daleondev/ProtoMate_Control/README.md

# ProtoMate Control

Control software running on the robot controller of the ProtoMate SCARA Robot.

## Current target: Arduino GIGA R1 WiFi

**M4 runs `io::Application`; M7 runs `ui::Application`.** Each independently
linked image owns its main, ThreadX kernel, C++ runtime, heap, TLS, threads,
message bus, coroutine context and ICC bridge. Common implementations are
compiled separately for each core. ICC uses bounded shared-SRAM queues with
urgent, normal and background lanes; M7 writes the physical USB-C CDC console.

The STM32H747 CubeMX, HAL, external-flash bootstrap and build port are implemented.
**Both applications boot from QSPI; USB/ICC services and STEP generation under combined load are verified.**
Factory backups are preserved. [Wiring, memory, backup/flash/debug commands and acceptance gates](#arduino-giga-hardware-boot-and-bring-up)
are documented below. Linux keeps the paired in-process transport for tests.

M4 exposes STEP/DIR/enable, switches, DM542T/TMC2209 drivers, feedback and the
future EtherCAT SPI connection. M7 owns the RGB LED, user button, display/touch
and console. M7 mounts persistent internal-flash storage at `/flash`; M4 does
not mount the volume. Both runtimes include filesystem support.
Motor construction leaves all drivers disabled; initialization, enabling and
motion are explicit CLI operations. Display/touch bring-up uses `display`
commands. The shared TouchGFX robot HMI opens Home on M7 and Linux, using the same
motion client and job history as the CLI. See the [HMI guide](docs/gui/hmi/README.md).

## Remote-control integration and future supervision

OPC UA is integrated as a third UI frontend alongside GUI and CLI. The LAN9255
supervisor remains future work. This hobby project makes no certification or
SIL/PL claims. Powered robot commissioning remains separate from software and
motor-disconnected electrical tests.

### OPC UA interface on M7 using open62541

**Remote-motion endurance is not yet qualified:** intermittent network/server latency
can exceed the unchanged 500 ms control-source deadline. Read-only monitoring and
short electrical workflows pass; normal firmware starts with remote permission OFF.
See the measured blocker in the qualification report linked below.

The server uses the existing motion client, planner, source-aware execution jobs
and M4 admission. Its explicit reflection catalog publishes 187 application nodes
(68 methods), with stable string NodeIds and bounded typed records. The namespace
is `urn:protomate:control`; default subscriptions publish at 100 ms (50 ms minimum).
No network read requests fresh IO work.

- `src/ui/opcua` (`proto::ui::opcua`) owns the catalog, server, NetX/POSIX ports and
  allocator. `platform/network` owns Wi-Fi/SDIO/NetX. M4 links neither stack.
- GUI and OPC UA share `ui::Services`; CLI retains the same application-owned
  motion client and job history. Existing ownership, units, planning and stop
  semantics apply to all frontends.
- Remote commands require local permission, **OFF on every boot**. Anonymous
  SecurityPolicy None is intended for the trusted LAN. The client worker checks
  500 ms remote expiry independently of networking/rendering, using 100 ms
  heartbeats and explicit held-jog supervision. Disconnect never replays motion.
- Settings → Network and USB `network setup` provide local setup. One Wi-Fi
  profile is saved on internal flash; passwords are not exposed remotely or logged.
  Linux uses OS networking. `opcua status|start|stop|restart` and
  `opcua remote on|off` expose local management.
- Dedicated SDRAM reservations provide 512 KiB for OPC UA, 256 KiB for networking
  and 128 KiB for presentation snapshots/USB byte rings, preserving active
  framebuffers, M4 memory and ICC SRAM4. Another 128 KiB remains unassigned.
  The server's internal stack is 14 KiB, based on measured complete-catalog use.

See the [integration guide](docs/opcua/README.md),
[generated node reference](docs/opcua/nodes.md),
[architecture and memory diagrams](docs/opcua/architecture.md), and
[measured qualification status](docs/opcua/verification.md).
The [standalone Wi-Fi sample](examples/opcua_sample/README.md) remains buildable.

### LAN9255 SAM E53 supervisor with FSoE

Explore using the integrated SAM E53 as a dedicated supervisor and EtherCAT
gateway, including an FSoE endpoint for a remote FSoE controller. This would
replace the erased-SAM/direct-GIGA-to-ESC arrangement for this future variant:

```text
EtherCAT + FSoE -> LAN9255 ESC -> SAM E53 -> separate SPI -> GIGA M4
                                  |
                                  +-> independent motor shutdown hardware
```

- Restore SAM firmware and move EtherCAT slave application ownership there.
  Process FSoE locally; forward ordinary command/status data to M4 through a
  bounded SPI protocol. FSoE requires a corresponding remote FSoE main instance;
  an ordinary EtherCAT master alone does not supply that logic.
- Investigate the separate SPI exposed at mikroBUS J18 for the GIGA link.
  J3 taps the ESC bus and must not be driven by two independent masters. The
  current documented J3 wiring stays unchanged until this variant is implemented.
- Give the supervisor physical authority to withdraw motion permission without
  GIGA cooperation. A GIGA enable request may only enable motion while the
  supervisor, watchdog and local protective inputs also permit it.
- Default to inhibited operation during reset, power loss or watchdog expiry;
  latch trips and require deliberate recovery. Include an external watchdog
  driven by completed supervision cycles, not an autonomous timer heartbeat.
- Evaluate independent driver-enable inhibition and monitored switching of the
  motor-power branch while keeping controller power available. Select the output
  topology after checking failure behavior, stored energy and regeneration.
  DM542T/TMC2209 enable inputs are ordinary controls, not documented STO inputs;
  account for the existing interface polarity rather than simply disconnecting
  an enable wire. A stop message to M4 alone cannot provide this authority.
- Determine whether Axis 3 needs a brake or other load-retention mechanism before
  removing holding torque. Controlled deceleration through M4 is useful, but
  independent shutdown must still work if M4 fails.
- Verify with motors disconnected first: GIGA/SAM stalls and resets, lost/stale
  FSoE and SPI traffic, broken supervision, shutdown-output faults and prevention
  of unintended restart. Later validate actual stopping and load retention.

FSoE protects communication integrity; it does not by itself make the SAM,
outputs or mechanics fault tolerant. The intended outcome is a tested hobby
supervisor with independent shutdown, without a certification program.
References: [EVB schematic, page 22](docs/ethercat/EVB-LAN9255-Evaluation-Board-Users-Guide-50003106.pdf)
and [ETG FSoE overview](https://www.ethercat.org/safety/).

## Motion API: motors, axes and robot

M7 owns the motion client, bounded job history, axis conversion and robot planning.
M4 owns admission, driver state, execution and local stopping. CLI commands are
asynchronous: a returned job ID means submitted; `motion jobs <id>` reports IO
acceptance and the eventual result. Returning to the prompt does not cancel a move.

| Control | Units | Commands |
|---|---|---|
| `motor` | Shaft degrees / rpm | Existing raw moves, homing, dynamics and buffering |
| `axis` | Axis 1/2 degrees; Axis 3 mm | `status`, `move`, `moveto`, `home`, `jog`, `stop` |
| `robot` | Joint coordinates or Cartesian mm | `status`, `home`, `move joints`, `moveto joints`, `move point`, `moveto point`, `stop` |
| `motion` | Shared lifecycle/jobs | `init`, `enable`, `disable`, `status`, `jobs`, `wait`, `cancel`, `stop`, `abort` |

`motion init` leaves drivers disabled. Initialize and enable explicitly, then home
before absolute/axis/robot motion. Execution requires the native simulator's
mechanical configuration or a verified physical configuration. The physical
configuration is deliberately unset. Preview fixtures are never substituted for it.

Examples after homing:

```text
axis move shoulder -5 --speed 10
axis jog z -1 --duration 1
robot moveto joints 30 -30 10 --speed 0.25
robot move point -1 -1 0
motion jobs
motion wait 4 --timeout 10
motion cancel 4
```

Axis dynamics are deg/s, deg/s², deg/s³ or mm/s, mm/s², mm/s³. Zero/omitted values
select configured defaults. Robot `--speed`, `--accel`, `--decel` and `--jerk` are
factors of configured limits in (0,1]; zero selects defaults. Speed defaults to
0.25. Cartesian point moves interpolate **joints**, so their TCP paths can curve.
Straight Cartesian paths remain previews; blending, live override and hold/resume
are not exposed as executable robot features.

M4 atomically excludes command families. Raw motor commands can coexist under
existing per-motor buffering rules; axis jobs may run on separate axes; a robot
job reserves all three. Families cannot mix. Reservations start before executable
planning and last through deceleration and cleanup. Busy results identify the
owner. Configuration/state revisions are checked again before starting; stale
plans emit no pulses. Read-only status and previews remain available.

`motion jobs` retains 32 execution records. Waiting explicitly does not transfer
ownership; a wait timeout leaves the motion running. `axis stop` also stops the
whole group if that axis belongs to a robot job. Axis/robot stops decelerate with
holding torque retained. Raw `motor stop` remains an immediate abort; abort and
disable invalidate affected references. No stop or reconnect resumes motion.

The configured ceiling is **6,250 pulses/s on each axis**, with microsteps
**16 / 16 / 8**. Joint/point moves share one normalized profile and one scaled
stopping-progress profile. Endpoints are quantized once, and completely zero
moves do not arm outputs. Finite programs, including stopping continuations, are
limited to **90 seconds**. Continuous jog uses rolling timing toward the actual
soft-limit boundary; the default timed jog requests deceleration after one second.

Two deadlines serve different purposes: the UI ownership lease is **250 ms**,
renewed in one batch every **50 ms**; local M4 execution maintenance uses a
**40 ms** renewal and **80 ms** committed frontier. The execution worker still
services refills and stops every millisecond; its local keepalive remains 40 ms.
UI loss selects an already
installed brake on M4. An M4 execution failure invokes the hardware guard and
invalidates uncertain references; it is not a guaranteed controlled stop.

The Linux workflow exercises the native simulated plant through the production
CLI, ICC and controller. Brake construction preserves the incoming state and
accepts only binary64 roundoff at acceleration limits (eight machine epsilons,
relative to the limit). Exact captured-input, phase-boundary, scaling and
out-of-limit regressions cover this numerical boundary.

The current motion review has separate software and electrical results. Short
motor-disconnected analyzer captures pass for raw commands (**18/18/9 pulses**),
coordinated completion (**400 per axis**) and controlled stopping (**266 per axis**).
HIGH time is 120–121 samples at 24 MHz; coordinated rising-edge skew is at most
one sample. Physical ENABLE remains inactive throughout. These captures peak
near 711 pulses/s and do **not** qualify the configured 6,250-pulse/s ceiling.

The concurrent jog/independent-axis ICC failure is fixed. The M4 urgent sender
was exhausting the heap when allocating a 4,228-byte temporary coroutine for
another outgoing frame; UI then reported the missing heartbeat. Each sender now
reuses one persistent frame allocated at startup. A host allocation regression
and repeated application-level overlaps verify the fix. Heartbeat, ownership
and motion deadlines are unchanged. See the [current review](docs/motion-current-state/review.md)
for firmware identities, capture results and the remaining physical qualification.

The review fixes an overall homing deadline, missing preparation-version
validation, an interrupted-wait wakeup race, telemetry waiting on raw startup's
command lock, a native display-mutex preemption deadlock, and an unnecessary
peak allocation when STEP scratch storage grows. Preparation/start failures now
retain their stage and allocation failures report capacity exhaustion. The
native simulator caches mechanical configuration before starting live transport.
Its clock waits for interrupt-woken controller work to suspend before advancing
the next event, and simulated display refresh uses that same clock. This prevents
instrumentation overhead from starving homing behind repeated periodic wakeups.

The ordinary interaction objective remains approximately **200 ms to start
changing motion**, not to reach rest. The current captures establish pulse
behavior, not a worst-case admission/stop-onset bound or maximum-rate endurance.
The complete native motion workflows pass with ASan/UBSan, including
homing → stop → homing and checks for unwanted seek pulses after switch contact.
This functional simulation does not qualify hardware scheduling or timing.
Clang-tidy is clean across all 430 production compilation contexts (Linux, M4
and M7), with no parse blockers; unit tests remain excluded.
See the [current review](docs/motion-current-state/review.md) for exact
build, test, firmware and capture evidence.

Powered mechanical acceptance requires calibrated limits and transmissions.
[Executor architecture and verification](src/io/motion/EXECUTOR.md).

## Native Linux robot simulation

Build as usual, then launch **`build/debug-linux/Application`**. This one
executable forks into a native simulation process and a controller process,
opening the TouchGFX window plus a separate robot window. Use
`--headless` to omit only the robot window. See [simulator usage and model
boundaries](src/simulation/README.md) for the provisional physical profile,
fault controls, persistent media, signal capture and verification commands.

The robot window displays native simulated shaft/axis state, not motion requests
or controller position estimates. The controller retains the production IO
state machines, drivers, STEP generator, FileX/LevelX and UI/IO ICC. Emulated
motion hardware and physical state live in the separate native process.

## Platform layout

| Directory | Responsibility |
| --- | --- |
| `platform/boot/` | Board startup, recovery images, memory protection and GIGA flash partition layout |
| `platform/hal/` | Hardware contracts, drivers, devices, board wiring and core selection; includes the inter-core lane contract |
| `platform/simulation/` | Linux simulator wire contract, shared memory, HAL mailbox and interrupt handoff |
| `platform/runtime/` | ThreadX integration, C/C++ runtime and filesystem/storage implementations |

The GIGA partition header is shared by boot MPU setup and the runtime flash
adapter; the partition addresses and erase geometry are defined in one place.

## Application layout

| Directory | Responsibility |
| --- | --- |
| `src/common/` | Shared contracts, motion profiles, application lifecycle concept, ICC bridge and transports |
| `src/io/` | M4 entry point, IO application, motor ownership and motion execution |
| `src/simulation/` | Native hardware process, machine models, independent SDL/OpenGL viewer and tests |
| `src/ui/` | M7 entry point, UI application, CLI, shared GUI, axis conversion and robot planning |

Each firmware compiles only its own application target, `proto::io` or
`proto::ui`. Both use `proto::common`. These are compiled static libraries;
their nested `INTERFACE` targets collect sources privately into the owning
library. Tests and examples link the compiled libraries so implementation files
are compiled once per build. Public include paths start at `src/`, for example
`common/icc/bridge/Bridge.hpp` and `io/app/Application.hpp`. The Linux entry point in
`src/main.cpp` retains the in-process paired transport for host development and
lifecycle tests. It is not compiled into either GIGA image.

The [application concept](src/common/app/Application.hpp) enforces `void start()`,
`void requestStop()` and `void join()` without inheritance. Construction initializes
logging; application workers launch in `start()`. `start()` is one-shot;
`requestStop()` is an idempotent thread-safe notification; `join()` waits for
completion. Destruction requests a stop and joins. Call start/join/destruction
from the lifecycle owner, outside workers.

`runtime::thread::Definition` annotations in each `app/Application.hpp` declare
its threads; `app/Application.cpp` defines their entries.
[ThreadGroup](platform/runtime/ThreadGroup.hpp) creates all workers before
releasing them. The ICC worker runs the context; the application worker waits
for a stop request, then drains the bridge before stopping its context. Peer
shutdown or link failure wakes the application worker. Each application requires
a transport; the bridge is a concrete member with no optional execution path.

Each application exposes a lifecycle `state()`: `Starting`, `Ready`, `Stopping`,
`Stopped` or `Fault` ([shared definition](src/common/app/State.hpp)). IO publishes
its state on the latest-only `io/controller/state` topic every 100 ms. UI owns
[`SystemState`](src/ui/app/SystemState.hpp), combining its local state, the
received IO state and ICC connection health; `ui::Application::systemState()`
returns this snapshot. Refresh uses timers on the existing ICC workers.
The CLI command `state` displays the same combined state and LED colour, both
controller states, and whether the received IO state is fresh. `help state`
describes the command; reading state does not issue an IO request or move motors.

UI displays the combined state on the GIGA's onboard RGB LED:

| Colour | Meaning |
| --- | --- |
| Green | Both applications are `Ready`, ICC is connected and IO state is fresh |
| Yellow (red + green) | Starting, awaiting IO state, or orderly stopping/stopped |
| Red | Application fault, ICC failure, or no IO state for 500 ms while connected |

Blue stays off. Freshness uses UI's receive clock; timestamps need not be
synchronized between cores. Fault indications latch until application restart;
shutdown cannot clear them. Final topic delivery is best effort, with ICC's
orderly goodbye distinguishing normal peer shutdown from communication failure.
These are **controller application states**, not motor readiness or enable
indicators. Green does not mean drivers are initialized, motors are referenced,
or motion is enabled. Motor telemetry and admission checks remain separate;
an LED or lost communication cannot confirm that physical motion has stopped.
GIGA Debug verification checks the LED GPIO levels: green during normal paired
operation, yellow after CLI shutdown, and red after halting M4 until a coordinated
restart. Shared motor enable remains inactive throughout these checks.

[`io::motion::Controller`](src/io/motion/Controller.hpp) owns three `StepperMotor`
instances, their shared STEP generator and enable output. Drivers and feedback
belong to each motor. `initializeDrivers()` configures the drivers and starts the
idle timebase; `enable()` verifies readiness before energizing the motors.
Controller move/reference methods preserve independent axis execution and
buffering. `stop(id)` stops one motor, `stop()` stops all while retaining torque,
and `disable()` also removes enable and invalidates references. Driver faults
immediately drop shared enable; a diagnostic worker cancels and joins all motion.
Recovery requires explicit initialization and enabling. IO shutdown disables the
motors before draining ICC. Motor settings live in `io/app/Application.cpp`:
1.8° full steps, 16/16/8 microsteps for M1/M2/M3 and placeholder 135° shaft
reference coordinates. These shaft placeholders do not supply a calibrated axis
or robot configuration.

The motor service dispatcher handles urgent stop/disable requests and telemetry.
One bounded command worker (priority 2, 16 KiB ARM stack) executes ordinary services and program preparation;
additional ordinary requests return `Busy` while it is occupied. UART verification
and initialization run outside the controller admission lock, and enable settling
is cancellable. Stop invalidates pending initialization/enable work and queued
ordinary requests; only a new explicit command can enable the motors afterwards.
Velocity updates enqueue under the admission lock and wait outside it.

`src/ui/cli/` contains the annotation-based parser, filesystem and utility
commands, Linux terminal frontend and direct motor commands. Registration uses
`ui::cli::register_commands` with a parser owned by the CLI thread. Each command
module has its own per-parser `std::call_once` guard. Motor callbacks use the
application-owned `ui::motion::Client`; only IO owns the physical controller.

M7 exposes the CLI through **USB-C CDC** (no UART bridge). Use `help` or
`help <command>`. Available commands are `pwd`, `cd`, `ls`, `touch`, `mkdir`,
`rmdir`, `rm`, `cp`, `mv`, `cat`, `echo`, `grep`, `time`, `stack`, `heap`, `state`,
`display`, `motor`, `motion`, `axis` and `robot`.
Quoting, wildcard expansion, pipes and `>`/`>>` redirection are supported.
For example, `echo "hello world" | grep world` and `time "heap io"`.
`heap ui` / `stack ui` inspect UI locally; `heap io` / `stack io` request IO's
memory diagnostics through the `io/memory` ICC service. The controller argument
is required. `time` measures execution on UI, including any remote round-trip wait.
Filesystem commands use the host filesystem on Linux and FileX on M7.
On GIGA, `/flash` is persistent internal-flash storage; see
[persistent files](#persistent-files-in-internal-flash) for capacity and behavior.

Motor commands use **motor-shaft degrees and rpm for all three motors**, including
M3. `motor` prints a guide; `help motor move` lists annotated options.

```text
motor driver init
motor enable
motor move m1 -90 --speed 5
motor jobs
motor status m1
motor stop m1
motor disable
```

- `motor status [m1|m2|m3|all]` shows commanded position/velocity, feedback and reference state.
- `motor driver status [motor|all]` shows driver readiness, alarms and latched faults.
- `motor driver init` initializes/recover drivers and the STEP timebase while disabled.
- `motor enable` / `motor disable` operate the shared enable; disabling stops work and invalidates references.
- `motor move <motor> <degrees> --speed <rpm>` submits a relative move.
- `motor moveto <motor> <degrees> --speed <rpm>` requires successful homing.
- `motor home <motor> [--seek 5] [--latch 0.5] [--timeout 30]` seeks, releases, slowly re-latches and finally releases the switch again, retaining the coordinate established at the latch.
- `motor speed <motor> <rpm>` replans the uncommitted remainder of an active move. It can be rejected once all remaining pulses are already scheduled.
- `motor defaults <motor> [--accel <deg/s²>] [--decel <deg/s²>] [--jerk <deg/s³>]` reads/updates idle motor defaults in RAM.
- `motor stop [motor|all]` aborts the selected motor and its buffered successor while retaining holding torque and invalidating its reference. Other independent motors continue; targeting a current robot group aborts that whole group.
- `motor jobs [id]` uses the shared execution-job registry. `motion jobs [id]` shows all command families; returning from a CLI command does not cancel its job.

Moves accept `--accel`, `--decel`, `--jerk` (zero selects the motor default),
`--timeout` (seconds, zero means unlimited) and `--buffer` (`aborting`, `buffered`,
`blending-low`, `blending-previous`, `blending-next`, `blending-high`). A motor can
have one queued successor. A configured default jerk of zero selects a trapezoid.
`accepted` includes queued/executing work; only a terminal result confirms its outcome.
INDEX feedback is labelled as a pseudo measurement of driver phase.
Axis conversion and coordinated positioning are exposed through `axis` and `robot`,
with the family exclusion and configuration requirements described above.

Linux uses ncursesw with separate logs, line editing and command history when
attached to a terminal. Redirected input/output, `TERM=dumb`, or
`SIMPLCITY_CLI_PLAIN=1` select the plain frontend. Console EOF, Ctrl-C, or Ctrl-D
on an empty interactive line shuts down the application pair. Application or
peer shutdown also interrupts an idle CLI. Plain/serial lines are limited to
4096 bytes; oversized lines are rejected. M7 receives bytes into a bounded IRQ
buffer while commands execute; input errors stop the console instead of
executing truncated input. The serial frontend echoes input, so disable local
echo in the PC terminal.

The shared message catalogs live in `src/common/icc/catalog/`:

- [topics.hpp](src/common/icc/catalog/topics.hpp): `Topics`, with `TopicPublisher` annotations.
- [services.hpp](src/common/icc/catalog/services.hpp): `Services`, with `ServiceProvider` annotations.
- [actions.hpp](src/common/icc/catalog/actions.hpp): `Actions`, with `ActionProvider` annotations.

Both applications register all three catalogs in their constructors using their
own IO/UI role. `Topics::io_logs` carries IO log text to UI. `Topics::io_motor_state`
publishes all three motor states at up to 20 Hz, including while idle or disabled.
Both the bridge and UI subscription use latest-only delivery. `Services::io_memory`
provides memory diagnostics. `Services::io_motor` carries initialization,
enable, speed and default-setting requests. `Services::io_motor_stop` reserves
urgent transport capacity for stop/disable. `Actions::io_motor_motion` carries
raw individual moves and homing, with periodic feedback and terminal results.
`Services::io_trajectory` handles authoritative snapshots, reservations and bounded
program preparation. `Services::io_trajectory_control` uses the urgent lane for
batched lease renewal, stop, abort and reservation release. `Actions::io_motion`
starts a prepared axis/robot program and retains its lifecycle through cleanup.
Shared motor payloads live in `src/common/motion/Motor.hpp`; compact versioned
program packets live in `src/common/motion/Trajectory.hpp`. Both use the existing
ICC bridge rather than a separate motion transport.

`motor status` and `motor driver status` read UI's latest snapshot without a
service request. Missing telemetry, disconnection and samples older than 500 ms
produce explicit errors. Freshness uses UI's local receive clock; the snapshot's
IO timestamp is informational, and its increasing sequence rejects duplicate or
out-of-order samples. The worker waits 50 ms after publishing; blocking IO or ICC
processing can extend the interval. It does not catch up missed publications in
a tight loop that would starve diagnostics and logging. Command replies contain the outcome, `commandGeneration`
and operation-specific values (motion defaults or the scheduled speed-change
pulse), without copying motor states. Actions still report acceptance and terminal
results independently of telemetry.

IO's application worker drives `io::motion::Server`; blocking driver operations
and joins stay outside the ICC context. Controller completion callbacks only
wake this worker. UI's application worker caches telemetry and dispatches action callbacks for
`ui::motion::Client`, retaining its job handles until completion. Services and
action admission time out after three seconds; execution uses the requested
motion timeout. Lease renewals have a shorter 150 ms service timeout and only
one renewal request may be outstanding. No request is automatically retried. `commandGeneration`
rejects submissions overtaken by a stop, disable or initialization. Acknowledgements
update UI's generation immediately, so subsequent moves do not wait for telemetry;
older snapshots cannot roll it back. IO validates admission against its current
state rather than trusting UI's cache. Link shutdown
drains IO motion and disables the shared enable before closing its bridge. UI
reports uncertain communication outcomes as unknown rather than claiming a stop.

Diagnostic snapshots and collection live in `src/common/diagnostics/`. IO's
`io::diagnostics::Server` collects them on a dedicated worker; the CLI formats
both local and remote results using the same tables. Remote requests have a
two-second timeout, participate in UI shutdown cancellation and never fall back
to UI measurements on failure. At most two requests are outstanding at the IO
provider. Each response fits one ICC frame and includes up to 32 thread records
with names limited to 31 characters; omitted threads and shortened names are
identified in the output. Stack usage is sampled/saved usage and a recorded
high-water mark, not a continuous measurement. The collection copies thread
records under the local ThreadX interrupt lock, without allocation or formatting.
On Linux both controllers share the process allocator and ThreadX kernel; the
output explicitly labels that scope even when the request travels through ICC.

`reset all` immediately aborts motion and resets the complete GIGA, including both
controllers. STEP/enable outputs are inhibited before reset; startup leaves motors
disabled and references must be established again. During reset itself, GPIOs are
inputs: external STEP pull-downs and the disable-state enable bias remain required.
USB CDC disconnects during
reboot. This is **not** a controlled stop: use `motion stop` first when deceleration
is required. Individual `reset ui` / `reset io` requests are rejected without any
reset. ST does not guarantee CPU-only watchdog reset (RM0399 §9.7.36), and our ICC
transport currently requires coordinated startup. Linux reports hardware reset as
unsupported; close and restart the simulation instead.

IO's Pneumo sink publishes already formatted records on `io/logs`; UI adds an
`[IO]` prefix and writes them directly to the console without logging them again.
Original timestamps and levels remain intact. Each record is limited to 384 bytes
(longer records end with `[truncated]`), and both the outgoing bridge subscription
and UI subscriber retain the newest 16 records. Overflow counters are available
through bridge/subscriber statistics; the sink separately counts truncations.
Console output runs on a notification-driven UI worker, never in ICC callbacks.
On Linux it uses the console broker, including buffering before ncurses starts.

UI installs its own Pneumo sink for all levels before its first startup log.
It prefixes local records with `[UI]` and calls `cli::writeLog`, the same output
function used by the IO subscriber. Received IO records retain `[IO]` and bypass
the local sink. The CLI frontend does not replace either logging route.

The M4 entrypoint installs this sink as Pneumo's default for all levels. The motion
controller also passes it explicitly to its motors, so Linux's IO logs use the same
ICC path while UI retains its separate console routing in the shared process.
Shutdown closes the IO sink before stopping ICC and wakes/joins UI's log worker.
Logs are best effort and may be discarded at shutdown. These bounds apply to the
ICC path; Pneumo's existing asynchronous logger queue is separate. Logging remains
a thread-context operation, not an ISR-safe or allocation-free API.

| Thread in each GIGA image | ThreadX priority (lower is higher) | Stack |
| --- | --- | --- |
| ThreadX timer worker | 0 | Port default |
| `io.iccThread` | 4 | 20 KiB (32 KiB on Linux) |
| `intercore.notify` | 3 | 2 KiB (8 KiB on Linux) |
| `ui.iccThread` | 4 | 32 KiB |
| `ui.cliThread` | 5 | 16 KiB (64 KiB on Linux) |
| M4 motion executor | 1 | 8 KiB (16 KiB on Linux) |
| M4 command/preparation worker | 2 | 28 KiB (24 KiB on Linux) |
| M4 raw motion/homing worker (up to three) | 16 | 10 KiB (16 KiB on Linux) |
| `io.applicationThread` | 3 | 16 KiB |
| `ui.applicationThread` | 6 | 16 KiB |
| Runtime main/application entry | 15 | 8 KiB |
| M4 motion diagnostics | 18 | 6 KiB (8 KiB on Linux) |
| `io.diagnosticThread` (heap/stack service) | 20 | 4 KiB (16 KiB on Linux) |
| `ui.logThread` | 20 | 8 KiB |
| Runtime cleanup/reaper | 31 | 2 KiB |

Priorities belong to separate schedulers; M7 priorities do not preempt M4 work.
ICC is a required part of both applications. The portable bridge and the
HAL/runtime transport adapter are separate targets. Reset both
cores together; independent core reconnection remains future work.

The [application archive](backups/application/README.md) preserves the earlier
control/CLI implementation for incremental reimplementation. Retired hardware,
bench programs and wiring are preserved under `backups/`; they are not build targets.

## Setup and compilers

```sh
git clone --recurse-submodules <this-repository>
# For an existing checkout:
git submodule update --init --recursive
```

Install CMake 3.22 or newer (3.24 or newer for `--fresh`), Ninja, GCC 16,
Arm GCC 16.1 or 16.2 with Newlib, OpenOCD, Arm GDB, Python 3, Git, and `patch`.
Linux builds also require ncursesw and SDL2 headers/libraries (`ncurses`, `sdl2` or `sdl2-compat` on Arch). The pinned TouchGFX SDK is included in `external/touchgfx`; install the asset tools described below before configuring M7 or Linux.
The project uses C++26 and the verified GCC 16 libstdc++ integration snapshot.
Unknown compiler majors and unverified Arm libstdc++ snapshots are rejected.
Linux tests download the pinned GoogleTest 1.17.0 source archive.

The **ProtoMate · Arduino GIGA R1 WiFi · GCC 16** VS Code devcontainer uses Arch
Linux and checks that both compiler major versions remain 16. It includes
SDL2/ncurses, Ruby with ERB/Nokogiri and `rsvg-convert` for GUI builds; Mesa, Xvfb and
`xauth` for headless GUI tests; and OpenOCD, Arm GDB, `sigrok-cli` and FX2 analyzer
firmware for hardware work. Python dependencies from
[`scripts/requirements.txt`](scripts/requirements.txt) (NumPy, Pillow, pyserial, pytest)
are installed in `/opt/protomate-venv`, selected automatically through `PATH`
and VS Code's Python interpreter setting. No activation or system-wide pip
installation is needed in the container.

After changing the Dockerfile or requirements, run **Dev Containers: Rebuild
Container**. The image build context includes only the Dockerfile and Python
requirements; the workspace and downloaded SDK archives are not copied into
the image. The container exposes USB and uses a development user with serial
permissions. Host flashing and serial capture also require access to Atmel-ICE,
USB CDC and the logic analyzer. Building and headless tests need no desktop
connection; opening an interactive simulator window requires X11/Wayland access
from the container, which is not enabled automatically.
When switching an existing build directory between host and container, configure
with `--fresh` to discard cached host paths (for example,
`cmake --preset debug-linux --fresh`).

For builds outside the devcontainer, install the Python dependencies separately:

```sh
python3 -m venv .venv
source .venv/bin/activate
python -m pip install -r scripts/requirements.txt
```

## Build and run

```sh
cmake --preset giga-debug
cmake --build --preset giga-debug
cmake --preset debug-linux
cmake --build --preset debug-linux
./build/debug-linux/Application
```

The combined preset builds `controllers` and the matching `images` bundle by
default, using the per-core presets and output directories, including
both memory reports. It does not flash the board. Use `--target io-controller`
or `--target ui-controller` to build just one through the combined project.

Runtime and HAL source implementations are shared; each core compiles and links
its own copy with its own CPU flags, ThreadX port and private runtime state.

`giga-release` and `release-linux` provide optimized builds. After a
compiler upgrade use `cmake --preset <preset> --fresh` and rebuild cleanly.
Use `-DBUILD_TESTING=OFF` when configuring Linux to build the template without
fetching or building test dependencies.

Pneumo uses stdexec as its required execution backend through
`pneumo::coroutines`. CMake fetches its pinned
stdexec headers; every coroutine consumer, including the native simulator,
inherits the same configuration. Existing ICC workers continue to drive their
own contexts; this does not introduce a thread pool or change the wire protocol.
Use `pnm::coro::asSender(context, factory)` and `pnm::coro::execution::when_all`
to compose asynchronous operations, forwarding the factory's stop token to
service requests. Domain failures such as `Busy` remain result values.
`application.icc.services` tests composition, out-of-order responses,
cancellation and provider shutdown/replacement across the serialized bridge on
our ThreadX runtime. These tests are always built; the obsolete optional
`PNM_CORO_ENABLE_EXECUTION` switch is no longer used.

Native coroutine awaitables retain their original frame and reference results
instead of going through an allocating sender adapter. On M4, bridge
startup/teardown lives in `BridgeLifecycle.cpp` in QSPI; dispatch and lane loops
remain in instruction RAM and are checked by the linked-image audit. Motion
buffers and RAM-region boundaries are unchanged for this integration.

The [2026-11-10 integration record](docs/pneumo-integration-2026-11-10.json)
contains the build identities, lint results, sanitizer results and analyzer
captures. Software regressions pass, but this is **not a full hardware release
qualification**: QSPI motion admission and concurrent buffered raw startup still
failed in this campaign. The five passing electrical captures use the documented
SDRAM fixture. The detailed motion limitations are recorded in the
[current review](docs/motion-current-state/review.md).

All project C/C++ sources in `src/` and `platform/`, including tests, compile
with `-Wall -Wextra -Wpedantic` in both Debug and Release builds. Directory
settings apply these flags to new module targets as well.
Embedded Debug builds retain debug information and use `-Os` for IO, UI, ICC
and their entrypoints. Real-time M4 sources use `-Os` or `-O2` in RAM;
the libstdc++ runtime shim uses `-Og` outside the selected fast paths.
Source-level debugging remains available, with optimized stepping in these modules.

GIGA builds produce `io-controller` or `ui-controller` ELF/HEX/BIN/MAP files.
Use the validated combined programming workflow below.

Every default hardware build prints used bytes, region capacity and percentages,
including builds where the ELF is already up to date. The `memory-usage` target
can also be invoked explicitly. These are linker allocations: the stack region
is fully reserved, and RAM includes the minimum heap reservation, not measured
runtime stack or heap usage.

Linux simulates the HAL and uses the ThreadX Linux port. Standard Linux file
I/O uses the host filesystem; explicit FileX tests use simulated media images.
The application runs both ICC endpoints, the UI CLI and the GUI window. Use `SDL_VIDEODRIVER=dummy` for automated runs without a desktop. Redirecting a command
script into `build/debug-linux/Application` executes it and exits at EOF.

Simulator C++ suites use GoogleTest built against the native host runtime; the
controller/runtime tests retain their separate ThreadX-linked GoogleTest. The
link-isolation test checks that no ThreadX runtime leaks into the native test
executables. Python integration suites use pytest for process lifecycle,
packaging, persistent storage, CAD parity and end-to-end motion. Their small
controller probe executables retain their own ThreadX entry points.

Run both kinds through CTest, which supplies the built executable paths and
uses Xvfb for the OpenGL suite:

```sh
ctest --test-dir build/debug-linux -R '^simulation\.' --output-on-failure
ctest --test-dir build/release-linux -R '^simulation\.' --output-on-failure
# Focus a native unit case without starting the controller:
build/debug-linux/src/simulation/protomate_simulation_tests --gtest_filter='SimulationMachine.*'
# Run an individual Python integration check directly:
python3 -m pytest -q src/simulation/tests/test_lifecycle.py --simulator=build/debug-linux/Application
```

CTest's pytest runs write JUnit reports to `build/<preset>/test-results/`.
Temporary media and copied executables are isolated per case; process fixtures
reap children and close pipes even when assertions fail.

## Firmware profiling

The opt-in `giga-profile` build adds native ThreadX/TraceX recording, DWT scopes,
application events, and bounded resource diagnostics on both cores. Trace buffers
use dedicated external SDRAM; small accounting/failure state stays internal.
Normal builds retain lightweight heap and first-failure diagnostics.

Use `profile arm motion`, exercise the application, then `profile freeze`.
`scripts/profile.py` exports frozen native traces, matched ELFs and a combined
browser timeline through Atmel-ICE without resetting the board. See the
[profiling guide](docs/profiling/README.md) for presets, memory ownership, event
semantics, exact commands and measurement limitations. The logic analyzer stays
separate from this framework.

## Shared TouchGFX GUI

`proto::ui::gui` provides the robot HMI on GIGA M7 and Linux. **Home is the
normal startup screen**, with the full prepared robot model, telemetry, motion
readiness and shared jobs. Axis, robot, preview and raw-motor pages use the same
Client/Robot/ICC implementation as the CLI. The interface names the joints **Axis 1, Axis 2 and Axis 3**. Programs and presets remain empty.

The shared shell uses an 88-pixel, six-button navigation rail (including Alarms), centered controls and a persistent Stop. Home always uses estimated feedback, with frame-matched joint badges and one status card. Axis and Cartesian jogging default to Hold. Cartesian has Step, Timed and Hold modes, persistent estimated X/Y/Z, and Move To / Settings tabs; Timed/Hold use one continuous Cartesian path with local M4 deceleration; they stop at the certified path boundary or on cancellation. Robot destination moves are under More, separate from non-executing path previews. Move separates Jog, Move To and Settings; I/O and diagnostics use aligned cards/tables. Orbit by dragging, zoom with the desktop wheel or a two-finger pinch, and use Reset View to restore the camera. Physical pinch input remains pending panel testing.

Alarms/messages distinguish blue Info, yellow Warning and red Error, with an Info
visibility toggle. Numeric editors open empty and validate each field before Apply.
Linux supports keyboard entry, Enter/Escape and Backspace/Delete inside the editor;
keyboard input never starts motion. See the guide for field and cancellation behavior.

See the [HMI operating and architecture guide](docs/gui/hmi/README.md) and
[verification status](docs/gui/hmi/verification.md). M4 does not link TouchGFX.

### SDK and assets

The required **TouchGFX 4.27.0** SDK files are versioned in
[`external/touchgfx`](external/touchgfx): headers/support sources, the M7 and
Linux engines, and Linux font/text/image converters. The devcontainer already
includes the host tools. Outside it, install Ruby (including ERB), Nokogiri and
librsvg (`ruby`, `ruby-erb`, `ruby-nokogiri`, `librsvg` on Arch), then:

```sh
# Only needed outside the devcontainer if Nokogiri is not installed system-wide:
gem install --install-dir "$PWD/apps/ruby-gems" nokogiri -v 1.19.4 --no-document
cmake --preset debug-linux
cmake --build --preset debug-linux
./build/debug-linux/Application
```

The SDK retains ST's **SLA0048** and third-party licenses; redistribution is
permitted under those conditions, including the ST-device usage restriction.
See its [license/provenance notes](external/touchgfx/README.md) and
[original package terms](external/touchgfx/Package_license.html). Its pinned
archive metadata and imported-file checksums are stored alongside the SDK.
`scripts/touchgfx_setup.py` reproduces this subset from the original archive;
it is not needed for a normal checkout/build.
`TOUCHGFX_ROOT` defaults to `external/touchgfx`; an environment or CMake cache
override can select another SDK directory containing `framework/` and `lib/`.
Configuration rejects versions other than 4.27.0. To clear a cached SDK path
from an older build, configure with `cmake --preset debug-linux -U TOUCHGFX_ROOT`
(or the appropriate hardware preset). M7 uses
the GCC hard-float engine without RTTI; Linux uses the x86-64 engine with RTTI.
Both link with our GCC 16 runtime. Vendor support has separate compilation flags;
GUI rendering is optimized with `-O2` in Debug as well as Release, retaining symbols.

Versioned assets are in [`src/ui/gui/assets`](src/ui/gui/assets): Noto Sans under
OFL, four font sizes (16/18/24/36), bounded Latin/German glyphs, stable text IDs in
`texts.xml`, SVG/PNG sources and `images.json`. `gui-assets` runs ST's Linux font,
text and image converters incrementally. SVG sources are rasterized with
`rsvg-convert` first. Generated C++ stays in `build/.../generated/gui`. The font
converter reports unsupported GPOS subtable 8; the selected Latin/German text
is covered by the visual checks. More complex scripts need separate validation.
Code, fonts, images and meshes share one 10 MiB M7 QSPI image and its normal
manifest. There is no separate GUI-assets partition or asset update procedure.

### Workers, ownership and shutdown

The application owns `gui::Controller` and three workers using its shared stop token:
GUI priority **8 / 16 KiB stack**, touch priority **7 / 8 KiB**, and the
3D renderer priority **16 / 16 KiB**. The renderer sleeps when Home is hidden. ICC remains higher
priority. Widgets are accessed only by the GUI worker. CLI commands submit to an
8-entry request queue; overflow is counted and rejected. `status()` returns a
thread-safe snapshot. There are no application-owned allocations during the
frontend's steady-state rendering or page transitions.

GIGA framebuffers are non-cacheable SDRAM at `0xC0000000` and `0xC0200000`,
1,228,800 bytes each. LTDC reload completion transfers ownership at vertical
blank; a timeout never makes a pending buffer reusable. The port records dirty
regions, combines overlapping/contained damage, and copies them from the completed
frame into the released buffer using DMA2D. The bounded 16-region list merges the
least expensive pair on overflow instead of falling back to a full-screen copy.
Unchanged pixels remain synchronized. One HAL driver owns LTDC IRQ 10; another owns
DMA2D IRQ 11. Graphics transfers support RGB565 fill/copy and RGB565/ARGB8888
conversion/blending, with software fallback for unsupported engine operations.
Solid-color alpha fills also use DMA2D. DMA callbacks notify the GUI worker;
no widget code runs in interrupts. LTDC has priority for AXI reads and DMA2D
inserts 16 bus cycles between transfers to leave scanout bandwidth.
DMA2D operations are submitted one at a time and suspend the worker until
completion (100 ms deadline), rather than busy-waiting. The current adapter does
not overlap multiple DMA blits with CPU drawing. CRC is enabled in CubeMX.

Touch acquisition resets/probes ST1633i, samples at 8 ms while pressed and wakes
on EXTI12 from idle. Unavailable devices retry at a bounded rate. `sampleTouch()`
reads the cached report only; it never performs I²C. One primary contact is tracked
until release for ordinary widgets; all five contacts remain available to the scene gesture recognizer. Native landscape coordinates are bounds-checked, and errors/stale
reports cancel the contact. Weak MCU I²C pull-ups keep disconnected lines defined;
the display adapter's external pull-ups remain required for connected operation.

On Linux the original OS thread owns SDL creation, events, texture copies and
presentation; a native pthread hosts ThreadX. Bounded pthread-protected mailboxes
cross that boundary without invoking ThreadX-backed C++ synchronization from SDL.
The runtime replacement C++ symbols are hidden from native shared libraries,
so SDL/Mesa/LLVM keep their native C++ synchronization instead of entering
ThreadX from the SDL thread. The window scales proportionally, letterboxes, transforms pointer coordinates and
cancels contact on focus loss/exit. SDL finishes copying a framebuffer before
returning it to the GUI. Closing the window or exiting CLI stops application
workers, disables callbacks/backlight and drains/aborts pending graphics work.
SDL resources are destroyed before process termination. The permanent hosted
ThreadX scheduler ends with the process.

### Adding screens

The HMI reuses one bounded page area rather than retaining a widget tree for
every screen. Add a page to `hmi::Page`, map intent in `Presenter`, and compose it
from the shared `Control`, `Panel` and `Label` components in `View`. Extend the
portable Backend contract only for real application functionality. The adapter
belongs to `ui::Application`; widgets must not block on ICC or manipulate drivers.
Text uses bounded Unicode buffers, actual font metrics for centering and explicit font-measured wrapping. Page builders are split into HomePage, MovePage and MaintenancePage; the [layout guide](docs/gui/hmi/layout.md) records component and input rules. Callbacks
publish bounded values; only the GUI worker draws or changes widgets.

### Shaded 3D performance prototype — acceptance gate not met

[`scene3d`](src/ui/gui/scene3d) is the first-stage implementation of the 3D
viewport. The generic maximum-rate benchmark remains a characterization workload. The 640×400 shaded workload does not meet the GIGA requirement of
20 newly presented images/s at 2,000 triangles and produces LTDC underruns.
Home uses **the same detail switching and adaptive pacing on Linux and GIGA**:
camera/pose changes use a 7,914-triangle model with a 10 fps ceiling. After 500 ms
without changes, it renders the original 36,376-triangle model once and returns
to idle. Both use a rest interval of at least one quarter of the preceding
render wall time (minimum 1 ms); full detail has a 5 fps ceiling. These are caps,
not promised hardware rates. The current measured GIGA camera workload is approximately 3.7 fps with interactive detail; this remains stepped animation. See the image-specific measurements in the HMI verification report. Full-detail rendering remains substantially slower.
Input/telemetry replaces the pending snapshot immediately; the worker samples the
latest snapshot when it can render, without a separate 500 ms submission gate.
An unchanged camera and joint pose submits no new render; newer telemetry
timestamps alone do not redraw the model. Returning to Home requests one fresh
image. Continuous rendering is reserved for animated diagnostic benchmarks.
The displayed image remains immutable. Resolution stays 640×400 in both modes;
full-detail geometry, link registration and motion/feedback data are unchanged.
`display scene` explicitly enables the generic benchmark; `display gui` restores Home.

```text
display scene 500
display scene 2000
display scene 5000
display status
display gui
```

The benchmark renders five independently transformed, overlapping ellipsoids.
`Scene` describes immutable meshes, material overrides and up to 32 nodes;
parents precede their children. `SceneSnapshot` contains local translation,
quaternion rotation, uniform scale, camera, revision and source timestamp.
Scenes/assets must outlive submitted work. `Renderer` uses caller-owned RGB565
and 16-bit depth buffers. `RenderService` has one replaceable pending snapshot,
finishes the current render, and holds completed/displayed buffers until the
GUI releases them. Visibility generations discard results from a hidden view.
Only the GUI accesses TouchGFX/DMA2D; shutdown drains rendering before removing
the bitmap registrations. Presentation revisions advance after the display
handoff, independently of GUI ticks or completed renders.

TGX **v1.1.4 / `d43f88906ab87f877ea249af2232896b097f15a7`** remains unchanged in
`external/tgx`. The project-owned [`cmake/tgx.cmake`](cmake/tgx.cmake) wrapper
isolates vendor flags and links it only into M7/Linux. Perspective, Gouraud
lighting, clipping and depth testing are enabled; texture shaders are excluded.
TGX's [LGPL-2.1 license](external/tgx/LICENSE) and upstream provenance remain in
the submodule. Keep that license/source information with distributed builds.

`scripts/scene3d_assets.py` uses the pinned TGX meshlet conversion modules and
NumPy, without installing the upstream GUI tools. It accepts OBJ/MTL, retains
units, local origins, normals and material colours, discards UV/image references,
and rejects invalid/degenerate geometry. For example:

```sh
python3 scripts/scene3d_assets.py --tgx external/tgx \
  --input path/to/part.obj --output build/meshes --name part
```

Outputs are constant `.h`/`.cpp` mesh data and a JSON report with triangle counts,
bounds and storage sizes. The benchmark's three assets are generated
incrementally by CMake into `build/<preset>/generated/scene3d`; assets are linked
into M7's existing QSPI image. There is no texture conversion or storage.

Prepared robot visual assets live in
[`src/ui/gui/assets/robot`](src/ui/gui/assets/robot/README.md): the four rigid
links retain their original metre/Z-up frames and colours, with 36,376 triangles
instead of the CAD exports' 623,292. The reproducible Blender workflow removes
cosmetic inserts and hidden surfaces and checks simplification error. Original
CAD, collision and switch-contact assets remain unchanged. Normal Linux/M7 builds generate
`scene3d-robot-assets` and link `proto::ui::gui::robot_assets`
and set the node material's `useMeshMaterial` to use its embedded colours.
[Matched view comparisons](docs/robot/visuals) document the visual review.
The HMI restores these full-detail assets when the view settles. Its
[interactive derivative](src/ui/gui/assets/robot/README.md#interactive-detail)
removes small surface features during changes, preserving the rigid-link frames.
Lowering display cadence does not establish
the original high-rate benchmark target described below.

The linker reserves **1,536,000 bytes** at `0xC0600000`: two 640×400 RGB565 images
and one 16-bit depth buffer, all cache-line aligned. Pixels are initialized before
publication; arbitrary C++ objects stay in internal RAM. Existing HAL cache
maintenance cleans sources before DMA2D reads. The linker enforces the reserved
2 MiB region and the 64 KiB working-storage allowance. Profiled mesh/raster hot
paths use approximately **16 KiB ITCM**, with an enforced 24 KiB cap.

`display status` reports render/completion/presentation revisions, overwritten
requests, frame latency, render wall time, bitmap transfer time and GUI-buffer
resynchronization. Render wall time includes higher-priority GUI/ICC work;
clear/grid/per-mesh sub-timings have the runtime clock's millisecond resolution.
Profiling builds additionally record DWT scopes for these stages, GUI widget
updates, DMA completion waits and buffer synchronization. DWT scope durations
include preemption; use TraceX scheduling alongside them.
The benchmark deliberately places its image at odd coordinates `(49,137)`.

Reproduce the panel-free performance gate with normal Release firmware:

```sh
cmake --build --preset giga-release --target images
python3 scripts/giga_program.py flash --build build/giga-release
python3 scripts/scene3d_hardware_check.py --seconds 15
```

The script records counters and CLI/ICC diagnostics under
`build/scene3d-validation`, restores Home, and returns exit code
2 when the gate is not met. No motor command is sent. The established DMA2D
dead-time remains **16**.

Current performance for both detail levels and verification are recorded in
[HMI verification](docs/gui/hmi/verification.md). The maximum-rate synthetic
benchmark is separate from normal Home and remains unqualified at 20 fps.
The interactive mesh is a visual derivative; collision and motion geometry do
not change. [Matched images](docs/robot/visuals/interactive/comparison.png) show
both levels at the same camera position.

For a bounded measurement using normal adaptive pacing, without treating the
requested ceiling as guaranteed throughput:

```sh
python3 scripts/hmi_hardware_check.py --rates 5 --seconds 60 --observe \
  --output build/gui-optimization/final
# Same camera workload with the motion-detail mesh:
python3 scripts/hmi_hardware_check.py --rates 10 --seconds 30 --observe \
  --interactive --output build/robot-interactive/hardware/interactive
```

The test rotates only the rendered model; it sends no motor commands and restores
Home. It checks display/ICC health, heap change and stack headroom. Ordinary tests
without `--observe` retain the fixed-rate qualification gate.

Host regressions cover deterministic shaded output, depth/occlusion,
hierarchy, near-plane/viewport clipping, invalid input, latest-only scheduling,
immutable displayed images, stalled handoff, visibility changes and stopping.
The existing Linux GUI interaction, presentation-timeout and X11 tests also pass.
The HMI supplies orbit/zoom/reset and the reusable viewport with the measured
detail-dependent operating envelope documented above. The original high-rate
benchmark acceptance and powered/physical-panel validation remain separate.

### Verification

```sh
cmake --build --preset debug-linux
ctest --test-dir build/debug-linux -R '^gui\.' --output-on-failure
# All host regressions, including existing motion/ICC tests:
ctest --test-dir build/debug-linux --output-on-failure
cmake --build --preset giga-debug
python3 scripts/giga_program.py flash --build build/giga-debug
# Performance acceptance uses optimized Release firmware, without a debugger:
cmake --build --preset giga-release
python3 scripts/giga_program.py flash --build build/giga-release
python3 scripts/gui_hardware_check.py --build build/giga-release --seconds 600
# After endurance, inspect pixels and deliberately remove LTDC interrupts:
python3 scripts/gui_hardware_inspect.py
```

The GUI tests use SDL's dummy video backend automatically. They cover pixel
checks/captures, dragging, resized letterboxing, focus-loss release, screen
transitions, request saturation, missing presentation completion, DMA errors,
cancellation and lost wakeups. `gui-*.bmp` captures are written inside the test
build directory. `GraphicsDMA::verify()` also runs on GIGA at startup, comparing
fill/copy/conversion/blend results and guard pixels at odd offsets and widths.
`graphics verified=1` in `display status` confirms it completed successfully.
The hardware scripts require pyserial (and Pillow for exported PNGs), keep motors
disabled, and write artifacts under `build/`. The inspection script reads both
framebuffer slots, checks color-bar pixels above the persistent Stop strip and
Home image content, then masks LTDC interrupts. It requires a bounded GUI fault, zero backlight duty
and working CLI/ICC before resetting both cores. Live SWD readback is not an atomic screenshot; inspect the exported images too.

Current HMI results and image-specific limits are recorded in
[HMI verification](docs/gui/hmi/verification.md). The old showcase's frame-rate
numbers do not qualify the robot HMI. Normal idle pages use dirty-region redraws;
3D presentations are counted separately from GUI ticks and LTDC scanout.

**Physical panel validation remains pending:** supply/reset timing at the panel,
visible RGB ordering/orientation, pixel-clock phase, tearing, backlight response,
ST1633i communication/coordinates and independent supply sequencing. Rendering
and LTDC presentation counts measured without a panel do not establish any of
those properties. The robot HMI is implemented and exercised in Linux; physical
display/touch and calibrated, powered robot acceptance remain separate.

## Linux sanitizer checks

Build and run the complete Linux test suite with AddressSanitizer,
UndefinedBehaviorSanitizer and leak detection:

```sh
cmake --preset sanitize-linux
cmake --build --preset sanitize-linux
ctest --preset sanitize-linux
```

The test preset sets `ASAN_OPTIONS=use_sigaltstack=0` because the ThreadX Linux
port owns its threads' alternate signal stacks. Instrumented builds also reserve
at least 1 MiB of native stack per simulated thread for sanitizer overhead;
firmware stack sizes are unchanged. Memory and leak checking remain enabled.
Instrumented simulator workflows receive three times the host wall-time wait
budget, since geometric queries and rendering run more slowly; simulated time,
motion limits and controller deadlines are unchanged. GUI input latency is still
recorded, but its 50 ms performance assertion applies only to uninstrumented
builds. All interaction, pixel, ownership and shutdown checks remain active.
LeakSanitizer needs permission to inspect process threads; run these tests outside
a ptrace-restricted sandbox. These checks exercise simulated
hardware; STM32 behavior requires separate hardware validation.

## Application, HAL and runtime linting

Run the configured readability, naming, bug-prone, modernization, performance,
static-analyzer and Core Guidelines checks on production code in **`src/`,
`platform/hal/` and `platform/runtime/`**, including both Linux and STM32
implementations, with:

```sh
cmake --preset debug-linux
cmake --build --preset debug-linux --target clang-tidy
```

Alternatively, `cmake --preset clang-tidy-linux` followed by
`cmake --build --preset clang-tidy-linux` prepares a separate analysis directory.
These are explicit analysis targets; normal builds still use GCC without linting.

The runner requires Docker, Python 3, CMake/Ninja, the project's GCC 16 Arm
toolchain (including newlib/libstdc++ headers), and host ncurses/SDL2 development
headers. It uses a pinned Pneumo devcontainer image with matching
Clang/P2996, clang-tidy and reflection headers. If the image is not already
installed, pull it once:

```sh
docker pull ghcr.io/daleondev/pneumo-devcontainer@sha256:1c10d580f47f4fa402da038896027629ded2d94de4ddd0f382f8a63830fae3e7
```

The container runs without network access, with project sources mounted read-only.
Analysis copies of the compilation databases select Clang and reflection flags.
Linux analysis uses the image's libstdc++. STM32 analysis uses
`--target=arm-none-eabi`, the selected Cortex-M4/M7 and FPU settings and the real Arm
toolchain's libstdc++/newlib headers, mounted read-only. Real host ncurses and SDL2 headers
are copied into the report directory. Firmware build flags,
dependency declarations and application sources are not rewritten.

The runner configures private STM32 CMake directories under
`<build-directory>/clang-tidy/configurations/stm32-io/` and `stm32-ui/` to obtain the HAL and runtime's
actual includes and definitions. It generates the M7 GUI/scene assets needed by
the real headers without building or flashing firmware. Separate analysis
databases preserve Linux, M4 and M7 contexts for shared sources. Every active production
HAL/runtime C/C++ source must have a compilation command; retained unbuilt board
implementations are excluded from that inventory; setup fails if a newly
added file is missing from these configurations. Runtime C sources use Clang's C
driver without C++ reflection flags. The shared `runtime/startup.cpp` hook uses
the main `Application` target's configuration, excluding its duplicate test and
example compilation commands.

All `test/` and `tests/` directories, including unit tests, test helpers, model
tests and hardware bench programs, are excluded from source selection, header
diagnostics and reports. No test configurations are prepared for linting.
External dependencies and copied sources in `vendor/` directories, including the
runtime's GCC source snapshot, are also excluded. Their real headers are still
parsed when required by a production source. Static analysis does not replace GCC
builds or hardware tests.

The runner generates `reflection-include/` from the pinned Clang `<meta>` and
consteval-type-trait headers. Only their library includes, namespace wrappers and
library-specific declaration macros are adapted for libstdc++; the reflection
implementations and compiler intrinsics are preserved. No lint-specific HAL,
ThreadX or callback stubs are used. STM32 sources are checked against the real
hardware headers in their ARM context.
Pneumo selects its existing Clang reflection workaround by the
reflection header instead of the surrounding standard library. Updating the image
requires revalidating this adaptation; missing expected header markers fail setup.

The runner invokes clang-tidy directly for each source, without a separate syntax
precheck. Each invocation's raw output is printed as it finishes, keeping the
diagnostics together during parallel runs. The console includes clang-tidy's
source excerpts, notes and check names; custom progress lines, summaries and
deduplicated findings are omitted.

CLI registration uses explicit command namespace reflections, and thread
annotations use reflection operations supported by both compilers. Stack and heap
tables in `cli/utilities.cpp`
use `std::vformat_to` to avoid Clang/libstdc++'s compile-time dynamic-width checking
incompatibility. These table formats are checked at runtime; other format strings
retain compile-time checking. Blocking compiler errors cannot be disabled with
clang-tidy check filters. See the [clang-tidy documentation](https://clang.llvm.org/extra/clang-tidy/).

Reports are saved separately in `<build-directory>/clang-tidy/`:

- `findings.txt`: deduplicated `src/`, `platform/hal/` and `platform/runtime/`
  diagnostics from fully parsed files.
- `partial-findings.txt`: review-only diagnostics if clang-tidy fails to parse
  a file; normally empty.
- `summary.txt` and `report.json`: coverage, blocked files and their errors.
- Per-context directories containing per-source `.log` and `.yaml` files: full
  diagnostics and suggested replacements. `analysis.json` lists the selected
  commands and their databases; the JSON report records each invocation's context
  and duration.
  Replacements are **never applied automatically**.

Exit status is `1` for findings in fully parsed files, and `2` for tool failures or
when no file can be fully checked. Partial coverage is accepted by default;
compiler errors remain visible in the raw output and saved coverage report.
To require complete coverage:

```sh
python3 scripts/clang_tidy.py --build-dir build/debug-linux --strict
```

Variable declarations must use **direct brace initialization**, for example
`double time{0};` and `auto count{10};`. Copy initialization (`double time = 0;`),
copy-list initialization (`double time = {0};`) and parenthesized initialization
(`double time(0);`) are lint errors. The same policy covers explicit member
defaults and constructor member/base initializers. Parameters, range-for variables
and lambda init-captures retain their required syntax.

The native `protomate-brace-initialization` clang-tidy check is ported from
LabServer's `BraceInitializationCheck.cpp`. The existing runner loads it with
`--load`, including during configuration verification; `.clang-tidy` promotes
its diagnostics to errors. Both `modernize-use-default-member-init.UseAssignment`
and `cppcoreguidelines-pro-type-member-init.UseAssignment` are explicitly false
so their suggested member initializers also use braces.

`scripts/clang-tidy/build-style-check.sh` builds the plugin against the **exact
Clang/P2996 revision** in the pinned image. The first run downloads that revision's
LLVM sources and generates the matching headers; this bootstrap needs network
access. Sources, generated headers and the plugin are cached under
`build/clang-tidy-plugin/`. Later unchanged runs reuse the plugin; analysis stays
offline. Do not load the plugin into a different Clang version.

Run the native rule's regression fixtures with:

```sh
bash scripts/clang-tidy/test-style-check.sh
# or: cmake --build --preset debug-linux --target clang-tidy-style-test
```

The plugin emits **no automatic replacements**: changing constructor syntax can
select a different `std::initializer_list` overload or change deduction/narrowing.
Use a documented, narrowly named `NOLINT(protomate-brace-initialization)` exception
where the alternate construction semantics are intentional. The rule reports
violations without rewriting sources. Normal builds still do not run lint. Direct clang-tidy invocations must load `build/clang-tidy-plugin/protomate-style.so`.

For strict verification of the brace policy alone:

```sh
python3 scripts/clang_tidy.py --build-dir build/debug-linux \
    --checks='-*,protomate-brace-initialization' --strict
```

The full `clang-tidy` target retains every configured check. The native rule
recognizes C++26 expansion-loop bindings and ignores compiler-generated range
temporaries; declarations inside loop bodies are still checked.

The naming rules live in `.clang-tidy`. Clang 21 uses `GlobalConstant` for global
constants including constexpr, and `PublicMember` for public fields including
ordinary struct fields. `tooling.clang_tidy` tests diagnostic classification,
source/test/vendor filtering, HAL/runtime inventory, C/C++ commands, target contexts
and failure handling without Docker.

Keep explicit default member initializers in aggregate configuration types,
including `{}` for class-type members. The
[`readability-redundant-member-init`](https://clang.llvm.org/extra/clang-tidy/checks/readability/redundant-member-init.html)
check is disabled because removing those defaults conflicts with GCC's
`-Wmissing-field-initializers` under `-Wextra`. The compiler warning remains
enabled; lint fixes must preserve a warning-free GCC build.

Cognitive-complexity checks count application control flow, excluding macro
expansions. Compiler-generated coroutine diagnostics have narrowly named,
commented `NOLINT` markers; the remaining check families stay enabled.

## HAL architecture

The HAL provides peripheral access and device behavior. Robot motion planning,
homing policy, gearing, kinematics and CLI commands belong to the application
modules being rebuilt in `src/io`, `src/ui` and `src/common`. Thread scheduling, the C++ runtime and filesystem integration belong
to `platform/runtime`.

### Layers and responsibilities

Paths in this table are relative to [`platform/hal`](platform/hal).

| Location | Responsibility | Dependencies within the HAL |
| --- | --- | --- |
| `drivers/itf` | Peripheral capability interfaces (`ISpi`, `IUart`, `IDigitalInput`, etc.) and their configuration/value types | Other driver contracts and common `util` |
| `drivers/impl/stm32`, `drivers/impl/linux` | Concrete classes implementing those interfaces using the selected platform | Driver contracts, driver helpers and platform support |
| `drivers/impl` | Shared step-generator/output algorithms | Driver contracts, helpers and the internal `StepHardware` backend boundary |
| `drivers/factory` | Select a backend, validate a supported resource/route, claim ownership and return its interface | Driver implementations and other driver factories |
| `devices/itf` | Device capabilities such as `IMotorFeedback`, `IStepperDriver`, `IButton` and `ILed` | Device/driver contracts and common `util` |
| `devices/impl` | Device behavior and protocols: TMC2209, DM542T, LAN9253, feedback, button and LED adapters | Injected driver interfaces and device helpers |
| `devices/factory` | Construction that differs by platform, currently TMC2209 transport/model composition | Driver factories and the selected device model |
| `board/board.hpp`, `board/arduino_giga/board.cpp`, `board/linux/board.cpp` | Translate robot/board roles into pins, peripherals, driver addresses and device compositions | Public factories and portable device implementations |
| `core` | Expose resources belonging to the executing processor (`M4`, `M7`, or `Host`); select its status LED and runtime timer | Board factories and capability contracts |
| `hal.hpp/.cpp`, `stm32`, `linux` | Platform startup, console, panic handling, interrupt dispatch and platform synchronization | Selected platform/vendor facilities |
| `util`, `drivers/util`, `devices/util` | Common result types or helpers private to their respective layer | Same-layer or lower-level contracts; never board/application policy |

Each compiled layer has its own target. The public dependency chain is:

```text
platform::hal → hal::core → hal::board → hal::devices → hal::drivers
```

Each target compiles only its own sources; CMake selects the STM32 or Linux
backend. GIGA provides onboard resources plus M4 motor timers/DMA, USART2,
reference/diagnostic inputs and feedback.
The Linux board composition supplies virtual resources for device regression
tests; it does not define GIGA motor wiring. The Linux step and encoder workers are compiled as `hal_linux_services`
objects using the runtime's C++ ABI and included in `hal_drivers`. Their opaque
service objects keep that ABI boundary out of public interfaces.

Interfaces and public factory headers contain no vendor handles, platform
headers or board wiring. Configuration types live beside the interface, so an
implementation never needs a factory header to obtain its own types.
[`GpioTypes.hpp`](platform/hal/drivers/itf/GpioTypes.hpp) contains GPIO values and
configuration; the actual input/output interfaces are separate.

Concrete classes are declared in `.hpp` files and implemented in matching `.cpp`
files. Coherent families can share a pair, as `GpioInput` and `GpioOutput` do in
`Gpio.hpp/.cpp`. Shared algorithms stay in the common implementation directory;
platform models stay in `impl/linux`. Small inline methods and template helpers
remain in headers. Helper directories and namespaces consistently use **`util`**:
`hal::util` for common/driver helpers and `hal::device::util` for device helpers.

Device behavior uses injected interfaces and contains no peripheral selection
or MCU register access. The explicit platform exception is synchronization:
`InterruptGuard`, `Mutex` and `ThreadMutex` protect callbacks and shared state.
TMC2209 and LAN9253 protocol classes can be concrete portable classes; capability
interfaces are introduced where callers need interchangeable implementations.
`IConfigurableStepperDriver` extends `IStepperDriver` with optional configuration.

The board layer defines wiring and composes those objects. It contains no host
simulation registry or simulated register behavior. The Linux TMC2209 device
factory attaches `Tmc2209Model` to a generic UART; tests can instead construct
and inject their own model/transport. Generic SPI/UART drivers contain no motor
or EtherCAT protocol. `hal.hpp` is the startup/vendor bridge and is not a header
for ordinary device implementations or public contracts.

Application entry points and runtime counter setup use `hal::core`:

```cpp
auto led = hal::core::create_status_led();
auto timer = hal::core::create_runtime_timer();
constexpr auto processor = hal::core::id(); // Id::M4, Id::M7, or Id::Host
```

`hal::core` uses `util::executing_core()` to select the compile-time construction
catalog in [`core/Catalog.hpp`](platform/hal/core/Catalog.hpp). Each annotated
entry lists the available roles and the board factories that create them:

```cpp
[[= util::Core::M4]] static constexpr Devices m4{
    .runtime_timer = [] { return board::create_timer(timer::Peripheral::Tim5); },
    .rtc = board::create_rtc,
    .rng = board::create_rng,
    .intercore_channel = board::create_intercore_channel,
};
```

Omitted roles are unavailable: their core factory returns `nullptr` (or an
array of null pointers for the driver set). Reflection
selects the entry at compile time and rejects missing or duplicate assignments
for the selected processor. No device is constructed by reading the catalog.
M4 owns TIM5 and has no physical LED/button; M7 owns TIM12, green/PJ13,
red/PI12, blue/PE3 and the user button/PC13. Both entries explicitly include shared RTC/RNG and their
local inter-core endpoint. M4 also lists all motor factories; M7 has none.
IO/UI are application names, not HAL identities.

`hal::board` only describes physical wiring and construction. It has no core
parameter, core identity include or ownership policy. For example,
`board::create_led(LedId::Red)` is available independently of the caller.
GPIO and timer factories likewise select hardware without consulting core
assignments. Application/runtime code uses `hal::core` to respect the catalog;
direct board/driver access is intentionally unrestricted and must not operate a
resource concurrently owned by another processor. Existing per-image resource
leases and cross-core synchronization for shared devices remain in place.

Timer factories expose initialized TIM5 and TIM12 to either image. They wrap
the peripheral without resetting it; CubeMX/platform startup still initializes
the hardware once. Changing a catalog assignment that moves peripheral
initialization or interrupts also requires updating that startup configuration.
Motor wiring and startup behavior are listed in the GIGA table below.
SPI5 is prepared for EtherCAT. M7's runtime owns internal-flash file storage;
QSPI remains reserved for executable images and assets.

Host tests retain virtual board devices. `Core::Host` selects its own runtime
timer, RTC/RNG, error LED and button, with no status LED or hardware peer channel.
The board can still construct its virtual LEDs independently of those roles.

### Factories and resource selection

Configurable factories take a typed `Configuration` describing hardware resources.
GPIO selects pins; buses select a peripheral; PWM/encoder configurations select a
peripheral and its pin/channel route. Device roles and wiring choices belong to
`hal::board`, not to the transport drivers.

```cpp
auto spi = hal::spi::create({ .peripheral = hal::spi::Peripheral::Spi5 });
auto uart = hal::uart::create({
    .peripheral = hal::uart::Peripheral::Usart2,
    .transport = { .local_echo = true, .settle_time = std::chrono::milliseconds{1} }
});
auto timer = hal::timer::create({ .peripheral = hal::timer::Peripheral::Tim5 });
auto pwm = hal::pwm::create({
    .timer = hal::timer::Peripheral::Tim1,
    .channel = hal::timer::Channel::Channel1,
    .pin = { hal::gpio::Port::E, 9 }
});
auto encoder = hal::encoder::create({
    .timer = hal::timer::Peripheral::Tim3,
    .a = { hal::gpio::Port::B, 4 }, .b = { hal::gpio::Port::A, 7 }
});
```

These examples describe the retained factory contracts. On current hardware,
onboard GPIO, per-core timers, serialized RTC/RNG access and the inter-core
channel are available. M4 owns TIM5; M7 owns TIM12 and USB CDC.
RTC and RNG are shared through hardware-semaphore protection. Motor peripherals
use TIM2/TIM3/TIM6/TIM7, DMA1 and USART2 on M4. SPI5 is prepared for EtherCAT, and TIM8 drives the display backlight.
M7's runtime mounts the internal-flash volume. Native Ethernet remains unassigned.

Linux provides virtual peripheral resources and device models for regression
tests. Its board composition does not claim physical wiring. Construction never
starts motion; owners must explicitly start devices and manage their callbacks.
Bus exclusivity and device-level transaction serialization remain separate
responsibilities.

Operations report failures using `hal::util::Result` and `std::error_code`.
The STM32 HAL-status conversion lives in `stm32/HalResult.hpp`; Linux failures
use standard error codes or the host's `errno`. Callback context and permitted
operations are specified on each interface. STM32 interrupt callbacks must be
short and nonblocking; callers must respect callback lifetime and unregister/
stop requirements before releasing their dependencies.

### Checking the structure

[`verify_hal_architecture.py`](cmake/tests/verify_hal_architecture.py) checks
production includes, helper naming, interface/factory boundaries, selected
platform sources and CMake source ownership. It is registered as
`hal.architecture` in the Linux CTest suite. Both platform selections can be checked
explicitly after configuring them:

```sh
python3 cmake/tests/verify_hal_architecture.py --source . --build build/debug-linux
python3 cmake/tests/verify_hal_architecture.py --source . --build build/giga-io-debug --platform stm32
python3 cmake/tests/verify_hal_architecture.py --source . --build build/giga-ui-debug --platform stm32
ctest --test-dir build/debug-linux --output-on-failure
```

Host device tests verify software behavior. Electrical timing and peripheral
ownership require separate hardware validation as each subsystem is ported.

## Processor-to-processor messaging

The ICC implementation in `proto::common` supports serialized topics, services
and actions, with peer readiness, connection health and state-change callbacks.
The bridge is independent of hardware; the common library also includes the
HAL/runtime inter-core adapter and, on Linux, the in-process transport.
The [two-bus examples](src/common/icc/examples/README.md), including the
[action example](src/common/icc/examples/actions.cpp), also run independently.

The implementation separates message routing from byte transport:

| Location | Responsibility |
| --- | --- |
| [bridge/Bridge](src/common/icc/bridge/Bridge.hpp) | Public registration API, lifecycle, send/receive loops, fair scheduling and failure handling |
| [bridge/TopicBridge](src/common/icc/bridge/TopicBridge.hpp) | Reflected topic registration, subscriptions, bounded FIFO/latest-value delivery, drop statistics and incoming publications |
| [bridge/ServiceBridge](src/common/icc/bridge/ServiceBridge.hpp) | Reflected service registration, deferred proxies, call IDs, replies, cancellation, deadlines and cleanup |
| [bridge/ActionBridge](src/common/icc/bridge/ActionBridge.hpp) | Reflected action registration, deferred admission, feedback, cancellation, acknowledged terminal results and cleanup |
| [bridge/ConnectionHealth](src/common/icc/bridge/ConnectionHealth.hpp) | Handshake, acknowledged heartbeats, deadlines and connection state notifications |
| [bridge/Frame](src/common/icc/bridge/Frame.hpp), [bridge/OutgoingWakeup](src/common/icc/bridge/OutgoingWakeup.hpp) | Shared wire encoding and coalesced readiness signals per lane |
| [transport/](src/common/icc/transport/ITransport.hpp) | Transport interface and paired in-process transport; transfers bytes without interpreting messages |

`Bridge` owns its routing and connection helpers by value and serializes registration against startup.
The helpers run on its coroutine context and cannot call back into `Bridge` or
access the transport. Shutdown first drains actions while communication continues,
then closes services and disconnects topic subscriptions after its six transport
loops and health timer loop finish. The caller owns the context and runner thread;
the previous application thread glue is archived with `system_threads`.

```mermaid
flowchart LR
    IO[IO bus] <--> IB[IO bridge]
    IB <-- serialized frames --> T[InProcessTransport pair]
    T <-- serialized frames --> UB[UI bridge]
    UB <--> UI[UI bus]
```

The standalone topic example owns two independent buses and two bridges. Both bridges run on one
coroutine context on a dedicated p2p thread. Each has a send and receive coroutine per lane, all on the same context.
They suspend while waiting and yield after each frame so normal traffic cannot
monopolize the context. Application subscriptions dispatch on
their caller's thread. The application shells already use separate contexts and
runners, matching the intended ownership of the future core applications.

[Topics.hpp](src/common/icc/examples/Topics.hpp) specifies the forwarded topics using
`pnm::msg::Topic<T>` fields annotated with a publisher. No catalog
instance is constructed. Register the shared catalog once per bridge, identifying
the local publisher:

```cpp
io_bridge.registerTopics<Topics>(TopicPublisher::IO);
ui_bridge.registerTopics<Topics>(TopicPublisher::UI);

// Infer the payload type and topic name from the annotated field.
io_bus.topic<^^Topics::demo_io_state>().publish("idle");
```

Matching publisher annotations become outgoing topics; the peer's publications
become incoming. The application-defined enum must declare exactly two distinct
values. Annotation order is irrelevant; unrelated annotations are ignored.
Fields without the publisher annotation stay local. Forwarded fields require one
publisher. Names default to the field identifier with every `_` replaced by `/`:
`demo_io_state` becomes `demo/io/state`. One optional nonempty narrow `FixedString`
annotation overrides the name verbatim. Multiple name annotations and annotated
static declarations are rejected. Registration uses catalogs only. Register before
`start()`; names must be unique across both directions on each bridge.

The service API uses a separate application-defined `ServiceProvider { IO, UI }`
enum and annotated nonstatic `pnm::msg::Service<Request, Response>` fields.
`registerServices<Services>(ServiceProvider::IO)` identifies the IO side;
`bus.service<^^Services::demo_io_echo>()` derives the name and both payload types from
the field. No catalog object is constructed. Names and provider annotations
follow the same validation and ordering rules as topic names and publishers;
fields without the provider annotation stay local.
Matching provider annotations accept incoming requests for local handlers; the
peer's services forward outgoing requests. Replies return automatically.
[Services.hpp](src/common/icc/examples/Services.hpp) illustrates the catalog and
[services.cpp](src/common/icc/examples/services.cpp) runs an echo service. Applications
own and dispatch their handlers using the native or coroutine pneumo API. Bridge
proxies use deferred replies; they never execute application handlers or block
waiting for a result on the p2p context. Native readiness notifications and
deadline timers wake the bridge. No waiting thread is created per call.

The lane enum, priority order and background frame limit are defined once in
[`hal/drivers/itf/Lanes.hpp`](platform/hal/drivers/itf/Lanes.hpp) in the
`hal::intercore` namespace, alongside the physical inter-core channel interface.
The header depends only on standard headers; ICC consumes this HAL contract
through `hal::drivers`, while HAL remains independent of application code.
`icc::Lane` and `hal::IInterCoreChannel::Lane` are aliases of the same type.

`ITransport` asynchronously sends and receives complete frames using borrowed
spans. Its `Lane::Urgent`, `Lane::Normal` and `Lane::Background` queues have independent
capacity, waiters and sender/receiver coroutines. `InProcessTransport::pair()`
reserves eight frame slots per lane and direction (six queues). Normal and urgent
frames may use 2048 bytes; background frames are limited to 512 bytes including
header and topic name. A full background queue cannot block normal or urgent
traffic. Each lane preserves FIFO order. At each receive boundary, queued urgent
frames take precedence over normal, which take precedence over background. An
already consumed frame is not preempted. Independent rings can enqueue concurrently;
priority applies when consuming frames. Both peers must service all lanes in use.
Sustained higher-priority traffic may starve background delivery. Urgent traffic remains bounded and can itself back up.
It does not preempt a running handler or rescue a stalled context. Cancellation and `close()` wake waiting operations; closing either
endpoint disconnects the pair. Reconnection requires a new pair.

The hardware transport's priority-3 notification worker outranks both ICC dispatchers,
so a continuously ready ordinary lane cannot prevent urgent receive wakeups. It
only forwards readiness; it does not decode messages or run application handlers.
It checks the shared ring counters
before waking a lane. Empty receivers and full senders remain suspended;
consuming a higher-priority frame also rechecks lower-priority receivers.
Each transfer direction reuses one coalesced notification, including across
cancellation. Bridge heartbeats wake only their urgent sender; service/action
events leave the background sender asleep. The channel's direct `wait()` awaiter
avoids constructing an extra coroutine task for these notifications.
The ThreadX C++ runtime suspends `std::this_thread::yield()` for one tick so
libstdc++ cancellation spinlocks cannot starve a lower-priority lock owner.
STEP interrupts do not use this thread-level wait.

The frame has a 16-byte header: version (currently 7), frame kind, 16-bit name
length, 64-bit call ID and 32-bit remaining timeout in milliseconds. Integers are
little endian. Name bytes and serialized payload follow, with a 2048-byte total
limit. Topics, service requests and action goals identify their destination by
name. Replies and action lifecycle frames use correlation IDs; services and
actions have separate ID spaces. Topics use zero call ID and timeout. Action
result payloads start with an explicit one-byte status; errors have explicit
one-byte codes independent of native enum layouts.
Payloads use pneumo serialization. `std::string` sends its characters, not its
native object layout. Compound types need explicit serialization adapters with
portable field widths and byte order before use between different targets.

Each bridge accepts up to 16 topics, 16 services and 16 actions. Topics default to
normal-lane, latest-only delivery. Optional catalog annotations choose a lane and
bounded FIFO delivery, independently:

```cpp
struct Topics {
    [[= TopicPublisher::IO, = icc::Lane::Background,
      = pnm::msg::SubscriptionOptions{ .capacity = 16 }]]
    pnm::msg::Topic<std::string> io_logs;
};
```

`SubscriptionOptions` accepts 1–64 queued records; the default overflow policy
is `DropOldest`, with `DropNewest` available to preserve the oldest queued records.
The bridge dispatches one record per turn using Pneumo's `Subscription::pollSome()`.
Readiness notifications wake the appropriate lane. Publication never waits for
transport space; a blocked background send suspends only its own coroutine while
the bounded subscription handles overflow. At most one additional topic frame per
lane is in flight, plus the transport's reserved slots. `topicStatistics("io/logs")`
returns pending subscription records and cumulative dropped records; it excludes
transport/in-flight frames and returns `nullopt` after cleanup or for an unknown
or incoming topic. Overflow is counted, and oversized background records are also
dropped and counted instead of failing the control connection. Consumers should
likewise use bounded subscriptions and dispatch UART output on their own worker.
The application's IO sink and UI subscriber use this path for `Topics::io_logs`.

Background is best effort: shutdown cancels blocked sends without draining logs,
and no delivery acknowledgement or replay is promised. Services and actions stay
on the control lanes. Operational faults must be conveyed separately from their
background log text.
Service requests are never coalesced. There are eight forwarded calls per
lane and direction, eight queued/pending requests per local proxy, and eight queued
rejection replies per lane. Normal traffic cannot consume urgent service slots. Excess calls report `Busy`; a peer overrunning the rejection
queue fails the connection rather than growing memory without bounds.
Completed replies are retained until queued into the transport or shutdown.
The normal sender rotates between ready action, service and topic traffic; the
urgent sender rotates between action cancellation/ACKs and service traffic.

Service caller timeouts and cancellation terminate the local wait and forward a
best-effort cancellation to the peer. Remaining timeout budgets are rounded up
to milliseconds and capped at `UINT32_MAX` milliseconds. They are not synchronized
cross-core deadlines and do not subtract time spent inside the transport.
Cancellation/timeout does not prove that a handler's side effects stopped.
Late replies are ignored by the caller, but release the reserved bridge slot.
Cancelled calls retain that slot until the peer responds or the connection closes,
bounding cancellations that overtake requests. Call IDs are never reused within a bridge.
Transport failure completes pending service calls with `TransportError`; explicit
local service shutdown uses `Cancelled`. Neither result proves that remote hardware stopped.
Stop both bridges while the context still runs, then stop and join its runner.
New connections require fresh bridge/transport instances. No command is replayed
or resumed automatically. Full session identities and stale-frame protection
across independently restarted cores remain future work.

Actions use `registerActions<Actions>(ActionProvider::IO)` and reflected
`bus.action<^^Actions::member>()` handles on both native and coroutine buses.
Their catalogs follow the same optional name and provider rules as services.
[Action usage](src/common/icc/examples/actions.md) explains the provider and caller roles.
The bridge forwards acceptance only after the real provider accepts. Feedback is
latest-only; terminal results are retained until acknowledged by the peer. Each
direction admits eight forwarded goals; each proxy admits eight native goals.
Eight rejection slots and sixteen acknowledgement slots have independent bounds.
Excess work reports `Busy`; malformed framing or peer capacity abuse fails the link.

Action cancellation requests cleanup and does not finish the goal. A goal
cancelled before forwarding can complete locally because no remote work exists.
Once forwarded, only a terminal response confirms the outcome. Admission timeouts
apply until acceptance, not throughout execution. Timed-out/abandoned callers still
retain bridge records until the remote terminal result or connection closure.
No submitted goal is automatically replayed.

`stop(grace)` stops action admission and requests cancellation, keeping workers
and communication running until results are delivered. The default grace is
500 ms. If it expires, `failure()` records the timeout and unfinished callers get
`TransportError`, not a fabricated `Cancelled` outcome. Provider cleanup must
continue independently after a communication failure. Native caller callbacks
run when the application polls its handle, never on the bridge's context thread.
The p2p application thread and runtime-backed example runners use a 32 KiB stack
for nested Debug serialization; the portable bridge does not configure threads.

Cancellation and action terminal acknowledgements always use the urgent lane.
A cancellation may arrive before its normal request/goal; bounded records ensure
the later command never reaches an application provider. Action results and
feedback retain their normal-lane ordering. A cancellation request still does not
confirm that already-running work has stopped; its terminal response may wait for
normal capacity. Service cancellation carries one byte identifying the original
request lane (0=normal, 1=urgent).

Services may explicitly reserve the urgent lane in their shared catalog:

```cpp
struct Services
{
    [[= ServiceProvider::IO, = p2p::Lane::Urgent]]
    pnm::msg::Service<StopRequest, StopResponse> stop;
};
```

The annotation applies to requests and replies, and both peers must agree. Other
services default to normal; topics, goals, action acceptance/feedback/results use
normal. Keep urgent service handlers short or defer work to an IO worker. The
control catalog uses this lane for Stop and Disable.
Connection management uses that same urgent lane ahead of application traffic.

A bridge starts in `Stopped`, then reports `Connecting` and exchanges Hello/Ready
frames before forwarding application data. Calls queued during this handshake
remain local and retain their native timeout. `Connected` means both peers have
completed the version-compatible handshake; it does not validate application
catalogs, motor configuration or physical hardware readiness.

Connection monitoring defaults to a 100 ms heartbeat and a 500 ms active-link
deadline, with a separate 5 s initial handshake allowance. The GIGA's M4 Debug
application constructs its workers from cold QSPI more slowly than M7; the
measured startup hello arrived about 730 ms after M7 began waiting. The startup
allowance applies only before `Connected` and does not extend motion leases,
queued service deadlines or the active heartbeat deadline.
Pass `ConnectionOptions{.heartbeat = 100ms, .timeout = 500ms, .startup_timeout = 5s}`
as the fourth constructor argument to configure these independently.
Only a fresh acknowledgement of the
outstanding heartbeat refreshes the deadline. Incoming publications, peer
heartbeats and repeated old acknowledgements cannot conceal a broken outgoing
path. One outstanding challenge and one coalesced reply bound control storage.
Management kinds are Hello (13), Ready (14), Heartbeat (15), HeartbeatAck (16)
and Goodbye (17). Their name, timeout and payload are empty; only the heartbeat
frames carry a nonzero challenge ID.
The health coroutine has its own timer and wakeup, so its deadline still expires
when either transport sender is blocked. Deadlines are checked before dispatch,
including after a stalled context resumes.

Register a connection callback before `start()` and read the current snapshot
with `connectionStatus()`. For example, publish the notification to a **local**
application topic that an IO worker consumes:

```cpp
auto connectionEvents = io_bus.topic<p2p::ConnectionStatus>("local/p2p/connection");
io_bridge.setConnectionCallback([connectionEvents](p2p::ConnectionStatus status) {
    connectionEvents.publish(status);
});
```

The callback runs on the p2p context outside internal locks. Keep it short: notify
or enqueue work; do not block, join workers, call `stop()`, or destroy the bridge
inside it. Captures must outlive the bridge. No notification is emitted at
registration; `Connecting` is the first event. State changes are emitted once,
not on every heartbeat. Callback exceptions fail the connection while preserving
teardown. The callback and all pending transport operations finish before
`stop()` returns.

`Failed` is latched, with an explicit reason such as `HandshakeTimeout`,
`HeartbeatTimeout`, `PeerRestarted`, `TransportError`, `ProtocolError`, or
`ShutdownTimeout`. Outstanding service/action handles receive `TransportError`,
local provider cancellations are requested, and bridge-owned queued work is
invalidated. An accepted action still needs application cleanup: link failure
never confirms a physical stop. A fresh Hello on an established link requires
explicit recovery; this detects an announced restart, not every possible stale
frame from an earlier boot.

An orderly local shutdown reports `Stopping` then `Stopped`, after action draining
and an urgent Goodbye. A peer Goodbye with no outstanding actions also reports
`Stopped`, with reason `PeerStopped`; if actions are still outstanding it fails
with that reason. Treat every departure from `Connected` as unavailable for new
control commands. Every failure requires deliberate reconstruction/recovery;
there is no automatic reconnection or motion replay.

All monitoring runs on the p2p context. If that entire context or processor
freezes, its local timer cannot run: an independent IO/hardware watchdog is still
needed when integrating motion control. Callback consumers own the local stop,
holding-torque policy, latched robot fault and explicit recovery. Those robot
policies are not implemented inside the portable bridge.

The archived [control message catalogs](backups/application/control/Messages.hpp),
[client](backups/application/control/ControllerClient.hpp) and
[server](backups/application/control/ControllerServer.hpp) are reference material
for rebuilding the execution boundary. They are not part of the current normal build.

STM32 Debug compiles the portable ICC library with `-Os` while retaining debug information.

Build and test the bridge independently:

```sh
cmake --build --preset debug-linux --target application_p2p_example application_p2p_service_example application_p2p_action_example application_p2p_transport_tests application_p2p_service_tests application_p2p_action_tests application_p2p_urgent_tests application_p2p_connection_tests
./build/debug-linux/src/common/icc/examples/application_p2p_example
./build/debug-linux/src/common/icc/examples/application_p2p_service_example
./build/debug-linux/src/common/icc/examples/application_p2p_action_example
ctest --test-dir build/debug-linux -R '^application\.p2p\.' --output-on-failure
```

## Arduino GIGA hardware, boot and bring-up

**Software status:** the STM32H747 port, external-flash loader, USB console,
ICC transport, motor peripherals and display/touch bring-up commands are
implemented. Debug, Release, M4 RAM-debug and the isolated bench build as
separate M4/M7 images. Host tests exercise the existing motion/ICC behavior,
STM32 STEP/encoder register models, USB buffering and boot-image validation.
**Verified on the GIGA:** Atmel-ICE SWD access to both cores, QSPI identity
`0x1F8901`, full factory backup, QSPI erase/program/readback, and both internal
bootstraps plus the matched external-flash application pair. Factory images,
original option registers and SHA256 checksums remain in
`backups/hardware/giga-factory/`; the board now runs our firmware. Both reserved
1 MiB QSPI factory regions also verify unchanged after programming.
The complete 8 MiB SDRAM test passes across **10 hardware-reset cycles**. Each run
takes approximately 1.56 s with caches disabled: walking bits, byte/halfword
writes, full-memory address/complement and pseudorandom patterns, 250 ms refresh
retention and final zero verification. Flashing requires this test to pass.

Both ThreadX runtimes start at M7 480 MHz / M4 240 MHz, with vectors relocated to
0x20000000 / 0x10000000. USB CDC enumerates, the ICC handshake completes, and
`help`, `heap ui`, `heap io`, `stack ui`, `stack io` and `motor status` work with
no external peripherals. Drivers remain disabled. Missing/corrupt manifests,
invalid image CRCs and mismatched pair identifiers enter recovery with STEP low
and enable inactive; restoring the valid activation record restores startup.
The M4 RAM-debug pair also passes these commands; a software breakpoint at
`diagnostics::collectMemory` in SDRAM was hit and removed successfully.
The normal Debug pair also starts after a physical USB power cycle with no
debugger session active. Twelve CLI checks passed across three subsequent serial
close/reopen cycles, including heap/stack requests to M4 over ICC.
Hardware logs are in `build/giga-debug/{flash,boot-validation,cold-start-results,cold-start-console,icc-console-check}.log`
and `build/giga-ram-debug/{icc-console-check,icc-breakpoint}.log`.
The 24 MHz logic analyzer verifies STEP counts and timing in all nine bench
scenarios: tiny moves, independent starts, 100 kHz, velocity updates, stop/restart,
timer wrap, deliberate underrun, combined load and variable periods. All interval
residuals are below one analyzer sample (41.7 ns) after removing the common clock
offset. The measured frequency differs by about +0.0138% from the analyzer's
reference; neither clock is independently calibrated.

| Measured STEP check with the shared GUI active | Result |
| --- | --- |
| Three channels at 100 kHz, including combined load | Exactly 100,000 pulses per channel |
| Programmed 5 µs HIGH phase | 120–121 analyzer samples (5.000–5.042 µs) |
| Refill interrupts withheld before arming | Hardware guard stops at 512 / 256 / 128 pulses, all outputs LOW |
| Combined-load worst STEP service time | 145,327 cycles / 605.53 µs; 4.23× headroom against the 2.56 ms DMA buffer window |
| Measured individual stop call | 11,947 cycles / 49.78 µs; other channels continue |
| ICC echo packets validated during combined-load cases | 39–47 per run, zero payload errors |
| Urgent ICC echo service under combined load | Zero errors; worst observed round trip 63 ms |

All nine analyzer scenarios and an additional combined-load capture pass with
zero LTDC underruns. The M7 runs the same TouchGFX controller as the normal
application while the load case exercises QSPI reads, USB output, normal ICC
topics and urgent services. Each combined-load capture verifies 100,000 pulses
on each channel. The captures cover STEP only (`--step-only`); driver enable
remains inactive in firmware but was not connected to an analyzer channel.
Topic traffic is best effort; urgent round-trip time includes both bridge
contexts and the service worker and is not the hardware stop latency.
Raw captures, console logs, image manifest and measurements are in
`build/gui-step-results-final/`, including `repeat-1/`.

These measurements cover the isolated bench, not powered motors or external
feedback/switch inputs. Stop-call duration is not external-input-to-stop latency.
Reset-state verification remains a separate acceptance step: with only the bare
board and analyzer connected, all three STEP inputs read HIGH for approximately
172 ms during a debugger-held reset, while enable reads inactive throughout.
Fit the specified external STEP pull-downs and enable pull-up before repeating
the reset capture; firmware cannot maintain GPIO output drive while reset is
asserted. The capture and transitions are recorded in
`build/giga-step-results/reset-results.json`. These bench results do not qualify
the new integrated motion API; its application-level hardware checks are in
progress. Application-specific screens and EtherCAT robot integration remain
future work. Use the GIGA KiCad wiring; Nucleo connector numbers do not apply.

### Robot planning and execution

`src/ui/motion/Robot` owns one asynchronous M7 planning worker for executable
axis/robot requests and independent previews. Executable joint and Cartesian
point commands compile into one compact normalized profile with signed per-axis
pulse counts. M4 validates the reservation, hardware configuration, relevant
state revisions and limits before binding outputs or accepting the execution
action. The three axes share progress and a scaled stopping profile.

A Cartesian point command selects a destination and follows joint interpolation;
its TCP path may curve. Straight Cartesian paths use bounded adaptive quintic
subdivision for previews only. Preview certification reports numerical path
approximation separately from step quantization; neither establishes mechanical
accuracy. Blends, live override, hold/resume and continuous toolpath execution
remain future work.

`boardRobotConfiguration()` deliberately returns no configuration until physical
transmissions, limits, homing coordinates and robot geometry are calibrated.
Executable Linux motion obtains its configuration from the native simulator's
mechanical model. The `180` and `archived` preview fixtures are explicitly
uncalibrated and cannot authorize physical execution. Axis operations require
conversions and limits but do not require robot link geometry.

Homing seeks **backward on Axis 1/2 and forward on Axis 3**. Direction is part
of the IO capability fingerprint; UI configuration must agree. It rejects an
already-active switch, seeks contact, releases, slowly re-latches, then backs
clear again. The slow latch establishes the reference coordinate; the final
release displacement is counted normally. Debounce and the overall timeout apply
to every phase. Failed/cancelled stages remain unreferenced.

There is no cam-side tracking. Outside homing, either rotary cam activating its
switch immediately inhibits the shared enable. Worker cleanup aborts all motion
and invalidates all references. Clear the switch/check wiring, initialize the
drivers, enable, and reference again. Clearing the input or re-enabling alone
does not restore ordinary raw-motion permission. Cancelling homing while a
switch remains pressed also invokes the hard-limit shutdown, without waiting
for another GPIO edge. Active switches also prevent
enabling. A timeout is not a calibrated travel-limit measurement.

Full `robot home` owns all axes through referencing **Axis 3 → Axis 1 → Axis 2**
and a sequential return in that same order to the configured neutral pose.
The native simulator defines that pose as **Axis 1 = 0°, Axis 2 = −60°,
Axis 3 = 15 mm**: a bent arm rather than a straight-arm singularity. Neutral
moves use 25% of configured axis velocity and configured acceleration/jerk.
Completion is reported only after arrival; stopping/cancellation prevents later
stages. Individual axis/raw homing only references and releases its switch.
Physical robot configuration must supply a verified neutral pose before full
robot homing is available; simulator coordinates are not physical calibration.

Native rotary contact geometry uses the actual two-cam bodies extracted from the
CAD, not the coarse whole-link collision hulls. Nominal actuation bounds are
Axis 1 **−105.588° / +113.460°**, Axis 2 **−102.911° / +114.666°**. Operational
soft limits sit inside these contacts, halfway between each actuation/release
coordinate; homing retains the separate contact datum. See the
[simulator contact model](src/simulation/README.md) for assumptions.

Verification (2026-11-08): 13 targeted Release/Linux suites pass, including
`simulation.hmi`, `simulation.motion_api` and `simulation.integration`. They cover
neutral arrival against native plant state, cancellation/ownership, both cams,
final switch release, hard-limit inhibition of concurrent motors and recovery
that requires re-referencing. GIGA M4/M7 Debug and Release compile/link cleanly.
These changes have not been flashed or tested with powered mechanics; the
physical calibration remains unset.

```text
robot preview joints 10 80 40 --fixture 180 --start-shoulder 0 --start-elbow 68.7549354 --start-z 30
robot preview point 235 178 35 --fixture 180 --start-shoulder 0 --start-elbow 68.7549354 --start-z 30
robot preview linear 235 178 35 --fixture 180 --start-shoulder 0 --start-elbow 68.7549354 --start-z 30
robot jobs 1
robot cancel 1
```

`robot jobs` / `robot cancel` address preview jobs. Executable commands use
`motion jobs` / `motion cancel`, including commands submitted through the raw
motor interface. The preview history has 64 records; execution history has 32.
Previews require an explicit starting pose and report duration, selected elbow
branch, requested/quantized endpoint, approximation and quantization budgets,
dynamic bounds and storage consumption. Cancelling a preview interrupts its
inspection and numerical work; no preview generates STEP output.

The M7 planner runs at priority 15 with a dedicated 24 KiB DTCM stack and a
256 KiB POD arena in UI SDRAM. Planning state and execution history reuse this
reserved arena; new motion buffers do not depend on the general UI heap. M4 uses
one execution worker and a shared nine-slot profile pool for one coordinated
group or three independent axis groups. Driver operations and preparation run
outside ICC dispatch. Initial profile compilation releases the controller lock;
final binding rechecks admission before hardware changes.

The versioned `io_trajectory` contract supports authoritative inspection,
reservation and finite/jog/homing preparation. Its capability snapshot advertises
the implemented coordinated executor. Urgent controls renew ownership or stop
work; `io_motion` owns accepted execution through its terminal result. The older
segmented upload/session model remains algorithm-test infrastructure and is not
the executable Cartesian toolpath API.

| Capability | Current implementation and verification |
| --- | --- |
| Conversions, FK/IK and previews | Implemented; host mathematical and API coverage |
| Family exclusion, reservations and jobs | Implemented; controller and simulator regressions |
| Independent axes and coordinated joint/point moves | Connected through production CLI/ICC to the executor; native simulator workflows pass |
| Sequential homing, timed/continuous jog and controlled stops | Implemented; simulator checks include homing → stop → homing and group stopping |
| Cartesian lines, blends, lookahead, hold/resume and override | Preview/numerical infrastructure only; executable features remain future work |
| GIGA application qualification | The complete short application workflow passes with M4 SDRAM code, including buffered raw moves and independent-axis overlaps. QSPI execution is not qualified; normal firmware now also uses SDRAM for ordinary M4 code. No full-rate or endurance acceptance claimed |
| Powered mechanics | Pending physical calibration and commissioning |

Run the complete simulator workflow with:

```sh
python3 -m pytest src/simulation/tests/test_motion_api.py --simulator build/debug-linux/Application
```

The workflow checks independently observed simulated joint/TCP coordinates,
concurrent axes, quantized endpoints, timed/continuous jog, command-family
rejection, controlled group stopping, explicit waits and bounded execution
history. The motor-disabled electrical fixture runs
`python3 examples/giga_motion_api_test/verify.py --output <new-directory>`;
this additionally checks concurrent raw workers, buffered/blended successors,
live speed changes and diagnostics while motion is active. Run it after a fresh
board reset: its synthetic homing timeout is sized for the initial fixture pose.
The fixture defines a neutral pose at 69°, 69°, 19.9 mm and starts 256 pulses
away from its synthetic contacts, allowing cancellation before contact. These
are test coordinates, not physical calibration. Both fixture and normal firmware presets select M4 SDRAM code placement;
QSPI holds the persistent images. The STEP/IRQ call paths remain in internal
instruction SRAM. These checks do not qualify ordinary M4 execution from QSPI.
Use `capture.py --raw --output <new-directory>` for independent raw STEP counts;
that relative-motion test needs no homing. Add `--raw-degrees 90` to exercise
full initial DMA buffers (800/800/400 pulses). Raw startup computes relative
edges in bounded batches with interrupts available and samples the arm origin
after filling. Publication rechecks cancellation and axis revision, so slow
initial preparation neither consumes the requested lead nor masks active-axis
refill interrupts. The hardware arm check still
rejects insufficient lead during publication; no deadline was relaxed.

Raw/homing worker stacks are reserved once at motor construction, at 10 KiB each
on M4. A worker joins before reusing its stack, so repeated commands do not need
large allocations from a fragmented heap. Command preparation has 28 KiB;
the execution worker has 8 KiB. Cold worker admission and exception diagnostics
live in `StepperMotorCommands.cpp`, outside the instruction-RAM execution path.
Incoming ICC actions retain only their actual encoded feedback/result bytes,
with the same 2,048-byte frame limit and terminal retention until acknowledgement.
They do not reserve two maximum-size frames for every pending action.

Standalone STEP benchmarks and preview captures remain useful subsystem
evidence, but cannot substitute for the integrated GIGA motion tests.

### Clocks and ownership

The [CubeMX project](external/CubeMX/CubeMX.ioc) targets STM32H747XIH6 and exports
separate CM4/CM7 CMake peripheral files, preserving user code. Application entry
points and ThreadX remain repository-owned. Do not start the generated
`SystemClock_Config`, FMC or QSPI initialization from an application.

| Resource | Configuration / owner |
| --- | --- |
| Supply / reference | LDO, VOS0, onboard 16 MHz HSE crystal; LSE 32.768 kHz |
| PLL1 | HSE /4 ×240, P2/Q20: M7 480 MHz, USB 48 MHz |
| Bus clocks | HCLK/M4 240 MHz; APB 120 MHz; timer kernels 240 MHz |
| PLL2 | HSE /4 ×100, R2: FMC/QSPI 200 MHz; SDRAM 100 MHz; QSPI 50 MHz |
| PLL3 | HSE /5 ×128, R10: LTDC 40.96 MHz |
| M4 | TIM2 CH1/3/4 STEP, CH2 guard; DMA1 streams 0–3; TIM3 encoder; TIM6 sampling; TIM7 completion; USART2; SPI5 |
| Runtime | M4 TIM5 and M7 TIM12 at 1 MHz; per-core 1 kHz ThreadX/HAL SysTick |
| M7 | USB-C CDC, LED/button, LTDC/DMA2D, TIM8 backlight, I2C4 touch |
| Shared | M7 initializes RTC/RNG once; HAL serializes later access with hardware semaphores; SRAM4/HSEM for ICC |

TIM2 uses PSC=23 for the existing **10 MHz timeline**. STEP interrupt priority
and runtime timer priority remain 5; SysTick priority is 4. DMA generates edges; IRQs refill buffers
and report progress. M4 has no physical LED or console writer. M7 receives IO
logs through ICC's bounded background lane. USB-A host, DSI, wireless, camera
and audio are disabled. The board uses its own crystal: there is no ST-Link MCO
clock setting to change.

### Motor and EtherCAT wiring

**Enable polarity is HIGH = disabled, LOW = enabled**, matching the existing
DM542T transistor stage and TMC2209 EN inputs. Both bootstrap and fault paths
force enable HIGH and STEP LOW. Provide an external enable pull-up and STEP
pull-downs so these levels also hold while reset makes the MCU pins high impedance.
The STEP backend forces OC inactive before switching GPIOs into timer AF mode.

| Signal | Arduino label | STM32 pin / function |
| --- | --- | --- |
| M1 / M2 / M3 STEP | A7 / D3 / D2 | PA0 / PA2 / PA3, TIM2 CH1/3/4 AF1 |
| M1 / M2 / M3 DIR | D4 / D6 / D16 | PJ8 / PD13 / PH13 |
| Shared enable | D15 | PC7, initially HIGH |
| M1 encoder A / B | D7 / D5 | PB4 / PA7, TIM3 CH1/2 AF2 |
| M1 encoder Z | D53 | PG7, EXTI7 |
| M1 / M2 / M3 reference | D49 / D51 / D47 | PE4 / PE5 / PB2, EXTI4/5/2 |
| DM542T ALM | A3 | PB1, EXTI1 |
| M2 / M3 DIAG | A4 / A6 | PC3 / PC0, EXTI3/0 |
| M2 / M3 INDEX | D8 / D9 | PB8 / PB9, EXTI8/9 |
| TMC UART TX / RX | D18 / D19 | PD5 / PD6, USART2 |
| ESC SCK / MISO / MOSI | D13 / D12 / D11 | PH6 / PJ11 / PJ10, SPI5 |
| ESC CS | D10 | PK1, initially HIGH |
| ESC IRQ / SYNC0 | D64 / D63 | PH10 / PH11, EXTI10/11 |
| ESC reset | D65 | PH9, open-drain, released |

Retain the established voltage-conversion circuits and shared TMC UART wiring.
M2/M3 UART addresses are 0/1; microstepping is 1/16 for M2 and 1/8 for M3.
M1 retains 1/16 on the DM542T DIP switches. StealthChop is the TMC2209 default.
The [motor perfboard KiCad project](hardware/perfboard/README.md) provides the
GIGA wiring schematic, hand-soldering layout and complete harness table. Power
the GIGA through USB-C or the display shield’s protected VIN supply; the perfboard
receives its 3.3 V output and shares ground,
while the buck's 5 V output stays on the motor-interface board.
Reference inputs use pull-ups and both edges; LOW is the healthy NC circuit,
HIGH means switch activation or an open cable. ALM is pulled up; DIAG/INDEX are
pulled down. GPIO callbacks and motion-blocking rules retain their existing
polarity. Shared EXTI handlers process only their own core's enabled lines.

SPI5 is initialized for mode 0, 8 bits, MSB first at 937.5 kHz. Board/core
factories expose SPI, CS, reset, IRQ and SYNC0; the portable `Lan9253` adapter
remains available. No EtherCAT stack starts automatically, and DMA2 remains
reserved for future SPI transfers. Connect EVB J3.1=SCK, .5=MISO, .4=MOSI,
.3=CS, .2/.8=GND; TP1=IRQ, J15=SYNC0 and J5.1=RSTn. Use ordinary-SPI straps
and the previously verified ESC configuration.

### Display and console

Smartwin SMMH0701024600S-C20: RGB24 physical bus, **1024×600 RGB565** buffers.
LTDC timing is 1+47+1024+48 horizontal and 1+4+600+5 vertical, totaling
1120×610 at 40.96 MHz (approximately 60 Hz). DE is active high; pixel-clock phase
still requires checking on the actual panel. DSI is disabled.

| Display signal | STM32 pins |
| --- | --- |
| R0–R7 | PG13, PJ0, PJ1, PJ2, PJ3, PJ4, PJ5, PJ6 |
| G0–G7 | PJ7, PE6, PI15, PG10, PH15, PK0, PI11, PK2 |
| B0–B7 | PJ12, PG12, PJ14, PJ15, PK3, PK4, PK5, PK6 |
| CLK / DE / HSYNC / VSYNC | PI14 / PK7 / PI10 / PI13 |
| Backlight / standby / TFT reset | PC6/D68 TIM8_CH1, PI0/D69, PI2/D71 |
| Touch reset / interrupt | PI3/D72, PB12/D74 EXTI12 |
| Touch SCL / SDA | PB6/D101, PH12/D102, I2C4 100 kHz |
| Adapter power READY | PI1/D70, input with pull-down |

The [Smartwin–GIGA adapter projects](hardware/display/README.md) accept regulated
24 V on the GIGA shield, convert it to 12 V for GIGA VIN, and carry protected
24 V through the ribbon to independent backlight and precision LCD/touch supplies
on the display adapter. Hardware supervisors gate PWM/reset/standby; PI1/D70
reports supply readiness so firmware repeats initialization after power recovery.
USB-C remains available for CDC; GIGA and display 3.3 V rails stay separate.
The projects include protected interfaces, cable specifications and AISLER
bare-board upload packages: display revision G and GIGA revision F
(both four layers), both 1.6 mm with ENIG. Both use continuous inner ground
planes and stitched outer fills. Local fabrication checks and the recorded
regional visual review pass; AISLER's
processed-job acceptance and first-board fit/electrical/display testing remain pending.
The [hardware review](hardware/display/manufacturing/REVIEW.md) identifies open
RGB timing and supply-transient qualification; fabrication readiness does not
mean the complete display interface has been electrically qualified.
The GUI starts automatically. Backlight stays off until the adapter reports stable supplies, panel sequencing completes and a valid framebuffer is scanned, then starts at 10%. Rendering continues without panel power. `display bars` selects the diagnostic pattern; `display gui` returns to Home. `display backlight 0..100` controls the 1 kHz PWM. `display touch` reports cached primary-contact coordinates, availability and age, without performing I²C transactions. `display status` reports rendering/presentation counters, deadlines, transfer errors and queue overflow. Missing touch does not prevent rendering, CLI or ICC operation. Device logic lives above `IRgbOutput`, `IGraphics` and `II2c`; STM32 drivers own the peripherals.

USB-C uses USB_OTG_FS PA11/PA12, device-only CDC with VBUS sensing disabled and
ST USB Device middleware matching Cube H7 V1.13.0. Open the CDC port (`/dev/ttyACM*`
on Linux); nominal baud is immaterial for USB. Startup never waits for a host.
The 4 KiB input and 8 KiB output queues are bounded; dropped output is counted in
`giga_console_dropped_bytes`. Disconnect/overflow clears partial commands;
suspend/resume retains the host's open state. Callbacks notify the console worker,
which owns transmit submission. They never parse CLI commands. Motor fault
shutdown does not depend on USB or log delivery.

### Images, RAM and startup

| QSPI address | Size | Contents |
| --- | ---: | --- |
| 0x90000000 | 1 MiB | Preserved factory reserve |
| 0x90100000 | 3 MiB | M4 executable and RAM load images |
| 0x90400000 | 10 MiB | M7 executable, GUI assets and RAM load images |
| 0x90E00000 | 1 MiB | Manifest / activation / maintenance |
| 0x90F00000 | 1 MiB | Preserved factory wireless reserve |

The M7 image ends before `0x90E00000`, including its 32-byte image-pair footer.
The linker, packer and bootstrap validator enforce the 10 MiB allocation. Use
the combined flash command so the bootstrap is updated with the applications;
older bootstraps reject M7 images larger than 4 MiB. Images are programmed at
their actual length, not padded to the partition size. This allocation does not
change the RAM map or the internal-flash filesystem.

The loader verifies AT25SF128A JEDEC 1F8901 and the SFDP signature, preserves
status bits, enables volatile QE, then uses 0x6B quad-output, 24-bit addresses,
eight dummy clocks at 50 MHz. Reserved areas do not imply Arduino filesystem
compatibility. No application filesystem writes to XIP flash.

| RAM / internal flash | Allocation |
| --- | --- |
| 0x08000000 / 0x08100000 | One 128 KiB sector per internal M7/M4 bootstrap |
| 0x08180000–0x081FFFFF | 512 KiB persistent storage, bank 2 sectors 4–7; M7 owner |
| 0x10000000 | 2 KiB M4 vectors; remaining 192 KiB SRAM1/SRAM2 instruction alias for motion, runtime and ICC code/constants |
| 0x30030800 / 0x30046000 | 86 KiB M4 data/DMA; 8 KiB M4 MSP |
| 0x24000000 / 0x24040000 | 256 KiB M7 data/heap; 256 KiB M4 unwind metadata/heap |
| 0x00000000 | 32 KiB M7 ITCM code; renderer cap 24 KiB |
| 0x00008000 | 32 KiB CPU-only GUI metadata; 24 KiB enforced allocation cap, execute-never |
| 0x20000000 | M7 vectors (2 KiB), `.dtcm`/`.dtcm_bss` working data (110 KiB) |
| 0x2001C000 / 0x2001E000 | 8 KiB bootstrap scratch; 8 KiB M7 MSP |
| 0x38000000 / 0x3800F000 | 60 KiB ICC reservation; 4 KiB boot handoff |
| 0xC0000000 / 0xC0200000 | Two 2 MiB framebuffer slots; each uses 1,228,800 bytes |
| 0xC0400000 | 512 KiB reserved for M4/M7 profiling; non-cacheable, execute-never |
| 0xC0480000 | 1536 KiB M4 ordinary instructions, loaded from QSPI at boot |
| 0xC0600000 | 2 MiB 3D colour/depth buffers and bounded planning storage |

The onboard SDRAM is 8 MiB AS4C4M16SA-6BIN, bank 1, 16-bit, four banks, **12 row
bits / 8 column bits**, 100 MHz, CAS3; timings 2/7/5/7/3/2/2, refresh count 1542.
This industrial part specifies 4096 refreshes per 64 ms; use the
[industrial datasheet](https://www.alliancememory.com/wp-content/uploads/Alliance_Memory_64M-AS4C4M16SA-CI_v5.0_October_2018.pdf).
FMC initialization enables its GPIO D/E/F/G/H clocks itself, since bootstrap
does not run the application's general GPIO initialization. GPIOH carries
SDRAM clock-enable, chip-select and write-enable.
M4's 0x10000000 code range aliases SRAM1 and the first 66 KiB of SRAM2;
it is not additional RAM. The linker and both image validators exclude the
corresponding data alias from application data segments. Frequently executed ICC
bridge/transport code resides here so UI QSPI reads do not stall those instruction
fetches. M4's separate 256 KiB AXI allocation begins with the RAM code's exception
unwind metadata (13,892 bytes in normal Release); its heap starts after that data.
The bootstrap copies these records and both image validators enforce M4 ownership
of the region. M7 CPU-only filesystem metadata, startup/reaper stacks and console
rings occupy `.dtcm`/`.dtcm_bss`; USB FS copies through its FIFO and its DMA-capable
Cube buffers remain in AXI SRAM. The general M7 heap remains in AXI SRAM. Both copy
and zero tables cover these DTCM sections. The normal HMI reserves the upper
32 KiB of ITCM for CPU-only GUI metadata, with a 24 KiB enforced allocation cap
and an explicit bootstrap zero record. It is execute-never; DMA never accesses
this region. The motion benchmark variant retains its separate all-ITCM-code
layout. Renderer code remains bounded to 24 KiB in normal builds.

MPU is configured before M7 caches. A low-priority, no-access/XN region blocks
unused external addresses (`0x60000000..0xDFFFFFFF`); higher-priority regions
explicitly map the installed QSPI/SDRAM. This prevents speculative M7 accesses
to unused FMC banks from stalling SDRAM and underrunning LTDC, as described in
[ST AN4861](https://www.st.com/resource/en/application_note/an4861-introduction-to-lcdtft-display-controller-ltdc-on-stm32-mcus-stmicroelectronics.pdf).
The remaining attributes are: ICC and framebuffers normal/non-cacheable/XN;
QSPI read-only executable; internal file storage non-cacheable/XN; private RAM/heaps XN; UI SDRAM cacheable/XN;
M4 code SDRAM normal, non-cacheable and executable only when its image manifest enables it.
Future DMA users of cacheable UI buffers must clean
before DMA reads and invalidate after DMA writes, with exclusive 32-byte-aligned
cache-line ownership. Current DMA2D framebuffers are non-cacheable and require
only the existing publication barriers. Future ITCM kernels should avoid C++
exceptions across memory regions until their unwind placement has been extended.
Bootstrap enters after hardware reset and invalidates retained cache contents
without cleaning them, preventing old dirty lines from overwriting a newly
downloaded RAM helper. M7 enables caches after memory initialization. M4 inherits
its final MPU setup from the internal stub: disabling the MPU while executing
an SDRAM-code image would make its instruction fetches non-executable.

M7 waits for M4 to park before requesting D2 SRAM clocks; its clock requests
would otherwise keep D2CKRDY asserted. M4 enables SEVONPEND so the HSEM event can
wake its masked-interrupt STOP wait. M7 configures clocks/memories, validates both
images and loads explicit copy/zero records. M4 ignores unrelated wake events
until the boot semaphore is released. Application vectors, stack, segment
bounds, image CRCs and matching pair identifiers are checked; invalid pairs stay
in internal recovery with motor outputs disabled. M7 application startup enables
caches and initializes local HAL plus shared RTC/RNG/ICC memory. Its runtime
mounts/recovers storage before `hal::start_secondary_cores()` releases M4, so
filesystem startup cannot consume the ICC handshake deadline.
Each core runs its own constructors, TLS setup and ThreadX exactly once.
Applications do not initialize shared clocks, QSPI, FMC or peer-owned memory.
Generated application clock requests are wrapped by a read-only check against
bootstrap settings; a mismatch fails instead of restarting a shared PLL.
ICC must establish its session before accepting commands.

The linker bounds every region. M4 STEP/refill, sequence evaluation, feedback,
fault handling, scheduler/timekeeping hooks, synchronization, memory copies and allocator hot
paths, and their selected constants are copied to internal RAM.
`scripts/giga_ram_audit.py` checks the linked direct call graph and explicitly
listed callback/virtual targets and writes `ram-audit.json`; new callback types
need reviewing there. Separate Arm exception-unwind tables cover RAM and XIP.
This static audit does not replace latency measurements under bus contention.

### Persistent files in internal flash

The **512 KiB physical partition** at `0x08180000` contains a **256 KiB logical
FileX volume**, with **247.5 KiB free** on an empty formatted volume after FAT
and recovery metadata.
The remaining space accommodates append-only records and a spare erase sector
for recycling. This leaves **1.25 MiB of internal flash unallocated**, in addition
to the two reserved bootstrap sectors. No extra component is required and QSPI
stays in execution mode during file operations.

```text
mkdir /flash/config
echo "prototype" > /flash/config/name.txt
cat /flash/config/name.txt
ls -l /flash/config
```

Existing `cp`, `mv`, `rm`, `>` and `>>` commands work on this volume. Files survive
board resets and normal `giga_program.py flash` updates. A full-chip erase or
factory restoration can destroy them; the factory backup is not a backup of
files created later. M7 exclusively owns the mounted volume; M4 file access
would require a future ICC service.

The runtime formats only a completely erased partition. Unrecognized or corrupt
contents leave storage unavailable, with no automatic erase. FileX fault-tolerant
metadata recovery is enabled. The sector journal writes each 32-byte ECC flashword
once, writes the commit record last, and copies live records before reclaiming
an erase sector. This avoids the repeated small metadata writes required by the
LevelX NOR backend used by our Linux storage tests. Sector updates are atomic;
an arbitrary multi-sector file overwrite is not a whole-file transaction.

The bootstrap sets `FLASH_ACR.WRHIGHFREQ=2` for VOS0 / 240 MHz, as required by
RM0399 table 16; setting read latency alone is insufficient for programming.
Storage is non-cacheable and guarded reads detect uncorrectable flash ECC.
MPU attributes also apply at fault priority, keeping these reads non-cacheable.
The journal, FileX media state and buffers occupy about 27 KiB of M7 DTCM,
preserving AXI heap space for the CLI and ICC workers.
Use this volume for settings and occasional saved files. Flash reclamation is
synchronous on UI and has finite write endurance; high-rate logs belong elsewhere.
Storage operations run on M7. M4 does not wait for the filesystem or access
the storage bank; its motion timing under simultaneous writes remains a separate
hardware load test.

Implementation: [partition](platform/boot/giga/InternalFlashLayout.h),
[journal](platform/runtime/libc/storage/FlashJournal.hpp),
[STM32 access](platform/runtime/libc/stm32/InternalFlash.cpp), and
[FileX driver](platform/runtime/libc/stm32/storage_media.cpp).

Validation includes 45 host CTest targets (including journal interruption,
corruption and reclamation tests), image/MPU checks, and both cores' Debug and
Release builds. On the GIGA, filesystem CLI operations, 240 verified overwrites
and 12 reclamation erases passed while ICC diagnostics remained responsive.
Saved contents survived a coordinated reset and a normal firmware update.
Hardware logs are in `build/giga-storage-results/`; simulated interrupted writes
are covered by host tests, not a claim of physical power-cut qualification.

### Build, backup, program and debug

```sh
cmake --preset giga-debug
cmake --build --preset giga-debug
# Also available: giga-release, giga-ram-debug, giga-bench-debug.
# Individual applications: giga-io-debug, giga-ui-debug, -release variants,
# and giga-io-ram-debug.
```

Normal Debug/Release and profiling presets select `GIGA_M4_SDRAM_CODE=ON`:
ordinary M4 instructions occupy the reserved 1536 KiB at `0xC0480000`. QSPI remains the persistent image
storage, and the same bootstrap validates and copies the code before starting
M4. Timing-critical code remains in internal instruction SRAM. This option is
enabled in normal firmware and the electrical motion fixtures. QSPI instruction
fetches on the uncached M4 exceeded the unchanged command/lease budgets; the
SDRAM application workflow passes. The lower 512 KiB remains reserved for
both cores' profiling data. For example, configure the paired test with
`cmake --preset giga-motion-api-release -DGIGA_M4_SDRAM_CODE=ON`.
Combined builds pass the selection to their normal IO child preset; it does not
substitute another application or drop a test fixture. The `giga-ram-debug`
preset is a Debug convenience for the same mechanism, not a separate runtime.

M7's internal bootstrap sets `AXI_INI1_FN_MOD_AHB.RD_INC_OVERRIDE` before
releasing M4. This is ST's workaround for incorrect M4 byte/half-word FMC reads
([ES0445 §2.3.14](https://www.st.com/resource/en/errata_sheet/es0445-stm32h745xig-stm32h755xi-stm32h747xig-stm32h757xi-device-errata-stmicroelectronics.pdf)).
It matters even when ordinary constants remain in QSPI: compiler-generated
`TBB` branch tables can reside inside SDRAM instructions. The electrical fixture
checks byte and half-word reads against 1,024 aligned words from that code region
before creating the application. The separate prohibition on unaligned FMC
accesses still applies. Updating application images alone does not install this
bootstrap correction; use the combined flash command below.

Per-core directories contain ELF, BIN, HEX, MAP and separate `.debug` symbols,
internal bootstrap images, memory percentages and M4 RAM audit reports. The M7
build also produces `memory-helper.elf`. Combined builds produce `images/io.bin`,
`ui.bin`, a fixed little-endian `manifest.bin`, and readable `manifest.json`.
The manifest carries lengths, CRC32s, SHA256 pair ID, entry/vector/stack addresses
and at most 16 explicit copy/zero segments per core. The pair ID is also appended
to each image. It binds a pair; this is corruption detection, not secure boot.

Connect Atmel-ICE's **SAM/Cortex** SWD port to GIGA SWDIO, SWCLK, NRST, GND and
3.3 V VTref; power the board separately through USB-C. VTref is not board power.
Keep motor power disconnected during initial validation. One CMSIS-DAP OpenOCD
instance connects under reset at 1 MHz and exposes M7 on GDB 3333 and M4 on
3334. Full factory readback has also been verified at 4 MHz SWD.

```sh
python3 scripts/giga_program.py probe
python3 scripts/giga_program.py backup
python3 scripts/giga_program.py memory-test
python3 scripts/giga_program.py flash --build build/giga-debug
# Equivalent combined target, after the verified backup exists:
cmake --build --preset giga-debug --target flash
```

Backup writes `backups/hardware/giga-factory/`: all 2 MiB internal flash, all
16 MiB external flash, readable option registers, MCU UID and SHA256 metadata.
It verifies repeated reads and refuses to overwrite an existing backup. The
RAM helper needs no valid application images. Backup initializes QSPI alone;
`memory-test` and `flash` additionally initialize SDRAM and run the physical
memory tests described above. Results are in `giga_boot_status` /
`GigaHandoff` at 0x3800F000. Status 0x600D means the requested helper operation
succeeded; `memory_test == 1` additionally confirms SDRAM passed. The maintenance
request is at 0x3800F024 (0 for QSPI only, 1 for SDRAM testing).
The helper prints the failing phase, address, expected/actual data, elapsed
milliseconds and successful coverage in bytes. These six words occupy
0x3800F028–0x3800F03C. Phase 0 means no failing test; phases 1–8 identify walking
ones, walking zeros, byte writes, halfword writes, address patterns, inverted
address patterns, retained pseudorandom data and final zeros, respectively.
Always check status 0x600D and `memory_test == 1` before treating a run as passed.
For complete debug-port reads, the helper maps a 32 MiB address window around
the physical 16 MiB QSPI device, avoiding a bus stall from read-ahead at its end.
The backup remains exactly 16 MiB, and application mappings remain unchanged.
The helper uses ordinary 1-1-1 fast reads (0x0B) so OpenOCD infers the correct
status/program command widths. Application boot uses quad-output reads (0x6B).
Programming runs at 4 MHz SWD after initialization and verifies every image.
No factory flash or nonvolatile QSPI status is changed by backup/memory testing.

Flashing validates the backup UID and exact ELF-derived image contents, halts
both cores, initializes external memory, invalidates activation, programs and
verifies both applications and bootstraps, then writes activation **last**.
Internal erases cover only the two bootstrap sectors; `/flash` is preserved.
Only boot-address/core-enable option bits are changed; protection/watchdog
settings are preserved. BOOT0 high retains the M7 ROM loader. An interrupted
update must be retried through SWD; no automatic mixed-pair activation occurs.
Never program QSPI while either application executes from it. This replaces
the Arduino installation; retaining the backup is required by the flash tool.

For debugging an already programmed pair:

```sh
openocd -f scripts/openocd/arduino_giga.cfg \
  -c "gdb_memory_map disable; gdb_flash_program disable" \
  -c "reset_config srst_only srst_nogate connect_deassert_srst"
arm-none-eabi-gdb build/giga-ui-debug/ui-controller.elf
# GDB: target extended-remote :3333
# A second GDB loads the matching io-controller.elf and connects to :3334.
```

Keep automatic GDB flash-map probing disabled for a live application:
probing `stmqspi` changes the QSPI mode while M7 code and both cores' constants
can still be read from it. After
detaching, explicitly resume any core left halted. A deliberate core halt will
trigger the existing ICC connection-loss policy; reset both cores afterwards.

Use `monitor giga_halt_both` before reset/maintenance; flash with the script,
not GDB `load`. Ordinary M4 XIP code cannot use FPB hardware breakpoints at
0x90xxxxxx. `GIGA_M4_SDRAM_CODE=ON` stores the image in QSPI but executes its ordinary
M4 code in SDRAM at 0xC0480000, permitting **software** breakpoints after bootstrap
has copied it. Read-only data and exception metadata remain in QSPI: prebuilt
libc/C++ routines can use unaligned reads that FMC does not support
([ES0445 §2.7.3](https://www.st.com/resource/en/errata_sheet/es0445-stm32h745xig-stm32h755xi-stm32h747xig-stm32h757xi-device-errata-stmicroelectronics.pdf)).
Attach after startup; use `set mem inaccessible-by-default off` and
`set breakpoint auto-hw off` before setting software breakpoints. RAM-resident fast
code at 0x10000000 supports hardware breakpoints. The OpenOCD helper workspace
uses upper AXI RAM/M4 SRAM2, never ICC; applications are halted first. M7 planning
can later opt into the reserved ITCM/DTCM sections.

### Acceptance gates and bench

Run these in order. SWD access, factory backup, QSPI readback and the complete
SDRAM test across hardware resets, matched-pair boot, invalid-image recovery,
USB console, basic ICC services and M4 SDRAM software breakpoints are verified.
Use this checklist for subsequent regression and load tests:

1. Probe both cores and verify factory backup. Check clocks, disabled outputs,
   LED/button and debugger-free power cycling with internal recovery/startup.
2. Verify QSPI identity/repeated reads and the complete 8 MiB SDRAM test. Review
   MPU attributes, including executable helper workspace.
3. Boot the matched pair; inspect vectors, constructors, TLS and timers. Exercise
   missing/corrupt/mismatched images and interrupted updates. Test an M4 SDRAM
   software breakpoint with the RAM-debug pair.
4. Check USB open/close/unplug/replug, runtime counter rollover, ICC lanes,
   heartbeat/peer restart and background-log saturation. Reset both cores for
   recovery; stale queued motion must not resume.
5. With motor power off, flash `giga-bench-debug`. Analyzer D0 → A7/PA0,
   D1 → D3/PA2, D2 → D2/PA3, D3 → D15/PC7, GND → GND. Commands 1–9 test small
   exact counts, independent starts, 100 kHz, velocity changes, stop/restart,
   timer wrap, intentional underrun, combined load and variable periods.
   `python3 examples/giga_step_bench/capture.py --port /dev/ttyACM0` runs them
   with the 24 MHz analyzer. Test 8 exercises QSPI reads, USB output, ICC traffic,
   DMA2D fills and LTDC scanout while all STEP channels run. Bench reports worst
   ISR cycles, stop-call cycles and LTDC underruns; 100 kHz tests require at least
   2× DMA-buffer service headroom. Results need confirming with edge captures;
   the cycle counter does not measure external switch-to-stop latency.
6. Flash the normal pair; verify `display bars`, both buffers, RGB ordering,
   DE/clock phasing, underrun counts and `display touch` with the actual panel.
7. Exercise encoder/INDEX, reference and diagnostic edges, then powered motor
   moves and homing → stop → homing. Measure interrupt-entry/stop latency under
   combined load before establishing a supported motion rate.
8. With LAN9255 connected, repeat ordinary-SPI identification/stress and recovery
   using bench command `e` (identification followed by 100,000 BYTE_TEST reads).
   The EVB must already supply valid ESC boot configuration/EEPROM; check 81
   means identification was not ready. This command does not program its EEPROM
   or provide SII emulation. SOES robot control remains subsequent work.

The GIGA schematic/pinout and local MCU/panel references are in
[`docs/arduino_giga_r1_wifi`](docs/arduino_giga_r1_wifi) and
[`docs/display`](docs/display). Axis/robot planning and trajectory previews run on M7;
raw motor profile generation and all physical execution remain on M4. Its bounded
execution contract and ICC services/actions/topics remain separate from the
physical transport and the GUI.
