daleondev/ProtoMate_Control/src/simulation/README.md

# Native Linux hardware simulator

```sh
cmake --preset debug-linux
cmake --build --preset debug-linux -j4
./build/debug-linux/Application
```

`Application` is the only project executable needed for deployment. It forks
before starting threads or SDL. The parent runs the native simulation and robot
viewer; the child executes the embedded controller image from a sealed Linux
`memfd`, retaining its own ThreadX C++ runtime and TouchGFX window. Nothing is
extracted to disk, and no sibling controller executable is required. The normal
system shared libraries are still required.

The build links the controller privately at
`CMakeFiles/controller/controller.elf` and embeds it as read-only data in
`Application` using C++26 `#embed` in `ControllerImage.cpp`. It is a build
intermediate, not a second deployment artifact. Models and standalone GLSL
files are embedded by `assets/RobotModels.cpp` and `assets/Shaders.cpp`
(and contact meshes by `assets/CollisionMeshes.cpp`); all
asset views refer to immutable static storage. No assembly embedding templates
or generated C++ byte lists are used. GCC's dependency files track embedded
model/shader inputs, and CMake also explicitly tracks the generated controller
ELF. Editing an asset rebuilds its embedding translation unit. Shader sources
are passed to OpenGL with explicit lengths, without assuming NUL termination.
The controller must remain a separate link image because its ThreadX threading
ABI and libc hooks cannot be mixed with the native C++ runtime. This packaging
preserves process isolation without loading both runtimes into one address space.

The parent reports child startup/exec errors immediately, propagates its exit
status after reaping it (even when IPC closes first), and bounds shutdown.
Latched IO/UI application or combined-state faults produce a failing exit status,
including when both ICC endpoints subsequently shut down normally.
`ControllerProcess` owns fork/exec/reaping; `Session` owns IPC and the worker.
Typed `SessionOptions` supplies the media path, trace path and one immutable
physical profile shared with the viewer. Simulator options are not ambient
process environment variables. The child also receives SIGKILL if the parent
dies unexpectedly. Linux must permit executable `memfd` images.

The controller still owns its TouchGFX window. The viewer uses SDL2, OpenGL 4.5 core,
GLSL 450, epoxy, GLM and Assimp; it shares no renderer, shaders, widgets or graphics
resources with TouchGFX. Closing the robot window leaves simulation running.
EOF in the controller terminal requests normal application shutdown. SIGINT or
SIGTERM stops the simulator and its child. The embedded controller requires its
inherited simulator session; there is no automatic mock-hardware fallback.

Assimp is found with `find_package(assimp CONFIG REQUIRED)` and linked through
`assimp::assimp`, using the system installation like GLM/epoxy. It is required
for Linux configuration, including headless runs of this same binary, and is
absent from the embedded controller and GIGA builds. Nothing is fetched by CMake.

Four embedded Fusion DAE groups (base plus three moving links) pass through
Assimp and follow actual native shaft truth. Their local frames and the cutter
tip are registered against the evaluated STEP assembly. See
[asset frames and import conventions](assets/robot/README.md) and the
[measured geometry and sensor report](../../docs/robot/geometry.md).

Options:

- `--headless`: omit the robot window; the controller display is independent.
- `--media-dir DIR`: retain isolated `flash.img` and `sd.img`; otherwise use
  temporary, unlinked files. Existing images are size-checked and exclusively
  locked. Host `/flash` files are not used as simulated raw media.
- `--trace FILE.csv`: write timestamped GPIO transitions, including STEP, DIR,
  enable and reference contacts. The file is replaced. Capture buffering is
  bounded; overflow fails the session instead of silently losing edges.
- `--robot-models DIR`: load `base_link/base_link.dae` and `link_1..3/link_1..3.dae` from DIR.
- `--model-scale N`, `--model-up y|z`: millimetres per imported unit and up axis
  for external models **after Assimp normalization**; defaults 1000 and Y.
- `--`: pass remaining arguments to the controller.

Orbit with left drag, pan with right drag, zoom with the wheel, reset the camera
with R. The overlay reports physical shaft positions, converted joints, TCP,
reference contacts, power, enable, faults, device time and average execution
speed. Stale snapshots are labelled and highlighted. Rendering never advances
the machine clock or performs HAL calls.

## Physical profile and scope

`Profile.hpp::Profile` defines **fusion-cad-v4**, a nominal CAD profile, not a
calibrated robot. `CadGeometry.hpp` holds the STEP-derived 205 / 223.4 mm links
and 135 mm tool offset. Current pulley labels specify 5:1 rotary gearing; the
CAD author's assumed M8×1.25 screw sets nominal Z travel to 1.25 mm/revolution.
The report explicitly records conflicting older component descriptions.

Startup is the straight CAD pose, pointing forward along +X: **J1=0°, J2=0°,
Z=0 mm displacement**. The cutter tip is at world (563.4, 0, 28.9) mm, so Z
joint displacement and world TCP height deliberately differ. Native shaft-to-joint
conversion uses the same pure `RotaryAxisConversion` and `LinearAxisConversion`
classes as the UI planner, including reduction, signs and reference offsets.
`Kinematics` supplies the same link transforms to rendering and contact detection.
The first two joints retain unwrapped coordinates.

Geometry follows accepted STEP pulses, not commanded targets. Coordinate resets,
controller homing and encoder resets do not teleport the mechanism. The current
IO diagnostic homing configuration assigns 135° to its motor coordinate at the
switch; this does not redefine native shaft truth or the straight mechanical zero.
There is no hardware calibration/admission change.

The TMC2209 model starts with pin-selected microstepping: address straps 0/1
select 1/8 for M2 and 1/32 for M3. `CHOPCONF.MRES` only controls step size after
`GCONF.mstep_reg_select` is enabled. The application explicitly configures M2 to 1/16 and M3 to 1/8
over UART, as on hardware; clearing that selection restores the
strap-defined resolution.

Home switches are generated by mesh collisions. Each free spring lever is
extracted from its parent DAE. For Axis 1/2 its opposing surface is the exact
cam-bearing CAD body, including both end cams. The supplied whole-link collision
hulls bridge empty space between cams and are deliberately excluded. Axis 3
retains its supplied collision STL. The STEP-derived curved lever-root axis
supplies the flexion pivot. Triangle BVHs, triangle distances and closed-volume
containment run in the native worker, including headless mode. Contacts update
after actual shaft movement, independently of homing, and feed the NC GPIO inputs.

CAD does not specify electrical operating travel. `Profile` assumes 2° lever
flexion for operation and 0.05 mm free-lever clearance for release. Operation
requires contact with both free and deflected levers; release waits until the
mechanism backs clear. These are nominal assumptions, not measured calibration.

| Axis | Negative contact / release | Positive contact / release |
|---|---|---|
| Axis 1 | −105.588238° / −105.196281° | +113.459653° / +113.289965° |
| Axis 2 | −102.911135° / −102.293583° | +114.666272° / +114.408289° |

Axis 3 positive contact remains approximately +29.9 mm. Contact coordinates are
measured from the geometry oracle, not hardcoded switch thresholds. Mechanical
configuration exports contact datums separately from soft endpoints, which sit
halfway between operation and release. Final homing backoff clears the switch
and therefore lies inside usable travel. Axis 1/2 seek toward negative angles;
Axis 3 seeks toward positive travel. Outside homing either contact is a hard
limit; the controller does not identify which cam touched.

Full robot homing returns sequentially to 0° / −60° / 15 mm after all three axes
have referenced and released. Its job retains whole-robot ownership throughout.
The CAD startup pose remains 0° / 0° / 0 mm; it is not the post-homing neutral pose.

Immutable BVHs allocate only at construction. Queries allocate nothing; a cached
surface-clearance certificate skips queries only while a conservative bound on
rigid displacement proves the contact state cannot change. The cache tracks total
travel since its last exact query, including accumulated tiny Z steps. Contact
geometry is embedded and independent of `--robot-models` visual overrides.

Mechanics otherwise remain ideal kinematic tracking. Disable freezes position.
There is **no inertia, gravity, payload, rigid-body collision response, friction,
backlash or thermal model**. Lever flexion is a geometric switch approximation,
not an elastic dynamics calculation. Other body intersections do not stop motion;
physical travel is not clamped to conceal controller errors.

Wiring follows the current GIGA board factory: STEP PA0/PA2/PA3, DIR PJ8/PD13/PH13,
shared active-low enable PC7, normally-closed references PE4/PE5/PB2, alarms
PB1/PC3/PC0, M2/M3 INDEX PB8/PB9, and M1 encoder PB4/PA7/PG7. M1 is a DM542T at
16 microsteps; M2/M3 are addressed TMC2209 devices, configured by the actual
controller driver. M1 encoder resolution is 400 P/R decoded x4. Its four-count
Z width is provisional. INDEX derives from driver electrical phase and is not
mechanical position feedback.

## Process and time boundaries

The controller child owns production device behavior, control, scheduling,
planning, FileX/LevelX, CLI and TouchGFX. The native parent owns the timer/DMA register model,
GPIO levels, motor-driver registers, encoder count, shaft truth, raw media files
and native rendering. Legacy STEP/TMC emulators are isolated test fixtures and
are not linked into the production controller executable.

A dedicated instance of the existing ICC bridge carries simulator control and
status over three bounded shared-memory lanes. It has its own bus and session,
separate from UI/IO ICC. A distinct synchronous register mailbox handles HAL
access while ThreadX interrupts are masked. It cannot depend on a coroutine
worker being scheduled. All wire packets use explicit little-endian fields,
version/session validation, checksums and bounded payloads. Shared DMA slots
are generation-checked and active banks cannot be overwritten.

One native worker owns all mutable machine state. Register transactions freeze
device time; callbacks run in the ThreadX interrupt context. Callback writes
use a fixed batch and are drained after callbacks return, before time advances.
The clock steps to the next device event, including timer rollover, DMA bank
transitions, PWM transitions and feedback edges; 1 ms clock ticks feed ThreadX.
After each interrupt, the scheduler must report that all runnable controller
work has suspended before the next event advances time. An ISR acknowledgement
alone is insufficient: its callbacks may just have woken a homing worker.
The acknowledgement carries the interrupt sequence, so an old idle report cannot
authorize a new advance. Register requests remain available during this wait.

The controller's simulated display VSYNC and input timestamps use this same
clock. SDL event pumping remains on wall time, so the window stays responsive.
Slow rendering or sanitizer instrumentation slows the whole virtual machine
instead of flooding it with higher-priority periodic work. The simulator models
functional ordering, not Cortex-M execution time or worst-case latency; hardware
refill and fault-response qualification remain separate. No firmware priorities
or motion deadlines are changed by this host scheduling policy.

Host-monotonic heartbeats operate independently of device time and detect a
stopped peer even during a time lease. Disconnect stops native STEP output and
disables the ideal plant. Neither process automatically replays uncertain
motion or reconnects to an old session. The viewer receives immutable snapshots
at up to 100 Hz and renders at approximately 60 Hz.

## Device fidelity

- STEP uses the existing 100 ns tick model, compare toggles, 32-bit timer wrap,
  double-buffer DMA, remaining counts, bank ownership and interrupt delivery.
  GPIO, PWM and coordinated STEP share one electrical signal path and trace.
  Signed pulses drive electrical phase; mechanics advance at the valid falling
  edge. A shortened pulse can be rejected without inventing a driver alarm.
  The conservative simulation pulse constraints are 2.5 us high and 5 us DIR
  setup/hold. `sim status` reports rejected pulses separately.
- TMC emulation implements addressed reads/writes, CRC, IFCNT, reset registers,
  GSTAT write-one-to-clear, selected writable registers, microstep resolution,
  INDEX, faults and disconnects. The UART exchange boundary includes nominal
  115200-baud transfer/turnaround time. This is not an analog single-wire bus,
  UART shift-register, DMA or electrical echo-collision model.
- Reference switches have hysteresis. Encoder counters can run, stop and rebase
  independently of mechanical truth. Feedback disconnect, missed motor motion
  and shaft slip are distinct faults.
- Native general timers and PWM advance only with device time. Counted PWM
  ends low; normal PWM remains uncounted. RTC follows the session epoch plus
  device time. The standard-library wall clock remains a host service.
- Raw storage provides 16 MiB NOR and 64 MiB SD images; production FileX/LevelX
  still format, mount and access them when its runtime is initialized. The Linux
  CLI retains its existing host-filesystem behavior; the storage qualification
  probe explicitly uses the production FileX syscall adapter. NOR rejects zero-to-one programming.
  Media models do not claim SD command-level, wear, power-cut atomicity or
  flash erase/program latency fidelity.
- Host display/input, console, OS entropy and explicitly selected real host
  Ethernet adapters remain host services. Unimplemented SPI devices remain
  unavailable; they do not return fabricated successful transactions.

## Controls and verification

```text
motor driver init
motor enable
motor move m1 9 --speed 10
motor jobs
sim status
motor home m1 --seek 30 --latch 3 --timeout 90
motor home m2 --seek 30 --latch 3 --timeout 90
motor home m3 --seek 180 --latch 30 --timeout 90
motor disable
```

`sim status` reports native truth independently of `motor status`. `sim power
on|off` controls the simulated motor supply only; MCU timers, GPIO enable and
driver logic remain live. A pulse interrupted by power loss is discarded. `sim fault m1|m2|m3 NAME` selects one
fault for that axis, replacing its previous fault:

- `clear`, `alarm`, `reference-stuck`, `reference-open`, `lost-step`;
- `encoder-open` (M1 only);
- `slip DEGREES` (one-time signed physical displacement);
- `dma-delay`, `irq-delay` (held until cleared);
- `uart-open`, `uart-corrupt` (M2/M3 only).

The `lost-step` fault preserves electrical pulse counts and INDEX phase while
preventing shaft movement. It is distinct from disconnecting STEP. Invalid
fault requests preserve the existing fault and pose.

Clearing an injected fault does not reset controller fault latches or re-enable
motors. Recover explicitly through the existing controller commands. Reference
open and stuck-active are electrically indistinguishable to this NC input.

```sh
ctest --test-dir build/debug-linux --output-on-failure
cmake --preset sanitize-linux
cmake --build --preset sanitize-linux --target protomate_simulation_tests
ctest --test-dir build/sanitize-linux -R '^simulation.machine$' --output-on-failure
```

`simulation.contacts` verifies closed-solid collision/containment, separation,
conversion signs/offsets/multi-turn coordinates, CAD contact/release boundaries,
and cached versus exact geometry queries through repeated reversals.
`simulation.cad_assets` also checks lever extraction, source hashes and STEP root
axes. Regenerate the embedded lever assets with
`scripts/extract_robot_switches.py`; use `--check` for read-only verification.

`simulation.machine` exercises wire validation, interprocess queues, timing,
pulses, reference hysteresis, encoder truth, TMC registers and NOR behavior.
`simulation.integration` launches the real controller, exercises all three
motors, slip feedback, all three homing sequences, alarms, recovery, stop and shutdown, and checks
recorded STEP edges and reference GPIO seek/release/latch transitions. The Z
homing example uses a faster seek because the nominal 1.25 mm/revolution screw
requires many motor turns; the simulation does not teleport to a home position. `simulation.opengl` uses Xvfb/Mesa where installed to test
actual shader execution, pixel readback, move-only resource ownership and FBO
resize/error handling. All original HAL, application, GUI and runtime tests
remain available. `simulation.lifecycle` kills/stalls peers and checks child
cleanup. `simulation.storage` writes files through FileX/LevelX, restarts both
processes, and reads them from the retained native images. GIGA builds exclude
the native simulator.

`simulation.packaging` copies only `Application` to an empty directory, starts
it, reads native hardware state through the controller, verifies exactly one
controller child executing from memory, and checks shutdown without extracted
files. `simulation.launch` checks image seals and failure/reaping behavior for
invalid embedded images.

The architecture test inspects both real link images to prevent ThreadX/TouchGFX
from entering the native process and simulated hardware from entering the
controller. Additional regressions exercise early IPC close with delayed or
stalled child exit, invalid session descriptors, a delayed initial heartbeat,
corrupt queues, immutable deferred DMA publications, invalid timer updates,
fractional prescalers, power interruption, common GPIO/PWM wiring, Z gearing,
exception cleanup and OpenGL context ownership. Run `simulation.regressions`
and `simulation.machine` under the sanitizer preset for native model checks.
