daleondev/ProtoMate_Control/hardware/display/references/SOURCES.md

# Design sources and attribution — display F / GIGA E

Reviewed 2026-10-22. Local copies retain the manufacturers' copyright. They are
engineering references, not project-authored specifications.

| Source | Use in this design |
|---|---|
| Smartwin `SMMH0701024600SC20.pdf`, supplied in `docs/display` and copied here | All 50 contacts, power, timing, reset, touch and rear-view mating orientation |
| Hirose `DF23C-50DP-0.5V-92-CL0688-0804-6-92-2DDRAWING-0000931633.pdf`, supplied in `docs/display` and copied here | Plug land pattern, numbering, body envelope and mating space |
| [Hirose DF23 product](https://www.hirose.com/en/product/p/CL0688-0804-6-92) | Exact mating plug and contact rating |
| [Molex 505110 sales drawing](https://www.molex.com/content/dam/molex/molex-dot-com/products/automated/en-us/salesdrawingpdf/505/505110/5051108091_sd.pdf); `Molex_505110_drawing.pdf` | 60-way body/land dimensions and 0.10mm / 100% paste; local older manufacturer drawing obtained from Farnell, geometry cross-checked with current drawing |
| [Molex 505110 specification](https://www.molex.com/content/dam/molex/molex-dot-com/products/automated/en-us/productspecificationpdf/505/505110/5051100000-PS-000.pdf) | Bottom contacts, 50V / 0.5A rating and contact resistance |
| [Molex 15018 specification](https://www.molex.com/content/dam/molex/molex-dot-com/products/automated/en-us/productspecificationpdf/150/15018/150180001-000.pdf) | Explicit 505110 mating pair, Type-A contact orientation, ear tabs, copper dimensions, resistance and conservative length tolerance |
| [Molex 15018 sales drawing](https://www.molex.com/content/dam/molex/molex-dot-com/products/automated/en-us/salesdrawingpdf/150/15018/150180036_sd.pdf) | 15018-0563: 60 ways, 102mm nominal, Type A |
| [Arduino GIGA CAD](https://docs.arduino.cc/static/5927a4ebbe3f363ebd68e7c50de5e0af/ABX00063-cad-files.zip) | Actual header contact positions, mounting holes and outline; extracted in `giga-geometry.json` |
| [Arduino GIGA STEP](https://docs.arduino.cc/resources/models/ABX00063-step.zip) | `libraries/3dmodels/GIGA_R1_WIFI.step` and mating assembly |
| [Arduino schematic](https://docs.arduino.cc/resources/schematics/ABX00063-schematics.pdf), copied as `GIGA_schematic.pdf` | Signal identity, 3.3 V rail and existing I2C4 pull-ups |
| [Arduino full pinout](https://docs.arduino.cc/resources/pinouts/ABX00063-full-pinout.pdf) | Arduino labels and MCU pin names |
| [TI SN74AXC8T245](https://www.ti.com/lit/ds/symlink/sn74axc8t245.pdf), local copy | Supply isolation, opposite DIR1/DIR2 levels, pinout and propagation limits |
| [TI SN74AXC1T45](https://www.ti.com/lit/ds/symlink/sn74axc1t45.pdf), local copy | Returning interrupt/READY translation and power-off behavior |
| [TI TCA9517A](https://www.ti.com/lit/ds/symlink/tca9517a.pdf), local copy | A/B bus assignment, low-level offset and power-off behavior |
| [TI TPS26600](https://www.ti.com/lit/ds/symlink/tps2660.pdf), `TPS2660.pdf` | Reverse polarity/current protection, RTN isolation, threshold dividers, current limit, slew and PWP0016A land pattern |
| [TI TPS7A91](https://www.ti.com/lit/ds/symlink/tps7a91.pdf), `TI_TPS7A91.pdf` | Precision logic supply, soft start, thermal pad and pinout |
| [TI TPS3808](https://www.ti.com/lit/ds/symlink/tps3808.pdf), `TI_TPS3808.pdf` | G33 threshold, 300 ms release and open-drain rail supervision |
| [TI SN74LVC08A](https://www.ti.com/lit/ds/symlink/sn74lvc08a.pdf), `TI_SN74LVC08A.pdf` | Supply-dependent reset/standby/PWM gating and partial-power behavior |
| [Yageo RT series](https://yageogroup.com/content/datasheet/asset/file/PYU-RT_1-TO-0-01_ROHS_L) | RT0603BRD feedback resistors: 0.1% initial tolerance, 25 ppm/K temperature coefficient |
| [TRACO TSR 1](https://www.tracopower.com/products/tsr1.pdf), `TRACO_TSR1.pdf` | TSR 1-24120 and TSR 1-2450 input/output limits and mechanical pinout |
| [TRACO TSR 2](https://www.tracopower.com/products/tsr2.pdf), `TRACO_TSR2.pdf` | TSR 2-2433 regulation, thermal coefficient, load limits and mechanical pinout |
| [Bourns SF-1206SA-M](https://www.bourns.com/docs/product-datasheets/sf-1206sa-m.pdf), `Bourns_SF1206SA-M.pdf` | F1 SF-1206SA200M-2: 2 A, 65 VDC, 50 A interrupt rating, clearing characteristic, cold resistance, temperature derating, land pattern and nominal 3D envelope; reviewed 2026-10-22 |
| [Bourns SF-1206S](https://www.bourns.com/docs/product-datasheets/sf-1206s.pdf), `Bourns_SF1206S.pdf` | F2 0.8 A / 63 V time-lag fuse and pad dimensions |
| [Littelfuse SMBJ](https://m.littelfuse.com/~/media/electronics/datasheets/tvs_diodes/littelfuse_tvs_diode_smbj_datasheet.pdf.pdf) | SMBJ33CA bidirectional TVS, 33 V standoff / 53.3 V rated clamp |
| [Diodes B360A](https://www.diodes.com/datasheet/download/B360A.pdf) | 60 V Schottky polarity, SMA package and forward drop |
| User-supplied `BarrelJack_Horizontal_AISLER.kicad_mod`; [Sourcing Map B07J4Z8B2T](https://www.amazon.de/dp/B07J4Z8B2T) | Selected DC-005 5.5/2.1 mm jack, terminal locations and plated-slot geometry; supplier listing is procurement provenance, not a manufacturer qualification report |
| [AISLER plated slots](https://community.aisler.net/t/plated-and-non-plated-slots/46) | 0.7–2.7 mm plated-slot width, length greater than 1.5× width; three J10 slots explicitly audited in Excellon and ODB++ |
| [Samtec socket catalogue](https://suddendocs.samtec.com/catalog_english/ssw_th.pdf), `Samtec_SSQ.pdf` | SSQ body dimensions and distinct -03 / -04 tail lengths |
| ST DS12930 Rev 3 Table 105, repository `docs/arduino_giga_r1_wifi/DS_stm32h747xi.pdf` | Conditional LTDC timing budget and its characterization conditions |
| [ST AN4861, LTDC polarity configuration](https://www.st.com/resource/en/application_note/an4861-lcdtft-display-controller-ltdc-on-stm32-mcus-stmicroelectronics.pdf) | DE must use the inverted LTDC setting; cross-checked against RM0399 `DEPOL` (not-data-enable polarity) |
| [AISLER references and locked support templates](AISLER.md) | ENIG HD rules, layer stack, mask processing, exposed vias, milling and ODB++ bridge markers; bare boards only |

`Molex_505110_drawing.pdf` is the manufacturer-authored SD-505110-001 drawing
obtained from [Farnell's mirror](https://www.farnell.com/cad/1966521.pdf).
The passive socket's project contact numbering is defined explicitly in the
footprint/cable map; physical coordinates and mirrored cable continuity are
audited independently of that numbering convention.

## Library attribution

Arduino's original CAD is CC-BY-SA 4.0; its original notice is
`Arduino-CAD-LICENSE.txt`, and the complete license is `CC-BY-SA-4.0.txt`.
The extracted geometry and derived GIGA mating models retain that attribution.
The official STEP is unmodified. `GIGA_outer_socket_envelopes.step` adds nominal
8.5 mm socket bodies absent from that model; those bodies are explicitly not
manufacturer production models.

Standard resistor, capacitor, fuse, SOT-23, TSSOP, VSSOP and barrel-jack STEP
models originate from the KiCad library contributors, installed KiCad libraries
on this workstation. Their license is CC-BY-SA 4.0 with KiCad's electronic-design
exception; see `KiCad-LIBRARY-LICENSE.txt` and the full CC license. Local changes
replace model paths, suppress crowded reference silkscreen and set project
manufacturing clearances. The TPS26600 land pattern uses TI’s PWP0016A recommended 3.3 mm exposed pad and 1.5 × 0.45 mm leads. Its 3D envelope and the display converter envelope follow the retained drawings; they are not production-tooling models.

Hirose, Molex and GIGA stacking-header footprints and simplified mechanical
envelopes were constructed for this project from the cited drawings. They are
not manufacturer-certified footprints or models. First-board fit and electrical
qualification are recorded separately from the digital release checks.

The supplied barrel-jack footprint retains its terminal positions and pad/slot
dimensions. Its body outline is shown on Fab rather than silk where the nose
overhangs the PCB. The installed KiCad barrel-jack STEP is retained locally under
the same KiCad library license; it illustrates the nominal envelope, not a verified
model of the purchased supplier lot. Both sleeve-related terminals are grounded.

## Tools

KiCad 10.0.6 generated and checked the schematic/PCB and manufacturing exports.
FreeRouting was a routing aid; the reviewed KiCad PCB is authoritative. FreeCAD
1.1.3 generated envelope models and the mating assembly. Gerbonara 1.6.3 parsed
the exported Gerbers and drills independently of KiCad; Inkscape rendered those
parsed layers. Project-specific audits are retained in `tools/`.

The manufacturer-authored TRACO PDFs were obtained from the
[datasheets.com TSR1 mirror](https://www.datasheets.com/traco-power/tsr1-24120/datasheet.pdf)
and [TSR2 mirror](https://datasheet.octopart.com/TSR2-2433-Tracopower-datasheet-140787542.pdf)
when the manufacturer's download endpoint rejected automated access. The retained
TSR2 specification is dated 2020-04-27; the installed KiCad footprint has a larger
courtyard around the same 14 × 7.5 mm nominal body. Supply ratings and tolerance
budgets use the retained manufacturer specification, including ±0.02%/K.
