daleondev/ProtoMate_Control/hardware/display/manufacturing/display-adapter-rev-G/drill-report.txt

Drill report for display-adapter.kicad_pcb
Created on 2026-10-23T11:27:31

Copper Layer Stackup:
    =============================================================
    L1 :  F.Cu                      front
    L2 :  In1.Cu                    in1
    L3 :  In2.Cu                    in2
    L4 :  B.Cu                      back

Drill file 'display-adapter-PTH.drl' contains
    plated through holes:
    =============================================================
    T1  0.250mm  0.0098"  (189 holes))
    T2  0.300mm  0.0118"  (23 holes))
    T3  0.400mm  0.0157"  (1 hole)
    T4  1.000mm  0.0394"  (3 holes))
    T5  1.100mm  0.0433"  (3 holes))

    Total plated holes count 219

Drill file 'display-adapter-NPTH.drl' contains
    unplated through holes:
    =============================================================
    T1  2.200mm  0.0866"  (4 holes))

    Total unplated holes count 4
