daleondev/ProtoMate_Control/docs/motion-current-state/review.md

# Current motion-control review

## 2026-11-11 completed cleanup and regression

The reported lint findings, raw-startup interruption bug and M4 QSPI execution
bottleneck are corrected. The current normal firmware uses SDRAM for ordinary M4
code; this is not a claim that the previous QSPI placement became fast enough.
Motion, heartbeat and ownership deadlines and interrupt priorities were retained.

- Clang-tidy: **430/430 production compilation contexts parsed, zero findings,
  blockers or tool failures**. Unit tests remain excluded. The record combines
  the strict full run with affected-file rechecks after the final fixes.
- Linux Debug/Release, GIGA M4/M7 Debug/Release, profiling and the electrical
  fixture build without compiler warnings. **85/85 normal and 85/85
  ASan/UBSan/LSan suites pass** on the final application source.
- The GUI cleanup exposed a name collision between local display-size constants
  and TouchGFX base-class statics. The constructor now receives the intended
  1024×600 dimensions; a separate integration assertion guards the configuration.
  Input, wheel zoom, keyboard, golden screenshots and native OpenGL tests pass.
- Initial raw pulse preparation runs in bounded batches with interrupts enabled.
  Publication checks revision/cancellation and samples its arm origin afterward.
  The STM32 register model and application-level buffering tests pass.
- Normal M4 code uses `0xC0480000` with a 1536 KiB limit. The lower 512 KiB is
  separately reserved for profiling and marked execute-never. The linked audit
  checks 62 roots and 182 reachable functions, with none outside internal RAM.
  The fixture independently verifies 1,024 words of actual SDRAM code through
  byte/halfword accesses, with zero mismatches and the active manifest checked.
- The motor-disconnected workflow passes all 44 submissions, including expected
  Busy rejections, homing → stop → homing, three independent-axis overlap cycles,
  coordinated stopping, jog, simultaneous raw workers, buffering/blending,
  active speed changes and repeated disabled initialization/restart.
- At 24 MHz, final captures verify raw **800/800/400**, coordinated
  **400/400/400**, and early controlled-stop **266/266/266** pulses. High times
  are 120–121 samples; coordinated rising edges differ by at most one sample.
  ENABLE remains inactive HIGH throughout. A later stop finished at the original
  400-pulse endpoint; that capture is retained separately.
- Normal Release pair **6bb2cd35b1b7e73a** is restored. Both cores report Ready,
  ICC is connected and the GUI reports zero underruns, DMA errors or render
  failures. The manual cold-power-cycle result is recorded separately below.

The final workflow measured at least 29% IO thread-stack headroom: the executor
peaked at 5,000/8,188 bytes, command worker at 13,468/28,668 bytes, and raw/homing
workers at 7,144/10,236 bytes. These are observed high-water marks, not worst-case
proofs. Normal M4 fast code has 3,360 bytes free; profiling leaves only **56 bytes**,
so further instrumentation/code additions need deliberate placement and size
budgeting. M4 D2 data uses 82,016/88,064 bytes.

The host-observed maximum CLI submission acknowledgement was 751 ms in the verbose
fixture workflow. That measurement includes USB reads and queued logging and is
not one-way ICC latency or motion-change latency. These short regressions do not
qualify maximum-rate endurance, worst-case response time, powered mechanics or
the physical panel. STEP reset pull-downs still need to be fitted externally.

See the [current machine-readable verification record](../motion-cleanup-2026-11-11.json)
for source hashes, firmware identities, measurements and retained failures.
The sections below are historical results, not open defects in this source state.

**Manual cold startup passed:** after the confirmed USB power cycle, both cores report Ready and ICC is connected. The GUI graphics self-test passes with zero underruns, DMA errors or render failures. Motors remain disabled and unreferenced; disconnected reference inputs are reported active/open.

## Earlier 2026-11-10 cleanup screening

Two focused corrections have now passed short application-level checks; final
lint/build/sanitizer qualification is still in progress.

- Raw initial DMA preparation now evaluates bounded batches with interrupts
  available. Publication checks the axis revision, including cancellation while
  preparation is in progress. The register-model reproduction failed before this
  change and passes afterward; all 21 STM32 register tests passed.
- Correlated TIM5 traces found tens to hundreds of milliseconds between shared
  memory publication and M4 dispatch/response under QSPI instruction fetches.
  Shared-memory publication itself was about 0.05 ms. Numerical homing
  preparation was about 1 ms in the failing QSPI run. No communication or motion
  deadline was relaxed.
- Ordinary M4 code now loads into SDRAM at `0xC0480000`, using at most 1536 KiB.
  Complete STEP/IRQ call paths remain in internal instruction RAM. The lower
  512 KiB remains reserved for profiling, with execute-never MPU coverage and
  packer/bootstrap rejection of code segments in those buffers.
- The SDRAM application fixture passed homing cancellation/restart, three
  independent-axis overlap cycles, family exclusion, coordinated stopping,
  jog, simultaneous raw moves, buffering/blending and active speed replacement.
- Analyzer screening passed raw counts 800/800/400, coordinated 400/400/400 and
  controlled-stop 374/374/374. High pulses were 120–121 samples at 24 MHz;
  coordinated rising edges differed by at most one sample. Enable remained HIGH.
- A subsequent capture setup was rejected by the existing ten-second homing
  timeout because accumulated raw moves had displaced the synthetic Axis 3 too
  far. Resetting the fixture restored the initial test positions; the fresh
  coordinated capture passed. The failed setup is retained.

Artifacts: `build/cleanup-validation-2026-11-10/`. These checks establish neither
powered mechanical accuracy nor maximum-rate qualification. The earlier results
below remain the record of the previous source state.

## 2026-11-10 pneumo integration follow-up

This follow-up does **not** establish a complete hardware release. The previous
urgent-sender allocation correction below remains in place, and three overlap
cycles plus a separate analyzer capture pass with the updated pneumo.

- Linux: 85/85 normal and 85/85 ASan/UBSan/LSan suites pass. After the final
  STEP correction, all six directly affected suites pass again in both builds,
  including the complete simulator motion workflow.
- Clang-tidy parses 426/426 translation units with no compiler blockers or tool
  failures. It still reports 6,650 findings; lint is not clean.
- Raw startup formerly sampled its arm timestamp before initial DMA calculation.
  A rollover regression reproduced the expired lead. Rebasing after calculation
  fixes it, and the analyzer verifies an isolated 800-pulse move.
- Five electrical captures pass: three short raw moves (18/18/9 pulses), the
  isolated long move (800/0/0), coordinated motion (400/400/400), controlled stop
  (287/287/287), and overlap (10/44/0). Enable remains inactive. Coordinated
  rising edges differ by at most one 24 MHz sample.
- **Open:** the full concurrent buffered-raw workflow reports an M1 startup I/O
  error. Raw initial-buffer calculation still masks interrupts; starvation of
  an active axis's guard is the leading explanation, requiring a timing trace.
  The isolated startup correction does not resolve that scheduling problem.
- **Open:** ordinary M4 code executing from QSPI failed reservation renewal and
  later heartbeat monitoring during motion preparation. The electrical fixture
  explicitly uses the SDRAM placement from the earlier successful qualification.
  Passing it does not qualify QSPI motion. No motion lease, active heartbeat or
  interrupt priority was relaxed.

The bounded hardware investigation stops at these blockers. Worker-based raw
preparation and QSPI scheduling need a separate focused correction before a
complete motion release. Failures are retained alongside passing results in the
[integration record](../pneumo-integration-2026-11-10.json).

## Earlier urgent-sender allocation correction

The concurrent shoulder-jog / independent-elbow communication failure is fixed.
The captured exception was **`std::bad_alloc` in the IO urgent sender**, requesting
4,228 bytes in `Bridge::nextOutgoingFrame`. This terminated the IO bridge; the UI
subsequently reported a heartbeat timeout. It was not evidence of inadequate
STEP throughput or a reason to relax deadlines.

Each lane now reuses its startup-allocated sender buffer. The frame-selection
helper is synchronous, and the long-lived sender coroutine waits for work and
transport completion. No maximum-size return value crosses another coroutine
promise on every message. Transport still borrows a span until send completion.

See [the machine-readable verification record](review.json) for exact
firmware identities, logs and capture hashes. Maximum-rate and powered mechanical
qualification remain separate.

## Implementation and regression coverage

| Area | Current behavior and verification |
|---|---|
| Homing deadline | The overall program deadline is armed at execution start. Expiry stops the current stage and prevents the next stage from starting. A regression covers multi-axis timeout. |
| Preparation admission | A mismatched protocol version is rejected before staging or hardware preparation. Ownership and revision checks remain active. |
| Explicit job wait | Stop-token notification uses the wait mutex to avoid a lost wakeup. Interrupting `motion wait` does not cancel its motion. Shutdown cannot report an unfinished job as completed. |
| Raw motion telemetry | Position/velocity reads use generator-synchronized state without waiting on the motor command mutex. A test holds startup inside that mutex and verifies telemetry remains responsive. |
| STEP scratch storage | Growing temporary preparation storage releases the old workspace before allocating the replacement. Active DMA buffers remain separate. A register-model test verifies exact edges while growing scratch for another axis. |
| Failure reporting | Preparation logs identify readiness changes, reference inhibition and STEP binding failures; STEP preparation includes the underlying errno. Server allocation failures report Capacity. UI connection failure leaves a read-only fault screen with uncertain jobs marked Unknown. |
| Native display synchronization | The native mutex masks ThreadX's suspension signal until unlock, preventing suspension of its owner while another managed thread waits on that mutex. It does not call ThreadX while holding the native lock. |
| Native model configuration | Mechanical configuration is cached before starting live simulation transport; a request no longer triggers the expensive CAD geometry calculation. |
| Native scheduling | ISR acknowledgement is followed by a sequence-bound scheduler-idle handshake. The next device event waits for runnable controller work to suspend. This prevents periodic wakeups from starving homing under instrumentation. |
| Native display clock | VSYNC and pointer timestamps share the simulated peripheral clock; the SDL event pump remains on wall time. Dedicated regressions cover paused clocks, presentation ownership and clock restart. |
| Static analysis and formatting | Safe mechanical lint fixes and formatting were applied to changed C++ files. Configuration hashing uses canonical serialization without a potentially throwing packet allocation. All production lint contexts now pass; the final record retains the original failures and clean rechecks. |

No operating envelope, ownership deadline, heartbeat deadline, motor resolution
or thread priority was relaxed as a result of these checks.

## Verification of the ICC correction

- Normal GIGA Debug and Release builds pass. The Release linked-code audit finds
  zero out-of-RAM targets among 63 roots, 172 reachable functions, seven vtables
  and 18 selected ICC entry points. This remains a bounded audit.
- All **79 Linux Debug CTest suites/workflows pass**, including the real HMI,
  native motion API and simulator integration.
- ICC transport, service/action lifecycle, urgency, background traffic and
  connection tests pass. A new allocation regression observes `operator new`
  during heartbeats and requires **zero full-frame allocations after startup**.
- Controller and executor tests pass; 20 pytest capture/console checks pass.
- Two complete motor-disconnected application runs each include **16 repeated
  jog + independent-axis overlaps**, varied submission timing, controlled stops,
  restart, family-exclusion rejection, homing → stop → homing, coordinated moves,
  raw buffered/blended commands, speed changes and disable/reinitialize cycles.
  Final lease diagnostics report 804 and 808 acknowledgements, respectively,
  with **zero renewal failures**. No automatic replay or deadline changes.
- A separate fresh-start analyzer run captures the overlap itself. The final
  source-matched fixture is `15131d746fe890d1`; the first screening fixture
  `4216523f17883099` additionally logged STEP binding diagnostics.
- Lint and sanitizers were not rerun for this targeted correction.

### Motor-disconnected overlap capture

| Output | Rising / falling edges | HIGH samples at 24 MHz |
|---|---:|---:|
| Shoulder / M1 | 9 / 9 | 120 |
| Elbow / M2 | 44 / 44 | 120–121 |
| Z / M3 | 0 / 0 | — |

Terminal pulse accounting agrees. Every STEP output starts and ends LOW;
ENABLE stays inactive in all 51,867,648 samples. HIGH time is 5.000–5.042 µs,
including analyzer sampling uncertainty. These independent motions are not
expected to have coincident edges. The capture does not verify DIR wiring,
maximum-rate throughput, physical switches or powered motion.

The fixture uses real timer/DMA, runtime, ICC, CLI and HMI, with synthetic driver
and reference inputs and physical enable held inactive. Its M4 cold code runs
in SDRAM for debugging; normal Release uses QSPI. Timing-critical code remains
in internal RAM in both images.

### Reproducing the checks

With the fixture flashed, motors disconnected, and a fresh reset:

```sh
python3 examples/giga_motion_api_test/verify.py --overlap-cycles 16 --output build/overlap-check
# Reset before this separate capture so synthetic homing starts near its contacts.
python3 examples/giga_motion_api_test/capture.py --overlap --output build/overlap-capture
```

Analyzer: D0 → A7, D1 → D3, D2 → D2, D3 → D15, and common GND.

## Resource limits and remaining qualification

Normal Release pair **`b87bf16b221f8486`** is restored and verified: UI/IO Ready,
ICC connected, motion disabled and no owning jobs. The Home renderer reports zero
LTDC underruns, DMA errors and render failures. Idle heap snapshots show 45,680
bytes available on IO and 44,880 on UI. These are not workload minima. M4 fast code uses
192,824 / 196,608 bytes and static D2 data 80,864 / 88,064 bytes. No runtime,
STEP interrupt priority, timer, communication deadline or motor limit changed.

In the final repeated-motion run, the IO heap had 33,328 bytes available at the
terminal diagnostic sample. This is **not a minimum-free-watermark measurement**.
The ICC worker peaked at 12,104 / 20,476 stack bytes; the motor command worker
peaked at 17,792 / 20,476 bytes. The latter has only about 13% measured headroom,
so additional command stack demand requires budgeting. No stack overflow was
observed. The configured 6,250-pulse/s ceiling, worst-case latency, sustained
maximum-load headroom and powered calibrated mechanics are not established by
these short regression runs.

## Figures and sources

- [Communication, memory, function placement and current problems (vector PDF)](current-motion-architecture.pdf)
- [Class and motion sequence diagrams (vector PDF)](uml/motion-uml.pdf)
- [Figure generator](generate.py), [class diagram](uml/05-cross-core-classes.puml),
  [finite admission](uml/06-finite-motion-admission.puml),
  [execution/stop/lease](uml/07-execution-stop-and-lease.puml),
  [raw motor path](uml/08-raw-motor-motion.puml),
  [homing lifecycle](uml/09-homing-lifecycle.puml),
  [concurrent motion and ICC buffers](uml/10-concurrent-motion-blocker.puml),
  [native simulation time handoff](uml/11-native-simulation-time.puml)
  ([rendered diagram](uml/11-native-simulation-time.svg)).

The figures describe current source behavior and the normal Release memory map.
Their SVG metadata records supporting source hashes. PlantUML sources are retained
alongside SVG and PNG outputs. Physical calibration, contacts, torque and collision
safety remain separate commissioning work.

Reproduce the software checks from the project root:

```sh
cmake --build --preset debug-linux
ctest --test-dir build/debug-linux --output-on-failure
cmake --build --preset giga-debug
cmake --build --preset giga-release
python3 scripts/giga_ram_audit.py build/giga-io-release/io-controller.elf
```

Native X11 tests require local display/socket permissions. Electrical captures use
`examples/giga_motion_api_test/capture.py` with the dedicated disabled-enable
fixture; normal firmware must not be substituted for that fixture.
