daleondev/ProtoMate_Control/hardware/display/cable-specification.pdf

102 nominal; 106 maximum design budget

30.5 end width

GIGA end: project pin 1 at this edge | Display end: project pin 60 at same edge

# Molex 15018-0563 — 60-way cable and orientation

ProtoMate | Revision G | 2026-10-22 | Dimensions in mm | Physical operation not yet verified

Order Molex 15018-0563 (Mouser 538-15018-0563), quantity 1: 60 parallel conductors, 0.50 mm pitch, same-side gold contacts (Type A),

102 mm nominal length. Ear tabs are required by the matched connector.

Both sockets: Molex 505110-6091 (Mouser 538-505110-6091), quantity 2. Bottom contacts, flip latch. Cable mating thickness 0.30

+/-0.05 mm. Manufacturer end/tab geometry is authoritative; this view only explains orientation.

Gold contacts are on the face shown; dashed blue regions indicate opposite-face stiffeners. In both top-mounted sockets the exposed

contacts face the PCB. Do not identify contact orientation from stiffener colour alone.

With facing sockets, project GIGA pin n reaches display pin 61-n. Project numbering follows the PCB drawings. Before power, check

end-to-end continuity and latch both ends without twisting or stressing the cable.

24V: GIGA 1/2 <-> display 60/59. Panel 3.3V reference: GIGA 5/6/7 <-> display 56/55/54. READY: 9 <-> 52. 19 ground conductors; PCLK

23 <-> 38 is guarded by grounds 22/24 <-> 39/37.

Cable: 60V, 0.5A/contact; connector: 50VAC/DC, 0.5A/contact. Copper 0.30 x 0.10 mm. Power budget uses 106 mm and two return

conductors conservatively. No live mating. Cable is included separately in the procurement order list.
