daleondev/ProtoMate_Control/hardware/display/cable-conductors.csv

GIGA_J1 | Display_J2 | Net | Display_J1_contacts
1 | 60 | +24V_DISPLAY
2 | 59 | +24V_DISPLAY
3 | 58 | GND | 1,2,3,4,11,36,40,42,50
4 | 57 | GND | 1,2,3,4,11,36,40,42,50
5 | 56 | +3V3_PANEL | 10,49; logic supply only
6 | 55 | +3V3_PANEL | 10,49; logic supply only
7 | 54 | +3V3_PANEL | 10,49; logic supply only
8 | 53 | GND | 1,2,3,4,11,36,40,42,50
9 | 52 | PANEL_READY | Adapter supervisors -> PI1 / D70; no direct panel pin
10 | 51 | LCD_SCL | 48
11 | 50 | LCD_SDA | 47
12 | 49 | GND | 1,2,3,4,11,36,40,42,50
13 | 48 | LCD_TOUCH_INT_N | 46
14 | 47 | LCD_TOUCH_RESET_N | 45
15 | 46 | LCD_TFT_RESET_N | 44
16 | 45 | LCD_STANDBY | 43
17 | 44 | LCD_PWM | 9
18 | 43 | GND | 1,2,3,4,11,36,40,42,50
19 | 42 | LCD_VSYNC | 37
20 | 41 | LCD_HSYNC | 38
21 | 40 | LCD_DE | 39
22 | 39 | GND | 1,2,3,4,11,36,40,42,50
23 | 38 | LCD_PCLK | 41
24 | 37 | GND | 1,2,3,4,11,36,40,42,50
25 | 36 | LCD_G7 | 27
26 | 35 | LCD_G6 | 26
27 | 34 | GND | 1,2,3,4,11,36,40,42,50
28 | 33 | LCD_G5 | 25
29 | 32 | LCD_G4 | 24
30 | 31 | GND | 1,2,3,4,11,36,40,42,50
31 | 30 | LCD_G3 | 23
32 | 29 | LCD_G2 | 22
33 | 28 | GND | 1,2,3,4,11,36,40,42,50
34 | 27 | LCD_G1 | 21
35 | 26 | LCD_G0 | 20
36 | 25 | GND | 1,2,3,4,11,36,40,42,50
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
