daleondev/ProtoMate_Control/docs/display/DF23C-50DP-0.5V-92-CL0688-0804-6-92-2DDRAWING-0000931633.pdf

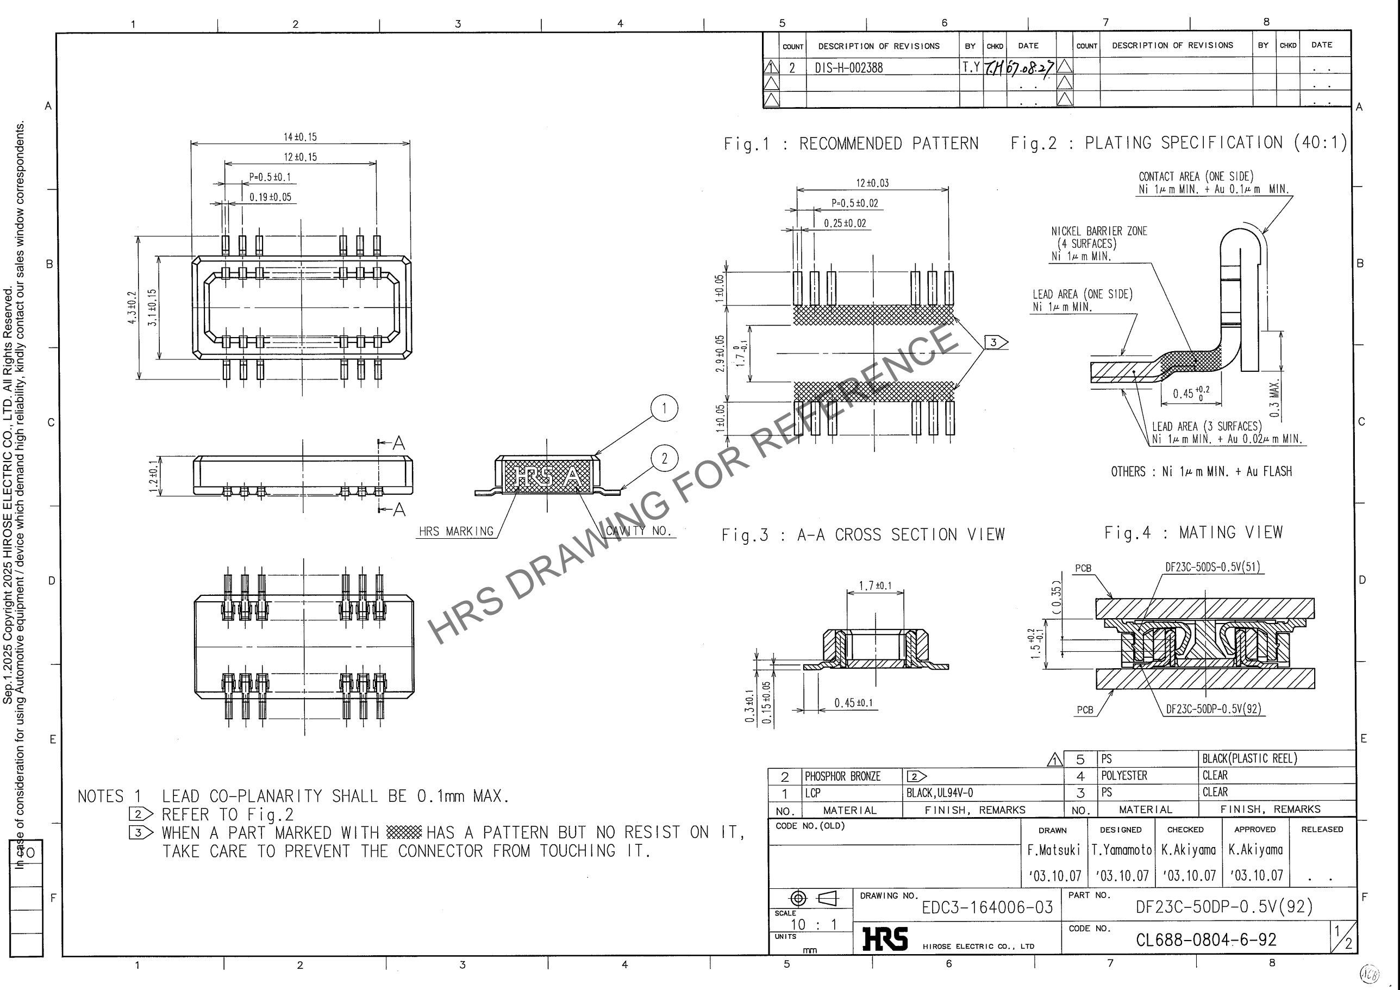
[picture p9: page 1]

HRS DRAWING FOR REFERENCE

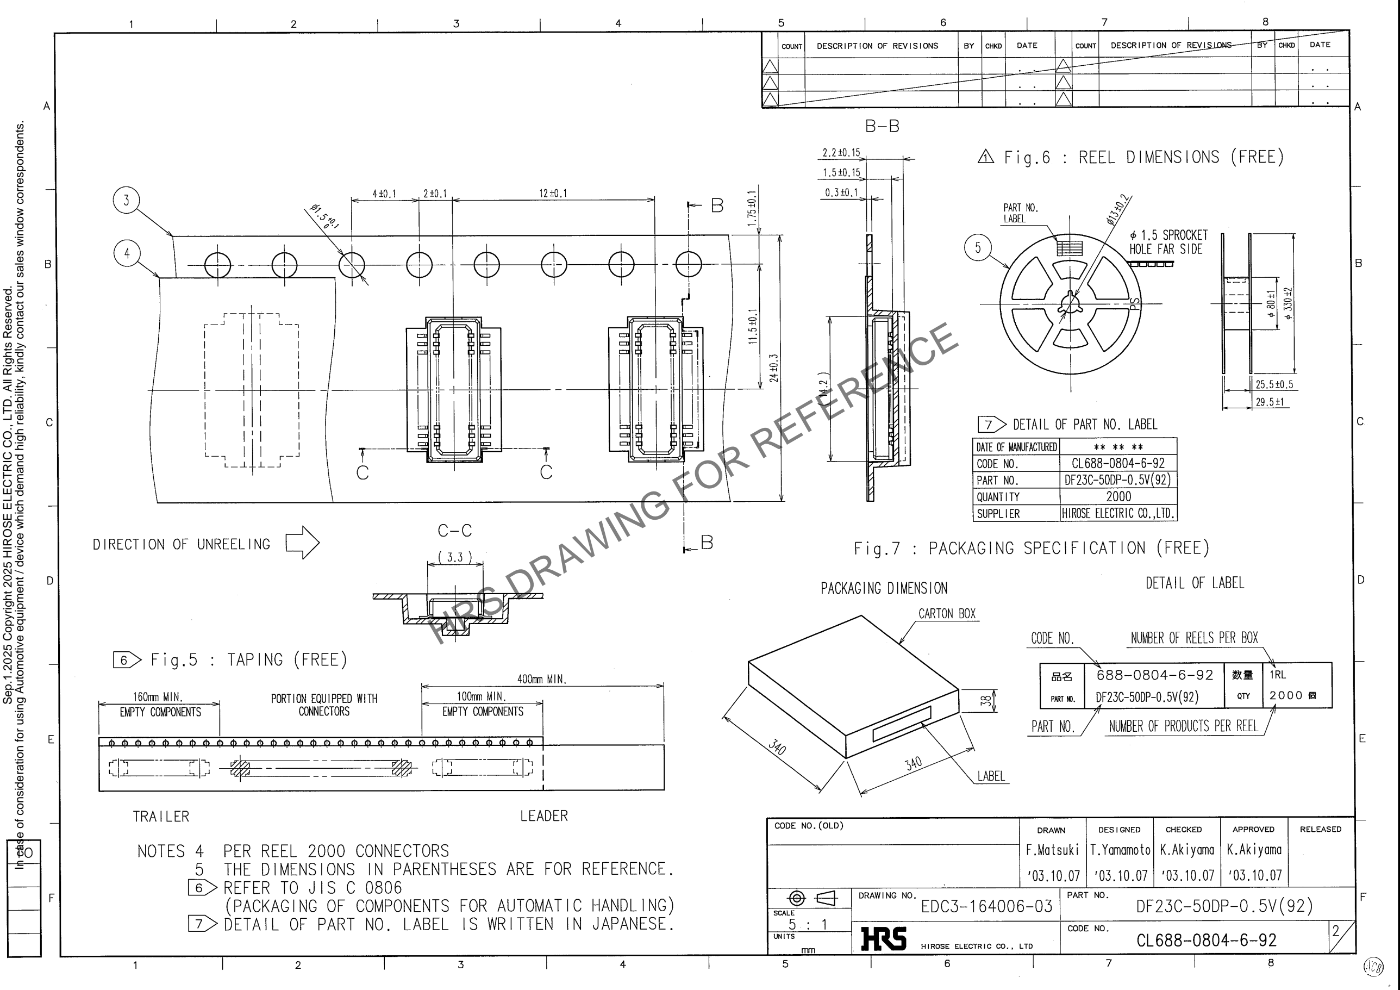
[picture p10: page 2]

HRS DRAWING FOR REFERENCE
