daleondev/ProtoMate_Control/hardware/display/connections.csv

name | mcu | arduino | panel | giga_ffc | display_ffc | header | header_pin | adapter_header | adapter_header_pin
R0 | PG13 | D23 | 12 | 59 | 2 | JSIDE | 4 | J8 | 4
R1 | PJ0 | D25 | 13 | 58 | 3 | JSIDE | 6 | J8 | 6
R2 | PJ1 | D27 | 14 | 56 | 5 | JSIDE | 8 | J8 | 8
R3 | PJ2 | D29 | 15 | 55 | 6 | JSIDE | 10 | J8 | 10
R4 | PJ3 | D31 | 16 | 53 | 8 | JSIDE | 12 | J8 | 12
R5 | PJ4 | D33 | 17 | 52 | 9 | JSIDE | 14 | J8 | 14
R6 | PJ5 | D35 | 18 | 50 | 11 | JSIDE | 16 | J8 | 16
R7 | PJ6 | D37 | 19 | 49 | 12 | JSIDE | 18 | J8 | 18
B0 | PJ12 | D22 | 28 | 47 | 14 | JSIDE | 3 | J8 | 3
B1 | PG12 | D24 | 29 | 46 | 15 | JSIDE | 5 | J8 | 5
B2 | PJ14 | D26 | 30 | 44 | 17 | JSIDE | 7 | J8 | 7
B3 | PJ15 | D28 | 31 | 43 | 18 | JSIDE | 9 | J8 | 9
B4 | PK3 | D30 | 32 | 41 | 20 | JSIDE | 11 | J8 | 11
B5 | PK4 | D32 | 33 | 40 | 21 | JSIDE | 13 | J8 | 13
B6 | PK5 | D34 | 34 | 38 | 23 | JSIDE | 15 | J8 | 15
B7 | PK6 | D36 | 35 | 37 | 24 | JSIDE | 17 | J8 | 17
G0 | PJ7 | D38 | 20 | 35 | 26 | JSIDE | 19 | J8 | 19
G1 | PE6 | D40 | 21 | 34 | 27 | JSIDE | 21 | J8 | 21
G2 | PI15 | D42 | 22 | 32 | 29 | JSIDE | 23 | J8 | 23
G3 | PG10 | D44 | 23 | 31 | 30 | JSIDE | 25 | J8 | 25
G4 | PH15 | D46 | 24 | 29 | 32 | JSIDE | 27 | J8 | 27
G5 | PK0 | D48 | 25 | 28 | 33 | JSIDE | 29 | J8 | 29
G6 | PI11 | D50 | 26 | 26 | 35 | JSIDE | 31 | J8 | 31
G7 | PK2 | D52 | 27 | 25 | 36 | JSIDE | 33 | J8 | 33
PCLK | PI14 | D39 | 41 | 23 | 38 | JSIDE | 20 | J8 | 20
DE | PK7 | D41 | 39 | 21 | 40 | JSIDE | 22 | J8 | 22
HSYNC | PI10 | D43 | 38 | 20 | 41 | JSIDE | 24 | J8 | 24
VSYNC | PI13 | D45 | 37 | 19 | 42 | JSIDE | 26 | J8 | 26
PWM | PC6 | D68 | 9 | 17 | 44 | J5 | 13 | J9 | 13
STANDBY | PI0 | D69 | 43 | 16 | 45 | J5 | 14 | J9 | 14
TFT_RESET_N | PI2 | D71 | 44 | 15 | 46 | J5 | 16 | J9 | 16
TOUCH_RESET_N | PI3 | D72 | 45 | 14 | 47 | J5 | 17 | J9 | 17
TOUCH_INT_N | PB12 | D74 | 46 | 13 | 48 | J5 | 19 | J9 | 19
SDA | PH12 | D102 | 47 | 11 | 50 | JDIGITAL | 2 | J2 | 2
SCL | PB6 | D101 | 48 | 10 | 51 | JDIGITAL | 1 | J2 | 1
