daleondev/ProtoMate_Control/backups/h753/README.md

# ProtoMate Control

Control software running on the robot controller of the ProtoMate SCARA Robot.

## Current hardware: NUCLEO-H755ZI-Q

**M4 runs `io::Application`; M7 runs `ui::Application`.** Each firmware has its
own main, ThreadX kernel, C++ runtime, heap, TLS and threads. Both use the same
runtime implementation and HAL interfaces. No application object, mutex or
scheduler is shared between cores.

Use `h755-io-debug` and `h755-ui-debug` (or their `-release` variants).
[Build, flash, memory and peripheral ownership](docs/nucleo-h755ziq/README.md)
are documented together. Both images must be flashed. The
[CubeMX project](external/CubeMX/CubeMX.ioc) assigns peripherals to their cores.

The current workers drive a HAL status LED: IO/green at approximately 2 Hz and
UI/yellow at approximately 1 Hz. **P2P is disabled in H755 firmware** until the
shared-memory transport is implemented. Motion control, planning, CLI and GUI
are subsequent application work. The bare-metal LED samples remain available
through the separate `h755-led-*` presets.

## Application layout

| Directory | Responsibility |
| --- | --- |
| `src/common/` | Shared contracts, application lifecycle concept and portable `p2p/` |
| `src/io/` | M4 entry point and IO application; future motion execution and sensors |
| `src/ui/` | M7 entry point and UI application; future planning, CLI and GUI |

Each firmware compiles only its own application target, `application::io` or
`application::ui`. Both use `application::common`. The Linux entry point in
`src/main.cpp` retains the in-process paired transport for host development and
lifecycle tests. It is not compiled into either H755 image.

The [application concept](src/common/Application.hpp) enforces `void start()`,
`void requestStop()` and `void join()` without inheritance. Construction starts
no threads. `start()` is one-shot; `requestStop()` is an idempotent thread-safe
notification; `join()` waits for completion. Destruction requests a stop and
joins. Call start/join/destruction from the lifecycle owner, outside workers.

`runtime::thread::Definition` annotations in each `Application.hpp` declare its
threads; `system_threads.cpp` defines their entries.
[ThreadGroup](platform/runtime/ThreadGroup.hpp) creates all workers before
releasing them. The status worker uses a condition-variable timed wait, so it
sleeps between LED changes and can stop immediately. On exit it turns its LED off.

| Thread in each H755 image | ThreadX priority (lower is higher) | Stack |
| --- | --- | --- |
| ThreadX timer worker | 0 | Port default |
| `io.applicationThread` / `ui.applicationThread` | 14 | 16 KiB |
| Runtime main/application entry | 15 | 8 KiB |
| Runtime cleanup/reaper | 31 | 2 KiB |

Priorities belong to separate schedulers; M7 priorities do not preempt M4 work.
`APPLICATION_ENABLE_P2P` retains the optional bus/bridge/context workers for
host tests. H755 builds reject enabling it until a hardware transport is ready.

The [application archive](backups/application/README.md) preserves the earlier
control/CLI implementation for incremental reimplementation. Legacy H753 STM32
presets are not compatible with the active dual-core CubeMX export; the old
export remains in [`backups/CubeMX`](backups/CubeMX/).

## Setup and compilers

```sh
git clone --recurse-submodules <this-repository>
# For an existing checkout:
git submodule update --init --recursive
```

Install CMake 3.22 or newer (3.24 or newer for `--fresh`), Ninja, GCC 16,
Arm GCC 16.1 or 16.2 with Newlib, OpenOCD, Arm GDB, Python 3, Git, and `patch`.
The project uses C++26 and the verified GCC 16 libstdc++ integration snapshot.
Unknown compiler majors and unverified Arm libstdc++ snapshots are rejected.
Linux tests download the pinned GoogleTest 1.17.0 source archive.

The VS Code devcontainer uses Arch Linux and checks that both compiler major
versions remain 16. Rebuild it after changing its Dockerfile. It exposes USB
and uses a development user with serial permissions. Host flashing and serial
capture also require access to the ST-Link USB and serial devices.

## Build and run

```sh
cmake --preset h755-io-debug
cmake --build --preset h755-io-debug
cmake --preset h755-ui-debug
cmake --build --preset h755-ui-debug
cmake --preset debug-linux
cmake --build --preset debug-linux
./build/debug-linux/Application
```

`h755-io-release`, `h755-ui-release` and `release-linux` provide optimized builds. After a
compiler upgrade use `cmake --preset <preset> --fresh` and rebuild cleanly.
Use `-DBUILD_TESTING=OFF` when configuring Linux to build the template without
fetching or building test dependencies.

All project C/C++ sources in `src/` and `platform/`, including tests, compile
with `-Wall -Wextra -Wpedantic` in both Debug and Release builds. Directory
settings apply these flags to new module targets as well.

H755 builds produce `io-controller` or `ui-controller` ELF/HEX/BIN/MAP files.
Use the [combined flash command](docs/nucleo-h755ziq/README.md#flash-and-test).

The following flash command applies only to the archived H753 setup:

```sh
openocd -f interface/stlink.cfg -f target/stm32h7x_dual_bank.cfg \
  -c "program build/debug-stm32/Application.elf verify reset exit"
```

The dual-bank target covers all 2 MiB of internal flash. The runtime test image
can exceed the first 1 MiB bank. The ST-Link USB connection also exposes COM1
(USART3) at **115200 baud, 8 data bits, no parity, 1 stop bit**, without flow
control. Prefer its stable `/dev/serial/by-id/*STLINK*if02*` path.

Linux simulates the HAL and uses the ThreadX Linux port. Standard Linux file
I/O uses the host filesystem; explicit FileX tests use simulated media images.
Runtime and HAL startup diagnostics appear on the terminal. The application then
runs the two p2p endpoints and waits without polling; there is no CLI yet.

The STM32 SPI/UART polling drivers also have isolated host tests using a
recording HAL and the system GoogleTest package:

```sh
cmake -S platform/hal/tests/transport_model -B build/hal-transport-tests -G Ninja
cmake --build build/hal-transport-tests
ctest --test-dir build/hal-transport-tests --output-on-failure
```

For the bare Nucleo + EVB-LAN9255 SPI feasibility test, build
`ethercat-test-stm32`. The [SPI test instructions](docs/ethercat/spi-test.md)
cover loopback, J17 straps, wiring, flashing, identification and repeated reads.
This image needs no motor hardware or external storage.

For a complete standalone SOES echo slave, build **`ethercat-slave-stm32`**.
It exchanges one `UDINT` in each direction, without robot functions. See the
[example instructions](docs/ethercat/slave-example.md) and install its
[ESI file](examples/ethercat_slave/ProtoMateEcho.xml) in the EtherCAT master.

## Linux sanitizer checks

Build and run the complete Linux test suite with AddressSanitizer,
UndefinedBehaviorSanitizer and leak detection:

```sh
cmake --preset sanitize-linux
cmake --build --preset sanitize-linux
ctest --preset sanitize-linux
```

The test preset sets `ASAN_OPTIONS=use_sigaltstack=0` because the ThreadX Linux
port owns its threads' alternate signal stacks. Instrumented builds also reserve
at least 1 MiB of native stack per simulated thread for sanitizer overhead;
firmware stack sizes are unchanged. Memory and leak checking remain enabled.
LeakSanitizer needs permission to inspect process threads; run these tests outside
a ptrace-restricted sandbox. These checks exercise simulated
hardware; STM32-specific register behavior still uses the isolated HAL tests.

## Application, HAL and runtime linting

Run the configured readability, naming, bug-prone, modernization, performance,
static-analyzer and Core Guidelines checks on production code in **`src/`,
`platform/hal/` and `platform/runtime/`**, including both Linux and STM32
implementations, with:

```sh
cmake --preset debug-linux
cmake --build --preset debug-linux --target clang-tidy
```

Alternatively, `cmake --preset clang-tidy-linux` followed by
`cmake --build --preset clang-tidy-linux` prepares a separate analysis directory.
These are explicit analysis targets; normal builds still use GCC without linting.

The runner requires Docker, Python 3, CMake/Ninja, the project's GCC 16 Arm
toolchain (including newlib/libstdc++ headers), and host ncurses development
headers. It uses a pinned Pneumo devcontainer image with matching
Clang/P2996, clang-tidy and reflection headers. If the image is not already
installed, pull it once:

```sh
docker pull ghcr.io/daleondev/pneumo-devcontainer@sha256:1c10d580f47f4fa402da038896027629ded2d94de4ddd0f382f8a63830fae3e7
```

The container runs without network access, with project sources mounted read-only.
Analysis copies of the compilation databases select Clang and reflection flags.
Linux analysis uses the image's libstdc++. STM32 analysis uses
`--target=arm-none-eabi`, the original Cortex-M7/FPU settings and the real Arm
toolchain's libstdc++/newlib headers, mounted read-only. Real host ncurses headers
are copied into the report directory. Firmware build flags,
dependency declarations and application sources are not rewritten.

The runner configures a private STM32 CMake directory under
`<build-directory>/clang-tidy/configurations/stm32/` to obtain the HAL and runtime's
actual includes and definitions without building or flashing anything. Separate analysis
databases preserve Linux and STM32 contexts for shared sources. Every production
HAL/runtime C/C++ source must have a compilation command; setup fails if a newly
added file is missing from these configurations. Runtime C sources use Clang's C
driver without C++ reflection flags. The shared `runtime/startup.cpp` hook uses
the main `Application` target's configuration, excluding its duplicate test and
example compilation commands.

All `test/` and `tests/` directories, including unit tests, test helpers, model
tests and hardware bench programs, are excluded from source selection, header
diagnostics and reports. No test configurations are prepared for linting.
External dependencies and copied sources in `vendor/` directories, including the
runtime's GCC source snapshot, are also excluded. Their real headers are still
parsed when required by a production source. Static analysis does not replace GCC
builds or hardware tests.

The runner generates `reflection-include/` from the pinned Clang `<meta>` and
consteval-type-trait headers. Only their library includes, namespace wrappers and
library-specific declaration macros are adapted for libstdc++; the reflection
implementations and compiler intrinsics are preserved. No lint-specific HAL,
ThreadX or callback stubs are used. STM32 sources are checked against the real
hardware headers in their ARM context.
Pneumo selects its existing Clang reflection workaround by the
reflection header instead of the surrounding standard library. Updating the image
requires revalidating this adaptation; missing expected header markers fail setup.

The runner invokes clang-tidy directly for each source, without a separate syntax
precheck. Each invocation's raw output is printed as it finishes, keeping the
diagnostics together during parallel runs. The console includes clang-tidy's
source excerpts, notes and check names; custom progress lines, summaries and
deduplicated findings are omitted.

CLI registration uses explicit command namespace reflections, and thread
annotations use reflection operations supported by both compilers. Stack and heap
tables in `cli/utilities.cpp`
use `std::vformat_to` to avoid Clang/libstdc++'s compile-time dynamic-width checking
incompatibility. These table formats are checked at runtime; other format strings
retain compile-time checking. Blocking compiler errors cannot be disabled with
clang-tidy check filters. See the [clang-tidy documentation](https://clang.llvm.org/extra/clang-tidy/).

Reports are saved separately in `<build-directory>/clang-tidy/`:

- `findings.txt`: deduplicated `src/`, `platform/hal/` and `platform/runtime/`
  diagnostics from fully parsed files.
- `partial-findings.txt`: review-only diagnostics if clang-tidy fails to parse
  a file; normally empty.
- `summary.txt` and `report.json`: coverage, blocked files and their errors.
- Per-context directories containing per-source `.log` and `.yaml` files: full
  diagnostics and suggested replacements. `analysis.json` lists the selected
  commands and their databases; the JSON report records each invocation's context
  and duration.
  Replacements are **never applied automatically**.

Exit status is `1` for findings in fully parsed files, and `2` for tool failures or
when no file can be fully checked. Partial coverage is accepted by default;
compiler errors remain visible in the raw output and saved coverage report.
To require complete coverage:

```sh
python3 scripts/clang_tidy.py --build-dir build/debug-linux --strict
```

The naming rules live in `.clang-tidy`. Clang 21 uses `GlobalConstant` for global
constants including constexpr, and `PublicMember` for public fields including
ordinary struct fields. `tooling.clang_tidy` tests diagnostic classification,
source/test/vendor filtering, HAL/runtime inventory, C/C++ commands, target contexts
and failure handling without Docker.

Keep explicit default member initializers in aggregate configuration types,
including `{}` for class-type members. The
[`readability-redundant-member-init`](https://clang.llvm.org/extra/clang-tidy/checks/readability/redundant-member-init.html)
check is disabled because removing those defaults conflicts with GCC's
`-Wmissing-field-initializers` under `-Wextra`. The compiler warning remains
enabled; lint fixes must preserve a warning-free GCC build.

Cognitive-complexity checks count application control flow, excluding macro
expansions. Compiler-generated coroutine diagnostics have narrowly named,
commented `NOLINT` markers; the remaining check families stay enabled.

## HAL architecture

The HAL provides peripheral access and device behavior. Robot motion planning,
homing policy, gearing, kinematics and CLI commands belong to the application
modules being rebuilt in `src/io`, `src/ui` and `src/common`. Thread scheduling, the C++ runtime and filesystem integration belong
to `platform/runtime`.

### Layers and responsibilities

Paths in this table are relative to [`platform/hal`](platform/hal).

| Location | Responsibility | Dependencies within the HAL |
| --- | --- | --- |
| `drivers/itf` | Peripheral capability interfaces (`ISpi`, `IUart`, `IDigitalInput`, etc.) and their configuration/value types | Other driver contracts and common `util` |
| `drivers/impl/stm32`, `drivers/impl/linux` | Concrete classes implementing those interfaces using the selected platform | Driver contracts, driver helpers and platform support |
| `drivers/impl` | Shared step-generator/output algorithms | Driver contracts, helpers and the internal `StepHardware` backend boundary |
| `drivers/factory` | Select a backend, validate a supported resource/route, claim ownership and return its interface | Driver implementations and other driver factories |
| `devices/itf` | Device capabilities such as `IMotorFeedback`, `IStepperDriver`, `IButton` and `ILed` | Device/driver contracts and common `util` |
| `devices/impl` | Device behavior and protocols: TMC2209, DM542T, LAN9253, feedback, button and LED adapters | Injected driver interfaces and device helpers |
| `devices/factory` | Construction that differs by platform, currently TMC2209 transport/model composition | Driver factories and the selected device model |
| `board/board.hpp`, `board/nucleo_h753zi/board.cpp` | Translate robot/board roles into pins, peripherals, driver addresses and device compositions | Public factories and portable device implementations |
| `hal.hpp/.cpp`, `stm32`, `linux` | Platform startup, console, panic handling, interrupt dispatch and platform synchronization | Selected platform/vendor facilities |
| `util`, `drivers/util`, `devices/util` | Common result types or helpers private to their respective layer | Same-layer or lower-level contracts; never board/application policy |

Each compiled layer has its own target. The public dependency chain is:

```text
platform::hal → hal::board → hal::devices → hal::drivers
```

Each target compiles only its own sources; CMake selects the STM32 or Linux
backend. The Linux step and encoder workers are compiled as `hal_linux_services`
objects using the runtime's C++ ABI and included in `hal_drivers`. Their opaque
service objects keep that ABI boundary out of public interfaces.

Interfaces and public factory headers contain no vendor handles, platform
headers or board wiring. Configuration types live beside the interface, so an
implementation never needs a factory header to obtain its own types.
[`GpioTypes.hpp`](platform/hal/drivers/itf/GpioTypes.hpp) contains GPIO values and
configuration; the actual input/output interfaces are separate.

Concrete classes are declared in `.hpp` files and implemented in matching `.cpp`
files. Coherent families can share a pair, as `GpioInput` and `GpioOutput` do in
`Gpio.hpp/.cpp`. Shared algorithms stay in the common implementation directory;
platform models stay in `impl/linux`. Small inline methods and template helpers
remain in headers. Helper directories and namespaces consistently use **`util`**:
`hal::util` for common/driver helpers and `hal::device::util` for device helpers.

Device behavior uses injected interfaces and contains no peripheral selection
or MCU register access. The explicit platform exception is synchronization:
`InterruptGuard`, `Mutex` and `ThreadMutex` protect callbacks and shared state.
TMC2209 and LAN9253 protocol classes can be concrete portable classes; capability
interfaces are introduced where callers need interchangeable implementations.
`IConfigurableStepperDriver` extends `IStepperDriver` with optional configuration.

The board layer defines wiring and composes those objects. It contains no host
simulation registry or simulated register behavior. The Linux TMC2209 device
factory attaches `Tmc2209Model` to a generic UART; tests can instead construct
and inject their own model/transport. Generic SPI/UART drivers contain no motor
or EtherCAT protocol. `hal.hpp` is the startup/vendor bridge and is not a header
for ordinary device implementations or public contracts.

### Factories and resource selection

Configurable factories take a typed `Configuration` describing hardware resources.
GPIO selects pins; buses select a peripheral; PWM/encoder configurations select a
peripheral and its pin/channel route. Device roles and wiring choices belong to
`hal::board`, not to the transport drivers.

```cpp
auto spi = hal::spi::create({ .peripheral = hal::spi::Peripheral::Spi5 });
auto uart = hal::uart::create({
    .peripheral = hal::uart::Peripheral::Usart2,
    .transport = { .local_echo = true, .settle_time = std::chrono::milliseconds{1} }
});
auto timer = hal::timer::create({ .peripheral = hal::timer::Peripheral::Tim5 });
auto pwm = hal::pwm::create({
    .timer = hal::timer::Peripheral::Tim1,
    .channel = hal::timer::Channel::Channel1,
    .pin = { hal::gpio::Port::E, 9 }
});
auto encoder = hal::encoder::create({
    .timer = hal::timer::Peripheral::Tim3,
    .a = { hal::gpio::Port::B, 4 }, .b = { hal::gpio::Port::B, 5 }
});
```

SPI/UART ownership is independent for each selected peripheral. On STM32,
bindings to handles, initialization and SPI recovery are generated from CubeMX's
`spi.h` and `usart.h` declarations during CMake configuration. Enabling another
peripheral in CubeMX and regenerating makes it selectable without editing the
factory. Its pins, clocks, baud rate and SPI frame settings remain CubeMX-owned.
The current hardware configuration enables **SPI5 and USART2**; unsupported,
unconfigured or already-owned selections return null. **USART3 is reserved for
the console.** Linux provides independent in-process bus models for the valid
selectors, with USART3 likewise reserved; it does not access host SPI/UART devices.

The generic timer factory exposes the shared TIM5 runtime timer. Other timers
retain their existing ownership through the PWM, encoder and step factories.
The single RNG, RTC and fixed step engine need no selector. Existing ownership
rules remain: shared system services return their existing instance, while GPIO,
SPI/UART, PWM, encoder and step resources require exclusive ownership.

| Factory | Selection and lifetime |
| --- | --- |
| `gpio::create_input/create_output` | Pin and electrical configuration; exclusive pin ownership |
| `spi::create`, `uart::create` | Typed peripheral selector; exclusive instance per bus, retained through complete driver destruction |
| `timer::create` | Typed selector; currently the shared TIM5 runtime timer |
| `pwm::create` | Timer/channel/pin route; exclusive timer and pin |
| `encoder::create` | Timer and A/B pins; exclusive timer and both pins |
| `step::create` | One fixed TIM2/DMA engine; each axis view retains its generator and its GPIO ownership |
| `rng::create`, `rtc::create` | Shared single system service |
| `ethernet::create` | One shared STM32 MAC, requiring matching configuration; Linux creates host packet-socket instances |

Factories return `std::shared_ptr` to the requested interface. Resource factories
reject unsupported or busy selections with null; operations also validate their
own arguments. Constructors accept dependencies and establish the initial state;
starting motion requires an explicit call. SPI/UART hardware setup occurs when
their factory creates an instance, using CubeMX's generated initialization.
The owning device serializes complete SPI chip-select transactions or UART
request/reply sequences; selecting an exclusive bus does not itself serialize
concurrent callers.

Operations report failures using `hal::util::Result` and `std::error_code`.
The STM32 HAL-status conversion lives in `stm32/HalResult.hpp`; Linux failures
use standard error codes or the host's `errno`. Callback context and permitted
operations are specified on each interface. STM32 interrupt callbacks must be
short and nonblocking; callers must respect callback lifetime and unregister/
stop requirements before releasing their dependencies.

### Checking the structure

[`verify_hal_architecture.py`](cmake/tests/verify_hal_architecture.py) checks
production includes, helper naming, interface/factory boundaries, selected
platform sources and CMake source ownership. It is registered as
`hal.architecture` in the Linux CTest suite. Both build selections can be checked
explicitly after configuring them:

```sh
python3 cmake/tests/verify_hal_architecture.py --source . --build build/debug-linux
python3 cmake/tests/verify_hal_architecture.py --source . --build build/debug-stm32 --platform stm32
ctest --test-dir build/debug-linux --output-on-failure
```

The native transport, PWM and step tests also exercise STM32 implementations
against recording register/HAL models. Structural checks and host models verify
software boundaries and behavior; electrical timing remains a hardware test.

## Processor-to-processor messaging

`application::p2p` supports serialized topics, services and actions, with peer
readiness, connection health and state-change callbacks. It remains available as
a portable library while application control and CLI are rebuilt.
The [two-bus examples](src/common/p2p/examples/README.md), including the
[action example](src/common/p2p/examples/actions.cpp), also run independently.

The implementation separates message routing from byte transport:

| Location | Responsibility |
| --- | --- |
| [bridge/Bridge](src/common/p2p/bridge/Bridge.hpp) | Public registration API, lifecycle, send/receive loops, fair scheduling and failure handling |
| [bridge/TopicBridge](src/common/p2p/bridge/TopicBridge.hpp) | Reflected topic registration, subscriptions, latest-value coalescing and incoming publications |
| [bridge/ServiceBridge](src/common/p2p/bridge/ServiceBridge.hpp) | Reflected service registration, deferred proxies, call IDs, replies, cancellation, deadlines and cleanup |
| [bridge/ActionBridge](src/common/p2p/bridge/ActionBridge.hpp) | Reflected action registration, deferred admission, feedback, cancellation, acknowledged terminal results and cleanup |
| [bridge/ConnectionHealth](src/common/p2p/bridge/ConnectionHealth.hpp) | Handshake, acknowledged heartbeats, deadlines and connection state notifications |
| [bridge/Frame](src/common/p2p/bridge/Frame.hpp), [bridge/OutgoingWakeup](src/common/p2p/bridge/OutgoingWakeup.hpp) | Shared wire encoding and coalesced readiness signals per lane |
| [transport/](src/common/p2p/transport/ITransport.hpp) | Transport interface and paired in-process transport; transfers bytes without interpreting messages |

`Bridge` owns its routing and connection helpers by value and serializes registration against startup.
The helpers run on its coroutine context and cannot call back into `Bridge` or
access the transport. Shutdown first drains actions while communication continues,
then closes services and disconnects topic subscriptions after its four transport
loops and health timer loop finish. The caller owns the context and runner thread;
the previous application thread glue is archived with `system_threads`.

```mermaid
flowchart LR
    IO[IO bus] <--> IB[IO bridge]
    IB <-- serialized frames --> T[InProcessTransport pair]
    T <-- serialized frames --> UB[UI bridge]
    UB <--> UI[UI bus]
```

The standalone topic example owns two independent buses and two bridges. Both bridges run on one
coroutine context on a dedicated p2p thread. Each has a send and receive coroutine per lane, all on the same context.
They suspend while waiting and yield after each frame so normal traffic cannot
monopolize the context. Application subscriptions dispatch on
their caller's thread. The application shells already use separate contexts and
runners, matching the intended ownership of the future core applications.

[Topics.hpp](src/common/p2p/examples/Topics.hpp) specifies the forwarded topics using
`pnm::msg::Topic<T>` fields annotated with a publisher. No catalog
instance is constructed. Register the shared catalog once per bridge, identifying
the local publisher:

```cpp
io_bridge.registerTopics<Topics>(TopicPublisher::IO);
ui_bridge.registerTopics<Topics>(TopicPublisher::UI);

// Infer the payload type and topic name from the annotated field.
io_bus.topic<^^Topics::demo_io_state>().publish("idle");
```

Matching publisher annotations become outgoing topics; the peer's publications
become incoming. The application-defined enum must declare exactly two distinct
values. Annotation order is irrelevant; unrelated annotations are ignored.
Fields without the publisher annotation stay local. Forwarded fields require one
publisher. Names default to the field identifier with every `_` replaced by `/`:
`demo_io_state` becomes `demo/io/state`. One optional nonempty narrow `FixedString`
annotation overrides the name verbatim. Multiple name annotations and annotated
static declarations are rejected. Registration uses catalogs only. Register before
`start()`; names must be unique across both directions on each bridge.

The service API uses a separate application-defined `ServiceProvider { IO, UI }`
enum and annotated nonstatic `pnm::msg::Service<Request, Response>` fields.
`registerServices<Services>(ServiceProvider::IO)` identifies the IO side;
`bus.service<^^Services::demo_io_echo>()` derives the name and both payload types from
the field. No catalog object is constructed. Names and provider annotations
follow the same validation and ordering rules as topic names and publishers;
fields without the provider annotation stay local.
Matching provider annotations accept incoming requests for local handlers; the
peer's services forward outgoing requests. Replies return automatically.
[Services.hpp](src/common/p2p/examples/Services.hpp) illustrates the catalog and
[services.cpp](src/common/p2p/examples/services.cpp) runs an echo service. Applications
own and dispatch their handlers using the native or coroutine pneumo API. Bridge
proxies use deferred replies; they never execute application handlers or block
waiting for a result on the p2p context. Native readiness notifications and
deadline timers wake the bridge. No waiting thread is created per call.

`ITransport` asynchronously sends and receives complete frames using borrowed
spans. Its `Lane::Normal` and `Lane::Urgent` queues have independent capacity,
waiters and sender/receiver coroutines. `InProcessTransport::pair()` reserves eight
2048-byte frame slots per lane and direction (four queues). A full normal queue
cannot block urgent send or receive. Each lane preserves FIFO order; there is no
ordering between lanes. Urgent traffic remains bounded and can itself back up.
It does not preempt a running handler or rescue a stalled context. Cancellation and `close()` wake waiting operations; closing either
endpoint disconnects the pair. Reconnection requires a new pair.

The frame has a 16-byte header: version (currently 6), frame kind, 16-bit name
length, 64-bit call ID and 32-bit remaining timeout in milliseconds. Integers are
little endian. Name bytes and serialized payload follow, with a 2048-byte total
limit. Topics, service requests and action goals identify their destination by
name. Replies and action lifecycle frames use correlation IDs; services and
actions have separate ID spaces. Topics use zero call ID and timeout. Action
result payloads start with an explicit one-byte status; errors have explicit
one-byte codes independent of native enum layouts.
Payloads use pneumo serialization. `std::string` sends its characters, not its
native object layout. Compound types need explicit serialization adapters with
portable field widths and byte order before use between different targets.

Each bridge accepts up to 16 topics, 16 services and 16 actions. Outgoing subscriptions retain only the
latest pending value per topic, and readiness notifications wake the sender.
Service requests are never coalesced. There are eight forwarded calls per
lane and direction, eight queued/pending requests per local proxy, and eight queued
rejection replies per lane. Normal traffic cannot consume urgent service slots. Excess calls report `Busy`; a peer overrunning the rejection
queue fails the connection rather than growing memory without bounds.
Completed replies are retained until queued into the transport or shutdown.
The normal sender rotates between ready action, service and topic traffic; the
urgent sender rotates between action cancellation/ACKs and service traffic.

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

Actions use `registerActions<Actions>(ActionProvider::IO)` and reflected
`bus.action<^^Actions::member>()` handles on both native and coroutine buses.
Their catalogs follow the same optional name and provider rules as services.
[Action usage](src/common/p2p/examples/actions.md) explains the provider and caller roles.
The bridge forwards acceptance only after the real provider accepts. Feedback is
latest-only; terminal results are retained until acknowledged by the peer. Each
direction admits eight forwarded goals; each proxy admits eight native goals.
Eight rejection slots and sixteen acknowledgement slots have independent bounds.
Excess work reports `Busy`; malformed framing or peer capacity abuse fails the link.

Action cancellation requests cleanup and does not finish the goal. A goal
cancelled before forwarding can complete locally because no remote work exists.
Once forwarded, only a terminal response confirms the outcome. Admission timeouts
apply until acceptance, not throughout execution. Timed-out/abandoned callers still
retain bridge records until the remote terminal result or connection closure.
No submitted goal is automatically replayed.

`stop(grace)` stops action admission and requests cancellation, keeping workers
and communication running until results are delivered. The default grace is
500 ms. If it expires, `failure()` records the timeout and unfinished callers get
`TransportError`, not a fabricated `Cancelled` outcome. Provider cleanup must
continue independently after a communication failure. Native caller callbacks
run when the application polls its handle, never on the bridge's context thread.
The p2p application thread and runtime-backed example runners use a 32 KiB stack
for nested Debug serialization; the portable bridge does not configure threads.

Cancellation and action terminal acknowledgements always use the urgent lane.
A cancellation may arrive before its normal request/goal; bounded records ensure
the later command never reaches an application provider. Action results and
feedback retain their normal-lane ordering. A cancellation request still does not
confirm that already-running work has stopped; its terminal response may wait for
normal capacity. Service cancellation carries one byte identifying the original
request lane (0=normal, 1=urgent).

Services may explicitly reserve the urgent lane in their shared catalog:

```cpp
struct Services
{
    [[= ServiceProvider::IO, = p2p::Lane::Urgent]]
    pnm::msg::Service<StopRequest, StopResponse> stop;
};
```

The annotation applies to requests and replies, and both peers must agree. Other
services default to normal; topics, goals, action acceptance/feedback/results use
normal. Keep urgent service handlers short or defer work to an IO worker. The
control catalog uses this lane for Stop and Disable.
Connection management uses that same urgent lane ahead of application traffic.

A bridge starts in `Stopped`, then reports `Connecting` and exchanges Hello/Ready
frames before forwarding application data. Calls queued during this handshake
remain local and retain their native timeout. `Connected` means both peers have
completed the version-compatible handshake; it does not validate application
catalogs, motor configuration or physical hardware readiness.

Connection monitoring defaults to a 100 ms heartbeat and a 500 ms deadline;
pass `ConnectionOptions{.heartbeat = 100ms, .timeout = 500ms}` as the fourth
constructor argument to configure them. Only a fresh acknowledgement of the
outstanding heartbeat refreshes the deadline. Incoming publications, peer
heartbeats and repeated old acknowledgements cannot conceal a broken outgoing
path. One outstanding challenge and one coalesced reply bound control storage.
Management kinds are Hello (13), Ready (14), Heartbeat (15), HeartbeatAck (16)
and Goodbye (17). Their name, timeout and payload are empty; only the heartbeat
frames carry a nonzero challenge ID.
The health coroutine has its own timer and wakeup, so its deadline still expires
when either transport sender is blocked. Deadlines are checked before dispatch,
including after a stalled context resumes.

Register a connection callback before `start()` and read the current snapshot
with `connectionStatus()`. For example, publish the notification to a **local**
application topic that an IO worker consumes:

```cpp
auto connectionEvents = io_bus.topic<p2p::ConnectionStatus>("local/p2p/connection");
io_bridge.setConnectionCallback([connectionEvents](p2p::ConnectionStatus status) {
    connectionEvents.publish(status);
});
```

The callback runs on the p2p context outside internal locks. Keep it short: notify
or enqueue work; do not block, join workers, call `stop()`, or destroy the bridge
inside it. Captures must outlive the bridge. No notification is emitted at
registration; `Connecting` is the first event. State changes are emitted once,
not on every heartbeat. Callback exceptions fail the connection while preserving
teardown. The callback and all pending transport operations finish before
`stop()` returns.

`Failed` is latched, with an explicit reason such as `HandshakeTimeout`,
`HeartbeatTimeout`, `PeerRestarted`, `TransportError`, `ProtocolError`, or
`ShutdownTimeout`. Outstanding service/action handles receive `TransportError`,
local provider cancellations are requested, and bridge-owned queued work is
invalidated. An accepted action still needs application cleanup: link failure
never confirms a physical stop. A fresh Hello on an established link requires
explicit recovery; this detects an announced restart, not every possible stale
frame from an earlier boot.

An orderly local shutdown reports `Stopping` then `Stopped`, after action draining
and an urgent Goodbye. A peer Goodbye with no outstanding actions also reports
`Stopped`, with reason `PeerStopped`; if actions are still outstanding it fails
with that reason. Treat every departure from `Connected` as unavailable for new
control commands. Every failure requires deliberate reconstruction/recovery;
there is no automatic reconnection or motion replay.

All monitoring runs on the p2p context. If that entire context or processor
freezes, its local timer cannot run: an independent IO/hardware watchdog is still
needed when integrating motion control. Callback consumers own the local stop,
holding-torque policy, latched robot fault and explicit recovery. Those robot
policies are not implemented inside the portable bridge.

The archived [control message catalogs](backups/application/control/Messages.hpp),
[client](backups/application/control/ControllerClient.hpp) and
[server](backups/application/control/ControllerServer.hpp) are reference material
for rebuilding the execution boundary. They are not part of the current normal build.

STM32 Debug compiles the portable p2p library with `-Og` while retaining debug information.

Build and test the bridge independently:

```sh
cmake --build --preset debug-linux --target application_p2p_example application_p2p_service_example application_p2p_action_example application_p2p_transport_tests application_p2p_service_tests application_p2p_action_tests application_p2p_urgent_tests application_p2p_connection_tests
./build/debug-linux/src/common/p2p/examples/application_p2p_example
./build/debug-linux/src/common/p2p/examples/application_p2p_service_example
./build/debug-linux/src/common/p2p/examples/application_p2p_action_example
ctest --test-dir build/debug-linux -R '^application\.p2p\.' --output-on-failure
```

## Planned migration to STM32H747XIH6 (Arduino GIGA R1 WiFi)

**Status: future design; not implemented.** The current target remains the
NUCLEO-H753ZI. The build, flashing instructions, CubeMX configuration and KiCad
wiring in this repository still describe that board. Migration to the GIGA is
planned, but is a separate implementation task.

### Controller responsibilities

Use the STM32H747XIH6 as two controllers with separate firmware images and
separate application state. **M7 plans robot motion; M4 owns its execution and
can stop it independently.**

| Responsibility | IO controller: Cortex-M4, 240 MHz | UI and planning controller: Cortex-M7, 480 MHz |
| --- | --- | --- |
| Hardware | Motor drivers, STEP/DIR/ENABLE, encoders, INDEX and switches | Display, touch and console |
| Motion execution | `MotionController`, `StepperMotor`, trajectory execution and timer/DMA scheduling | Submit planned motions |
| Robot model | Enforce axis constraints and apply configured motor/axis conversions | `Robot`, kinematics and Cartesian/joint conversions |
| Motion planning | Local homing and stopping profiles | Paths, coordinated profiles, blending and lookahead |
| State | Authoritative motor/axis positions, velocities, reference state, configuration and faults | Consume snapshots; calculate and present robot state |
| Fault handling | React immediately, stop affected motion and invalidate commands/references as required | Report faults and request recovery |
| EtherCAT (future robot integration) | ESC transport, cyclic exchange, communication watchdog and command ownership | Plan high-level robot requests when needed |

M7 runs the planner in its own worker, independently of TouchGFX rendering and
CLI processing. GUI and CLI use the same application/control services; neither
frontend owns the physical `StepperMotor` objects. Display and console activity
must not prevent the planner from meeting the trajectory queue's refill deadline.

M7's processing speed, caches and double-precision FPU suit the current
`double`-based motion calculations. Graphics acceleration can reduce rendering
work, but planner throughput must still be measured under GUI load. See the
[H747 datasheet](https://www.st.com/resource/en/datasheet/stm32h747xi.pdf) and
[TouchGFX hardware guidance](https://support.touchgfx.com/docs/development/hardware-selection/hardware-components/hardware-selection-mcu).

### Planning and execution boundary

Separate three stages:

1. **M7 planning:** calculate the path and acceleration/deceleration/jerk profile,
   then produce synchronized joint trajectory segments.
2. **M4 trajectory execution:** validate and consume the segments, track progress
   and prepare upcoming integer step timings with bounded computation.
3. **M4 pulse generation:** timers and DMA generate the STEP edges. Segment
   reception and GUI scheduling do not determine individual edge timing.

The coordinated-motion contracts describe complete bounded profiles; bridging
those contracts is pending. A later planning step is a stream of buffered trajectory segments describing
selected joints over defined intervals. Segment duration, queue capacity and
refill/braking reserves require implementation and timing validation. The M4 evaluator must preserve step-count accuracy and synchronization
while meeting the DMA refill deadlines. Expensive planning and blocking work
must stay outside interrupt handlers.

In the archived implementation, `StepperMotor` creates
profiles and blends commands, and `StepGenerator::fill()` invokes
`Sequence::generate()` to evaluate profiles while preparing DMA data. Moving
`Robot` and profile creation to M7 alone would leave profile evaluation on M4.
Extract planning from execution and benchmark the remaining evaluator explicitly.

Commands identify their affected axes. Independent axis operations remain
supported; coordinated commands explicitly group axes and use one agreed
execution timeline. A stalled segment stream for a coordinated move must trigger
the group's defined stopping behavior rather than let its axes diverge.

M4 owns motor/axis configuration, including direction, microsteps, conversions
and execution limits. M7 plans against versioned snapshots of that configuration
and the commanded execution state. Encoder/INDEX feedback retains its source and
validity information when reported to M7; planned positions do not replace
measured or estimated feedback.

### Local stopping and recovery

M4 must handle a stalled or restarted M7 without waiting for further messages:

- Execute homing locally and react directly to reference switches and driver
  faults.
- Validate reference state, axis limits, configuration and execution ownership
  before accepting motion.
- Maintain a local stopping mechanism and enough trajectory/braking reserve to
  start deceleration before an input queue runs empty. Queue exhaustion must not
  first be discovered when the next pulse is already due.
- Define when a fault requires immediate pulse inhibition or driver disable
  instead of a controlled stop. The local stop path has priority over queued work.
- Invalidate affected queued segments after a stop, fault, reset or configuration
  change. Resuming requires explicit admission of a valid command.

Completing an already accepted finite motion or stopping on loss of M7 is an
explicit execution policy. Continued operation must never depend on an unbounded
wait for the planner. Required reserve and stop behavior must be validated at the
maximum planned velocity for each axis and coordinated group.

### Shared-memory command interface

`ControllerClient` and `ControllerServer` are the intended execution boundary;
their integration with the `p2p` bridge is pending, as described above.
During H747 migration, replace `InProcessTransport` with shared-SRAM rings and HSEM notifications;
reserve memory in both linker scripts, establish cache attributes and memory
ordering, and verify reset/session coordination on both physical cores.
Shared SRAM, HSEM and a second firmware image are not implemented yet.

Use two bounded, single-producer/single-consumer queues in shared RAM:

| Queue | Payloads |
| --- | --- |
| M7 to M4 | Trajectory segments, execution commands, jog/home, configuration and status requests |
| M4 to M7 | Acceptance/rejection, completion, faults, queue capacity and versioned state/configuration snapshots |

Each controller has one communication worker that owns its outgoing queue and
consumes its incoming queue. GUI/CLI requests and IO events from other local
threads or callbacks are serialized through that worker. Hardware interrupt
handlers notify local workers rather than execute commands or become additional
producers of the shared queue.

Commands carry correlation IDs. Acceptance means a command was admitted;
completion or failure is a separate response. GUI and CLI can therefore track
asynchronous operations independently. M4 performs the authoritative state,
limit and parameter checks, regardless of validation performed by M7.

Plans identify the configuration revision and starting execution state used by
the planner, or an agreed endpoint of an already accepted queued motion. M4
rejects stale plans instead of silently executing them from a different origin.
Segment sequence numbers, axis/group identity and execution timing must be
explicit. Timing uses the M4 execution clock or an agreed conversion to it; message
arrival time does not define the motion start.

Messages contain explicitly defined data: message type, protocol version,
session/command IDs, payload length, numeric values with defined units, and
status/error codes. Specify field widths and numeric representation rather
than copying compiler-dependent object layouts. Do not send pointers, virtual
objects, `std::string`, callbacks or futures between firmware images. Each
controller may build local C++ abstractions around received messages.

The transport must provide these behaviours:

- Bound queue capacity and message size. Report backpressure explicitly; never
  silently discard commands, command results or fault events. M4 must not wait
  indefinitely for M7 to consume messages. Report the buffered execution horizon
  so M7 can refill before the local stopping reserve is reached.
- Coalesce frequent position/velocity updates into the latest status rather
  than letting telemetry exhaust capacity needed for command results.
- Give stop requests a dedicated urgent path, such as a latched shared request
  with its own notification and acknowledgement, so ordinary queue congestion
  cannot delay their delivery. IO continues to handle hardware faults and
  reference inputs locally.
- Establish a versioned startup handshake and session identity. Detect a peer
  restart, invalidate stale pending requests and do not replay motion commands
  from an earlier session. Define link-loss behaviour, including expiry of
  continuously commanded jogging, before enabling remote motion. Stops and
  recovery must also invalidate pending commands in the M7 planner/client.

### EtherCAT ownership

Assign the LAN9255 ESC SPI transport and the EtherCAT worker to M4. Cyclic joint
commands and feedback use the local motion execution interface without requiring
a round trip through M7 on every EtherCAT cycle. High-level Cartesian requests
can be forwarded to M7's `Robot`/planner and return as admitted trajectories.

M4 arbitrates control ownership between EtherCAT and local GUI/CLI requests.
Only one command source may control an axis or coordinated group at a time;
ownership changes require a defined handover and invalidate stale queued work.
Fault and stop handling remain local regardless of the active source. A missed
EtherCAT deadline or communication watchdog event invokes the configured local
stop policy. Robot-facing EtherCAT modes, PDOs and synchronization remain future
work; the standalone echo example does not implement them.

### Memory and notification rules

Reserve a dedicated shared region, initially targeting **SRAM4**, in both
linker scripts. Exclude it from private heaps, stacks and independent startup
clearing. Coordinate initialization so one core cannot erase live queues when
it boots or restarts. Configure the region as non-cacheable on M7.
Use aligned indices plus explicit inter-core memory ordering: finish writing
the payload before publishing it, and finish reading it before releasing its slot.
Neither `volatile` nor disabling interrupts on one core is sufficient for
cross-core synchronization.

Use **HSEM notifications** to wake the receiving controller's local worker.
Notifications may coalesce: the queue is the source of truth, and the receiver
drains it and uses a recheck-before-sleep protocol to avoid lost wakeups. HSEM
provides the notification; queue correctness still depends on publication and
consumption ordering. Size trajectory storage from the measured execution reserve;
SRAM4 is the initial candidate, not an assumption that every motion buffer fits
there. ST documents shared SRAM, MPU/cache handling and HSEM
notifications in [AN5617](https://www.st.com/resource/en/application_note/an5617-stm32h745755-and-stm32h747757-lines-interprocessor-communications-stmicroelectronics.pdf).

Do not share a normal ThreadX queue, semaphore or mutex between the two kernel
instances. Each firmware owns its RTOS objects; the shared transport uses a
defined inter-core protocol. Separate CPU execution does not isolate the
shared buses, clocks or peripherals, so assign resource ownership and validate
motion timing under graphics and communication load.

### Migration work and validation

The H747 provides the timer capabilities needed to retain TIM2 channels 1/3/4
for STEP, channel 2 for the internal deadline, TIM3 for quadrature feedback,
TIM5 for runtime timekeeping, TIM6 for the HAL tick and TIM7 for completion
monitoring. Assign these peripherals and their interrupts to the M4 IO core.
Give the M7 runtime its own timebase; M7 initialization must not reconfigure
IO timers or shared clocks after robot control starts. The GIGA pin map,
display-dependent pin conflicts and peripheral interrupt routing still need
their own CubeMX configuration; the Nucleo wiring tables below are not a GIGA
assignment. See the [H747 datasheet](https://www.st.com/resource/en/datasheet/stm32h747xi.pdf)
and [GIGA pinout](https://docs.arduino.cc/resources/pinouts/ABX00063-full-pinout.pdf).

Migration includes board-specific startup/clocks, core boot coordination,
memory partitioning for both images and any bootloader, DMA/MPU configuration,
SWD debugging, the UI console, storage/network adapters and updated KiCad
connections. Retain CMake/GCC, the HAL and the IO runtime; using the GIGA does
not require adopting the Arduino application framework. Integrate the M7's
TouchGFX runtime and board drivers separately.

Validate the split in this order:

1. Extract the execution interface and planning responsibilities on the current
   Nucleo. Preserve independent moves, coordinated timing, homing, blending,
   cancellation and feedback semantics with local interface tests.
2. Establish both firmware images, resource ownership, boot coordination and the
   shared-memory protocol. Test ordering, saturation, lost/coalesced notifications,
   configuration revisions and rejection of stale commands across peer restarts.
3. Benchmark M7 trajectory production under GUI/CLI load and M4 evaluation/DMA
   refill for three active axes. Establish segment format, queue capacity and
   minimum stopping reserve from measured worst-case headroom.
4. Repeat pulse-count, synchronization, feedback, homing and fault tests on the
   GIGA. Deliberately stall/reset M7 and exhaust the trajectory input; verify M4's
   stopping policy and that obsolete commands cannot resume motion.
5. Integrate EtherCAT robot control, then test cyclic deadlines, command-source
   handover, watchdog behavior and recovery under simultaneous graphics and
   communication load.

The final display, segment representation, queue sizes, update rates and memory
allocation remain implementation decisions to establish by these checks.
No GIGA hardware verification is claimed by this plan.

## KiCad hardware project

Open **[hardware/ProtoMate.kicad_pro](hardware/ProtoMate.kicad_pro)** in
**KiCad 10**. One project contains the complete system schematic and its linked
perfboard layout. Seven sheets cover controller/power, M1/DM542T, M2/M3/TMC2209,
M1 encoder, QSPI/SD storage, perfboard cable headers and reference switches. All 49 footprints
are linked to schematic symbols; external equipment is marked **Exclude from
board**. Symbols and footprints use project-local libraries. See the
[hardware guide](hardware/README.md) for the structure and F8 update workflow.

For a printable view, use [the complete schematic PDF](hardware/exports/Wiring.pdf).
[System_Parts.csv](hardware/assembly/System_Parts.csv) lists all components and
identifies whether they mount on the perfboard or externally.
`DNP` means a component is shown but is not fitted. Capacitors and
pull-ups already present on storage modules need not be duplicated, as noted
on the storage sheet. Purchased modules are represented by their external
contacts, rather than reproducing their internal circuits.

The supply arrangement is **24 V DC input**, with the user's **QIQIAZI
24/12 V-to-5 V, 5 A buck converter** generating the logic/encoder supply.
The buck’s barrel jack is the 24 V system inlet. Its VIN header pins feed
separate underside power/return branches to both TMC modules and the
DM542T terminal J104.9/10.
Connect its 5 V output to Nucleo **CN11 pin 6 (5V_EXT)** and ground to
**CN11 pin 8**; select **JP2 pins 5–6 (EXT)**. The Nucleo's 3.3 V output on
**CN8 pin 7** supplies the TMC logic, encoder buffer and storage. The board's
5V_EXT input is rated **4.75–5.25 V, 500 mA maximum**, independently of the
converter's 5 A rating. Apply external power before attaching ST-Link USB.
See [ST UM2407, sections 7.4.3 and 7.4.6](https://www.st.com/resource/en/user_manual/um2407-stm32h7-nucleo144-boards-mb1364-stmicroelectronics.pdf).
The buck symbol uses its marked input/output connections; wire colours are
not assumed.

The TMC2209 address straps are **M2: MS1/MS2 = GND/GND (address 0)** and
**M3: MS1/MS2 = 3.3 V/GND (address 1)**. Both use the shared USART2 bus;
firmware selects **1/16 microstepping** and verifies the settings before enabling
any driver. Leave both **SPRD jumpers open**. The M1 sheet documents the DM542T
DIP switches for the same resolution. All three 1.8° motors require
**3,200 STEP pulses per motor revolution**. UART current control bypasses the
Adafruit potentiometers; see [driver configuration](#tmc2209-uart-configuration-and-diagnostics).

M2's connector assignment was confirmed by the user to match M3: winding
pairs **1–4 and 3–6**, with **2 and 5 unused**. M1's motor and encoder
connections follow the drawings in `docs/` and the Oriental Motor manual.
The 2N2222A symbols deliberately identify **B/C/E**, since package lead order
depends on the actual transistor manufacturer. Encoder termination resistors
are marked DNP; select termination for the cable and the encoder's output
current limit before fitting them.

The connector assignments were checked against the firmware, ST's board
manual, the motor drawings, and
[Adafruit's published breakout schematic](https://github.com/adafruit/Adafruit-TMC2209-Breakout-PCB/blob/main/Adafruit%20TMC2209%20Stepper%20Motor%20Driver.sch).
KiCad's electrical-rules and layout checks, including schematic-to-board parity,
report no violations. Results are in [ERC.rpt](hardware/exports/ERC.rpt) and
[DRC.rpt](hardware/exports/DRC.rpt). To repeat the checks from the repository root:

```sh
python3 hardware/tools/refresh.py --check-only
```

## KiCad perfboard layout

The same project's [perfboard layout](hardware/ProtoMate.kicad_pcb)
provides a placement and hand-wiring map for the **65 × 47-hole individual-pad
board, oriented as 47 columns × 65 rows with 2.54 mm pitch** (holes A1–BM47).
The outer hole centres span 116.84 × 162.56 mm. Components are spread across the board, with separate areas for motor interfaces,
encoder circuitry and power. The ten-way DM542T screw terminal faces outward
along the top edge beside both TMC2209 modules.
J107 sits just below J104, grouping the motor-1 encoder and driver cables.
J101, J113, J102 and J108 form a Nucleo connector bank along the left edge,
with 9.1 mm between header bodies and every pin 1 at the bottom.
It contains six Diotec 2N2222A stages (three for
the DM542T and three for encoder voltage conversion), the AM26C32 encoder
receiver, SN74HC126N buffer, passive components and headers. The two Adafruit
TMC2209 modules mount directly at J105/J106 through soldered ten-pin control
headers and separate two-pin power headers. Their four-way motor terminals
remain on the modules. C1/C2 provide local bulk capacitance on the perfboard.
The Nucleo and DM542T remain external. J104 combines all DM542T connections:
1–6 = PUL+/−, DIR+/−, ENA+/−; 7/8 = ALM+/−; 9/10 = +24 V/GND. The buck mounts in the lower-left area at J103, using all four
input/output pins. Its barrel jack receives 24 V. The 63 × 27 mm body follows the supplied STEP
model; the mounting uses a nominal 5.08 mm pair pitch and 50.8 mm separation.

Hand wiring prioritizes underside routes, with insulated top crossovers through
dedicated free holes; all wire ends are soldered underneath.
The assembly guide includes the soldering order and header orientation.

Use [Assembly.pdf](hardware/exports/Assembly.pdf) for placement, top jumpers
and the mirrored solder-side view. The
[assembly instructions](hardware/assembly/README.md) include orientation,
parts, hole coordinates and the complete wire/harness tables. U3 is the user's
**SN74HC126N in a DIP-14 socket**, with 7.62 mm between rows.
The KiCad PCB file represents hand wiring on the purchased board; no
fabrication outputs are supplied.

## Storage and external wiring

Hardware startup continues without readable storage by default; file access
then fails with `ENODEV`. Full hardware conformance requires both the W25Q128 NOR module and an existing FAT SD card;
the reference SD self-test expects a card of at least 8 GiB.

For a Nucleo without peripherals, run `python3 scripts/hardware_self_test.py --bare-board`
(add `--configuration Release` for the optimized build). It runs eight runtime/HAL phases,
including UART contention and internal Ethernet loopback, and explicitly skips external
flash, SD and file-stream stress. No Ethernet cable is required.
Use `--io --bare-board` for CR/LF/CRLF serial-input tests without storage-persistence checks.

| Device signal | STM32 pin |
| --- | --- |
| W25Q128 CLK | PB2 |
| W25Q128 CS | PG6 |
| W25Q128 IO0 / DI | PD11 |
| W25Q128 IO1 / DO | PD12 |
| W25Q128 IO2 / WP | PE2 |
| W25Q128 IO3 / HOLD | PD13 |
| SD D0, D1, D2, D3 | PC8, PC9, PC10, PC11 |
| SD CLK | PC12 |
| SD CMD | PD2 |
| SD card detect, advisory | PG2 |

Use 3.3 V supplies/signals and a shared ground. The CubeMX configuration is
the pin/clock source of truth. PG2 is D49 on CN8 pin 14; CN8 pin 8 is PC11,
which is already SD D3. SD data/command pins have configured pull-ups.

The onboard **STLINK-V3 MCO must be set to HSE/5 (5 MHz)**, derived from its
25 MHz crystal. This is a persistent ST-Link setting, separate from CubeMX;
the connected board is configured accordingly. The target uses HSE bypass,
PLL1 M=1/N=192/P=2/Q=24/R=2, giving 480 MHz CPU, 240 MHz timer kernels and
the STEP counter's 10 MHz tick. See the
[clock setup procedure](docs/stepper-hardware-test.md#clock-source-configuration)
when preparing another board or changing ST-Link firmware.

`/flash` is a 12 MiB FAT volume on the 16 MiB NOR chip, with remaining capacity
reserved for LevelX reclamation. Blank media is formatted on first use; invalid
existing media is not automatically erased. `/sd` mounts the existing FAT
volume and is never automatically formatted on hardware. A 4-bit SD read CRC
failure can trigger the preserved 1-bit retry; diagnostics identify the final
bus width and error. Startup chooses `/flash`, or `/sd` if flash is unavailable,
and panics if neither mounts only when `RUNTIME_STORAGE_REQUIRED=ON`.
The virtual root is read-only; cross-volume
renames return `EXDEV`.

Successful writable-file close and filesystem metadata operations flush the
volume before returning. Explicitly close writers and check errors when
persistence matters. FAT timestamps use UTC and two-second precision.
`RUNTIME_STORAGE_ERASE_FLASH_ON_BOOT` is destructive recovery only; all shipped
presets and the hardware runner set it to `OFF`.

## Axis conversion (archived implementation)

This section describes the reference code in `backups/application/control`.
Its application wiring and CLI are archived; it is not configured by the empty main.

[`backups/application/control/AxisConversion.hpp`](backups/application/control/AxisConversion.hpp) provides
`RotaryAxisConversion` for the shoulder/elbow and `LinearAxisConversion` for Z.
They translate motor shaft coordinates into joint coordinates using
`pnm::units` angles, distances, velocities, acceleration and jerk. They contain
no hardware access or mutable motion state. `control::MotionController` owns
the motors and optional axis converters; both CLI command groups use that
same controller. `axis` operates in joint degrees/deg/s or Z mm/mm/s;
`motor` operates in shaft degrees/rpm. See the
[joint-axis CLI documentation](backups/application/cli/README.md#joint-axis-control).

Configure a positive reduction (motor revolutions per output revolution), a
direction, and a pair of reference coordinates describing the same physical
location. For Z, also supply the travel per output pulley/screw revolution:
pulley teeth times belt pitch, or screw lead. The converter applies the
reduction to that travel. `motor_reference` must equal the reference-switch
coordinate passed to `StepperMotor`; `axis_reference` is the joint angle or
height assigned to that switch. Absolute coordinates become physically valid
after successful motor referencing. Conversion itself does not mark an axis
referenced or bypass `moveAbs()` rejection.

```cpp
#include "control/AxisConversion.hpp"
using namespace pnm::units::literals;

// Illustrative values only; the robot's reductions and joint home coordinates
// are placeholders in main.cpp, separate from the examples below.
const RotaryAxisConversion shoulder{{
    .motor_revolutions_per_axis_revolution = 5.0,
    .direction = AxisDirection::OppositeToMotor,
    .motor_reference = 135_deg, // Same value as m1's constructor argument.
    .axis_reference = 10_deg,
}};
const LinearAxisConversion vertical{{
    .travel_per_output_revolution = 40_mm,
    .motor_revolutions_per_output_revolution = 2.0,
    .direction = AxisDirection::OppositeToMotor,
    .motor_reference = 135_deg,
    .axis_reference = 200_mm,
}};

// With m1/m3 already constructed, referenced and ready for motion:
auto shoulder_move = m1.moveAbs(shoulder.toMotorPosition(28_deg),
                                shoulder.toMotorSpeed(6_rpm));
auto z_move = m3.moveRel(vertical.toMotorDisplacement(5_mm),
                         vertical.toMotorSpeed(10_mm_s));
auto shoulder_position = shoulder.toAxisPosition(m1.position());
auto z_velocity = vertical.toAxisVelocity(m3.velocity());
// Observe both futures and handle StepperMotor::Result in the controller.
```

`toAxisPosition`/`toMotorPosition` apply both the scale and reference offset.
`toAxisDisplacement`/`toMotorDisplacement` convert relative distances without
offsets. Angular positions remain unwrapped across multiple revolutions.
`toAxisVelocity`/`toMotorVelocity` preserve signed motion, including direction
inversion. `toAxisSpeed`/`toMotorSpeed` convert nonnegative magnitudes for
`moveRel`, `moveAbs`, `reference` and `setVelocity`; they reject negative
speeds. A zero magnitude converts to zero, but the motor requires positive
speeds for motion. `toAxisAcceleration`/`toMotorAcceleration` and
`toAxisJerk`/`toMotorJerk` similarly convert nonnegative profile magnitudes,
without offsets or direction inversion. Move direction follows the signed displacement or target;
referencing retains the motor's fixed Forward seek direction.

The same position/velocity conversions apply to successful encoder results;
retain errors from `actualPosition()`/`actualVelocity()` and ensure encoder
polarity matches the motor coordinate. M2/M3 use coarse electrical INDEX estimates, not shaft encoders. Reduction, travel and coordinates must be finite; invalid
configuration/inputs throw `std::invalid_argument`, and arithmetic overflow
throws `std::overflow_error`. Pulse rounding stays in `StepperMotor`. Joint
limits, coupled trajectories and SCARA forward/inverse kinematics belong above
this layer. The configuration examples do not start or synchronize any motion
in the firmware. `main.cpp` installs explicit dummy mechanics through
`MotionController::configureAxis()`: 1:1 reductions, the same direction as each
motor, zero joint coordinates at the reference switches, and 40 mm of Z travel
per output revolution. Replace these placeholders in code once actual mechanics
are known. Motor-side reference coordinates come from the existing motor
configuration. There is no interactive mechanics configuration command.

The corresponding regression tests are preserved in `backups/application/control/tests`.

## SCARA kinematics (archived implementation)

This section describes the reference code in `backups/application/control`.
The current scaffold does not instantiate Robot, kinematics or CLI commands.

[`backups/application/control/ScaraKinematics.hpp`](backups/application/control/ScaraKinematics.hpp) implements
the robot's two rotary joints and vertical Z axis. It uses configured instances
with ordinary methods defined in the `.cpp`, just like the axis converters.
All calculations are independent of the HAL and motor workers.

`JointPosition` contains the shoulder angle relative to the base, the elbow
angle relative to the first arm, and upward-positive Z carriage travel.
Angles increase counterclockwise viewed from above. `CartesianPosition` is the
tool tip's XYZ in the world frame. Base translation/yaw place the robot in that
frame. The tool offset is measured from the Z attachment datum in the second
arm's frame: X forward, Y left, Z up. A negative tool Z offset places the tip
below the carriage. `tool_yaw` specifies the tool's fixed orientation relative
to that frame; it does not rotate the offset vector.

For `a = base_yaw + shoulder` and `b = a + elbow`, the forward position is:

```text
x = base.x + L1*cos(a) + (L2 + tool.x)*cos(b) - tool.y*sin(b)
y = base.y + L1*sin(a) + (L2 + tool.x)*sin(b) + tool.y*cos(b)
z = base.z + joint.z + tool.z
yaw = b + tool_yaw
```

The named parameter definitions in `docs/robot/SCARA_Robot.f3d` give
`R_Link1Length = 200 + 5 + 0 = 205 mm`,
`R_Link2Length = 200 + 50 - 26.6 = 223.4 mm`, and
`R_TCPForwardOffset = 135 mm`. These imply an effective second length of
358.4 mm for a centreline tool, including its forward offset. This is a reading
of the stored parameter expressions, not a measurement of the evaluated linked
assembly. Base/tool calibration, joint reference coordinates and actual travel
limits remain application configuration. `main.cpp` uses these nominal lengths
with zero base translation/yaw, a 135 mm forward tool offset, zero tool yaw and
no joint limits. Together with the dummy axis mechanics, these are calculation
defaults, not calibrated robot coordinates.

```cpp
#include "control/ScaraKinematics.hpp"
using namespace pnm::units::literals;

ScaraKinematics kinematics{{
    .first_arm_length = 205_mm,
    .second_arm_length = 223.4_mm,
    .tool_offset = {135_mm, 0_mm, 0_mm},
}}; // Geometry example; supply calibrated frames and mechanical limits for operation.

// Joint coordinates from the three configured AxisConversion objects:
ScaraKinematics::JointPosition current{30_deg, 60_deg, 50_mm};
auto pose = kinematics.forward(current); // Result<ToolPose>: XYZ and derived yaw.
auto target = kinematics.inverse({300_mm, 200_mm, 40_mm}, current);
if (target) {
    // Inspect target->shoulder / target->elbow / target->z without moving.
    // Robot::moveAbs combines this calculation with coordinated execution.
}
else {
    auto reason = target.error(); // Handle ScaraKinematics::Error in the controller.
}
auto tool_velocity = kinematics.forwardVelocity(current, {1_rpm, -2_rpm, 5_mm_s});
auto joint_velocity = kinematics.inverseVelocity(current, {10_mm_s, 0_mm_s, 0_mm_s});
```

- `inverse(target, reference)` preserves the reference's elbow branch and picks
  equivalent joint angles nearest its unwrapped coordinates, subject to optional
  inclusive `JointLimits`. It never silently changes branches to satisfy limits.
  An explicit third argument (`ElbowBranch::Positive` or `Negative`) selects a
  branch; this is required when the reference is singular. Selecting a different
  branch calculates an endpoint, not a safe transition path.
- With a sideways tool offset, branch/singularity calculations use the effective
  elbow-to-tip vector. Its phase is `atan2(tool.y, L2 + tool.x)` and its length is
  `hypot(L2 + tool.x, tool.y)`. The default inverse singularity threshold is
  `abs(sin(elbow + phase)) <= 1e-6`. Straight/folded workspace boundaries return
  `Singularity`; targets beyond the reachable annulus return `Unreachable`.
- `forwardVelocity` and `inverseVelocity` apply the positional Jacobian to signed
  velocities. Forward results also include derived tool yaw velocity. The robot
  has no independent yaw axis. Inverse velocity rejects singularities; speed and
  acceleration limits still need enforcement by the trajectory planner.
- Calculations return `std::expected<T, Error>` with `InvalidInput`, `Unreachable`,
  `JointLimitExceeded`, `Singularity` or `NumericOverflow`. Invalid configuration
  throws `std::invalid_argument`. Floating-point roundoff at workspace/limit
  boundaries is tolerated; unreachable points are not projected into the workspace.
- Forward feedback remains available outside joint limits and at singularities.
  Use `checkJointLimits` explicitly for state checks. Inverse position checks its
  resulting endpoint; inverse velocity checks its current joint position.
  Omitted limits mean unrestricted joint coordinates, not verified mechanical travel.

[`control::Robot`](backups/application/control/Robot.hpp) connects this geometry to the existing
`ControllerClient`. `main.cpp` constructs it with the same client
used by the motor and axis CLI modules. `Robot::status()` converts a fresh
controller snapshot into joint coordinates, tool pose and tool velocity. It
has no duplicate peripherals, worker or cached position. Conversions and motor
readings come from the same controller snapshot; individual readings are
sampled sequentially, not latched simultaneously in hardware.

The commanded state uses emitted-step positions and signed motor velocities.
The feedback state requires valid position and velocity results on all three
axes and preserves the failing axis/error if unavailable. M1 uses its shaft
encoder; M2/M3 use coarse driver INDEX estimates. A combined feedback tool pose
is therefore an estimate, not a fully measured physical pose. `axis status`
identifies each source and its availability. Unreferenced coordinates are explicitly identified,
and the generator's pulse-count validity remains visible.

`Robot::moveAbs`, `moveRel` and `moveJoints` execute synchronized, rest-to-rest
point-to-point motion. Cartesian targets are converted through IK; interpolation
is linear in joint coordinates, so the tool path can curve. Each moving axis
samples one shared acceleration/deceleration/jerk profile. The HAL arms their
prepared sequences against one timer origin, with absolute pulse times rounded
to 100 ns ticks; all moving axes emit their final step on the same tick.
Targets are rounded to the nearest microstep and checked against joint limits
again after rounding. Stationary axes hold their positions.

The default maximum joint speeds are 60 degrees/s for shoulder and elbow and
20 mm/s for Z. `MoveOptions::speed` scales those limits from greater than zero
through 1 (default 0.2). The profile also respects each motor's configured
acceleration, deceleration and jerk, plus the STEP rate limit. A move has a
10 ms setup lead, 5 microsecond high pulses and an optional overall timeout.
Very slow schedules exceeding the timer's roughly 53.68 s per-pulse horizon
are rejected. No straight Cartesian interpolation, collision checking, robot
command buffering or live robot speed override is implemented.

The controller reserves all three axes for a robot operation, rejects conflicting
motor/axis commands and releases ownership after completion or cancellation.
All axes must be idle and referenced before a robot move. Stopping any axis
stops the entire robot operation; a reference-switch activation while moving
towards it also stops the group. `Robot::reference()` homes Z, shoulder and elbow
in that order, using the existing seek/backoff/slow-latch sequence at 5/0.5 motor
RPM and a default 90 s overall timeout. Disabling drivers invalidates references.
Operations return an ID and a shared completion future; the UI client keeps
the most recent 32 robot results separately from individual-axis commands.
IO completion callbacks run after required motion cleanup and wake its worker;
terminal results then cross the bridge.

The [robot CLI](backups/application/cli/README.md#robot-control) exposes these operations,
live state and read-only calculations:

```text
robot status
robot geometry
robot fk 30 60 50
robot ik 300 200 40 --branch positive
robot enable
robot home
robot jobs
```

FK inputs are shoulder/elbow degrees and Z millimetres. IK takes world XYZ in
millimetres and uses the current commanded joints as its seed. The default
branch is `current`; `positive` and `negative` select a branch explicitly.
FK/IK calculations start no motion. `robot moveto` and `robot move` execute
absolute and relative XYZ targets; `robot joints` executes a joint target.
`--speed` is a percentage of the joint speed limits (default 20), rather than
a Cartesian feed rate. `robot stop` cancels motion while keeping drivers enabled.
The geometry layer installs no callbacks and does not replace motor accounting.

The `application.control` tests cover analytic poses, both elbow branches,
multi-turn continuity, frame/tool offsets, workspace and joint-limit boundaries,
singularities, velocity finite differences, composition with the axis
converters, live robot state, missing/faulted feedback, coordinated profiles,
homing, command ownership, switch activation, cancellation and timeout handling.
CLI tests cover annotated commands, coordinate calculations, simulated robot
execution and shared controller state. Timer-model tests check the common start
origin, rollover, exact pulse accounting and partial arming failures.
Background on velocity singularities is available in
[Modern Robotics, section 5.3](https://modernrobotics.northwestern.edu/nu-gm-book-resource/5-3-singularities/).

## Stepper GPIO assignment

The following seven outputs on the **NUCLEO-H753ZI (MB1364)** control
one STEPPERONLINE DM542T driver with an Oriental Motor PKP245D23A2-R2FL
motor (M1) and two Adafruit TMC2209 #6121 boards (M2/M3).
CubeMX configures the STEP pins as **TIM2 output-compare outputs**, with
three independent DMA streams. The counter runs at **10 MHz (100 ns/tick)**.
The DIR pins and shared enable are ordinary push-pull GPIO outputs. All seven
use low GPIO speed (output slew rate, not pulse frequency); STEP additionally
uses internal pull-downs. The current application main is empty; the
[archived composition](backups/application/main.cpp) provides the previous motor
and controller setup as reference. Dedicated hardware test images retain their
own setup and commands.

| Signal | STM32 pin | Board connector | Driver connection | Function |
| --- | --- | --- | --- | --- |
| M1_STEP | PA0 | CN10 pin 29 / D32 | DM542T PUL− through Q1 below | TIM2_CH1 / AF1 |
| M1_DIR | PE12 | CN10 pin 26 / D39 | DM542T DIR− through Q2 below | GPIO |
| M2_STEP | PB10 | CN10 pin 32 / D36 | First TMC2209 STEP | TIM2_CH3 / AF1 |
| M2_DIR | PE13 | CN10 pin 10 / D3 | First TMC2209 DIR | GPIO |
| M3_STEP | PB11 | CN10 pin 34 / D35 | Second TMC2209 STEP | TIM2_CH4 / AF1 |
| M3_DIR | PE14 | CN10 pin 8 / D4 | Second TMC2209 DIR | GPIO |
| STEPPERS_EN_N | PE15 | CN10 pin 30 / D37 | Both TMC2209 EN; DM542T ENA− through Q3 | GPIO |

Connector positions follow [ST UM2407, table 21](https://www.st.com/resource/en/user_manual/um2407-stm32h7-nucleo144-boards-mb1364-stmicroelectronics.pdf).
PA0 reaches CN10.29 through **SB75 ON**. Keep the user button on PC13
(SB58 OFF). TIM2_CH2 has no external pin; PB3 remains available for SWO.
The [STM32H753 alternate-function tables](https://www.st.com/resource/en/datasheet/stm32h753zi.pdf)
confirm all three STEP routes as AF1. Existing signal-conditioning components
and perfboard nets are unchanged; use the revised J101 harness destinations.

| Timer / DMA resource | Purpose |
| --- | --- |
| TIM2_CH1 / DMA1 stream 0 | M1 edge timestamps |
| TIM2_CH3 / DMA1 stream 1 | M2 edge timestamps |
| TIM2_CH4 / DMA1 stream 2 | M3 edge timestamps |
| TIM2_CH2 / DMA1 stream 3 | Internal deadline: DMA writes CR1=0 to stop the counter |
| TIM5 | 32-bit runtime clock, moved from TIM2; `hal::timer::create({ .peripheral = hal::timer::Peripheral::Tim5 })` |
| TIM6 | HAL timebase |
| TIM7 | Internal 1 ms finite-completion monitor; no output pin |
| TIM3, PB4/PB5 | Existing M1 quadrature encoder |
| TIM1, PE9/PE11 | Reserved for a future M2 encoder; not configured or connected |
| TIM8, PC6/PC7 | Reserved for a future M3 encoder; not configured or connected |
| TIM4 | Available |

### Hardware step generator and encoder HAL

The HAL interfaces below remain active. `StepperMotor` examples refer to the
[archived motor implementation](backups/application/control/StepperMotor.hpp),
which the STEP bench still uses; they do not run in the empty application.

[IStepGenerator / IStepOutput](platform/hal/drivers/itf/IStepGenerator.hpp)
replace ordinary PWM for the robot's STEP signals. Output compare toggles a
pin at each queued rising/falling timestamp. Every axis has its own timestamps,
so sharing TIM2 **does not force a shared speed or pulse count**. DMA updates
CCRx after each edge, with compare preload disabled. The CPU does not rearm
individual pulses; it fills the inactive DMA buffer while the other runs.
See the local [RM0433](docs/board/rm0433-stm32h742-stm32h743753-and-stm32h750-value-line-advanced-armbased-32bit-mcus-stmicroelectronics.pdf),
§39.3.8 (output compare), §39.4 (timer registers), and its DMA/DMAMUX chapters.

Create one generator with `hal::board::create_stepper_generator()`, then obtain
axes with `hal::board::create_stepper_step_output(generator, MotorId::Motor1/Motor2/Motor3)`.
Views retain the shared generator. A second generator cannot claim its pins
until the first generator and all its views are released.

- `generator->start()` starts only the shared timebase. Call it once outside
  the motors; repeated calls while running do not reset it or start any axis.
- `axis->prepare({period, high_time}, count)` prepares exactly `count` pulses;
  omit `count` for continuous counted operation. Zero count is rejected.
  Only the selected axis must be stopped; other axes can keep moving.
- `axis->prepareSequence(timings)` copies one timing per pulse for a planned
  acceleration/deceleration profile. Each period starts at that pulse's rising
  edge. The controller calculates the profile.
- `axis->start(delay)` starts only that axis on the running timebase. The default
  delay is 1 ms; very short delays can return `timed_out` if setup consumes the
  scheduling margin. Each successful start resets only that axis's run count.
- `generator->startPrepared({delay1, delay2, delay3})` arms selected, already
  prepared axes against one common timer origin. `std::nullopt` leaves that
  axis untouched. Initial buffers are generated before sampling the origin;
  an arming failure stops all selected axes and retains any emitted counts.
  Robot motion uses different first-pulse delays to sample one shared profile.
- `axis->updateTiming({period, high_time})` changes an active uniform train
  without restarting it. It returns the **first affected pulse number (1-based)**.
  Already buffered edges and the requested finite pulse count remain unchanged.
  A later update can replace a pending update before another buffer is filled.
- `axis->stop()` immediately aborts only that axis and drives its STEP low.
  It can shorten the final high phase. Its count survives the stop.
  `axis->clear()` discards a stopped axis's prepared motion.
- `axis->status()` reports its state, pulse count and count validity;
  `axis->pulseCount()` reports commanded rising edges, including an in-flight
  high phase or compare awaiting its DMA write. This is not encoder position.
- `generator->status()` reports the timebase state, all axis states and counts.
  **The generator stays `Running` when individual axes complete or stop.**
- `generator->stop()` shuts down the timebase and all axes. A DMA error or
  refill underrun also stops the group and latches a fault. Recover explicitly
  with `stop()` then `start()`; axes still need explicit starts afterward.

The application API follows this ownership pattern (the controller also installs
the shared shutdown callbacks and manages enable):

```cpp
using namespace pnm::units::literals;
using enum hal::board::MotorId;
auto generator = hal::board::create_stepper_generator();
if (!generator) throw std::runtime_error("step generator unavailable");
auto enable = hal::board::create_steppers_enable_output();
auto drivers = hal::board::create_stepper_drivers({16U, 16U, 16U}, enable);
StepperMotor m1{Motor1, 135_deg, 1.8_deg, 16U, generator, drivers[0]};
StepperMotor m2{Motor2, 135_deg, 1.8_deg, 16U, generator, drivers[1]};
StepperMotor m3{Motor3, 135_deg, 1.8_deg, 16U, generator, drivers[2]};
for (auto& driver : drivers)
    if (!driver || !driver->initialize()) throw std::runtime_error("driver unavailable");
if (!generator->start()) throw std::runtime_error("step timebase failed");

// After the controller enables the drivers and observes their settling time:
auto motion1 = m1.moveRel(90_deg, 300_rpm);
auto motion2 = m2.moveRel(10_rev, 150_rpm, 720_deg_s2, 1080_deg_s2, 7200_deg_s3);
// Once m2 is running, a velocity change returns its first affected pulse:
auto changed_at = m2.setVelocity(300_rpm); // Check the Result for rejection.
m1.stop();                              // m2 continues.
m2.stopAndWait();
auto result1 = motion1.get();
auto result2 = motion2.get();
```

`moveRel()` and `moveAbs()` accept `(position, velocity, acceleration,
deceleration, jerk, buffer_mode, timeout)`. They return one future per command.
Acceleration/deceleration use `pnm::units::AngularAcceleration` (`deg_s2`,
`rad_s2`); jerk uses `AngularJerk` (`deg_s3`, `rad_s3`). Pneumo also provides
linear `Jerk` (`mm_s3`, `m_s3`) and the corresponding time-based arithmetic.
The three dynamics arguments default to zero, meaning **use the configured
axis default**, not an instantaneous ramp. `setMotionDefaults()` configures
positive acceleration/deceleration and nonnegative jerk while idle. Initial
software defaults are 3600 °/s² acceleration/deceleration and 36000 °/s³ jerk;
these must be tuned to the actual mechanics. A configured jerk of zero selects
a trapezoidal profile. Positive jerk produces a continuous-acceleration S-curve.
Short moves automatically reduce their peak speed to fit the available distance.
Negative/nonfinite dynamics are rejected. The existing `(position, velocity,
timeout)` overload remains available.

`BufferMode` uses the following names (the equivalent PLC names have an `MC_`
prefix). There is room for one active command and one queued successor:

| Mode | Behavior when the axis is already moving |
| --- | --- |
| `Aborting` (default) | Immediately stop/join the current worker, cancel its queued successor, then start the new command from rest. |
| `Buffered` | Complete the previous move at rest, then start the successor. |
| `BlendingLow` | Request the lower of the two commanded speeds at their junction. |
| `BlendingPrevious` | Request the previous command's speed at the junction. |
| `BlendingNext` | Request the successor's speed at the junction. |
| `BlendingHigh` | Request the higher of the two commanded speeds at the junction. |

Blending joins same-direction commands within one hardware pulse stream.
Velocity and acceleration are continuous at the replanned boundary. The planner
reduces an infeasible junction speed; if the tail is already committed or no
suitable splice fits, the successor executes from rest. A direction reversal
always comes to rest. Submit successors early, before their predecessor's final
DMA buffers are filled. Relative successors are relative to the predecessor's
endpoint; absolute targets remain absolute. A second queued command returns
`Rejected` and leaves accepted commands intact. A new `Aborting` command,
`stop()`, switch activation toward the switch, timeout or fault cancels queued
work. These abort paths remain **immediate stops**, not deceleration ramps.
There is no coupled-slave axis mode in this API.

```cpp
auto first = m2.moveRel(-360_deg, 120_rpm, 1440_deg_s2, 2160_deg_s2, 14400_deg_s3);
auto next = m2.moveRel(-180_deg, 60_rpm, 1440_deg_s2, 2160_deg_s2, 14400_deg_s3,
                       StepperMotor::BufferMode::BlendingLow);
// Each future belongs to a separate submitted command; inspect both results.
```

Finite moves round to the nearest microstep. `position()` tracks signed
commanded pulses from a software zero. Per-axis progress callbacks update
`m_position` and `m_velocity`, including the final stop/completion; both getters
refresh hardware progress and return those atomic fields. `velocity()` uses the
timer-rounded interval following the latest emitted pulse and is zero before
the first pulse and after stopping. It is a discrete STEP-rate measurement,
not an exact sample of the continuous mathematical velocity.
`moveAbs()` is rejected until `isReferenced()` is true, including zero-distance
requests. Velocity arguments are positive magnitudes. Zero timeout means no
deadline; a buffered command's timeout starts when it becomes active.

`setVelocity()` asks the motion worker to replan the uncommitted tail using the
active acceleration/deceleration/jerk settings and returns the first affected
pulse number. It preserves the finite endpoint and any accepted blend endpoint;
it returns an error when the change cannot fit. This is a thread-context call,
which waits for planning to finish. It requires an active, started motion with
unbuffered pulses; calling immediately after asynchronous submission can precede
startup and be rejected. Already committed pulses remain unchanged. Following-
error handling remains future controller work. `control::MotionController`
owns shared driver enable, enforces the 200 ms settling delay before accepting
motion, and tracks bounded asynchronous command results for all clients.

The planner stores a bounded number of analytic phases, not an entry for every
pulse. The HAL accepts an immutable `hal::step::Sequence`, evaluates its timing
while refilling DMA, and supports `scheduleCursor()` / `replaceSequence()` to
replace an uncommitted tail. A cursor is revision-checked: a refill, replacement
or restart invalidates stale cursors. Providers must be allocation-free,
nonblocking and bounded in ISR context. Invalid timing stops the generator;
retired providers are released by the calling thread after the HAL unlocks.

`StepperMotor` takes the reference-switch coordinate as its second constructor
argument: `StepperMotor{Motor1, 135_deg, 1.8_deg, 16U, generator, driver}`. The archived
`main.cpp` configures 135° for each motor. Calling `reference()` performs a
switch reference sequence; it does not enable the drivers or start the shared
generator. Defaults are 5 rpm for seeking/backing off, 0.5 rpm for the second
approach, and a 30 s overall timeout. Both speeds must be positive and the second
must be slower; the timeout must be finite and greater than zero.

```cpp
auto homing = m1.reference(5_rpm, 0.5_rpm, 30_s);
if (homing.get() == StepperMotor::Result::Completed) {
    auto motion = m1.moveAbs(90_deg, 10_rpm); // Choose a target away from the switch.
    auto result = motion.get();
}
```

The sequence approaches Forward until activation, backs off Backward until
release, then approaches Forward at the second speed until activation again.
An initially active switch starts with backoff. Every contact/release stops the
axis immediately when the worker handles the event, then requires 10 ms of
stable switch level before advancing. Bounce wakes the worker and restarts that
settling interval. The timeout covers all phases, including settling; a missing
activation or release cannot leave an endless seek running.

Only successful completion sets `m_position` and the encoder coordinate to
`m_referenceSwitchPosition` and marks the axis referenced. The encoder continues
counting; a synchronized coordinate offset preserves the origin through later
callbacks without resetting the raw count or creating an artificial velocity
jump. The origin is assigned at the stopped, confirmed second contact, so the
reference accuracy includes switch repeatability and worker stopping latency.
M2/M3 rebase their coarse INDEX coordinates at the same reference position;
an input with no observed INDEX transition remains unavailable. Starting a valid reference
attempt clears the old referenced flag; timeout, cancellation or failure leaves
it clear. `stop()`/`stopAndWait()` cancel any phase, and replacing the command
stops/joins its worker. `setVelocity()` is rejected during referencing so its
configured seek speeds are preserved. Other axes continue independently.

Motion workers block on an event until their axis completes/stops/faults, a stop
request or reference-switch activation arrives, or the deadline expires. They do not poll every millisecond.
Each motor owns its axis progress subscription and a pre-created
`runtime::Notification`. The callback accounts new pulses and executed timing;
a terminal state or a reached blend boundary signals the event. Queued commands
and velocity-change requests also wake the worker. The worker stops the output when needed,
checks the final status and resolves its future in thread context. Accounting is
performed once in the callback, including the final count captured by `stop()`.
Signals arriving before a wait are retained, and repeated signals coalesce.
Cancellation and the reference-input callback also signal the event. A replacement joins the old worker before
clearing old notifications and starting its next motion. Completion notification
still uses the existing DMA/TIM7 service; STEP timing is unchanged. Progress is
batched at those service points, not an interrupt for every pulse. The fields
therefore update autonomously between reads at service cadence, and getters
refresh them to the sampled hardware count. They describe commanded motion,
not measured encoder position or rotor speed. If a DMA fault makes counts
uncertain, position retains its last exact value and the reference is invalidated.

`StepperMotor` receives one
[`hal::device::IMotorFeedback`](platform/hal/devices/itf/IMotorFeedback.hpp).
The board factory `hal::board::create_motor_feedback(id, {full_step_angle, microsteps})`
selects `QuadratureEncoderFeedback` for M1 and `IndexFeedback` for M2/M3.
Both implementations live in `hal/devices/impl`; the raw timer-backed
`IQuadratureEncoder` remains in `hal/drivers`. Providers convert their inputs
into motor-shaft angle, signed angular velocity and validity. Gearing and joint
coordinates remain the responsibility of `AxisConversion`.

`MotionController` creates each provider through the board factory and injects
it as the seventh `StepperMotor` constructor argument, after the required driver.
Omitting feedback uses that same factory. Providers are created stopped; the motor
subscribes and starts observation, supplies STEP direction/timing hints and asks
the provider to rebase after homing. One common callback updates the motor's
measured state; the motor contains no encoder/INDEX conversion branches.
Callbacks may run in interrupt context and must be short, nonblocking and avoid
calling back into the provider. Clearing the callback synchronizes with in-flight
publications; motor destruction stops observation and disconnects it.

`StepperMotor::actualPosition()` and `actualVelocity()` return feedback
as `pnm::Result<Angle>` / `pnm::Result<AngularVelocity>`. M1 uses the board's
1,600 counts/revolution (0.225°/count), independently of its microstep setting.
The HAL invokes a sample callback every 10 ms, including while the shaft is
stationary. That callback updates `m_actualPosition` and `m_actualVelocity`;
getters read these atomic fields without polling hardware. Velocity is signed
count displacement divided by the actual monotonic sample interval. It is a
window average, with about 3.75 rpm per count at a 10 ms interval and the current
steady clock's 1 ms timestamp resolution. Slow rotation can therefore alternate
between zero and nonzero speed samples; this is unfiltered encoder quantization.

Counting continues when STEP is stopped, so manual shaft movement and coasting
are measured. Position starts at zero when the motor object is constructed;
a successful `reference()` anchors its coordinate to the configured switch
position. Its sign follows the A/B wiring, independently of commanded direction.
No encoder-index reset, closed-loop position correction or stall response is applied.
M2/M3 use the [callback-based driver INDEX provider](#callback-based-driver-index-feedback)
without substituting commanded steps for missing feedback. A latched shaft-encoder
count error makes both measured getters report `state_not_recoverable` and
invalidates the referenced flag.
Destruction disconnects the subscription and stops encoder counting.

`runtime/synchronization/Notification.hpp` is built by
`runtime::synchronization`. Shared ThreadX helpers live in `runtime/threadx/`;
the synchronization component has no dependency on `libstdcxx` implementation
headers. The umbrella `runtime::runtime` target links these components together.

`runtime::Notification::signal()` supports ISR and interrupt-masked callers.
On STM32 it preserves the caller's interrupt mask and defers any required
context switch until interrupts can run. Standard condition-variable or
semaphore methods in this runtime must not be called from an ISR. Notification
creation, destruction and waiting require thread context, with no producer or
waiter remaining when the object is destroyed.

Timing uses nanoseconds, rounded up to 100 ns ticks. Both high and low phases
must be at least **5 µs**, giving a configured ceiling of 100,000 steps/s per
axis; periods up to **53.6870911 s** are representable. These are software
limits, not measured electrical performance. DIR setup/hold and the DM542T's
200 ms enable delay remain the controller's responsibility. The generator does
not change DIR/enable or implement reference-switch stopping.

Each axis has two buffers of up to 512 edge timestamps (256 pulses each).
A live timing update therefore has up to **512 pulses of lookahead**: roughly
5.12 ms at 100 kHz, or 512 ms at 1 kHz. It changes the high time of the returned
pulse and its following rising-edge interval. The motor planner uses the immutable sequence API for ramps and blending.
Its first pulse includes the time to accelerate through one microstep, plus a
10 ms arming margin. Profile periods are quantized to timer ticks.

Very slow profiles use smaller blocks so the queued horizon stays below a
quarter counter cycle. Buffer length stays fixed during a motion. Live updates
must also fit that horizon: with full 512-edge blocks, periods above
**209.7151 ms** are rejected (about 4.77 steps/s minimum). More extreme slowdowns
require a new motion or a prepared sequence. Updates are rejected once all
finite pulses are buffered. `updateTiming()` accepts uniform trains only; analytic
profiles use a revision-checked replacement sequence. Very small
blocks chosen for an initially slow move increase refill interrupt load when
accelerated; use a prepared sequence spanning the intended speed range for
large changes.

The counter uses `ARR=0xFFFFFFFE`; `CCR=0xFFFFFFFF`
parks a completed axis without a future output transition. Overflow may still
raise a compare flag for this value, so completion, DMA progress and wrap
handling are checked together. Finite completion includes the last full high
phase and does not depend on an interrupt arriving in time to prevent pulse N+1.

TIM2_CH2 provides an independent hardware deadline. It stops the counter if a
buffer is not replenished before its validated schedule ends. A late interrupt
cannot silently restart the timer or replay the old buffer. At an underrun,
another axis may be frozen high until the handler drives the pins low; no new
STEP edges are generated after the counter stops. The active motions are then
reported as failed. Each finite axis parks after its final falling edge while
TIM2 and other axes continue. TIM7 checks completion every 1 ms while a finite
tail is buffered; it never schedules STEP edges. The terminal guard includes
2 ms for completion service. Excessively delayed service still faults the group,
even if the last requested pulse has already finished. DMA errors also abort
the group; neither mechanism replaces an external emergency stop.

On STM32, `hal::panic()`, `Error_Handler()` and the Cortex NMI/fault handlers
stop TIM2, drive all STEP pins low and drive `STEPPERS_EN_N` high before panic
reporting. This terminal path uses direct registers without locks, allocation
or interrupt service, including before normal GPIO initialization. Custom panic
reporting hooks run after shutdown. A fault may truncate a pulse and invalidate
position; disabling the drivers also removes holding torque.

DMA1 streams 0–3 are exclusive to this engine. The 12,320-byte DMA allocation
is in `.StepDmaSection` at **0x30000000**, covered by a dedicated **16 KiB,
non-cacheable, execute-never MPU region**. Buffers are not in DTCM. CPU buffer
writes are published before extending the deadline. DMA and TIM7 interrupts use priority 5. DMA interrupts occur at buffer
half/completion boundaries, not once per pulse.

`generator->setProgressCallback()` supplies **batched cumulative progress/completion**.
It deliberately does not promise one callback per physical step: delayed
interrupts can combine progress. Position comes from hardware/DMA progress,
not from counting callbacks. A STEP-pad phase check distinguishes a pending DMA
write from a missed compare timestamp, so elapsed time cannot invent a pulse. Callbacks run in a DMA/TIM7 ISR or a caller that services the generator
(including status queries and motion operations);
keep them short, nonblocking, allocation-free, and do not mutate/destroy the
generator. Read-only queries are allowed. Register/clear callbacks while stopped.

`axis->setProgressCallback()` observes one axis independently. It receives a
synchronous start event with zero pulses, then batched progress and a final
completion/stop/fault event. `AxisStatus::period` describes the timing of the
latest emitted pulse, including queued timing changes and per-pulse sequences;
it is zero before the first pulse and after stopping. One view owns each axis's
progress subscription. Register while that axis is stopped; clearing or view
destruction synchronizes with dispatch. This callback runs before the axis's
completion callback and follows the same ISR restrictions.

`axis->setCompletionCallback()` is a separate, once-per-motion notification
for completion, stop or fault. It sends no pulse-progress or start events, and
coexists with the generator's progress callback. One output view owns the
subscription for an axis; another view cannot replace it. Register while that
axis is stopped (other axes may run); clearing and view destruction synchronize
with dispatch and release the capture. Clear it before destroying captured data.
The same ISR restrictions apply; an interrupt-safe notification is appropriate.

The Linux backend advances a logical timer/DMA simulation from a background
ThreadX worker as well as synchronous queries. Blocked motor workers therefore
receive completion events without polling. Shutdown joins the simulation worker
before releasing hardware or callback captures. Its generator lock uses the
ThreadX C API so callbacks can safely wake application threads across the
native-HAL/runtime ABI boundary. It does not generate electrical signals or
promise real-time host scheduling. The deterministic test model additionally permits
withholding interrupts or DMA transfers to exercise failure behavior.

With GCC 16 and GoogleTest installed, run the scheduler tests independently:

```sh
cmake -S platform/hal/tests/step_model -B /tmp/protomate-step-tests
cmake --build /tmp/protomate-step-tests
ctest --test-dir /tmp/protomate-step-tests --output-on-failure
```

The suite compiles the actual STM32 register adapter against a host peripheral
model in addition to testing the common scheduler. Tests cover staggered
starts, independent stop/restart, live timing changes, finite and continuous trains,
acceleration sequences, buffer boundaries, delayed/missed interrupts, pending
DMA, wrap, abort, restart, callbacks and errors. Before operating motors, measure
all three outputs together with a logic analyzer under Ethernet/storage load,
including final pulse width, refill deadlines and stop behavior. Host models and
a firmware build do not establish DMA bus latency or transistor switching time.

For physical measurements, build the dedicated `step-test-stm32` preset.
It provides a serial menu for finite trains, independent rates, 100 kHz on
three axes, acceleration, abort, delayed interrupts, autonomous underrun stop,
independent starts/stops/live speed changes, and counter-wrap tests. Command `c` compares TIM2 against the independent
RTC crystal over three ten-second windows, with STEP held low; only UART is
needed. See the
[hardware test procedure](docs/stepper-hardware-test.md) for flashing,
analyzer connections, expected pulse counts and acceptance criteria.
The [clock and waveform measurements](docs/measurements/2026-10-03-step-generator/README.md)
document the crystal-clock configuration, three-channel logic-analyzer
captures, two-channel Hantek captures, RTC comparisons and exported figures. See the report for
measured accuracy, uncertainty and the scope of physical validation.

[IPwmOutput](platform/hal/drivers/itf/IPwmOutput.hpp) remains the general-purpose
PWM interface. Its legacy counted one-pulse mode has interrupt-rearming gaps
and is **not used by the step generator**. Generic PWM lazily initializes its
leased peripheral, so TIM1/TIM4/TIM8 are no longer boot-time motor resources.
The existing standalone `platform/hal/tests/pwm_model` tests cover that interface.

[IQuadratureEncoder](platform/hal/drivers/itf/IQuadratureEncoder.hpp) provides
`start()`, `stop()`, `isRunning()`, `position()`, `setPosition(count)` and
`reset()`. Position is a signed 64-bit count of x4 encoder edges, not motor
steps or revolutions. Start/stop preserve position; changing the origin requires
the encoder to be stopped. `position()` returns a `util::Result<Count>` so a
latched count-extension error cannot silently become a valid position. Reset
or `setPosition()` clears that error while stopped. With M1's 400 P/R encoder,
one shaft revolution corresponds to 1600 counts.
`setSampleCallback()` installs one subscriber and immediately reports the current
sample; `clearSampleCallback()` disconnects it and waits for any callback in
progress. Samples contain the count result, monotonic timestamp and running
state. Start/stop also publish samples. While running, the STM32 backend uses
the existing TIM6 HAL timebase interrupt to schedule samples every 10 ms,
coalescing delayed service. Callbacks must be short and nonblocking and must not
call encoder methods. TIM3 still counts edges and handles count extension;
there is no interrupt per encoder edge and STEP timing does not use this callback.

TIM6 uses interrupt priority **14**, above ThreadX's lowest-priority PendSV
handler (15). ThreadX waits for work inside PendSV while idle; giving TIM6
priority 15 starves the HAL tick and encoder sampling while application threads
sleep. CubeMX's TIM6 priority and `TICK_INT_PRIORITY` must both remain 14.
A compile-time assertion and regeneration guards protect this setting;
`platform.timebase_priority_guard` tests valid and regressed configurations
using disposable copies. The correction was established by Debug and Release
bare-board hardware tests in the NUCLEO-H753ZI template with the same runtime.

Use `hal::board::create_stepper_step_output(generator, MotorId::Motor1/Motor2/Motor3)`,
`hal::board::create_stepper_direction_output(MotorId::Motor1/Motor2/Motor3)` and
`hal::board::create_steppers_enable_output()` for the assigned motor outputs;
`hal::board::create_encoder(MotorId::Motor1)` creates the encoder. DIR and ENABLE
return `IDigitalOutput`: directions start low, and the single shared active-low
enable starts high (disabled). Writing enable low enables all three drivers;
writing it high disables them. The GPIO and encoder factories return exclusive, uncached
objects; repeated creation while an object is owned fails. Axis views share the
one exclusively owned step generator.
Low-level `hal::pwm::create()` and `hal::encoder::create()`
validate the supported timer/channel/pin routes. Each PWM/encoder object reserves
the whole timer and its GPIOs until destruction; unsuccessful creation releases
partial claims. The index factory returns the existing `IDigitalInput` type.
It does not reset the encoder or implement homing policy.

The Linux backend models PWM configuration and run state without generating
electrical edges or advancing with wall-clock time.
`hal::PwmOutput::advanceSimulatedPulses(count)` injects complete counted pulses;
`beginSimulatedPulse()` and `finishSimulatedPulse()` allow tests to stop during
a high phase. Callbacks run synchronously on the injecting thread. Injections
while stopped or in uncounted PWM mode are ignored. Its
`hal::QuadratureEncoder::advanceSimulatedCounts(delta)`
injects signed x4 counts, using the same count-extension arithmetic as STM32;
movement injected while stopped is ignored. A background service delivers the
same timed sample callbacks. `hal::encoder::simulated_encoder(hal::timer::Peripheral::Tim3)` accesses the
already owned encoder for motion injection in tests. A/B GPIO levels are not decoded
by this simulation. Index edges can be injected through the existing Linux
`GpioInput::setSimulatedLevel()` test interface. Simulation is not a measurement
of pulse shape, driver delays or hardware interrupt latency.

These assignments are configured in `external/CubeMX/CubeMX.ioc`.
The storage assignments above, Ethernet RMII, USART3 console,
LEDs (PB0/PE1/PB14), user button (PC13), oscillator and ST-Link debug pins stay
reserved. TIM5 supplies the runtime clock and TIM6 the HAL timebase.
TIM3 handles M1's encoder independently of the shared TIM2 STEP scheduler.

### Reference limit switches

Three Creality Ender-3 V2 mechanical switches provide one reference input per
motor. The following pins are free of the existing motor, encoder, storage and
on-board peripheral assignments. Their EXTI lines 7, 8 and 10 are distinct from
the encoder index (6) and user button (13).

| Signal | STM32 pin | Board connector | CubeMX configuration |
| --- | --- | --- | --- |
| M1_REF | PE7 | CN10 pin 20 / D41 (also CN12 pin 44) | EXTI7, rising/falling, pull-up |
| M2_REF | PE8 | CN10 pin 18 / D42 (also CN12 pin 40) | EXTI8, rising/falling, pull-up |
| M3_REF | PE10 | CN10 pin 24 / D40 (also CN12 pin 47) | EXTI10, rising/falling, pull-up |

Use **CN10 pin 22 for ground**. Connector positions follow
[ST UM2407, tables 21 and 22](https://www.st.com/resource/en/user_manual/um2407-stm32h7-nucleo144-boards-mb1364-stmicroelectronics.pdf).
EXTI9_5 and EXTI15_10 use priority 5 and the HAL's existing shared dispatchers.
These are digital inputs; no timer or alternate function is used.

Wire each switch's **COM and normally closed (NC) contacts between its REF
input and ground**; either contact orientation works. The pull-up is to the
Nucleo's **3.3 V**: released/closed reads `Low`, pressed/open reads `High`, and
a disconnected cable also reads `High`. The unused switch contact stays open.
The KiCad perfboard routes these signals through **J108** (Nucleo cable,
pins 1/2/3 = M1/M2/M3, pin 4 = shared GND) and **J109/J110/J111**
(M1/M2/M3 switch cables, each pin 1 = REF, pin 2 = GND). Follow the
[harness table](hardware/assembly/Harness.csv) for cable endpoints.
The pictured board appears to have no LED, resistors or other electronics
populated, so this connection uses it as an **unpowered dry-contact switch**.
Do not connect a supply to its connector based on the `V/G/S` printing alone.
Before connecting it, use a continuity meter on the disconnected board to
identify the pair that is closed when released and opens when pressed; the
photo alone does not establish the connector contact mapping. No 5 V supply,
transistor or optocoupler is needed for this dry-contact connection.

`hal::board::create_reference_limit_switch(MotorId)` returns an exclusive
`IDigitalInput` for each motor. `StepperMotor` claims it during construction. Its direction
convention is **Forward toward the reference switch; Backward away**. A HIGH
input rejects toward moves with `Rejected`; away moves remain allowed. A zero
distance relative move requires no pulses and completes even with an active switch;
an absolute move additionally requires successful referencing.

A LOW-to-HIGH activation during a toward move latches a stop request and wakes
the worker, which stops that axis and returns `Stopped`. The interrupt callback
uses a lock-free flag and an ISR-safe notification; it never locks a thread mutex
or calls `StepperMotor::stop()`. Release does not stop a move or clear a pending
activation. Activations during retreat also leave retreat running. Each new move
clears the previous trip before checking the physical level; checks around
preparation/arming and the retained event prevent a brief activation being lost.
Stopping takes effect when the worker runs, so additional pulses can occur
during scheduling latency. This is not a hardware emergency stop.

The first activation is acted on without a debounce delay; contact bounce cannot
cancel an already requested stop. `reference()` additionally confirms each stopped
contact/release with a 10 ms stable-level interval. Electrical input noise filtering
remains hardware work. Route each signal with its ground return away from
motor wiring. For longer cables, add a stronger external pull-up to **3.3 V**
and input filtering as needed.

### Callback-based driver INDEX feedback

The board's `create_motor_feedback()` wraps the M2/M3 INDEX GPIOs in
`hal::device::IndexFeedback`. Each motor receives its provider through
`IMotorFeedback`; callbacks update `m_actualPosition` and `m_actualVelocity`.
M1 receives `QuadratureEncoderFeedback` over its TIM3 shaft encoder.
`feedbackSource()` and `feedbackResolution()` identify the source;
`motor status`, `axis status` and `robot status` distinguish these estimates.

Use **normal INDEX** (`index_step=0`, `index_otpw=0`, `VACTUAL=0`). One electrical
cycle covers **four full steps: 7.2° at the motor shaft, or 64 STEP pulses at
1/16 microstepping**. The first observed boundary establishes a coarse relative
origin; subsequent crossings update position. Successful homing rebases this
coordinate to the reference-switch position. Position holds between boundaries,
with up to one electrical cycle of unresolved sub-cycle displacement/phase;
short moves can produce no position update. This is driver phase feedback and
cannot detect mechanical stalls, slipped belts or shaft motion while disabled.
See [TMC2209 datasheet, sections 13.4 and 14](https://www.analog.com/media/en/technical-documentation/data-sheets/TMC2209_datasheet_rev1.09.pdf).

Both GPIO edges are enabled: forward rising and backward falling transitions
represent the same boundary, so crossing it and reversing cancels the count.
Direction comes from the motor command. Velocity is the signed average between
same-direction boundaries over at least 10 ms (multiple cycles are accumulated
at high speed because the monotonic clock resolves 1 ms); it is zero until a complete interval is
available after startup/reversal/resume, and immediately zero on STEP stop.
Callbacks also accept the last settling INDEX edge after stopping. No UART polls
or new motion timer are involved; timer/DMA STEP scheduling stays unchanged.
The provider's `motion()` hint takes the period of one STEP pulse; the provider
uses its configured microstep setting to calculate the expected INDEX interval.

Until an INDEX boundary is observed, `actualPosition()` / `actualVelocity()`
return `no_message_available`. Progress callbacks detect overdue feedback after
three electrical periods (using the slowest period since the last boundary,
with a 20 ms minimum). Lost feedback becomes unavailable until homing or driver
reinitialization; it never silently reconstructs lost cycles from commanded
steps. This is diagnostic feedback, not an automatic following-error stop.
Driver disable, reset and reconfiguration invalidate its phase. M2/M3 callbacks
are short and serialized; destruction stops motion and disconnects callbacks.

### Driver interface and shared enable

Use 3.3 V push-pull MCU outputs. Power both TMC2209 **VDD** pins from 3.3 V
and join their GND pins to controller ground. Their STEP, DIR and EN inputs
can connect directly to the assigned GPIOs; EN is active low. Hardware-timed
STEP/DIR remains the motion interface. USART2 configures the drivers and reads
diagnostics; individual DIAG inputs report electrical faults. Each normal
INDEX output also connects to its dedicated Nucleo feedback input below. See the
[Adafruit #6121 pinout](https://learn.adafruit.com/adafruit-tmc2209-stepper-motor-driver-breakout-board/pinouts).

The STEPPERONLINE driver is **DM542T V4.0**, with S2 set to **5 V**.
Use three **2N2222A NPN transistors** as a common-anode interface for its
7–16 mA optoisolated inputs. Each GPIO drives a transistor base through **1 kΩ**;
each emitter connects to controller ground, with **10 kΩ between base and
emitter**. Q1's collector connects to PUL−, Q2's to DIR−, and Q3's to ENA−.
Connect PUL+, DIR+ and ENA+ to regulated **+5 V**, sharing the supply ground
with the controller. Check the transistor manufacturer's lead arrangement.
See the [2N2222A datasheet](https://www.st.com/resource/en/datasheet/2n2222a.pdf)
and [DM542T V4.0 manual, section 3.1](https://www.omc-stepperonline.com/download/DM542T_V4.0.pdf).

One shared enable GPIO therefore controls all three drivers:

| PE15 / STEPPERS_EN_N | TMC2209 EN (both boards) | Q3 / DM542T ENA input current | Result |
| --- | --- | --- | --- |
| Low (0 V) | Low | Off / no current | All enabled |
| High (3.3 V) | High | On / current flowing | All disabled |

Fit an external **470 Ω pull-up to 3.3 V on PE15**, on the GPIO side of Q3's
1 kΩ base resistor. This supplies base current during MCU reset and keeps the
shared TMC2209 EN inputs high while the control supplies are present. PE15 sinks
about 7 mA when driven low. The weaker 10 kΩ pull-up used for a MOSFET or logic
buffer interface is unsuitable for this shared NPN circuit. Fit external
10 kΩ pull-downs on the directly connected TMC2209 STEP inputs as well.
Keep DM542T ENA connected: an open enable input leaves that driver enabled.
For V4.0, allow at least 200 ms after enabling before issuing motion commands,
as specified in its manual.

### DM542T alarm input

The DM542T V4.0 **ALM+/ALM− output conducts when healthy and opens on a
fault in its default configuration**. It reports a driver protection fault,
not its specific cause, shaft movement or lost steps. The fault output is
separate from the 5 V PUL/DIR/ENA inputs; **S2 does not set its voltage**.
See [the V4.0 manual, sections 3.2, 4.2 and 11](https://www.omc-stepperonline.com/download/DM542T_V4.0.pdf).

| Connection | Assignment |
| --- | --- |
| ALM+ | J104.7 → `M1_ALM` → J101.4 → **PF2 / CN9 pin 17 / D70** |
| ALM− | J104.8 → GND |
| Nucleo ground return | J101.2/6/10 → CN11 pin 8 / GND (shared returns) |
| R30 | **4.7 kΩ from M1_ALM to 3.3 V**, about 0.7 mA when conducting |
| CubeMX / HAL | GPIO input, pull-up, rising-edge EXTI2, interrupt priority 5 |

No extra transistor or optocoupler is needed for this output. Do not connect
ALM or PF2 to 5 V or 24 V. The external pull-up is on the perfboard; the MCU
pull-up also makes a disconnected Nucleo harness read high. **Low = healthy;
high = fault or open cable.** A signal short to ground is not detectable by
this interface. Use the default normally conducting alarm polarity.

`hal::board::create_stepper_diagnostic(MotorId::Motor1)` creates the exclusive
input, owned by `MotionController`. Its interrupt callback latches the fault,
raises shared enable to disable all three drivers, and notifies the driver
monitor without UART, logging or thread locks. The monitor stops every motion
and invalidates all references. Startup and enable check the input level, so
an already open ALM blocks operation even without an edge. M1 remains monitored
when a TMC2209 is unavailable. Clearing ALM never resumes a motion.

Use `motor driver status m1` (or `motor driver status` for all drivers) to read
the live ALM level and retained fault latch. Correct the cause first; a DM542T
protection fault may require power cycling the driver as described in its manual.
Then run `motor reset` or `motor driver init` while disabled, explicitly enable,
and re-home. Recovery also verifies both TMC2209s. **Normal firmware now requires
the DM542T ALM connection as well as both TMC2209s.** The single-TMC bench images
only own their selected TMC DIAG input and do not require M1.

On the 47-column × 65-row perfboard, J104.7/8 use D14/D16, J101.4 uses Y3, and R30 uses
H18 (+3.3 V) / H14 (ALM). The ALM return shares the motion harness ground; see [the harness and assembly tables](hardware/assembly/README.md).

### Driver abstraction and fault handling

Each `StepperMotor` owns an injected
[`IStepperDriver`](platform/hal/devices/itf/IStepperDriver.hpp), alongside its
`IMotorFeedback`. `hal::board::create_stepper_drivers()` creates M1's
`Dm542tDriver` and M2/M3's `Tmc2209Driver`, sharing one serialized `Tmc2209Bus`.
The bus prepares both UART addresses before initialization reads. Factory creation
does not initialize or enable the drivers. Initialization and recovery are
coordinated by `MotionController` while the shared enable remains high.

The common driver interface provides cached readiness/fault status, explicit
initialization/recovery, verification, periodic service and a fault callback.
ALM and DIAG use the same latched fault handling; a released input never clears
the latch automatically. DM542T readiness means its alarm input is healthy; it
cannot verify the physical DIP settings. Our ALM wiring detects an open cable;
the pull-down DIAG wiring does not provide equivalent cable detection.

Each implementation owns its diagnostic GPIO, configuration, status and errors.
`MotionController` retains shared enable, the monitoring worker and group shutdown
policy. Driver callbacks wake the motor and immediately disable the shared enable;
thread context stops all motions and invalidates references. Motor methods also
reject unready drivers and check for faults during movement, homing and coordinated
operations. Callback teardown synchronizes with in-flight publications.

`configuration()` returns an optional `IConfigurableStepperDriver` capability.
That interface extends `IStepperDriver`; `Tmc2209Driver` inherits it directly,
while `Dm542tDriver` inherits only `IStepperDriver`.
M1 has none; M2/M3 expose settings and cached UART diagnostics through it.
Configuration validates motor current limits, Z holding current, matching microsteps
and normal INDEX operation. Staging settings leaves the driver unready until explicit
initialization applies and verifies them. The CLI performs that initialization as
part of `motor driver configure`. `motor driver status [m1|m2|m3|all]` reports common
status for every motor and additional telemetry only where supported.

UART is an optional interface capability, but is required by the configured M2/M3
implementations: missing communication latches a fault, with no automatic standalone
fallback. `SignalOnlyDriver` is an explicit substitute used only in motion unit tests
and the unpowered STEP bench; it is never selected by the application board factory.

### TMC2209 UART configuration and diagnostics

For **M1 / DM542T plus M2 / TMC2209 together**, use the
[`motor-test-stm32` bench image](docs/motor-hardware-test.md). M2 defaults to
StealthChop. It tests holding, individual/concurrent/independent moves and
M1 encoder / M2 INDEX feedback, monitors both fault inputs, and requires no M3.

For temporary wiring and an interactive image that tests **one** driver with
an unloaded motor, see the [single-TMC2209 bench test](docs/tmc2209-hardware-test.md)
and the `tmc-test-stm32` build preset. The normal robot application requires both drivers and the M1 ALM connection.
For a comparison using only STEP/DIR and hardware driver settings, use
[`tmc-standalone-test-stm32`](docs/tmc2209-standalone-test.md). That image leaves
USART2 disabled and never accesses driver registers; power-cycle the driver
and set its potentiometer current before running it.

M2 and M3 share **USART2 at 115200 baud, 8N1**, separate from the USART3 CLI.
All signals use **3.3 V logic**. The board factory creates one `IUart` transport;
the two TMC2209 driver objects share a serialized `hal::device::Tmc2209Bus`.
`hal::board::create_stepper_driver_bus()` selects USART2 with local echo enabled
and a 1 ms settling interval. The concrete `hal::Uart`
has its declaration in the platform's `Uart.hpp` and is constructed by the
platform factory; USART2 initializes when the transport is created. The UART
driver contains no motor register protocol. `board.cpp` assigns USART2 and passes
its configuration to `hal::device::tmc2209::create_transport()`. This device factory
uses the real UART on STM32 and attaches a `Tmc2209Model` on Linux; CMake selects
the implementation. The transport owns that model for its lifetime. Fault-injection
tests own their models and pass them to `create_stepper_drivers()` explicitly;
controller tests supply a `MotionController::DriverFactory`. Shared board code
has no simulation registry or simulation-access API.
The archived application initializes both at boot, while the shared enable stays
HIGH. Missing/unpowered drivers leave the CLI available but block motor, axis
and robot enable/motion commands, including M1 because enable is shared.

| Signal | Nucleo contact | Perfboard J113 | Connection |
| --- | --- | --- | --- |
| USART2 TX / PD5 / AF7 | **CN9 pin 6 / D53** | 1 | R29 **1 kΩ**, then shared UART bus |
| USART2 RX / PD6 / AF7 | **CN9 pin 4 / D52** | 3 | Directly to shared UART bus |
| M2_DIAG / PD4 | **CN9 pin 8 / D54** | 5 | J105.7 / M2 DIAG; rising-edge EXTI, pull-down |
| M3_DIAG / PD3 | **CN9 pin 10 / D55** | 7 | J106.7 / M3 DIAG; rising-edge EXTI, pull-down |
| M2_INDEX / PD0 | **CN9 pin 25 / D67** | 4 | J105.8 / M2 INDEX; both-edge EXTI, pull-down |
| M3_INDEX / PD1 | **CN9 pin 27 / D66** | 6 | J106.8 / M3 INDEX; both-edge EXTI, pull-down |
| Ground | CN11 pin 8 | 2, 8 | Shared logic returns |

R29 pin 2, J113.3, J105.9 and J106.9 form the **same** `TMC_UART_RX`
bidirectional bus. Only TX passes through R29. This is ordinary full-duplex
MCU UART hardware wired to the TMC single-wire interface; firmware consumes
and validates the local TX echo before decoding each reply. RX FIFO is enabled
to retain the request echo plus reply. Transactions have a bounded timeout,
CRC and frame validation; writes verify the driver's wrapping IFCNT counter.
No motion timer, DMA stream or console peripheral is repurposed.

The address straps are M2 **0** (MS1/MS2 LOW/LOW) and M3 **1** (HIGH/LOW).
Leave **SPRD open** on both modules. Software checks the strap inputs and
chip identity. It writes digital current, microstep resolution, interpolation,
chopper settings and reply delay, verifies readable configuration registers,
and checks diagnostics. `mstep_reg_select` overrides the straps, so both
motors retain the axis configuration's **16 microsteps**. Microsteps are not
independently adjustable through the CLI because that would change position
conversion. The hardware STEP generator remains responsible for all motion.

| Setting | M2 / C17HD2024-01N | M3 / BJ42D15-26V10 |
| --- | --- | --- |
| Requested run / hold current | 650 / 650 mA RMS | 550 / 550 mA RMS |
| Nominal quantized run / hold current | 625 / 625 mA RMS | 511 / 511 mA RMS |
| CLI run-current ceiling | 700 mA RMS | 590 mA RMS |
| Initial mode | StealthChop | StealthChop |
| External microsteps / interpolation | 16 / 256 enabled | 16 / 256 enabled |

The calculation uses the Adafruit board's **0.05 Ω sense resistors** and
TMC2209's 180 mV sense range, including the internal 20 mΩ contribution.
Settings round down to the available current scale. These conservative initial
limits keep the nominal sine-wave peak below the drawings' phase-current
ratings (M2 1.0 A, M3 0.84 A); torque and temperature still need characterization
on the assembled robot. **The onboard current potentiometers are bypassed
while this UART configuration is active.** M2 hold current can be reduced;
M3 hold must equal run to preserve Z holding torque. Disabling drivers removes
holding torque. Settings are volatile; boot restores the defaults above.

```text
motor driver status
motor disable
motor driver configure m2 --run 650 --hold 500 --mode stealthchop --interpolate on
motor driver configure m3 --run 550 --mode stealthchop
motor driver status m3
motor driver init
```

Configuration and explicit recovery require disabled drivers, stop all motion,
and invalidate references. `motor driver init` reinitializes both devices and
leaves them disabled. `motor reset` resets the step timebase and performs the
same driver initialization. `motor enable` verifies both again before asserting
shared enable and waiting 200 ms. `axis` and `robot` share this controller.
StealthChop is the initial mode; it requires a requested run current of at
least 512 mA RMS for the recommended minimum IRUN scale. The 200 ms enable
delay allows its initial standstill auto-tuning before motion. SpreadCycle
remains selectable with `--mode spreadcycle`; no automatic mode switch is configured.

A monitor polls each driver's GSTAT, DRV_STATUS, IOIN, SG_RESULT and readable
configuration approximately every **100 ms plus transaction/scheduling time**.
CRC/timeout/configuration errors, a driver reset, overtemperature shutdown,
short-circuit flags or charge-pump undervoltage latch a fault, disable **all
three** drivers, stop their jobs and invalidate referencing. The ALM/DIAG fault callback
immediately raises shared enable and wakes that worker; UART and logging run
only in thread context. Recovery requires correcting the cause, running
`motor driver init` while disabled, enabling explicitly and re-homing. No fault
automatically resumes motion. This software monitoring is not an emergency-stop
circuit; a UART-only fault is detected at the next successful monitor cycle or timeout.

Overtemperature prewarning is logged. Open-load and StallGuard readings are
reported for diagnosis, not used as reliable homing or position feedback.
Open-load detection depends on current/mode/motion, and StallGuard needs
mechanical characterization. CoolStep, sensorless homing, the internal velocity
generator, freewheeling and OTP programming remain disabled/unused. Physical NC
reference switches and the M1 encoder keep their existing roles.

Protocol and application tests use the Linux two-driver model, including reset,
disconnect, malformed replies, unacknowledged writes, independent addresses and
DIAG shutdown. **UART communication with the assembled Adafruit boards has not
been measured yet.** For first bring-up, wire J113 and the straps as above,
power both modules, and run `motor driver status`: both must show `ready=true`,
no latched fault, the intended microsteps/current and no error. `motor driver
init` retries after wiring/power corrections; motion remains disabled until
explicitly enabled. Use `help motor driver configure` for option details.

References: [TMC2209 register and UART specification](https://www.analog.com/media/en/technical-documentation/data-sheets/TMC2209_datasheet_rev1.09.pdf),
[Adafruit pinout](https://learn.adafruit.com/adafruit-tmc2209-stepper-motor-driver-breakout-board/pinouts),
[Adafruit board schematic / sense resistors](https://github.com/adafruit/Adafruit-TMC2209-Breakout-PCB/blob/main/Adafruit%20TMC2209%20Stepper%20Motor%20Driver.sch),
[ST UM2407 connector assignments](https://www.st.com/resource/en/user_manual/um2407-stm32h7-nucleo144-boards-mb1364-stmicroelectronics.pdf).

### Motor 1 encoder

The **PKP245D23A2-R2FL** has a **400 P/R incremental differential A/B/Z
encoder**, powered from **5 V**. A and B are offset by a quarter cycle
(quadrature): their transition order identifies direction, and counting all
four transitions gives **1,600 counts/revolution**, or **0.225° per count** at
the motor shaft. Z is the once-per-revolution index. This is count resolution,
not guaranteed positioning accuracy; homing is still needed after power-up.
See the [motor specifications](https://catalog.orientalmotor.com/item/all-categories-legacy-products/legacy-pkp-series-2-phase-bipolar-stepper-motors/pkp245d23a2-r2fl)
and [encoder wiring, manual section 6-3](https://www.orientalmotor.com/products/pdfs/opmanuals/HM-7475-4E.pdf).

| Signal after receiver and 3.3 V buffer | STM32 pin | Board connector | CubeMX configuration |
| --- | --- | --- | --- |
| M1_ENC_A | PB4 | CN7 pin 19 / D25 | TIM3_CH1 / AF2, no pull |
| M1_ENC_B | PB5 | CN7 pin 13 / D22 | TIM3_CH2 / AF2, no pull |
| M1_ENC_Z | PB6 | CN12 pin 17 | EXTI6 rising edge, no pull |

PB4 is used for the encoder instead of JTAG reset; normal ST-Link **SWD**
debugging remains available. Connector positions follow
[ST UM2407, tables 18 and 22](https://www.st.com/resource/en/user_manual/um2407-stm32h7-nucleo144-boards-mb1364-stmicroelectronics.pdf).

CubeMX configures TIM3 in **encoder mode TI1 and TI2 (x4)**, with prescaler 0,
period 65535, direct non-inverted inputs and input filters disabled. The
16-bit counter wraps at 65536. The encoder HAL extends it using signed
differences between counter samples. TIM3 update interrupts and internal CH3/CH4
compare markers at `0x5555` and `0xAAAA` service the counter even without
application reads. CH3/CH4 do not drive pins; A/B edges remain hardware-counted.
This also handles direction reversals around a wrap without guessing from the
instantaneous direction bit. **TIM3 interrupt latency must stay below the time
for 10,922 encoder counts**, keeping samples less than 32,768 counts apart.
For example, at 160,000 counts/s the latency budget is less than 68.26 ms.
Multiple unserviced wraps cannot be recovered from a 16-bit counter. The driver
reports an exactly ambiguous half-range sample or signed-position overflow;
other excessive-latency aliasing cannot always be detected.

`hal::initialize()` and feedback/encoder construction leave counting stopped.
M1's `StepperMotor` subscribes to and starts its `QuadratureEncoderFeedback`,
which owns the raw encoder subscription and reserves Z without zeroing on its
edges. TIM3's priority-5 interrupt is
enabled by encoder `start()` and disabled by `stop()`; its handler is project-owned.
TIM6 schedules measurement callbacks through the project-owned HAL period
callback, while still incrementing the HAL tick. The generated CubeMX callback
is renamed at build time, so regeneration preserves this integration.
EXTI9_5 retains the HAL wrapper's shared priority-5 dispatcher.

Use three channels of the **AM26C32CN** differential receiver, three additional
**Diotec 2N2222A converters (Q4–Q6)**, then three channels of the user's
**SN74HC126N powered from 3.3 V**. Each transistor converts a receiver output
to 3.3 V logic and inverts it. **Reverse each encoder pair at the AM26C32
inputs as shown below** to cancel that inversion. The motor connector pinout,
MCU pins, A/B counting direction and rising-edge Z convention stay unchanged.

| Encoder + / − wires | AM26C32CN pins for those wires (reversed) | Receiver output | Converter | SN74HC126N input → output | STM32 |
| --- | --- | --- | --- | --- | --- |
| A+ / A− | 1 / 2 | 3 | Q4 | 2 → 3 | PB4 |
| B+ / B− | 7 / 6 | 5 | Q5 | 5 → 6 | PB5 |
| Z+ / Z− | 9 / 10 | 11 | Q6 | 9 → 8 | PB6 |

Each converter uses the following connections:

| Function | A channel | B channel | Z channel | Connection |
| --- | --- | --- | --- | --- |
| Base resistor, **4.7 kΩ** | R20 | R23 | R26 | Receiver output → transistor base |
| Base-to-emitter resistor, **10 kΩ** | R21 | R24 | R27 | Base → ground |
| Collector pull-up, **1 kΩ** | R22 | R25 | R28 | 3.3 V → collector |
| Transistor | Q4 | Q5 | Q6 | Emitter → ground; collector → HC126 input |

Diotec's 2N2222A lead order is **1 = E, 2 = B, 3 = C**; the schematic uses
functional E/B/C pin names. At nominal supply voltage each conducting
collector sinks about 3.3 mA. The HC126 inputs therefore receive either a
low collector voltage or the 3.3 V pull-up voltage, without a direct 5 V input.

AM26C32CN: pin 16 to regulated **5 V (±5%)**, pin 8 to ground, pin 4 to 5 V,
pin 12 to ground. Its unused fourth receiver may remain unconnected.
SN74HC126N (DIP-14): pin 14 to **3.3 V**, pin 7 to ground;
enable the three used channels by tying pins **1, 4 and 10 to 3.3 V**.
Disable its unused channel by tying **pin 13 to ground**, tie input pin 12 to ground and leave
output pin 11 unconnected. Place **100 nF** at each IC's supply pins and
share encoder, receiver, transistors, buffer and controller ground. **Never
connect the 5 V receiver outputs directly to HC126 inputs.** No SOIC adapter
or 4N35 optocouplers are used. Q1–Q3 retain their existing DM542T function.
See the [AM26C32 datasheet](https://www.ti.com/lit/ds/symlink/am26c32.pdf)
and [SN74HC126 datasheet](https://www.ti.com/lit/ds/symlink/sn74hc126.pdf), and
the [Diotec transistor pinout](https://diotec.com/tl_files/diotec/files/pdf/datasheets/2n2222a.pdf).

Keep each collector-to-HC126 connection short and local to the perfboard.
The 1 kΩ pull-up gives an estimated 10–90% rise time of 220 ns at 100 pF
total collector-node capacitance (2.2 × R × C). Transistor storage adds
turn-off delay that is not specified in Diotec's data sheet: check all three
waveforms with an oscilloscope at the intended speed before relying on the
encoder for motion feedback. The static KiCad checks do not establish a
maximum encoder frequency. Firmware and CubeMX settings are unchanged.

On the motor's eight-pin encoder connector, pin 8 is +5 V, pin 1 is ground,
and pins 2/3, 4/5 and 6/7 are A+/A−, B+/B− and Z+/Z− respectively.
Use the connector orientation shown in the motor manual. Use shielded twisted
pairs away from motor power wiring; choose receiver-end termination to suit
the cable impedance and the encoder's 20 mA output-current limit.
