daleondev/ProtoMate_Control/docs/motion-architecture/qualification-gates.png

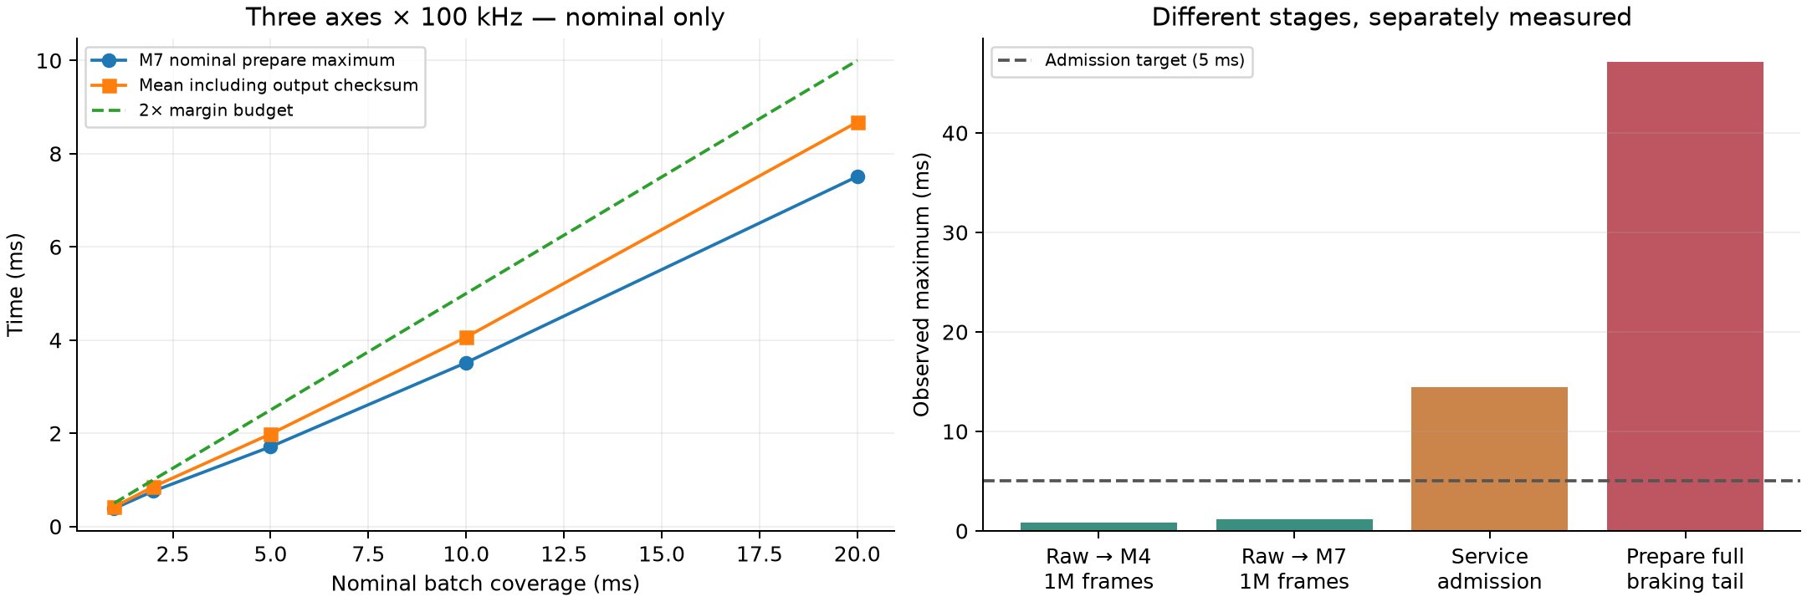
docs/motion-architecture/qualification-gates.png
