daleondev/ProtoMate_Control/docs/motion-architecture/reduced-rate-gates.png

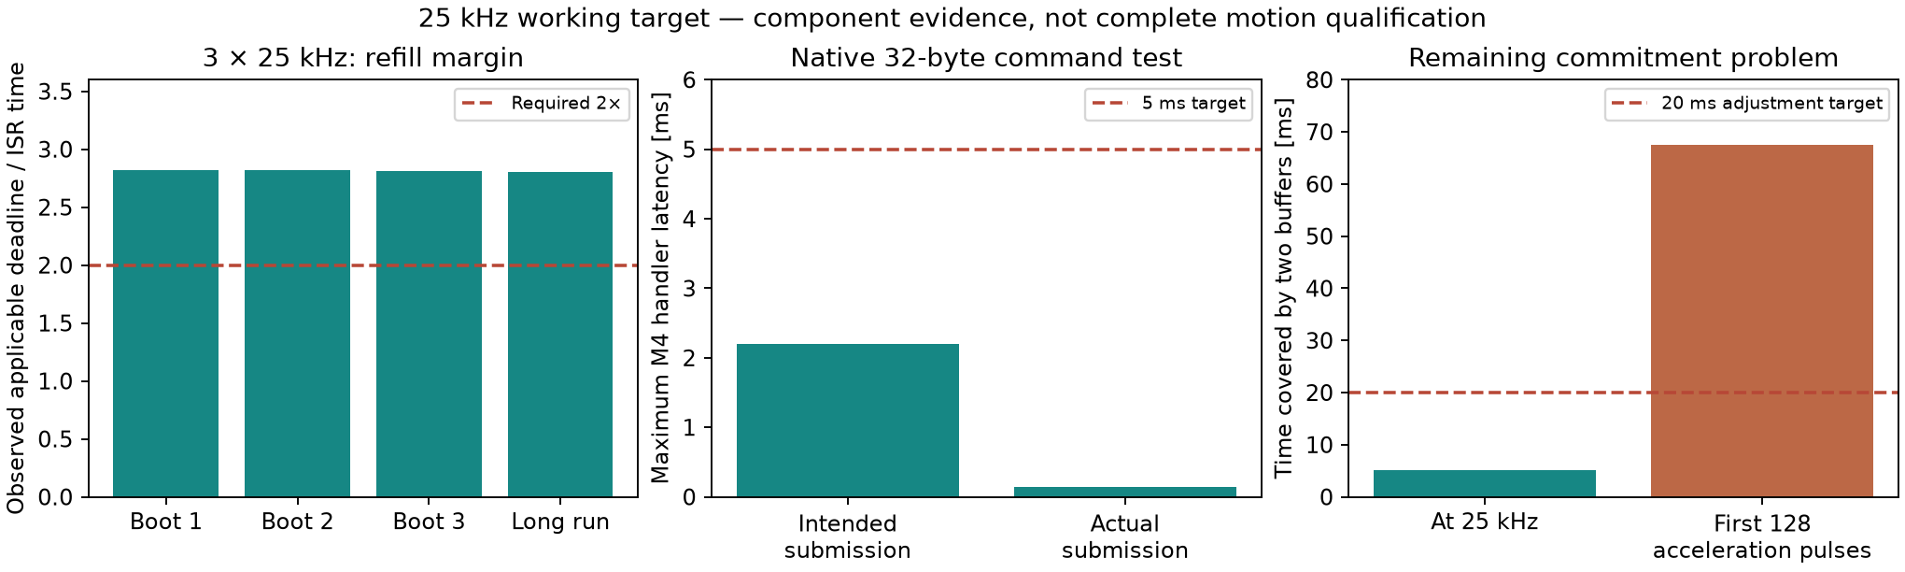
docs/motion-architecture/reduced-rate-gates.png
