daleondev/ProtoMate_Control/hardware/display/manufacturing/verification/display-adapter-visual/B-filled-overview.png

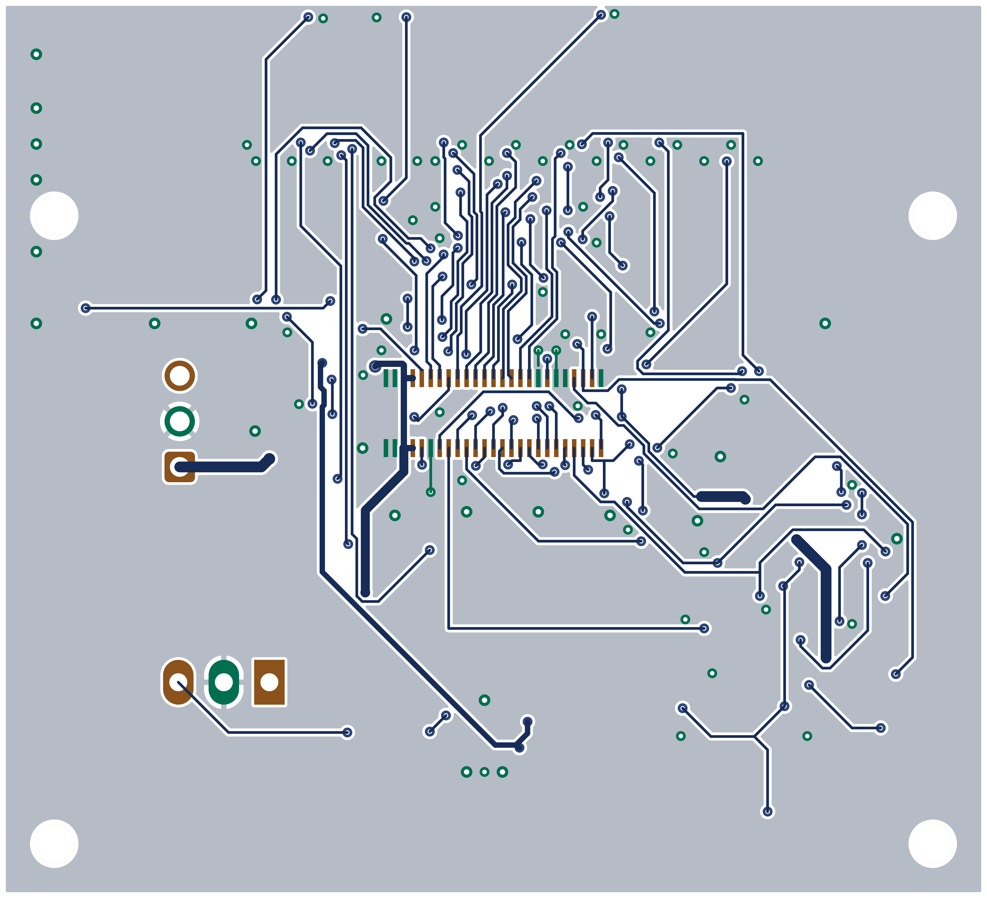
hardware/display/manufacturing/verification/display-adapter-visual/B-filled-overview.png
