daleondev/ProtoMate_Control/hardware/display/manufacturing/verification/display-adapter-visual/B-routes-overview.png

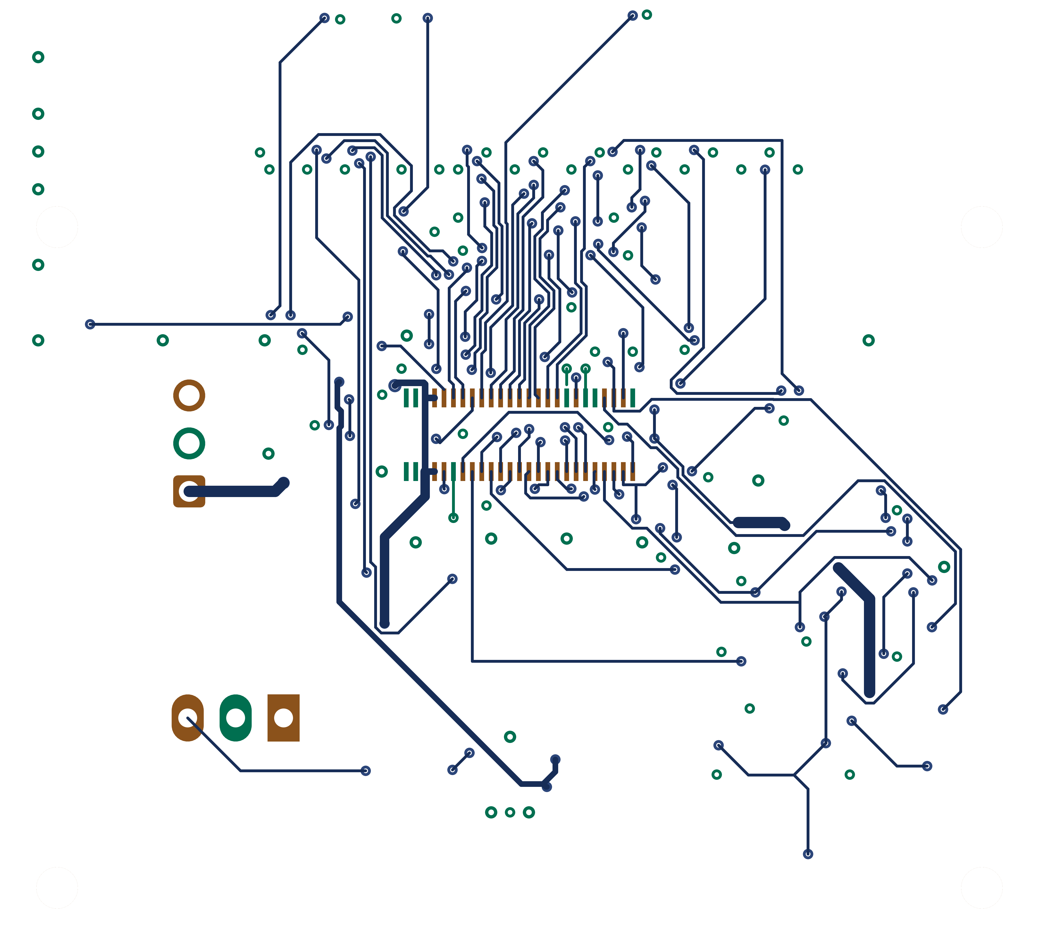
hardware/display/manufacturing/verification/display-adapter-visual/B-routes-overview.png
