daleondev/ProtoMate_Control/hardware/display/manufacturing/verification/display-adapter-visual/export-mechanical-bottom.png

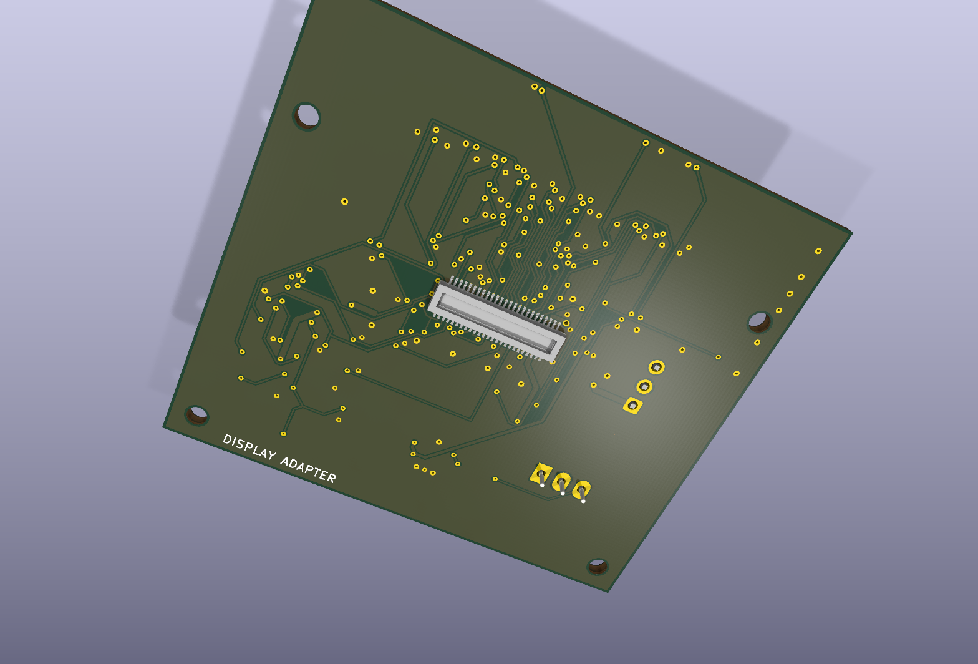
hardware/display/manufacturing/verification/display-adapter-visual/export-mechanical-bottom.png
