daleondev/ProtoMate_Control/hardware/display/manufacturing/verification/display-adapter-visual/F-filled-overview.png

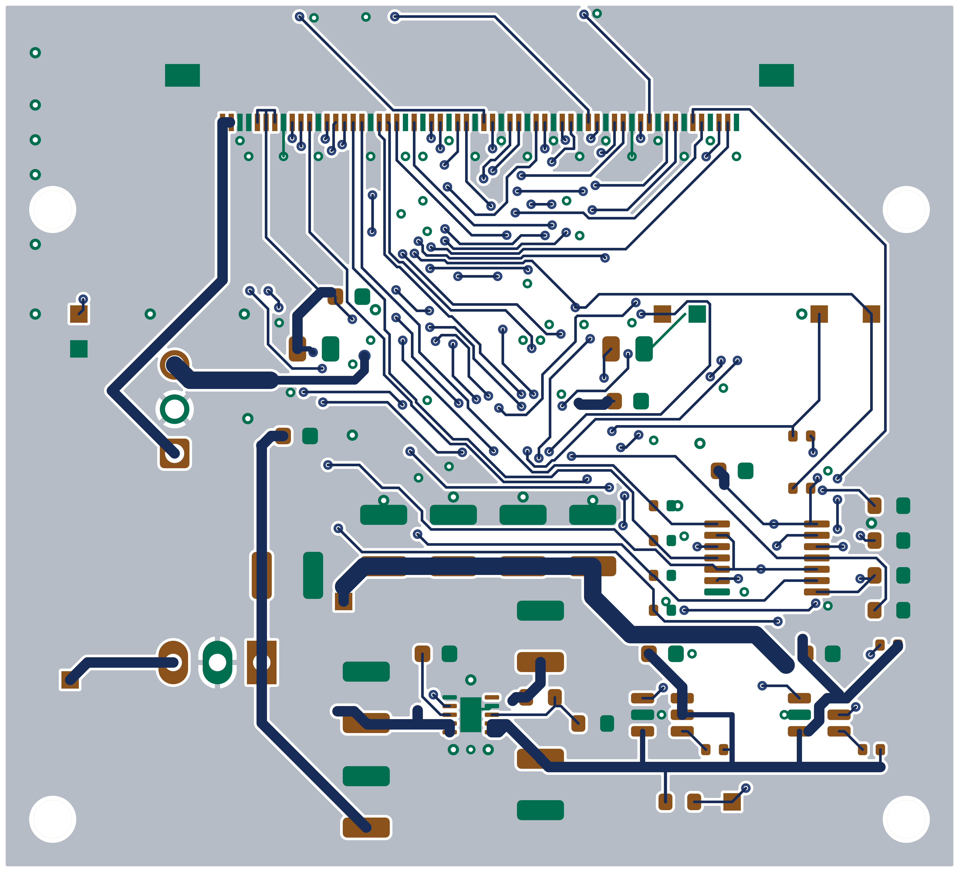
hardware/display/manufacturing/verification/display-adapter-visual/F-filled-overview.png
