daleondev/ProtoMate_Control/hardware/display/manufacturing/verification/display-adapter-visual/F-routes-overview.png

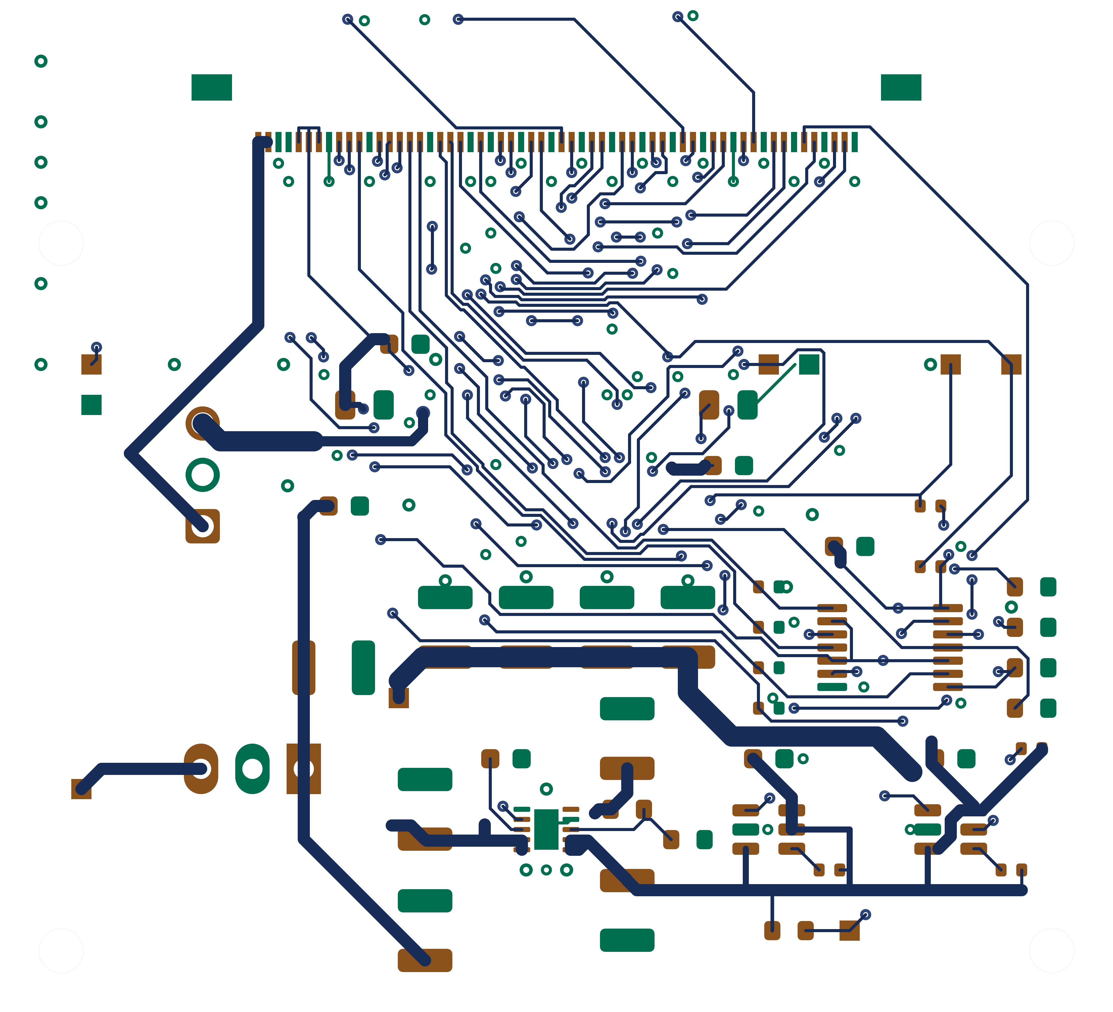
hardware/display/manufacturing/verification/display-adapter-visual/F-routes-overview.png
