daleondev/ProtoMate_Control/hardware/display/manufacturing/verification/giga-adapter-visual/B-filled-overview.png

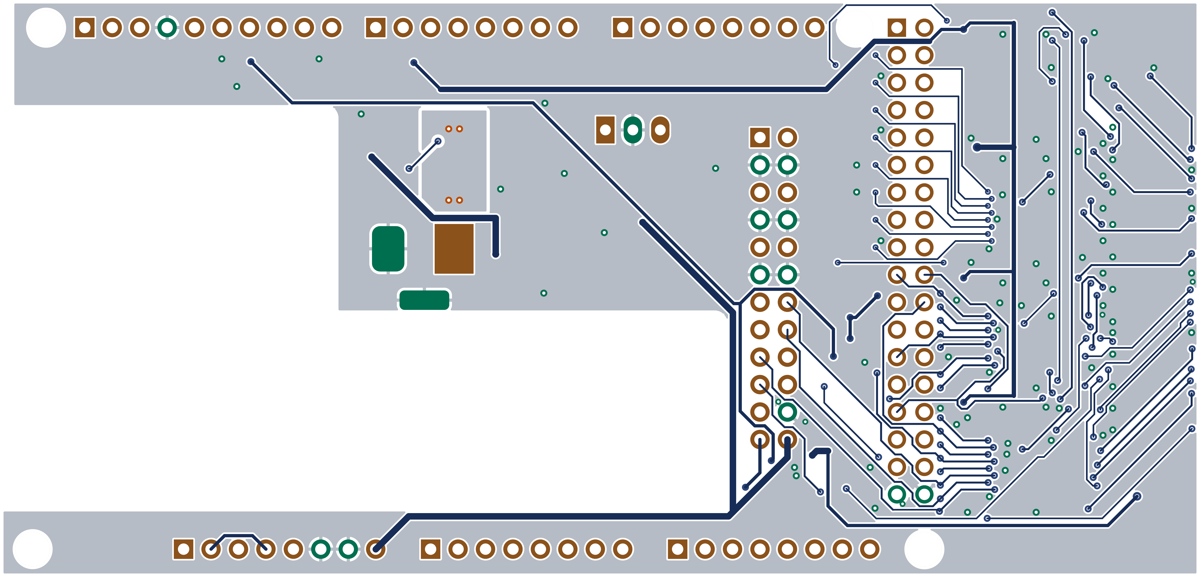
hardware/display/manufacturing/verification/giga-adapter-visual/B-filled-overview.png
