daleondev/ProtoMate_Control/hardware/display/manufacturing/verification/giga-adapter-visual/B-routes-overview.png

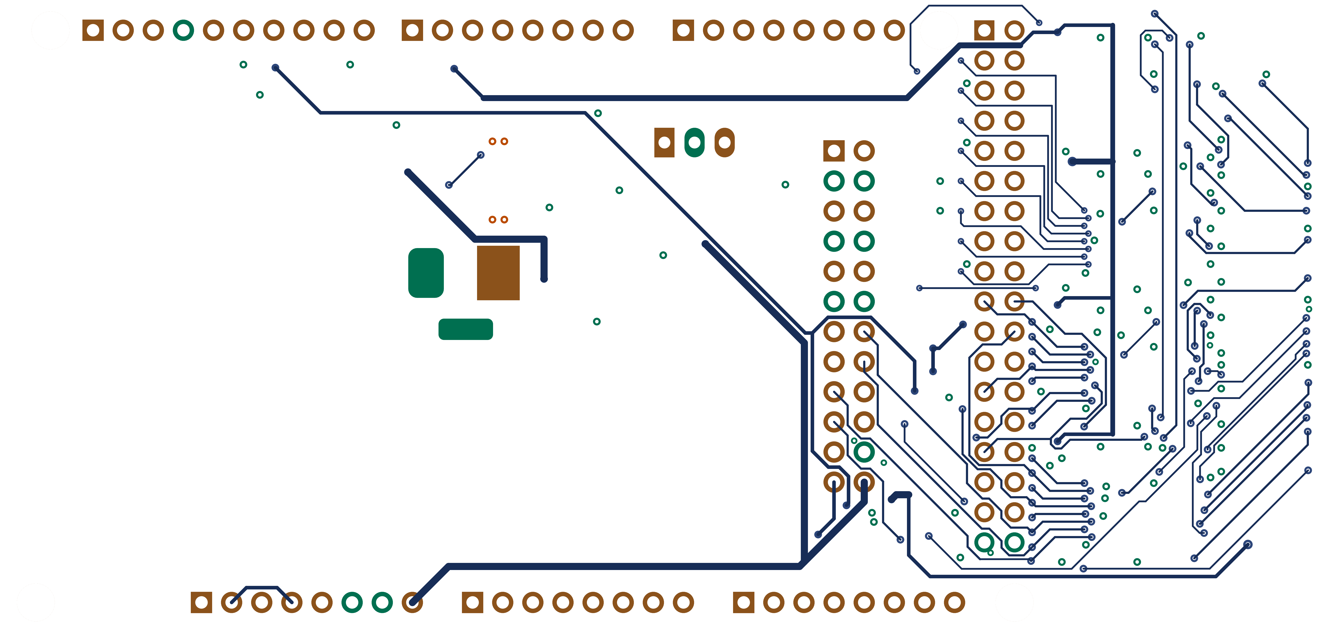
hardware/display/manufacturing/verification/giga-adapter-visual/B-routes-overview.png
