daleondev/ProtoMate_Control/hardware/display/manufacturing/verification/giga-adapter-visual/F-routes-overview.png

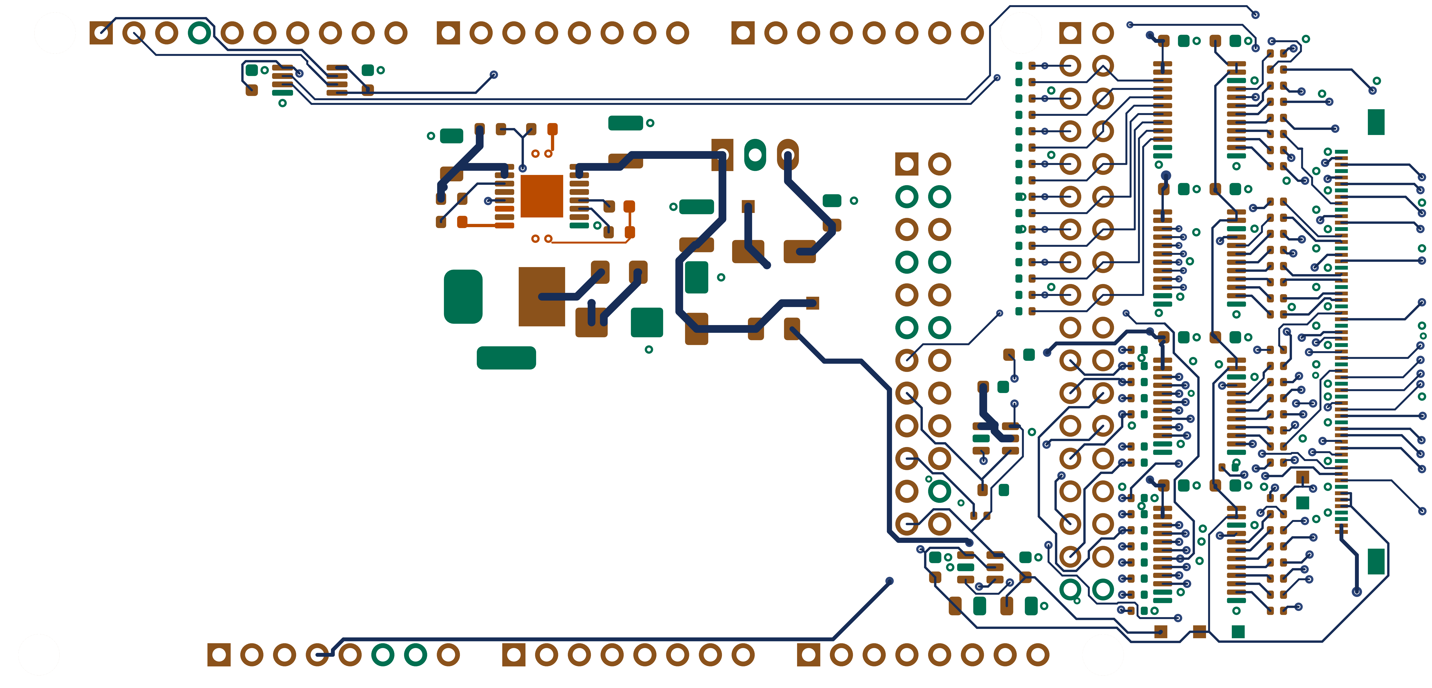
hardware/display/manufacturing/verification/giga-adapter-visual/F-routes-overview.png
