daleondev/ProtoMate_Control/hardware/display/manufacturing/verification/giga-adapter-visual/In1-filled-overview.png

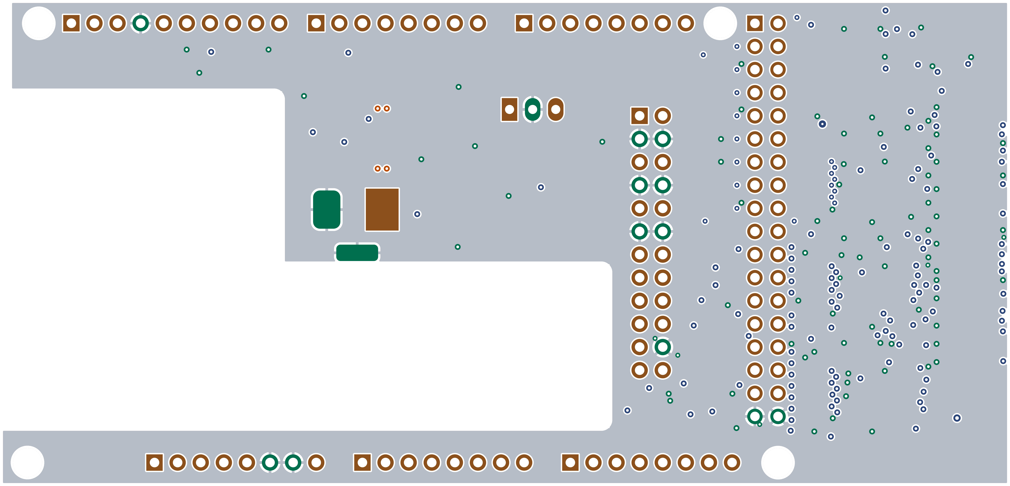
hardware/display/manufacturing/verification/giga-adapter-visual/In1-filled-overview.png
