daleondev/ProtoMate_Control/hardware/display/procurement/components.csv

Board | Revision | Designators | Installed quantity | Purchase quantity | Circuit value | PCB package | Assembly | Original BOM MPN | Purchase manufacturer | Purchase MPN | Mouser part number | Availability evidence | Indexed stock | Index age | Lookup date | Source URL | Notes
display-adapter | G | J1 | 1 | 1 | DF23C-50DP-0.5V(92) | DF23C-50DP-0.5V | SMT | DF23C-50DP-0.5V(92) | Hirose | DF23C-50DP-0.5V(92) | 798-DF23C50DP05V92 | stock-indexed | 1575 | 2 weeks ago | 2026-10-22 | https://www.mouser.com/en/ProductDetail/Hirose-Connector/DF23C-50DP-0.5V92?qs=nSryOFbzj8IvGUDyjNwvaw%3D%3D | Exact 50-pin mating plug; fit on display PCB underside.
display-adapter | G | J2 | 1 | 1 | 505110-6091 | Molex_505110-6091_1x60_P0.50mm | SMT | 505110-6091 | Molex | 505110-6091 | 538-505110-6091 | stock-indexed | 11530 | last week | 2026-10-22 | https://eu.mouser.com/en/ProductDetail/Molex/505110-6091?qs=fSIr1QPo%2F%2FQRD6rm5ZTYDw%3D%3D | Two bottom-contact sockets per pair; match Molex 15018-0563 Type-A ear-tab cable.
display-adapter | G | U1 | 1 | 1 | TSR 2-2433 / 3.3V 2A | Converter_DCDC_TRACO_TSR2-xxxx_THT | HAND | TSR 2-2433 | TRACO Power | TSR 2-2433 | 495-TSR2-2433 | stock-indexed | 6134 | 3 weeks ago | 2026-10-22 | https://eu.mouser.com/en/ProductDetail/TRACO-Power/TSR-2-2433?qs=NtE2QagKf6Qer8edccxn%2FA%3D%3D | 3.3 V / 2 A; through-hole SIP module.
display-adapter | G | C9, C11 | 2 | 2 | 10u / 50V X7R | C_1210_3225Metric | SMT | GRM32ER71H106KA12L | TAIYO YUDEN | MCJCU32MLB7106KPPDTJ | 963-U32MLB7106KPPDTJ | stock-indexed | 1535 | 2 months ago | 2026-10-22 | https://my.mouser.com/en/ProductDetail/TAIYO-YUDEN/MCJCU32MLB7106KPPDTJ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 | Replacement: 10 uF +/-10%, 50 V, X7R, 1210, soft termination; 2.5 +/-0.3 mm height. Original unavailable/region-restricted.
display-adapter | G | C10 | 1 | 1 | 100n / 50V X7R | C_0603_1608Metric | SMT | GRM188R71H104KA93D | KEMET | C0603C104K5RACTU | 80-C0603C104K5R | stock-indexed | 3941024 | last week | 2026-10-22 | https://cz.mouser.com/en/ProductDetail/KEMET/C0603C104K5RACTU?qs=l5k%252BbMnNDkkVcnZPSAaaiQ%3D%3D | Replacement for obsolete original: 100 nF +/-10%, 50 V, X7R, 0603.
display-adapter | G | C1, C2, C3, C4, C12, C13, C14 | 7 | 7 | 47u / 10V X5R | C_1210_3225Metric | SMT | GRM32ER61A476KE20L | TAIYO YUDEN | MBASL32MSB5476KPNA01 | 963-BASL32MSB5476KP | stock-indexed | 1608 | 2 weeks ago | 2026-10-23 | https://lv.mouser.com/en/ProductDetail/TAIYO-YUDEN/MBASL32MSB5476KPNA01 | Approved purchasing replacement: 47 uF +/-10%, 10 V, X5R, 1210; 2.5 +/-0.2 mm height. Manufacturer typical DC-bias curve gives approximately 42 uF at 3.3 V and 36 uF at 5 V, not guaranteed minima. Retain supply/ramp/load-step qualification. No footprint change.
display-adapter | G | C5, C6 | 2 | 2 | 10u / 10V X5R | C_0805_2012Metric | SMT | GRM21BR61A106KE19L | KEMET | C0805C106K8PACTU | 80-C0805C106K8P | stock-indexed | 235800 | last week | 2026-10-22 | https://eu.mouser.com/en/ProductDetail/KEMET/C0805C106K8PACTU?qs=Zpyg6gQUYs39C21BeavaKA%3D%3D | Replacement for obsolete original: 10 uF +/-10%, 10 V, X5R, 0805; 1.25 +/-0.15 mm height.
display-adapter | G | C7, C8, C16, C18, C17 | 5 | 5 | 100n / 50V X7R | C_0603_1608Metric | SMT | GRM188R71C104KA01D | KEMET | C0603C104K5RACTU | 80-C0603C104K5R | stock-indexed | 3941024 | last week | 2026-10-22 | https://cz.mouser.com/en/ProductDetail/KEMET/C0603C104K5RACTU?qs=l5k%252BbMnNDkkVcnZPSAaaiQ%3D%3D | Replacement for EOL original: 100 nF +/-10%, X7R, 0603; voltage rating increased from 16 V to 50 V. Consolidated with display C10.
display-adapter | G | R2, R3, R4, R5, R8 | 5 | 5 | 47k | R_0402_1005Metric | SMT | RC0402FR-0747KL | YAGEO | RC0402FR-0747KL | 603-RC0402FR-0747KL | stock-indexed | 986351 | last month | 2026-10-22 | https://eu.mouser.com/en/ProductDetail/YAGEO/RC0402FR-0747KL?qs=V1yeUXFNrklslMUO6Zhx5g%3D%3D | 47 kohm, 1%, 0402.
display-adapter | G | R6, R7 | 2 | 2 | 4k7 | R_0402_1005Metric | SMT | RC0402FR-074K7L | YAGEO | RC0402FR-074K7L | 603-RC0402FR-074K7L | stock-indexed | 5902658 | last week | 2026-10-22 | https://www.mouser.com/en/ProductDetail/YAGEO/RC0402FR-074K7L?qs=V1yeUXFNrkn%2FmCXC8N8TTA%3D%3D | 4.7 kohm, 1%, 0402.
display-adapter | G | U2 | 1 | 1 | TSR 1-2450 / 5V 1A | Converter_DCDC_TRACO_TSR-1_THT_Trimmed | HAND | TSR 1-2450 | TRACO Power | TSR 1-2450 | 495-TSR-1-2450 | stock-indexed | 13356 | 3 weeks ago | 2026-10-22 | https://eu.mouser.com/en/ProductDetail/TRACO-Power/TSR-1-2450?qs=ckJk83FOD0XFKqda0Mzkgw%3D%3D | 5 V / 1 A; through-hole SIP module.
display-adapter | G | U3 | 1 | 1 | TPS7A9101DSKT | WSON-10-1EP_2.5x2.5mm_P0.5mm_EP1.2x2mm | SMT | TPS7A9101DSKR | Texas Instruments | TPS7A9101DSKT | 595-TPS7A9101DSKT | stock-indexed | 105 | 3 weeks ago | 2026-10-22 | https://eu.mouser.com/en/ProductDetail/Texas-Instruments/TPS7A9101DSKT?qs=34RfhUjJmKdmPKJyeIMDWg%3D%3D | Packaging-only replacement: same DSK-10 chip/pinout; small-reel suffix T instead of R. Exposed pad must be soldered.
display-adapter | G | C15 | 1 | 1 | 47n / 50V X7R | C_0603_1608Metric | SMT | GRM188R71C473KA01D | TDK | C1608X7R1H473K080AA | 810-C1608X7R1H473K | stock-indexed | 69961 | 3 weeks ago | 2026-10-23 | https://www.mouser.com/en/ProductDetail/TDK/C1608X7R1H473K080AA?qs=NRhsANhppD9%252BEs9R%2FCqqmw%3D%3D | Approved purchasing replacement: 47 nF +/-10%, 50 V, X7R, 0603; same nominal specification as the unavailable KEMET selection, voltage rating exceeds released BOM 16 V. No footprint change.
display-adapter | G | R9 | 1 | 1 | 31.2k / 0.1% | R_0603_1608Metric | SMT | RT0603BRD0731K2L | Vishay | TNPW060331K2BEEN | 71-TNPW060331K2BEEN | stock-indexed | 280 | last month | 2026-10-22 | https://www.mouser.tw/en/ProductDetail/Vishay/TNPW060331K2BEEN | Replacement: 31.2 kohm, 0.1%, 25 ppm/K, 0603. Preserve precision LDO ratio; original backordered.
display-adapter | G | R10 | 1 | 1 | 10k / 0.1% | R_0603_1608Metric | SMT | RT0603BRD0710KL | YAGEO | RT0603BRD0710KL | 603-RT0603BRD0710KL | stock-indexed | 69151 | last week | 2026-10-22 | https://eu.mouser.com/en/ProductDetail/YAGEO/RT0603BRD0710KL?qs=Br90QIIERxSXuxEMyECqGA%3D%3D | 10 kohm, 0.1%, 25 ppm/K, 0603. Do not confuse with ordinary 1% 10 kohm.
display-adapter | G | R11, R12, R13, R14, R15 | 5 | 5 | 10k / 1% | R_0603_1608Metric | SMT | RC0603FR-0710KL | YAGEO | RC0603FR-0710KL | 603-RC0603FR-0710KL | stock-indexed | 1640807 | last week | 2026-10-22 | https://www.mouser.com/en/ProductDetail/YAGEO/RC0603FR-0710KL?qs=grNVn54RoB%252B3GtjbJj3wJQ%3D%3D | 10 kohm, 1%, 0603.
display-adapter | G | U4, U6 | 2 | 2 | TPS3808EG33DBVR | SOT-23-6_UpperPin1 | SMT | TPS3808G33DBVR | Texas Instruments | TPS3808EG33DBVR | 595-TPS3808EG33DBVR | user-confirmed-orderable | 4336 | last week | 2026-10-23 | https://www.mouser.de/ProductDetail/Texas-Instruments/TPS3808EG33DBVR?qs=Z%252BL2brAPG1L6qXfVXxts%2FQ%3D%3D | TPS3808E functional replacement, not a packaging-only substitution: same DBV SOT-23-6 pinout, 3.07 V nominal threshold and active-low open-drain reset. Existing 100 kohm CT pull-ups retain 300 ms nominal delay (180-420 ms). 3.3 V operation is within the 1.7-6 V range; 10 kohm RESET pull-up is compatible. Lower typical quiescent current (0.6 uA). Datasheet undervoltage detect delay is 30 us typical / 50 us maximum at 5% overdrive; retain first-board brownout qualification. User confirmed regional purchase availability for the required two parts on 2026-10-23; stock quantity remains indexed, not live verified. No circuit or footprint change.
display-adapter | G | R16, R17 | 2 | 2 | 100k | R_0402_1005Metric | SMT | RC0402FR-07100KL | YAGEO | RC0402FR-07100KL | 603-RC0402FR-07100KL | stock-indexed | 6394487 | last month | 2026-10-22 | https://www.mouser.com/en/ProductDetail/YAGEO/RC0402FR-07100KL?qs=mnq%2FyloZIXzTlUn7JAHSWg%3D%3D | 100 kohm, 1%, 0402.
display-adapter | G | U5 | 1 | 1 | SN74LVC08APW | TSSOP-14_4.4x5mm_P0.65mm | SMT | SN74LVC08APWR | Texas Instruments | SN74LVC08APW | 595-SN74LVC08APW | stock-indexed | 252 | last month | 2026-10-22 | https://www.mouser.com/en/ProductDetail/Texas-Instruments/SN74LVC08APW?qs=RZS%252BpEsUn7pxqABTZcJnVg%3D%3D | Packaging-only replacement: same TSSOP-14 PW chip, supplied in tube; original reel variant backordered.
giga-adapter | F | J1 | 1 | 1 | 505110-6091 | Molex_505110-6091_1x60_P0.50mm | SMT | 505110-6091 | Molex | 505110-6091 | 538-505110-6091 | stock-indexed | 11530 | last week | 2026-10-22 | https://eu.mouser.com/en/ProductDetail/Molex/505110-6091?qs=fSIr1QPo%2F%2FQRD6rm5ZTYDw%3D%3D | Two bottom-contact sockets per pair; match Molex 15018-0563 Type-A ear-tab cable.
giga-adapter | F | U1, U2, U3, U4 | 4 | 4 | SN74AXC8T245PWR | TSSOP-24_4.4x7.8mm_P0.65mm | SMT | SN74AXC8T245PWR | Texas Instruments | SN74AXC8T245PWR | 595-SN74AXC8T245PWR | stock-indexed-conflicting | 4862 | last week | 2026-10-22 | https://gr.mouser.com/en/c/semiconductors/logic-ics/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 | Latest indexed category page reports stock; older product page reports zero. Confirm four available at basket import. TSSOP-24; no AXCH/LVC substitution.
giga-adapter | F | R1, R2, R3, R4, R5, R6, R7, R8, R9, R10, R11, R12, R13, R14, R15, R16, R17, R18, R19, R20, R21, R22, R23, R24, R25, R26, R27, R28, R29, R30, R31, R32 | 32 | 32 | 33R | R_0402_1005Metric | SMT | RC0402FR-0733RL | YAGEO | RC0402FR-0733RL | 603-RC0402FR-0733RL | stock-indexed | 1477025 | last month | 2026-10-22 | https://eu.mouser.com/en/ProductDetail/YAGEO/RC0402FR-0733RL?qs=V1yeUXFNrkk7PcMc%252BKdghg%3D%3D | 33 ohm, 1%, 0402; RGB/timing source termination.
giga-adapter | F | R33, R34, R35, R36, R37, R38, R39, R40, R41, R42, R43, R44, R45, R46, R47, R48, R49, R50, R51, R52, R53, R54, R55, R56, R57, R58, R59, R60, R61, R62, R63, R64, R65 | 33 | 33 | 47k | R_0402_1005Metric | SMT | RC0402FR-0747KL | YAGEO | RC0402FR-0747KL | 603-RC0402FR-0747KL | stock-indexed | 986351 | last month | 2026-10-22 | https://eu.mouser.com/en/ProductDetail/YAGEO/RC0402FR-0747KL?qs=V1yeUXFNrklslMUO6Zhx5g%3D%3D | 47 kohm, 1%, 0402.
giga-adapter | F | C1, C2, C3, C4, C5, C6, C7, C8, C9, C10, C11, C12, C20, C21 | 14 | 14 | 100n / 50V X7R | C_0603_1608Metric | SMT | GRM188R71C104KA01D | KEMET | C0603C104K5RACTU | 80-C0603C104K5R | stock-indexed | 3941024 | last week | 2026-10-22 | https://cz.mouser.com/en/ProductDetail/KEMET/C0603C104K5RACTU?qs=l5k%252BbMnNDkkVcnZPSAaaiQ%3D%3D | Replacement for EOL original: 100 nF +/-10%, X7R, 0603; voltage rating increased from 16 V to 50 V. Consolidated with display C10.
giga-adapter | F | U5, U9 | 2 | 2 | SN74AXC1T45DBVR | SOT-23-6 | SMT | SN74AXC1T45DBVR | Texas Instruments | SN74AXC1T45DBVR | 595-SN74AXC1T45DBVR | stock-indexed | 6687 | last month | 2026-10-22 | https://www.mouser.com/en/ProductDetail/Texas-Instruments/SN74AXC1T45DBVR?qs=W0yvOO0ixfHY47jVlAKDLA%3D%3D | SOT-23-6; both U5 and U9 are required.
giga-adapter | F | U6 | 1 | 1 | TCA9517ADGKR | VSSOP-8_3x3mm_P0.65mm | SMT | TCA9517ADGKR | Texas Instruments | TCA9517ADGKR | 595-TCA9517ADGKR | stock-indexed | 254 | 3 weeks ago | 2026-10-22 | https://eu.mouser.com/en/ProductDetail/Texas-Instruments/TCA9517ADGKR?qs=%252BrH4t%252BeVZ2M4pVnwXR4oNA%3D%3D | VSSOP-8 DGK package; retain A variant.
giga-adapter | F | C13, C14 | 2 | 2 | 10u / 10V X5R | C_0805_2012Metric | SMT | GRM21BR61A106KE19L | KEMET | C0805C106K8PACTU | 80-C0805C106K8P | stock-indexed | 235800 | last week | 2026-10-22 | https://eu.mouser.com/en/ProductDetail/KEMET/C0805C106K8PACTU?qs=Zpyg6gQUYs39C21BeavaKA%3D%3D | Replacement for obsolete original: 10 uF +/-10%, 10 V, X5R, 0805; 1.25 +/-0.15 mm height.
giga-adapter | F | J10 | 1 | 0 | DC-005 / 24V centre+ | BarrelJack_Horizontal_AISLER | HAND | DC-005 / B07J4Z8B2T | Sourcing Map | DC-005 / B07J4Z8B2T |  | owned |  |  | 2026-10-22 |  | User already has the jack. Required on GIGA J10; purchase quantity zero.
giga-adapter | F | F1 | 1 | 1 | 2A / 65V time-lag | Fuse_Bourns_SF-1206SA-M | SMT | SF-1206SA200M-2 | Bourns | SF-1206SA200M-2 | 652-SF-1206SA200M-2 | stock-indexed | 15000 | last month | 2026-10-22 | https://hu.mouser.com/en/ProductDetail/Bourns/SF-1206SA200M-2?qs=ljCeji4nMDm8iHTYJACKFQ%3D%3D | 2 A / 65 VDC slow-blow; 50 A interrupt rating. Dedicated Bourns 1206 land pattern. Manufacturer datasheet overrides Mouser short description of 35 V. See input-fuse power budget; stock is indexed, not live confirmed.
giga-adapter | F | D1 | 1 | 1 | 33V bidirectional TVS | D_SMB | SMT | SMBJ33CA | Diodes Incorporated | SMBJ33CA-13-F | 621-SMBJ33CA-13-F | stock-indexed | 64961 | last month | 2026-10-22 | https://www.mouser.com/en/ProductDetail/Diodes-Incorporated/SMBJ33CA-13-F?qs=gaDBXWSqsDCWsx7MwPOf0g%3D%3D | Replacement for backordered Littelfuse: bidirectional 33 V, 600 W TVS in SMB; 53.3 V maximum specified clamp. Do not use unidirectional A.
giga-adapter | F | C15 | 1 | 1 | 1u / 100V X7R | C_1206_3216Metric | SMT | GRM31CR72A105KA01L | KEMET | C1206C105K1RACTU | 80-C1206C105K1R | stock-indexed | 41000 | last month | 2026-10-22 | https://www.mouser.se/en/ProductDetail/KEMET/C1206C105K1RACTU | Replacement: 1 uF +/-10%, 100 V, X7R, 1206; original backordered.
giga-adapter | F | U7 | 1 | 1 | TPS26600PWPT | HTSSOP-16_PWP0016A_EP3.3x3.3mm | SMT | TPS26600PWPR | Texas Instruments | TPS26600PWPT | 595-TPS26600PWPT | stock-indexed | 3539 | 3 weeks ago | 2026-10-23 | https://www.mouser.com/en/ProductDetail/Texas-Instruments/TPS26600PWPT?qs=Bho%2FbeBaDEx8u36zNhDCVA%3D%3D | Approved packaging-only replacement: same TPS26600 and PWP HTSSOP-16 exposed-pad package; T = 250-piece reel versus R = 2000-piece reel. Cut tape available. Exposed pad remains RTN, not GND. No circuit or footprint change.
giga-adapter | F | R66 | 1 | 1 | 143k / 1% | R_0603_1608Metric | SMT | RC0603FR-07143KL | YAGEO | RC0603FR-07143KL | 603-RC0603FR-07143KL | stock-indexed | 21769 | last week | 2026-10-22 | https://www.mouser.tw/en/ProductDetail/YAGEO/RC0603FR-07143KL?qs=IuGqVx9wL0I9yevS9IvNIg%3D%3D | 143 kohm, 1%, 0603.
giga-adapter | F | R67, R69, R71 | 3 | 3 | 10k / 1% | R_0603_1608Metric | SMT | RC0603FR-0710KL | YAGEO | RC0603FR-0710KL | 603-RC0603FR-0710KL | stock-indexed | 1640807 | last week | 2026-10-22 | https://www.mouser.com/en/ProductDetail/YAGEO/RC0603FR-0710KL?qs=grNVn54RoB%252B3GtjbJj3wJQ%3D%3D | 10 kohm, 1%, 0603.
giga-adapter | F | R68 | 1 | 1 | 226k / 1% | R_0603_1608Metric | SMT | RC0603FR-07226KL | YAGEO | RC0603FR-07226KL | 603-RC0603FR-07226KL | stock-indexed | 141223 | last month | 2026-10-22 | https://www.mouser.com/en/ProductDetail/YAGEO/RC0603FR-07226KL?qs=0yPvnVz5%2Fmr%2FHz6oBKp3LQ%3D%3D | 226 kohm, 1%, 0603.
giga-adapter | F | R70 | 1 | 1 | 8.06k / 1% | R_0603_1608Metric | SMT | RC0603FR-078K06L | YAGEO | RC0603FR-078K06L | 603-RC0603FR-078K06L | stock-indexed | 47045 | last week | 2026-10-22 | https://eu.mouser.com/en/ProductDetail/YAGEO/RC0603FR-078K06L?qs=2cAdsCoAWREXE%2FuVdbo5eQ%3D%3D | 8.06 kohm, 1%, 0603.
giga-adapter | F | C16 | 1 | 1 | 47n / 50V X7R | C_0603_1608Metric | SMT | GRM188R71C473KA01D | TDK | C1608X7R1H473K080AA | 810-C1608X7R1H473K | stock-indexed | 69961 | 3 weeks ago | 2026-10-23 | https://www.mouser.com/en/ProductDetail/TDK/C1608X7R1H473K080AA?qs=NRhsANhppD9%252BEs9R%2FCqqmw%3D%3D | Approved purchasing replacement: 47 nF +/-10%, 50 V, X7R, 0603; same nominal specification as the unavailable KEMET selection, voltage rating exceeds released BOM 16 V. No footprint change.
giga-adapter | F | C17, C18 | 2 | 2 | 10u / 50V X7R | C_1210_3225Metric | SMT | GRM32ER71H106KA12L | TAIYO YUDEN | MCJCU32MLB7106KPPDTJ | 963-U32MLB7106KPPDTJ | stock-indexed | 1535 | 2 months ago | 2026-10-22 | https://my.mouser.com/en/ProductDetail/TAIYO-YUDEN/MCJCU32MLB7106KPPDTJ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 | Replacement: 10 uF +/-10%, 50 V, X7R, 1210, soft termination; 2.5 +/-0.3 mm height. Original unavailable/region-restricted.
giga-adapter | F | D2, D3 | 2 | 2 | 60V / 3A Schottky | D_SMA | SMT | B360A-13-F | Diodes Incorporated | B360A-13-F | 621-B360A-F | stock-indexed | 112297 | 3 months ago | 2026-10-22 | https://au.mouser.com/ProductDetail/Diodes-Incorporated/B360A-13-F?qs=sVoUGXYOGv3xoCWNHVb4bA%3D%3D | 60 V / 3 A Schottky, SMA (DO-214AC); not SMB.
giga-adapter | F | F2 | 1 | 1 | 0.8A / 63V time-lag | Fuse_1206_3216Metric | SMT | SF-1206S080-2 | Bourns | SF-1206S080-2 | 652-SF-1206S080-2 | stock-indexed | 3718 | unspecified | 2026-10-22 | https://www.mouser.com/pdfdocs/bourns_singlfuse_short_form-2.pdf | 0.8 A / 63 V time-lag 1206; not a resettable PTC.
giga-adapter | F | U8 | 1 | 1 | TSR 1-24120 / 12V 1A | Converter_DCDC_TRACO_TSR-1_THT | HAND | TSR 1-24120 | TRACO Power | TSR 1-24120 | 495-TSR-1-24120 | stock-indexed | 5150 | last month | 2026-10-22 | https://www.mouser.com/en/ProductDetail/TRACO-Power/TSR-1-24120?qs=ckJk83FOD0XFyuKFnkiJHw%3D%3D | 12 V / 1 A; through-hole SIP module.
giga-adapter | F | C19 | 1 | 1 | 10u / 25V X5R | C_0805_2012Metric | SMT | GRM21BR61E106KA73L | KYOCERA AVX | 08053D106KAT2A | 581-08053D106KAT2A | stock-indexed | 37 | last month | 2026-10-22 | https://www.mouser.com/en/ProductDetail/KYOCERA-AVX/08053D106KAT2A?qs=RC%2FTMc7rOJbkID75Q0PA3w%3D%3D | Replacement: 10 uF +/-10%, 25 V, X5R, 0805; original backordered.
giga-adapter | F | J2 | 1 | 1 | JDIGITAL 1..10 | GIGA_J2_JDIGITAL | HAND | SSQ-110-03-G-S | Samtec | SSQ-110-03-G-S | 200-SSQ11003GS | stock-indexed | 1271 | 4 months ago | 2026-10-22 | https://www.mouser.com/ProductDetail/Samtec/SSQ-110-03-G-S?qs=0u6pJ%2FESxi2TyhdgZpByhg%3D%3D | 1x10 socket; -03 = 10 mm tails.
giga-adapter | F | J3 | 1 | 1 | JDIGITAL 11..18 | GIGA_J3_JDIGITAL | HAND | SSQ-108-03-G-S | Samtec | SSQ-108-03-G-S | 200-SSQ10803GS | stock-indexed | 2289 | 5 months ago | 2026-10-22 | https://eu.mouser.com/ProductDetail/Samtec/SSQ-108-03-G-S?qs=92ilVni64gxESeLoQPf0Dw%3D%3D | 1x8 socket; five required; -03 = 10 mm tails.
giga-adapter | F | J4 | 1 | 1 | JDIGITAL 19..26 | GIGA_J4_JDIGITAL | HAND | SSQ-108-03-G-S | Samtec | SSQ-108-03-G-S | 200-SSQ10803GS | stock-indexed | 2289 | 5 months ago | 2026-10-22 | https://eu.mouser.com/ProductDetail/Samtec/SSQ-108-03-G-S?qs=92ilVni64gxESeLoQPf0Dw%3D%3D | 1x8 socket; five required; -03 = 10 mm tails.
giga-adapter | F | J5 | 1 | 1 | JANALOG 1..8 | GIGA_J5_JANALOG | HAND | SSQ-108-03-G-S | Samtec | SSQ-108-03-G-S | 200-SSQ10803GS | stock-indexed | 2289 | 5 months ago | 2026-10-22 | https://eu.mouser.com/ProductDetail/Samtec/SSQ-108-03-G-S?qs=92ilVni64gxESeLoQPf0Dw%3D%3D | 1x8 socket; five required; -03 = 10 mm tails.
giga-adapter | F | J6 | 1 | 1 | JANALOG 9..16 | GIGA_J6_JANALOG | HAND | SSQ-108-03-G-S | Samtec | SSQ-108-03-G-S | 200-SSQ10803GS | stock-indexed | 2289 | 5 months ago | 2026-10-22 | https://eu.mouser.com/ProductDetail/Samtec/SSQ-108-03-G-S?qs=92ilVni64gxESeLoQPf0Dw%3D%3D | 1x8 socket; five required; -03 = 10 mm tails.
giga-adapter | F | J7 | 1 | 1 | JANALOG 17..24 | GIGA_J7_JANALOG | HAND | SSQ-108-03-G-S | Samtec | SSQ-108-03-G-S | 200-SSQ10803GS | stock-indexed | 2289 | 5 months ago | 2026-10-22 | https://eu.mouser.com/ProductDetail/Samtec/SSQ-108-03-G-S?qs=92ilVni64gxESeLoQPf0Dw%3D%3D | 1x8 socket; five required; -03 = 10 mm tails.
giga-adapter | F | J8 | 1 | 1 | JSIDE 1..36 | GIGA_J8_JSIDE | HAND | SSQ-118-03-G-D | Samtec | SSQ-118-03-G-D | 200-SSQ11803GD | stock-indexed | 80 | last week | 2026-10-22 | https://www.mouser.com/en/c/connectors/?number+of+positions=36+Position&product=Headers&type=Socket | 2x18 socket; -03 = 10 mm tails.
giga-adapter | F | J9 | 1 | 1 | J5 1..24 | GIGA_J9_J5 | HAND | SSQ-112-04-G-D | Samtec | SSQ-112-04-G-D | 200-SSQ11204GD | stock-indexed | 261 | 3 months ago | 2026-10-22 | https://www.mouser.com/ProductDetail/Samtec/SSQ-112-04-G-D?qs=rU5fayqh%252BE0yGPselSDHYw%3D%3D | 2x12 socket; -04 = 14.83 mm tails. Do not replace with -03.
