daleondev/ProtoMate_Control/hardware/perfboard/assembly/System_Parts.csv

Reference | Part or value | Quantity | Do not populate | Location
A1 | Arduino GIGA R1 WiFi / ABX00063 | 1 |  | External
A2 | DM542T V4.0 | 1 |  | External
A3 | Adafruit #6121 / TMC2209 | 1 |  | Perfboard module on J105
A4 | Adafruit #6121 / TMC2209 | 1 |  | Perfboard module on J106
C1 | 100u / 50V | 1 |  | Perfboard
C2 | 100u / 50V | 1 |  | Perfboard
C3 | 100n | 1 |  | Perfboard
C4 | 100n | 1 |  | Perfboard
C5 | 1u | 1 |  | Perfboard
C6 | 1u | 1 |  | Perfboard
J1 | U1 barrel jack / 24 V | 1 |  | On U1 (existing barrel jack)
J2 | M1 encoder / 8-pin | 1 |  | External
J101 | GIGA motion / 2x06 | 1 |  | Perfboard
J102 | GIGA encoder / 2x03 | 1 |  | Perfboard
J103 | U1 buck direct mount | 1 |  | Perfboard
J104 | DM542T control + ALM + power / screw 5.08 mm | 1 |  | Perfboard
J105 | M2 TMC2209 direct mount | 1 |  | Perfboard
J106 | M3 TMC2209 direct mount | 1 |  | Perfboard
J107 | M1 encoder / 1x08 | 1 |  | Perfboard
J108 | GIGA references / 1x04 | 1 |  | Perfboard
J109 | M1 NC switch / 1x02 | 1 |  | Perfboard
J110 | M2 NC switch / 1x02 | 1 |  | Perfboard
J111 | M3 NC switch / 1x02 | 1 |  | Perfboard
J113 | GIGA UART / DIAG / INDEX / 2x04 | 1 |  | Perfboard
M1 | PKP245D23A2-R2FL | 1 |  | External
M2 | C17HD2024-01N | 1 |  | External
M3 | BJ42D15-26V10 | 1 |  | External
Q1 | 2N2222A | 1 |  | Perfboard
Q2 | 2N2222A | 1 |  | Perfboard
Q3 | 2N2222A | 1 |  | Perfboard
Q4 | 2N2222A | 1 |  | Perfboard
Q5 | 2N2222A | 1 |  | Perfboard
Q6 | 2N2222A | 1 |  | Perfboard
R1 | 1k | 1 |  | Perfboard
R2 | 10k | 1 |  | Perfboard
R3 | 1k | 1 |  | Perfboard
R4 | 10k | 1 |  | Perfboard
R5 | 1k | 1 |  | Perfboard
R6 | 10k | 1 |  | Perfboard
R7 | 470R | 1 |  | Perfboard
R8 | 10k | 1 |  | Perfboard
R9 | 10k | 1 |  | Perfboard
R10 | DNP | 1 | DNP | Perfboard
R11 | DNP | 1 | DNP | Perfboard
R12 | DNP | 1 | DNP | Perfboard
R20 | 4k7 | 1 |  | Perfboard
R21 | 10k | 1 |  | Perfboard
R22 | 1k | 1 |  | Perfboard
R23 | 4k7 | 1 |  | Perfboard
R24 | 10k | 1 |  | Perfboard
R25 | 1k | 1 |  | Perfboard
R26 | 4k7 | 1 |  | Perfboard
R27 | 10k | 1 |  | Perfboard
R28 | 1k | 1 |  | Perfboard
R29 | 1k | 1 |  | Perfboard
R30 | 4k7 | 1 |  | Perfboard
SW1 | M1 Ender-3 V2 / NC | 1 |  | External
SW2 | M2 Ender-3 V2 / NC | 1 |  | External
SW3 | M3 Ender-3 V2 / NC | 1 |  | External
U1 | QIQIAZI 5 V / 5 A | 1 |  | Perfboard module on J103
U2 | AM26C32CN / DIP-16 | 1 |  | Perfboard
U3 | SN74HC126N / DIP-14 | 1 |  | Perfboard
