daleondev/ProtoMate_Control/hardware/display/manufacturing/verification/display-adapter-visual/component-J1-B.png

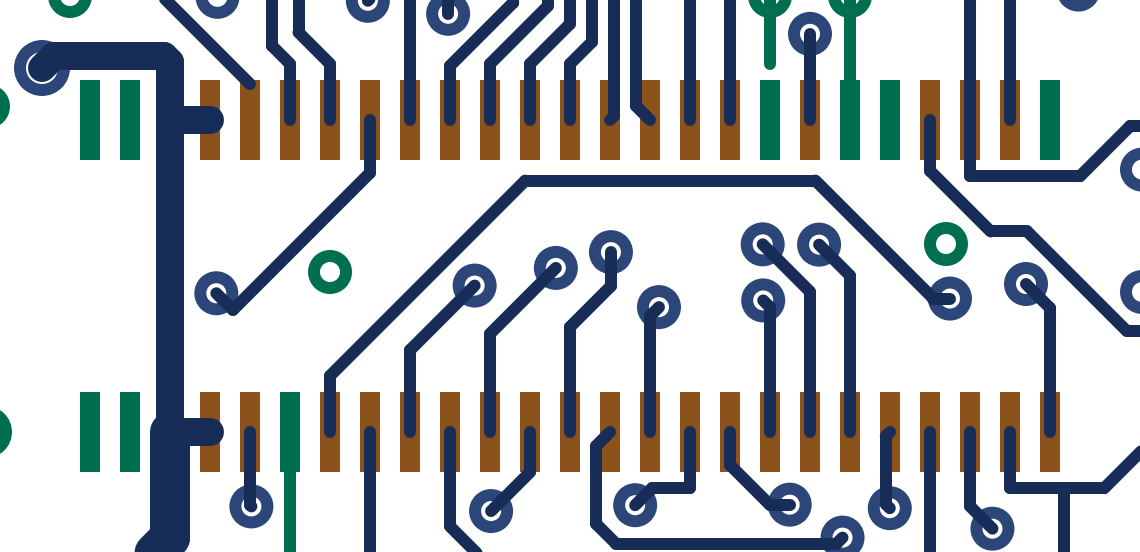
hardware/display/manufacturing/verification/display-adapter-visual/component-J1-B.png
