daleondev/ProtoMate_Control/hardware/display/manufacturing/verification/display-adapter-visual/component-J2-F.png

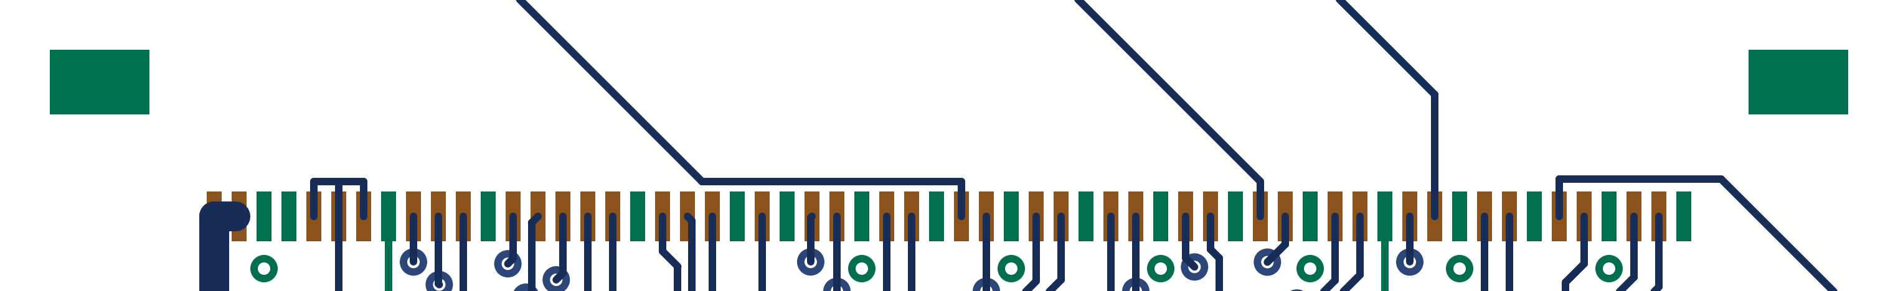
hardware/display/manufacturing/verification/display-adapter-visual/component-J2-F.png
