daleondev/ProtoMate_Control/hardware/display/manufacturing/verification/display-adapter-visual/component-U3-B.png

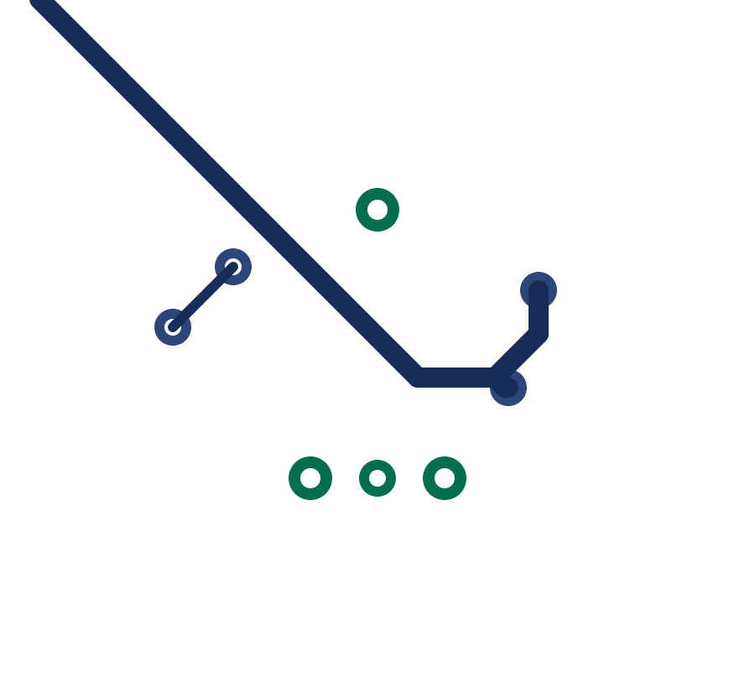
hardware/display/manufacturing/verification/display-adapter-visual/component-U3-B.png
