daleondev/ProtoMate_Control/hardware/display/manufacturing/verification/display-adapter-visual/component-U4-F.png

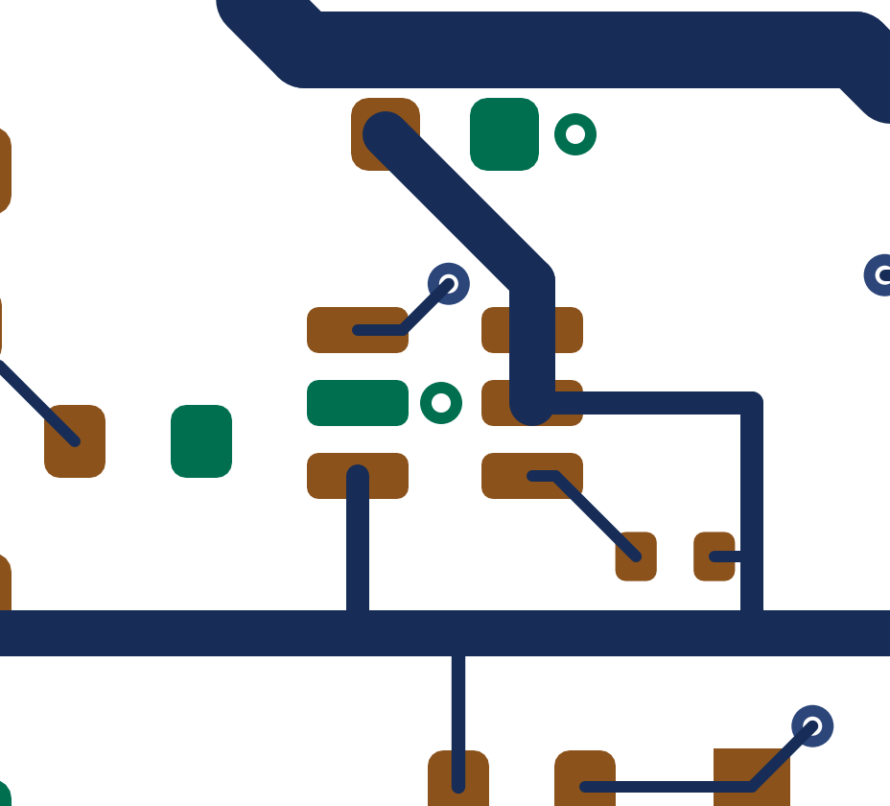
hardware/display/manufacturing/verification/display-adapter-visual/component-U4-F.png
