daleondev/ProtoMate_Control/hardware/display/manufacturing/verification/giga-adapter-visual/component-F2-B.png

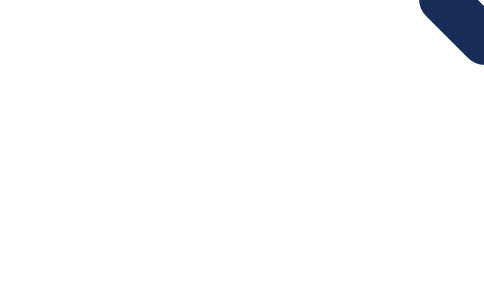
hardware/display/manufacturing/verification/giga-adapter-visual/component-F2-B.png
