daleondev/ProtoMate_Control/hardware/display/manufacturing/verification/giga-adapter-visual/component-J2-B.png

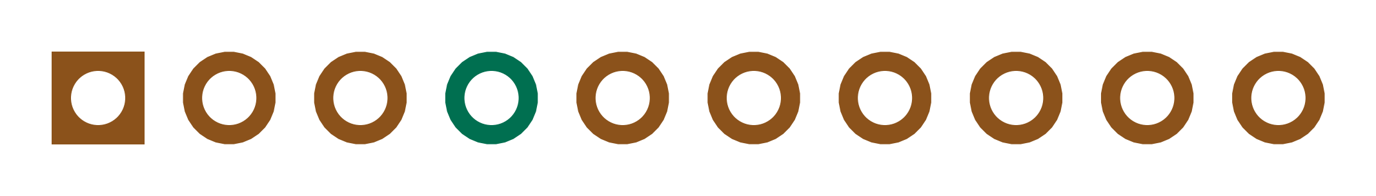
hardware/display/manufacturing/verification/giga-adapter-visual/component-J2-B.png
