daleondev/ProtoMate_Control/hardware/display/manufacturing/verification/giga-adapter-visual/component-J5-F.png

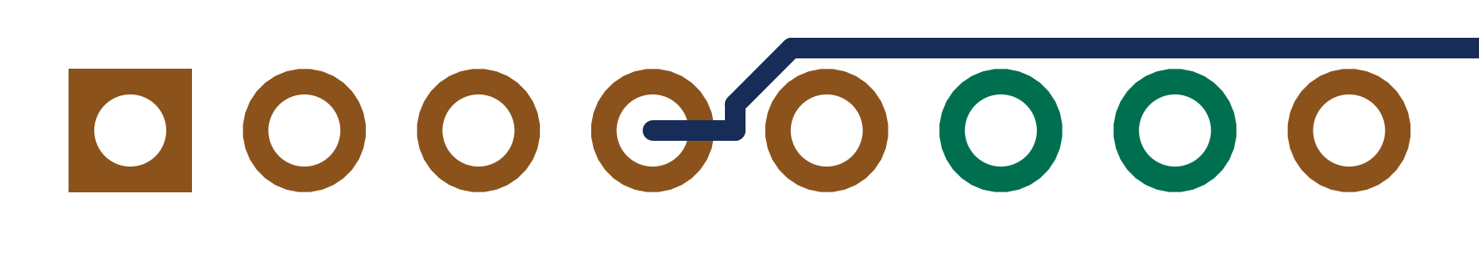
hardware/display/manufacturing/verification/giga-adapter-visual/component-J5-F.png
