daleondev/ProtoMate_Control/hardware/display/manufacturing/verification/giga-adapter-visual/component-J8-B.png

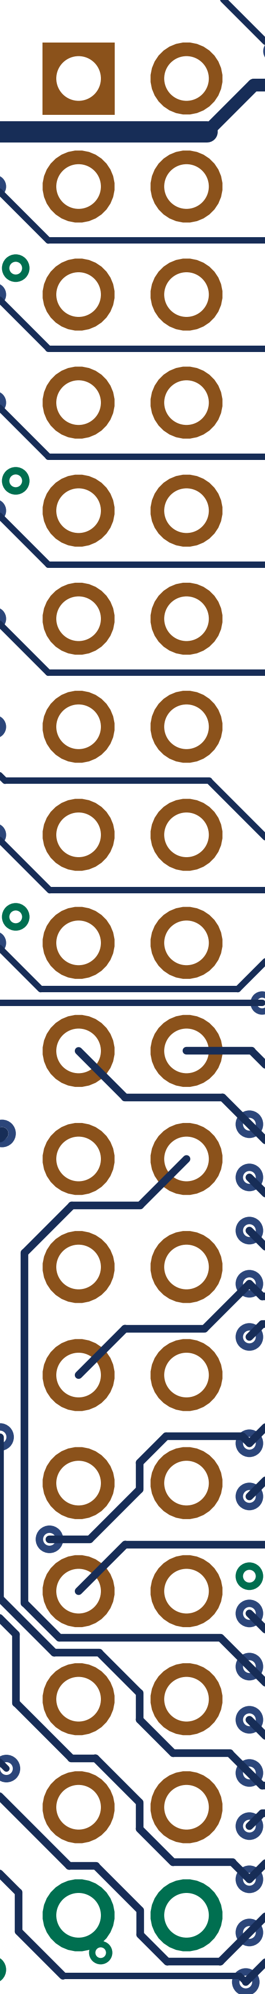
hardware/display/manufacturing/verification/giga-adapter-visual/component-J8-B.png
