daleondev/ProtoMate_Control/hardware/display/manufacturing/verification/giga-adapter-visual/component-U1-F.png

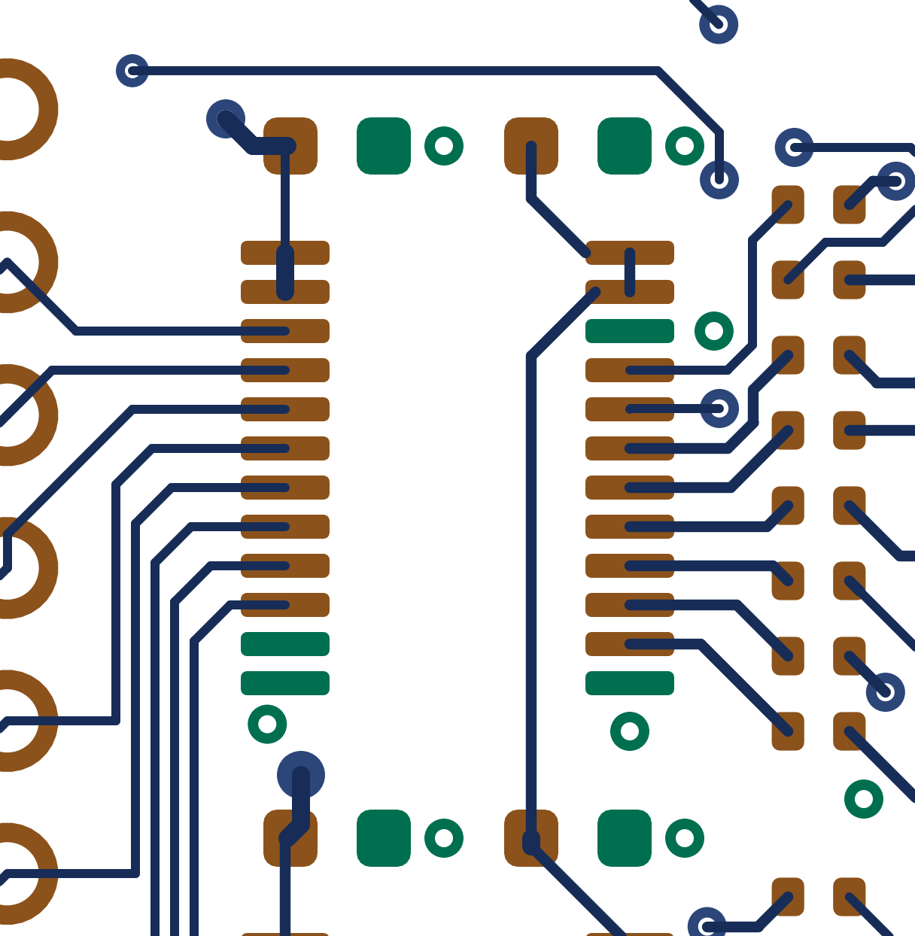
hardware/display/manufacturing/verification/giga-adapter-visual/component-U1-F.png
