daleondev/ProtoMate_Control/hardware/display/manufacturing/verification/giga-adapter-visual/component-U2-F.png

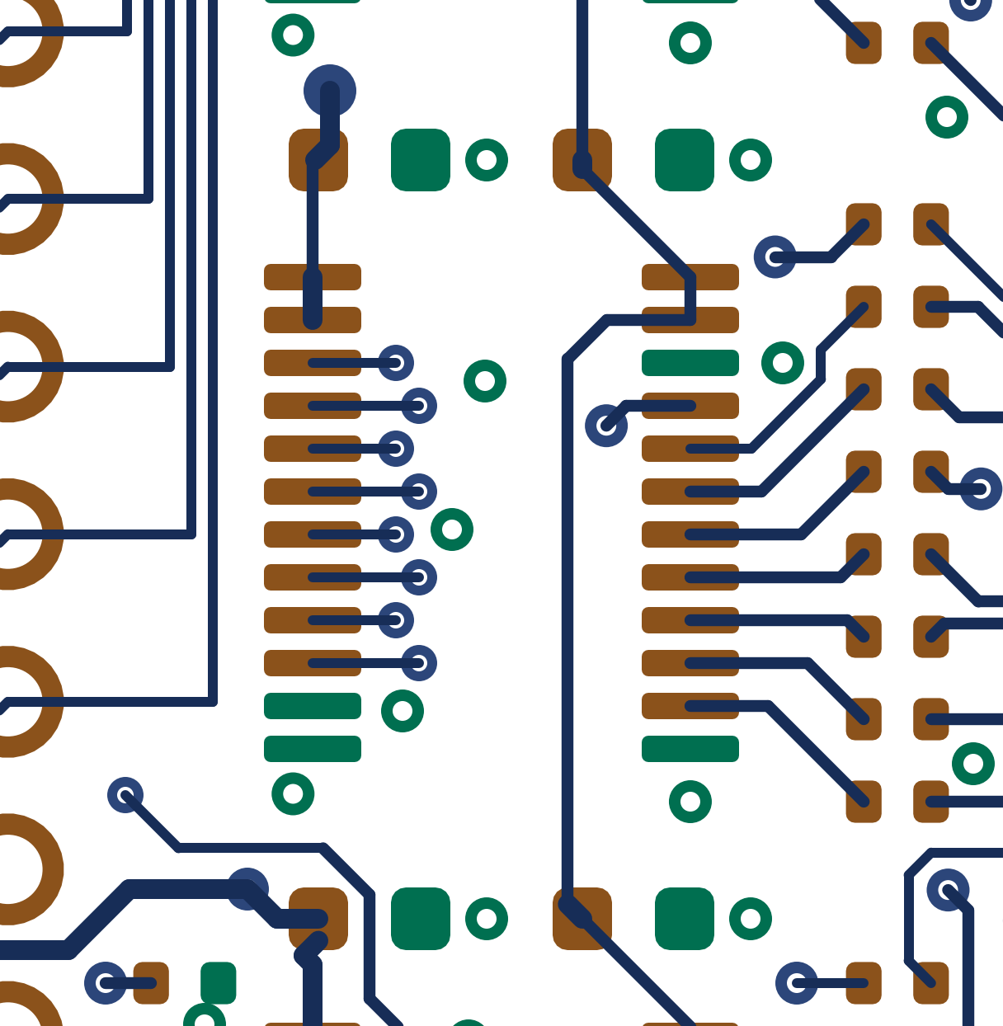
hardware/display/manufacturing/verification/giga-adapter-visual/component-U2-F.png
