daleondev/ProtoMate_Control/hardware/display/manufacturing/verification/giga-adapter-visual/component-U6-F.png

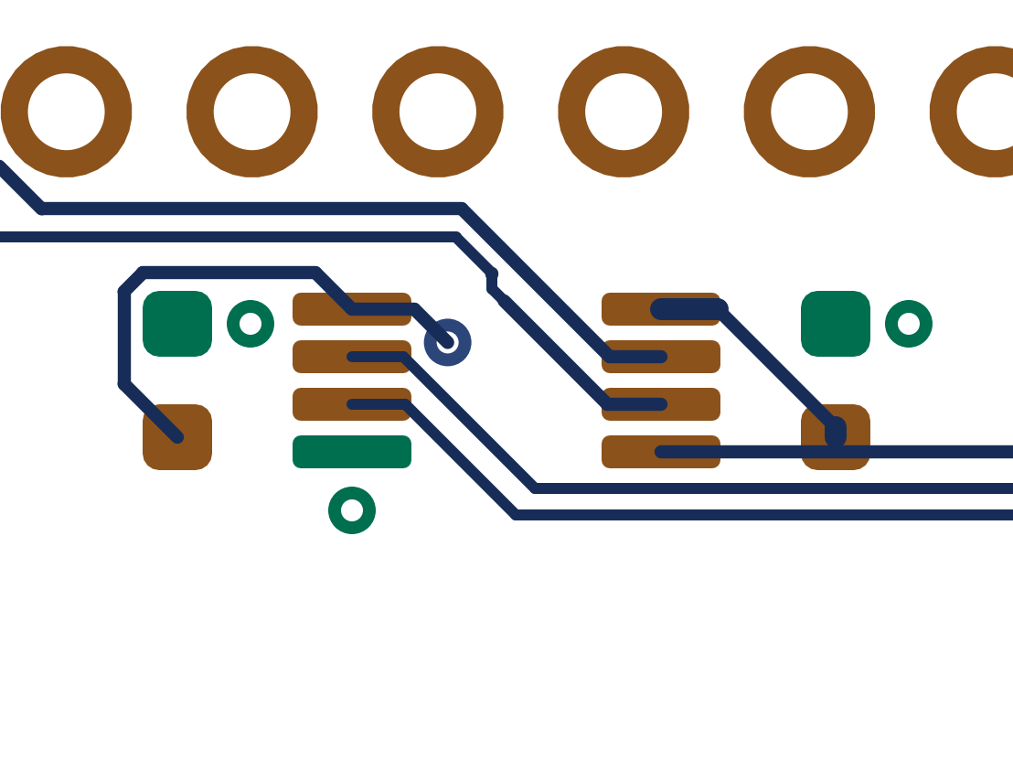
hardware/display/manufacturing/verification/giga-adapter-visual/component-U6-F.png
