daleondev/ProtoMate_Control/hardware/display/manufacturing/verification/giga-adapter-visual/component-U7-B.png

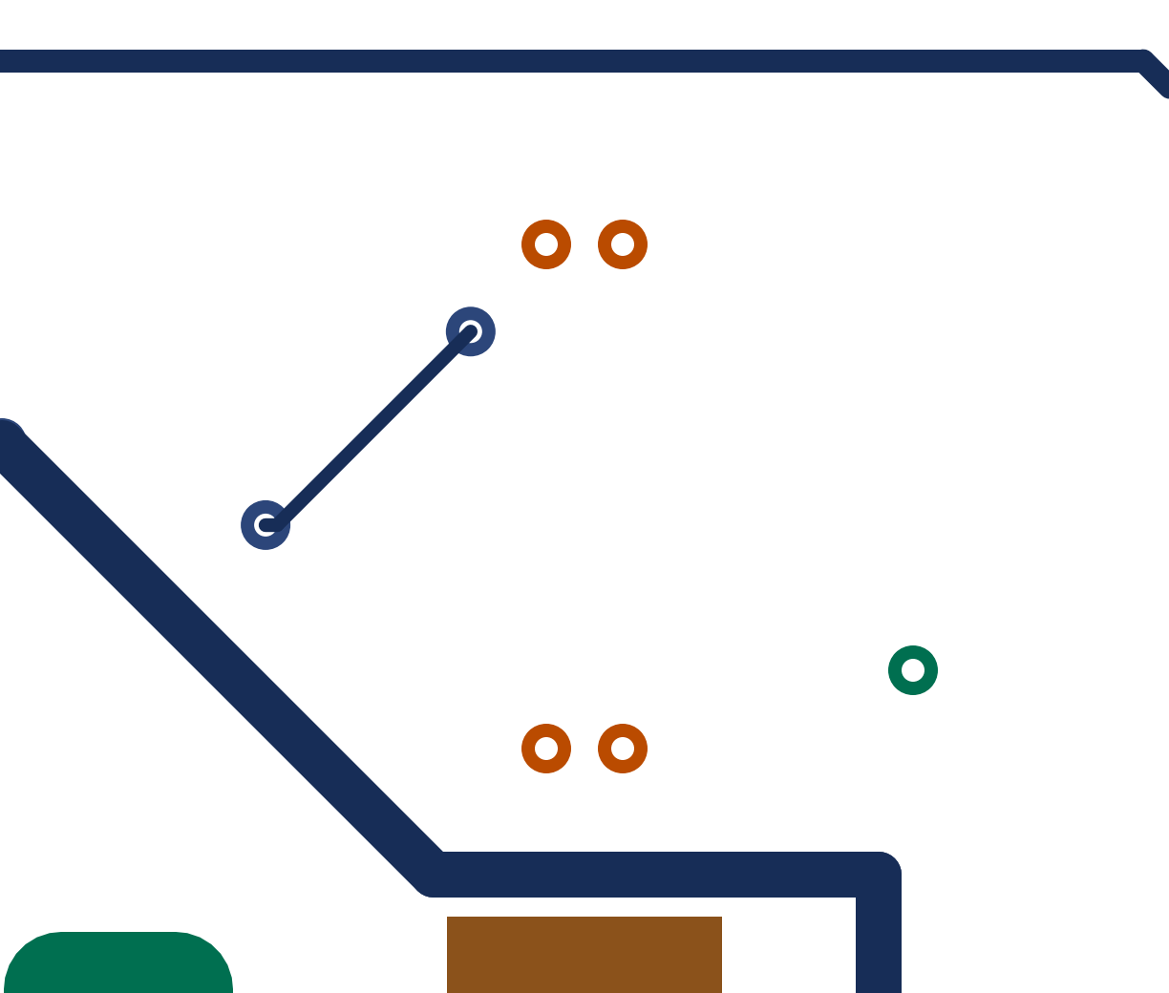
hardware/display/manufacturing/verification/giga-adapter-visual/component-U7-B.png
