daleondev/ProtoMate_Control/hardware/display/manufacturing/verification/giga-adapter-visual/component-U7-F.png

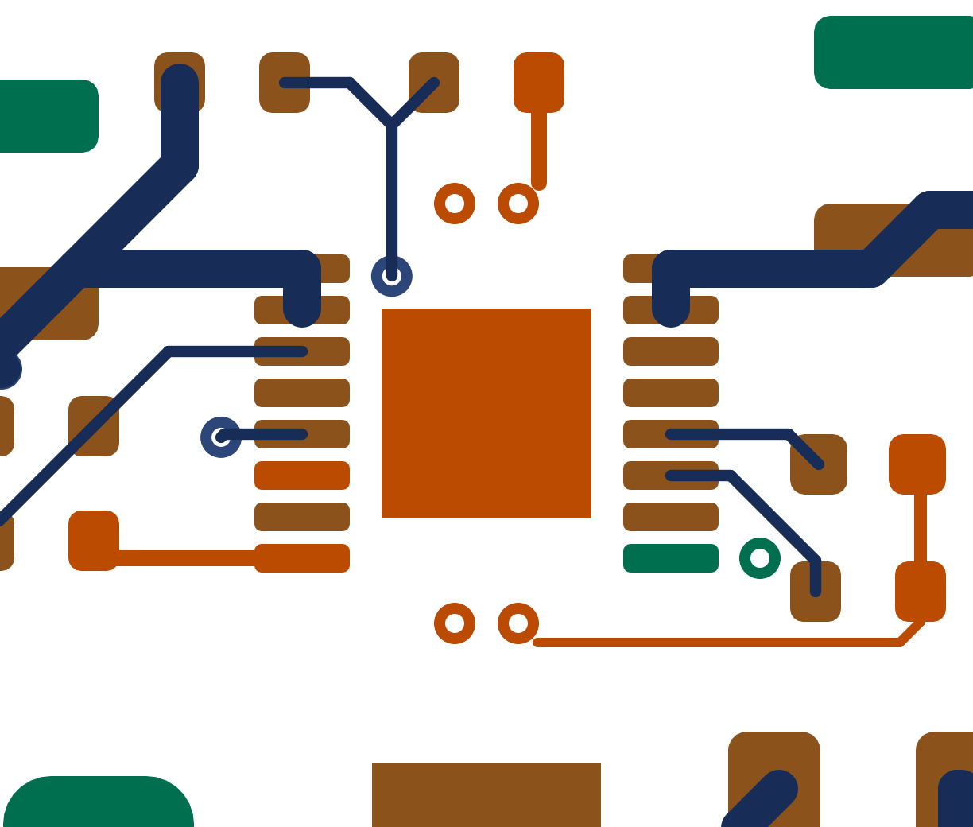
hardware/display/manufacturing/verification/giga-adapter-visual/component-U7-F.png
