daleondev/ProtoMate_Control/hardware/display/manufacturing/verification/giga-adapter-visual/component-U8-F.png

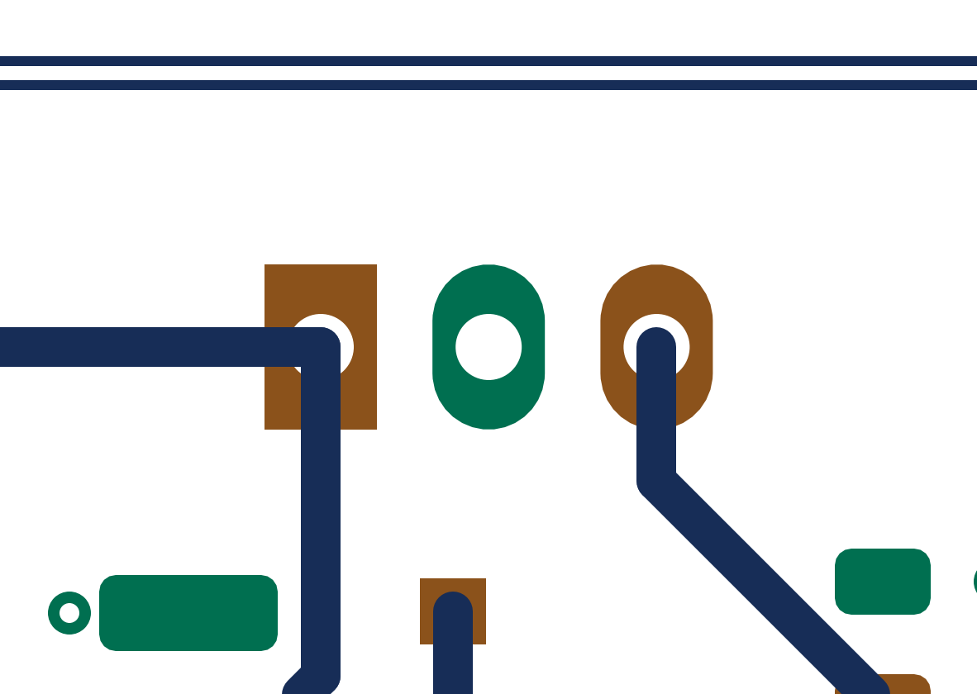
hardware/display/manufacturing/verification/giga-adapter-visual/component-U8-F.png
