daleondev/ProtoMate_Control/hardware/display/manufacturing/verification/giga-adapter-visual/component-U9-B.png

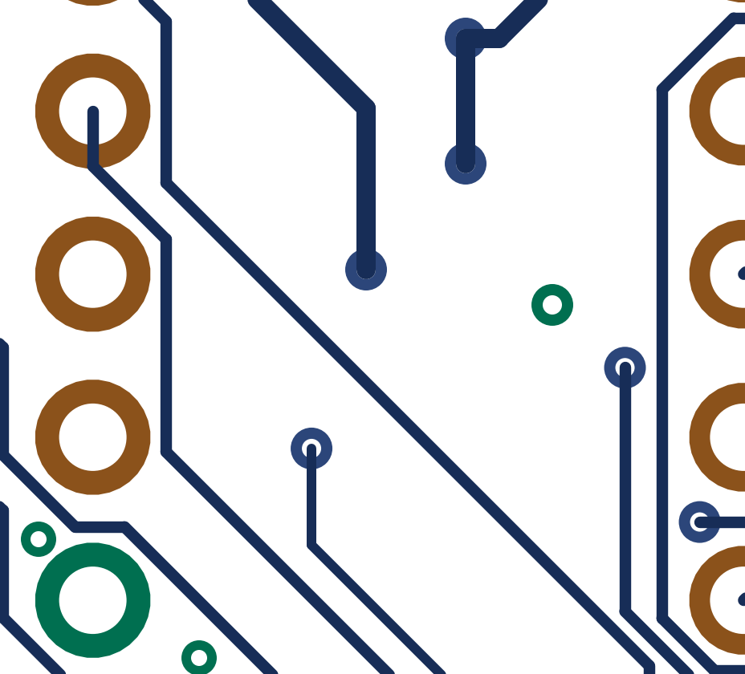
hardware/display/manufacturing/verification/giga-adapter-visual/component-U9-B.png
