daleondev/ProtoMate_Control/hardware/display/manufacturing/verification/giga-adapter-visual/component-U9-F.png

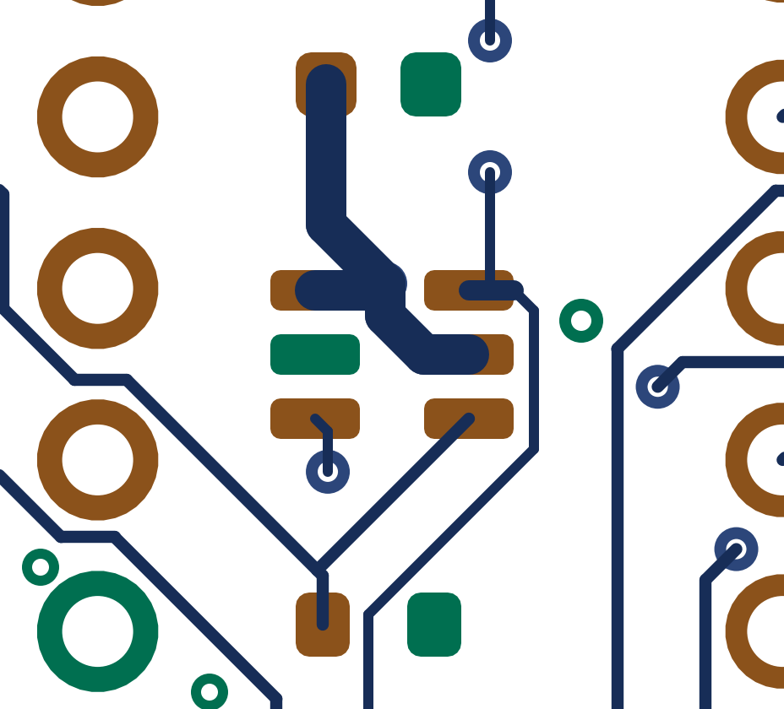
hardware/display/manufacturing/verification/giga-adapter-visual/component-U9-F.png
