daleondev/ProtoMate_Control/docs/BuckConverter.step

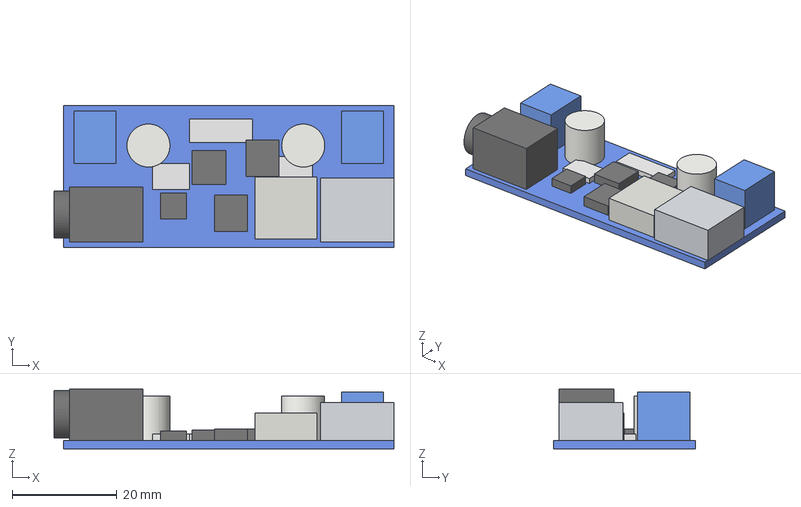
[picture p56: CAD file, 2026-10-04]
docs/BuckConverter.step
64.8 x 27.0 x 11.4 mm
PCB_63x27x1.6
DC_barrel_jack_body
DC_barrel_jack_nose
VIN_screw_terminal
USB_A_receptacle
VOUT_screw_terminal
Power_inductor_330
Input_capacitor
Output_capacitor
Buck_controller_IC
Power_MOSFET_1
Power_MOSFET_2
USB_charge_controller
Passives_keepout_A
Passives_keepout_B
Passives_keepout_C
