daleondev/ProtoMate_Control/hardware/display/assembly/giga-mated-rev-F.step

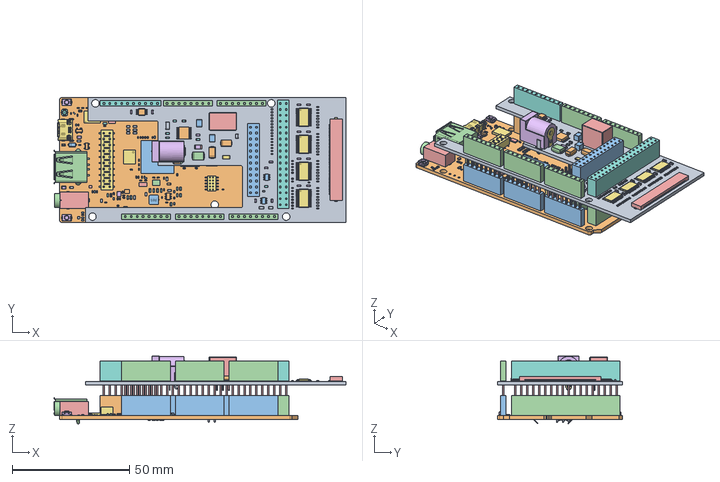
[picture p57: CAD file, 2026-10-23]
hardware/display/assembly/giga-mated-rev-F.step
124.4 x 53.3 x 28.9 mm
