daleondev/ProtoMate_Control/hardware/display/manufacturing/display-adapter-rev-G/display-adapter.step

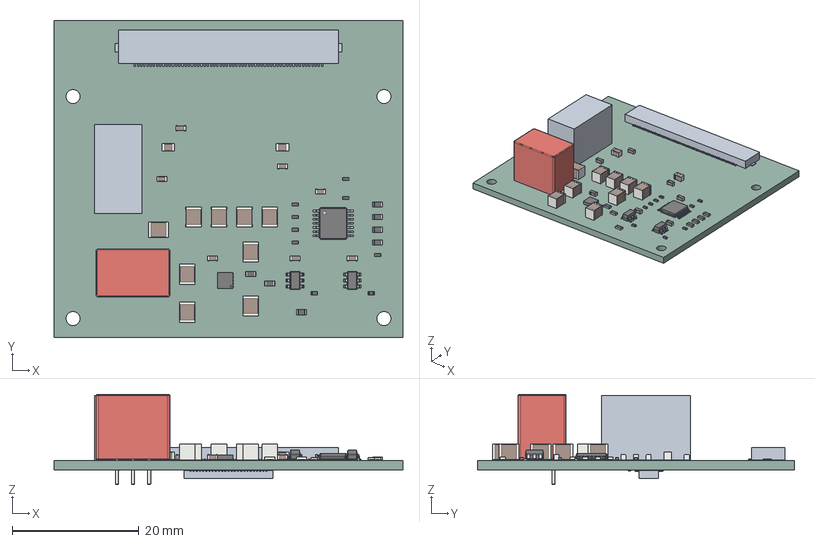
[picture p58: CAD file, 2026-10-23]
hardware/display/manufacturing/display-adapter-rev-G/display-adapter.step
55.0 x 50.0 x 14.2 mm
R_0402_1005Metric x 9
Converter_DCDC_TRACO_TSR_1_THT
C_0603_1608Metric x 7
R_0603_1608Metric x 7
C_1210_3225Metric x 9
SOT-23-6 x 2
7a0a93aa-926b-11ed-8620-a0cec80452fd_part
7a0a9878-926b-11ed-8620-a0cec80452fd_part
7a0a9b48-926b-11ed-8620-a0cec80452fd_part
7a0a9db4-926b-11ed-8620-a0cec80452fd_part
C_0805_2012Metric x 2
TSSOP-14_4.4x5mm_P0.65mm
display-adapter_PCB
