daleondev/ProtoMate_Control/hardware/display/manufacturing/giga-adapter-rev-F/giga-adapter.step

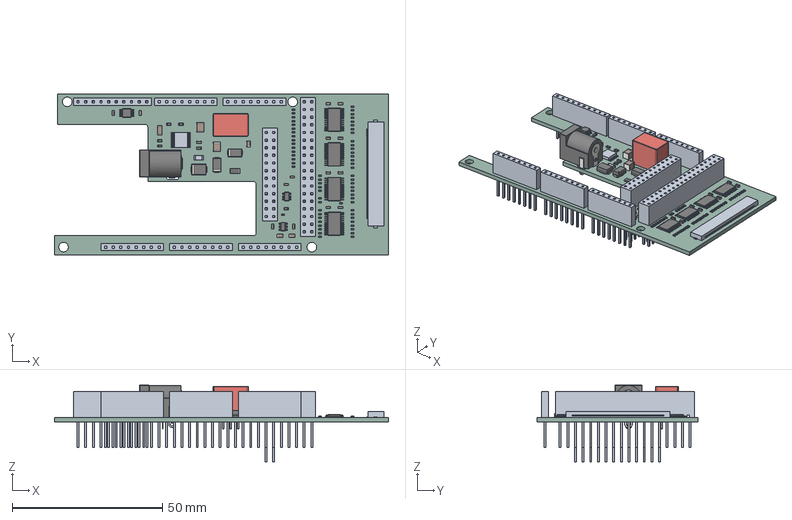
[picture p59: CAD file, 2026-10-23]
hardware/display/manufacturing/giga-adapter-rev-F/giga-adapter.step
111.0 x 53.3 x 25.5 mm
R_0402_1005Metric x 65
D_SMA x 2
C_1210_3225Metric x 2
C_0603_1608Metric x 15
TSSOP-24_4.4x7.8mm_P0.65mm x 4
R_0603_1608Metric x 6
C_0805_2012Metric x 3
VSSOP-8_3x3mm_P0.65mm
SOT-23-6 x 2
D_SMB
Converter_DCDC_TRACO_TSR_1_THT
BarrelJack_Horizontal
C_1206_3216Metric
Fuse_1206_3216Metric
giga-adapter_PCB
