daleondev/ProtoMate_Control/src/simulation/assets/robot/base_link/base_link_collision.stl

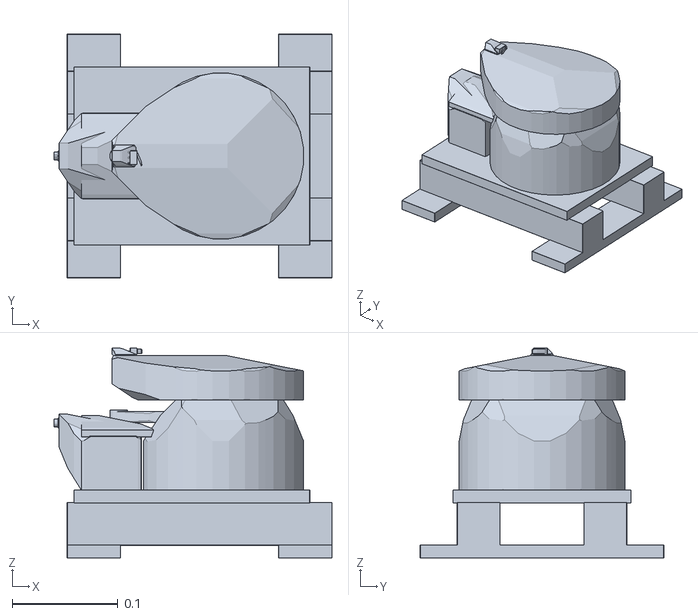
[picture p60: CAD file, 2026-11-04]
src/simulation/assets/robot/base_link/base_link_collision.stl
0.263 x 0.23 x 0.199
