daleondev/ProtoMate_Control/src/simulation/assets/robot/link_1/link_1_collision.stl

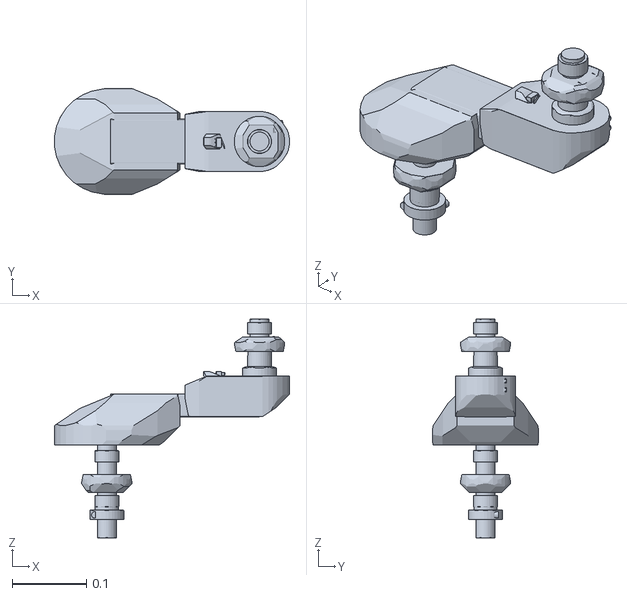
[picture p61: CAD file, 2026-11-04]
src/simulation/assets/robot/link_1/link_1_collision.stl
0.315 x 0.143 x 0.293
