daleondev/ProtoMate_Control/src/simulation/assets/robot/link_2/link_2_collision.stl

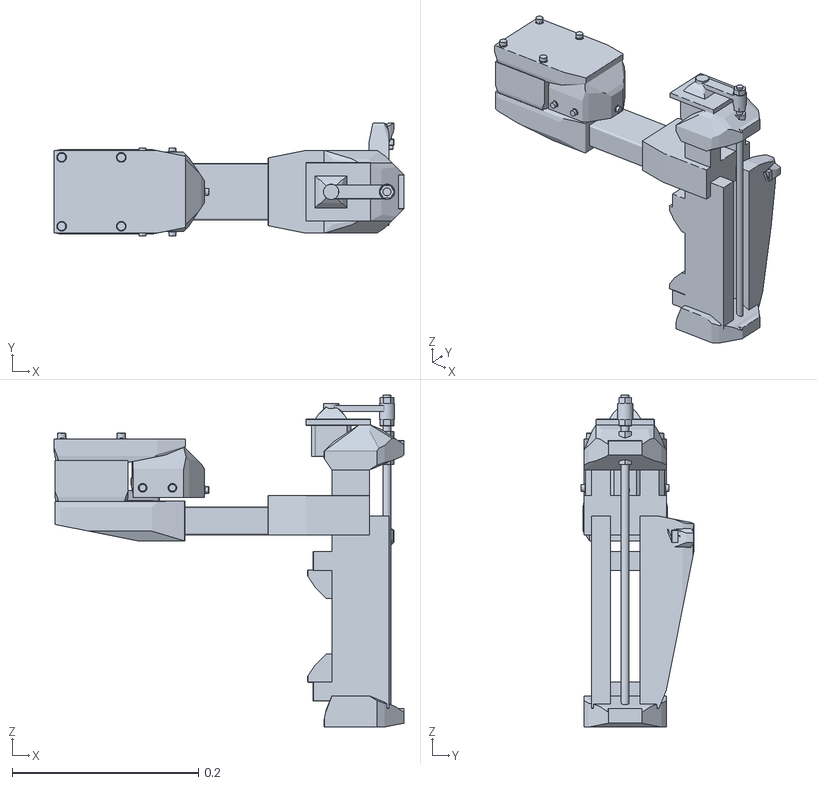
[picture p62: CAD file, 2026-11-04]
src/simulation/assets/robot/link_2/link_2_collision.stl
0.376 x 0.121 x 0.356
