daleondev/ProtoMate_Control/src/simulation/assets/robot/link_3/link_3_collision.stl

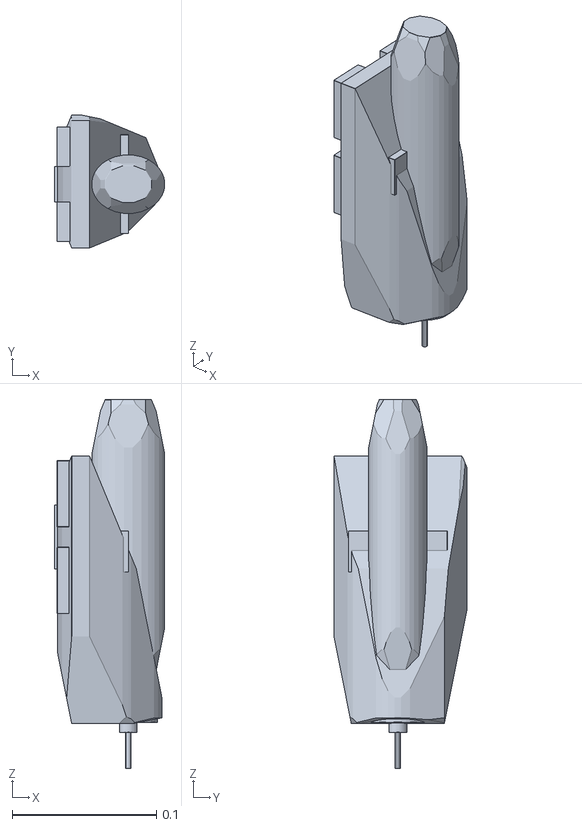
[picture p63: CAD file, 2026-11-04]
src/simulation/assets/robot/link_3/link_3_collision.stl
0.0765 x 0.0922 x 0.256
