daleondev/ProtoMate_Control/src/simulation/assets/robot/sensors/z_lever.stl

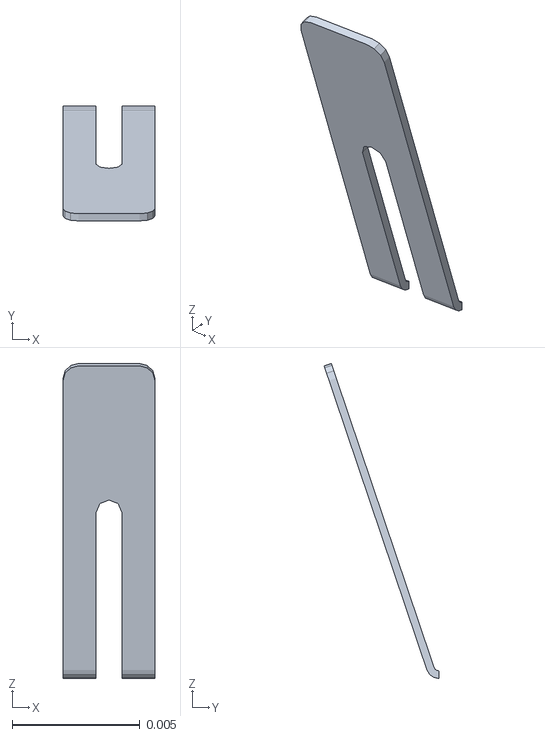
[picture p64: CAD file, 2026-11-08]
src/simulation/assets/robot/sensors/z_lever.stl
0.0036 x 0.0045 x 0.0123
