daleondev/ProtoMate_Control/src/ui/gui/assets/robot/interactive/base_link.obj

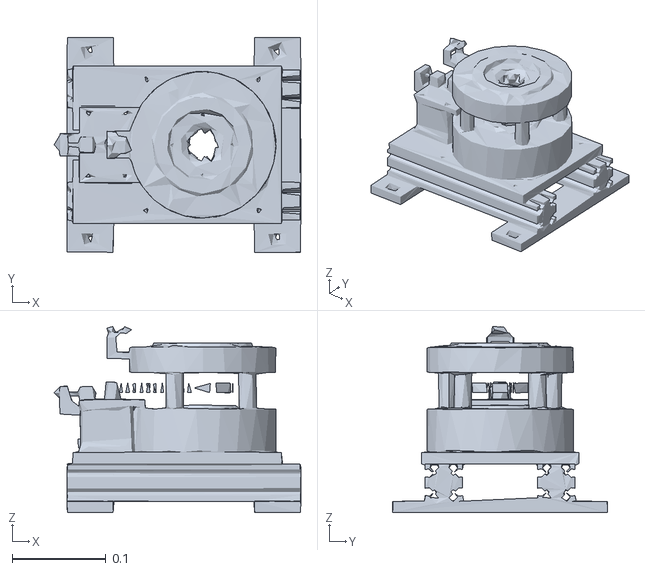
[picture p65: CAD file, 2026-11-07]
src/ui/gui/assets/robot/interactive/base_link.obj
0.264 x 0.23 x 0.199
