daleondev/ProtoMate_Control/src/ui/gui/assets/robot/interactive/link_1.obj

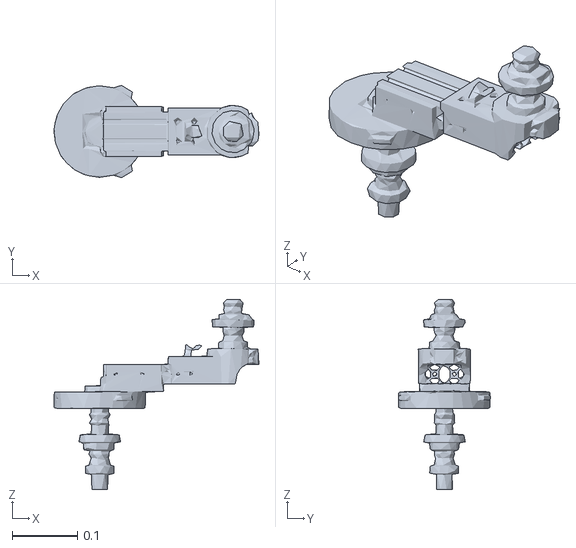
[picture p66: CAD file, 2026-11-07]
src/ui/gui/assets/robot/interactive/link_1.obj
0.315 x 0.142 x 0.292
