daleondev/ProtoMate_Control/src/ui/gui/assets/robot/interactive/link_2.obj

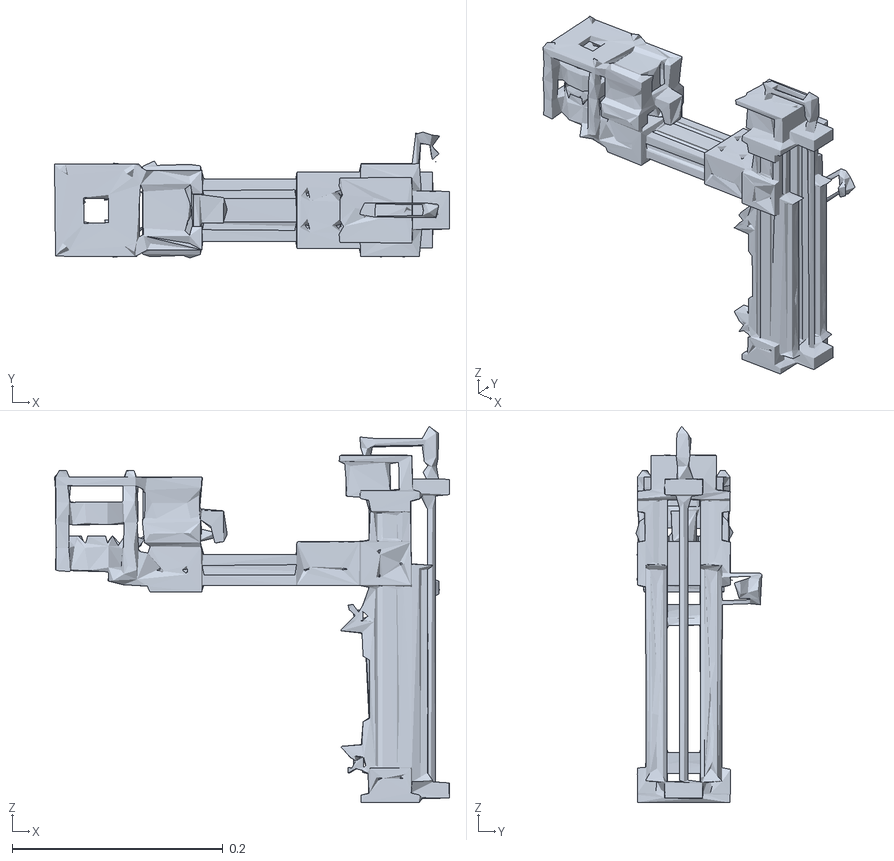
[picture p67: CAD file, 2026-11-07]
src/ui/gui/assets/robot/interactive/link_2.obj
0.375 x 0.119 x 0.357
