daleondev/ProtoMate_Control/src/simulation/assets/robot/sensors/j1_cams.stl

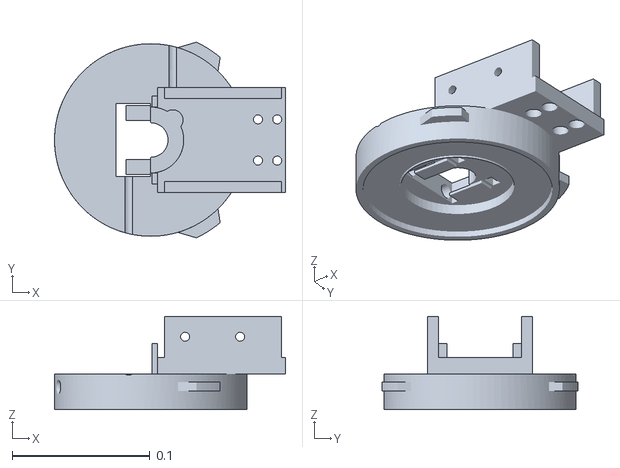
[picture p68: CAD file, 2026-11-08]
src/simulation/assets/robot/sensors/j1_cams.stl
0.168 x 0.142 x 0.0678
