daleondev/ProtoMate_Control/src/ui/gui/assets/robot/interactive/link_3.obj

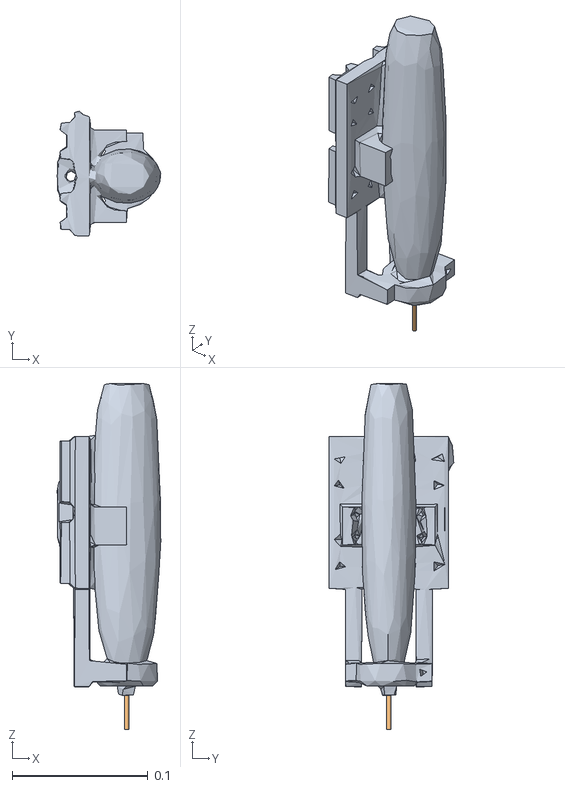
[picture p69: CAD file, 2026-11-07]
src/ui/gui/assets/robot/interactive/link_3.obj
0.0763 x 0.0918 x 0.255
link_3_interactive_0
link_3_tip_0
