daleondev/ProtoMate_Control/src/simulation/assets/robot/sensors/j2_cams.stl

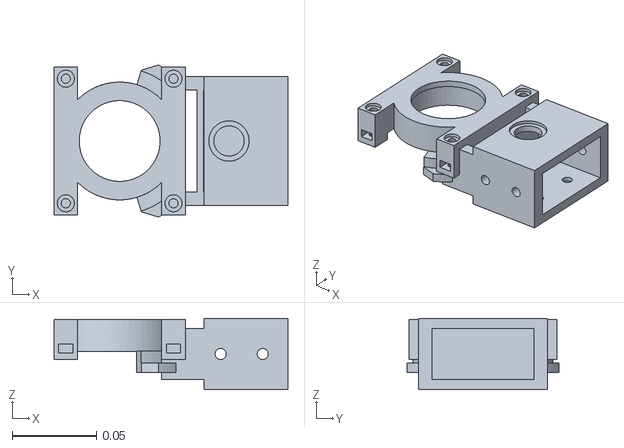
[picture p70: CAD file, 2026-11-08]
src/simulation/assets/robot/sensors/j2_cams.stl
0.139 x 0.0903 x 0.0424
