daleondev/ProtoMate_Control/(list of files, cad)

Other CAD files:
docs/robot/SCARA_Robot.step
src/simulation/assets/robot/sensors/j2_lever.stl
src/simulation/assets/robot/sensors/j1_lever.stl
docs/robot/SCARA_Robot.f3d
hardware/display/assembly/giga-mated-rev-A.step
hardware/display/assembly/giga-mated-rev-B.step
hardware/display/assembly/giga-mated-rev-C.step
hardware/display/assembly/giga-mated-rev-D.step
hardware/display/assembly/giga-mated-rev-E.step
hardware/display/manufacturing/display-adapter-rev-A/display-adapter.step
hardware/display/manufacturing/display-adapter-rev-B/display-adapter.step
hardware/display/manufacturing/display-adapter-rev-C/display-adapter.step
hardware/display/manufacturing/display-adapter-rev-D/display-adapter.step
hardware/display/manufacturing/display-adapter-rev-E/display-adapter.step
hardware/display/manufacturing/display-adapter-rev-F/display-adapter.step
hardware/display/manufacturing/giga-adapter-rev-A/giga-adapter.step
hardware/display/manufacturing/giga-adapter-rev-B/giga-adapter.step
hardware/display/manufacturing/giga-adapter-rev-C/giga-adapter.step
hardware/display/manufacturing/giga-adapter-rev-D/giga-adapter.step
hardware/display/manufacturing/giga-adapter-rev-E/giga-adapter.step
src/ui/gui/assets/robot/base_link.obj
src/ui/gui/assets/robot/link_1.obj
src/ui/gui/assets/robot/link_2.obj
src/ui/gui/assets/robot/link_3.obj
