daleondev/ProtoMate_Control/hardware/perfboard/assembly/README.md

# Perfboard assembly

Open [ProtoMate.kicad_pro](../ProtoMate.kicad_pro) in KiCad 10,
then open the PCB editor. This file is a **placement and hand-wiring map for a
purchased 65 × 47-hole individual-pad perfboard, oriented as 47 columns × 65 rows**.
The tracks represent wires; there are no Gerber files or custom-board
fabrication instructions.

[Assembly.pdf](../exports/Assembly.pdf) contains four actual-size A4 portrait sheets:

1. Component placement, viewed from above.
2. Component-side jumpers, in red.
3. Solder-side wires, in blue, **already mirrored** for looking at the underside.
4. Both sets of wires together, viewed from above.

Print at **100% / actual size**, without fitting to the page. Check that the
nominal outline measures 119.38 × 165.10 mm and ten hole intervals measure 25.4 mm.

## Hole coordinates and wiring

Place the board with its **65-hole edge vertical**. Columns are **1–47**,
rows **A–Z, AA–AZ, BA–BM**, giving 3,055 holes. A1 is the upper-left hole in the
top view. The distance between outer hole centres is **116.84 × 162.56 mm**.
The drawing puts the outline half a pitch (1.27 mm) beyond the outer hole
centres; assembly coordinates are defined by the holes, independently of the
physical edge margins. The grid continues uniformly across the whole assembly.
J104 and both TMC2209 modules occupy the top edge, with cable entries facing
outward. J107 sits directly below J104, grouping the motor-1 driver and encoder
cables in the upper-left area. The four GIGA headers form a bank along the
left edge, with 9.1 mm between connector bodies and all pin-1 pads at the bottom.
The encoder receiver and conversion stages occupy the centre-left; the DM542T
transistor stages run down the right interior at 30.48 mm spacing. The encoder
transistor stages have 15.24 mm spacing. The buck sits at the bottom left and
the three switch cable connectors at the bottom right.
The buck's barrel jack remains accessible from the left edge.

All component leads and the additional wire-passage holes fall on the
**2.54 mm grid**. Lines between holes show the route of insulated wire, not
additional holes or copper strips. Empty holes are the faint circles on
`Dwgs.User`. A square in the drawing identifies header/IC pin 1; the purchased
board's pads will normally all be round.

The underside sheet flips the board **left/right**, keeping row A at the top.
Column 1 is therefore on the right. Hole names never change between views.
All components are mounted on the top face.

The layout prioritizes underside wiring. Wires.csv identifies each connection
and any insulated top-side crossovers.
Each crossover uses its own pair of free holes; no wire shares a passage hole
with another wire or a component lead. Each component solder joint carries
at most three scheduled wire ends. The encoder transistor stages have their
resistors grouped locally, and power/ground connections join nearby pads.

- [Holes.csv](Holes.csv): every component pin, its hole and its electrical net.
- [Wires.csv](Wires.csv): all 139 required pad-to-pad connections, with endpoints,
  side-change holes and routed lengths. Add handling/stripping allowance to
  these lengths. The `wire_class` column identifies the heavier power wiring.
  Tick off each connection as it is soldered.
- [Harness.csv](Harness.csv): every header pin and its cable or direct module contact.
- [Parts.csv](Parts.csv): parts and mounting dimensions for this perfboard.

Use insulated hookup wire except for short, unambiguous adjacent-pad bridges.
Strip only the ends. Intersecting red and blue lines are on opposite faces and
are not joined. Routes belonging to the same net may share a drawn path; the
wire table specifies the actual endpoint connections. A layer-change circle
represents passing an insulated wire through an otherwise empty hole; it is
not a plated via that the perfboard already contains. Use **0.5 mm² insulated copper wire** for every `power` entry, including
returns. Use thin insulated hookup wire for `signal` entries; short same-net
adjacent pads can use tinned-wire links. Line width in KiCad is schematic
representation, not the specified wire diameter. Keep the power conductors
low against the underside, following the power branches in the drawing. **Every wire starts and
ends on the underside**, where it is soldered to the specified component pads.
Keep the insulation intact through passage holes and across other wires.
Passage holes are not additional electrical junctions. Read side-change holes
in order from the first endpoint: each consecutive pair is one top crossover.

Fit the board in this order:

1. Fit every wire marked `bottom wire + top jumper`, using the red crossover view
   and each consecutive pair of passage holes listed for that wire. Leave their ends underneath for soldering to the component
   pads. Use insulated wire that passes freely through the holes.
2. Fit resistors, transistors, capacitors, headers and IC sockets. Keep the
   crossovers low and leave clearance for their insulation beneath sockets.
3. Solder the short underside links, then the longer underside wires, following
   the `bottom wire` rows in Wires.csv. Only consecutive GND pads on J102 may
   use a continuous tinned link. J101/J108/J113 mix signals and grounds;
   follow the individual scheduled wires. Use insulated wire for longer routes.
4. Fit C1/C2 with positive leads in their square pads. Complete the 11 `power`
   connections using 0.5 mm² insulated copper wire, including their ground
   returns. J104.9/10’s solder joints each join three power wires; make the
   copper-to-lead connections mechanically secure before soldering.
5. Fit the raised buck and TMC modules after completing the wiring beneath them.

The wire lengths are projected routing lengths. Add allowance for stripping,
the board thickness at each crossover, and comfortable bends. No schematic
connection is implied by two insulated wires merely touching or crossing.

The DM542T alarm uses R30 (4.7 kΩ): H18 = 3.3 V, H14 = ALM. J104 and R30 sit
at the upper left; J101.4 at Y3 carries ALM to the GIGA. ALM is low when healthy and high for an open
cable or driver fault; its output uses the default normally conducting polarity.
Do not connect this alarm circuit to 5 V or 24 V. Follow the ALM and ground
routes in Wires.csv.

## Parts and orientation

**Q1–Q6 are Diotec 2N2222A**, with emitter/base/collector identified
as **E/B/C** in the schematic, layout and tables. Diotec numbers these leads
**1 = E, 2 = B, 3 = C**. In the top-view drawing E is on the left and C on the
right; the flat/marked face points toward the bottom edge of the drawing.
The layout uses 2.54 mm lead spacing. Gently spread the leads if the parts are
the 1.27 mm bulk variant. See the
[Diotec package drawing and pinout](https://diotec.com/tl_files/diotec/files/pdf/datasheets/2n2222a.pdf).

**U2 is AM26C32CN**, in a 16-pin DIP socket with 7.62 mm between rows. Its notch
points toward row A. **U3 is the user's SN74HC126N**, in a **DIP-14 socket
with 7.62 mm between rows** and 2.54 mm pin pitch. Pin 1 is at **AJ21**;
pin 14 is at AJ24. Its notch points toward row A. Both DIP chips mount on the top face.

Q1–Q3 serve the DM542T. **Q4–Q6 convert the encoder receiver's 5 V outputs
to 3.3 V for U3**. Each stage has a 4.7 kΩ base resistor (R20/R23/R26),
a 10 kΩ base-to-emitter resistor (R21/R24/R27), and a 1 kΩ collector pull-up
to 3.3 V (R22/R25/R28). All emitters connect to ground. Collectors connect
to U3 inputs 2, 5 and 9 respectively.

**U2's three differential input pairs are reversed to cancel the
transistor inversion:** encoder A+/A− go to U2 pins 1/2, B+/B− to 7/6,
and Z+/Z− to 9/10. Use the J107 cable pinout and wire table below.

U3 pin 14 is **3.3 V**, pin 7 is ground. Its active-high enables **1, 4 and
10 connect to 3.3 V**; unused enable 13 and unused input 12 connect to ground,
and output 11 is unconnected. **No HC126 input connects directly to 5 V.**
The resulting A/B/Z signals retain their original polarity, so the existing
timer and rising-edge index configuration stays valid. See
[TI's SN74HC126 data sheet](https://www.ti.com/lit/ds/symlink/sn74hc126.pdf).

Keep the transistor collector connections short. Verify edge shape and
turn-off delay at the intended encoder speed with an oscilloscope; saturated
transistor storage delay is not established by the static wiring checks.
No 4N35 optocouplers are needed for this circuit with a common ground.

R1–R9 and R20–R30 are axial resistors with 10.16 mm between holes. C3/C4 are 100 nF
nonpolar ceramic capacitors with 2.54 mm lead spacing, close to their IC supply
connections; C5/C6 are 1 µF nonpolar capacitors with 5.08 mm lead spacing.
R10–R12 reserve positions for encoder termination and are **DNP: leave them
empty**. Their pads may still be used as wire junctions. Do not install links
in those resistor positions. Termination must be chosen for the cable and the
encoder's output-current limit as described in the main README.

## External connections

These are **perfboard header numbers**; GIGA destinations use printed D/A labels. All
contacts land on the 2.54 mm grid; J103's pairs and J104's terminal pitch span two intervals (5.08 mm).
Use the harness table for cables and direct module contacts.

| Header | Connection |
| --- | --- |
| J101, 2×6 | GIGA STEP/DIR/enable, ALM and 3.3 V. STEP/GND pairs 1/2, 5/6, 9/10; ALM 4; 3.3 V 8; enable 12. |
| J102, 2×3 | Encoder A/B/Z returns to the GIGA; each paired even pin is ground. |
| J103, four module pins | Buck: 1 = OUT+ / 5 V, 2 = OUT− / GND, 3 = VIN− / GND, 4 = VIN+ / 24 V. |
| J104, 10-way 5.08 mm screw terminal | DM542T: PUL+, PUL−, DIR+, DIR−, ENA+, ENA−, ALM+, ALM−, +24 V, GND, in pin order. Signal selector stays at 5 V. |
| J105, 10 + 2 module pins | M2 / A3: pins 1–10 = JP4 control header; 11 = JP1.6 / 24 V; 12 = JP1.5 / GND. |
| J106, 10 + 2 module pins | M3 / A4, same order as J105. |
| J107, 1×8 | Encoder: GND, A+, A−, B+, B−, Z+, Z−, +5 V, matching the motor's numbered encoder connector. |
| J108, 1×4 | GIGA reference inputs: 1 = M1_REF, 2 = M2_REF, 3 = M3_REF; 4 = shared GND. |
| J109/J110/J111, each 1×2 | M1/M2/M3 reference switch respectively: pin 1 = REF to NC contact, pin 2 = GND to COM contact. |
| J113, 2×4 | GIGA UART/diagnostics: 1 = TX, 3 = RX, 4 = M2_INDEX, 5 = M2_DIAG, 6 = M3_INDEX, 7 = M3_DIAG; 2/8 = GND. |

J104 mounts horizontally at the top left, **wire entries toward row A**, beside
both TMC2209 modules. Use a ten-way, single-row **5.08 mm** screw terminal with
the shown 50.8 × 8 mm body envelope and through-hole leads. Viewed from above,
pins increase left to right:

| J104 pin | Hole | DM542T contact |
| --- | --- | --- |
| 1 | D2 | PUL+ / 5 V |
| 2 | D4 | PUL− |
| 3 | D6 | DIR+ / 5 V |
| 4 | D8 | DIR− |
| 5 | D10 | ENA+ / 5 V |
| 6 | D12 | ENA− |
| 7 | D14 | ALM+ / 3.3 V signal |
| 8 | D16 | ALM− / GND |
| 9 | D18 | +Vdc / 24 V |
| 10 | D20 | Power GND |

Use 0.5 mm² power conductors for pins 9/10. Pin 8 is the alarm signal return;
run it alongside ALM+ and keep motor supply return current in pin 10's dedicated
power wiring. Connect by these labels; terminal numbering is local to J104.

J107 is horizontal immediately below J104. Its pin 1 is **L3**, with pins
increasing to the right through pin 8 at **L10**. This keeps the encoder cable
beside the other motor-1 connections without crowding the screw terminal.

The GIGA connectors share a straight left-edge bank. In the top view,
double-row headers have odd pins up column 4 and even pins up column 3;
J108 is a single column. Pin 1 is at the bottom of every header:

| Header | Pin 1 | Last pin | Function |
| --- | --- | --- | --- |
| J101 | Z4 | U3 (pin 12) | STEP/DIR/enable, ALM, 3.3 V |
| J113 | AH4 | AE3 (pin 8) | UART, DIAG, INDEX |
| J102 | AO4 | AM3 (pin 6) | Encoder A/B/Z |
| J108 | AW3 | AT3 (pin 4) | Reference inputs |

The 9.1 mm body gaps leave room to grip the cable plugs. Keep these cables
exiting toward the left edge and the motor cables toward the top edge.

J101 pin assignments use **Arduino labels**, with MCU pins in parentheses:

| J101 pin | GIGA connection |
| --- | --- |
| 1 | A7 (PA0), M1 STEP |
| 3 | D4 (PJ8), M1 DIR |
| 4 | A3 (PB1), DM542T ALM |
| 5 | D3 (PA2), M2 STEP |
| 7 | D6 (PD13), M2 DIR |
| 8 | 3V3 output |
| 9 | D2 (PA3), M3 STEP |
| 11 | D16 (PH13), M3 DIR |
| 12 | D15 (PC7), shared active-low enable |
| 2 / 6 / 10 | Common GND |

In the top view, **J101 pin 1 is at Z4**, at the lower-right corner of the
header. Odd pins run upward along column 4; even pins run upward along
column 3, ending at pin 11 / U4 and pin 12 / U3. **Only pins 2/6/10 are GND.**
Follow the square pin-1 pad when orienting the cable.
All STEP pins use TIM2 output compare / AF1 (channels 1, 3, 4), owned by M4.
The GIGA uses its own 16 MHz HSE crystal, with no ST-Link clock connection.
R7 biases enable HIGH (disabled); R8/R9 pull M2/M3 STEP LOW. M1 STEP has
its pull-down path through series R1 and base/emitter resistor R2.

J102: 1→D7 (PB4), 3→D5 (PA7), 5→D53 (PG7); even pins are GND.
J108: 1→D49 (PE4), 2→D51 (PE5), 3→D47 (PB2); pin 4 is GND.
Connect all ground conductors to a common ground bus beside the GIGA,
joined to a labelled GND contact on its power header and to perfboard GND.
Power the GIGA through USB-C. Its 3V3 output feeds J101.8; **do not connect
the buck's 5 V output to GIGA 5V, VIN or USB**.

The four GIGA harnesses carry 21 distinct signal/supply contacts and nine
shared-net ground returns. Pair each STEP and encoder signal with its assigned
ground conductor; use shared returns for DIR/enable/ALM, reference switches and
UART/diagnostics. Join returns at a small ground bus immediately beside the
GIGA, with a short solid connection to its GND. Keep these local harnesses
short and separate from motor wiring. Do not use them as motor-power returns.
All perfboard ground links in Wires.csv still need to be fitted.

**UART address straps:** M2/J105 pin 5 (MS1) and pin 6 (MS2) connect to GND
(address 0); M3/J106 pin 5 connects to 3.3 V and pin 6 to GND (address 1).
Firmware overrides the straps for 1/16 microstepping. Keep both **SPRD jumpers
open**. UART current settings bypass the onboard potentiometers.

**J113 spans rows AE–AH, columns 3–4.** Pin 1 is AH4 and pin 2 is AH3;
odd pins run up column 4, even pins up column 3. Connect 1→D18 (PD5 TX),
3→D19 (PD6 RX), 5→A4 (PC3 M2 DIAG), 7→A6 (PC0 M3 DIAG),
4→D8 (PB8 M2 INDEX), 6→D9 (PB9 M3 INDEX), with pins 2/8 returning
to GIGA GND. These are Arduino silkscreen labels, not header contact numbers.

**R29 is 1 kΩ, with leads at AB8 and AB12.** Its pin 1 connects to J113.1;
its pin 2 joins J113.3 and both modules' pin 9 (UART). Only TX passes through
the resistor. Module pin 7 is the respective DIAG signal; pin 8 (INDEX) connects to the respective PB8/PB9 feedback input. Fit the complete ten-pin headers. All bus signals are 3.3 V.

### Directly mounted TMC2209 modules

Fit each module component-side up, with its **JP4 male header pointing down**
through the perfboard. J105 pin 1 (VDD) is **L23** and its pin 10 (EN) is
**L32**. J106 pin 1 is **L36** and its pin 10 is **L45**. Pin numbers increase
left to right in the top view. Both modules sit side by side along the top edge,
with their motor screw terminals facing toward row A. The additional
power pins also point down into the perfboard:

| Module mount | Pin 11: +24 V / JP1.6 | Pin 12: GND / JP1.5 |
| --- | --- | --- |
| J105 / M2 | E25 | E26 |
| J106 / M3 | E38 | E39 |

The footprints include the **26.67 × 24.13 mm** module bodies and the terminal
blocks, measured from [Adafruit's official PCB drawing](https://github.com/adafruit/Adafruit-TMC2209-Breakout-PCB).
The four larger circles inside each outline are mounting holes **in the
Adafruit module**, not new holes to drill in the perfboard. Their spacing does
not match the perfboard grid. Use insulating supports under the terminal side
so tightening screws does not bend the header or its solder joints.

Use long-tail headers and supports to leave **at least 6 mm between the module
underside and the perfboard top**. Check the actual terminal solder tails clear
all jumper insulation, solder joints and pads. Fit low-profile insulated wires
first, then supports and modules. Keep the driver chip accessible from above and allow space for cooling.
Firmware sets current; no potentiometer adjustment is used in UART mode.

Remove each six-way JP1 terminal block. Fit a **two-pin 2.54 mm long-tail
header downward** in JP1.6 (+) and JP1.5 (−), and a **four-way 2.54 mm terminal
block upward** in JP1.4–JP1.1 for the motor. The motor terminal order, left to
right in the top view, is **2B, 2A, 1A, 1B**. These four contacts stay on the
module and are not additional perfboard holes. The pitch follows
[Adafruit’s terminal specification](https://www.adafruit.com/product/6121).

C1 and C2 are **100 µF / 50 V polarized electrolytics**, body diameter at most
10 mm, with leads formed to 5.08 mm. They sit below M2 and M3 respectively.
Their positive pads connect to 24 V; negative pads connect to the dedicated
power returns. Keep their leads short. The onboard capacitors remain fitted.
The ten-pin JP4 header carries control and logic power only.

### Buck converter mounting

The **63 × 27 mm PCB** sits at the lower left, with its barrel jack pointing
outward at the left edge and USB connector toward the right. The body follows
the [local buck model](../libraries/models/QIQIAZI_XY3606_HeaderMount.step); mounting pins
use a nominal **5.08 mm pair pitch** and **50.8 mm pair separation**,
based on the model's terminal blocks.

Remove both screw-terminal blocks and fit four long-tail header pins, keeping
the module component-side up and at least 6 mm above the perfboard. The
project's buck 3D model shows this arrangement, retaining the barrel jack and
USB socket. With the barrel jack facing left, the output positive contact is
above the negative contact, following the
[XY-3606 terminal layout](https://roboticsdna.in/product/24v-12v-to-5v-5a-power-module-dc-dc-xy-3606-power-converter/).
Use the module's **OUT+ and OUT−** contacts for the 5 V and ground connections.

| J103 pin | Hole, top view | Connection |
| --- | --- | --- |
| 1 | BC24 | Buck OUT+ → perfboard 5 V |
| 2 | BE24 | Buck OUT− → perfboard GND |
| 3 | BE4 | Buck VIN− → power distribution GND |
| 4 | BC4 | Buck VIN+ → power distribution 24 V |

Feed **24 V through the existing barrel jack**. Both VIN header pins are
electrical distribution connections. Route their supply and return to
**J104.9 / D18 (+24 V)** and **J104.10 / D20 (GND)**, then branch separately to
C1/M2 and C2/M3. These two contacts accept the external DM542T supply cable.
Their underside joints are the star points, not extra connections inside the
screw clamps. Driver logic grounds join their local power grounds; the
remaining logic ground joins the buck output ground. Follow the specified
return paths instead of using thin signal-ground wires for motor power.
The GIGA is powered independently through USB-C. J101 carries its 3.3 V
output and common ground; buck 5 V supplies only the DM542T signal and encoder circuits.

### Reference-switch cables

The three switch headers occupy the lower-right area: J109 pin 1 is **BC41**,
J110 pin 1 is **BG41**, and J111 pin 1 is **BK41**. Each switch header's
adjacent pin 2 is ground. J108 returns their signals to the GIGA from the
left-edge connector bank, with pin 1 at **AW3**. Follow Wires.csv for each
REF and GND route and any top-side crossovers.

SW1/SW2/SW3 are the external, unpowered Creality mechanical switches. The
schematic identifies **COM, NC and NO by function**, not by PCB connector
position. With each switch disconnected, find the pair that has continuity
when released and opens when pressed. Connect that pair to its REF/GND cable;
leave the remaining contact unused. Do not apply power based on `V/G/S`
silkscreen labels. Only the unpopulated dry-contact version is represented.

The GIGA supplies the signal bias through its configured internal **3.3 V
pull-ups**: low = released, high = pressed or unplugged. The perfboard adds no
pull-up, debounce or filter components. Route each signal with its ground
return away from motor wiring. Before motion use, validate noise immunity and
contact debounce with the actual cables. M4 firmware implements homing and
motion-stop behavior; the perfboard itself contains only the switch wiring.

The GIGA, DM542T, motors and reference switches remain external. U1/A3/A4 sit directly on J103/J105/J106. **24 V driver supply
currents use the designated underside power wiring**; winding cables run
directly from each driver to its motor.
Connect those parts as shown in
[the system wiring schematic](../exports/Wiring.pdf). In particular,
the GIGA uses USB-C power and supplies the interface with 3.3 V through
J101.8. Its ground is common with the buck; their 5 V supplies are not joined.
The GIGA owns its QSPI and filesystem storage; no external flash or SD module
is connected through this perfboard.

## Checks

[DRC.rpt](../exports/DRC.rpt) records KiCad's electrical clearance/connectivity
and schematic-parity checks. [Verification.txt](../exports/Verification.txt)
records checks of the saved layout's symbol links, nets, hole grid, wire table
and harness destinations. The schematic includes J101–J111 and J113 and is the
electrical reference for this layout. Use **Update PCB from Schematic (F8)**
as described in the [project guide](../README.md).

The model uses project-local footprints and PTH/via graphics to represent real
component holes and wire passages. Manufacturing silkscreen and missing-courtyard
checks are waived for this assembly map; electrical clearance, unconnected-pad,
schematic-parity and library-consistency checks remain enabled. Passing those checks does
not verify a soldered assembly. Before fitting ICs or attaching the GIGA,
check continuity against the wire table and verify the 5 V and 3.3 V supplies
are separate and neither is shorted to ground.

To repeat KiCad's check from the repository root:

```sh
python3 hardware/perfboard/tools/refresh.py --check-only
```
