daleondev/ProtoMate_Control/hardware/exports/Assembly.pdf

PUL+ | PUL- | DIR+ | DIR- | ENA+ | ENA- | ALM+ | ALM- | 24V | GND J107
VDD | GND | +
DIR | -
STEP | 2B

MS1 JP1: power pins + motor terminal TMC2209

2A

MS2 | 1A DIAG 1B
IDX | UART | EN J113 J108
J111 U3 J102 | + | -

J109 J101

J110

# 24 V JACK 24 V DISTRIBUTION

4 VIN+ / 3 VIN- | U1 / QIQIAZI 5 V OUTPUT TO PERFBOARD

USB

OUT+ / 5V OUT- / GND

+ | - U2
VDD | GND | +
DIR | -
STEP | 2B

MS1 JP1: power pins + motor terminal TMC2209

2A

MS2 | 1A DIAG 1B
IDX | UART | EN 2 | 1
1 | 2 | 3 | 4 | 5 | 6 | 7 | 8 | 9 | 10
1 | 2
1 | 2 | E | B | C
1 | 2 | 3 | 4 | 5 | 6 | 7 | 8 | 1 | 2 | 3 | 4 | 5 | 6 | 7 | 8 | 9 | 10
11 | 12
1 | 2
1 | 2
1 | 2

1

2

2 | 1
4 | 3
6 | 5
8 | 7
1 | 2
E | B | C
E | B | C
1 | 2

1

2

3

4

1 | 2
1 | 2
2 | 1
E | B | C
2 | 1 | 1

2

3

4

5

6

7 | 8
| 9

10

11

12

13

14

2 | 1
4 | 3
6 | 5
2 | 1
2 | 1
1 | 2
1 | 2
1 | 2

1

2

E | B | C
E | B | C
1 | 2
2 | 1
2 | 1
4 | 3
6 | 5
8 | 7
10 | 9
12 | 11
1 | 2

1

2

1 | 2
1 | 2
1 | 2
1 | 2
1 | 2

1

3 | 2

4

1 | 2

1

2

3

4

5

6

7

8 | 9
| 10

11

12

13

14

15

16

1 | 2
1 | 2 | 3 | 4 | 5 | 6 | 7 | 8 | 9 | 10
11 | 12
1 | 2
1 | 2

MOTION

UART / DIAG / INDEX

ENCODER

REFERENCE

DM542T CONTROL / ALM / POWER ENCODER IN | M2 / A3 | M3 / A4

# M1 NC M2 NC M3 NC

R22

J104 R21 | Q2 R3
J107 | C3 | J105 R10 | C6 | R4
J113 | R26 Q5 | Q1 R29

J108

J111

R20 | R9 Q6 | R25 | U3
J102 | R8 R28 | R1 R12 | C2 R2 Q4 | Q3

J109

R30

J101 | R5 R7 R11 | R23
J110 R24 | C5

J103

C1 U2 | R6
J106 C4 R27

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
AI AJ AK

AL AM

AN

AO

AP

AQ

AR

AS
AT AU

AV

AW

AX

AY
AZBA BB

BC

BD
BEBF BG

BH
BI BJ BK

BL BM

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
AI AJ AK

AL AM

AN

AO

AP

AQ

AR

AS
AT AU

AV

AW

AX

AY
AZBA BB

BC

BD
BEBF BG

BH
BI BJ BK

BL BM

Nominal outline: 119.38 x 165.10 mm. Print at 100%; ten intervals = 25.4 mm.

TOP: component view. Red = top jumpers; blue = bottom wires. U2/U3 notch UP. Q1-Q6 Diotec E/B/C left to right; flat face DOWN. Modules >=6 mm above board. Buck VIN -> J104.9/10 -> separate 24 V / GND driver branches. J101 pins 1/3/5/7/9/11/12 -> CN10 pins 29/26/32/10/34/8/30. J101.8 -> CN8.7 (3V3); .4 -> CN9.17 (ALM); GND .2/.6/.10. R10-R12 DNP. Solder all wire ends underneath. Red crossovers use free holes; keep their insulation intact. Power: dedicated insulated 0.5 mm2 copper branches on underside. Capacitors C1/C2: observe + polarity.

One continuous grid: A1:BM47. Hole-centre span: 116.84 x 162.56 mm. 1 / 4 COMPONENT PLACEMENT - TOP VIEW

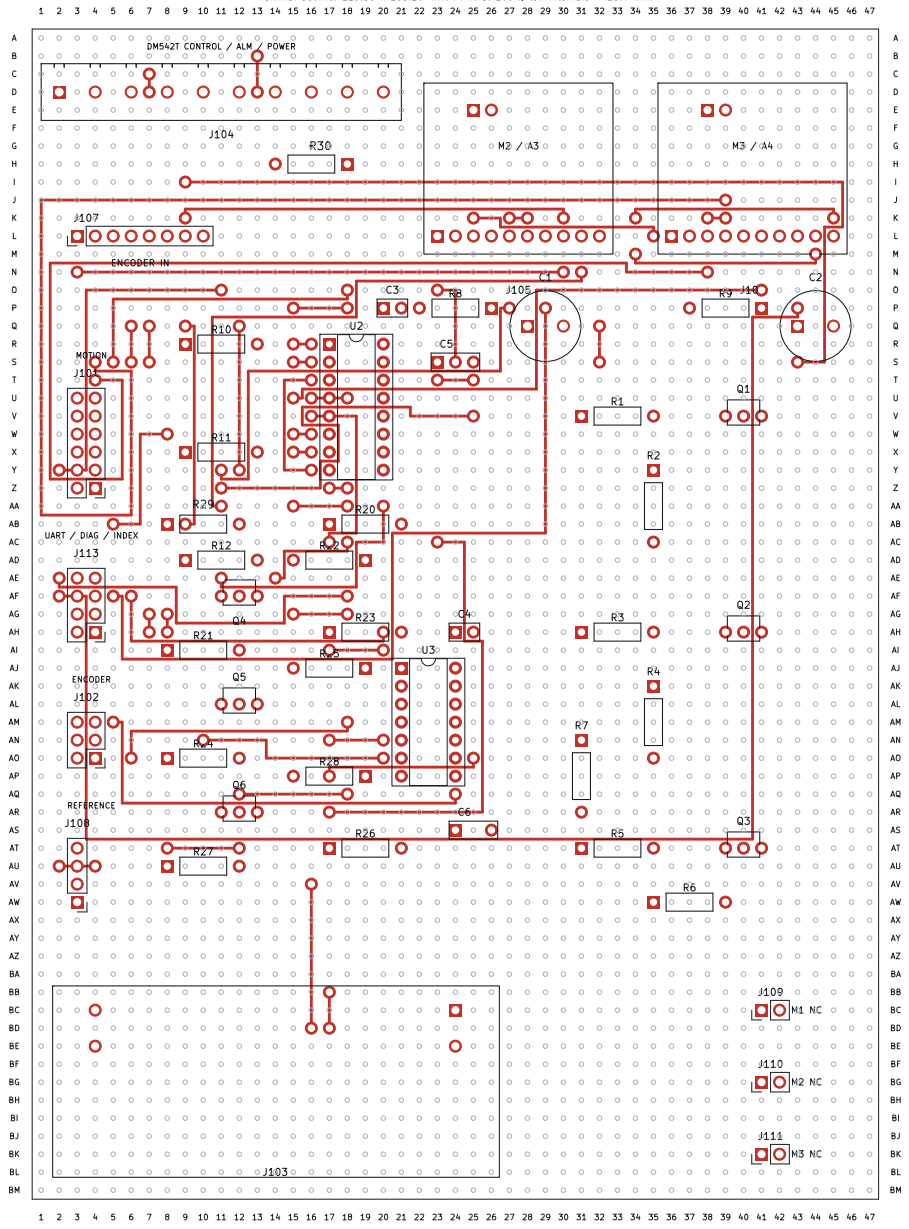
[picture p71: figure]
MOTION; UART / DIAG / INDEX; ENCODER; REFERENCE; FGH; IJK; AY AZBA BB; BD BEBF BG

DM542T CONTROL / ALM / POWER ENCODER IN | M2 / A3 | M3 / A4
| Nominal outline: 119.38 x 165.10 mm. Print at 100%; ten intervals = 25.4 mm.

TOP: component view. Red = top jumpers; blue = bottom wires. U2/U3 notch UP. Q1-Q6 Diotec E/B/C left to right; flat face DOWN. Modules >=6 mm above board. Buck VIN -> J104.9/10 -> separate 24 V / GND driver branches. J101 pins 1/3/5/7/9/11/12 -> CN10 pins 29/26/32/10/34/8/30. J101.8 -> CN8.7 (3V3); .4 -> CN9.17 (ALM); GND .2/.6/.10. R10-R12 DNP. Solder all wire ends underneath. Red crossovers use free holes; keep their insulation intact. Power: dedicated insulated 0.5 mm2 copper branches on underside. Capacitors C1/C2: observe + polarity.

One continuous grid: A1:BM47. Hole-centre span: 116.84 x 162.56 mm. 2 / 4 TOP JUMPERS - COMPONENT SIDE

Nominal outline: 119.38 x 165.10 mm. Print at 100%; ten intervals = 25.4 mm.

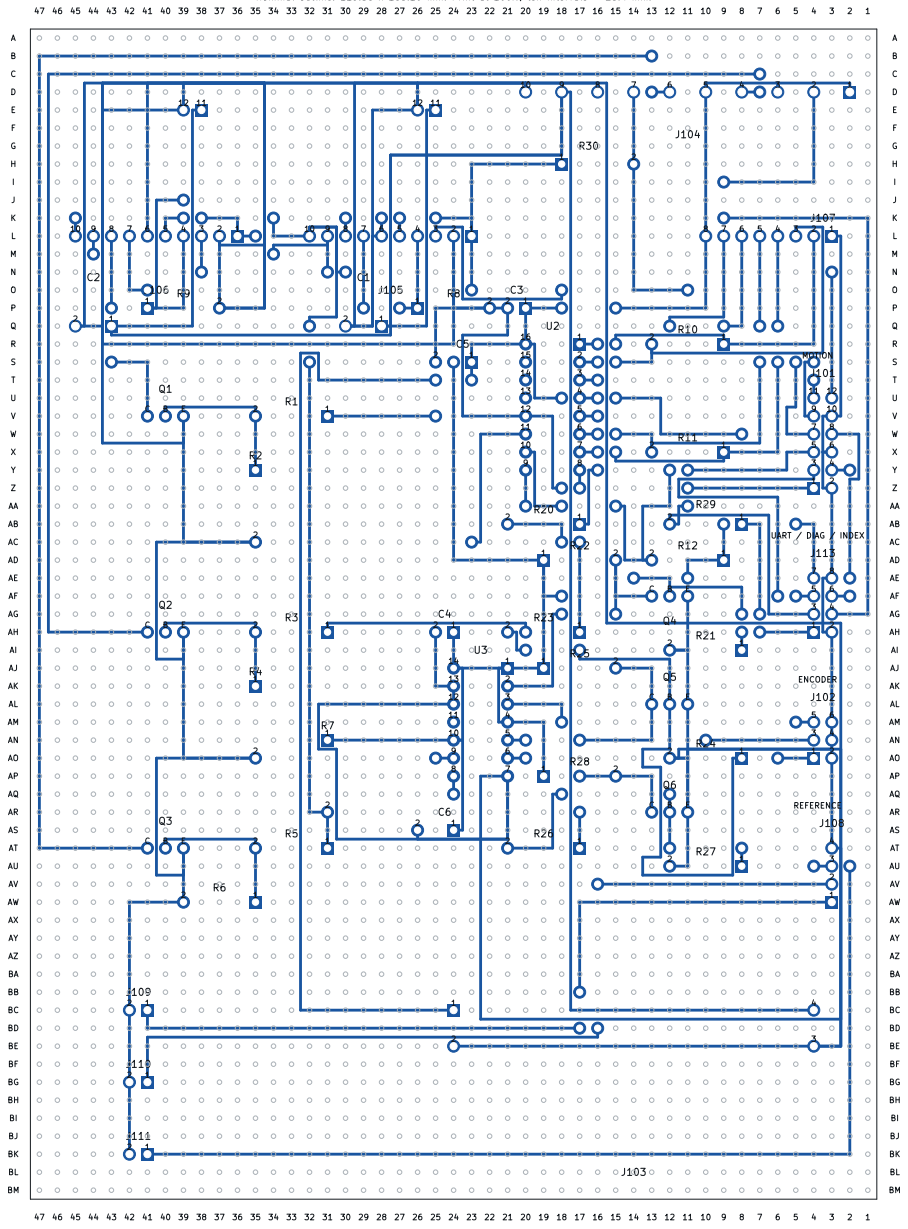
[picture p72: figure]
MOTION; UART / DIAG / INDEX; ENCODER; REFERENCE; FGH; IJK; AY AZBA BB; BD BEBF BG

BOTTOM: solder side. Flip LEFT / RIGHT; row A stays at the top. U2/U3 notch UP. Q1-Q6 Diotec C/B/E left to right on this face; flat face DOWN. Modules >=6 mm above board. Buck VIN -> J104.9/10 -> separate 24 V / GND driver branches. J101 pins 1/3/5/7/9/11/12 -> CN10 pins 29/26/32/10/34/8/30. J101.8 -> CN8.7 (3V3); .4 -> CN9.17 (ALM); GND .2/.6/.10. R10-R12 DNP. Solder all wire ends underneath. Red crossovers use free holes; keep their insulation intact. Power: dedicated insulated 0.5 mm2 copper branches on underside. Capacitors C1/C2: observe + polarity. J113 1/3/5/7 -> CN9 6/4/8/10; 4/6 -> CN9 25/27 (INDEX); GND 2/8.

One continuous grid: A1:BM47. Hole-centre span: 116.84 x 162.56 mm.

C2 | 3 / 4 BOTTOM WIRES - SOLDER SIDE, ALREADY MIRRORED

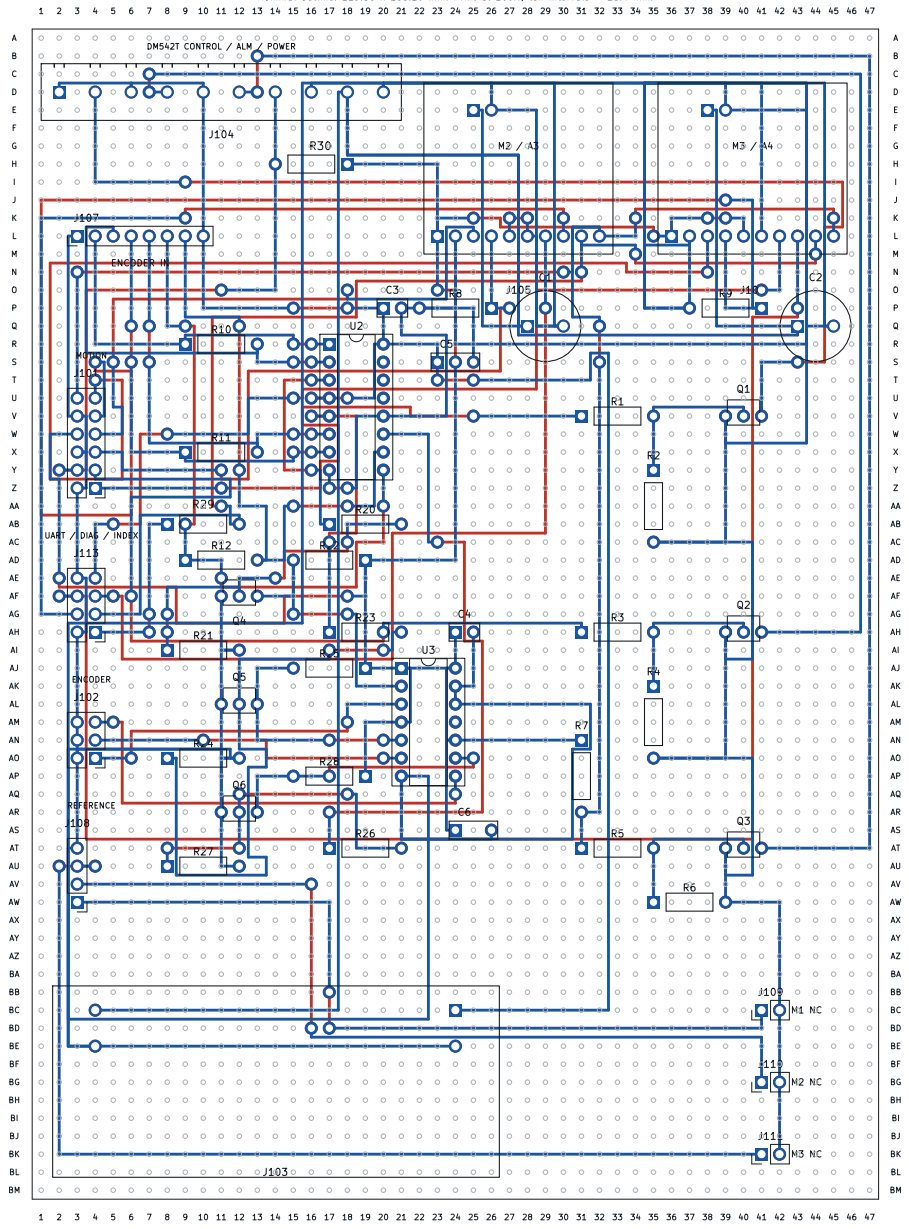
[picture p73: figure]
MOTION; UART /; DIAG / INDEX; ENCODER; REFERENCE; FGH; IJK; AY AZBA BB; BD BEBF BG

DM542T CONTROL / ALM / POWER ENCODER IN | M2 / A3 | M3 / | A4
| Nominal outline: 119.38 x 165.10 mm. Print at 100%; ten intervals = 25.4 mm.

TOP: component view. Red = top jumpers; blue = bottom wires. U2/U3 notch UP. Q1-Q6 Diotec E/B/C left to right; flat face DOWN. Modules >=6 mm above board. Buck VIN -> J104.9/10 -> separate 24 V / GND driver branches. J101 pins 1/3/5/7/9/11/12 -> CN10 pins 29/26/32/10/34/8/30. J101.8 -> CN8.7 (3V3); .4 -> CN9.17 (ALM); GND .2/.6/.10. R10-R12 DNP. Solder all wire ends underneath. Red crossovers use free holes; keep their insulation intact. Power: dedicated insulated 0.5 mm2 copper branches on underside. Capacitors C1/C2: observe + polarity.

One continuous grid: A1:BM47. Hole-centre span: 116.84 x 162.56 mm. 4 / 4 BOTH WIRE LAYERS - TOP VIEW
