daleondev/ProtoMate_Control/docs/measurements/2026-10-03-step-generator/step-generator-measurements.pdf

Case | Captured M1/M2/M3 | Reported M1/M2/M3 | State | Counts
1 | 1/2/3 | 1/2/3 | Completed | MATCH
2 | 1000/1500/2000 | 1000/1500/2000 | Completed | MATCH
3 | 100000/100000/100000 | 100000/100000/100000 | Completed | MATCH
4 | 1024/1024/1024 | 1024/1024/1024 | Completed | MATCH
5 | 995/498/249 | 995/498/249 | Stopped | MATCH
6 | 1000/1000/1000 | 1000/1000/1000 | Completed | MATCH
7 | 512/256/128 | 512/256/128 | Underrun | MATCH
8 | 435/435/435 | 435/435/435 | Completed | MATCH

# STEP hardware validation — pulse counts and stopping

Current firmware: reported pulse counts match the independent logic-analyzer captures.

Nominal rates within ±0.1%; long-run residual drift is documented in figure 8.

AZDelivery / fx2lafw, 24 MS/s (cases 1–7), 4 MS/s (case 8). Nucleo STEP pins, EN_N disabled. 2026-10-03–04.

# Case 2 — independent rates and finish times

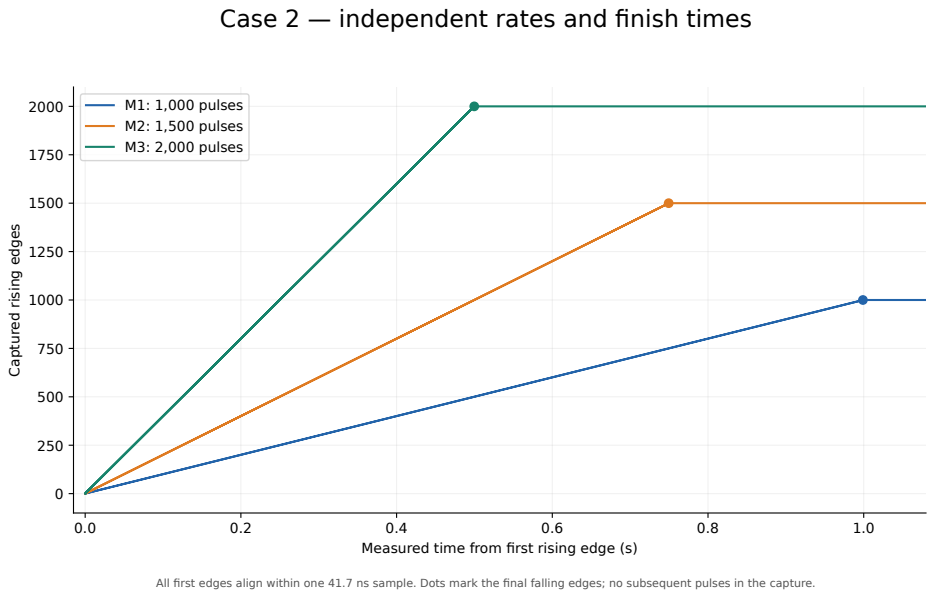
[picture p80: page 2]
M1: 1,000 pulses M2: 1,500 pulses M3: 2,000 pulses

Captured rising edges

Measured time from first rising edge (s)

All first edges align within one 41.7 ns sample. Dots mark the final falling edges; no subsequent pulses in the capture.

0 | 10 | 20 | 30 | 40 | 50 | 60
Time from first M1 rising edge (µs)

M3

M2

M1

## First pulses: all three axes share the first edge

5.000000 | 5.041667
Measured high width (µs); programmed high: 5 µs

0

20000

40000

60000

80000
Number of pulses

M1
M2
M3

# Case 3 — 100,000 pulses/axis; measured M1 rate 100.003 kHz

Programmed rate: 100.000 kHz. The frequency offset is measured, not corrected in these plots. Digital logic levels, not analog voltages.

# Measured frequency offset and interval distribution

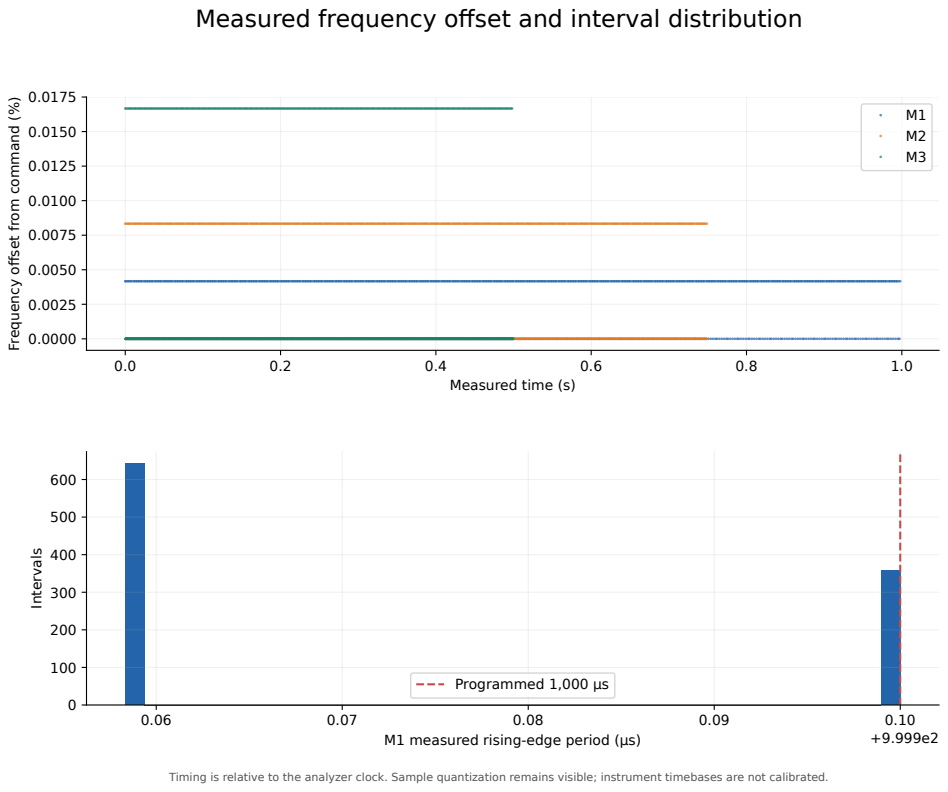
[picture p81: page 4]
Measured time (s); Frequency o; M1 measured rising-edge period (µs); Intervals; Programmed 1,000 µs

ffset from command (%)

Timing is relative to the analyzer clock. Sample quantization remains visible; instrument timebases are not calibrated.

# Case 4 — copied acceleration/deceleration profile, 1,024 pulses/axis

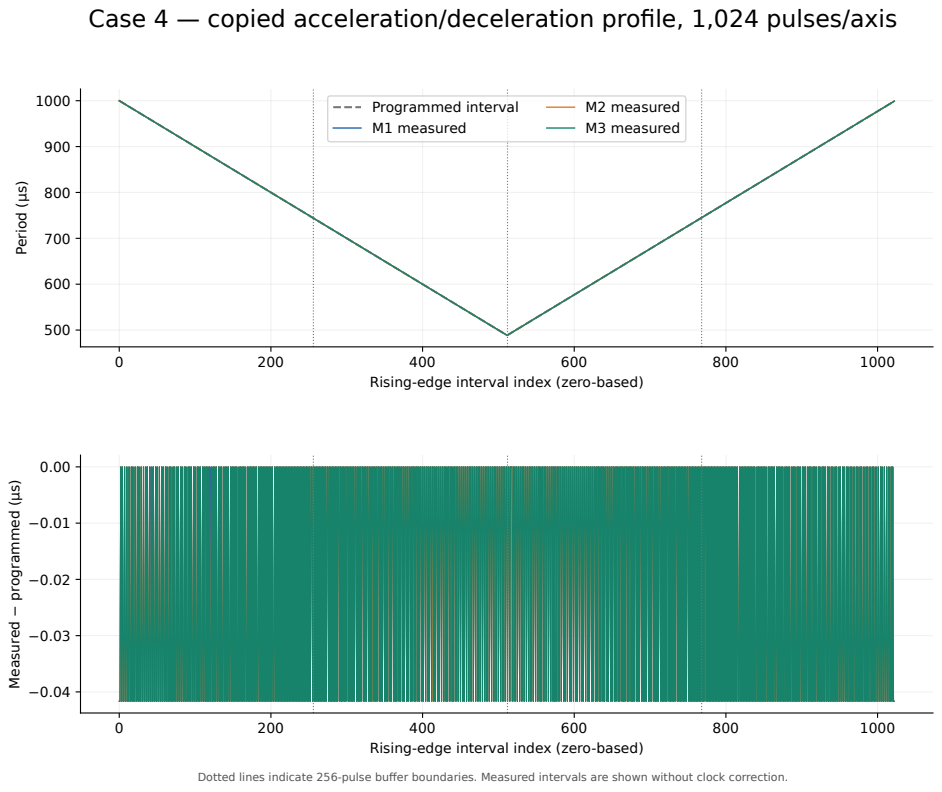
[picture p82: page 5]
Period (µs); Programmed interval M1 measured; M2 measured M3 measured; Measured; − programmed (µs)

Rising-edge interval index (zero-based)

Dotted lines indicate 256-pulse buffer boundaries. Measured intervals are shown without clock correction.

2530 | 2540 | 2550 | 2560 | 2570 | 2580 | 2590 | 2600
Time from first M1 rising edge (µs)

M3

M2

M1

## Pulse train crosses the first M1 DMA-buffer boundary while its IRQ is withheld

# Case 6 — delayed refill IRQ: 1,000 captured pulses on every axis

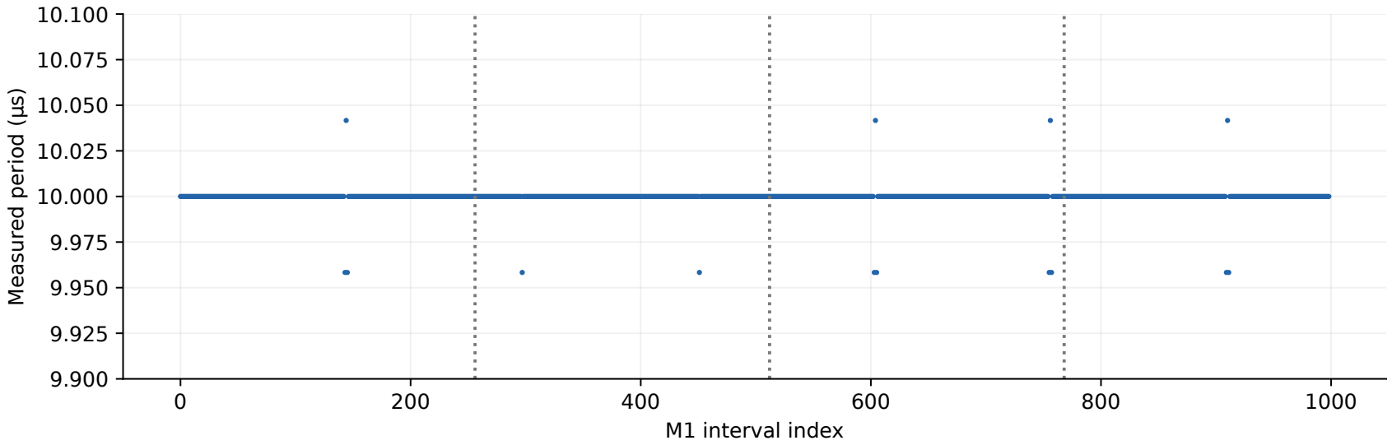
[picture p83: figure]
M1 interval index; Measured period (µs)

The firmware masks DMA IRQs for about 4.5 ms including the start delay. The analyzer observes the outputs, not the IRQ mask directly.

# Case 7 — autonomous stop with all DMA IRQs withheld

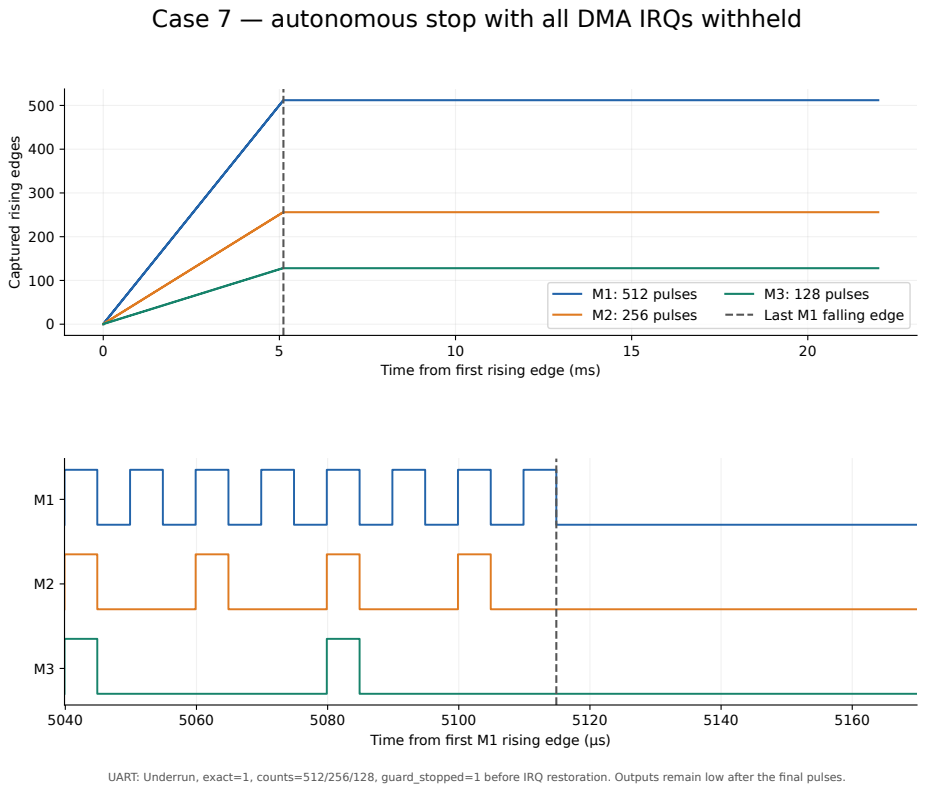
[picture p84: page 7]
M1: 512 pulses M2: 256 pulses

Captured rising edges

M3: 128 pulses
Last M1 falling edge

Time from first rising edge (ms)

Time from first M1 rising edge (µs)

UART: Underrun, exact=1, counts=512/256/128, guard_stopped=1 before IRQ restoration. Outputs remain low after the final pulses.

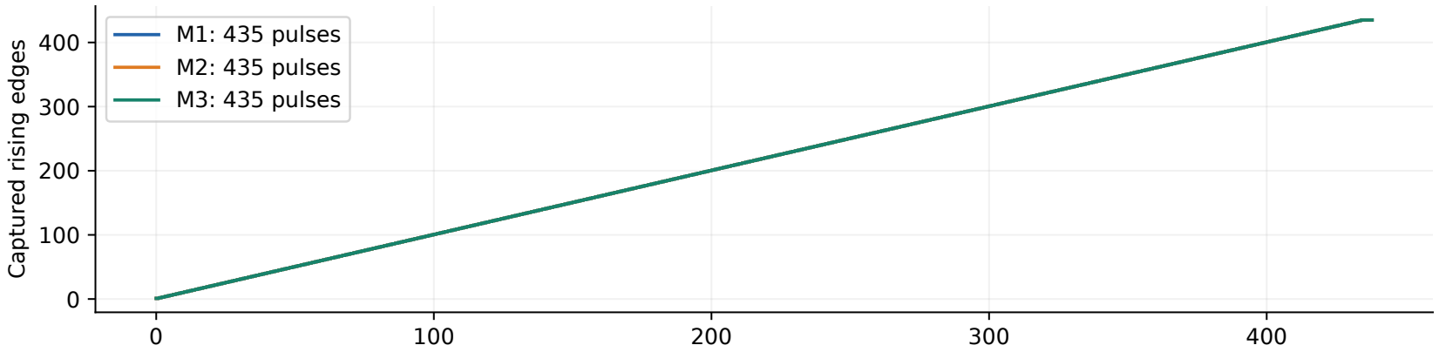
[picture p85: figure]
Captured rising edges; M1: 435 pulses M2: 435 pulses M3: 435 pulses

Measured time from first rising edge (s)

## Whole recording: gradual relative drift (M1); channels agree within one sample

# Counter rollover — complete pulse counts, with slow relative clock drift

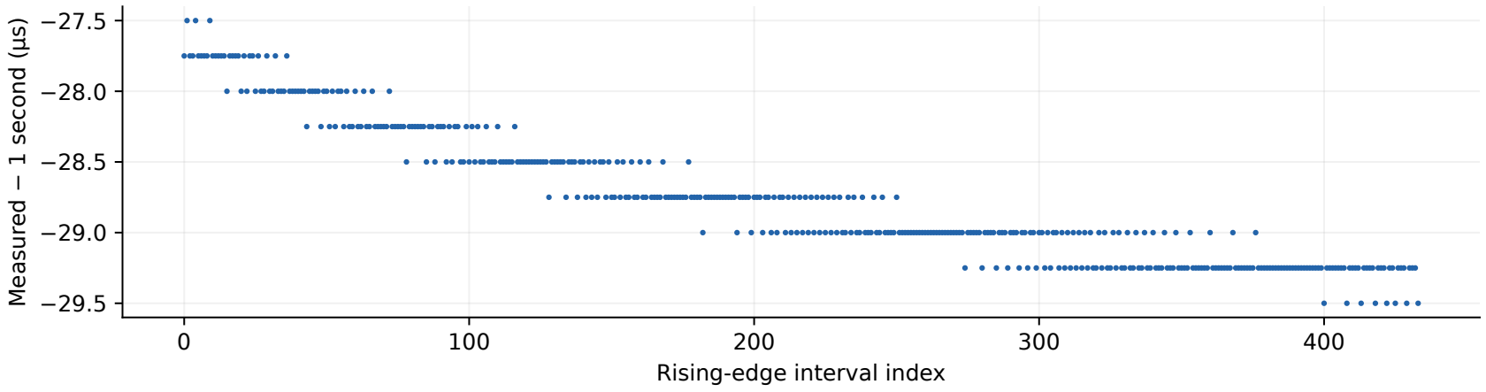
[picture p86: figure]
Rising-edge interval index; Measured; − 1 second (µs)
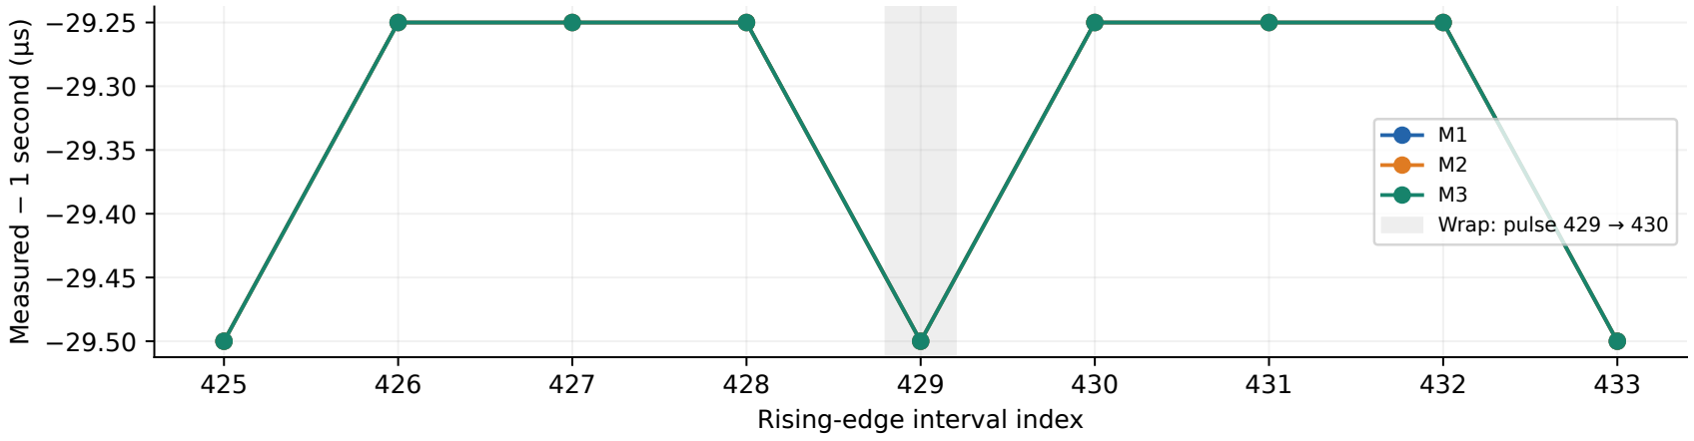
[picture p87: figure]
Rising-edge interval index; Measured; − 1 second (µs); M1 M2 M3 Wrap: pulse 429 → 430

4 MS/s; 250 ns sample spacing. The global two-sample residual screen fails; no resolved rollover discontinuity. No clock correction applied.

# Hantek 6022BE — simultaneous M1 and M2 STEP measurements

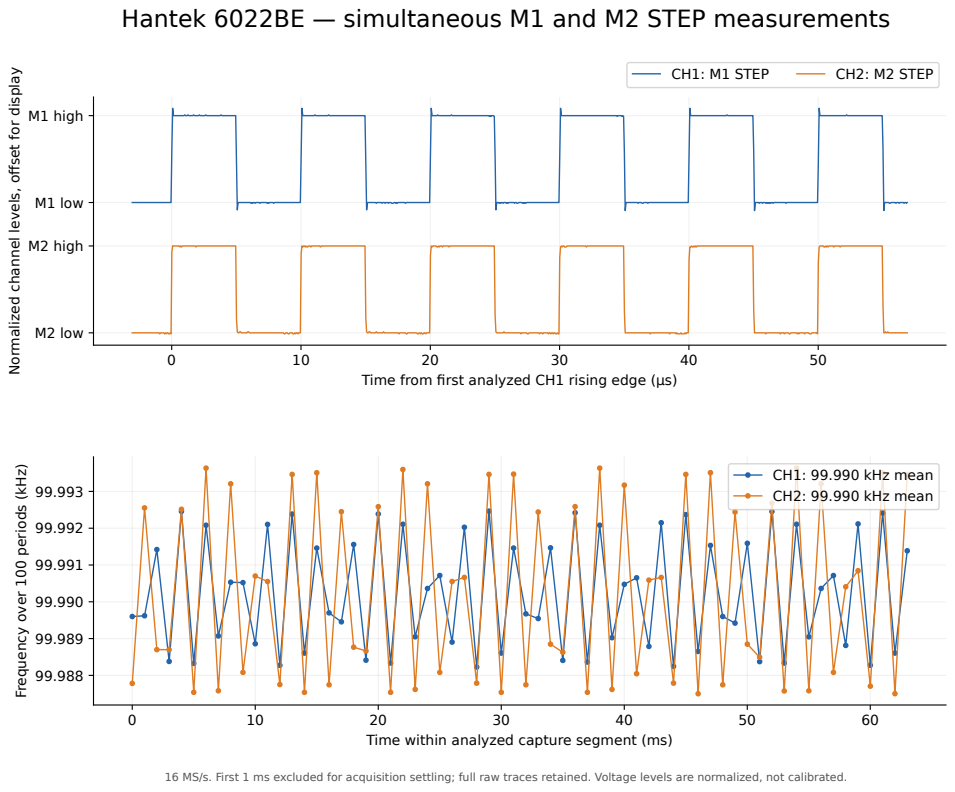
[picture p88: page 9]
M2 low; M2 high; M1 high; CH1: M1 STEP; CH2: M2 STEP; CH1: 99.990 kHz mean CH2: 99.990 kHz mean

ffset for display

Normalized channel levels, o
M1 low

Time from first analyzed CH1 rising edge (µs)

Frequency over 100 periods (kHz)

Time within analyzed capture segment (ms)

16 MS/s. First 1 ms excluded for acquisition settling; full raw traces retained. Voltage levels are normalized, not calibrated.

# Independent STEP frequency measurements

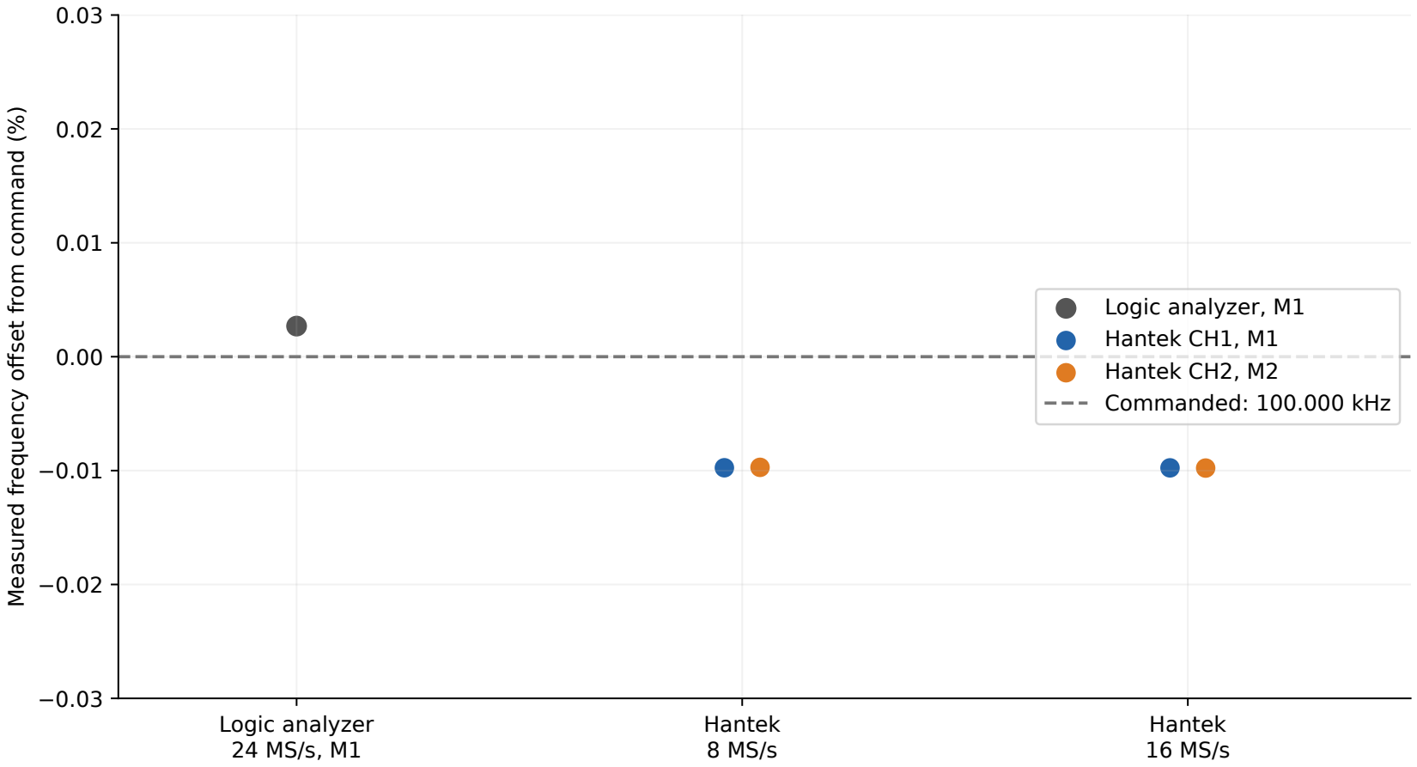
[picture p89: figure]
Logic analyzer 24 MS/s, M1; Hantek 8 MS/s; Hantek 16 MS/s; Measured frequency o; ffset from command (%); Logic analyzer, M1 Hantek CH1, M1; Hantek CH2, M2 Commanded: 100.000 kHz

Same firmware, separate bursts. Channel pairs are simultaneous within each Hantek capture. No instrument has an independent timebase calibration.

# TIM2 measured against the independent RTC crystal

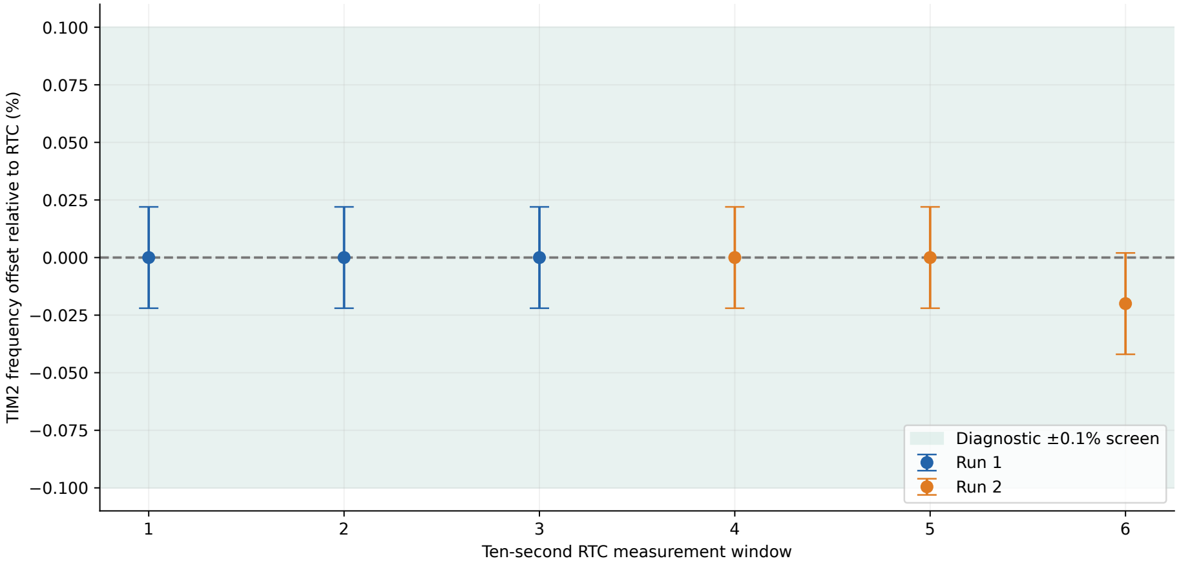
[picture p90: figure]
Ten-second RTC measurement window; TIM2 frequency o; ffset relative to RTC (%); Diagnostic ±0.1% screen Run 1 Run 2

No external instrument. STEP held low. Error bars cover polling and synchronization; LSE crystal tolerance is additional.
