daleondev/ProtoMate_Control/docs/measurements/2026-10-03-step-generator/01-counts-and-states.png

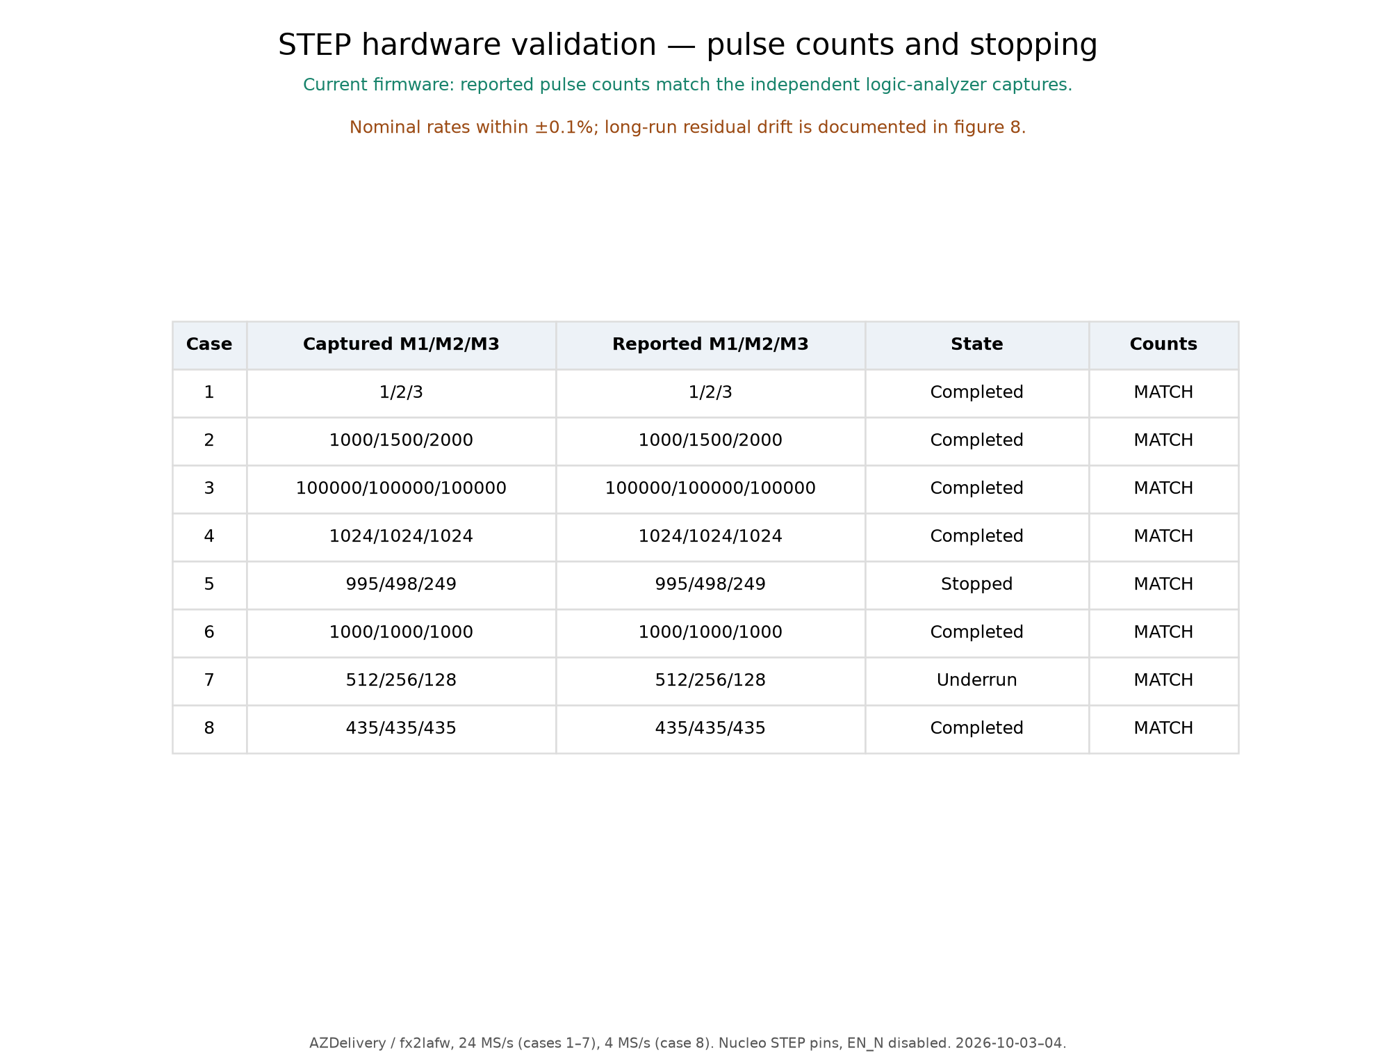
docs/measurements/2026-10-03-step-generator/01-counts-and-states.png
