daleondev/ProtoMate_Control/docs/measurements/2026-10-03-step-generator/02-independent-rates.png

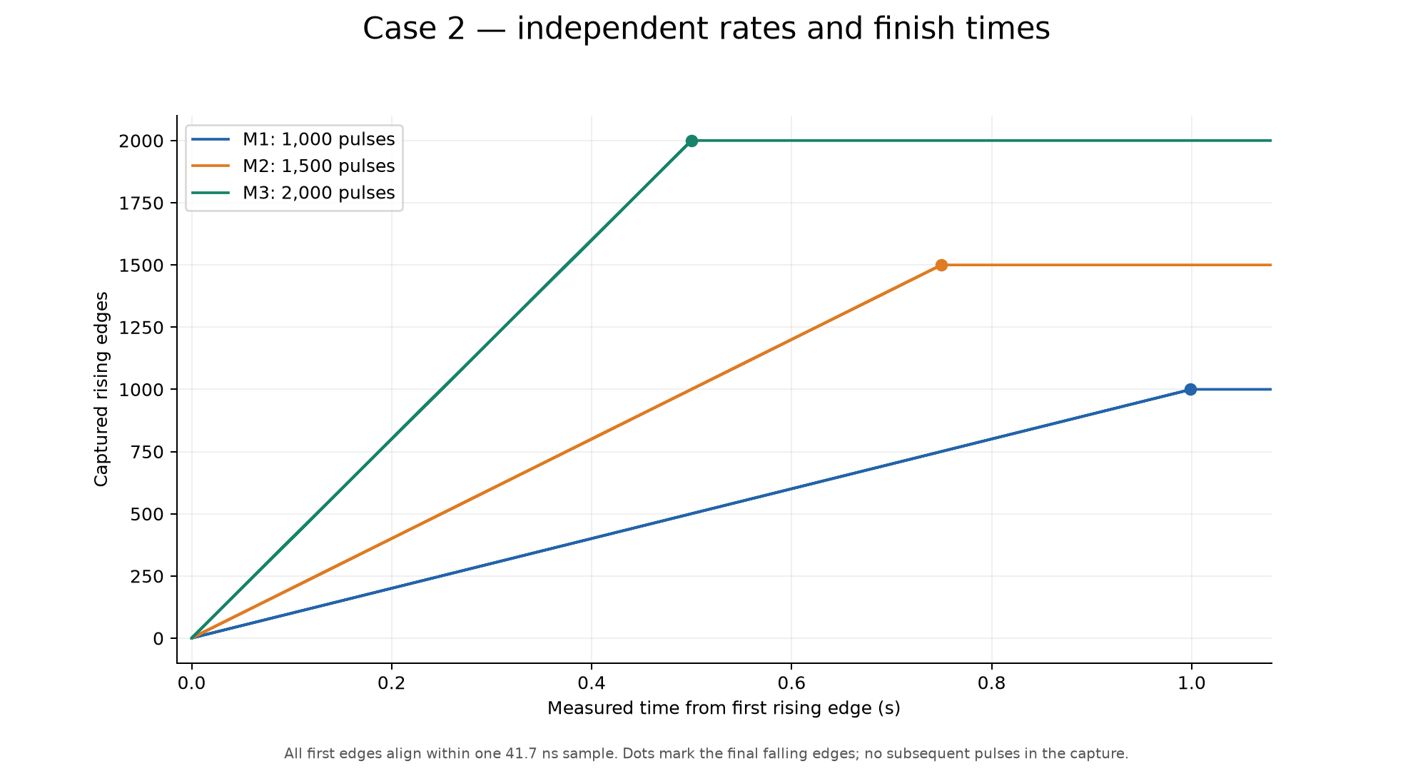
docs/measurements/2026-10-03-step-generator/02-independent-rates.png
