daleondev/ProtoMate_Control/docs/measurements/2026-10-03-step-generator/03-maximum-rate.png

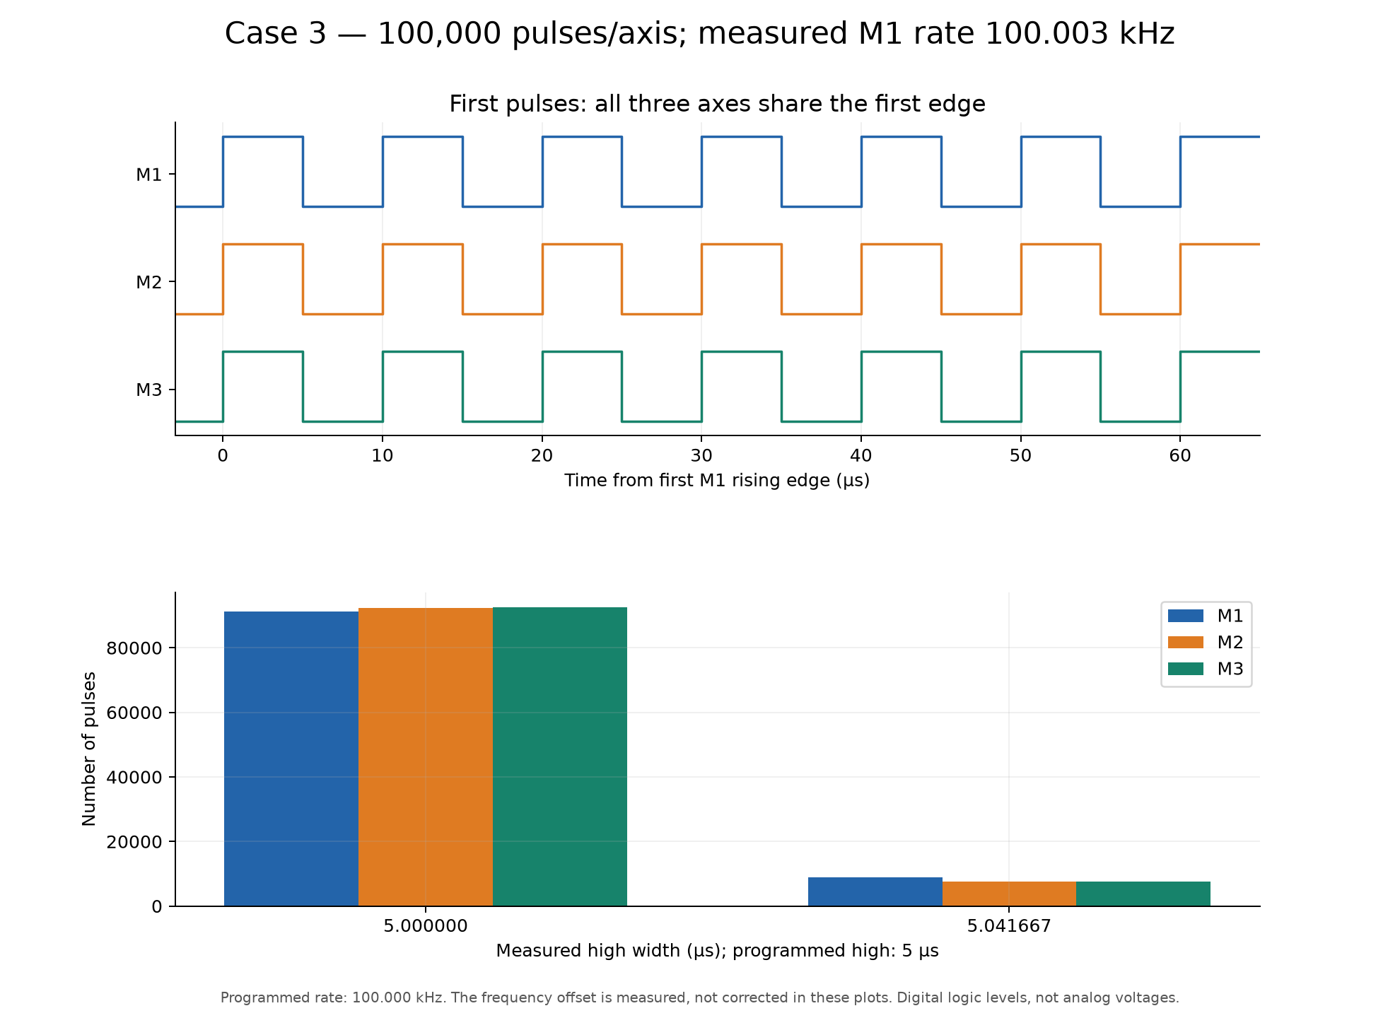
docs/measurements/2026-10-03-step-generator/03-maximum-rate.png
