daleondev/ProtoMate_Control/docs/measurements/2026-10-03-step-generator/04-clock-offset.png

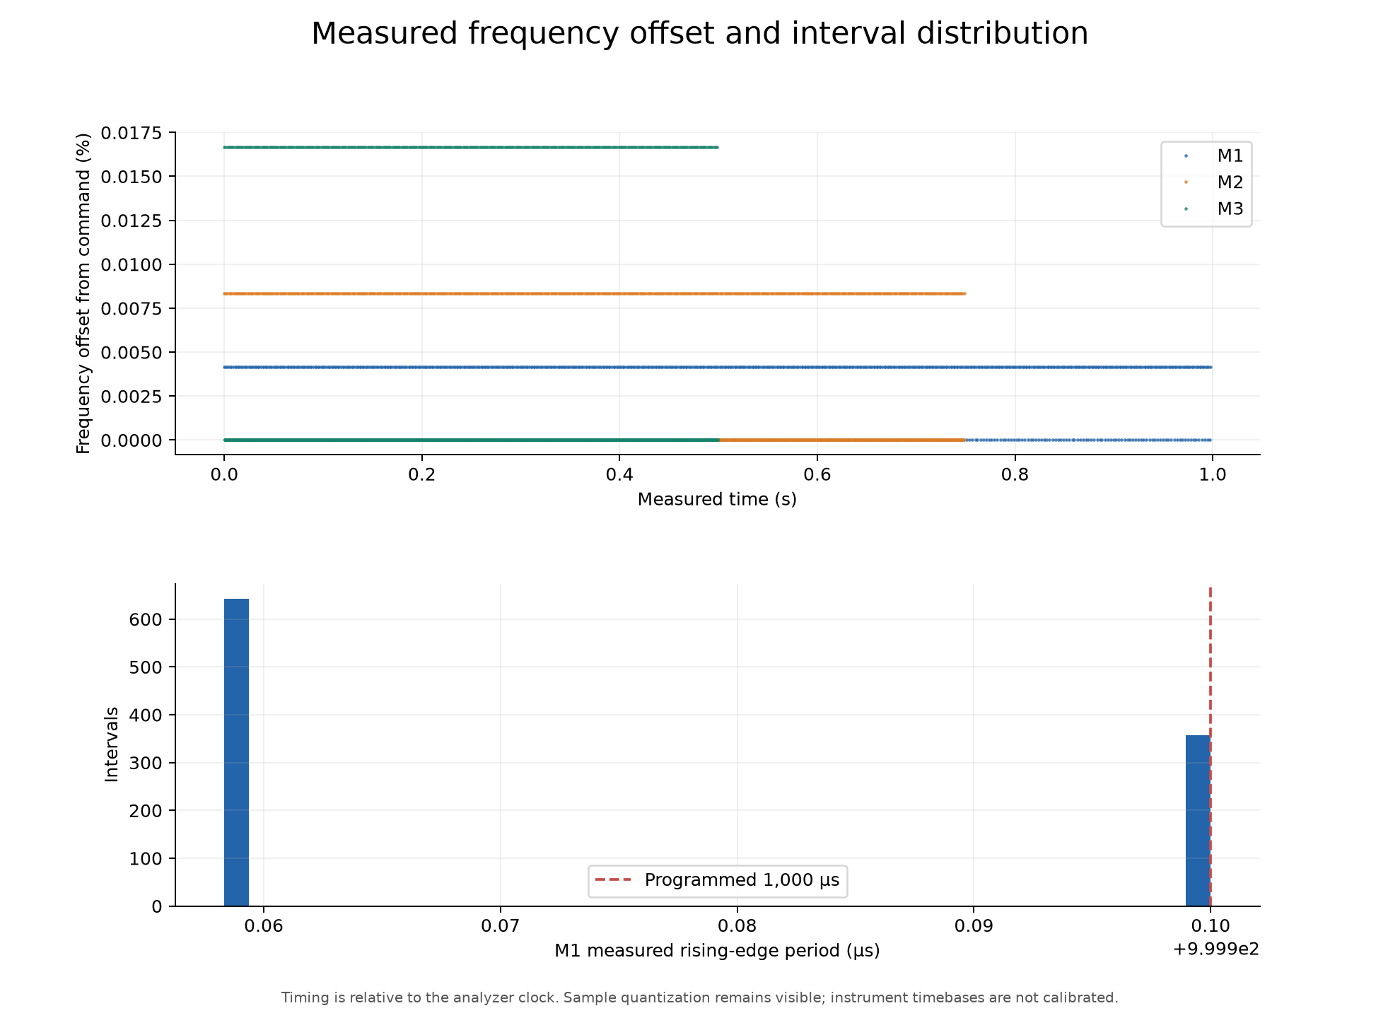
docs/measurements/2026-10-03-step-generator/04-clock-offset.png
