daleondev/ProtoMate_Control/docs/measurements/2026-10-03-step-generator/05-profile.png

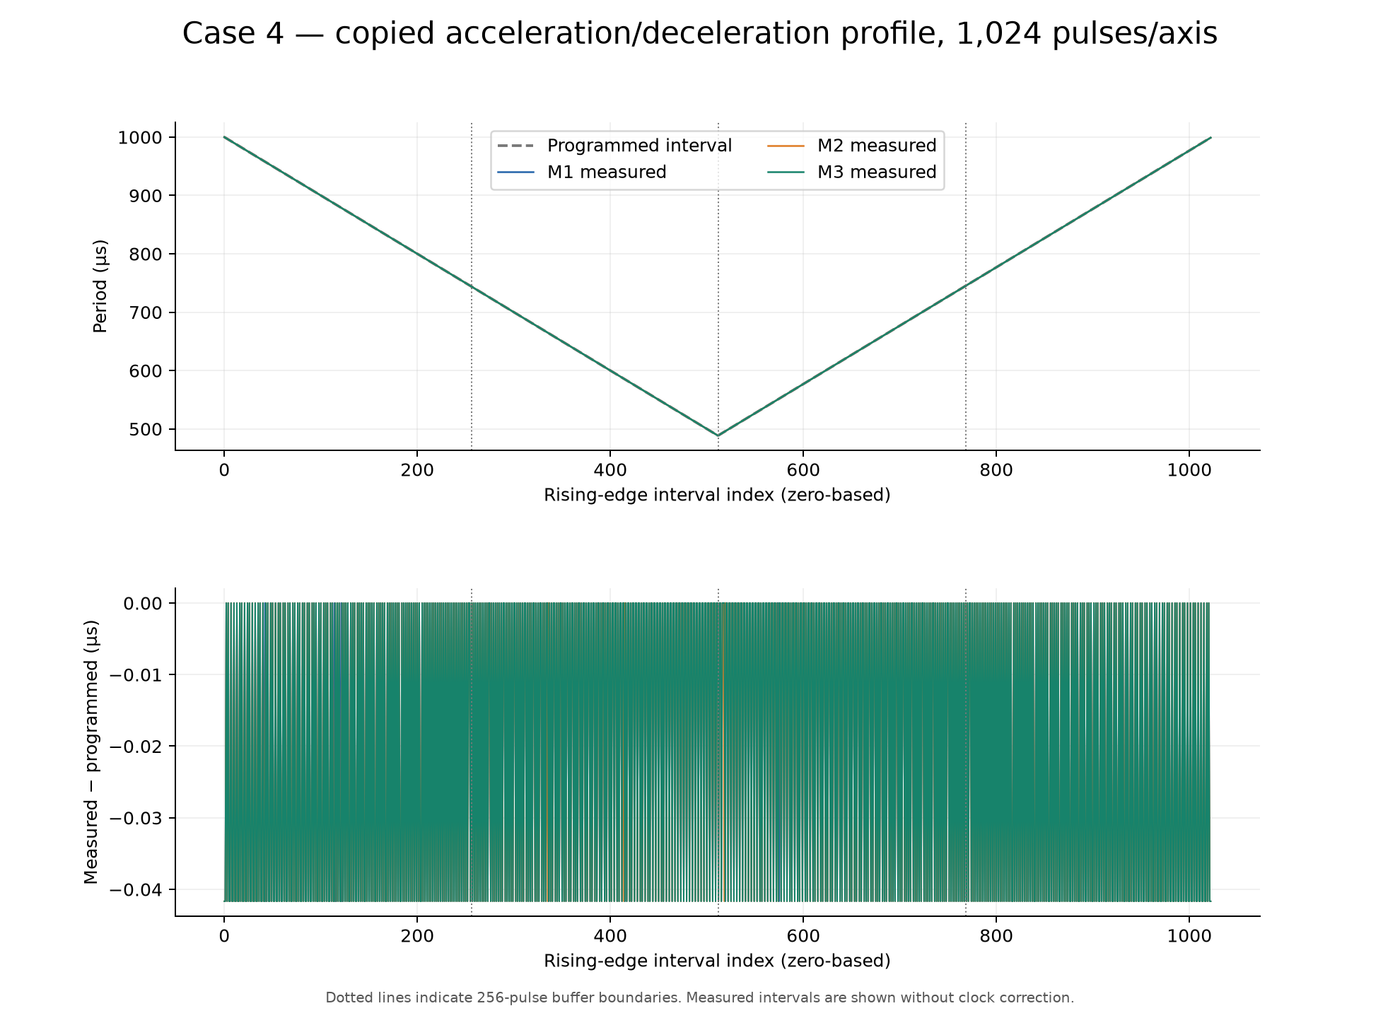
docs/measurements/2026-10-03-step-generator/05-profile.png
