daleondev/ProtoMate_Control/docs/measurements/2026-10-03-step-generator/06-delayed-interrupt.png

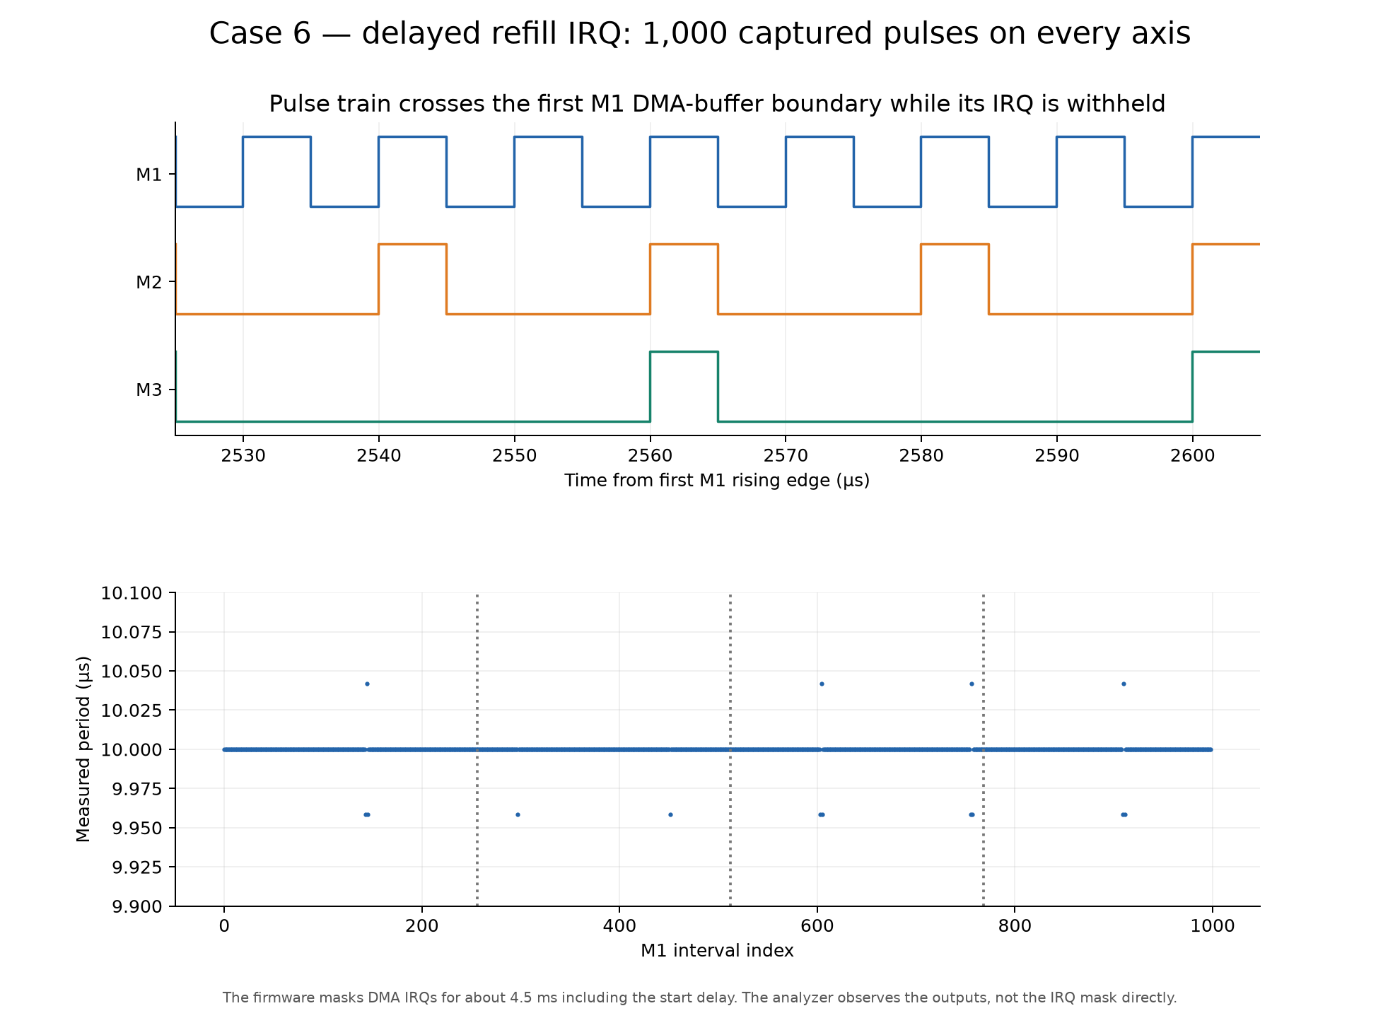
docs/measurements/2026-10-03-step-generator/06-delayed-interrupt.png
