daleondev/ProtoMate_Control/docs/measurements/2026-10-03-step-generator/07-underrun-stop.png

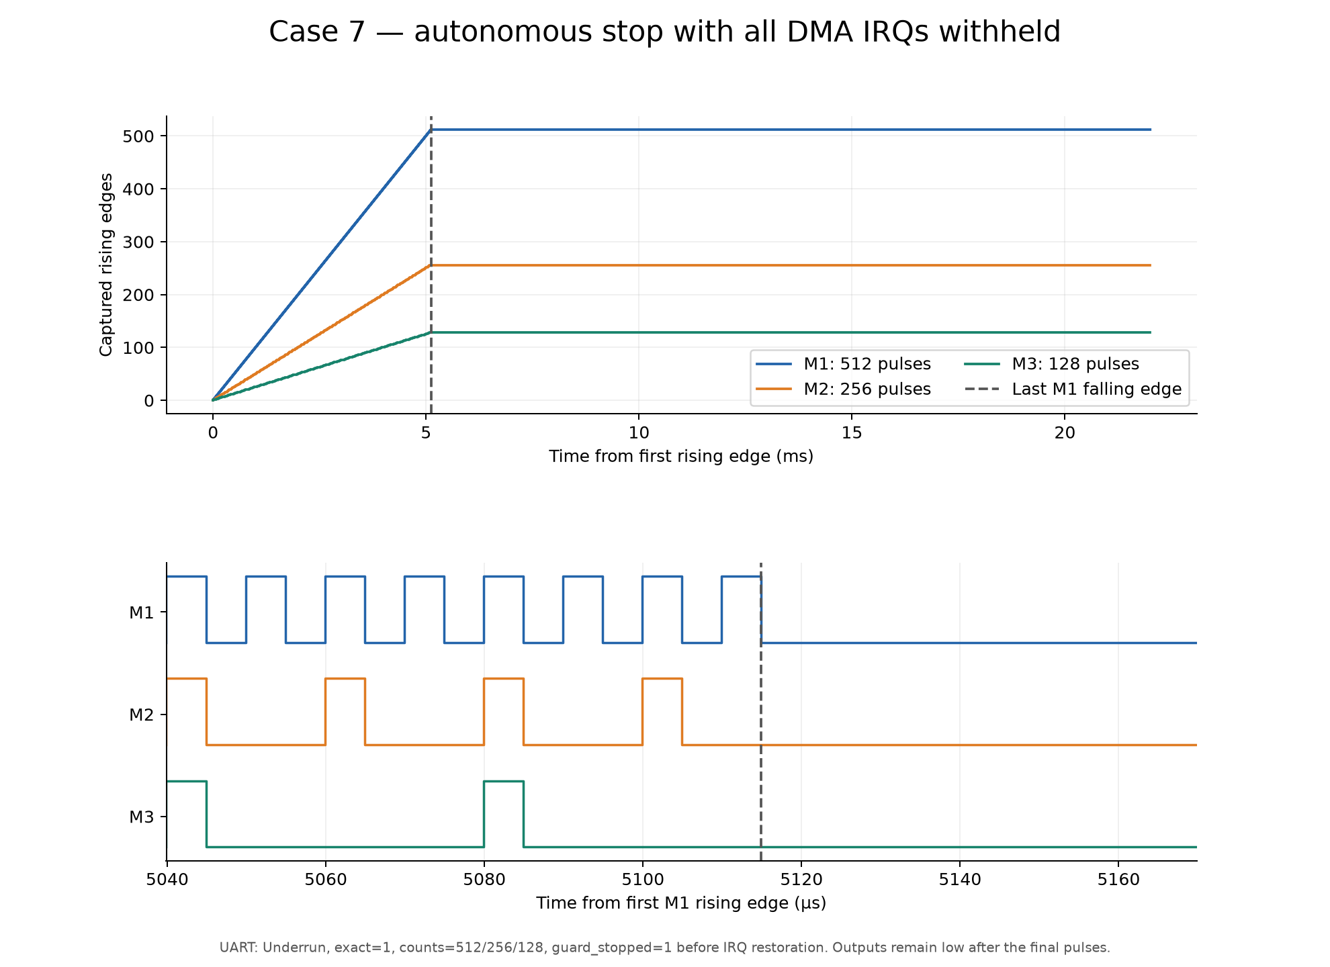
docs/measurements/2026-10-03-step-generator/07-underrun-stop.png
