daleondev/ProtoMate_Control/docs/measurements/2026-10-03-step-generator/08-counter-wrap.png

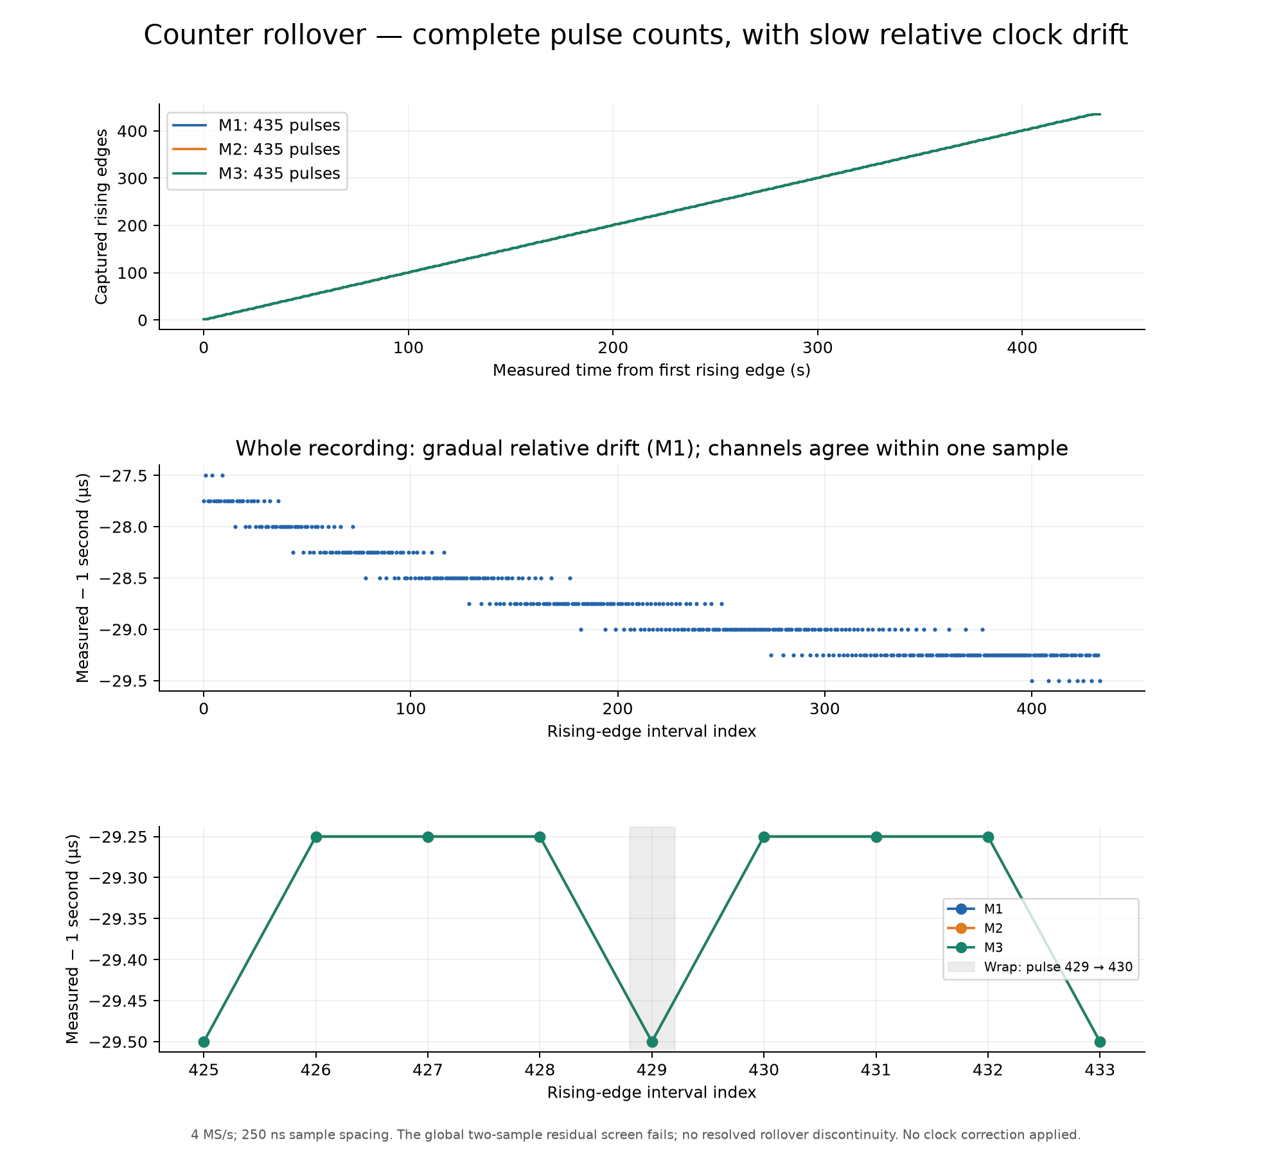
docs/measurements/2026-10-03-step-generator/08-counter-wrap.png
