daleondev/ProtoMate_Control/docs/measurements/2026-10-03-step-generator/09-oscilloscope-waveforms.png

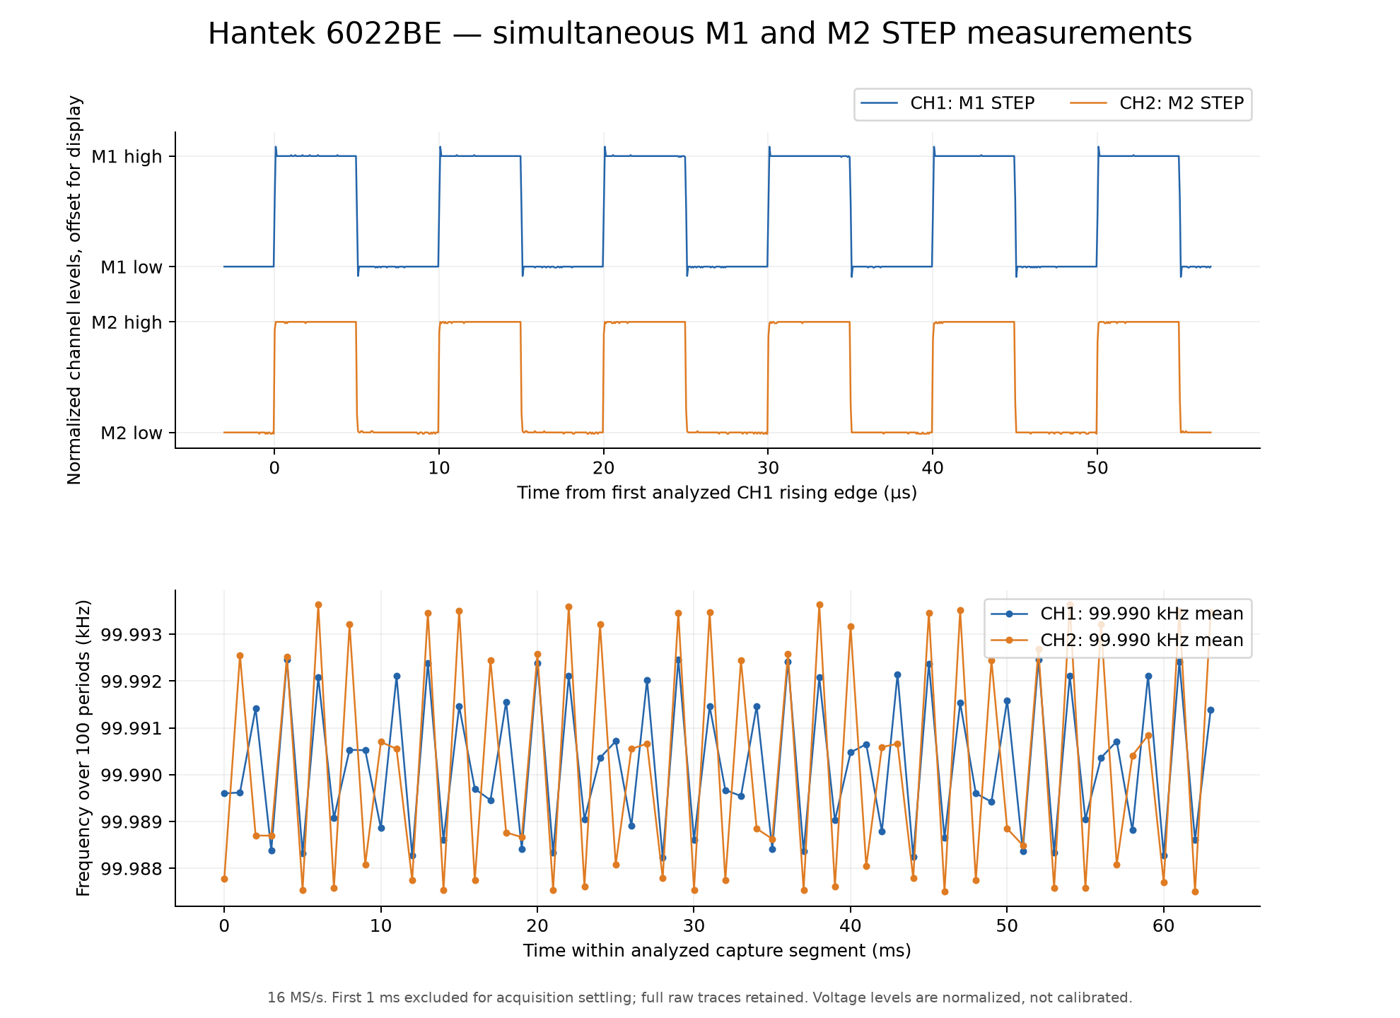
docs/measurements/2026-10-03-step-generator/09-oscilloscope-waveforms.png
