daleondev/ProtoMate_Control/docs/measurements/2026-10-03-step-generator/10-independent-timebases.png

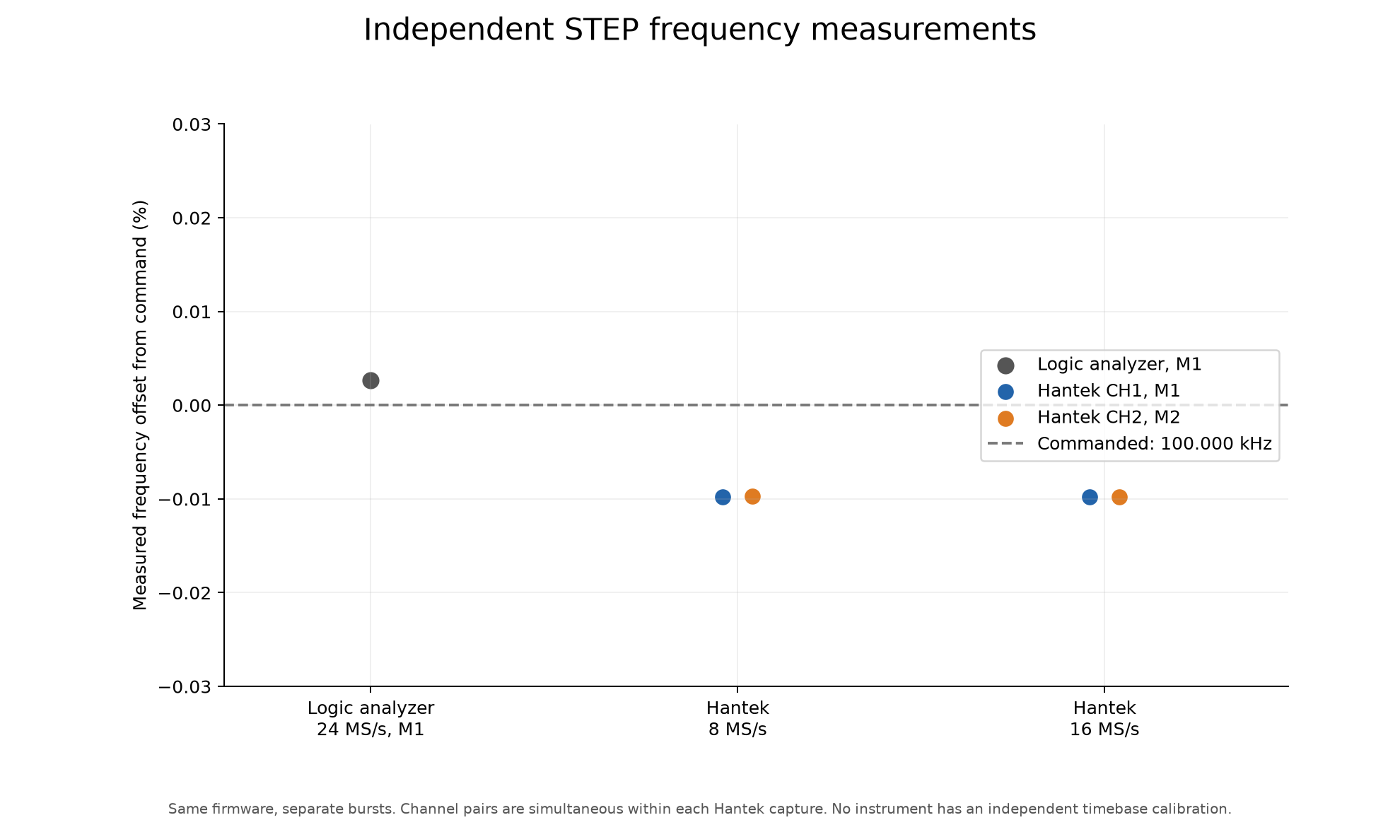
docs/measurements/2026-10-03-step-generator/10-independent-timebases.png
