daleondev/ProtoMate_Control/docs/measurements/2026-10-03-step-generator/11-rtc-reference.png

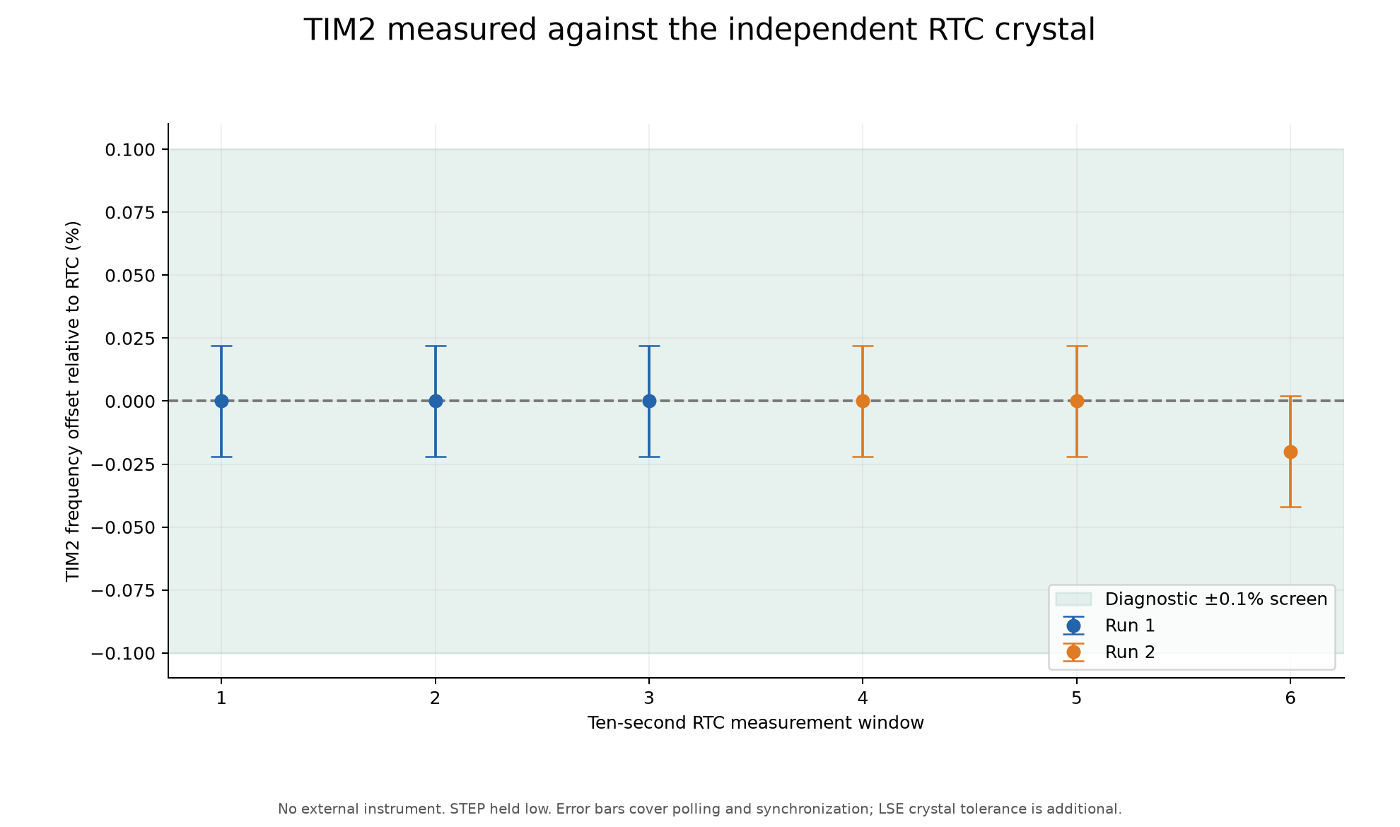
docs/measurements/2026-10-03-step-generator/11-rtc-reference.png
