daleondev/ProtoMate_Control/hardware/display/assembly/display-bottom-rev-A.png

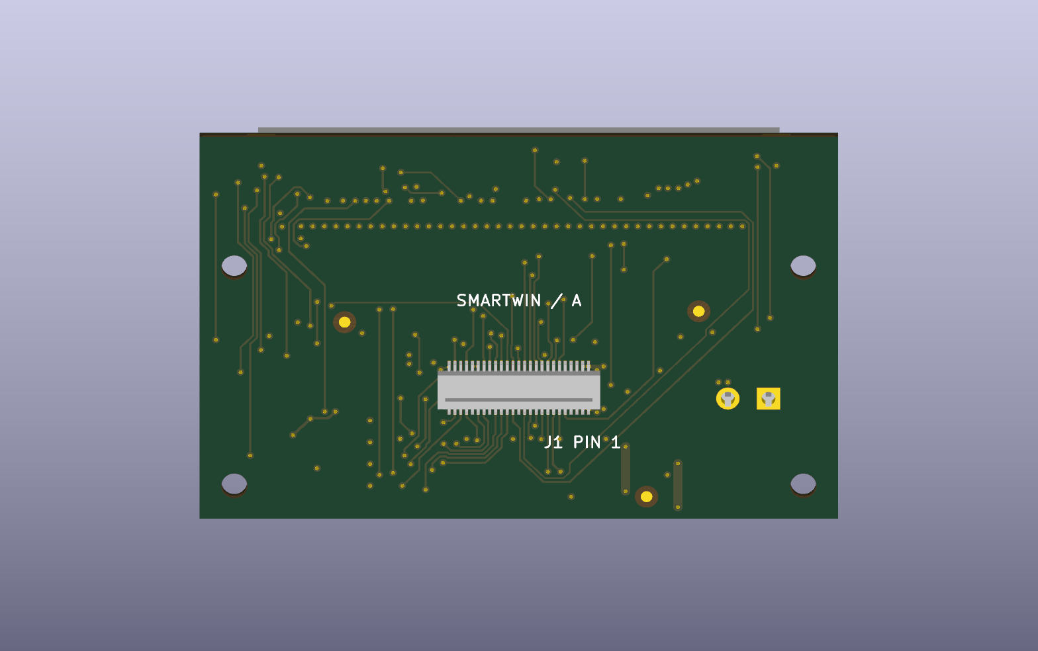
hardware/display/assembly/display-bottom-rev-A.png
