daleondev/ProtoMate_Control/hardware/display/assembly/display-bottom-rev-B.png

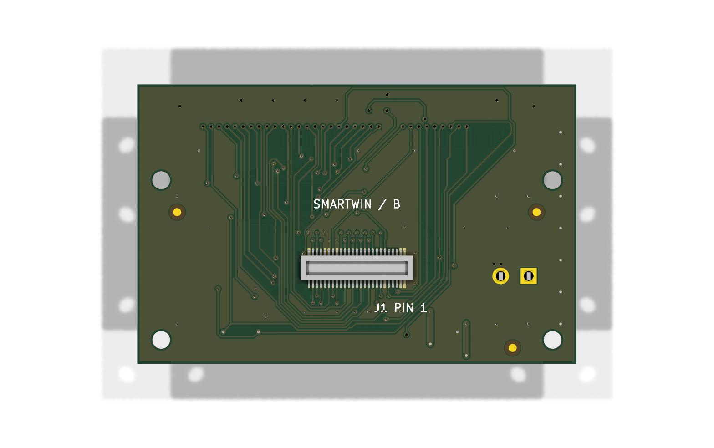
hardware/display/assembly/display-bottom-rev-B.png
