daleondev/ProtoMate_Control/hardware/display/assembly/display-top-rev-A.png

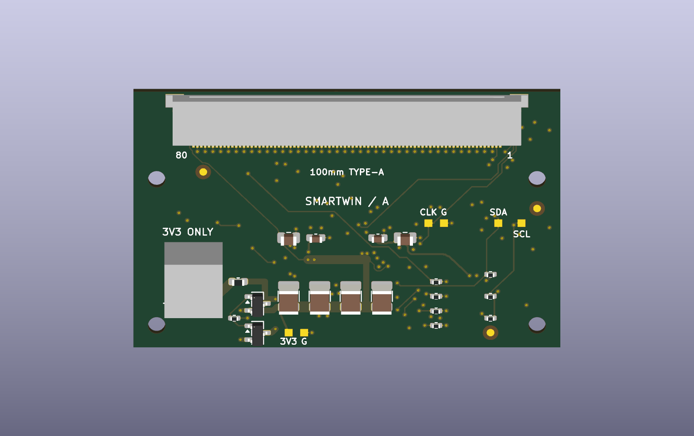
hardware/display/assembly/display-top-rev-A.png
