daleondev/ProtoMate_Control/hardware/display/assembly/display-top-rev-B.png

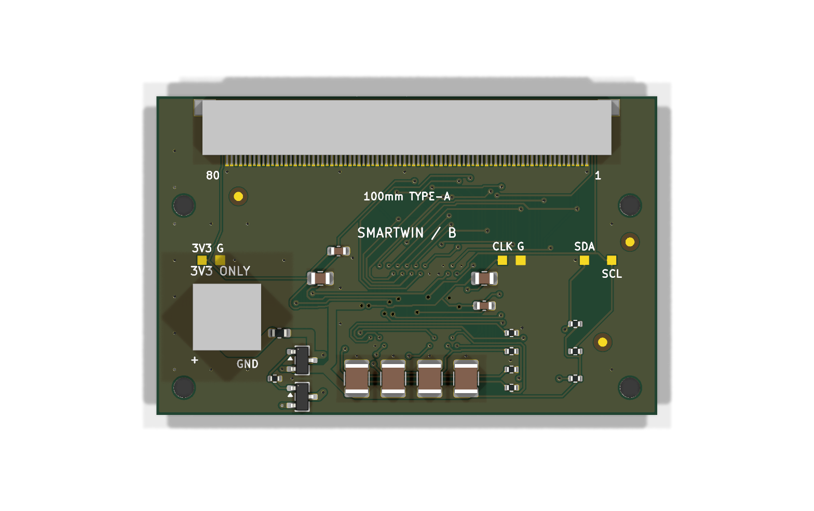
hardware/display/assembly/display-top-rev-B.png
