daleondev/ProtoMate_Control/hardware/display/assembly/display-top-rev-E.png

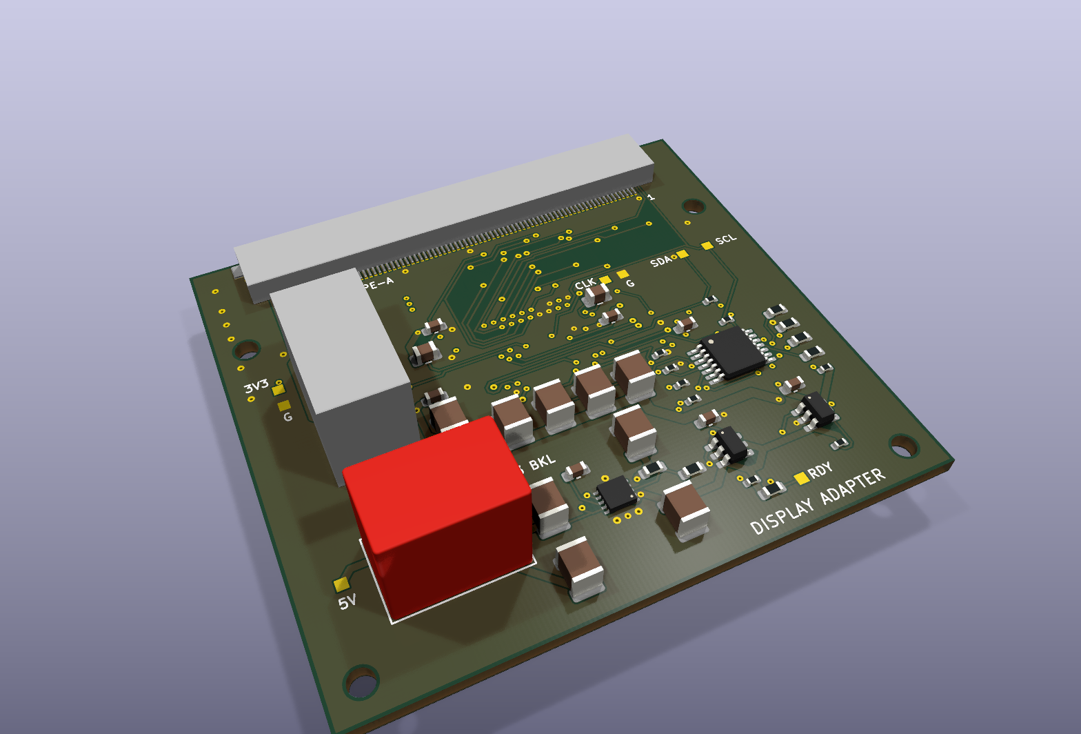
hardware/display/assembly/display-top-rev-E.png
