daleondev/ProtoMate_Control/hardware/display/assembly/giga-bottom-rev-F.png

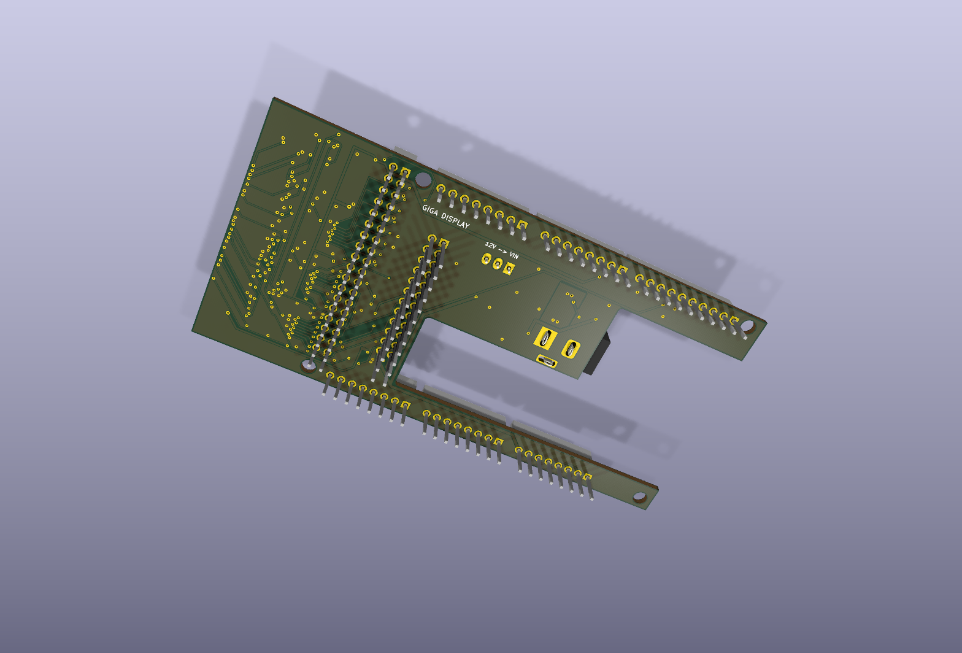
hardware/display/assembly/giga-bottom-rev-F.png
