daleondev/ProtoMate_Control/hardware/display/assembly/giga-mated-rev-B.png

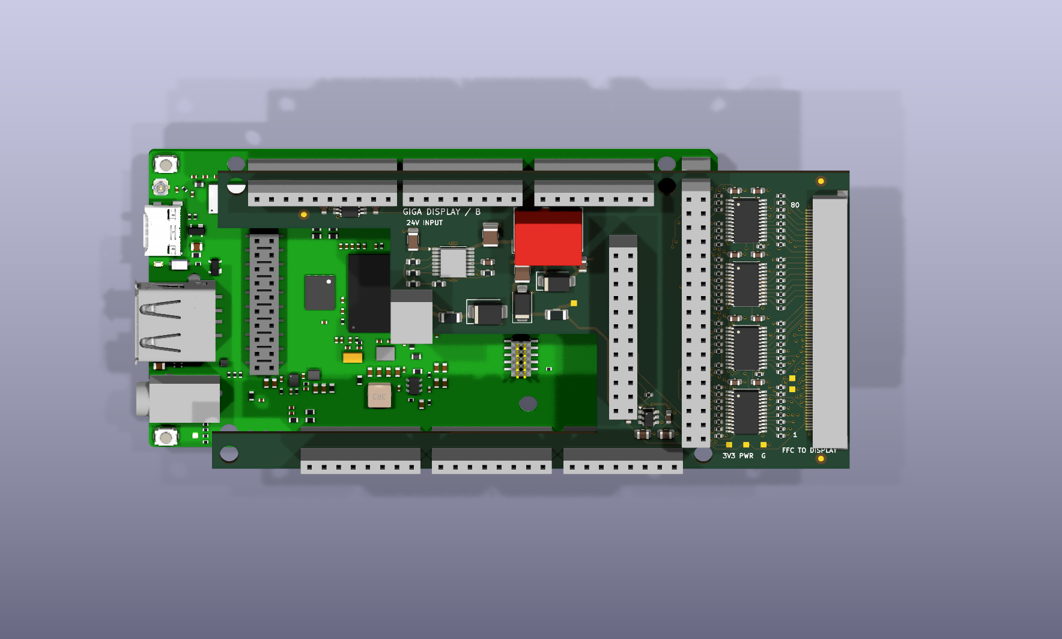
hardware/display/assembly/giga-mated-rev-B.png
