daleondev/ProtoMate_Control/hardware/display/assembly/giga-mated-rev-F.png

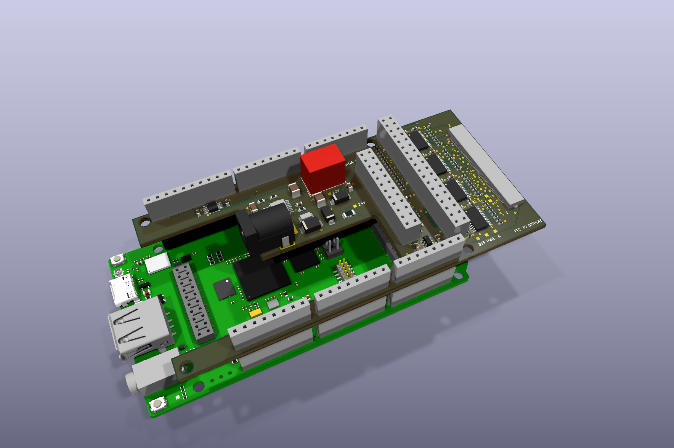
hardware/display/assembly/giga-mated-rev-F.png
