daleondev/ProtoMate_Control/hardware/display/assembly/giga-top-rev-B.png

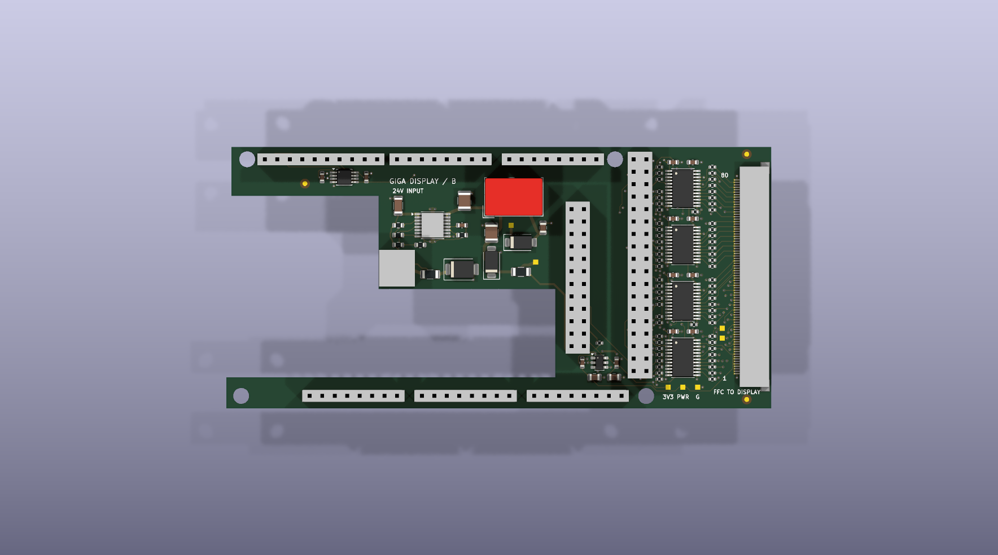
hardware/display/assembly/giga-top-rev-B.png
