daleondev/ProtoMate_Control/hardware/display/assembly/giga-top-rev-C.png

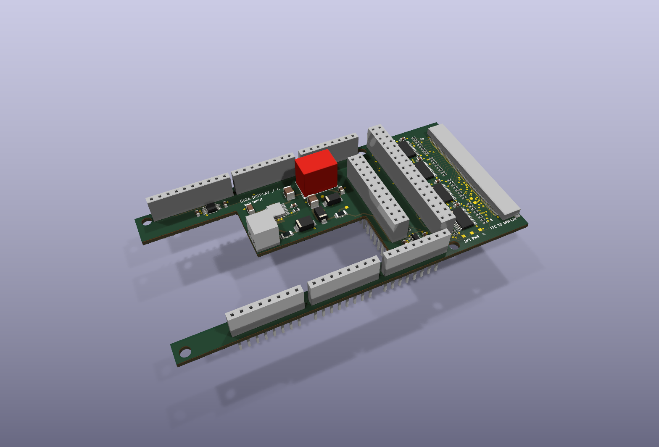
hardware/display/assembly/giga-top-rev-C.png
