daleondev/ProtoMate_Control/hardware/display/manufacturing/display-adapter-rev-G/inspection/bottom.png

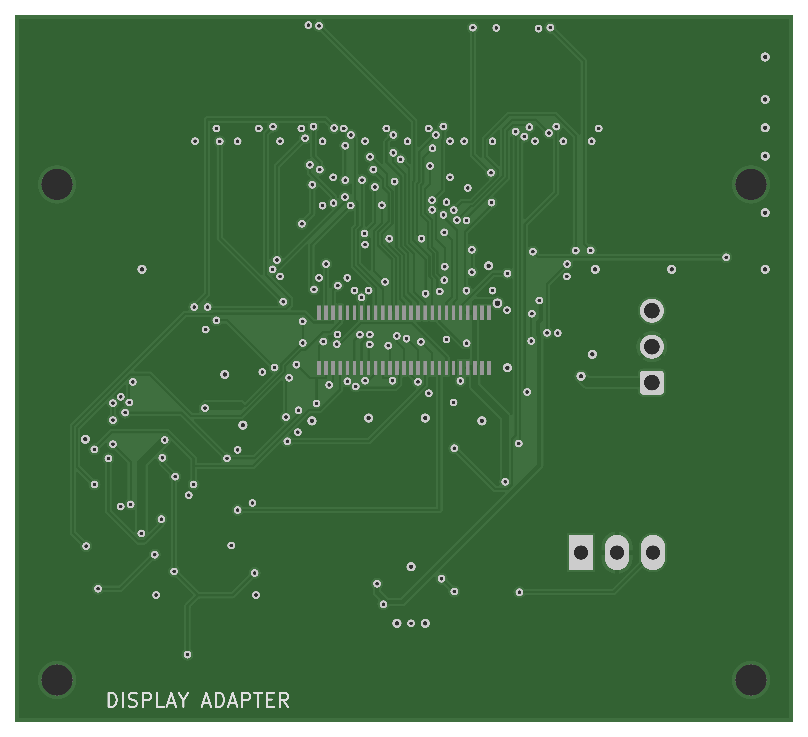
hardware/display/manufacturing/display-adapter-rev-G/inspection/bottom.png
