daleondev/ProtoMate_Control/hardware/display/manufacturing/display-adapter-rev-G/inspection/inner_2-copper.png

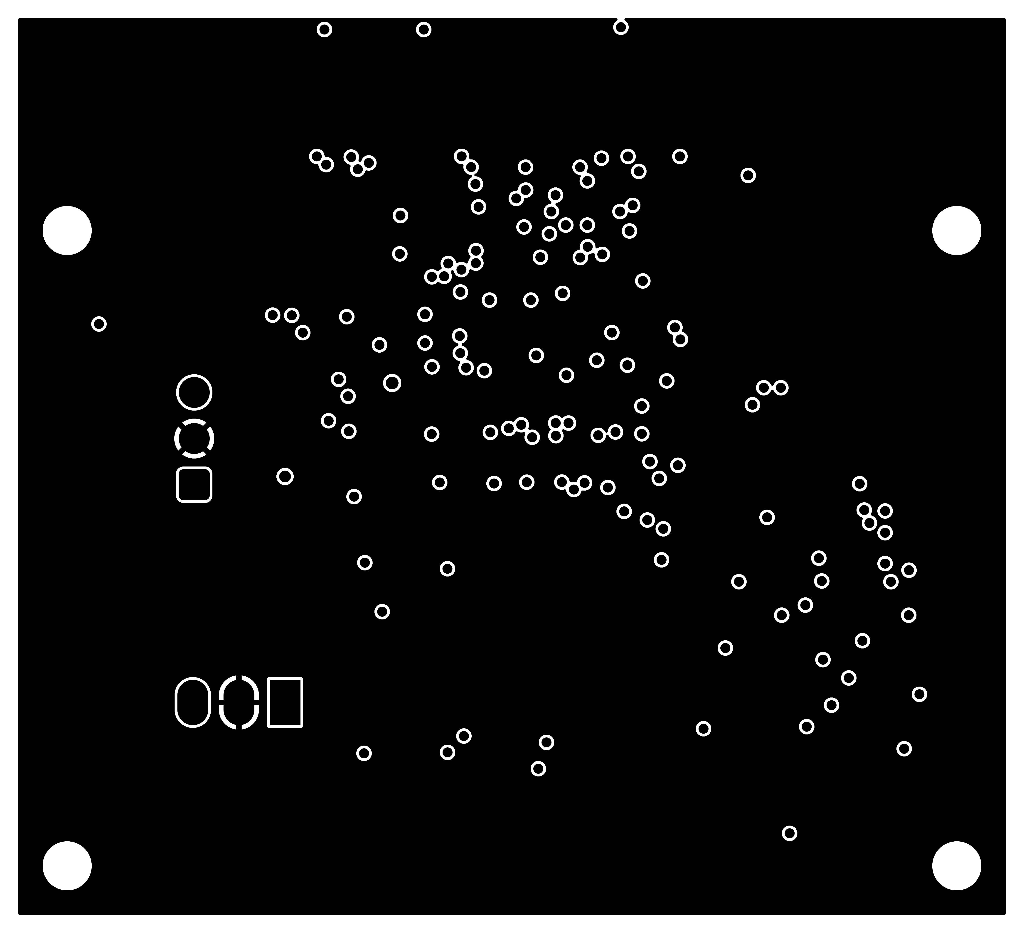
hardware/display/manufacturing/display-adapter-rev-G/inspection/inner_2-copper.png
