daleondev/ProtoMate_Control/hardware/display/manufacturing/display-adapter-rev-G/inspection/top-copper.png

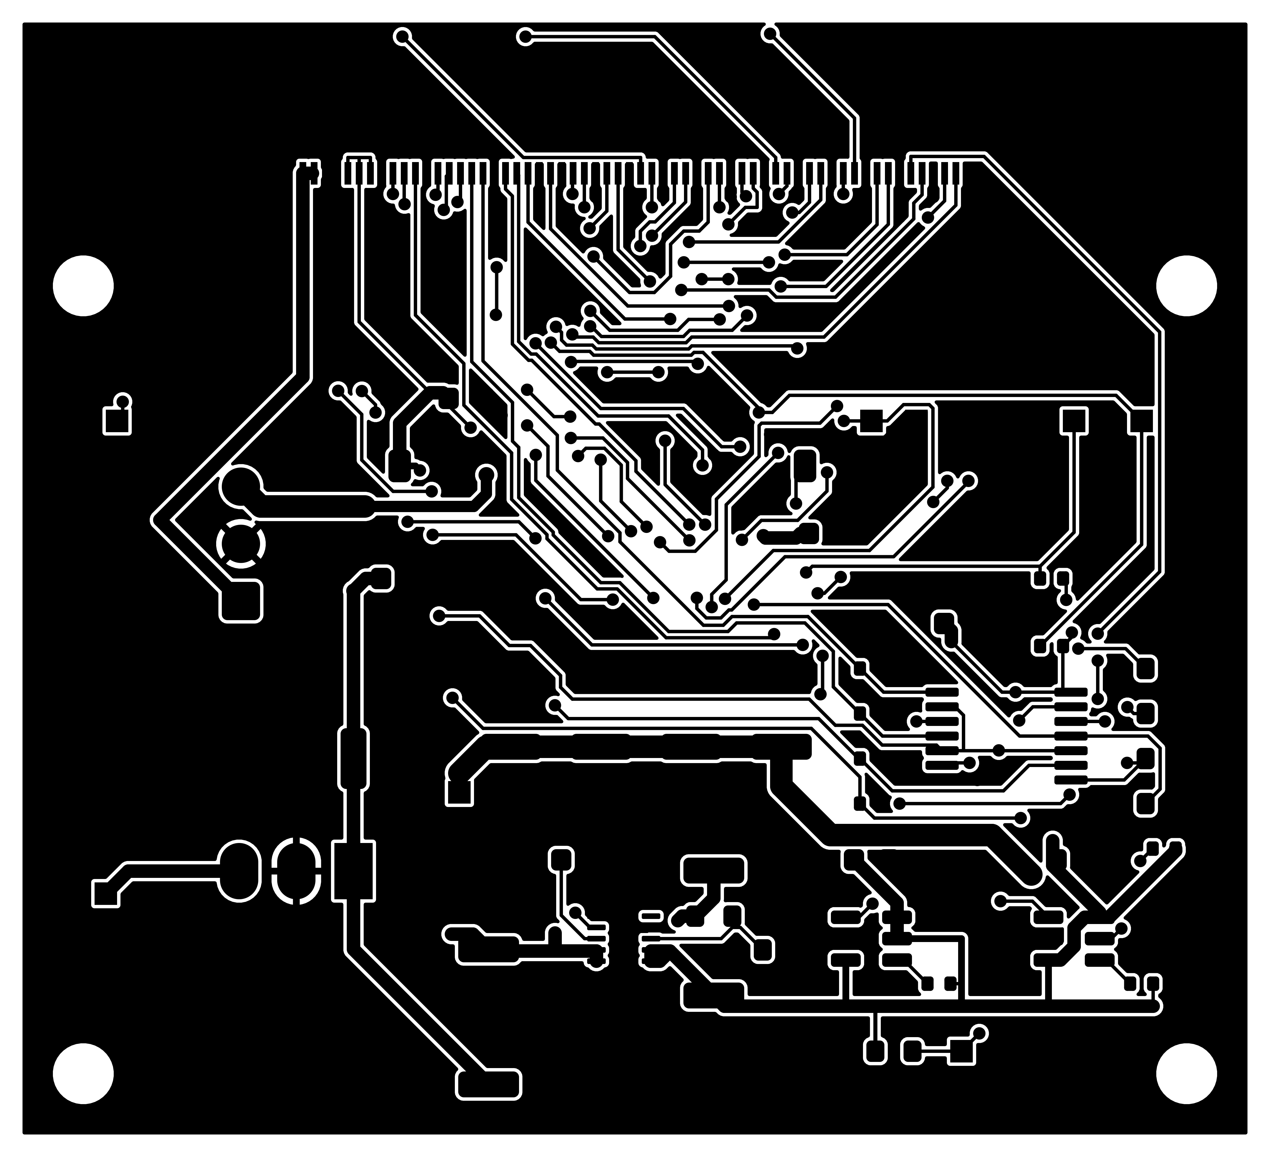
hardware/display/manufacturing/display-adapter-rev-G/inspection/top-copper.png
