daleondev/ProtoMate_Control/hardware/display/manufacturing/giga-adapter-rev-F/inspection/bottom-copper.png

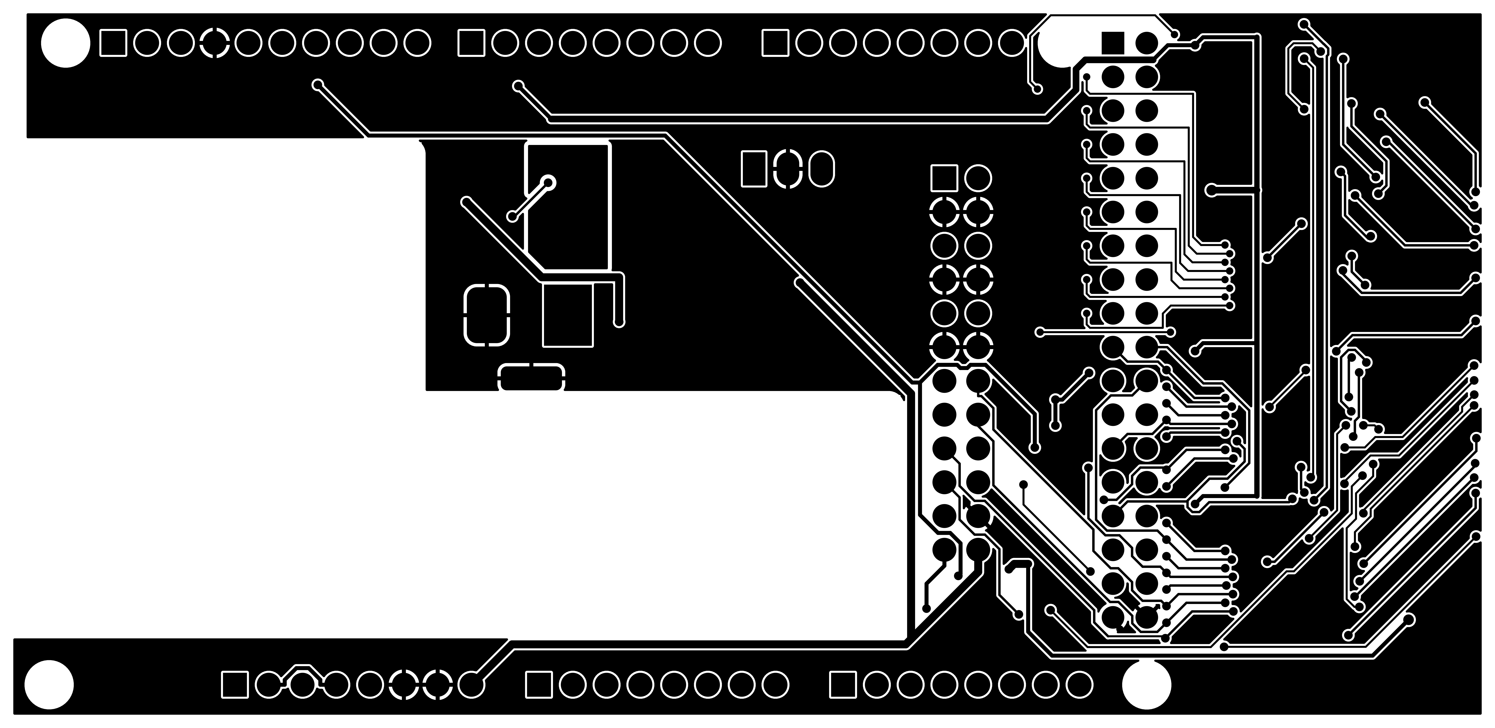
hardware/display/manufacturing/giga-adapter-rev-F/inspection/bottom-copper.png
