daleondev/ProtoMate_Control/hardware/perfboard/exports/Verification.txt

KiCad 10.0.6: native project verification
PASS: one continuous 47 x 65 hole grid (A1:BM47), 2.54 mm pitch, 3055 holes.
PASS: nominal outline 119.38 x 165.10 mm; outer hole-centre span 116.84 x 162.56 mm.
PASS: 49 footprints linked to schematic symbols; values, library IDs and pins match.
PASS: 188 unique component holes and 114 wire passages on the 2.54 mm grid.
PASS: 139 scheduled connections span all 45 connected nets.
PASS: 83 underside-only wires; 56 wires use 57 crossovers with dedicated free holes.
PASS: at most three scheduled wire ends per component solder joint.
PASS: 82 header positions and their external destinations match the schematic.
PASS: four GIGA harnesses; 21 distinct signal/supply contacts and nine ground returns.
PASS: STEP and encoder pairs retain ground returns; reference/UART/DIAG share returns; ALM uses J101.4.
PASS: 20 motor, encoder, reference and driver contacts match the GIGA schematic.
PASS: CubeMX pins, M4 ownership, labels, input pulls/edges, UART and disabled startup match wiring: /home/david/Dokumente/ProtoMate_Control/external/CubeMX/CubeMX.ioc
PASS: GIGA has only signal/3V3/GND connections; no buck 5 V feed or external storage bus.
PASS: existing R7 enable pull-up and R1/R2, R8/R9 STEP pull-down paths remain fitted.
PASS: DM542T ALM uses A3/PB1, 4.7k pull-up to 3.3 V and GND return; high = fault/open.
PASS: shared UART bus, 1k TX resistor and driver address straps 0/1 match system wiring.
PASS: all three module bodies fit; direct mounting contacts match system wiring.
PASS: J104 combines DM542T control 1-6, ALM 7/8 and 24 V/GND 9/10 in one outward-facing screw terminal.
PASS: buck VIN feeds J104.9/10 and separate TMC power branches; all 11 power links are underneath.
PASS: TMC logic grounds join local power returns; motor current has dedicated return wiring.
PASS: 24 V appears only on designated power pads; C1/C2 polarity and module power contacts match.
PASS: all parts on top; R10-R12 are DNP; 24 V and logic rails remain distinct.
Native ERC and DRC (including schematic parity): see ERC.rpt and DRC.rpt.
Wire endpoints/passages are checked; routing lengths and sides need review after route edits.
This checks the wiring model, not an assembled circuit or transistor switching speed.
Board SHA256: f761c1e14f85985cadf89aa6d7cd23d781109aa2a17546e4dd88a55803b3fc6b
ProtoMate.kicad_sch SHA256: 289065a17ef391b0aef55363c3aabd1e2d05a1e4399a4867b5b405e05034b419
sheets/M1_DM542T.kicad_sch SHA256: a0db992db9e13b5ccc6f79f714b3556153ee65bf4955fcf4214268a376029f23
sheets/M1_Encoder.kicad_sch SHA256: 63f71f8f8bb98fd98a23362e9734721a9ce2a80467ab96ecb4424c1d8312763d
sheets/M2_M3_TMC2209.kicad_sch SHA256: d97544fc2d0f57a73a51209c65c55edec7ea16b8d14716858a073d72d9a21c63
sheets/Perfboard_Connectors.kicad_sch SHA256: 9d368faa3a29cf5ebf6cd30db2a882f99229c72cce888829b39d6105f38266c8
sheets/Reference_Switches.kicad_sch SHA256: 6a08a35dd41271264a0a50868852746d4526f7b52420235157a369ccecd14d6b
