daleondev/ProtoMate_Control/docs/measurements/2026-10-03-step-generator/measurements.csv

capture | case | samplerate_Hz | axis | captured_rises | reported_count | mean_period_us | min_period_us | max_period_us | min_high_us | max_high_us | firmware_result | state
case-1 | 1 | 24000000 | 1 | 1 | 1 |  |  |  | 5.0 | 5.0 | PASS | Completed
case-1 | 1 | 24000000 | 2 | 2 | 2 | 1000.0 | 1000.0 | 1000.0 | 5.0 | 5.0 | PASS | Completed
case-1 | 1 | 24000000 | 3 | 3 | 3 | 999.9791666666667 | 999.9583333333334 | 1000.0 | 5.0 | 5.0 | PASS | Completed
case-2 | 2 | 24000000 | 1 | 1000 | 1000 | 999.9732232232234 | 999.9583333333334 | 1000.0 | 5.0 | 5.041666666666667 | PASS | Completed
case-2 | 2 | 24000000 | 2 | 1500 | 1500 | 499.98660217923054 | 499.9583333333333 | 500.0 | 5.0 | 5.041666666666667 | PASS | Completed
case-2 | 2 | 24000000 | 3 | 2000 | 2000 | 249.9933091545773 | 249.95833333333334 | 250.0 | 5.0 | 5.041666666666667 | PASS | Completed
case-3 | 3 | 24000000 | 1 | 100000 | 100000 | 9.999731247312473 | 9.958333333333334 | 10.041666666666666 | 5.0 | 5.041666666666667 | PASS | Completed
case-3 | 3 | 24000000 | 2 | 100000 | 100000 | 9.999731247312473 | 9.958333333333334 | 10.041666666666666 | 5.0 | 5.041666666666667 | PASS | Completed
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
