daleondev/ProtoMate_Control/docs/measurements/2026-10-03-step-generator/scope-measurements.csv

capture | samplerate_Hz | channel | rising_edges_in_window | frequency_hz | period_mean_us | period_min_us | period_max_us | frequency_offset_percent
hantek-16mhz | 16000000 | CH1 | 6453 | 99990.2393909237 | 10.000976156186416 | 9.999527969845076 | 10.004861110163802 | -0.009760609076303606
hantek-16mhz | 16000000 | CH2 | 6453 | 99990.22151500435 | 10.000977944127683 | 9.999237802447169 | 10.009207590708684 | -0.009778484995648373
hantek-8mhz | 8000000 | CH1 | 13006 | 99990.24849925592 | 10.00097524517545 | 9.99791666692181 | 10.011174238461535 | -0.00975150074408182
hantek-8mhz | 8000000 | CH2 | 13006 | 99990.28501664924 | 10.000971592725147 | 9.998475604894338 | 10.017045437271008 | -0.009714983350761486
