daleondev/ProtoMate_Control/hardware/display/manufacturing/verification/route-lengths.csv

signal | giga_input_mm | buffer_to_series_mm | series_to_ffc_mm | display_ffc_to_panel_mm | total_adapter_copper_mm | relative_to_clock_mm
R0 | 5.0912 | 4.7877 | 12.245 | 28.5155 | 50.6395 | -47.287
R1 | 4.9267 | 15.2126 | 22.5397 | 31.027 | 73.706 | -24.2205
R2 | 6.0354 | 3.5912 | 10.8209 | 29.3998 | 49.8473 | -48.0792
R3 | 8.7924 | 3.021 | 19.7906 | 69.2534 | 100.8574 | 2.9309
R4 | 10.6824 | 2.7725 | 20.5654 | 61.5987 | 95.6189 | -2.3075
R5 | 12.5724 | 2.7311 | 7.9 | 34.8174 | 58.0209 | -39.9056
R6 | 14.4624 | 2.9796 | 8.7532 | 31.3863 | 57.5814 | -40.345
R7 | 16.3524 | 3.2281 | 18.9705 | 45.6446 | 84.1956 | -13.7309
B0 | 24.1363 | 6.564 | 5.6324 | 20.206 | 56.5387 | -41.3878
B1 | 24.0007 | 3.7804 | 5.2665 | 25.5752 | 58.6228 | -39.3037
B2 | 21.4107 | 3.2695 | 6.6725 | 19.4064 | 50.7592 | -47.1673
B3 | 20.2207 | 3.021 | 18.4291 | 43.9713 | 85.6421 | -12.2843
B4 | 17.6307 | 2.7725 | 4.8247 | 16.9962 | 42.224 | -55.7024
B5 | 16.2628 | 2.7311 | 4.6011 | 40.5637 | 64.1587 | -33.7678
B6 | 14.1825 | 2.9796 | 4.6453 | 14.987 | 36.7943 | -61.1321
B7 | 15.4872 | 3.2281 | 5.0535 | 28.0762 | 51.845 | -46.0815
G0 | 11.2961 | 6.0416 | 7.1208 | 15.6033 | 40.0618 | -57.8647
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
