daleondev/ProtoMate_Control/hardware/display/manufacturing/verification/display-adapter-visual/B-filled-r02-c02.png

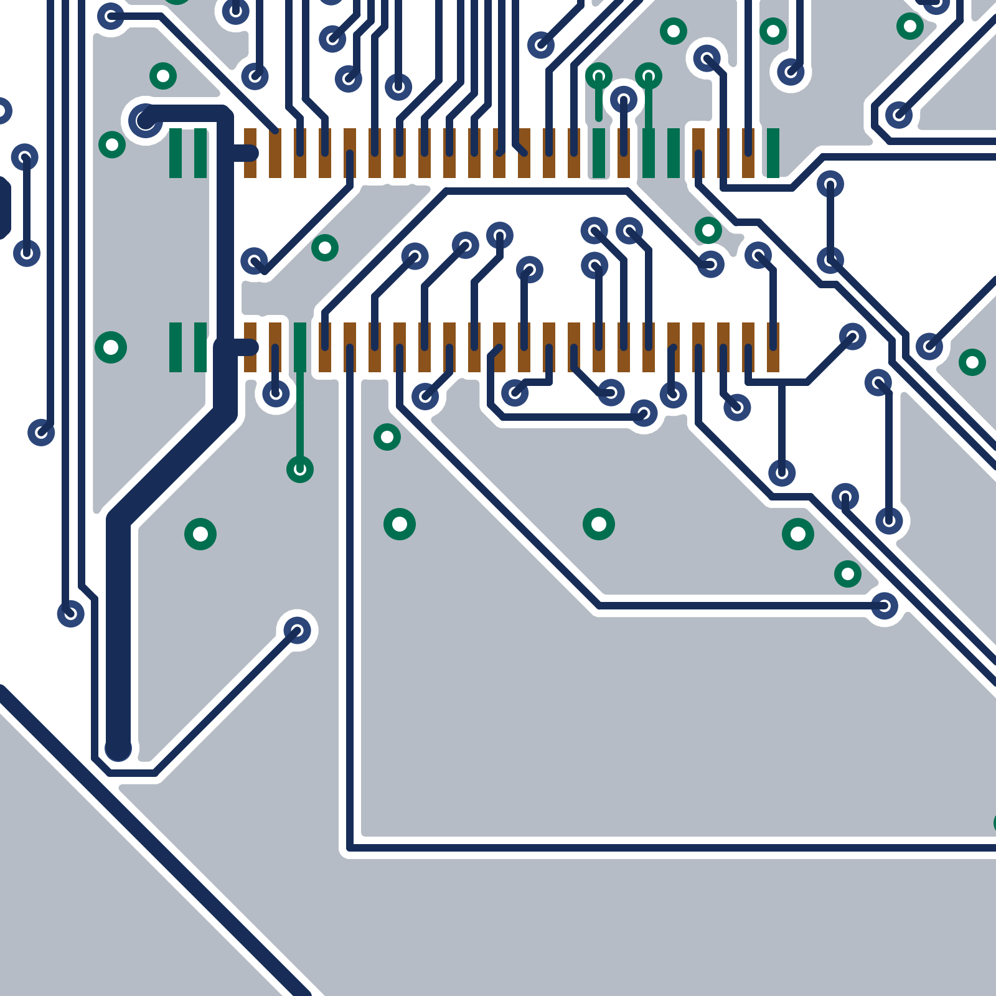
hardware/display/manufacturing/verification/display-adapter-visual/B-filled-r02-c02.png
