daleondev/ProtoMate_Control/hardware/display/manufacturing/verification/display-adapter-visual/B-routes-r01-c01.png

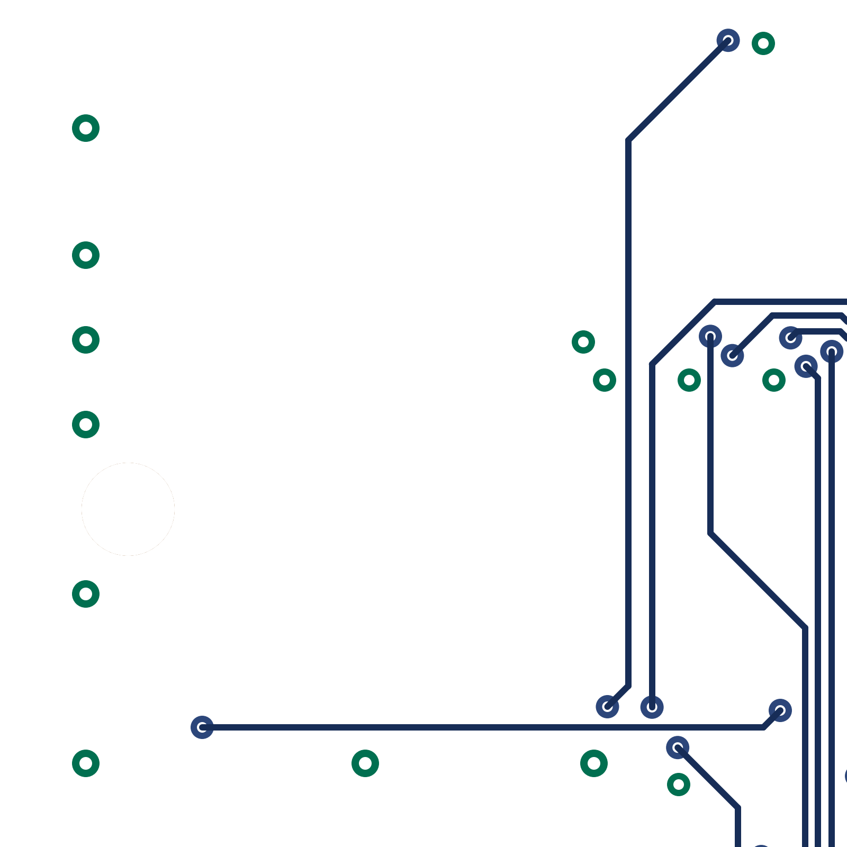
hardware/display/manufacturing/verification/display-adapter-visual/B-routes-r01-c01.png
