daleondev/ProtoMate_Control/hardware/display/manufacturing/verification/display-adapter-visual/export-gerber-B-r02-c02.png

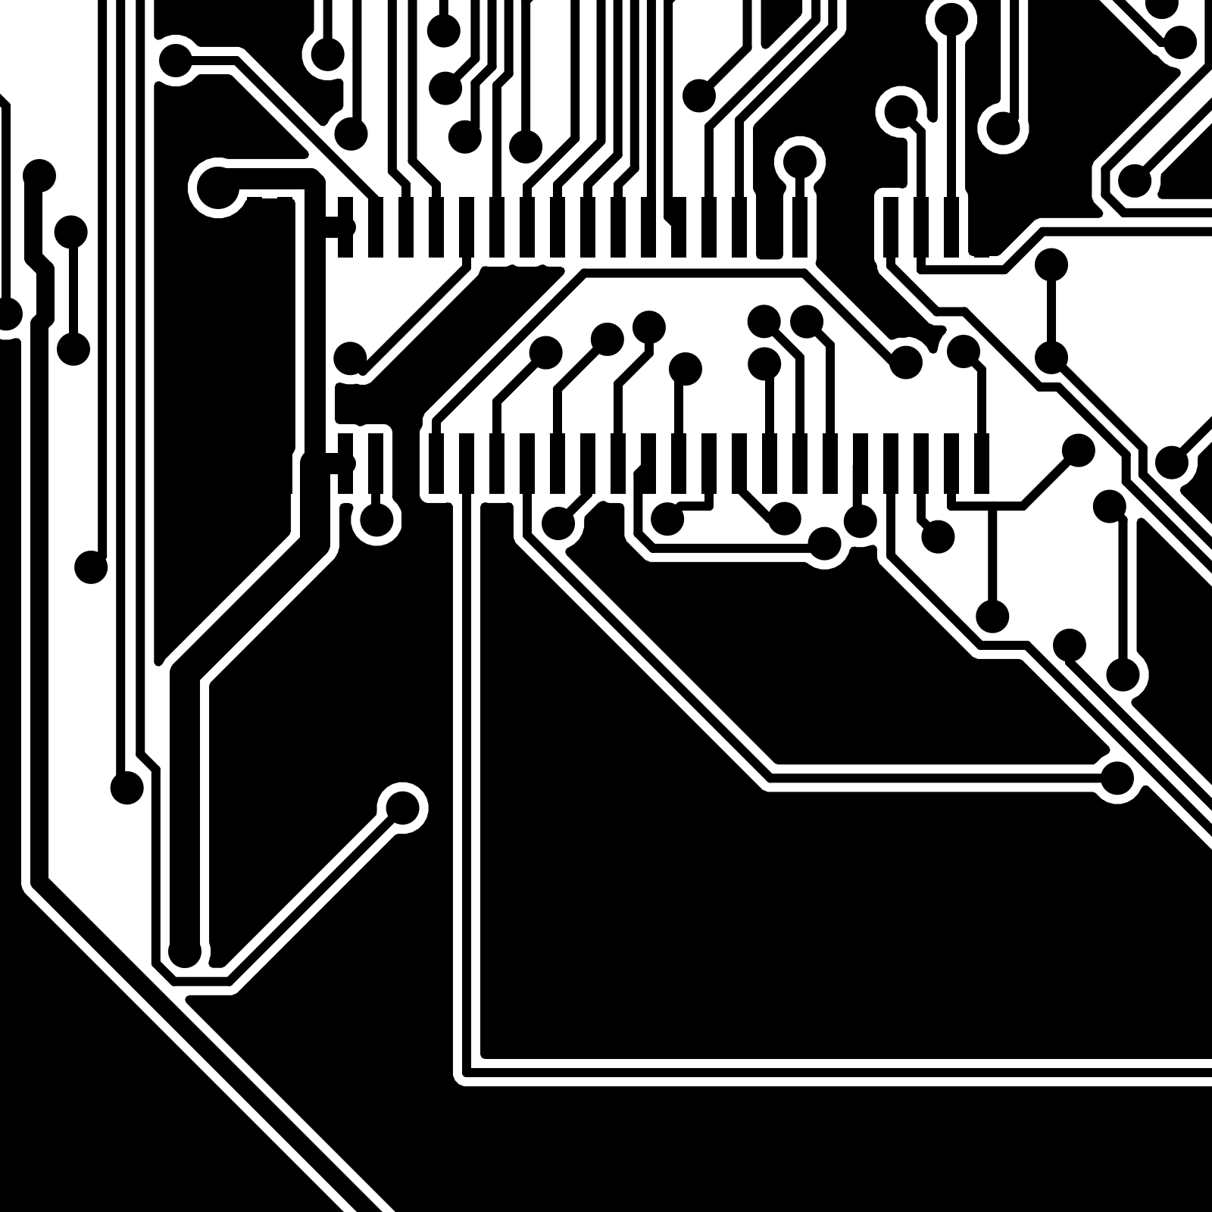
hardware/display/manufacturing/verification/display-adapter-visual/export-gerber-B-r02-c02.png
