daleondev/ProtoMate_Control/hardware/display/manufacturing/verification/display-adapter-visual/export-gerber-bottom-mask-silk-r01-c01.png

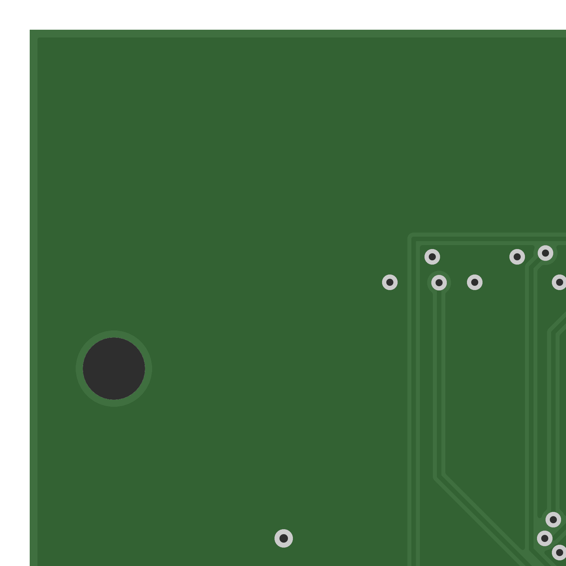
hardware/display/manufacturing/verification/display-adapter-visual/export-gerber-bottom-mask-silk-r01-c01.png
