daleondev/ProtoMate_Control/hardware/display/manufacturing/verification/display-adapter-visual/export-gerber-bottom-mask-silk-r01-c04.png

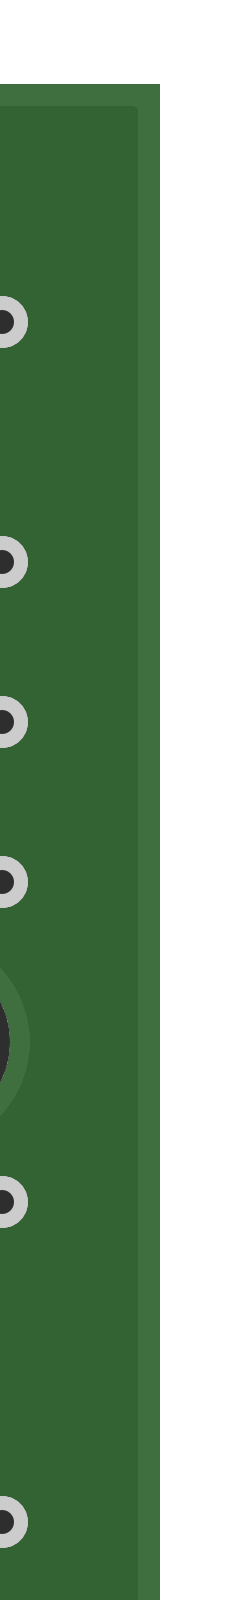
hardware/display/manufacturing/verification/display-adapter-visual/export-gerber-bottom-mask-silk-r01-c04.png
