daleondev/ProtoMate_Control/hardware/display/manufacturing/verification/display-adapter-visual/export-gerber-F-r01-c03.png

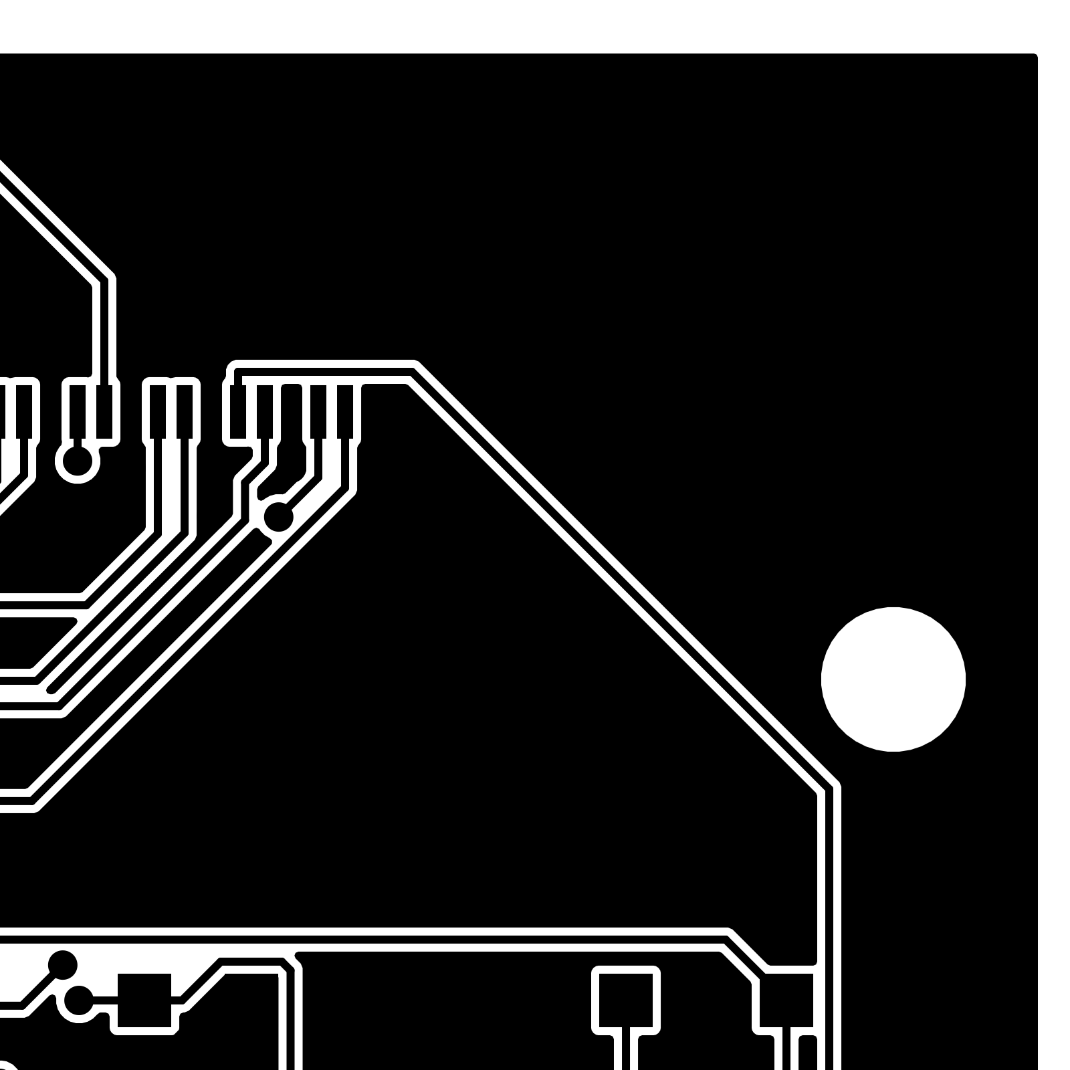
hardware/display/manufacturing/verification/display-adapter-visual/export-gerber-F-r01-c03.png
