daleondev/ProtoMate_Control/hardware/display/manufacturing/verification/display-adapter-visual/export-gerber-F-r03-c01.png

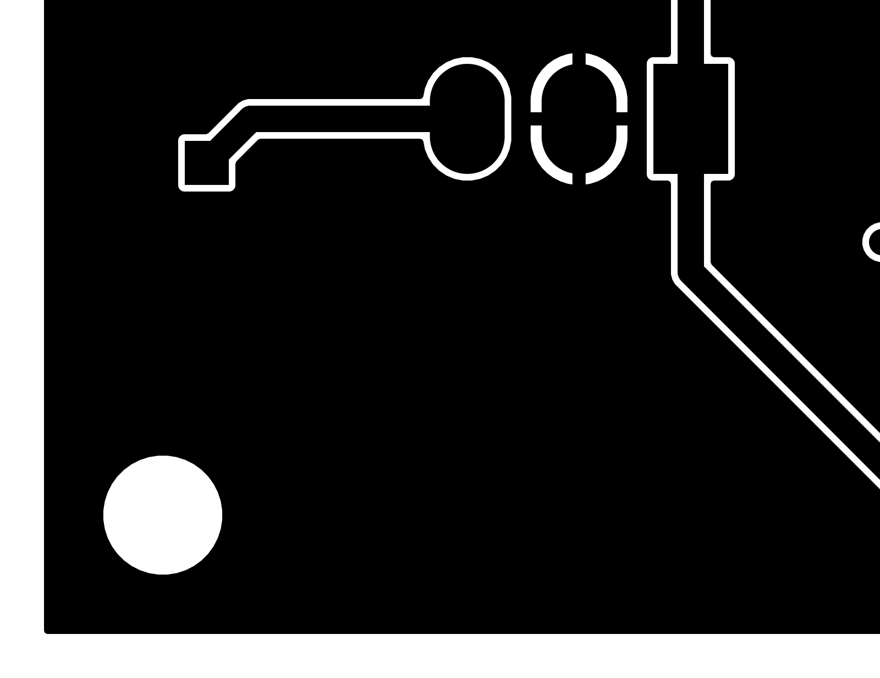
hardware/display/manufacturing/verification/display-adapter-visual/export-gerber-F-r03-c01.png
