daleondev/ProtoMate_Control/hardware/display/manufacturing/verification/display-adapter-visual/export-gerber-In2-r01-c01.png

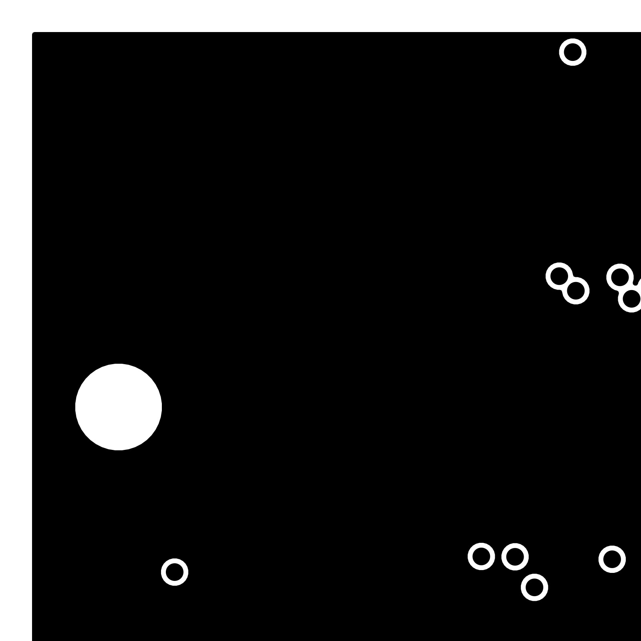
hardware/display/manufacturing/verification/display-adapter-visual/export-gerber-In2-r01-c01.png
