daleondev/ProtoMate_Control/hardware/display/manufacturing/verification/display-adapter-visual/export-gerber-In2-r03-c03.png

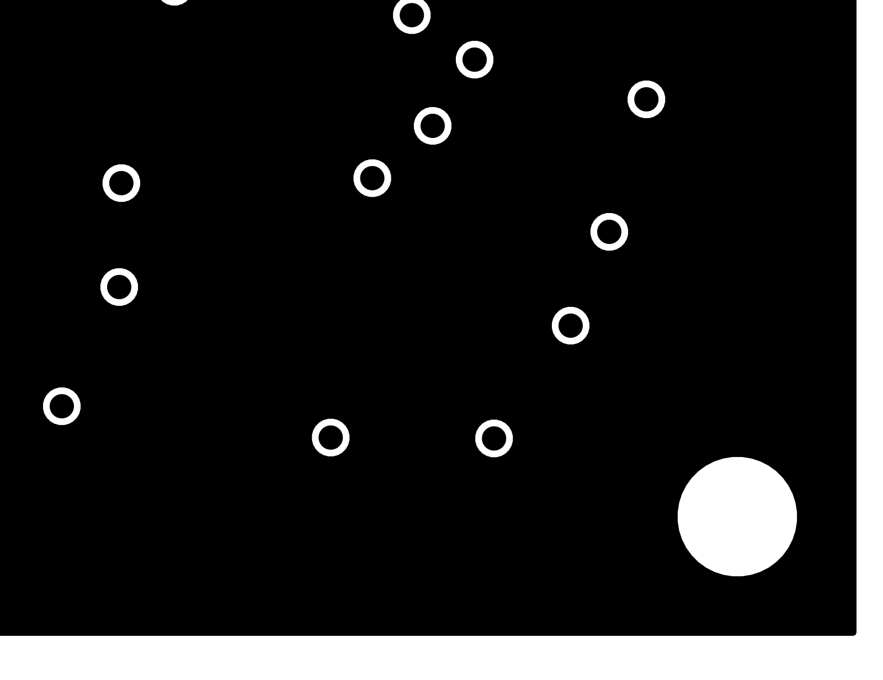
hardware/display/manufacturing/verification/display-adapter-visual/export-gerber-In2-r03-c03.png
