daleondev/ProtoMate_Control/hardware/display/manufacturing/verification/display-adapter-visual/export-gerber-top-mask-silk-r03-c03.png

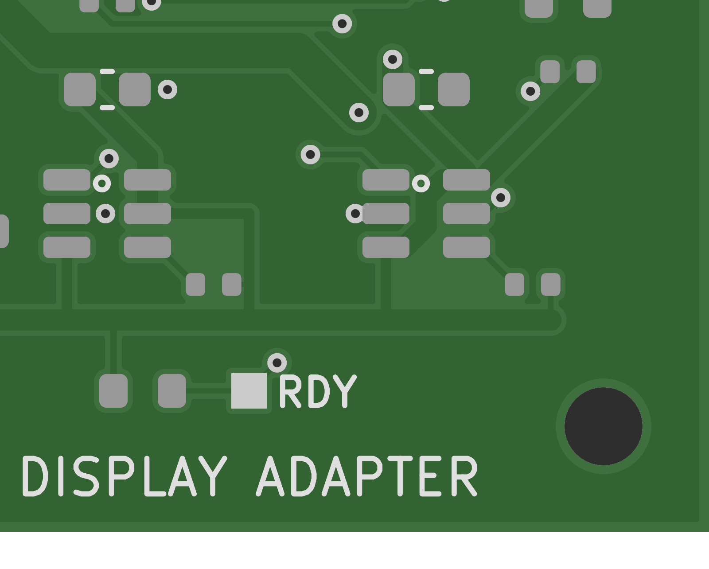
hardware/display/manufacturing/verification/display-adapter-visual/export-gerber-top-mask-silk-r03-c03.png
