daleondev/ProtoMate_Control/hardware/display/manufacturing/verification/display-adapter-visual/export-gerber-top-mask-silk.png

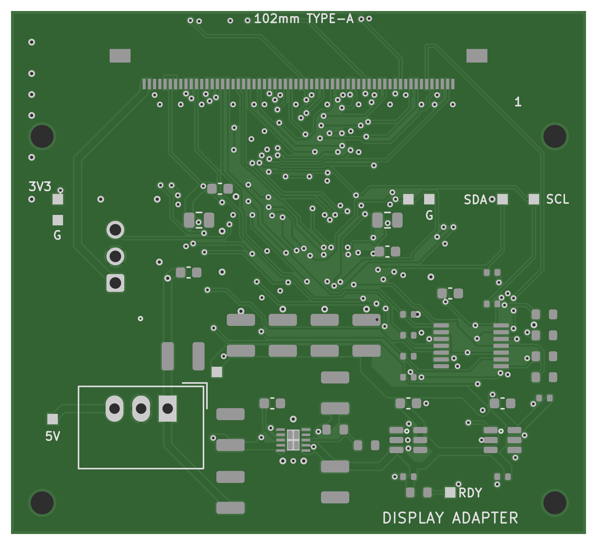
hardware/display/manufacturing/verification/display-adapter-visual/export-gerber-top-mask-silk.png
