daleondev/ProtoMate_Control/hardware/display/manufacturing/verification/display-adapter-visual/F-filled-r03-c03.png

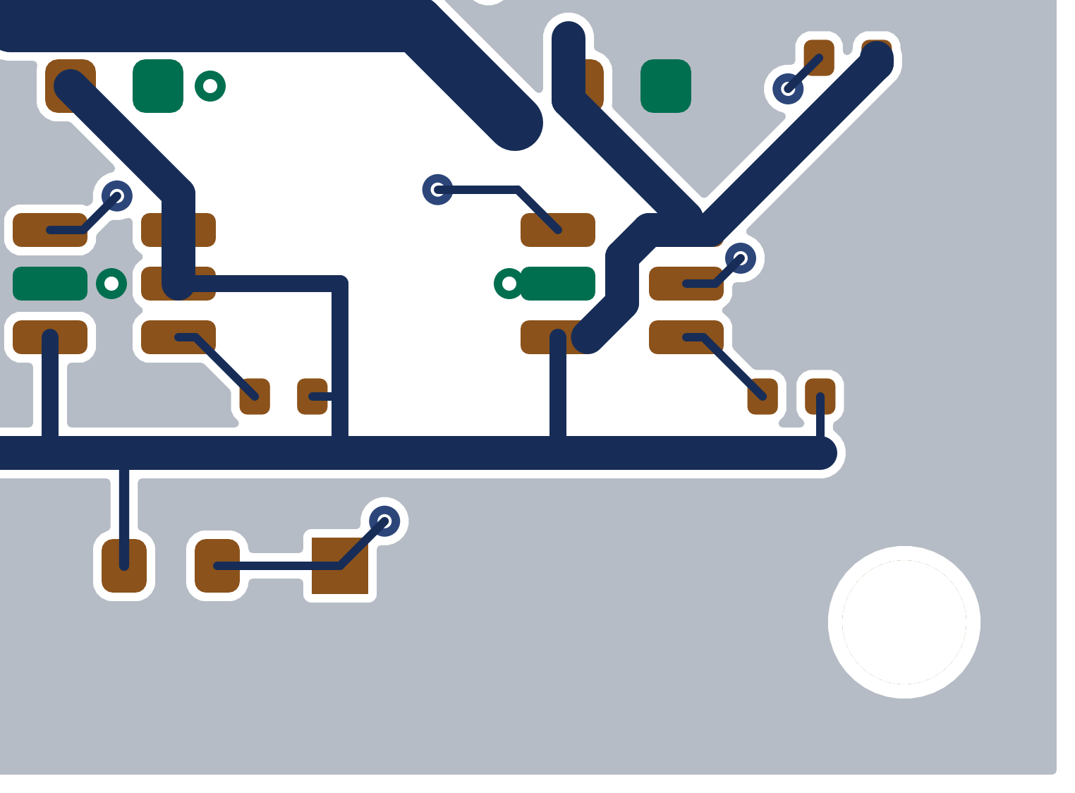
hardware/display/manufacturing/verification/display-adapter-visual/F-filled-r03-c03.png
