daleondev/ProtoMate_Control/hardware/display/manufacturing/verification/giga-adapter-visual/B-filled-r01-c06.png

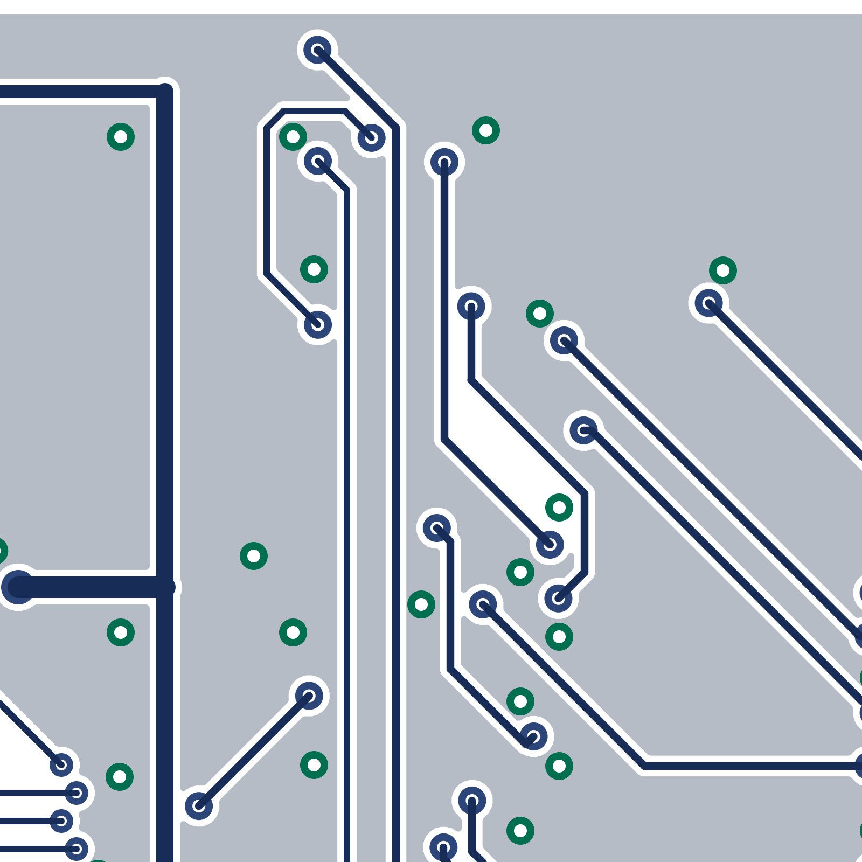
hardware/display/manufacturing/verification/giga-adapter-visual/B-filled-r01-c06.png
