daleondev/ProtoMate_Control/hardware/display/manufacturing/verification/giga-adapter-visual/B-filled-r01-c07.png

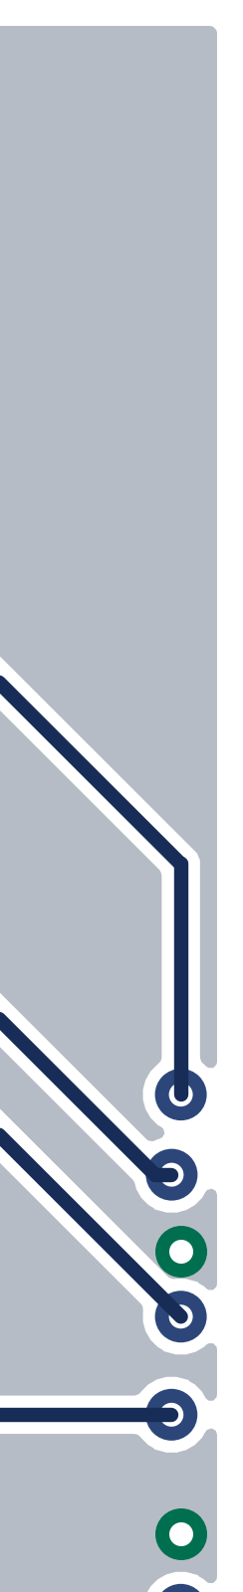
hardware/display/manufacturing/verification/giga-adapter-visual/B-filled-r01-c07.png
