daleondev/ProtoMate_Control/hardware/display/manufacturing/verification/giga-adapter-visual/B-filled-r02-c04.png

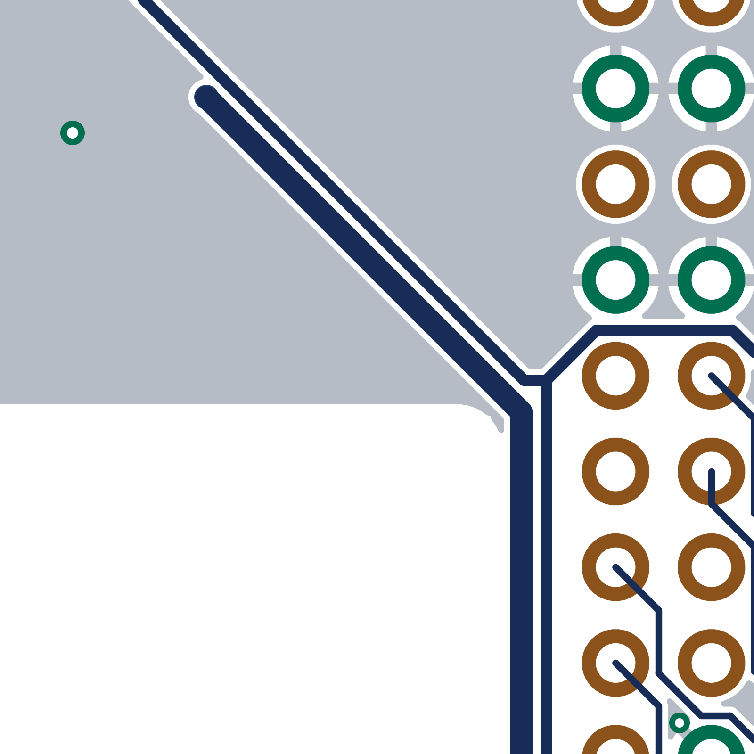
hardware/display/manufacturing/verification/giga-adapter-visual/B-filled-r02-c04.png
