daleondev/ProtoMate_Control/hardware/display/manufacturing/verification/giga-adapter-visual/B-filled-r03-c01.png

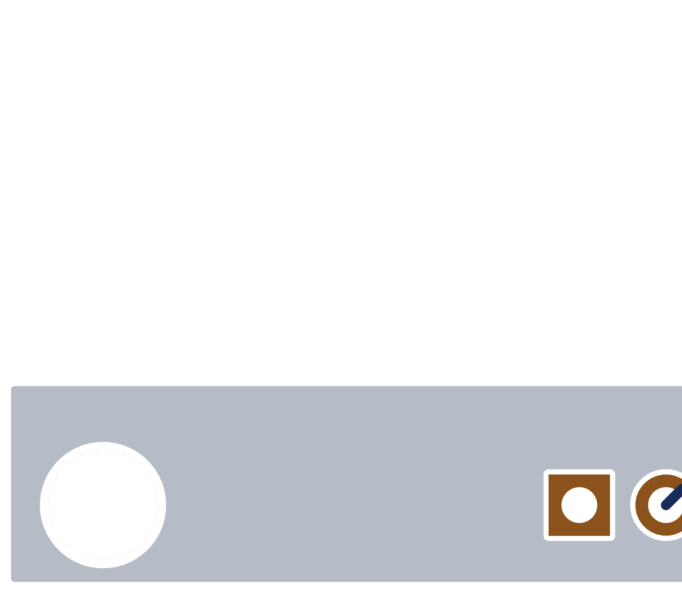
hardware/display/manufacturing/verification/giga-adapter-visual/B-filled-r03-c01.png
