daleondev/ProtoMate_Control/hardware/display/manufacturing/verification/giga-adapter-visual/B-routes-r02-c06.png

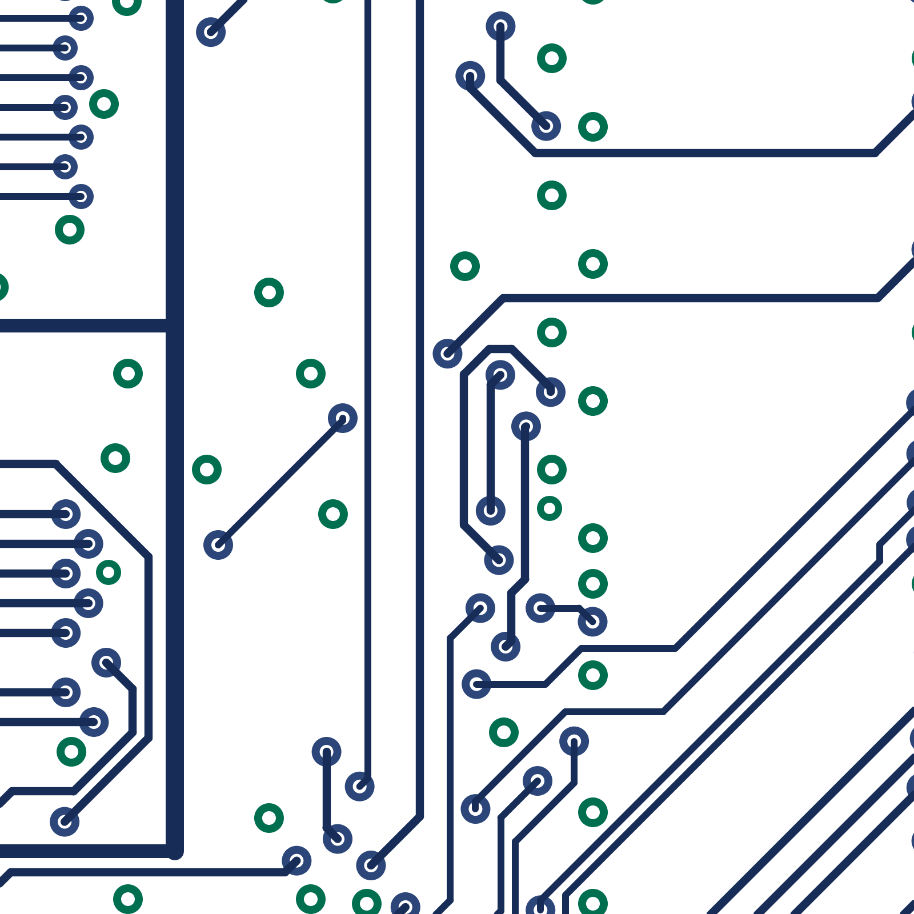
hardware/display/manufacturing/verification/giga-adapter-visual/B-routes-r02-c06.png
