daleondev/ProtoMate_Control/hardware/display/manufacturing/verification/giga-adapter-visual/B-routes-r02-c07.png

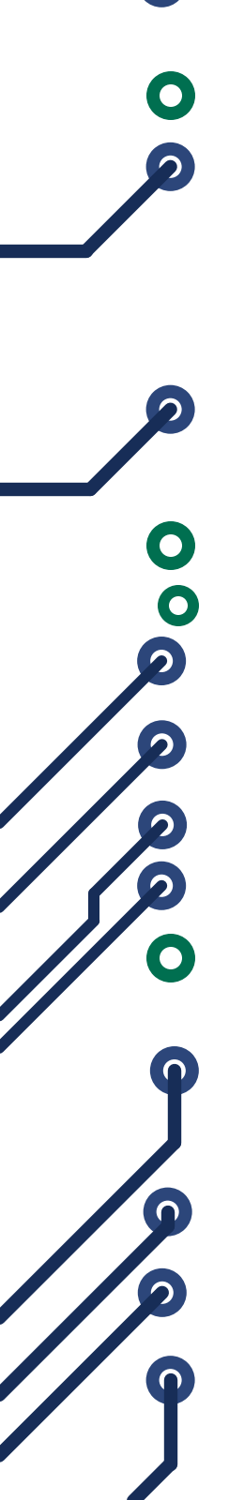
hardware/display/manufacturing/verification/giga-adapter-visual/B-routes-r02-c07.png
