daleondev/ProtoMate_Control/hardware/display/manufacturing/verification/giga-adapter-visual/B-routes-r03-c07.png

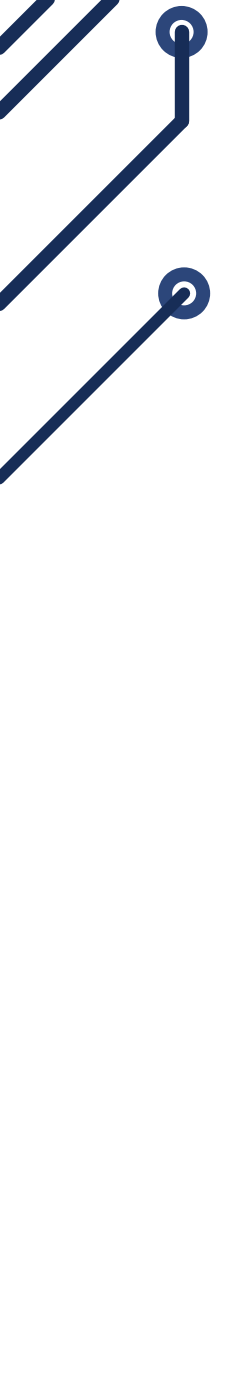
hardware/display/manufacturing/verification/giga-adapter-visual/B-routes-r03-c07.png
