daleondev/ProtoMate_Control/hardware/display/manufacturing/verification/giga-adapter-visual/export-gerber-B-r01-c02.png

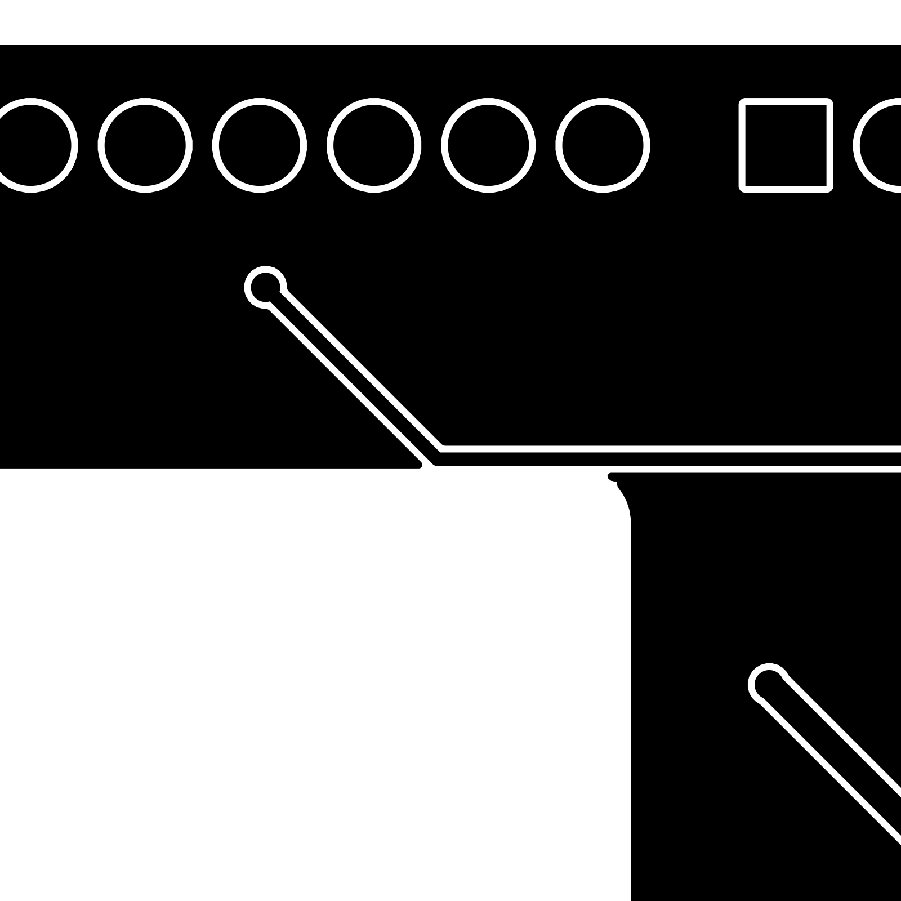
hardware/display/manufacturing/verification/giga-adapter-visual/export-gerber-B-r01-c02.png
