daleondev/ProtoMate_Control/hardware/display/manufacturing/verification/giga-adapter-visual/export-gerber-B-r02-c05.png

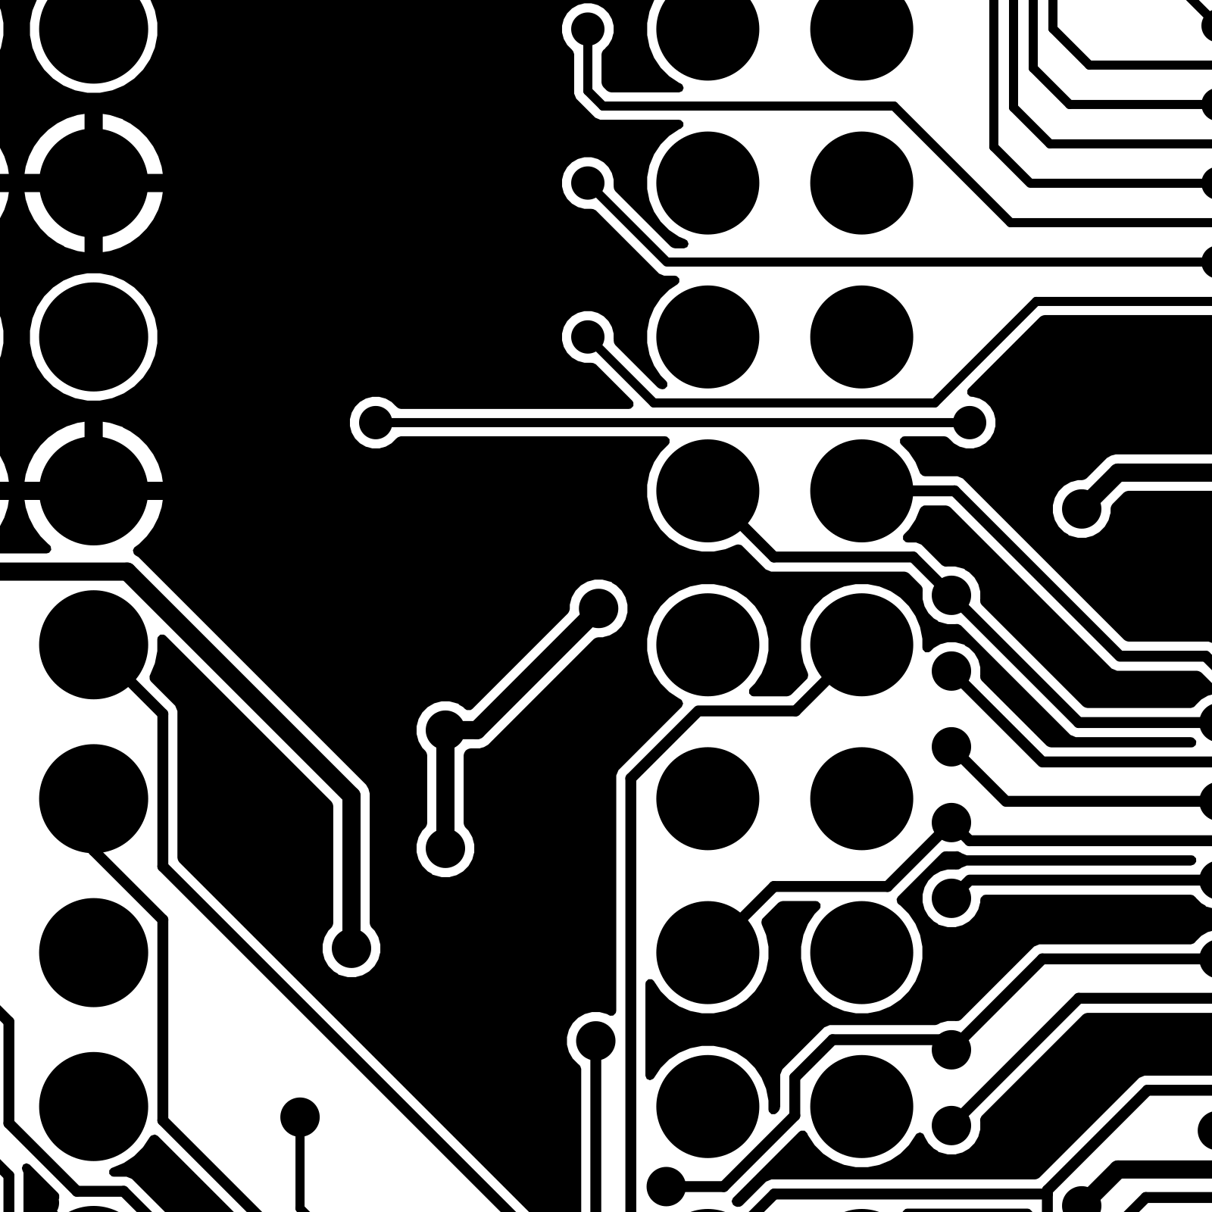
hardware/display/manufacturing/verification/giga-adapter-visual/export-gerber-B-r02-c05.png
