daleondev/ProtoMate_Control/hardware/display/manufacturing/verification/giga-adapter-visual/export-gerber-B-r03-c03.png

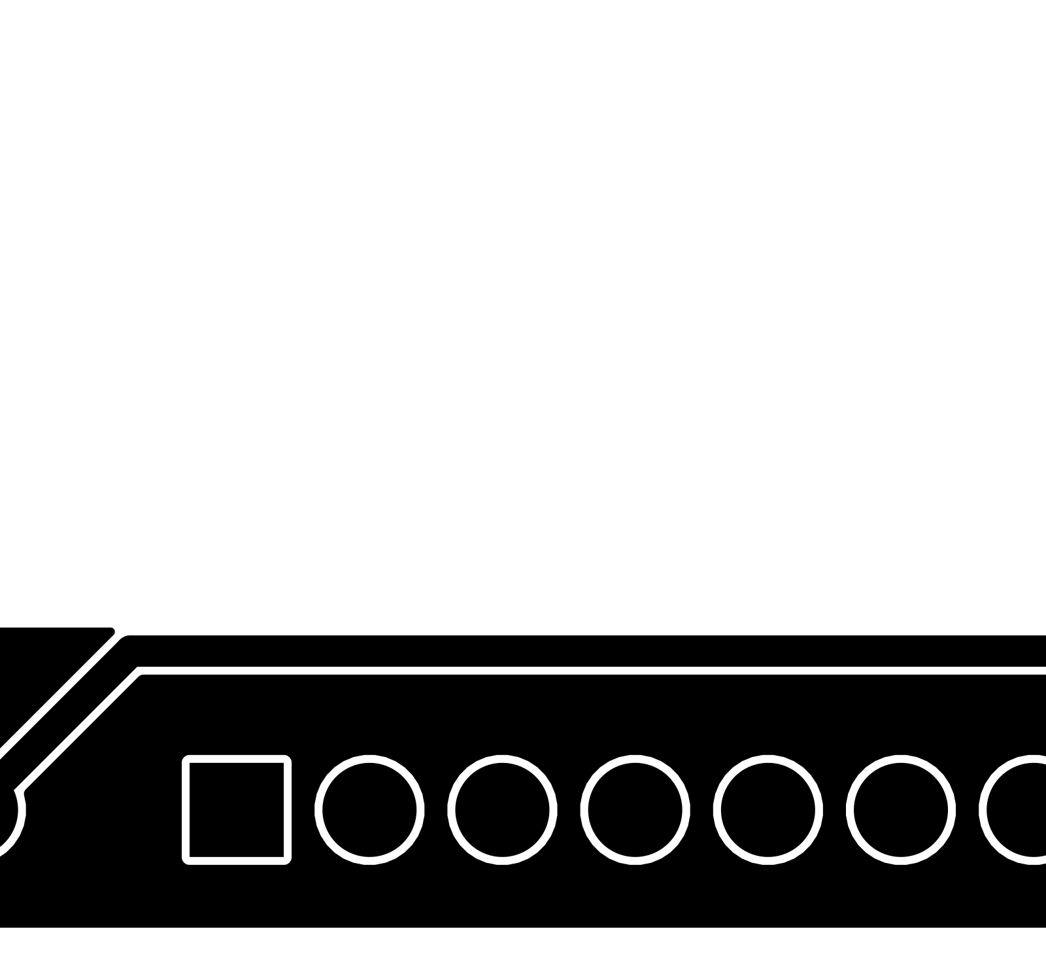
hardware/display/manufacturing/verification/giga-adapter-visual/export-gerber-B-r03-c03.png
