daleondev/ProtoMate_Control/hardware/display/manufacturing/verification/giga-adapter-visual/export-gerber-bottom-mask-silk-r01-c07.png

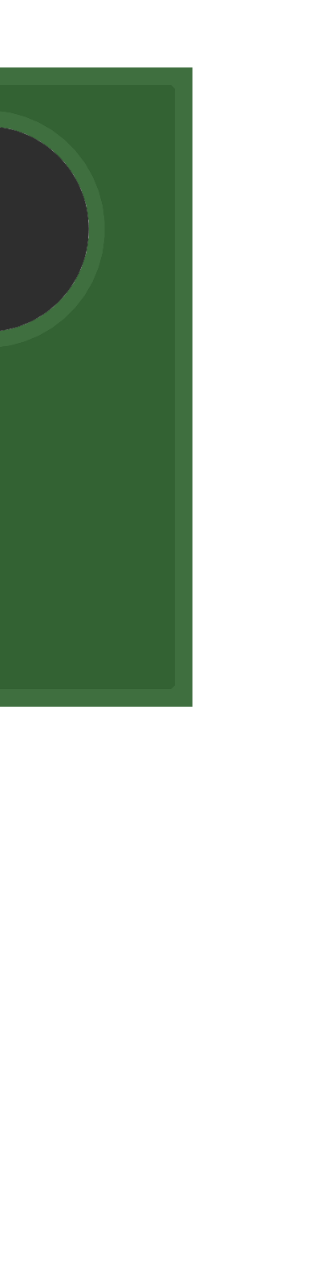
hardware/display/manufacturing/verification/giga-adapter-visual/export-gerber-bottom-mask-silk-r01-c07.png
