daleondev/ProtoMate_Control/hardware/display/manufacturing/verification/giga-adapter-visual/export-gerber-bottom-mask-silk-r02-c01.png

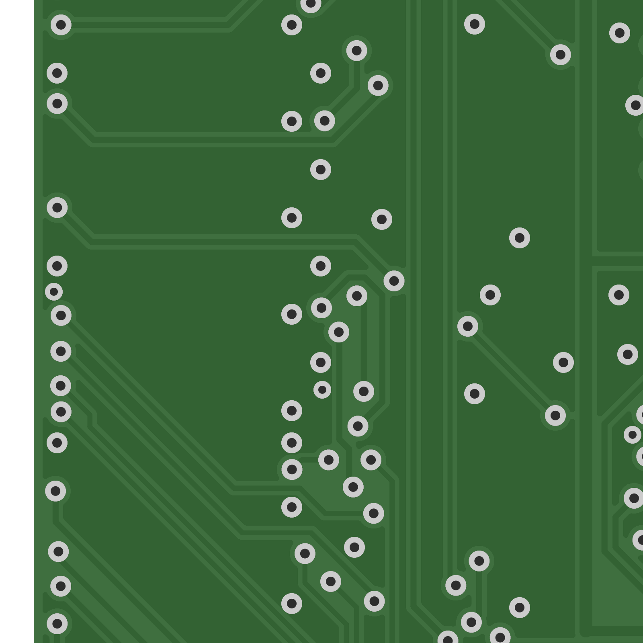
hardware/display/manufacturing/verification/giga-adapter-visual/export-gerber-bottom-mask-silk-r02-c01.png
