daleondev/ProtoMate_Control/hardware/display/manufacturing/verification/giga-adapter-visual/export-gerber-F-r01-c04.png

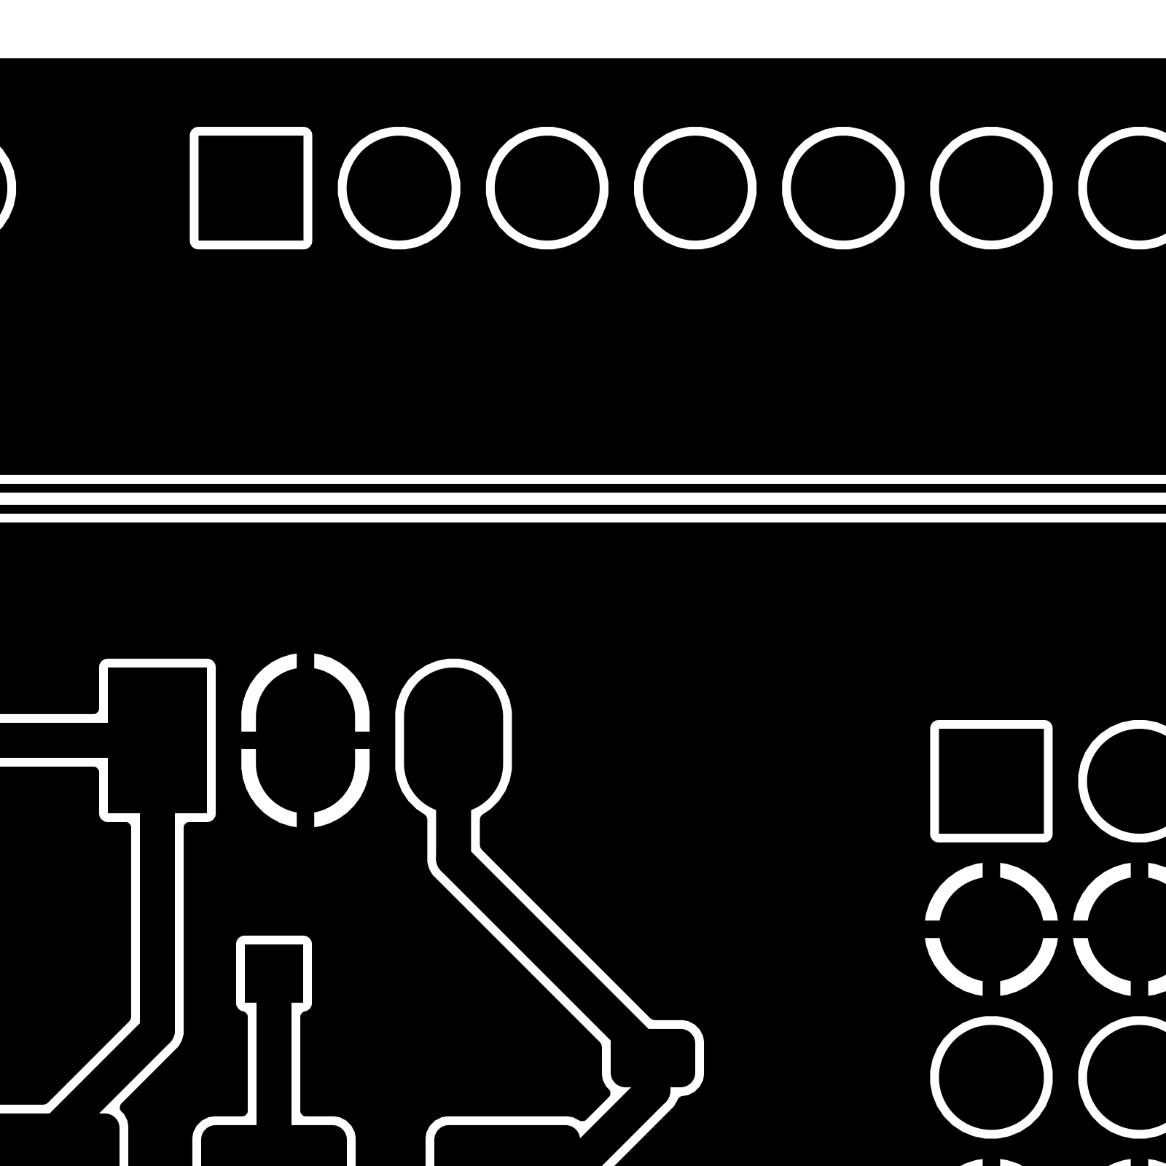
hardware/display/manufacturing/verification/giga-adapter-visual/export-gerber-F-r01-c04.png
