daleondev/ProtoMate_Control/hardware/display/manufacturing/verification/giga-adapter-visual/export-gerber-F-r02-c06.png

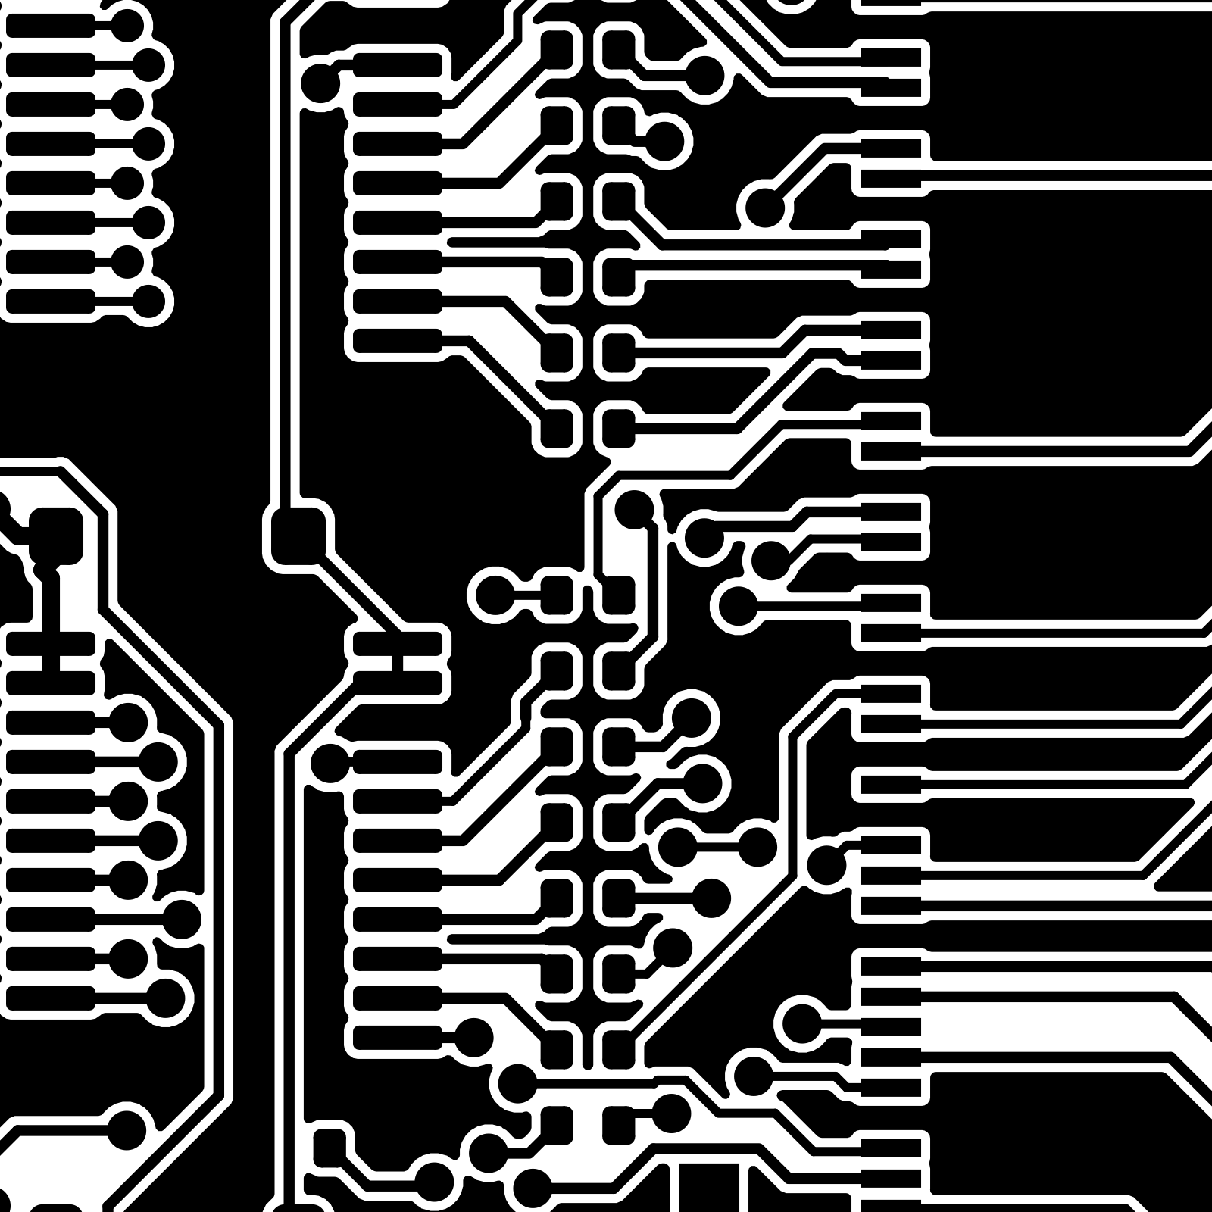
hardware/display/manufacturing/verification/giga-adapter-visual/export-gerber-F-r02-c06.png
