daleondev/ProtoMate_Control/hardware/display/manufacturing/verification/giga-adapter-visual/export-gerber-In1-r02-c04.png

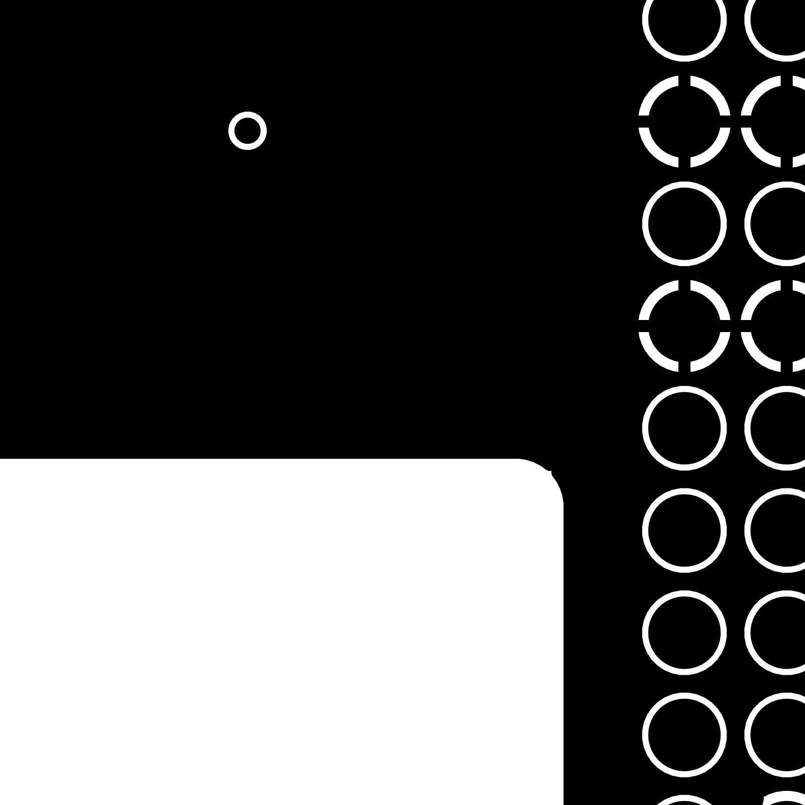
hardware/display/manufacturing/verification/giga-adapter-visual/export-gerber-In1-r02-c04.png
