daleondev/ProtoMate_Control/hardware/display/manufacturing/verification/giga-adapter-visual/export-gerber-In1.png

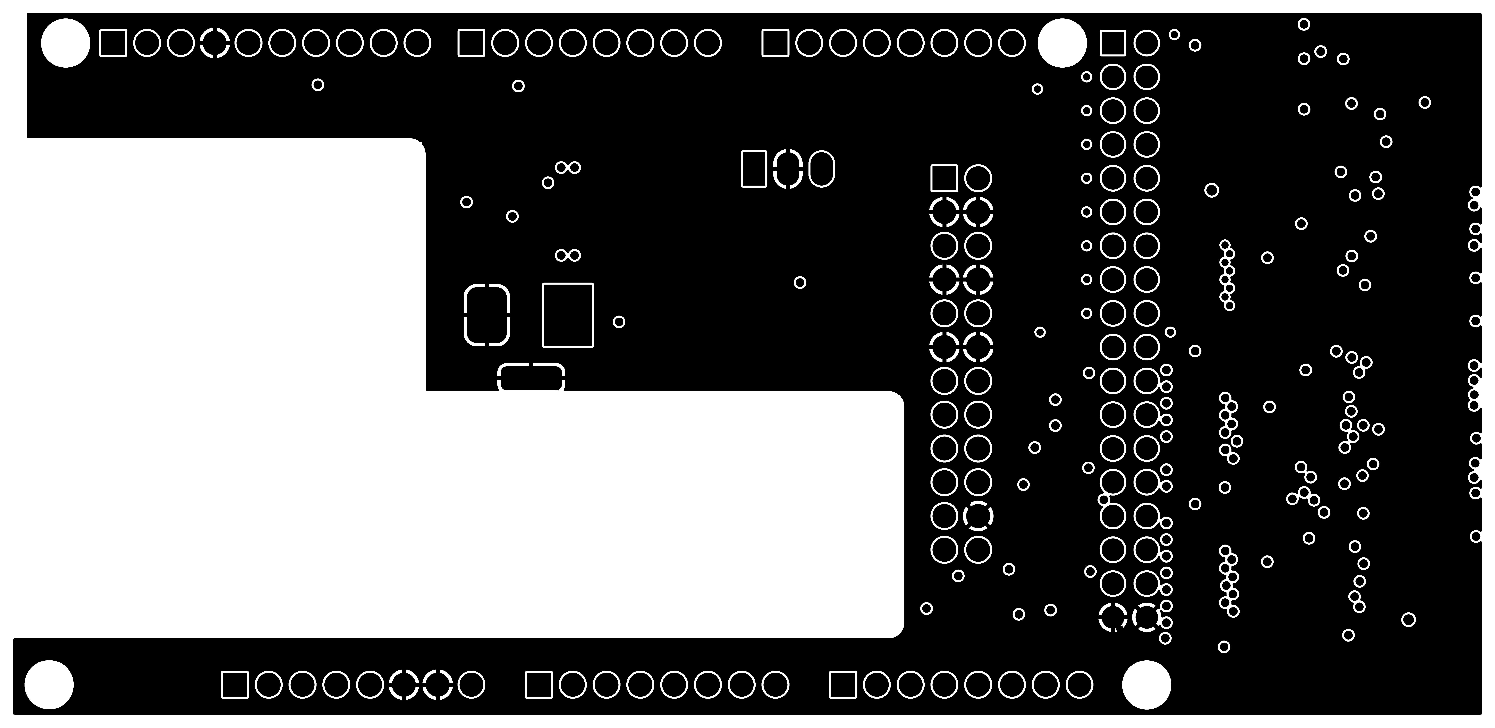
hardware/display/manufacturing/verification/giga-adapter-visual/export-gerber-In1.png
