daleondev/ProtoMate_Control/hardware/display/manufacturing/verification/giga-adapter-visual/export-gerber-In2-r01-c06.png

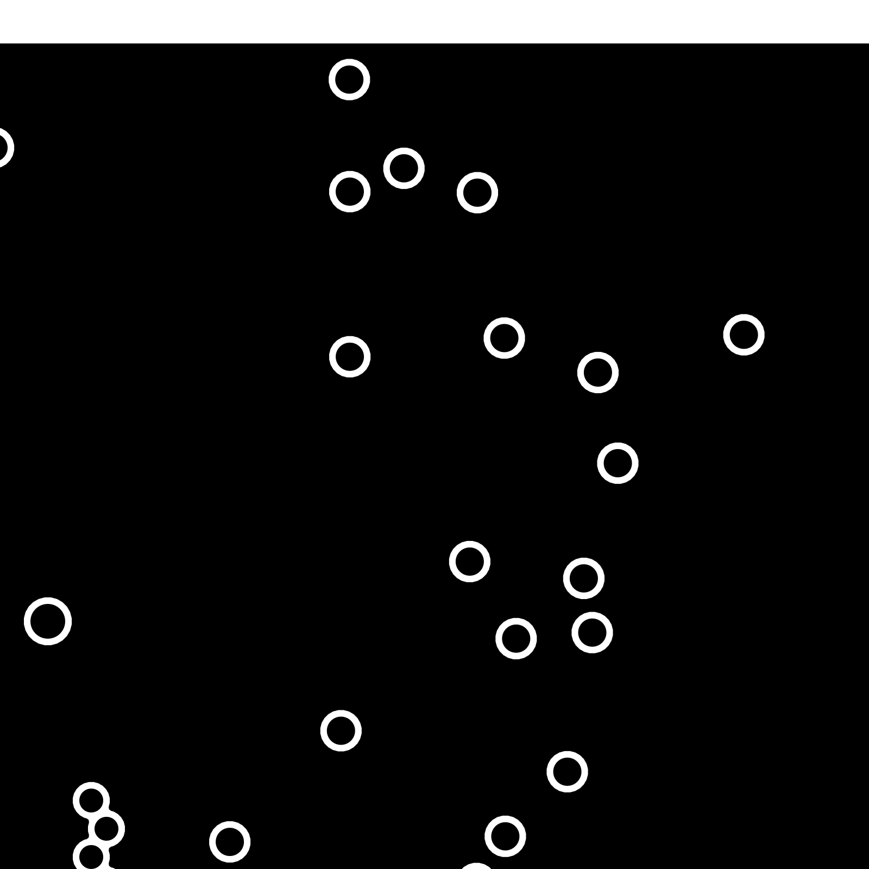
hardware/display/manufacturing/verification/giga-adapter-visual/export-gerber-In2-r01-c06.png
