daleondev/ProtoMate_Control/hardware/display/manufacturing/verification/giga-adapter-visual/export-gerber-top-mask-silk-r01-c01.png

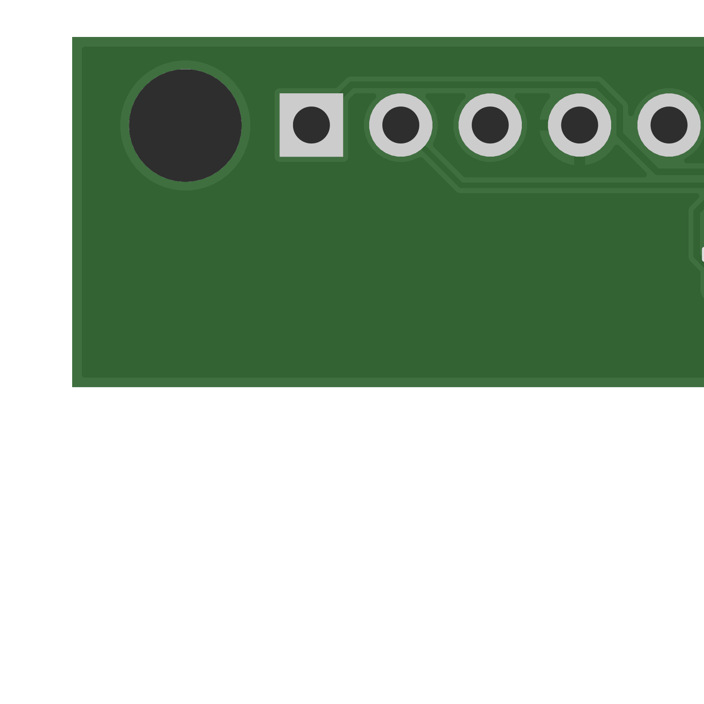
hardware/display/manufacturing/verification/giga-adapter-visual/export-gerber-top-mask-silk-r01-c01.png
