daleondev/ProtoMate_Control/hardware/display/manufacturing/verification/giga-adapter-visual/F-filled-r02-c03.png

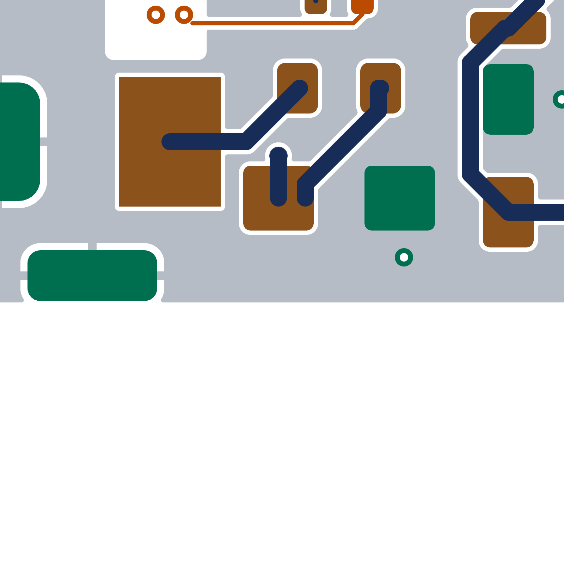
hardware/display/manufacturing/verification/giga-adapter-visual/F-filled-r02-c03.png
