daleondev/ProtoMate_Control/hardware/display/manufacturing/verification/giga-adapter-visual/F-filled-r03-c05.png

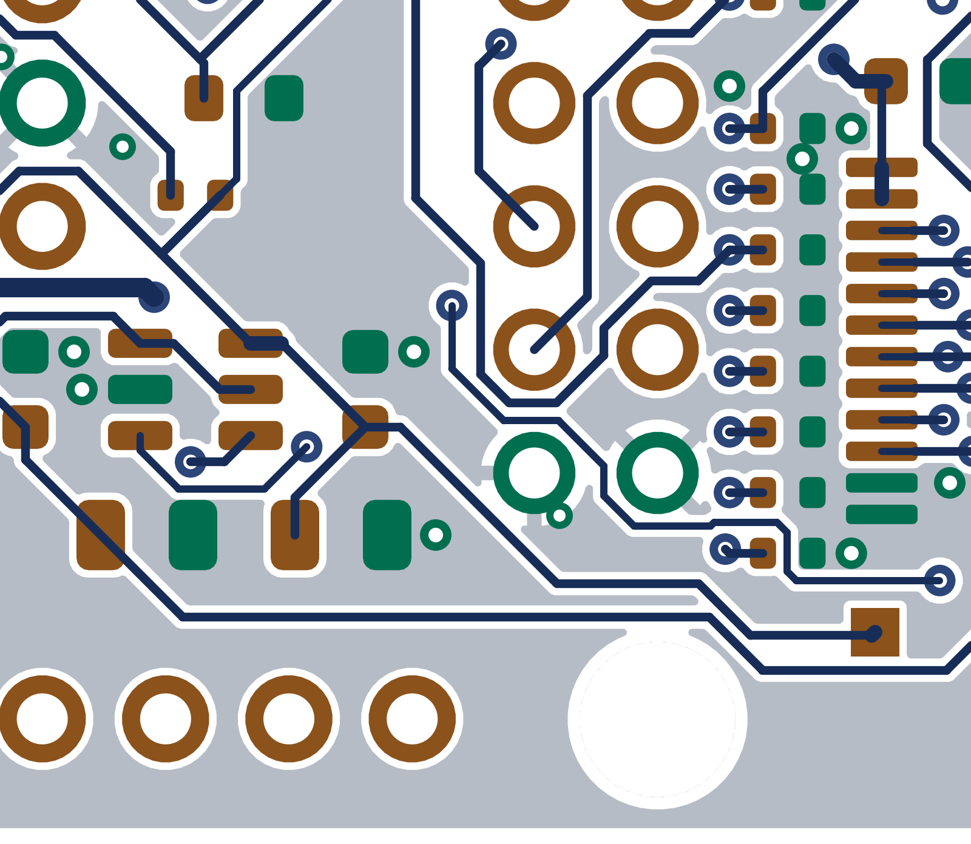
hardware/display/manufacturing/verification/giga-adapter-visual/F-filled-r03-c05.png
