daleondev/ProtoMate_Control/hardware/display/manufacturing/verification/giga-adapter-visual/F-routes-r01-c07.png

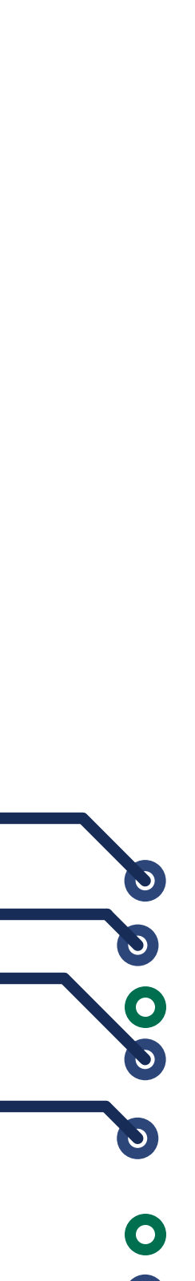
hardware/display/manufacturing/verification/giga-adapter-visual/F-routes-r01-c07.png
