daleondev/ProtoMate_Control/hardware/display/manufacturing/verification/giga-adapter-visual/In1-filled-r01-c03.png

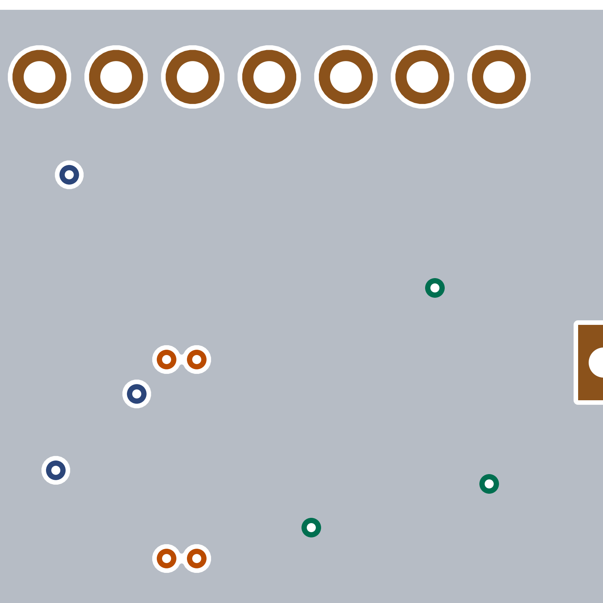
hardware/display/manufacturing/verification/giga-adapter-visual/In1-filled-r01-c03.png
