daleondev/ProtoMate_Control/hardware/display/manufacturing/verification/giga-adapter-visual/In1-filled-r01-c06.png

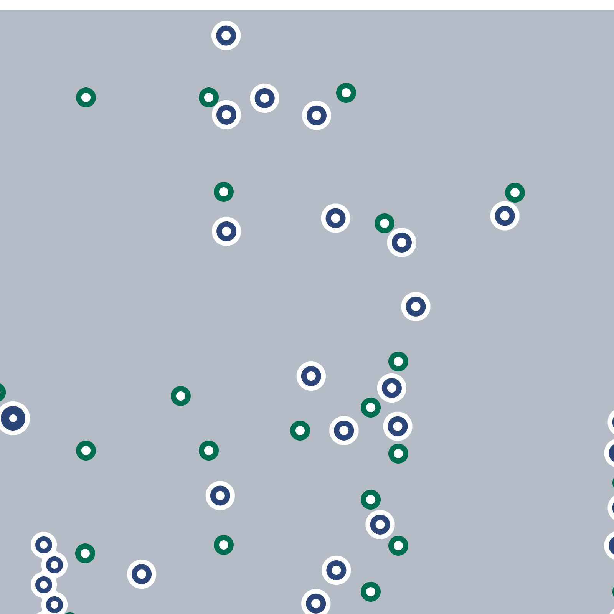
hardware/display/manufacturing/verification/giga-adapter-visual/In1-filled-r01-c06.png
