daleondev/ProtoMate_Control/hardware/display/manufacturing/verification/giga-adapter-visual/In2-filled-r01-c02.png

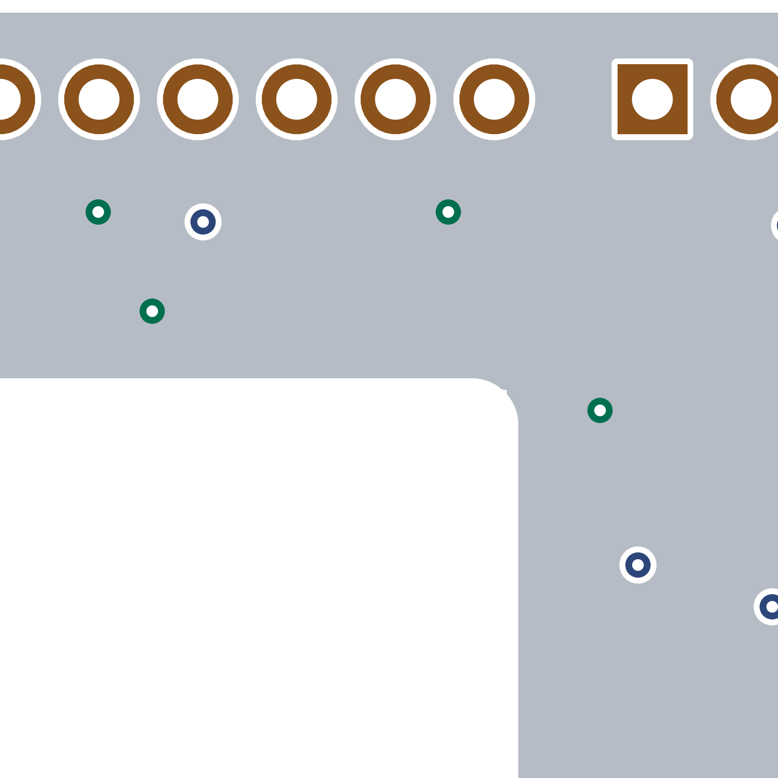
hardware/display/manufacturing/verification/giga-adapter-visual/In2-filled-r01-c02.png
