daleondev/ProtoMate_Control/hardware/display/manufacturing/verification/giga-adapter-visual/In2-filled-r03-c07.png

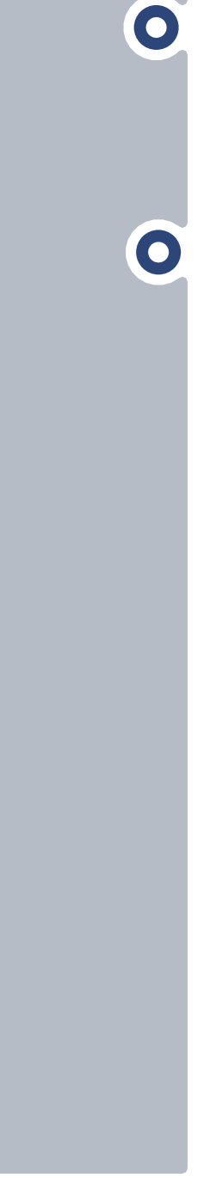
hardware/display/manufacturing/verification/giga-adapter-visual/In2-filled-r03-c07.png
