daleondev/ProtoMate_Control/hardware/display/manufacturing/verification/giga-adapter-visual/index.png

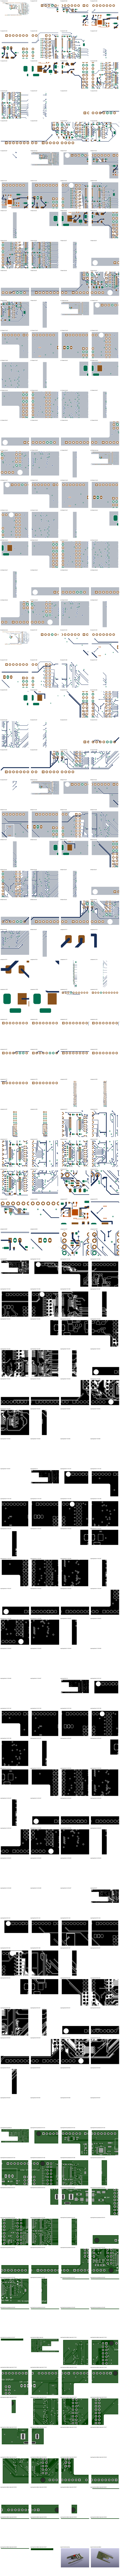
hardware/display/manufacturing/verification/giga-adapter-visual/index.png
