daleondev/ProtoMate_Control/docs/motion-current-state/04-current-problems.png

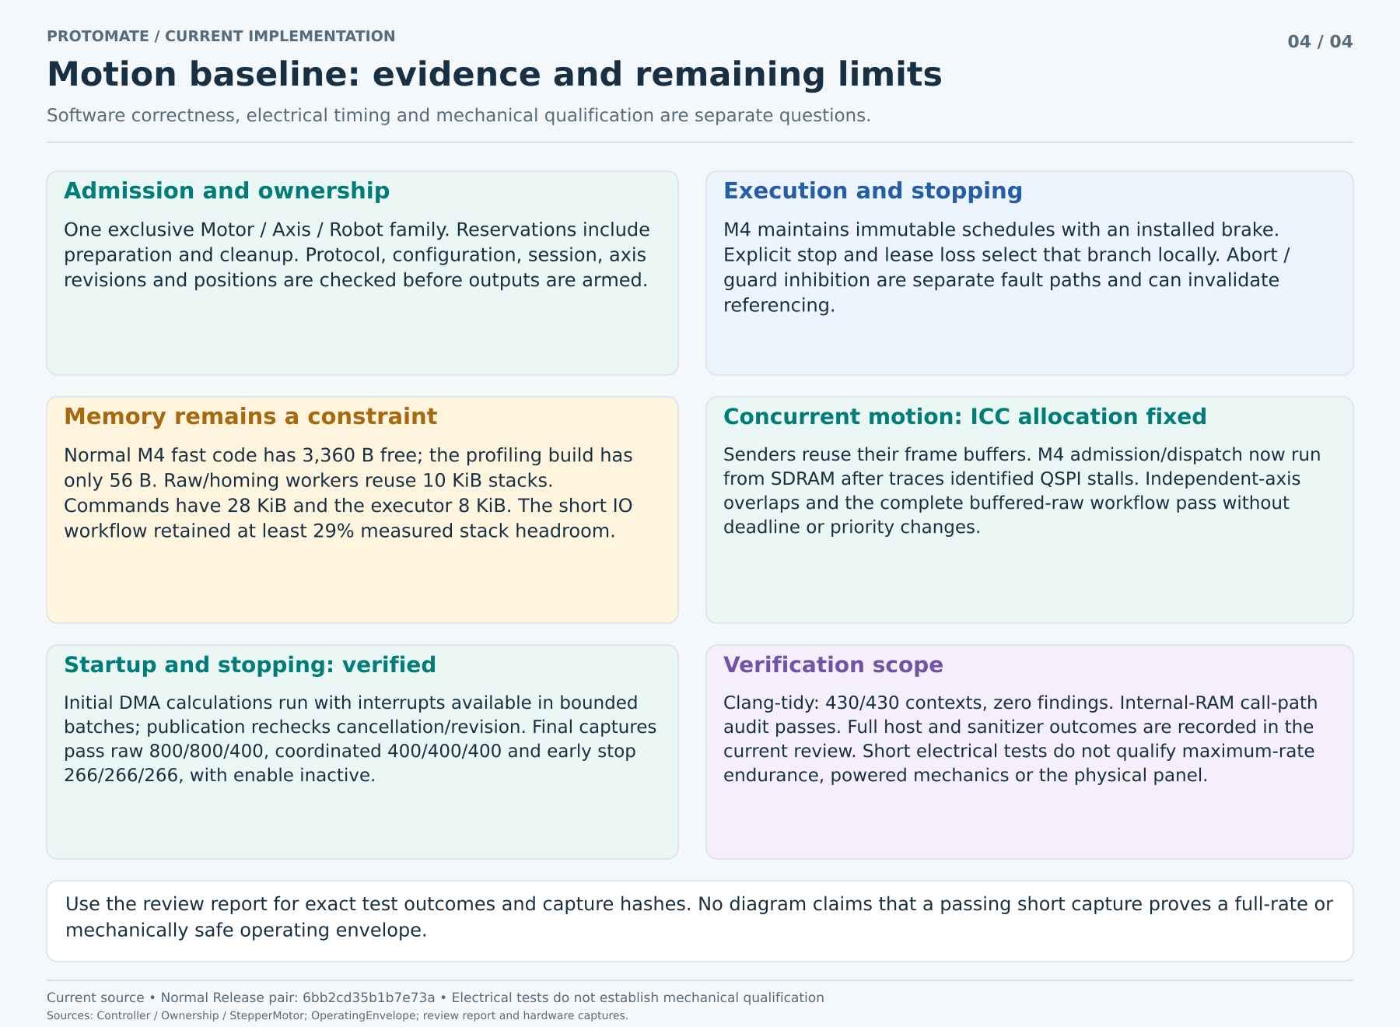
docs/motion-current-state/04-current-problems.png
