daleondev/ProtoMate_Control/docs/motion-current-state/uml/09-homing-current-failure.png

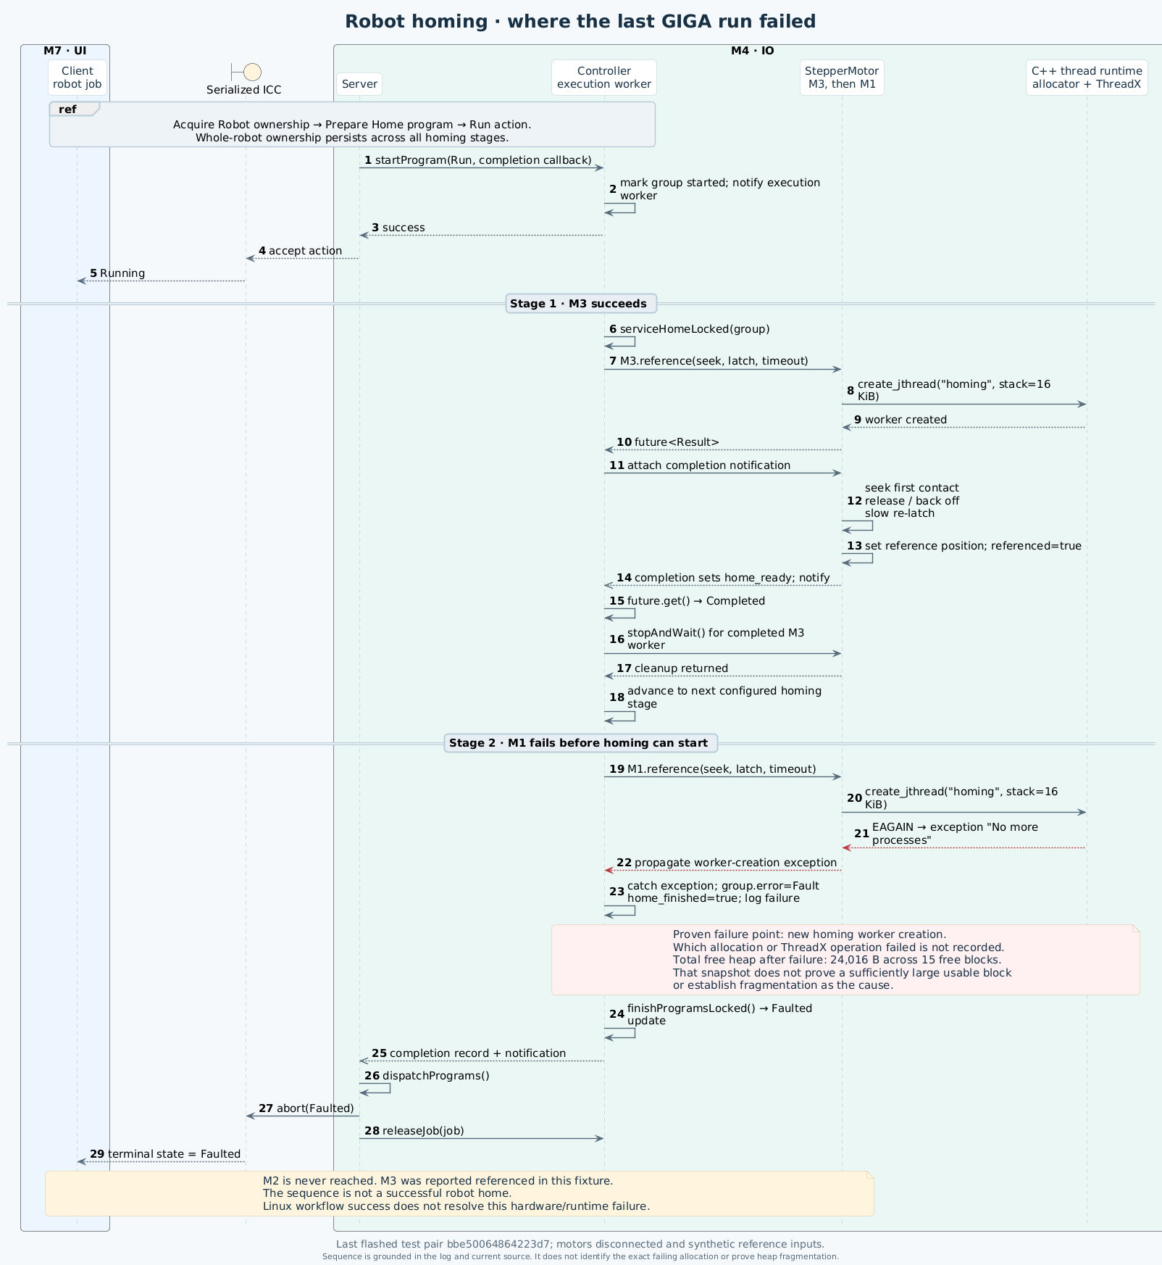
docs/motion-current-state/uml/09-homing-current-failure.png
