daleondev/ProtoMate_Control/docs/h755-step-report.pdf

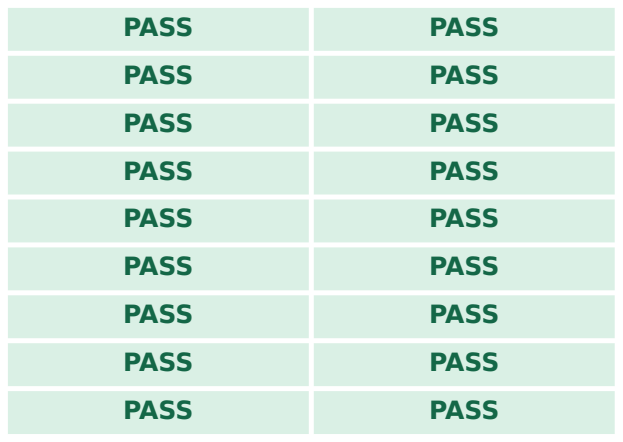
[picture p307: figure]
PASS

Debug | Release
1,290,235 captured pulses · counts match

1 · Exact 1 / 2 / 3 pulses

2 · Independent starts

3 · 3 × 100 kHz

4 · Rate update

5 · M2 stop / restart

6 · Timer rollover

7 · Underrun guard

8 · 3 × 100 kHz + ICC

9 · 1,000-pulse profile

### 18 / 18 checks passed

0 | 5 | 10 | 15 | 20 | 25 | 30 | 35 | 40
Time from rising edge (µs) · Release

EN_N

M3 STEP

M2 STEP

M1 STEP

10 µs period

EN_N high = disabled

### 100 kHz on all three axes · ICC active

100 kHz | 100 kHz + ICC

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
Frequency o

ffset (ppm)

≈ +0.0031% relative to the uncalibrated analyzer

### Measured frequency · M1–M3 equal

Debug | Release
31.21 | 31.29 31.33 | 31.42

9.9583
239 samples

10.0000
240 samples

10.0417
241 samples
Captured M1 period (µs)

0

20

40

60

80

100

Intervals (%)

Analyzer resolution: 41.67 ns per sample

### Period distribution · 99,999 intervals / run

Debug
Debug + ICC
Release
Release + ICC

# STEP generation · timing and counts

ST-Link crystal → 5 MHz HSE bypass | CPU 80 MHz | TIM2 10 MHz | Analyzer 24 MHz
2026-10-12 · NUCLEO-H755ZI-Q · M4 STEP / M7 console · Motor drivers disconnected | 1

# STEP generation · motion and reset

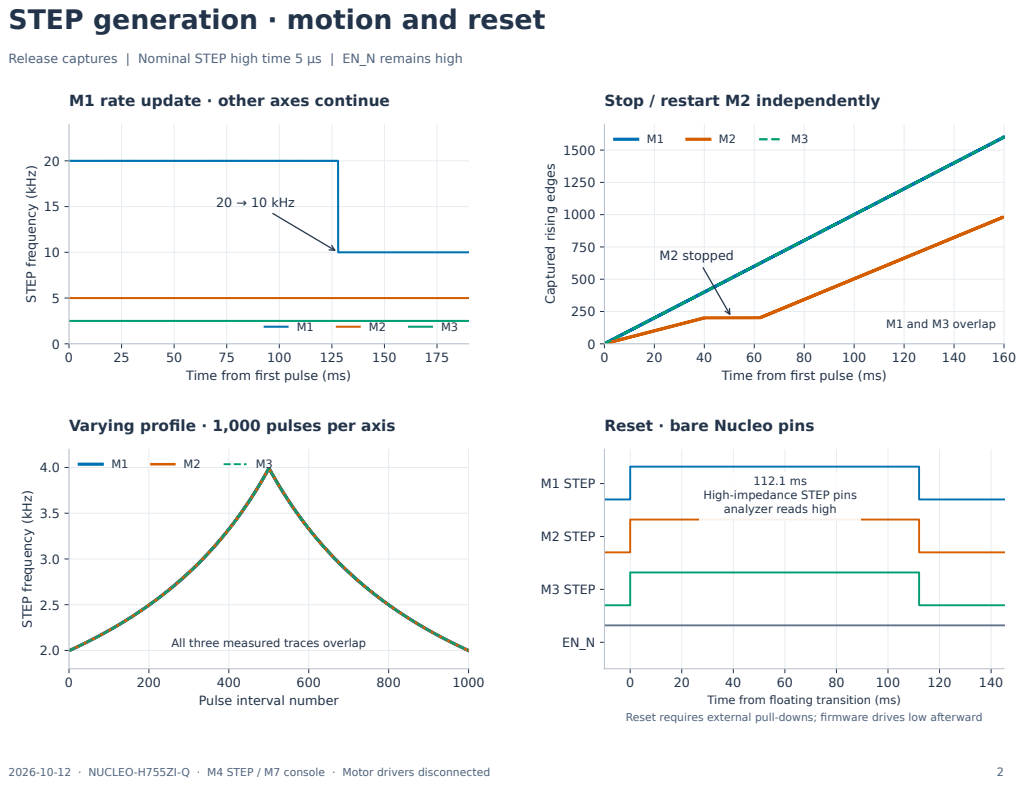
[picture p308: page 2]
20 → 10 kHz; M2 stopped; M3 STEP; M2 STEP; M1 STEP; 2026-10-12 · NUCLEO-H755ZI-Q · M4 STEP / M7 console · Motor drivers disconnected

Release captures | Nominal STEP high time 5 µs | EN_N remains high

M1 rate update · other axes continue

Stop / restart M2 independently

STEP frequency (kHz)

Captured rising edges

M1 and M3 overlap

Time from first pulse (ms)

Varying profile · 1,000 pulses per axis

Reset · bare Nucleo pins

High-impedance STEP pins
analyzer reads high

All three measured traces overlap

Pulse interval number

Time from floating transition (ms)

Reset requires external pull-downs; firmware drives low afterward
