daleondev/ProtoMate_Control/hardware/display/manufacturing/giga-adapter-rev-F/schematic.pdf

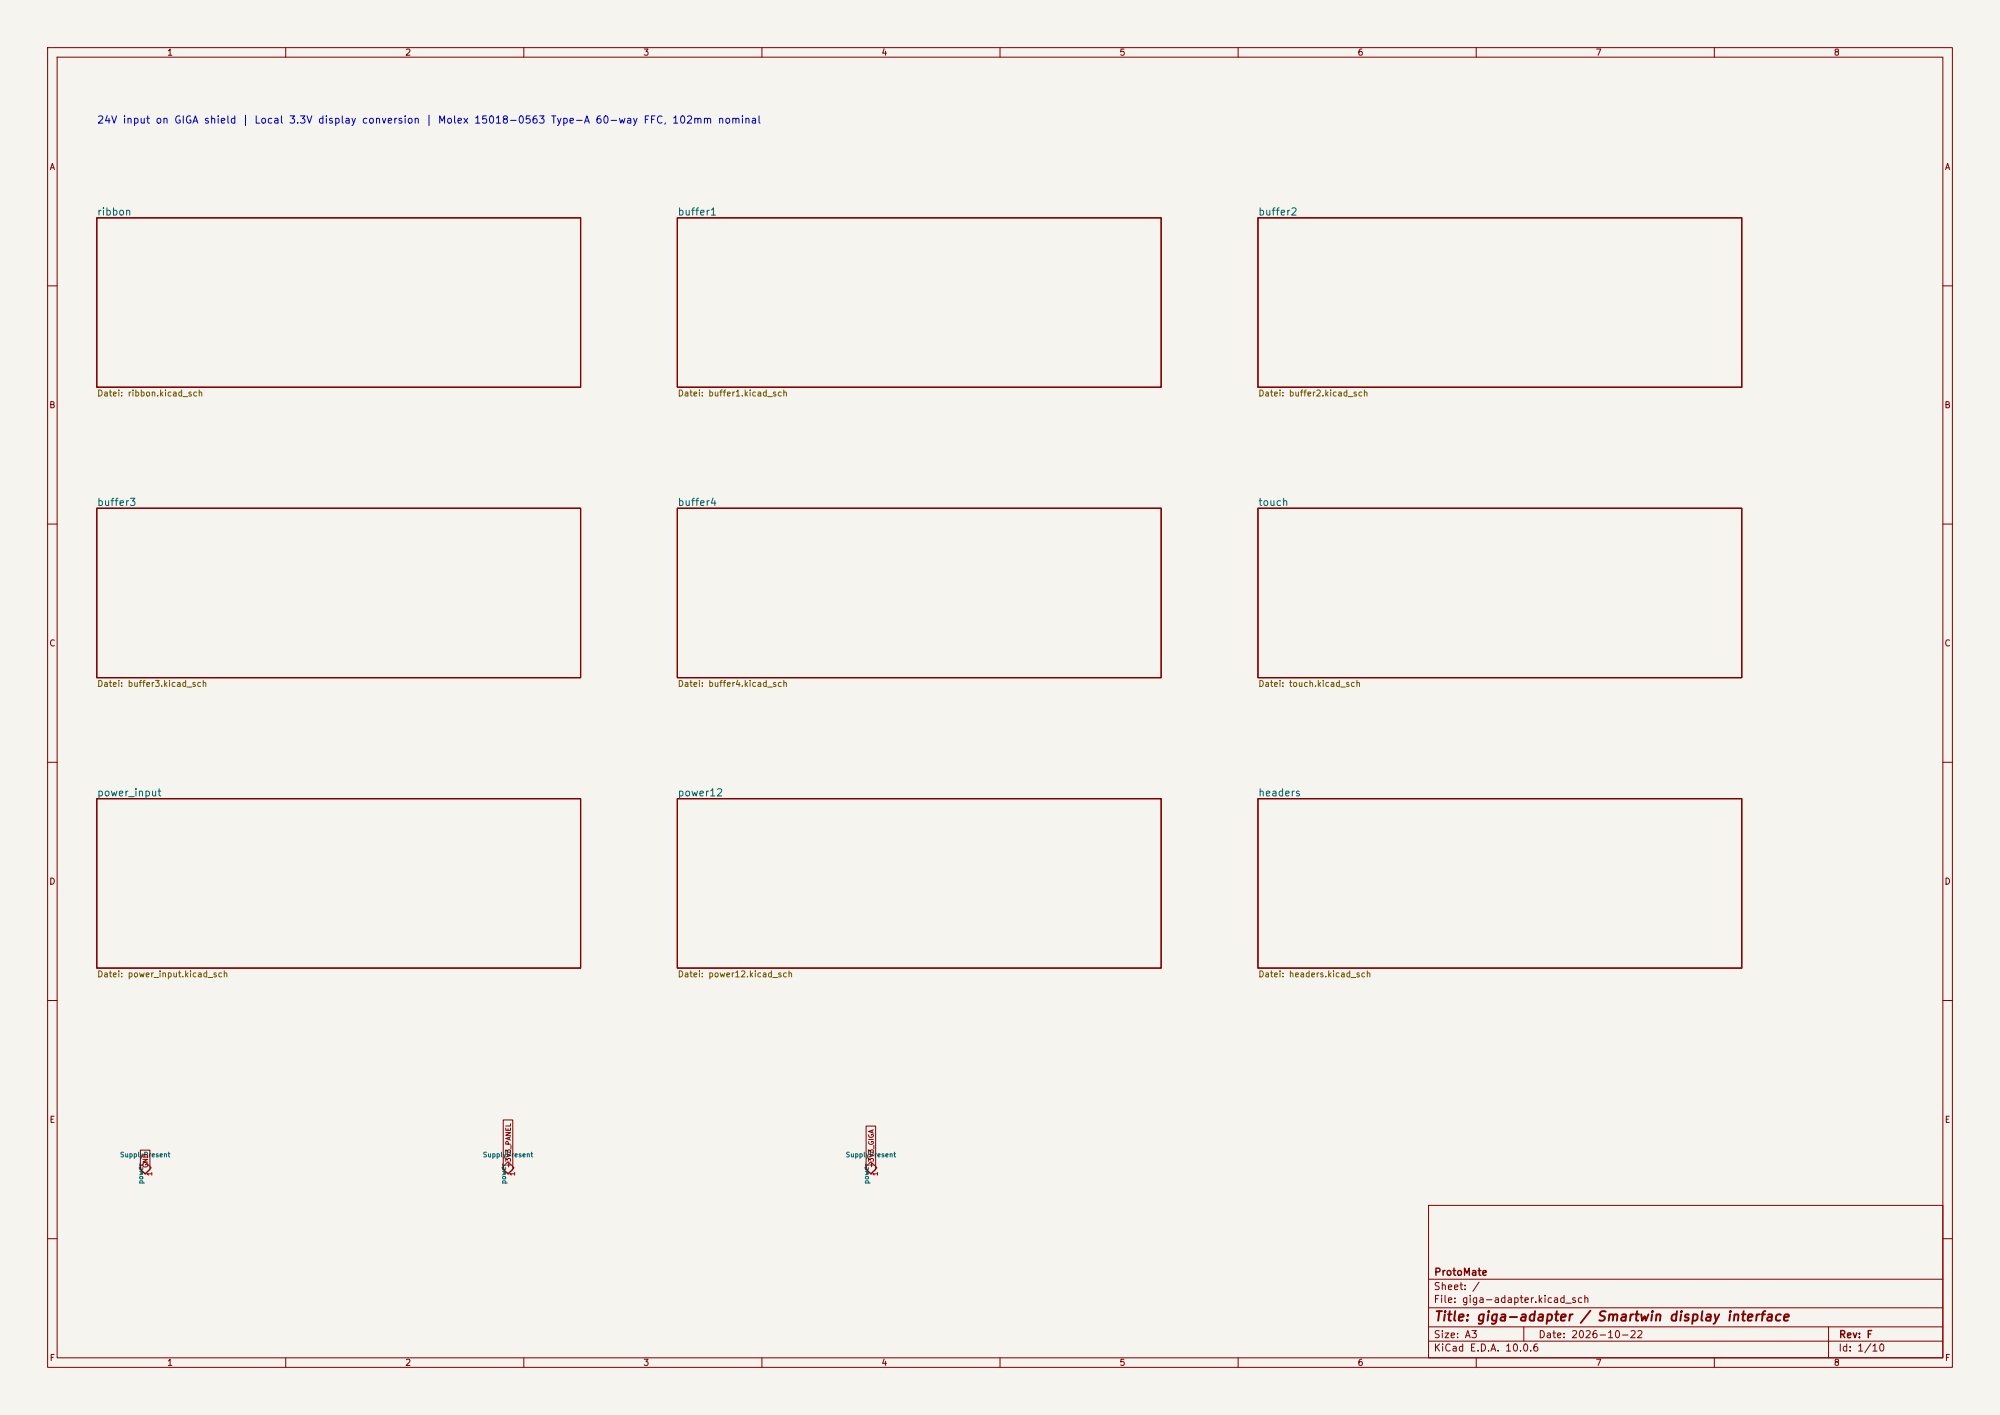
[picture p315: page 1]

24V input on GIGA shield | Local 3.3V display conversion | Molex 15018-0563 Type-A 60-way FFC, 102mm nominal

headers Datei: headers.kicad_sch power 1

ProtoMate
Sheet: /
File: giga-adapter.kicad_sch
Title: giga-adapter / Smartwin display interface

Size: A3 | Rev: F | F Date: 2026-10-22
KiCad E.D.A. 10.0.6 | Id: 1/10

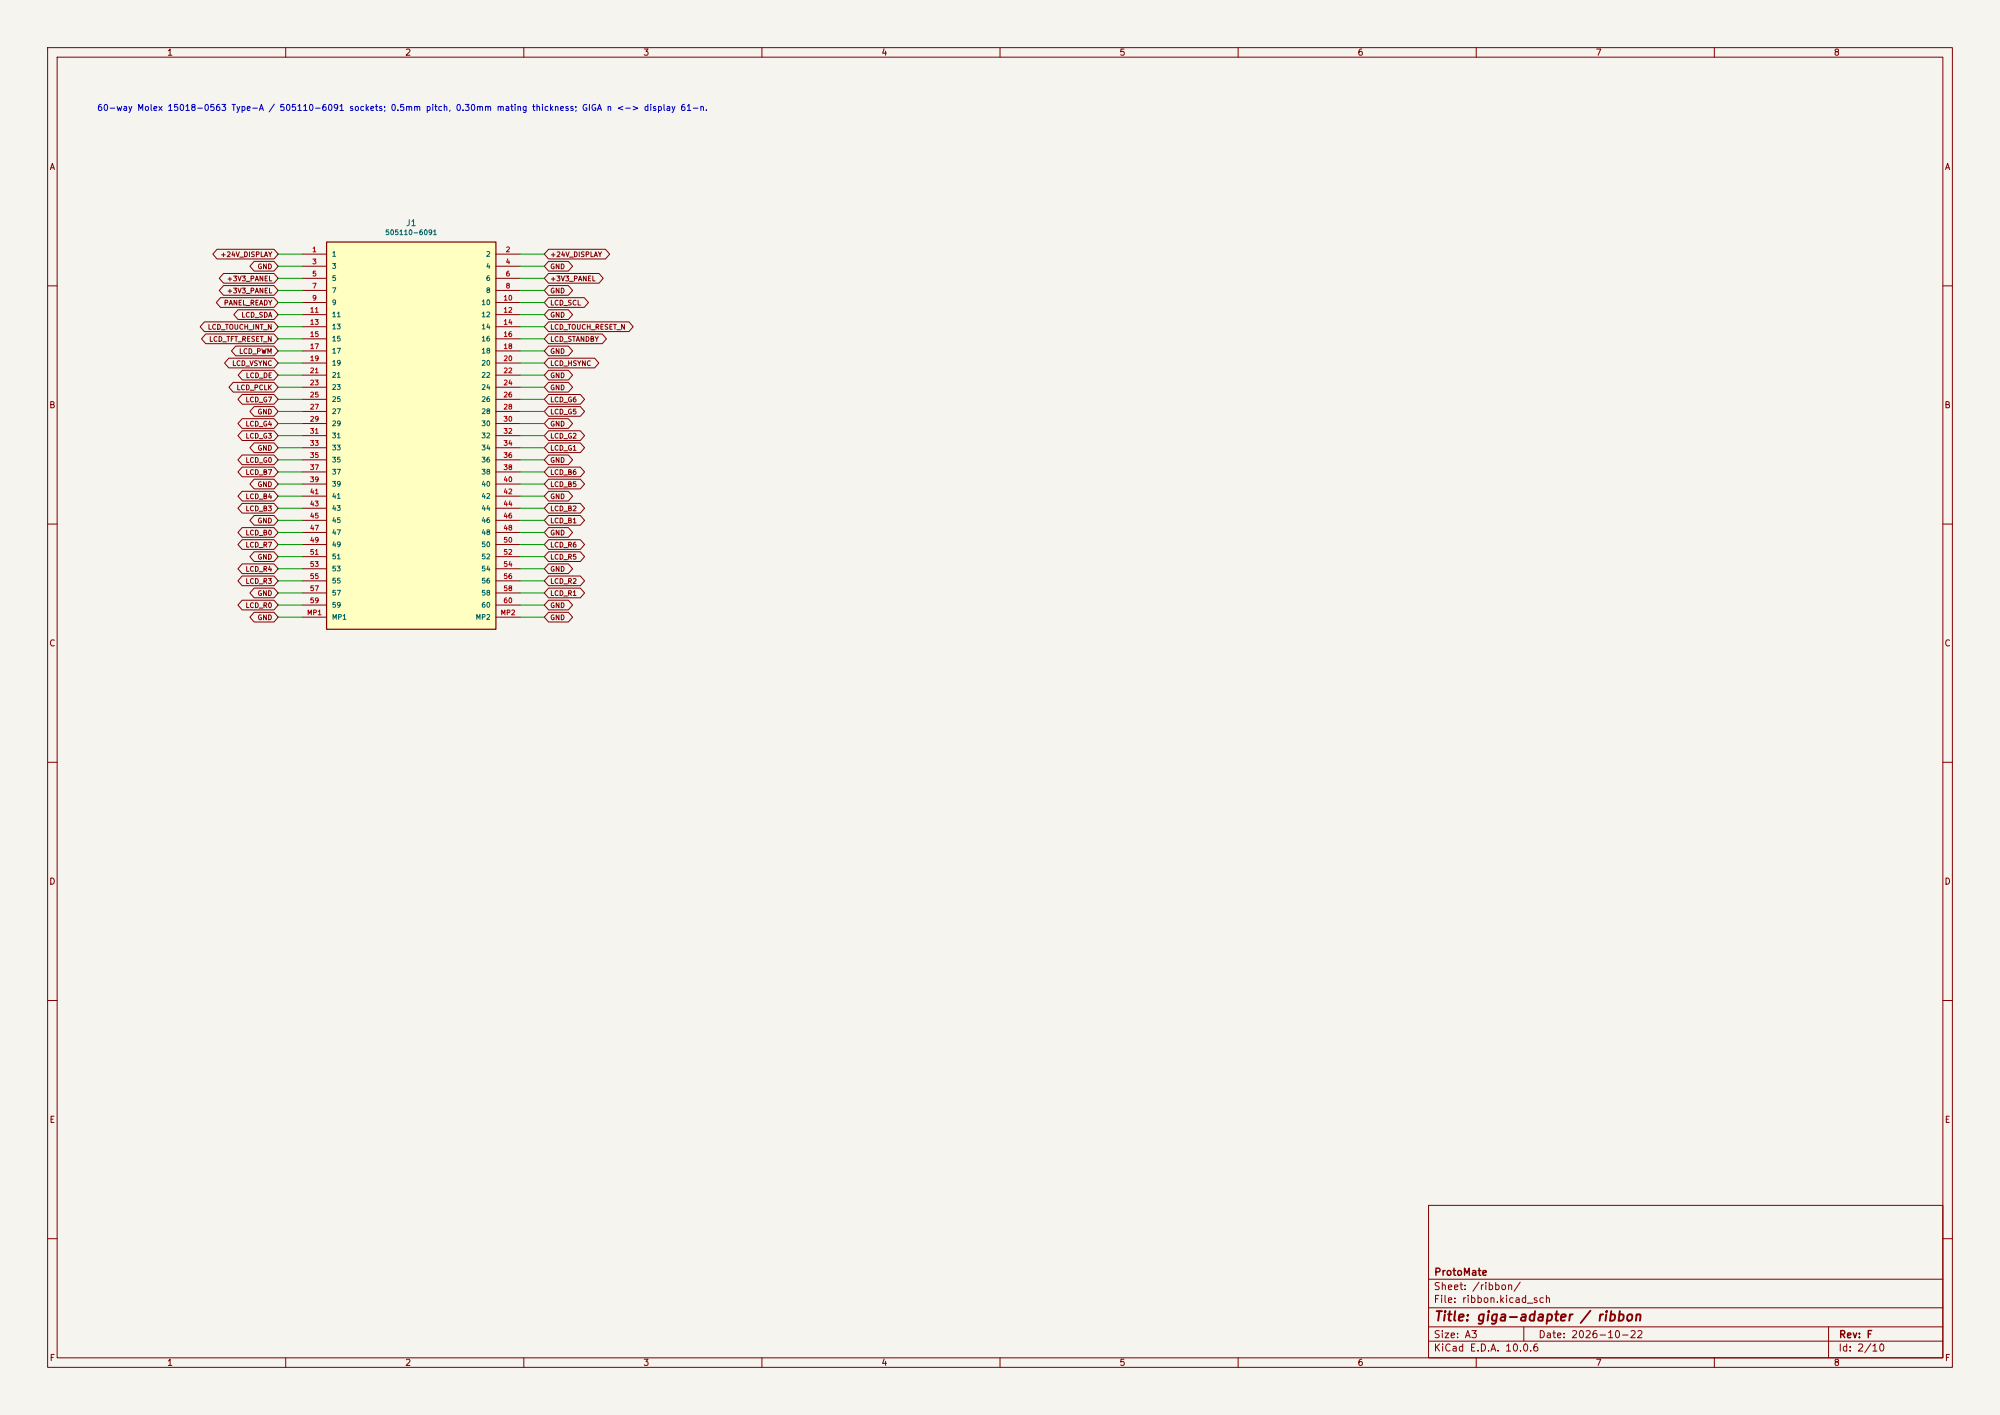
[picture p316: page 2]

60-way Molex 15018-0563 Type-A / 505110-6091 sockets; 0.5mm pitch, 0.30mm mating thickness; GIGA n <-> display 61-n.

ProtoMate
Sheet: /ribbon/
File: ribbon.kicad_sch
Title: giga-adapter / ribbon

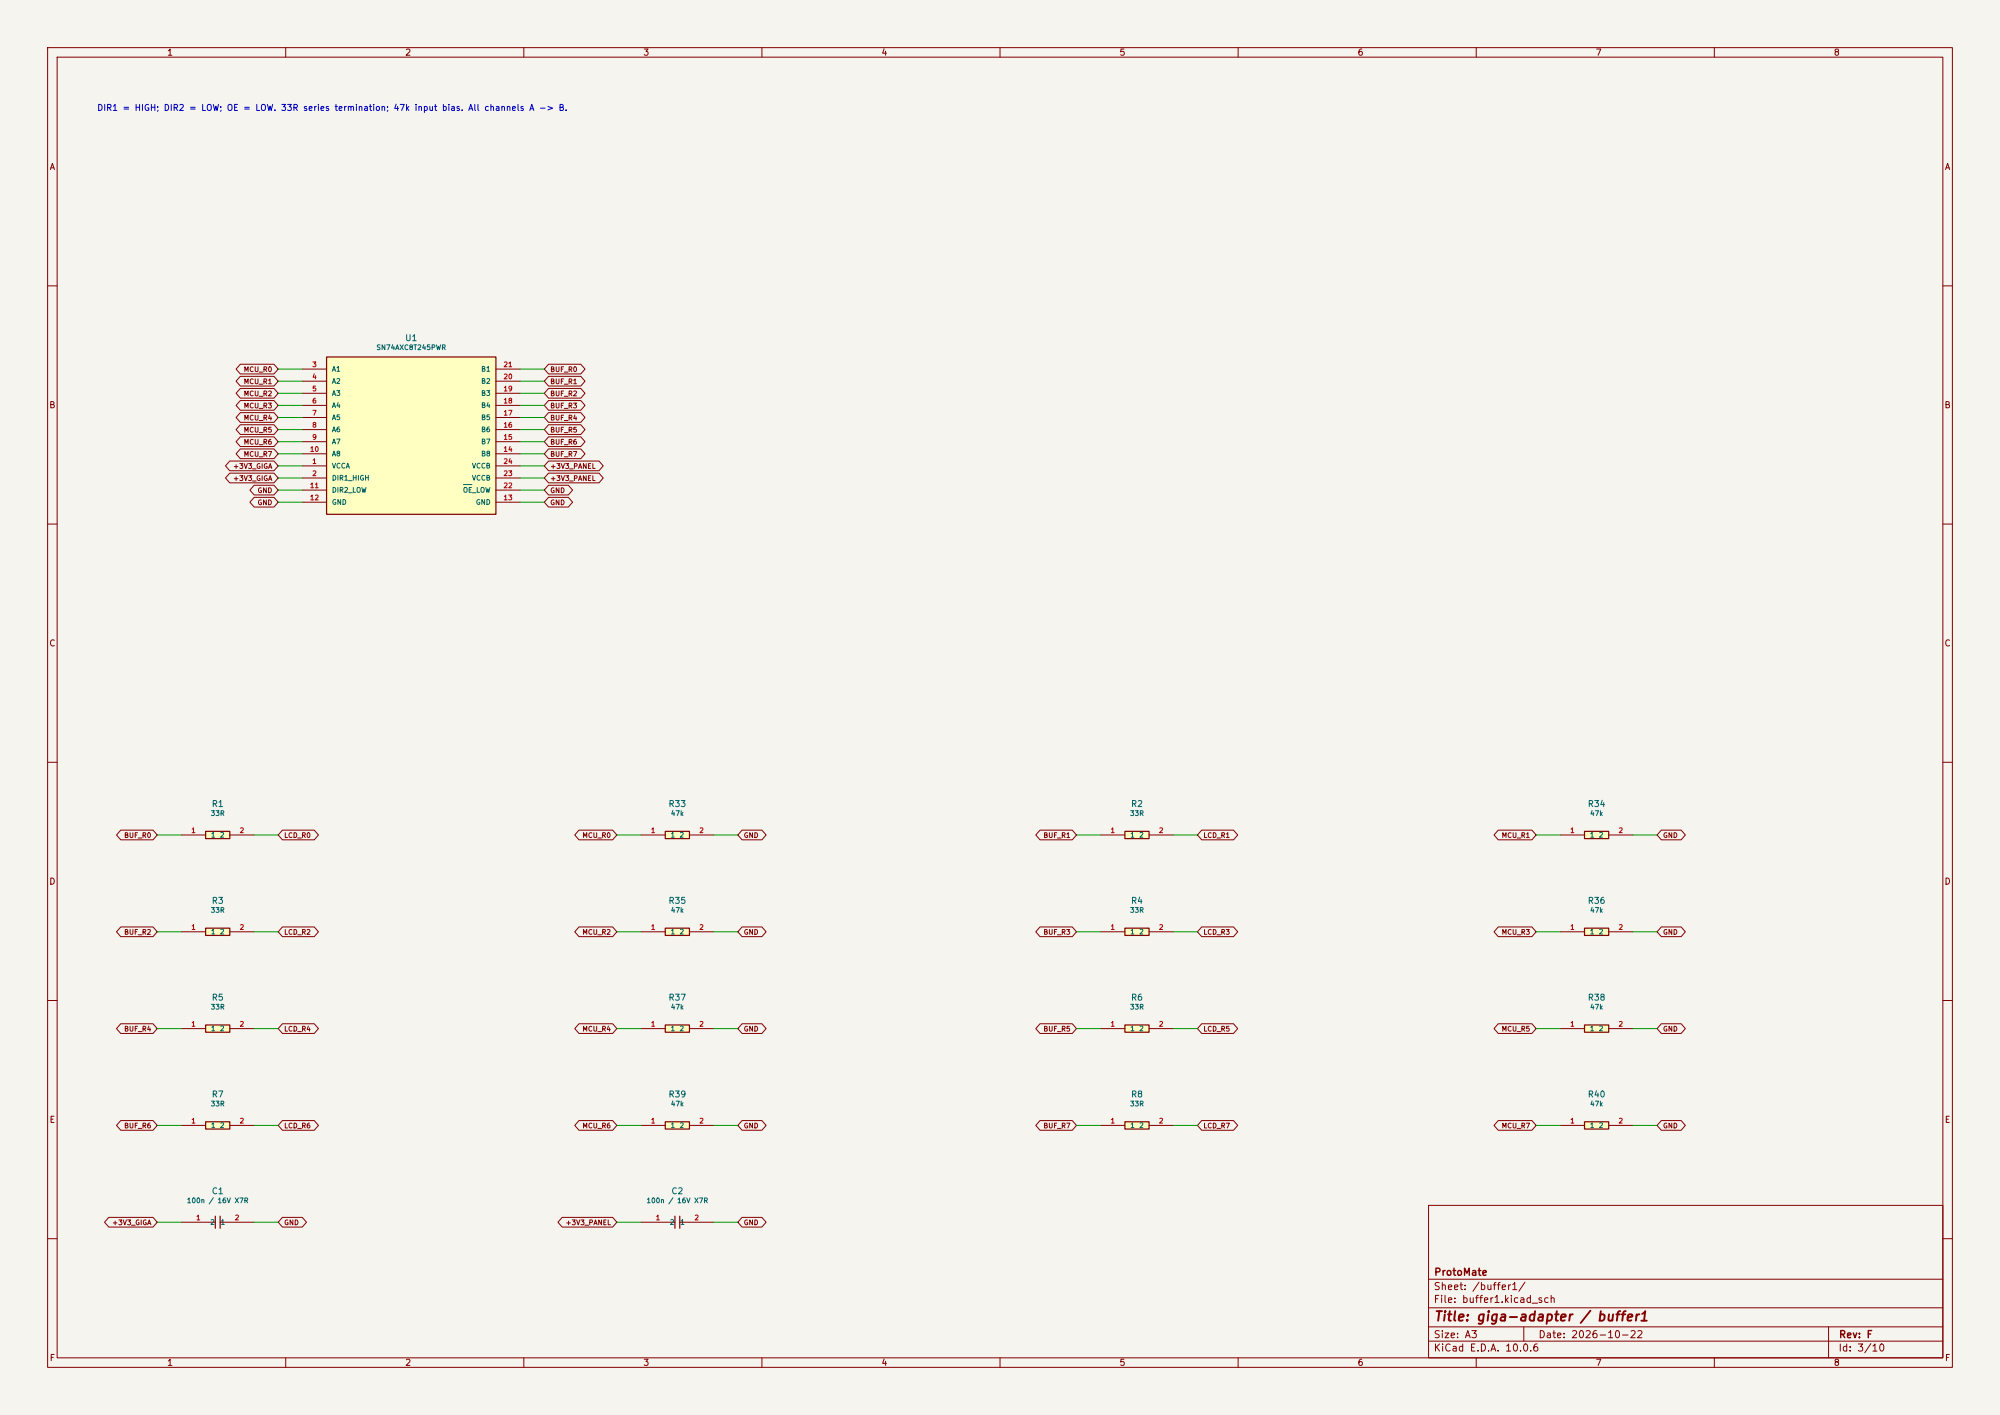
[picture p317: page 3]

MCU_R2 DIR1 = HIGH; DIR2 = LOW; OE = LOW. 33R series termination; 47k input bias. All channels A -> B.

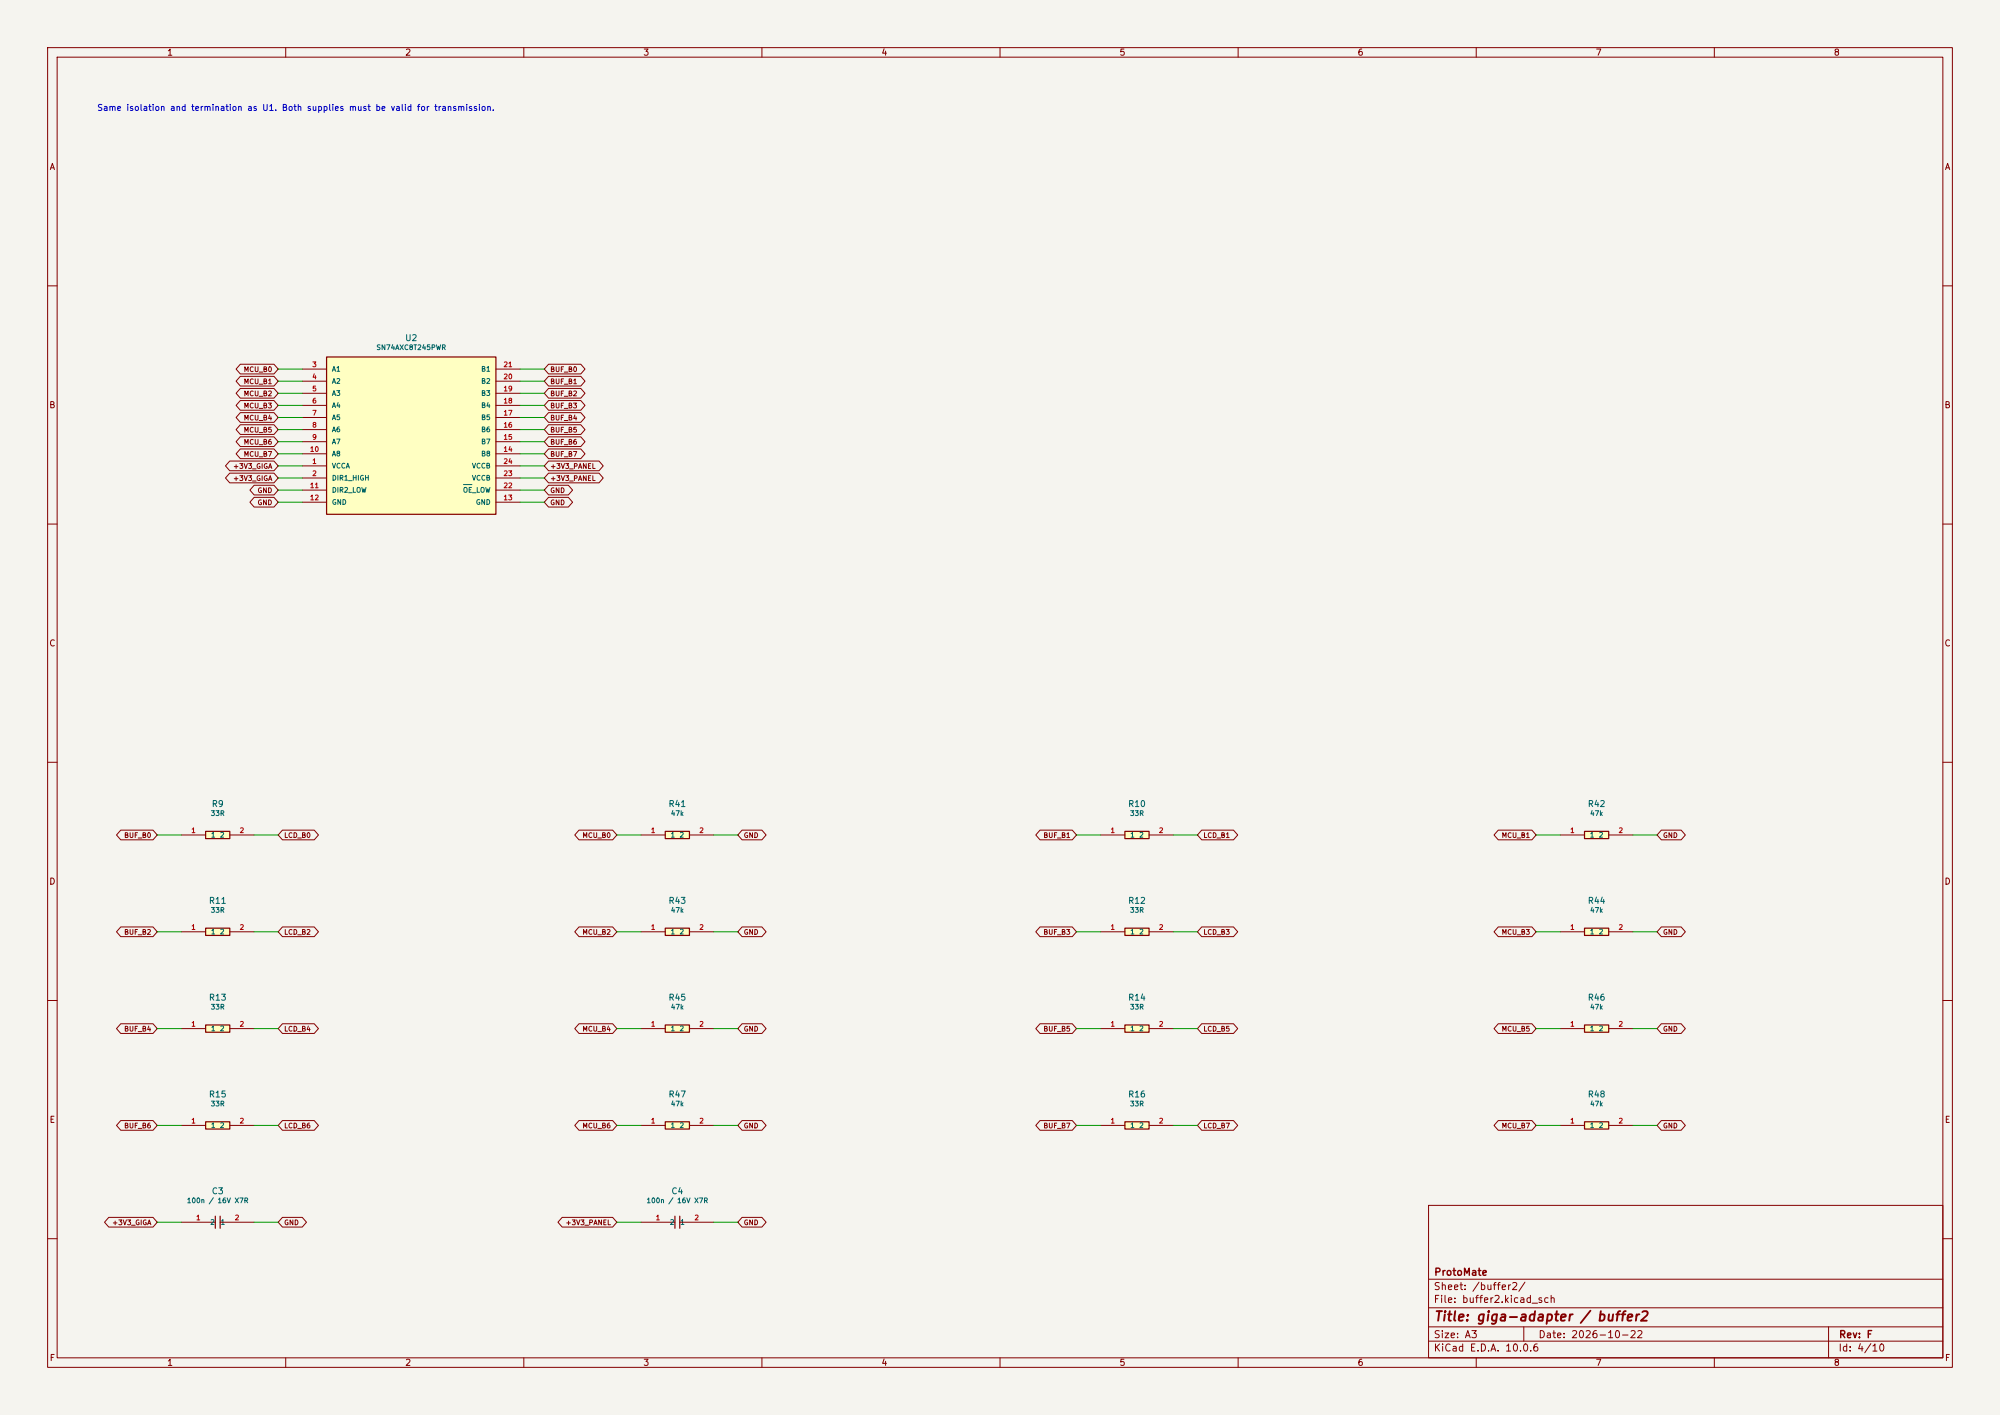
[picture p318: page 4]

MCU_B2 Same isolation and termination as U1. Both supplies must be valid for transmission.

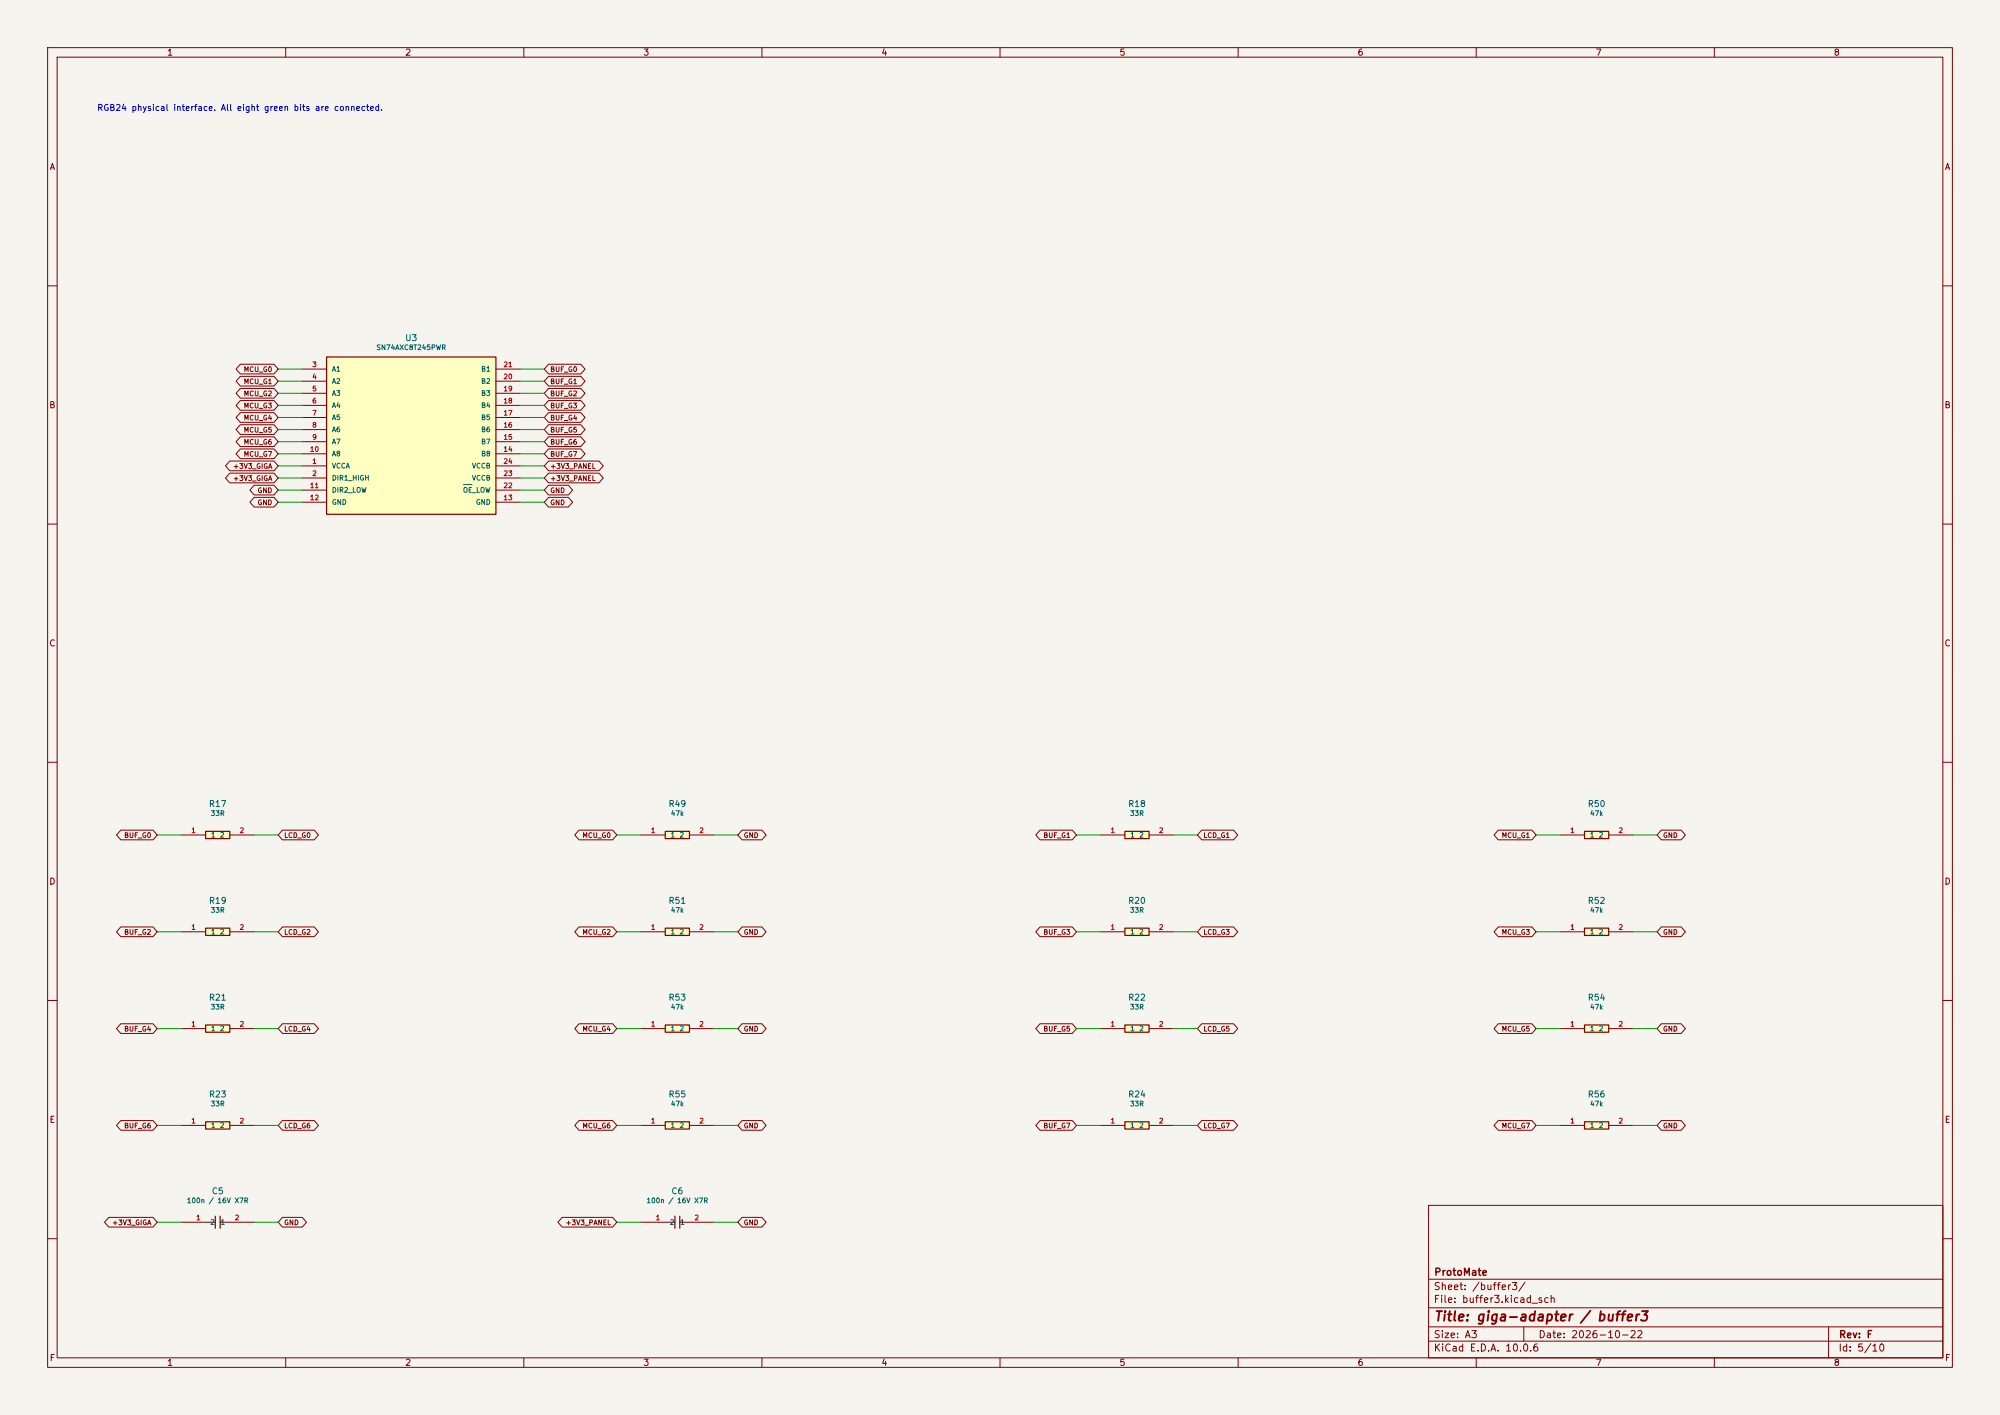
[picture p319: page 5]

MCU_G2 RGB24 physical interface. All eight green bits are connected.

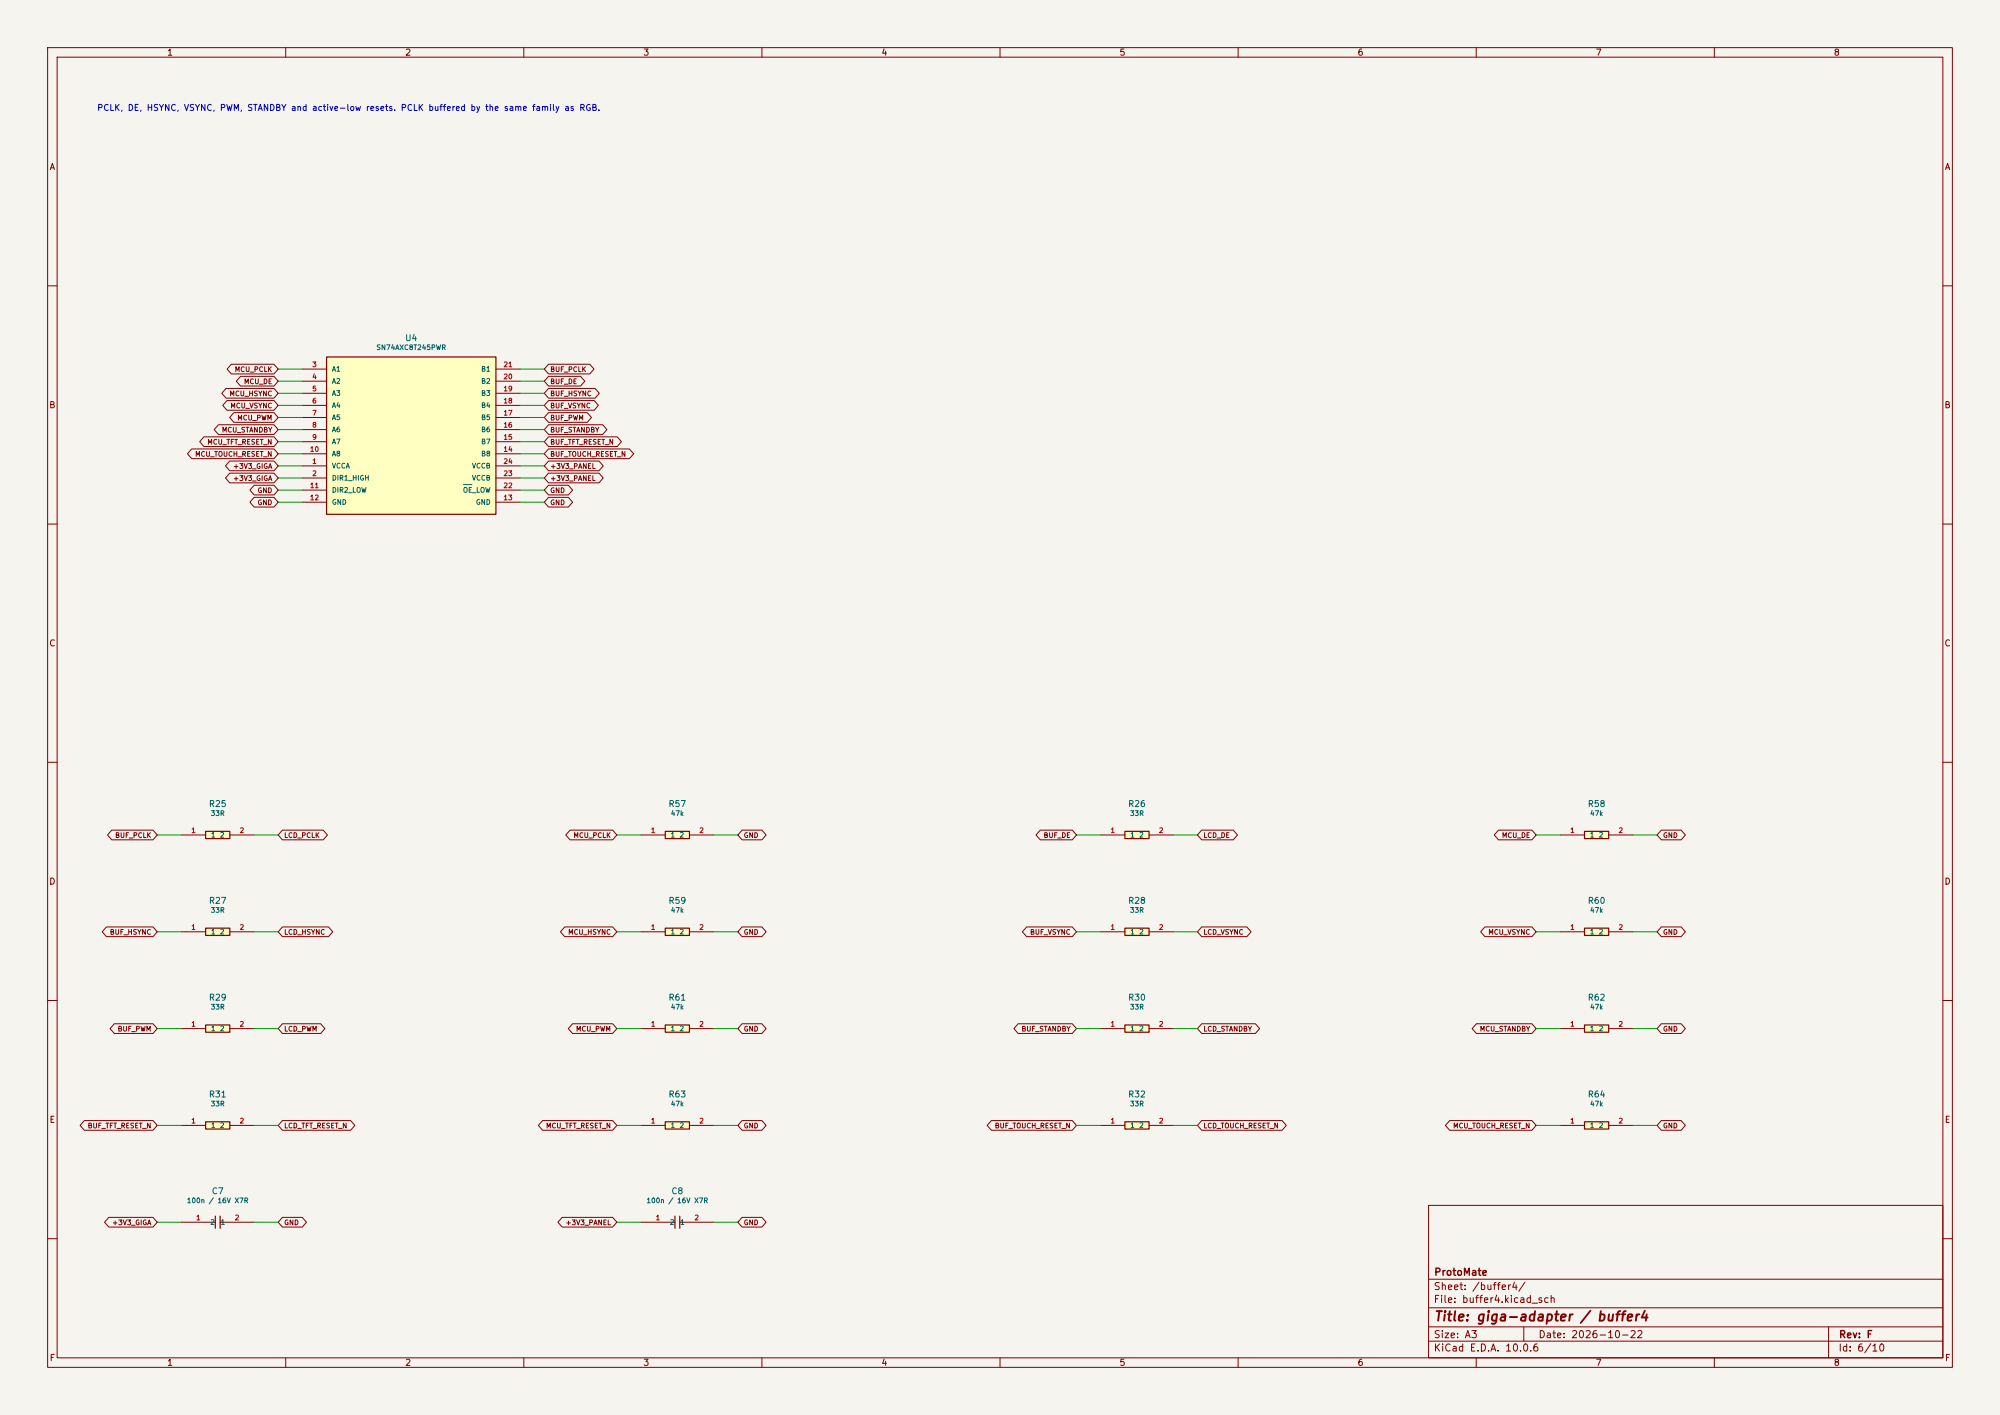
[picture p320: page 6]

PCLK, DE, HSYNC, VSYNC, PWM, STANDBY and active-low resets. PCLK buffered by the same family as RGB.

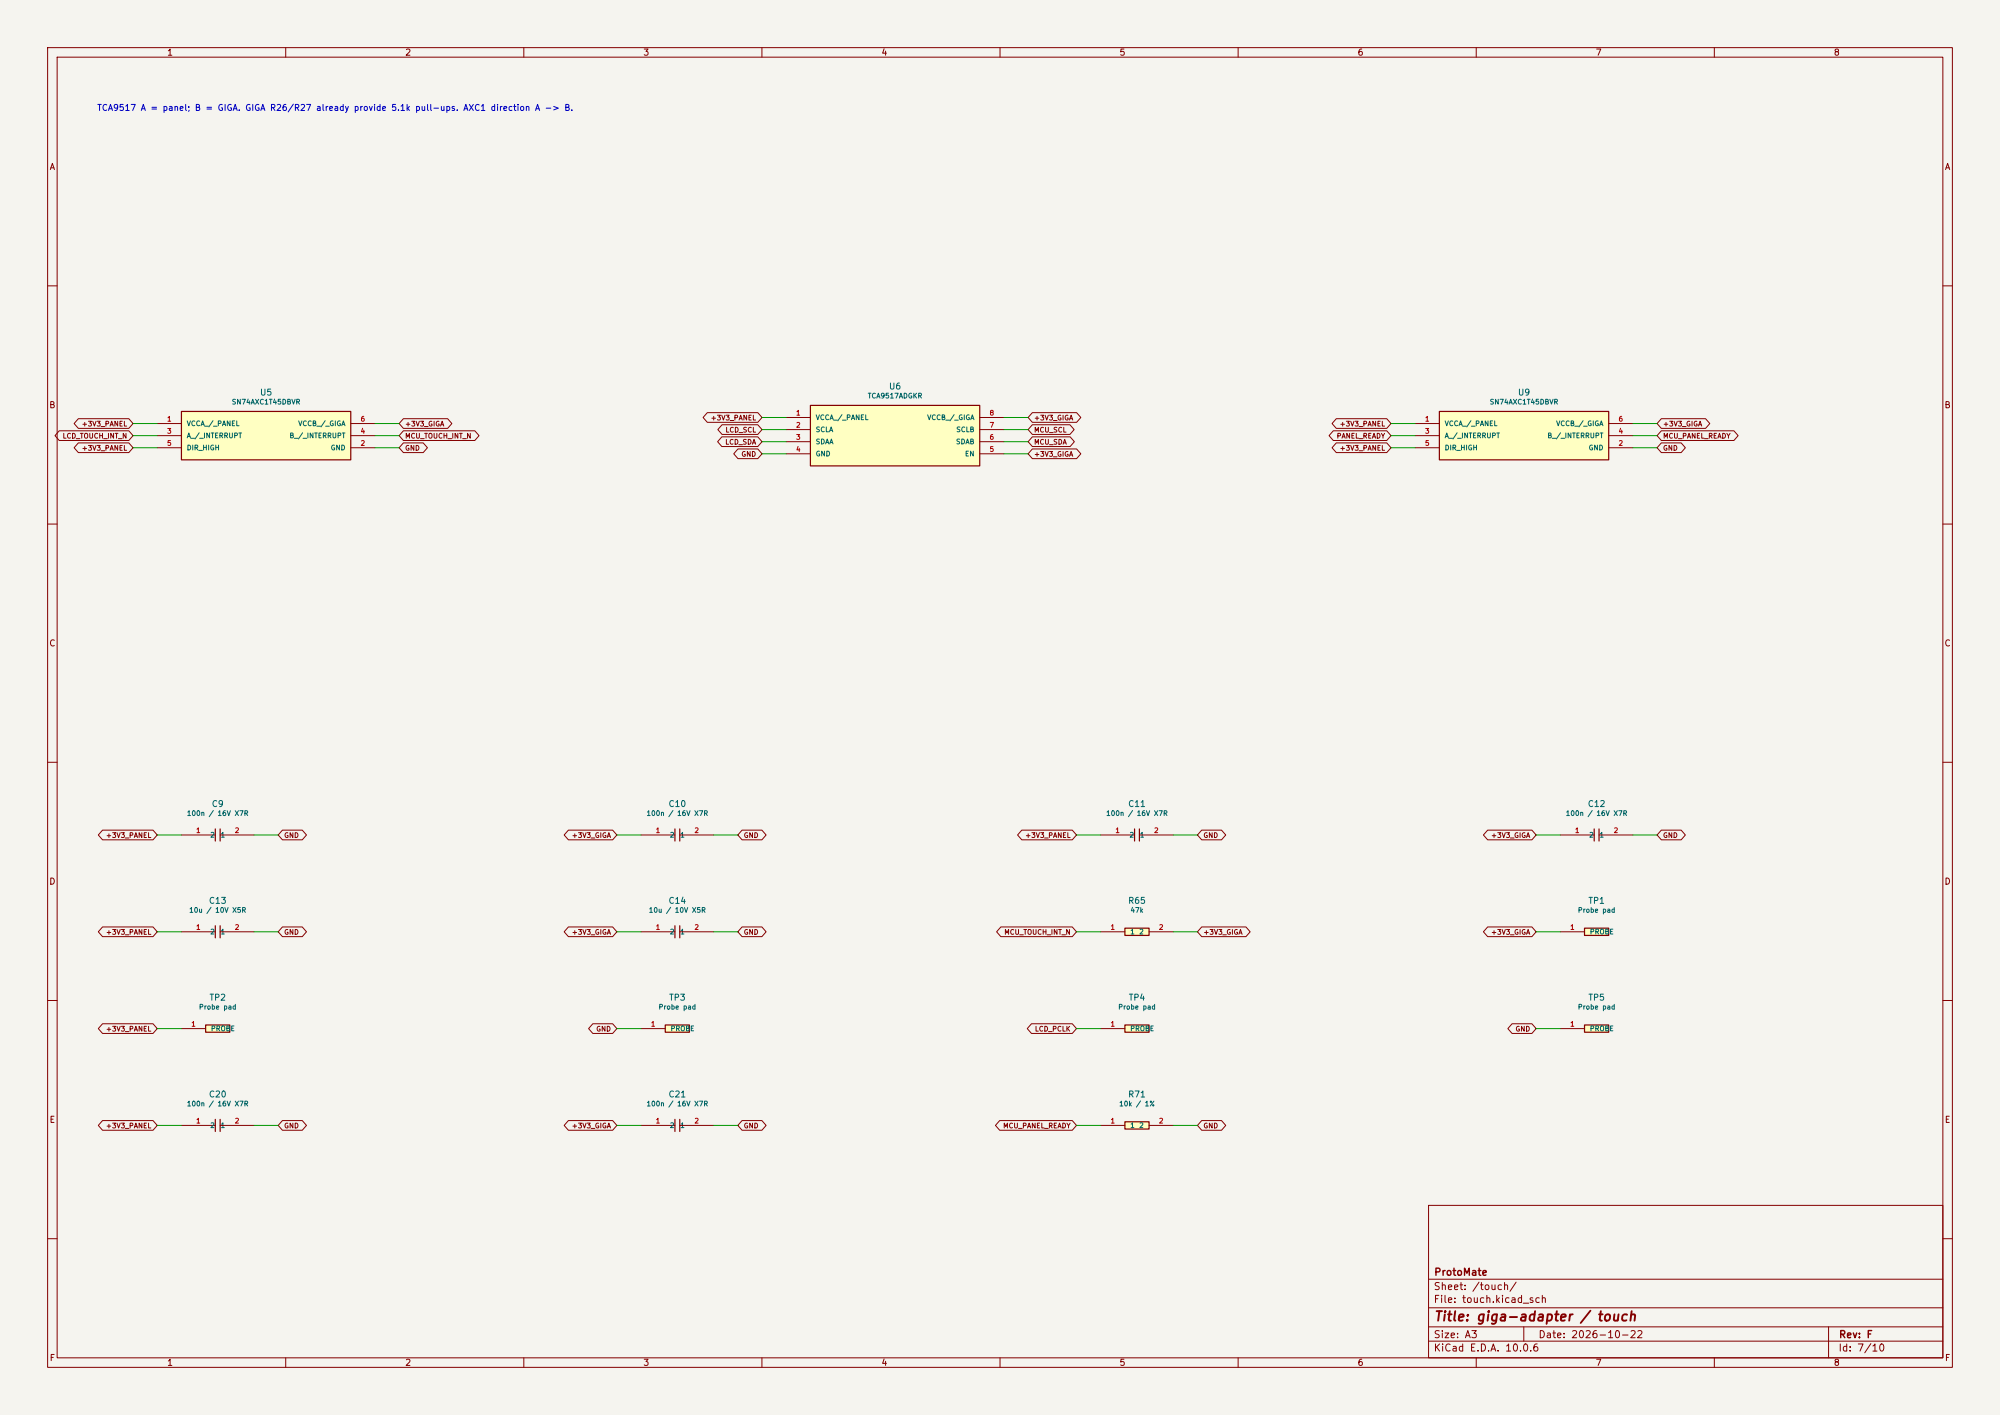
[picture p321: page 7]

TCA9517 A = panel; B = GIGA. GIGA R26/R27 already provide 5.1k pull-ups. AXC1 direction A -> B.

ProtoMate
Sheet: /touch/
File: touch.kicad_sch
Title: giga-adapter / touch

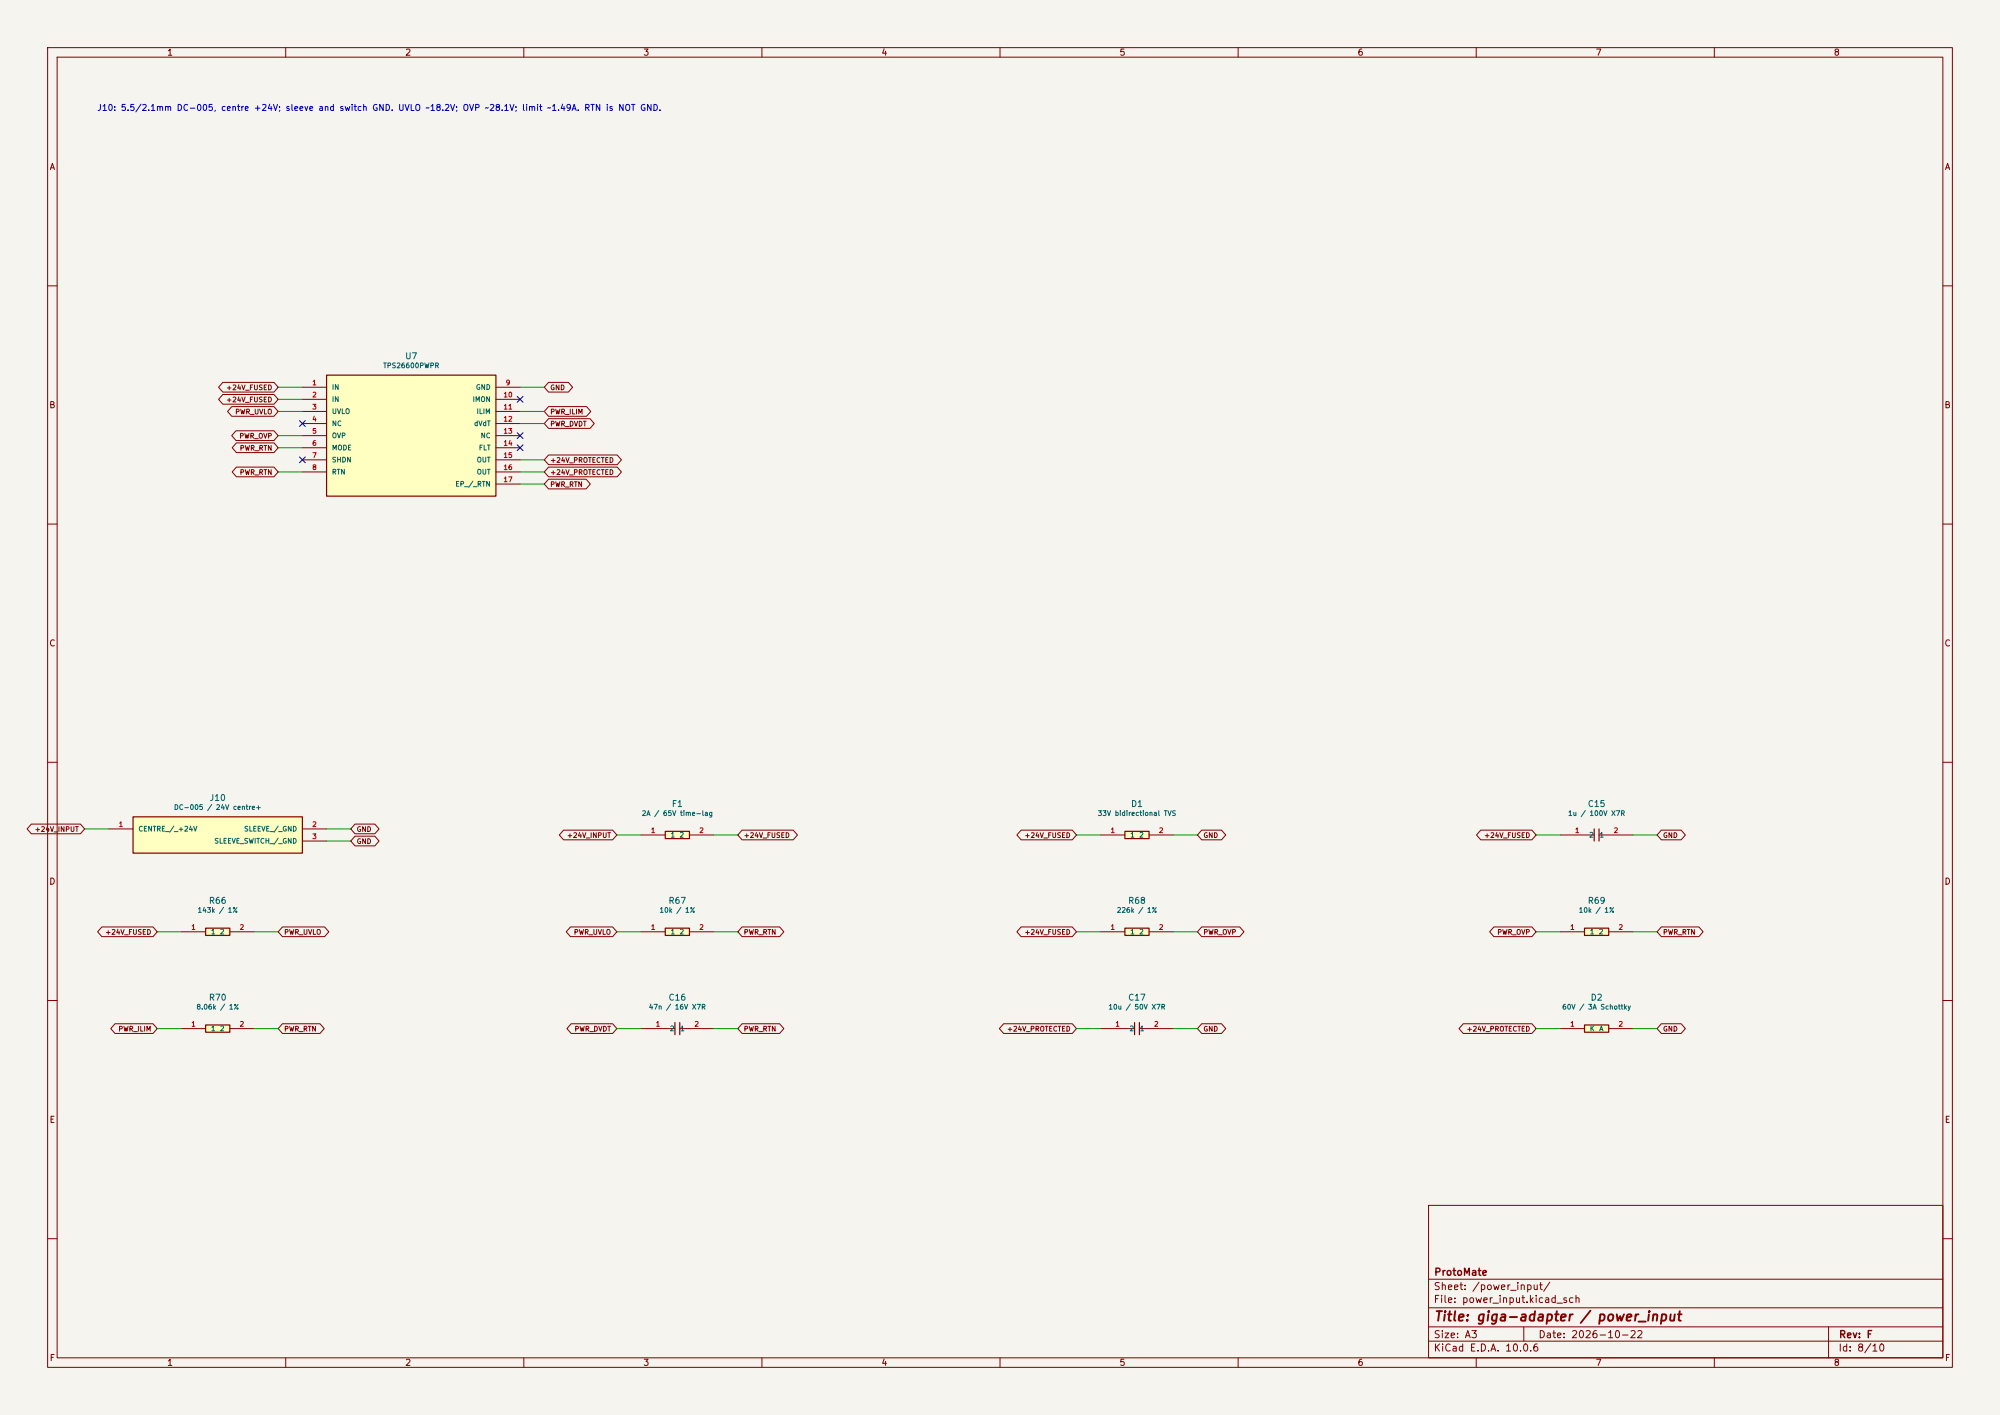
[picture p322: page 8]

J10: 5.5/2.1mm DC-005, centre +24V; sleeve and switch GND. UVLO ~18.2V; OVP ~28.1V; limit ~1.49A. RTN is NOT GND.

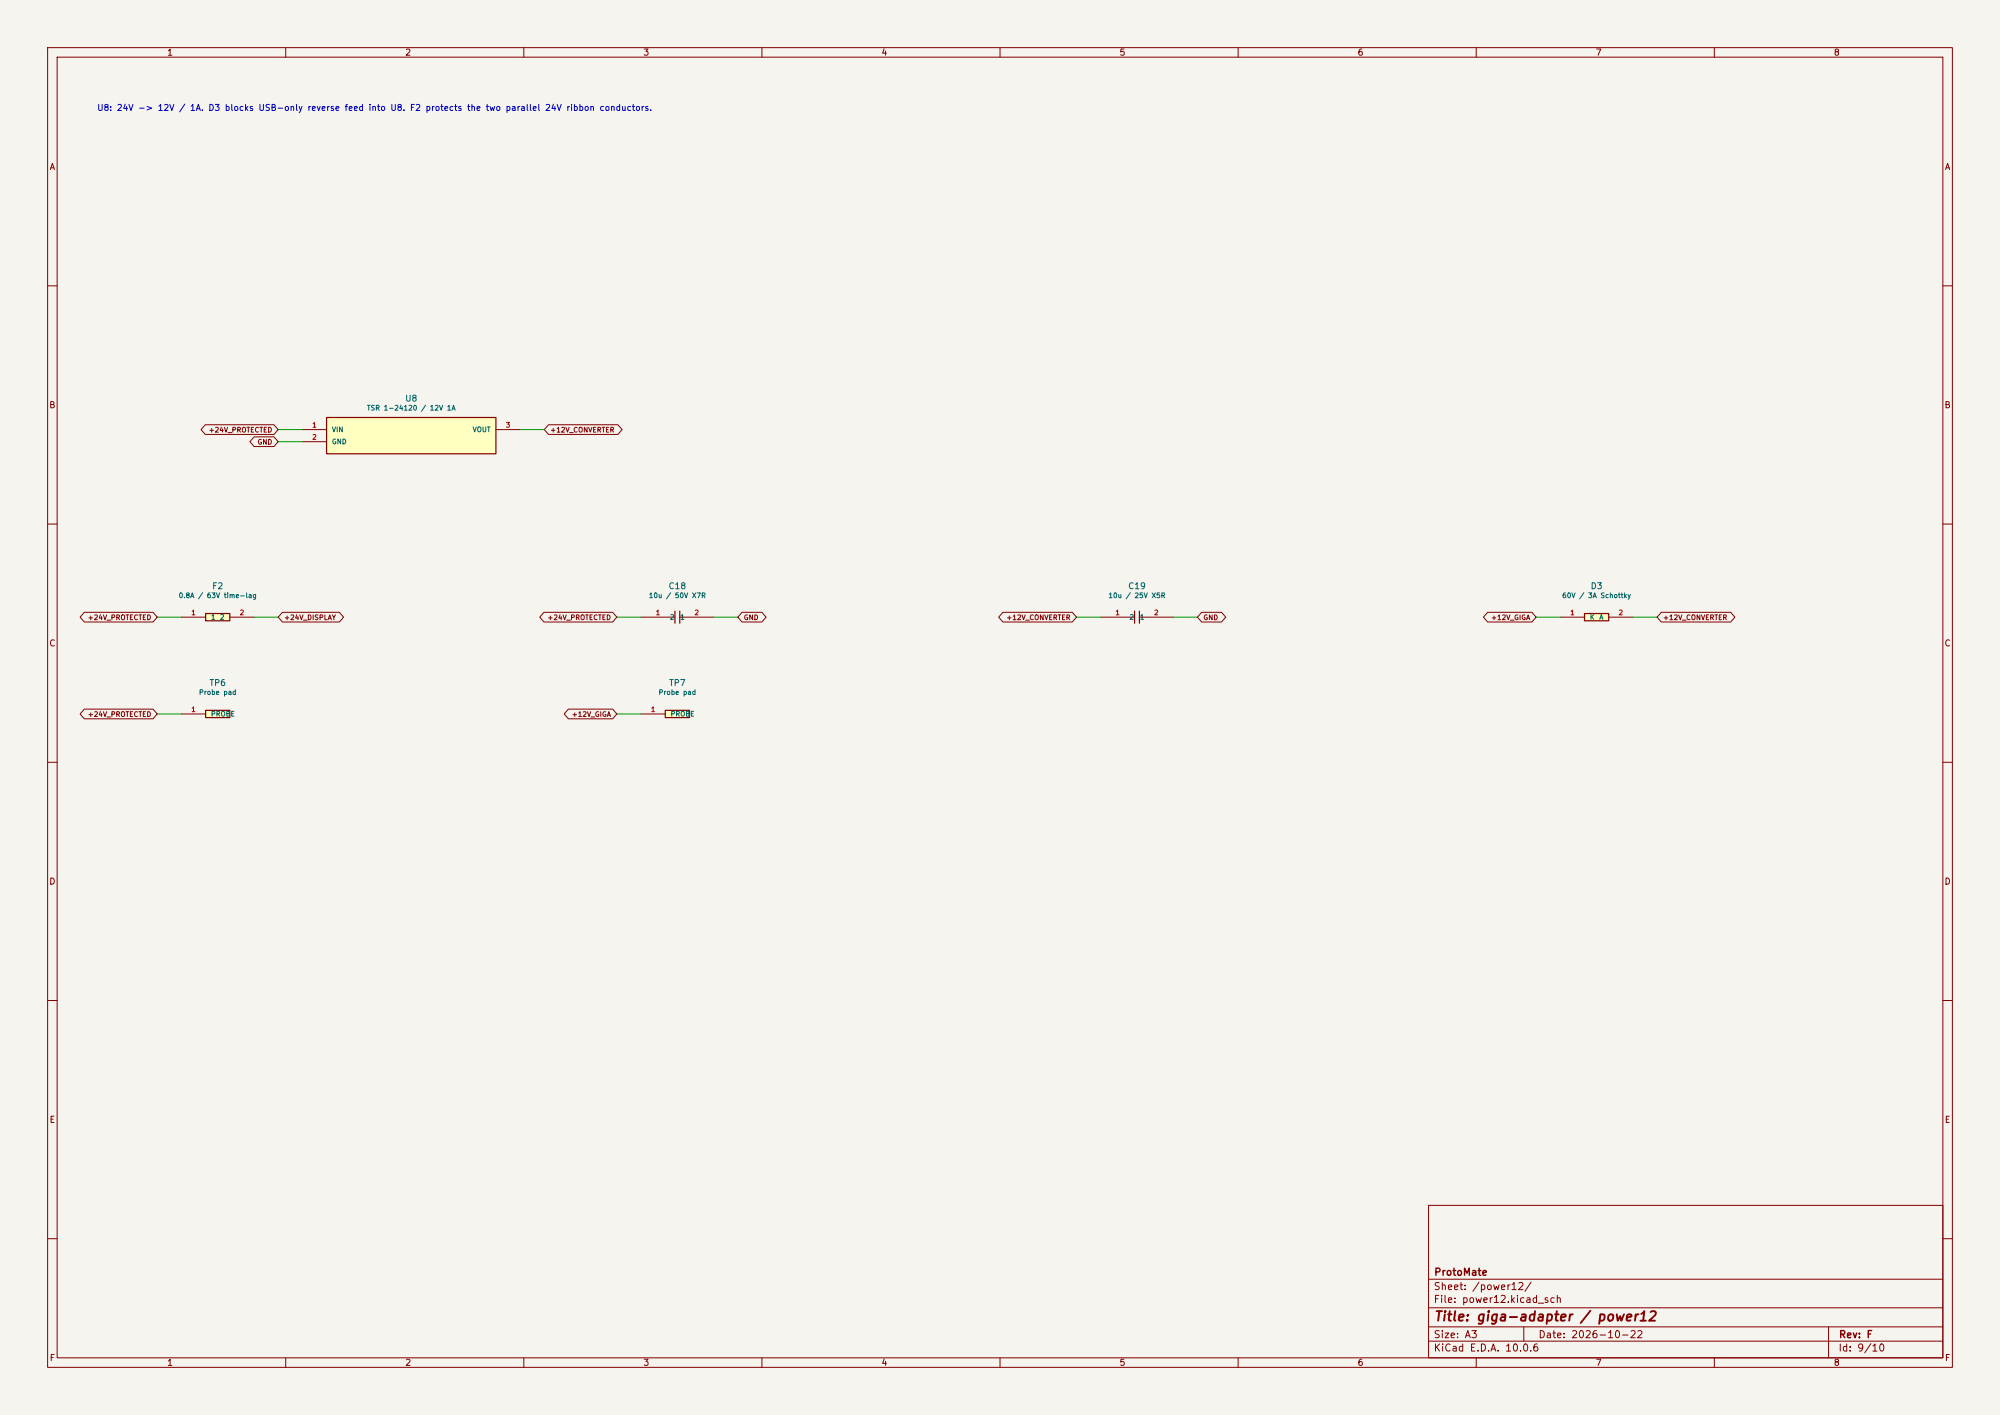
[picture p323: page 9]

U8: 24V -> 12V / 1A. D3 blocks USB-only reverse feed into U8. F2 protects the two parallel 24V ribbon conductors.

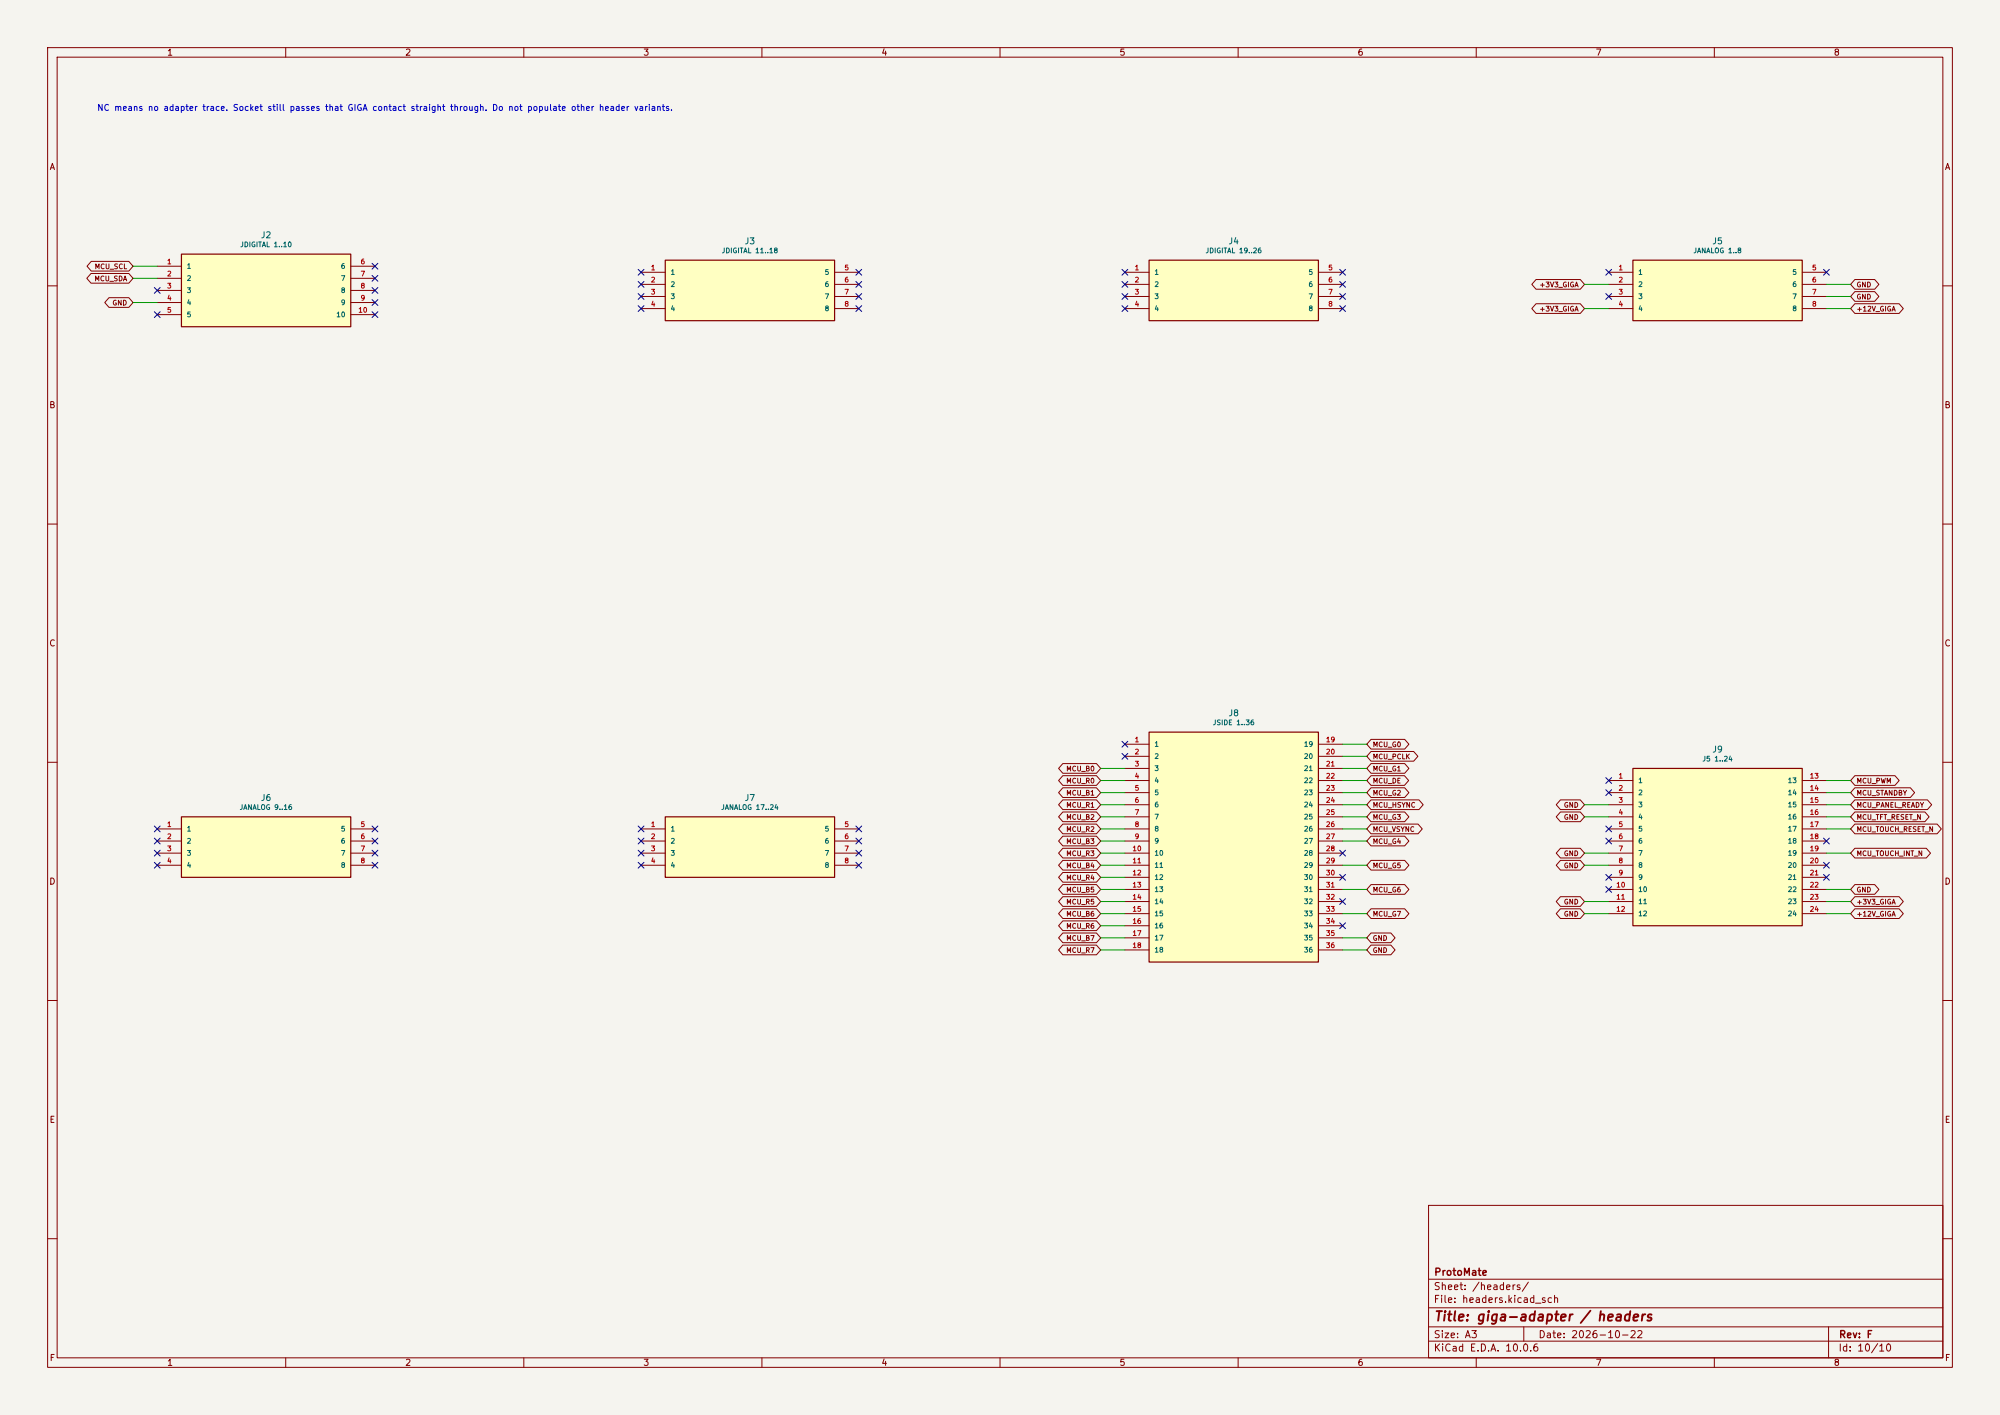
[picture p324: page 10]

ProtoMate
Sheet: /headers/
File: headers.kicad_sch
Title: giga-adapter / headers
