daleondev/ProtoMate_Control/docs/motion-current-state/uml/motion-uml.pdf

## Motion classes across the M7 / M4 boundary

M7 · UI application | M4 · IO application

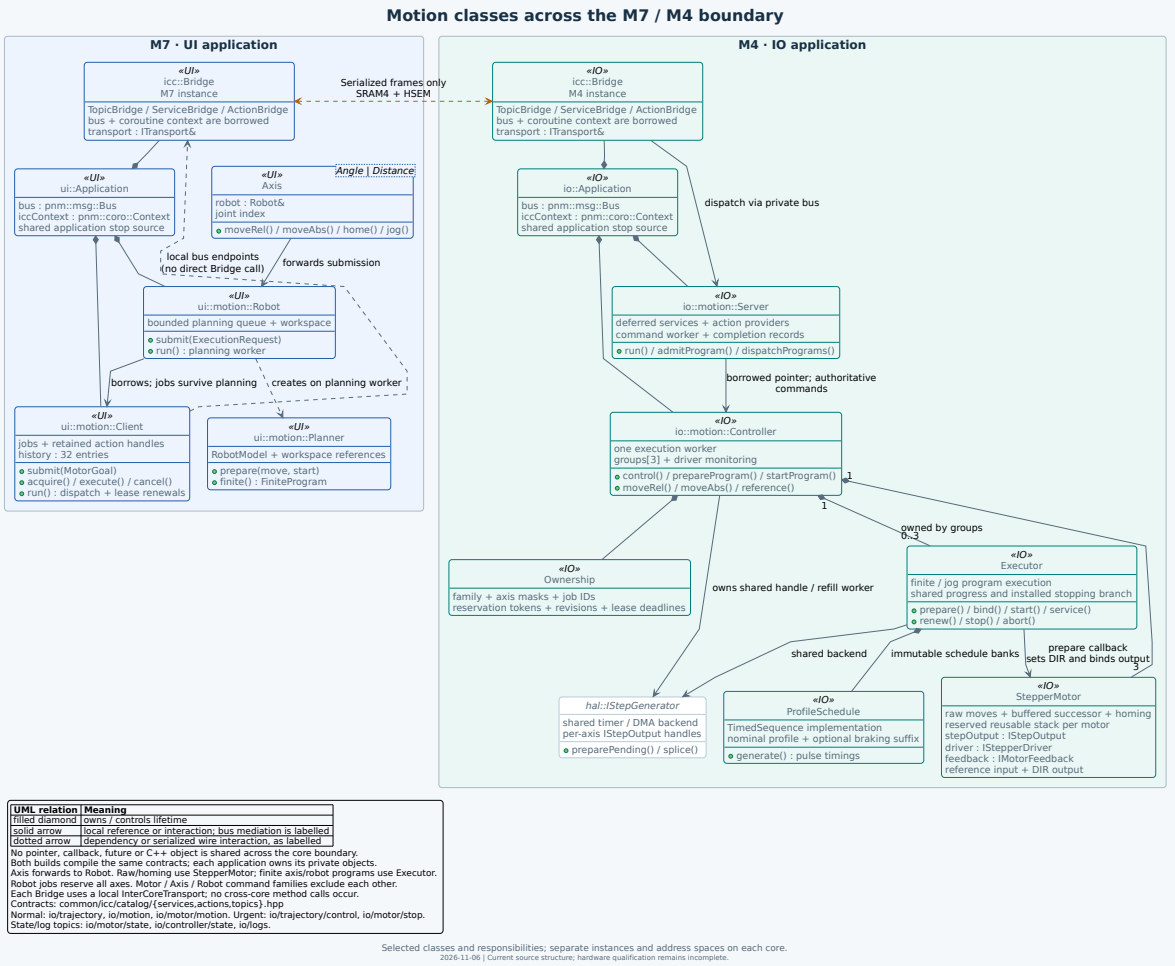
[picture p325: page 1]
«UI» ui::Application; «UI» Axis; Angle | Distance; «UI» icc::Bridge M7 instance; «IO» io::Application; «IO» icc::Bridge M4 instance; «IO» Ownership; «IO» StepperMotor; «IO» Executor; «IO» ProfileSchedule; forwards submission; borrows; jobs survive planning; creates on planning worker; commands; shared backend; immutable schedule banks

Serialized frames only
SRAM4 + HSEM

TopicBridge / ServiceBridge / ActionBridge
bus + coroutine context are borrowed
transport : ITransport&

robot : Robot&
joint index
moveRel() / moveAbs() / home() / jog()

dispatch via private bus

bus : pnm::msg::Bus
iccContext : pnm::coro::Context
shared application stop source

local bus endpoints
(no direct Bridge call)

ui::motion::Robot

io::motion::Server

bounded planning queue + workspace
submit(ExecutionRequest)
run() : planning worker

deferred services + action providers
command worker + completion records
run() / admitProgram() / dispatchPrograms()

borrowed pointer; authoritative

ui::motion::Client

io::motion::Controller

ui::motion::Planner

jobs + retained action handles
history : 32 entries
submit(MotorGoal)
acquire() / execute() / cancel()
run() : dispatch + lease renewals

one execution worker
groups[3] + driver monitoring
control() / prepareProgram() / startProgram()
moveRel() / moveAbs() / reference()

RobotModel + workspace references
prepare(move, start)
finite() : FiniteProgram

owned by groups

finite / jog program execution
shared progress and installed stopping branch
prepare() / bind() / start() / service()
renew() / stop() / abort()

owns shared handle / refill worker

family + axis masks + job IDs
reservation tokens + revisions + lease deadlines

prepare callback
sets DIR and binds output

hal::IStepGenerator
shared timer / DMA backend
per-axis IStepOutput handles
preparePending() / splice()

raw moves + buffered successor + homing
reserved reusable stack per motor
stepOutput : IStepOutput
driver : IStepperDriver
feedback : IMotorFeedback
reference input + DIR output

TimedSequence implementation
nominal profile + optional braking suffix
generate() : pulse timings

UML relation | Meaning
filled diamond | owns / controls lifetime
solid arrow | local reference or interaction; bus mediation is labelled
dotted arrow | dependency or serialized wire interaction, as labelled

No pointer, callback, future or C++ object is shared across the core boundary.
Both builds compile the same contracts; each application owns its private objects.
Axis forwards to Robot. Raw/homing use StepperMotor; finite axis/robot programs use Executor.
Robot jobs reserve all axes. Motor / Axis / Robot command families exclude each other.
Each Bridge uses a local InterCoreTransport; no cross-core method calls occur.
Contracts: common/icc/catalog/{services,actions,topics}.hpp
Normal: io/trajectory, io/motion, io/motor/motion. Urgent: io/trajectory/control, io/motor/stop.
State/log topics: io/motor/state, io/controller/state, io/logs.

Selected classes and responsibilities; separate instances and address spaces on each core.

2026-11-06 | Current source structure; hardware qualification remains incomplete.

## Axis / robot finite move · reservation, planning and start

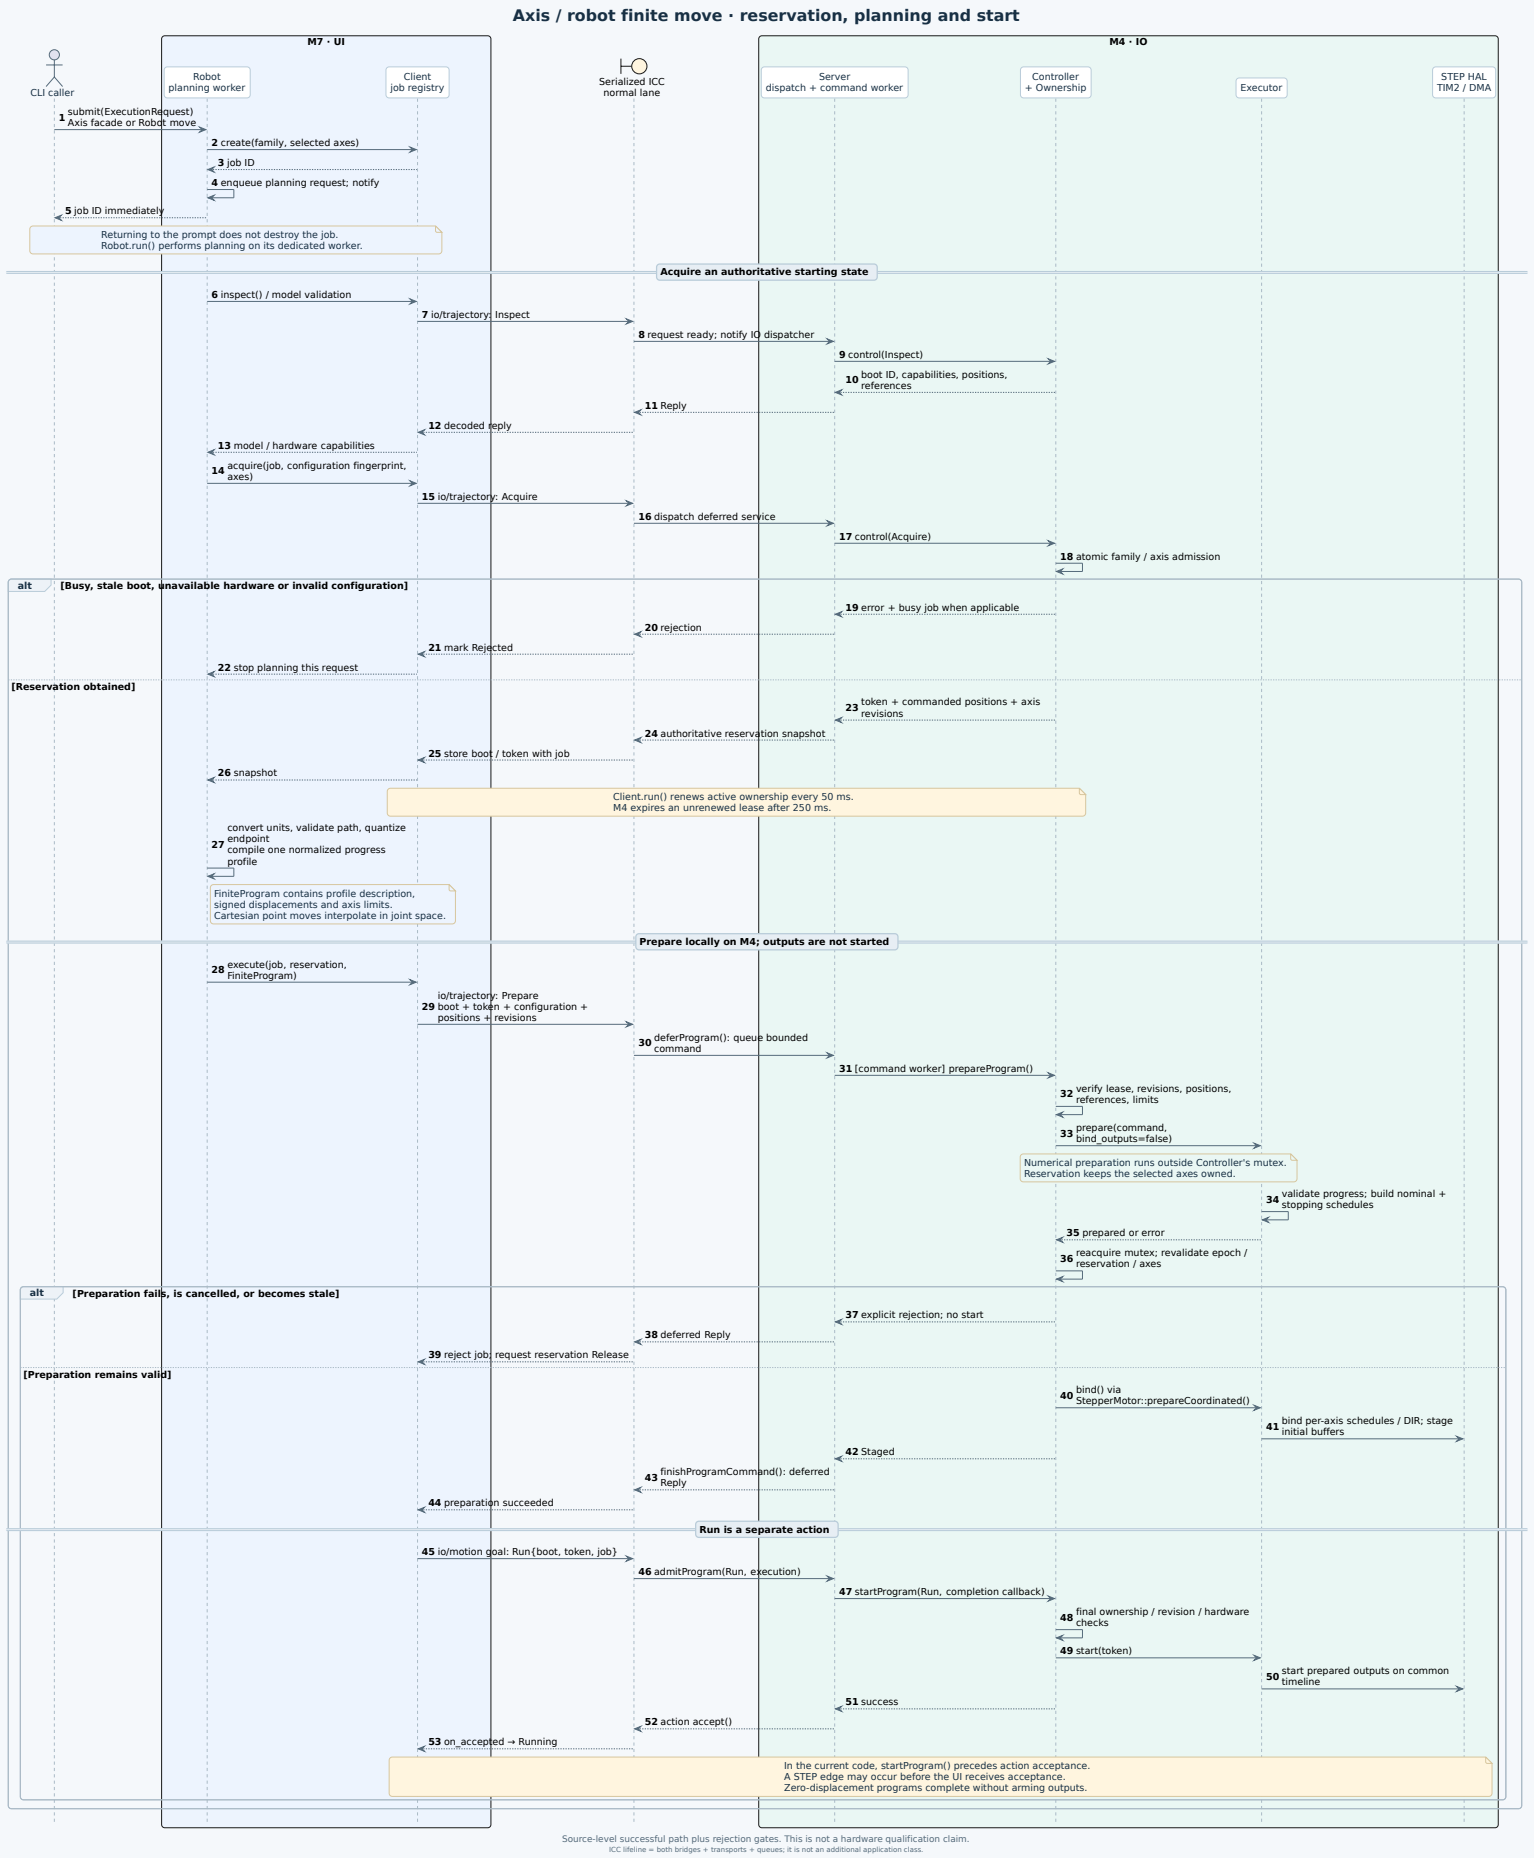
[picture p326: page 2]
Robot planning worker; Client; job registry; Serialized ICC; normal lane; Server; Controller; + Ownership; Executor; STEP HAL TIM2 / DMA; 11 Reply; 12 decoded reply; 17 control(Acquire); alt; [Busy, stale boot, unavailable hardware or invalid configuration]; 20 rejection; 21 mark Rejected; [Reservation obtained]; 26 snapshot; 33 prepare(command, bind_outputs=false); [Preparation fails, is cancelled, or becomes stale]; 38 deferred Reply; 40 bind() via StepperMotor::prepareCoordinated()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

CLI caller
1 submit(ExecutionRequest)
Axis facade or Robot move

dispatch + command worker

2 create(family, selected axes)
3 job ID
4 enqueue planning request; notify

5 job ID immediately

Returning to the prompt does not destroy the job.
Robot.run() performs planning on its dedicated worker.

Acquire an authoritative starting state

6 inspect() / model validation

7 io/trajectory: Inspect

8 request ready; notify IO dispatcher

9 control(Inspect)
10 boot ID, capabilities, positions,
references

13 model / hardware capabilities
14 acquire(job, configuration fingerprint,
axes)

15 io/trajectory: Acquire

16 dispatch deferred service

18 atomic family / axis admission

19 error + busy job when applicable

22 stop planning this request

23 token + commanded positions + axis
revisions

24 authoritative reservation snapshot

25 store boot / token with job

Client.run() renews active ownership every 50 ms.
M4 expires an unrenewed lease after 250 ms.

convert units, validate path, quantize
endpoint
compile one normalized progress
profile

FiniteProgram contains profile description,
signed displacements and axis limits.
Cartesian point moves interpolate in joint space.

Prepare locally on M4; outputs are not started

28 execute(job, reservation,
FiniteProgram)

io/trajectory: Prepare
positions + revisions

boot + token + configuration +

30 deferProgram(): queue bounded
command

31 [command worker] prepareProgram()

32 verify lease, revisions, positions,
references, limits

Numerical preparation runs outside Controller's mutex.
Reservation keeps the selected axes owned.

34 validate progress; build nominal +
stopping schedules

35 prepared or error
36 reacquire mutex; revalidate epoch /
reservation / axes

37 explicit rejection; no start

39 reject job; request reservation Release

[Preparation remains valid]

41 bind per-axis schedules / DIR; stage
initial buffers

Run is a separate action

45 io/motion goal: Run{boot, token, job}

46 admitProgram(Run, execution)

47 startProgram(Run, completion callback)

48 final ownership / revision / hardware
checks

50 start prepared outputs on common
timeline

In the current code, startProgram() precedes action acceptance.
A STEP edge may occur before the UI receives acceptance.
Zero-displacement programs complete without arming outputs.

Source-level successful path plus rejection gates. This is not a hardware qualification claim.

ICC lifeline = both bridges + transports + queues; it is not an additional application class.

## Finite motion · execution, controlled stop and lease loss

application worker | Serialized ICC
urgent / normal lanes

IO dispatcher

execution worker | Executor

TIM2 / DMA

Two different renewals

loop [UI owner keepalive · every 50 ms while active]

### 1 urgent io/trajectory/control: Renew{job

IDs}

### 2 urgent service ready

### 3 control(Renew) under Controller mutex

### 4 renew valid owner deadlines to now +

250 ms

### 5 acknowledgement

### 6 urgent reply

### 7 record acknowledgement / error

One renewal request in flight; late renewals do not revive expired jobs. Ownership renewal is separate from M4 pulse-schedule maintenance.

loop [M4 execution worker · notifications + up to 1 ms timed wait when active]

### 8 preparePending(): fill requested DMA

buffers

### 9 check faults, ownership lease and

motion timeout

### 10 renew(id); service()

opt [Maintenance due · nominally every 40 ms]

11

build next immutable schedule bank
include stopping continuation from its
boundary

### 12 splice(replacement, current boundary)

### 13 accepted, retry or error

### 14 advance committed frontier toward

now + 80 ms

### 15 hardware-timed STEP edges

### 16 refill / completion notifications

The installed schedule already contains its brake.
Continuing motion replaces future data before that boundary. Stopping does not need a new M7 plan.

Controlled stop · two ways to select the installed brake

alt [Explicit axis/robot stop or action cancellation]

17

urgent Stop{job or axis mask} (cancel also requests action cancellation)

### 18 control request / cancel notification

### 19 control(Stop); expand target to whole

owned group

### 20 stop(id)

### 21 state = Braking; cease nominal

schedule extension

### 22 stop request processed

### 23 acknowledgement

### 24 request acknowledged, NOT yet

terminal

[UI renewal stops / link is lost]

no valid owner renewal arrives

25

owner deadline expires
(or connectionLost() invalidates admission)

### 26 stop(id)

### 27 use already installed stopping

continuation

No reply from M7 is needed for this local selection.
A disconnected UI cannot infer a confirmed physical stop.

Completion and ownership release

### 28 finish committed prefix, brake, then

last STEP

### 29 completion notification

### 30 service() observes all participating

outputs complete

### 31 Stopped + counts / error status

### 32 bounded completion callback: copy

result + notify

### 33 dispatchPrograms(): observe

completion record

### 34 terminal action result:

cancelled(Stopped)

### 35 releaseJob(job) after completion

cleanup

### 36 ready notification; Client.run()

dispatches result

### 37 retain history; release pending action

handle

Natural completion follows the same result path with Completed. Communication failure can leave the UI result Unknown.
Local faults / explicit Abort bypass braking and may invalidate references.
Hardware-guard cessation is not a controlled-stop guarantee.

Starts with a prepared, running Executor program. Raw motor stops and homing use a different path.
Configured timing is shown, not a measured worst-case guarantee. Source-level behavior still needs full hardware qualification.

## Raw motor command · the StepperMotor worker path

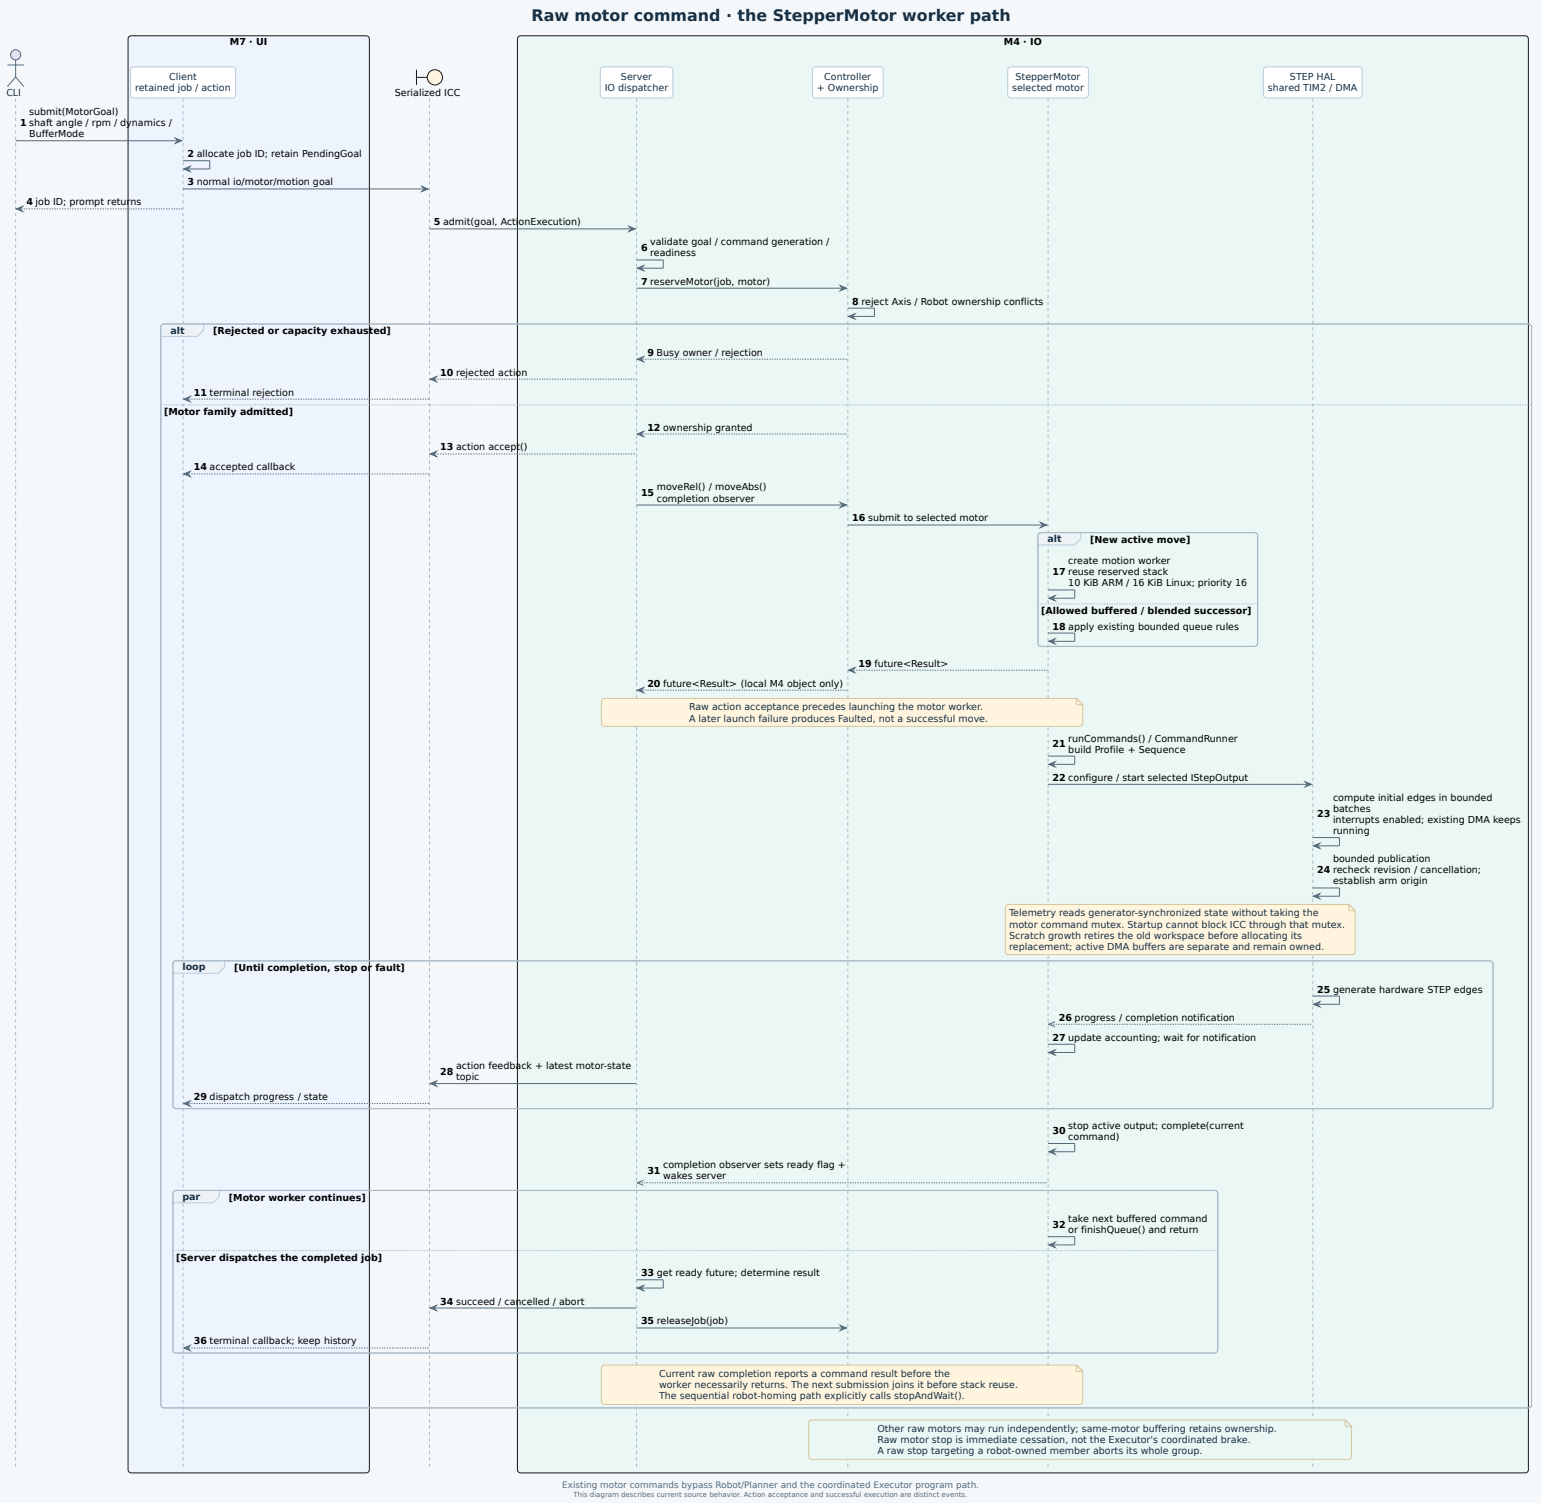
[picture p327: page 4]
CLI; retained job / action; Serialized ICC; IO dispatcher; + Ownership; StepperMotor selected motor; shared TIM2 / DMA; submit(MotorGoal); BufferMode; alt; [Rejected or capacity exhausted]; 10 rejected action; 12 ownership granted; 13 action accept(); 14 accepted callback; 15 moveRel() / moveAbs() completion observer; [New active move]; 19 future<Result>; loop; [Until completion, stop or fault]; par; [Motor worker continues]; 35 releaseJob(job)

shaft angle / rpm / dynamics /

2 allocate job ID; retain PendingGoal

3 normal io/motor/motion goal

4 job ID; prompt returns

5 admit(goal, ActionExecution)

6 validate goal / command generation /
readiness

7 reserveMotor(job, motor)

8 reject Axis / Robot ownership conflicts

9 Busy owner / rejection

11 terminal rejection
[Motor family admitted]

16 submit to selected motor

create motion worker
10 KiB ARM / 16 KiB Linux; priority 16

reuse reserved stack

[Allowed buffered / blended successor]
18 apply existing bounded queue rules

20 future<Result> (local M4 object only)

Raw action acceptance precedes launching the motor worker.
A later launch failure produces Faulted, not a successful move.

21 runCommands() / CommandRunner
build Profile + Sequence

22 configure / start selected IStepOutput

compute initial edges in bounded
batches
interrupts enabled; existing DMA keeps
running

bounded publication
establish arm origin

recheck revision / cancellation;

Telemetry reads generator-synchronized state without taking the
motor command mutex. Startup cannot block ICC through that mutex.
Scratch growth retires the old workspace before allocating its
replacement; active DMA buffers are separate and remain owned.

25 generate hardware STEP edges

26 progress / completion notification
27 update accounting; wait for notification

28 action feedback + latest motor-state
topic

29 dispatch progress / state

30 stop active output; complete(current
command)

31 completion observer sets ready flag +
wakes server

32 take next buffered command
or finishQueue() and return

[Server dispatches the completed job]

33 get ready future; determine result

34 succeed / cancelled / abort

36 terminal callback; keep history

Current raw completion reports a command result before the
worker necessarily returns. The next submission joins it before stack reuse.
The sequential robot-homing path explicitly calls stopAndWait().

Other raw motors may run independently; same-motor buffering retains ownership.
Raw motor stop is immediate cessation, not the Executor's coordinated brake.
A raw stop targeting a robot-owned member aborts its whole group.

Existing motor commands bypass Robot/Planner and the coordinated Executor program path.
This diagram describes current source behavior. Action acceptance and successful execution are distinct events.

## Sequential robot homing · lifetime, deadlines and cleanup

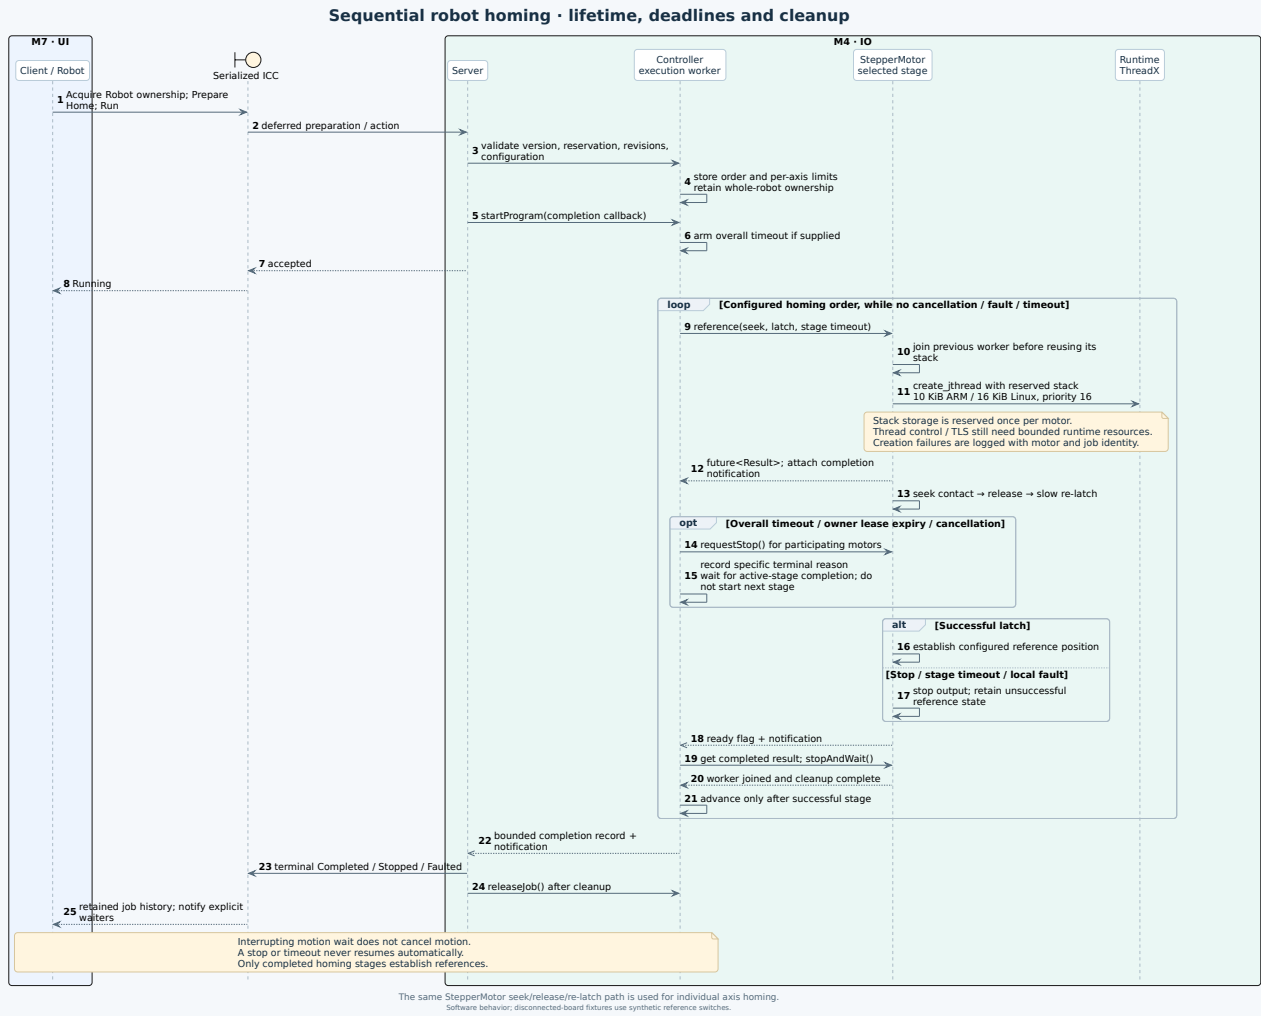
[picture p328: page 5]
Client / Robot; Serialized ICC; Server; execution worker; StepperMotor selected stage; Runtime ThreadX; 7 accepted; 8 Running; loop; [Configured homing order, while no cancellation / fault / timeout]; opt; [Overall timeout / owner lease expiry / cancellation]; alt; [Successful latch]

1 Acquire Robot ownership; Prepare
Home; Run

2 deferred preparation / action

3 validate version, reservation, revisions,
configuration

4 store order and per-axis limits
retain whole-robot ownership

5 startProgram(completion callback)

6 arm overall timeout if supplied

9 reference(seek, latch, stage timeout)

10 join previous worker before reusing its
stack

11 create_jthread with reserved stack
10 KiB ARM / 16 KiB Linux, priority 16

Stack storage is reserved once per motor.
Thread control / TLS still need bounded runtime resources.
Creation failures are logged with motor and job identity.

12 future<Result>; attach completion
notification

13 seek contact → release → slow re-latch

14 requestStop() for participating motors
record specific terminal reason
not start next stage

wait for active-stage completion; do

16 establish configured reference position

[Stop / stage timeout / local fault]
17 stop output; retain unsuccessful
reference state

18 ready flag + notification
19 get completed result; stopAndWait()
20 worker joined and cleanup complete
21 advance only after successful stage

22 bounded completion record +

23 terminal Completed / Stopped / Faulted

24 releaseJob() after cleanup

25 retained job history; notify explicit
waiters

Interrupting motion wait does not cancel motion.
A stop or timeout never resumes automatically.
Only completed homing stages establish references.

The same StepperMotor seek/release/re-latch path is used for individual axis homing.

Software behavior; disconnected-board fixtures use synthetic reference switches.

## Concurrent motion · independent jobs and persistent ICC buffers

CLI | Client / Planner | ICC sender | Shared-memory transport | ICC sender / receiver | Server / Controller | Executor / timer DMA

Each lane's long-lived send coroutine owns one frame buffer. A synchronous helper fills it; transport borrows its span. Reuse waits for send completion. No full-frame coroutine
is allocated for each message or heartbeat.
M4 ordinary dispatch/admission executes from SDRAM.
STEP/IRQ and bounded transport hot paths remain in internal SRAM.

### 1 axis jog shoulder -.2 --continuous

### 2 acquire, prepare, run

### 3 serialized request

| | | 4 deliver
| | | | 5 admit Axis-family job

### 6 rolling shoulder program + installed

| | | | | brake

### 7 Running (through ICC)

### 8 axis move elbow -1

### 9 independent-axis acquire / prepare /

| run (via ICC)

### 10 validate reservation and revisions

### 11 elbow program; shoulder continues

| loop | [while motion is active]

### 12 urgent heartbeat (via transport)

### 13 acknowledgement using persistent

| | | sender buffer

### 14 ownership renewal (via urgent service)

| | | | | 15 local schedule maintenance

### 16 elbow completed; exact pulse count

### 17 terminal result; release elbow

| ownership

### 18 axis stop shoulder

### 19 urgent controlled stop (via ICC)

### 20 select installed stopping continuation

| | | | | 21 shoulder stopped

### 22 terminal result; release shoulder

| ownership

Repeated overlap / stop / restart and analyzer checks pass. The new host test forbids full-frame allocations during heartbeat traffic after startup. This is not a maximum-rate
| | | or powered-mechanics qualification.

Motor-disconnected application fixture; physical commissioning remains separate.
Heartbeat 100 ms / deadline 500 ms and ownership lease 250 ms are unchanged.

## Native simulation · one clock, completed interrupt handoff

Native simulator process | Controller process
Session / Machine | Shared-memory
IRQ sequence + idle epoch | Interrupt thread | ThreadX scheduler | Homing worker | GUI / other workers

### 1 advance to next event only when prior

work is idle

### 2 publish reference input, IRQ flags and

sequence N

### 3 eventfd wake

### 4 reference callback latches activation

| 5 notify homing worker

### 6 acknowledge IRQ N

IRQ acknowledgement does not authorize more virtual time. The notified homing worker must get a chance to run.

| 7 leave interrupt context

### 8 dispatch ready worker in priority order

### 9 HAL transaction: stop STEP; hold virtual

time

### 10 process register requests

### 11 output stopped, exact count available

### 12 wait for debounce / next event

### 13 dispatch remaining runnable work

### 14 suspend until notification / simulated

| | deadline

### 15 no runnable threads, no ISR: idle_epoch

= N + 1

### 16 matching IRQ acknowledgement and

idle epoch

### 17 next event may advance virtual time

ThreadX ticks, STEP, feedback and display VSYNC share virtual time.
SDL input pumping and native peer watchdogs remain on wall time.
Slow host computation stretches wall duration instead of starving a worker behind repeated simulated timer interrupts. GIGA firmware is unchanged.

Linux functional verification; this does not model Cortex-M execution time.
Source: Session.cpp; simulation/Client.cpp; ThreadX Linux scheduler hook; DisplayHost.cpp.
