daleondev/ProtoMate_Control/hardware/display/manufacturing/display-adapter-rev-G/assembly-F.pdf

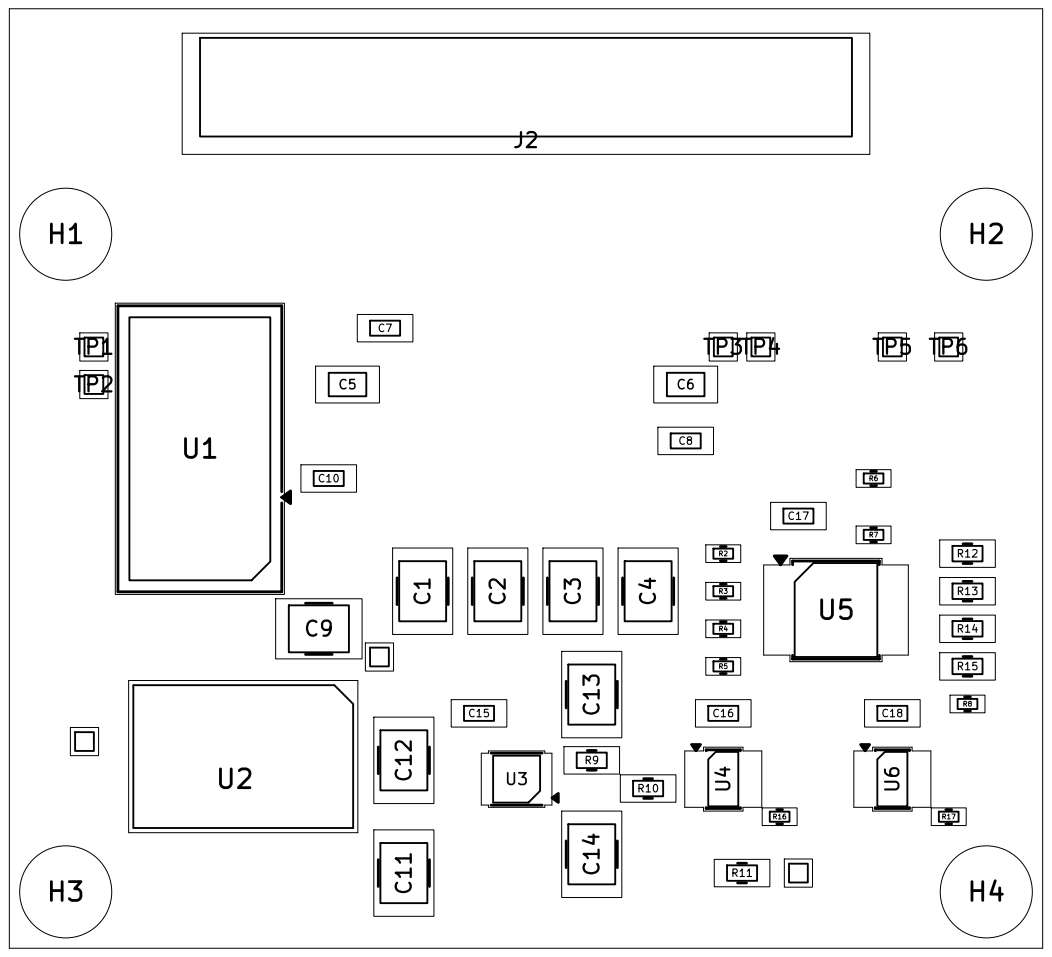
[picture p329: page 1]
