daleondev/ProtoMate_Control/hardware/display/manufacturing/giga-adapter-rev-F/assembly-B.pdf

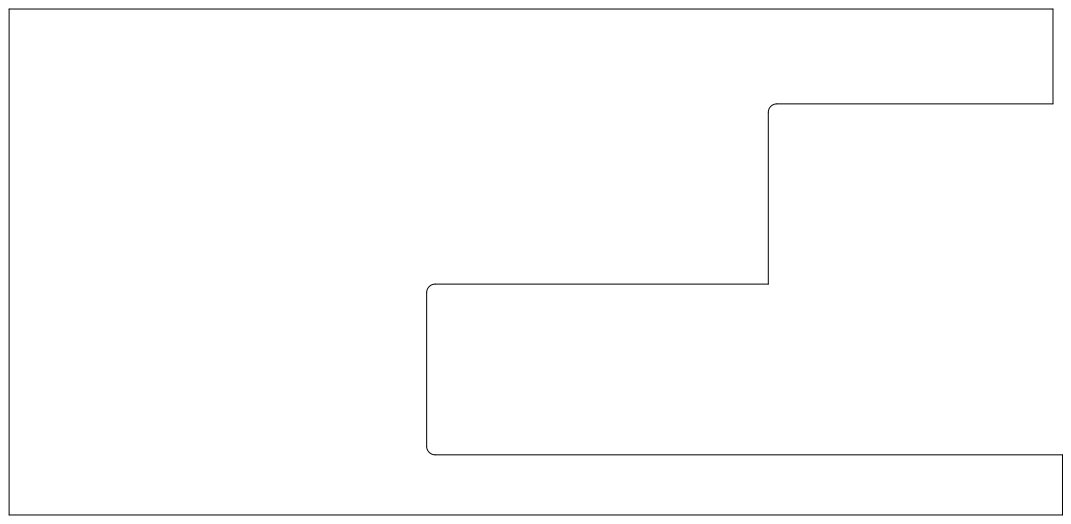
[picture p330: page 1]
