daleondev/ProtoMate_Control/hardware/display/manufacturing/giga-adapter-rev-F/assembly-F.pdf

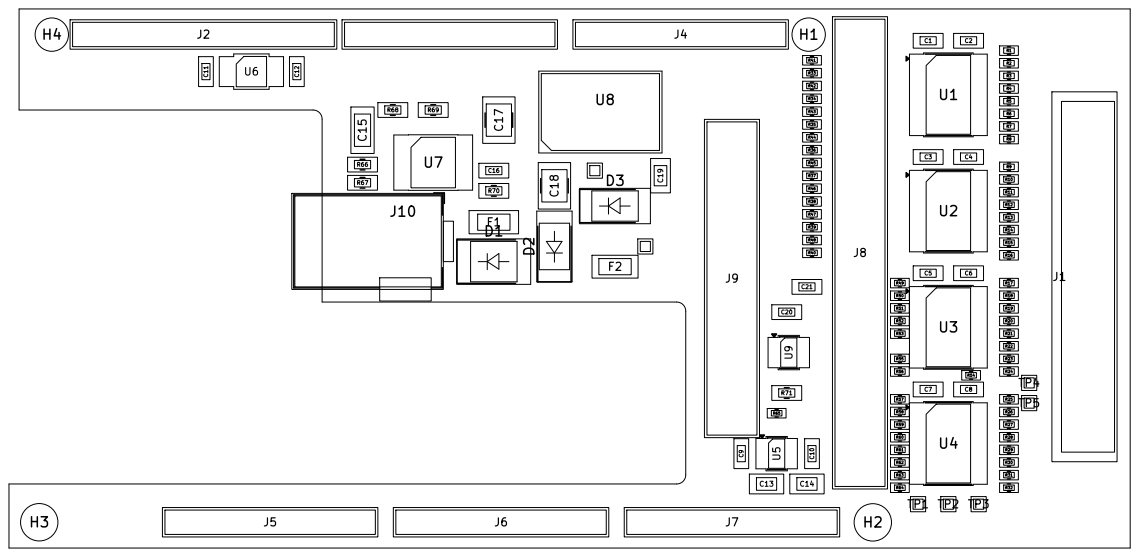
[picture p331: page 1]
