daleondev/ProtoMate_Control/docs/motor3/BJ42D15-26V10_drawing.pdf

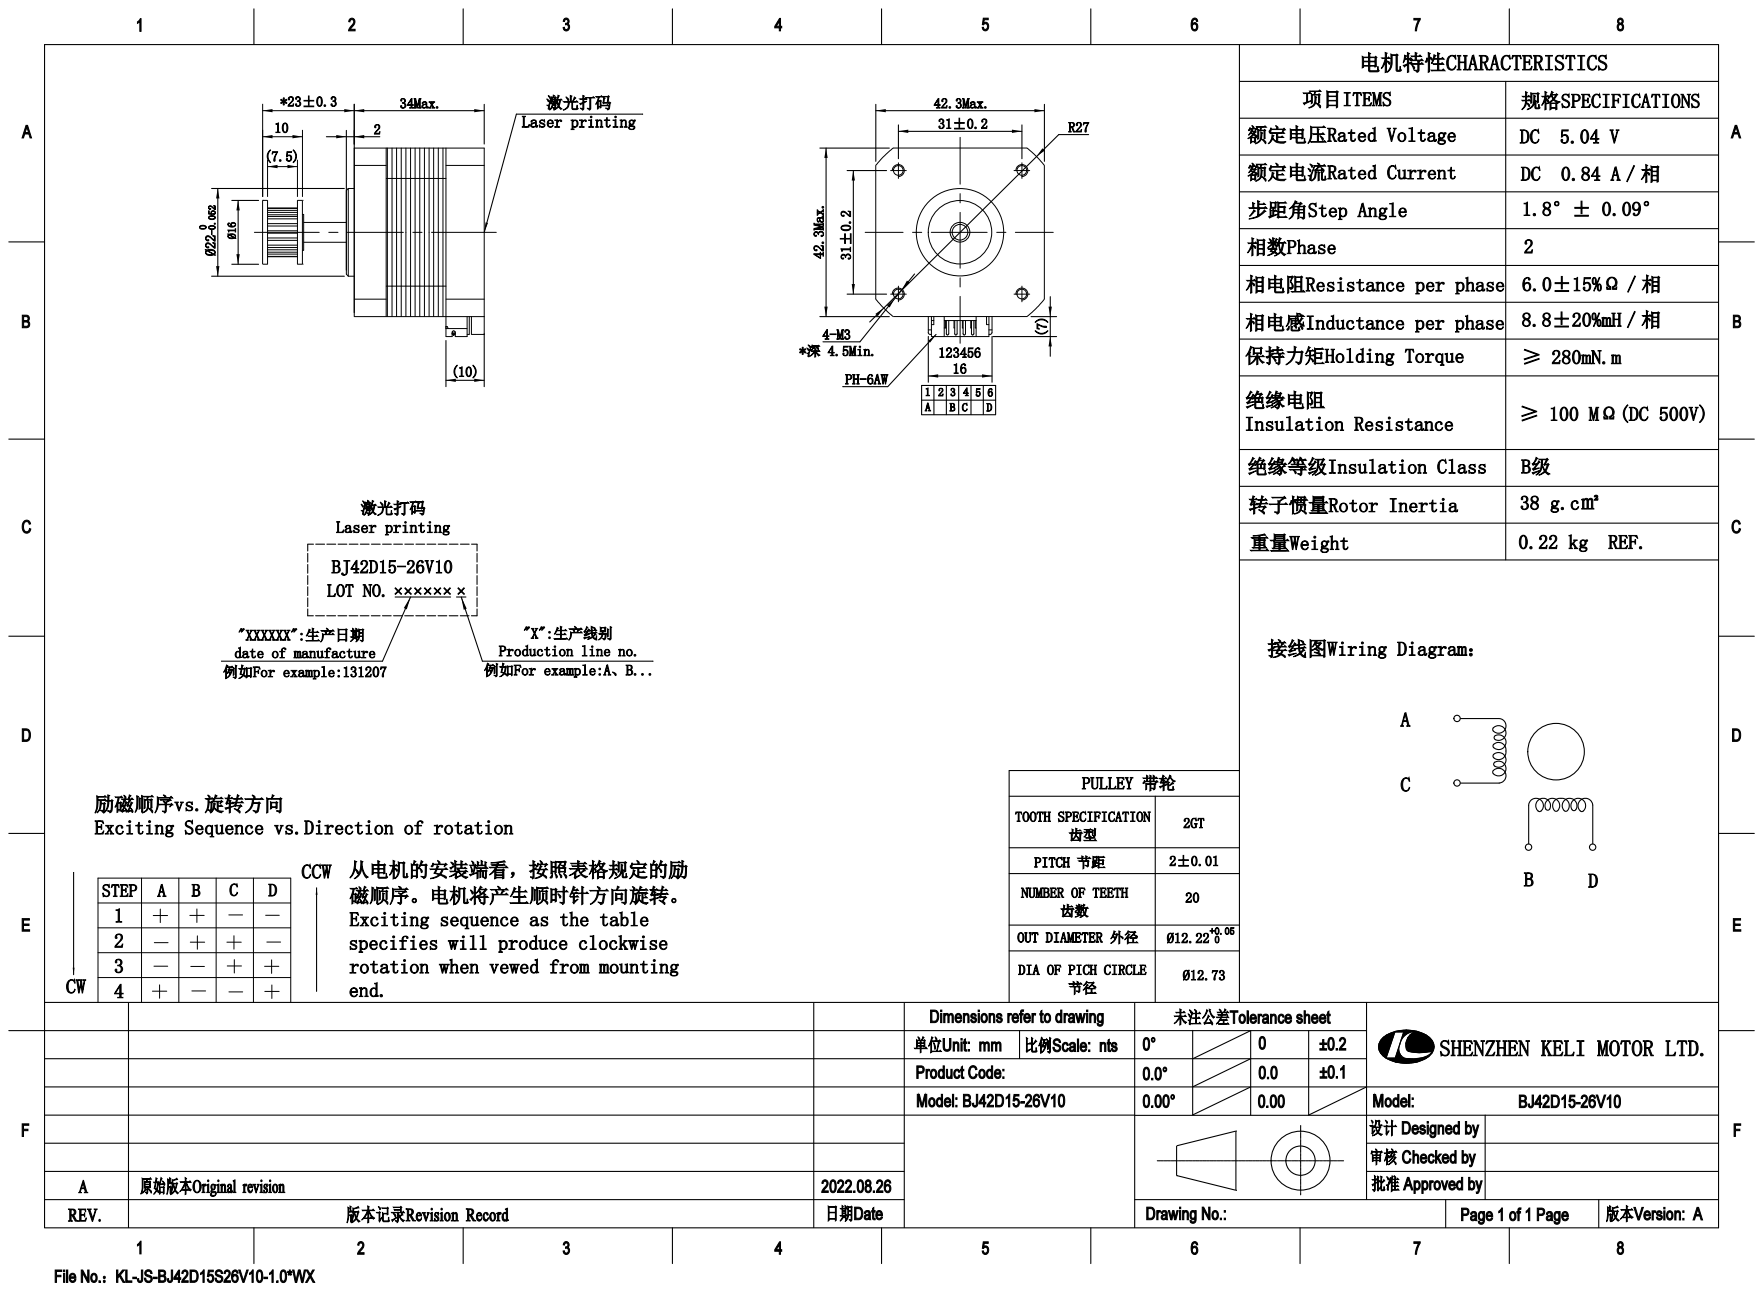
[picture p332: page 1]
