daleondev/ProtoMate_Control/hardware/display/manufacturing/display-adapter-rev-F/schematic.pdf

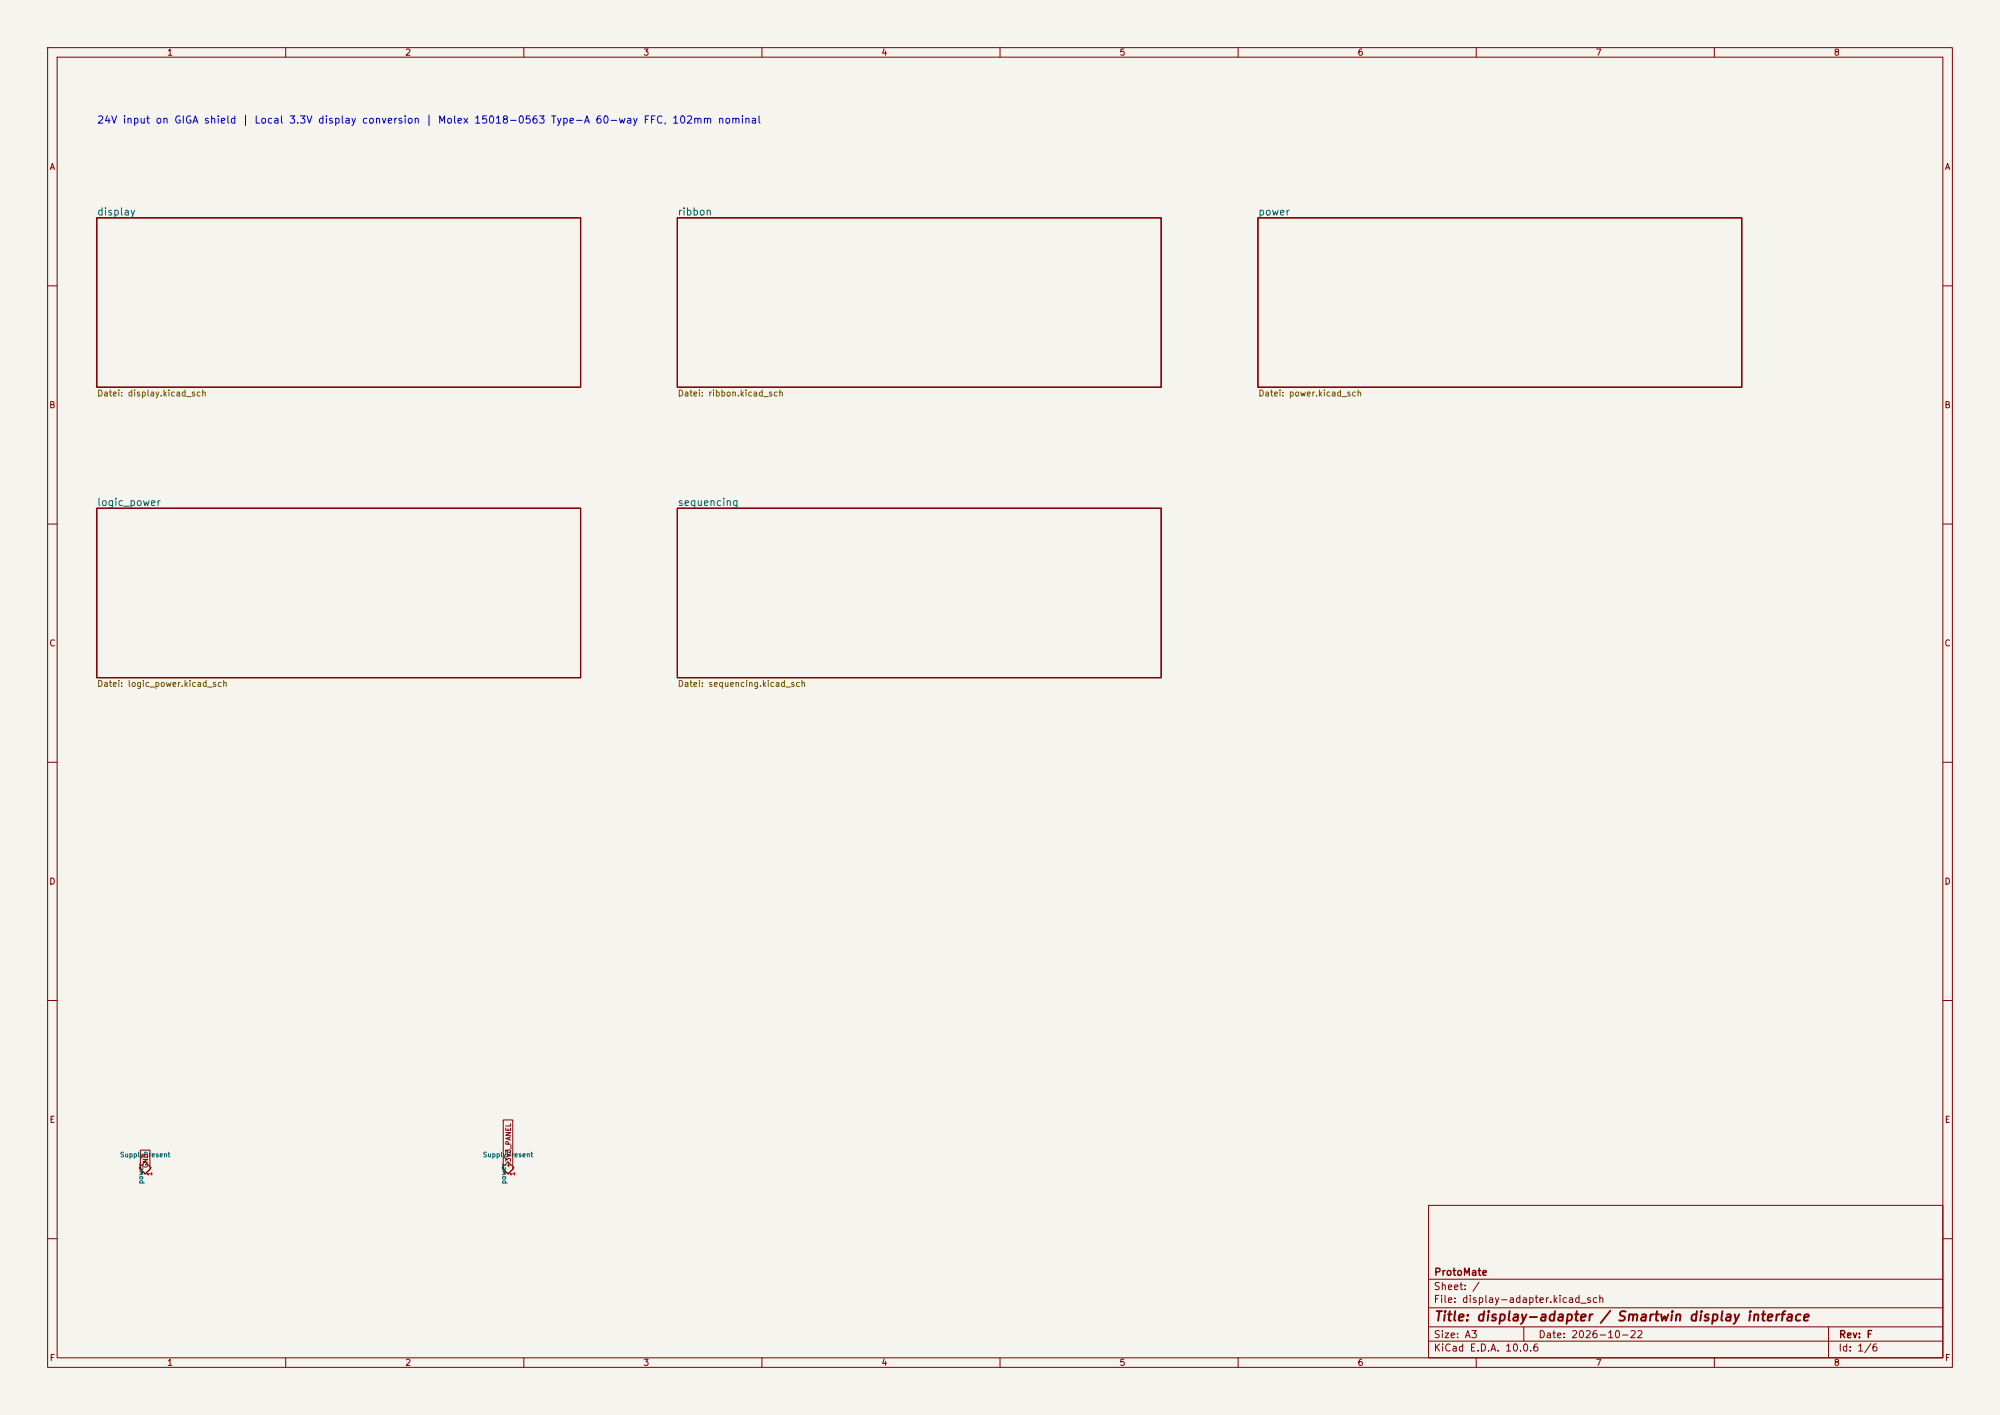
[picture p333: page 1]

24V input on GIGA shield | Local 3.3V display conversion | Molex 15018-0563 Type-A 60-way FFC, 102mm nominal

ProtoMate
Sheet: /
File: display-adapter.kicad_sch
Title: display-adapter / Smartwin display interface

Size: A3 | Rev: F | F Date: 2026-10-22
KiCad E.D.A. 10.0.6 | Id: 1/6

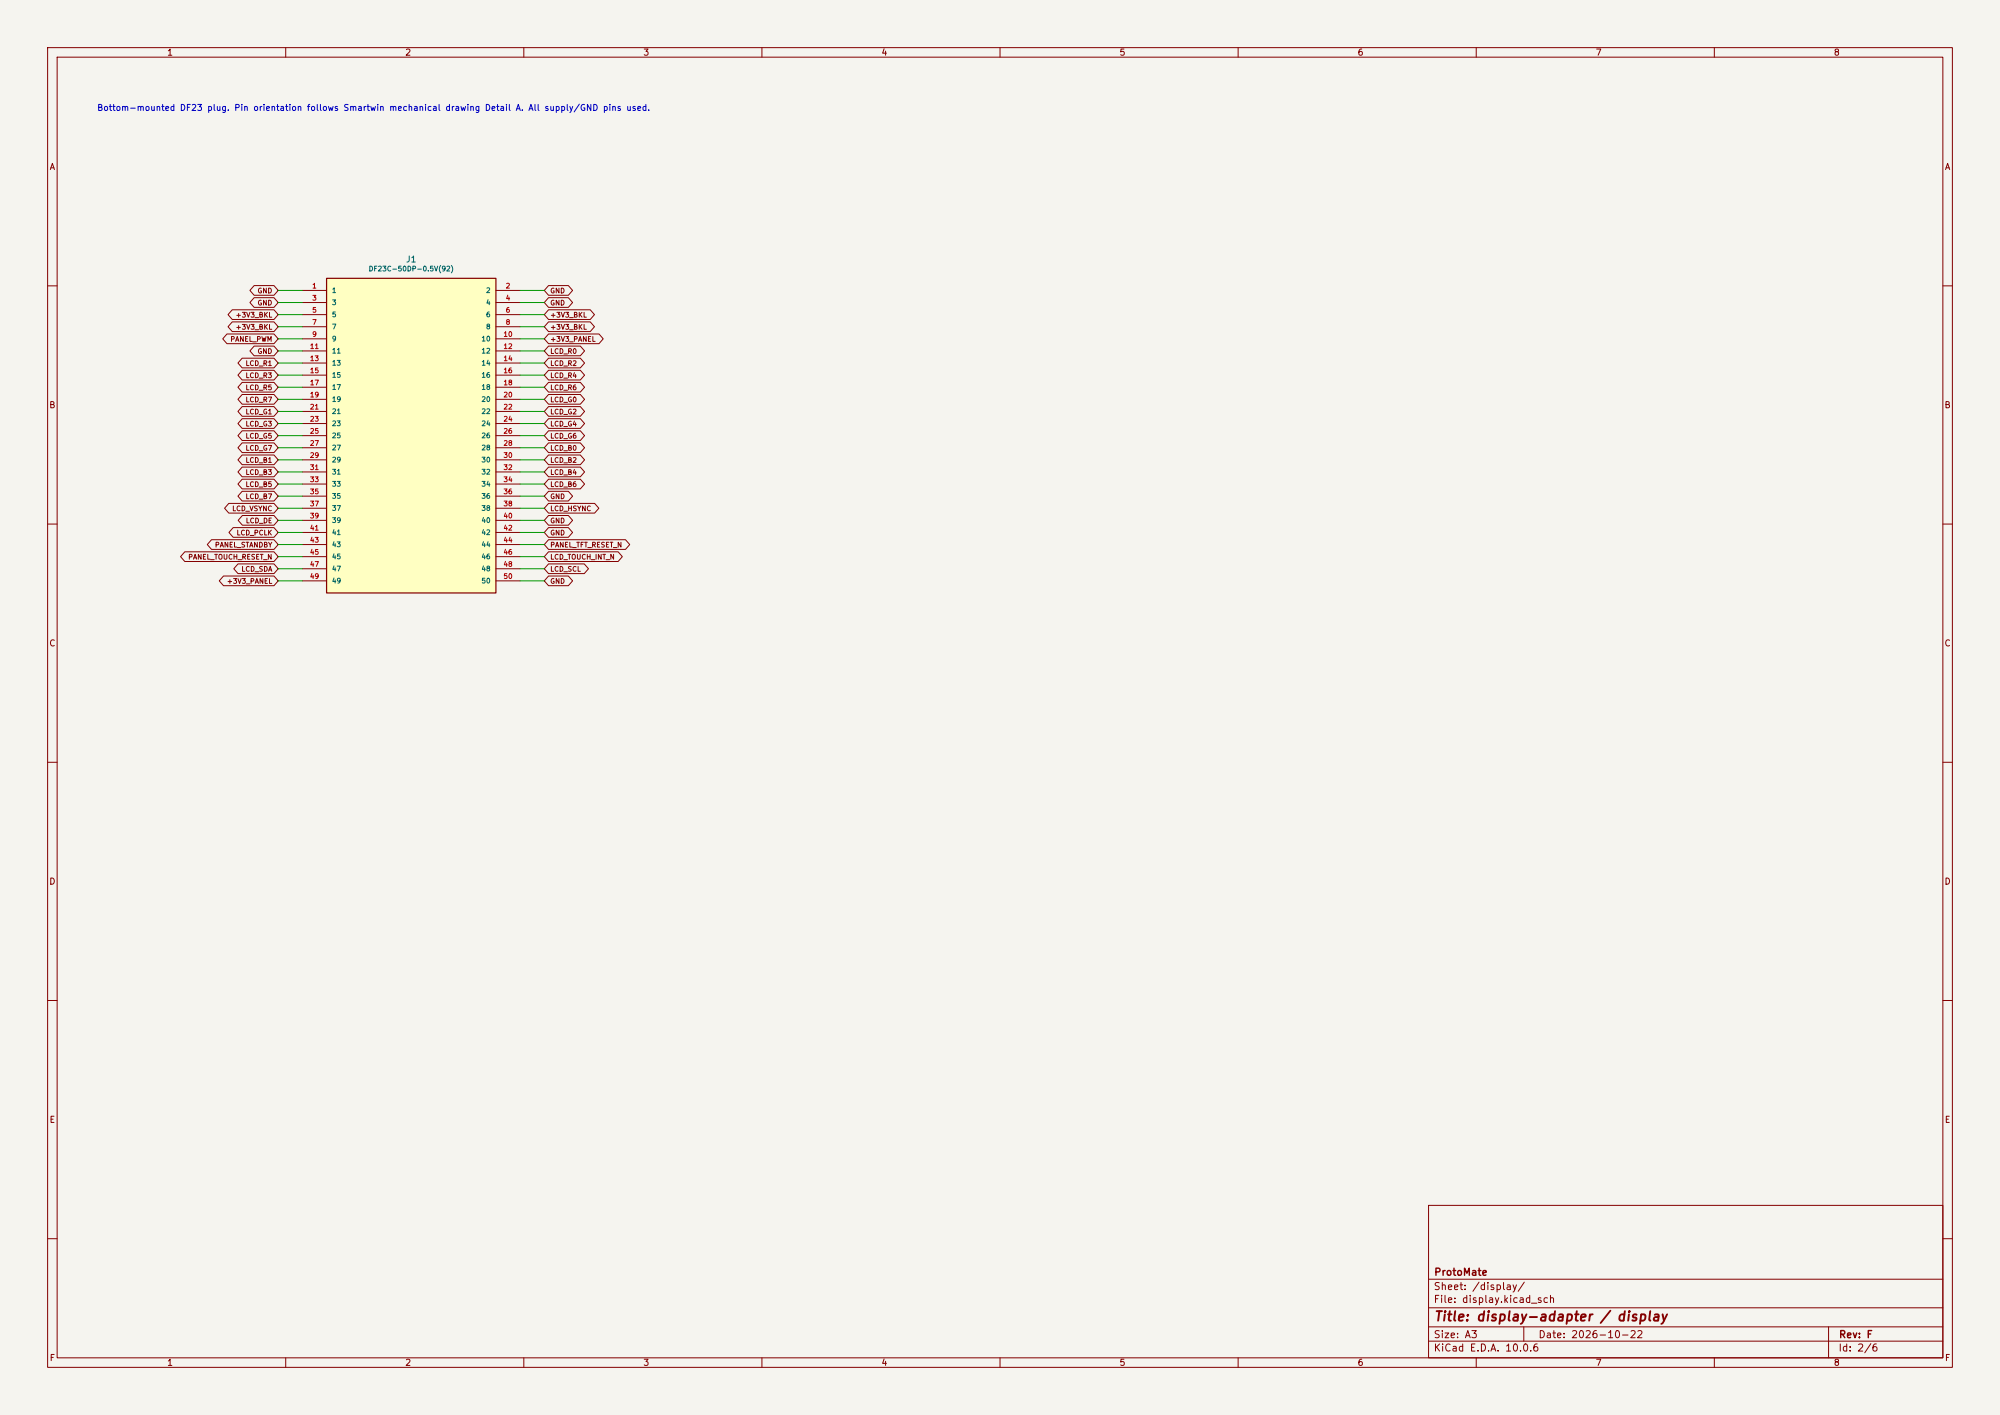
[picture p334: page 2]

LCD_R0 Bottom-mounted DF23 plug. Pin orientation follows Smartwin mechanical drawing Detail A. All supply/GND pins used.

ProtoMate
Sheet: /display/
File: display.kicad_sch
Title: display-adapter / display

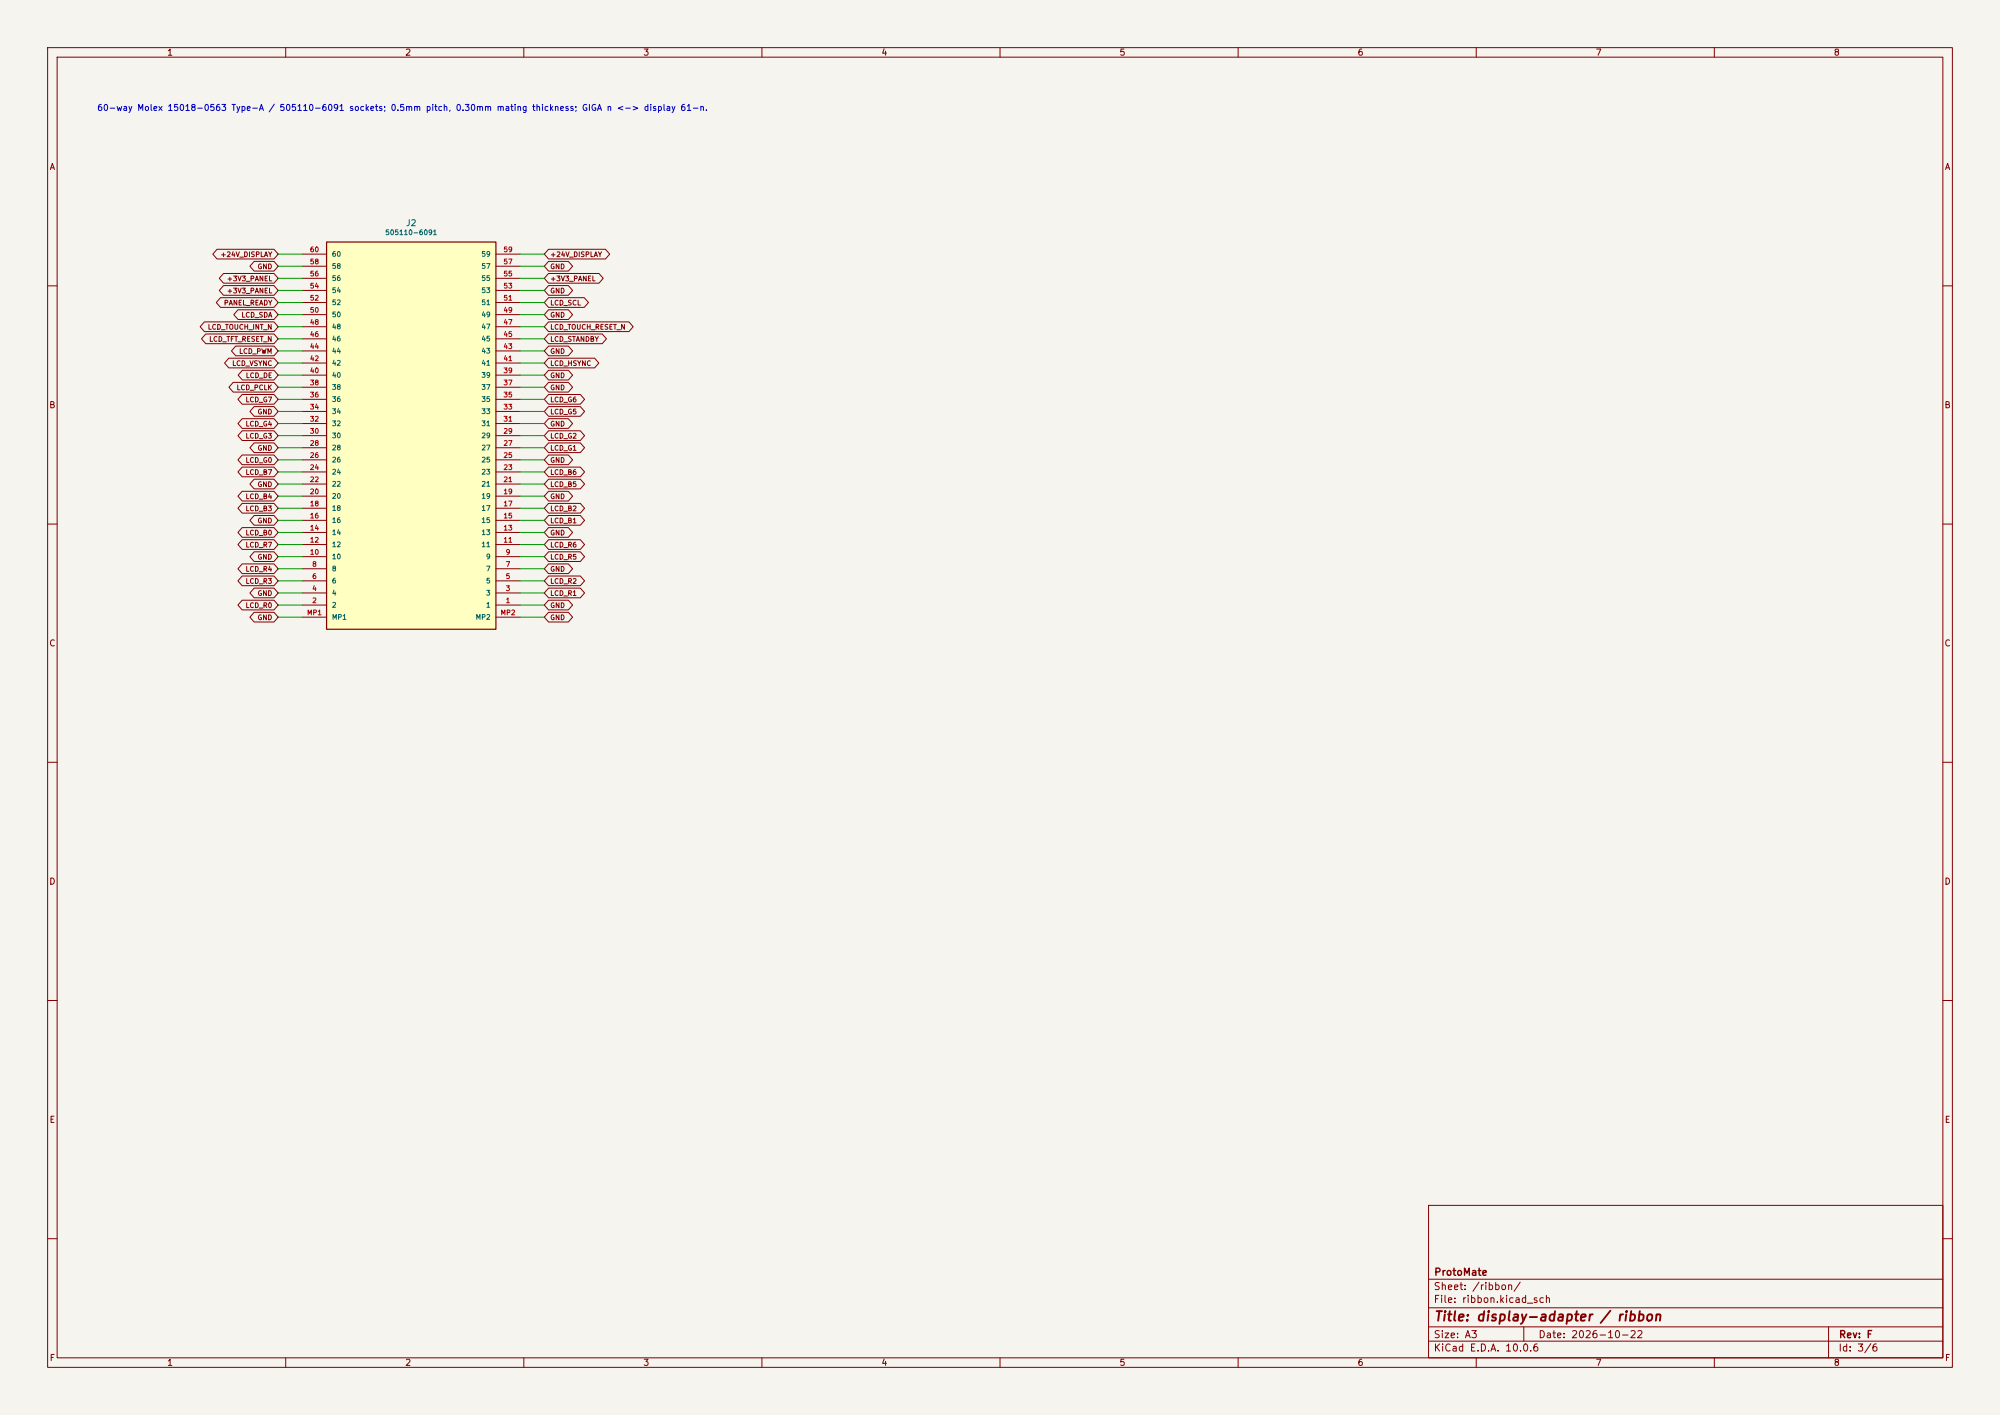
[picture p335: page 3]

60-way Molex 15018-0563 Type-A / 505110-6091 sockets; 0.5mm pitch, 0.30mm mating thickness; GIGA n <-> display 61-n.

ProtoMate
Sheet: /ribbon/
File: ribbon.kicad_sch
Title: display-adapter / ribbon

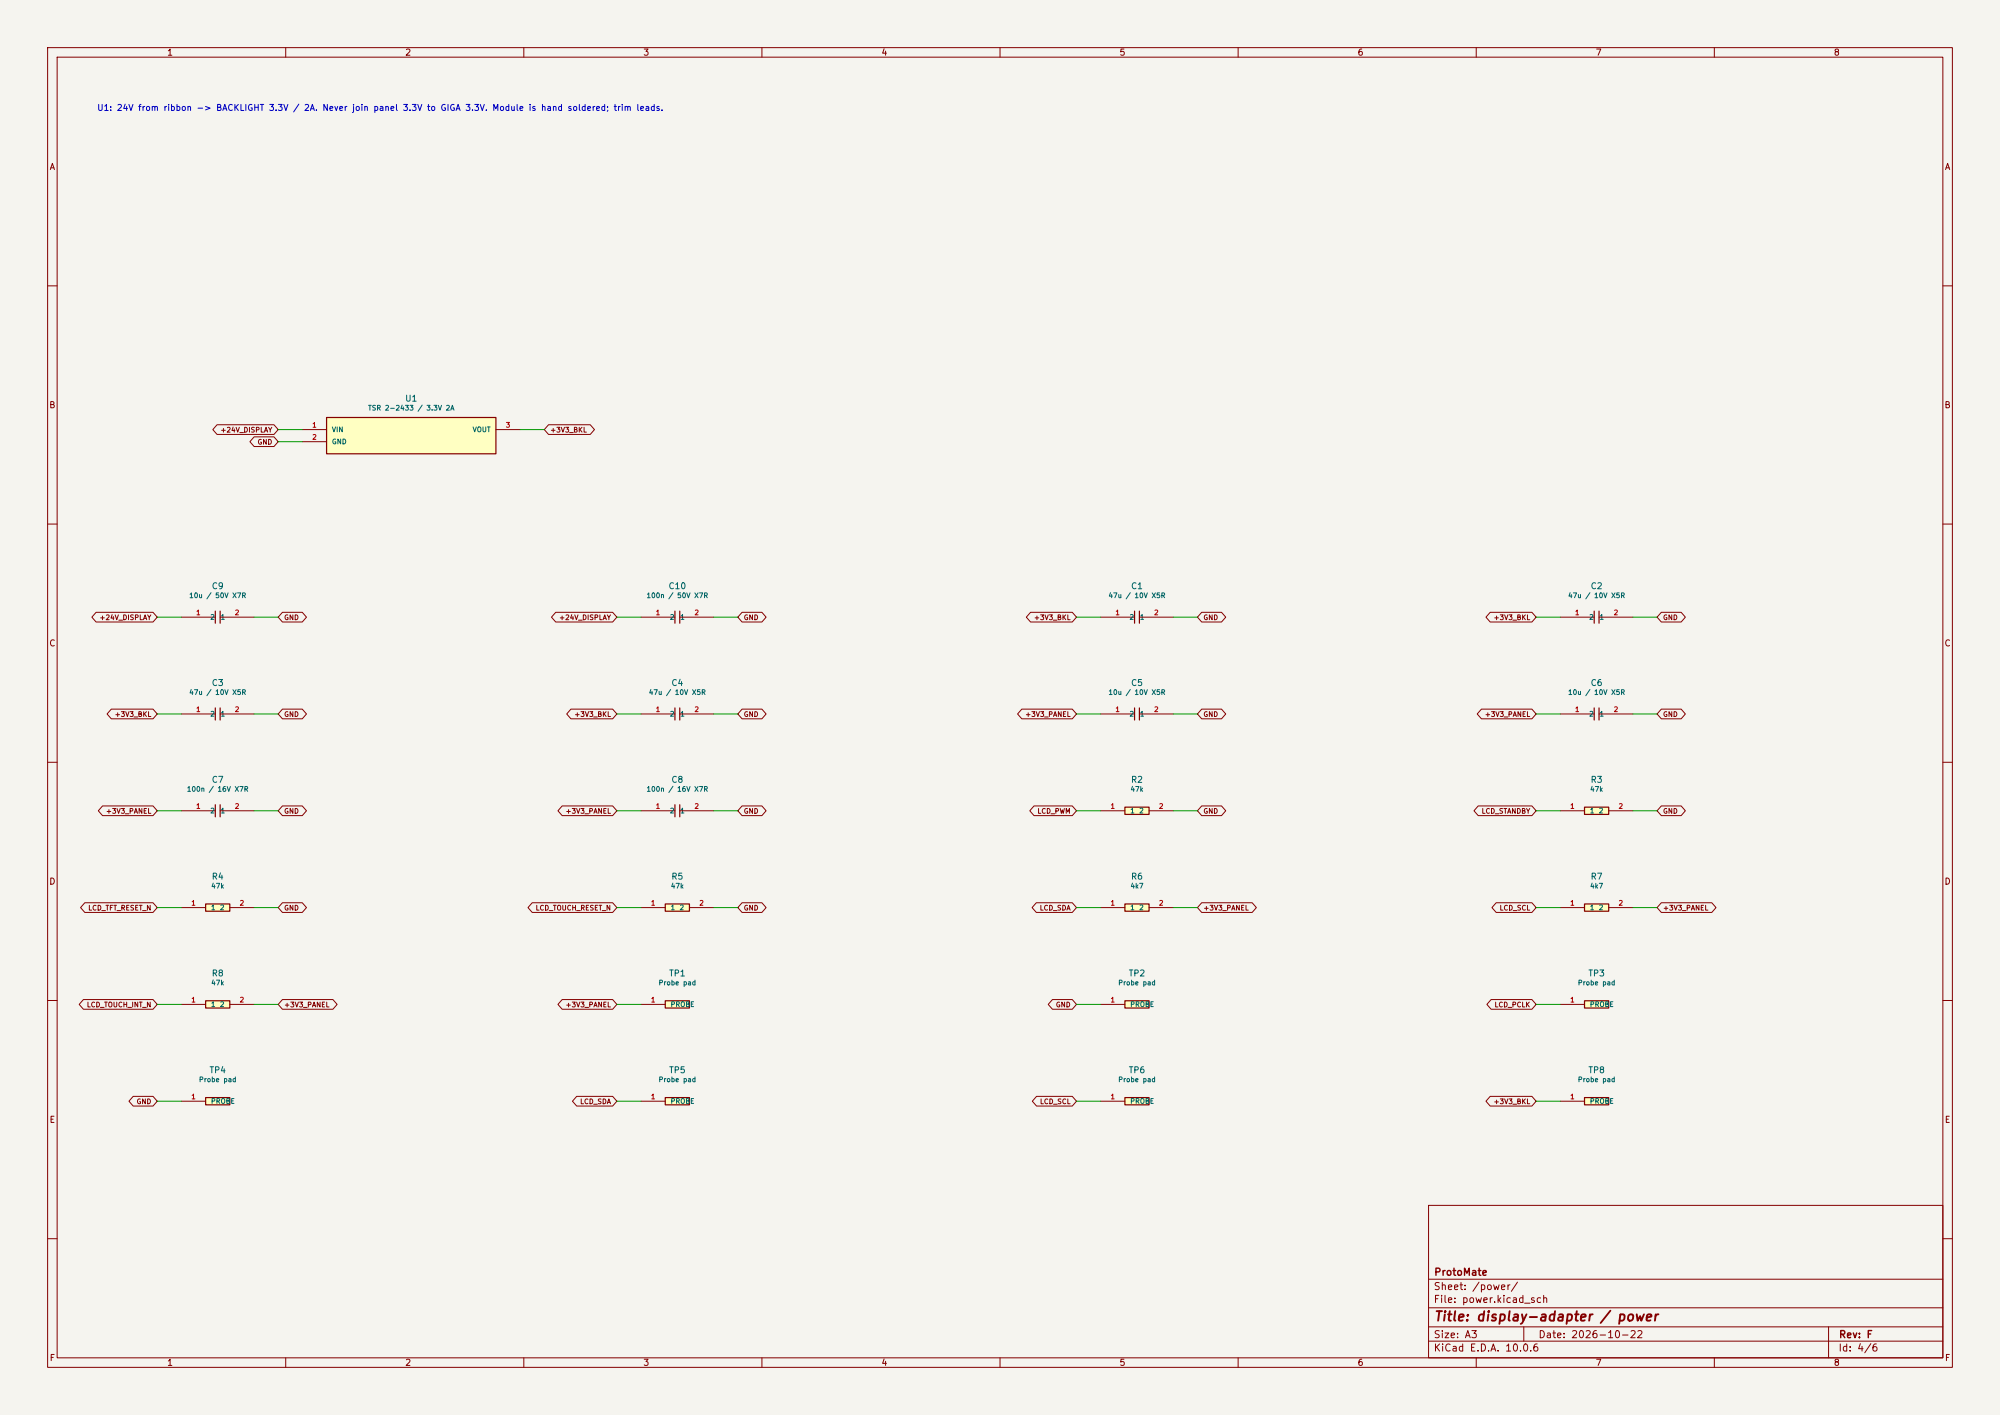
[picture p336: page 4]

U1: 24V from ribbon -> BACKLIGHT 3.3V / 2A. Never join panel 3.3V to GIGA 3.3V. Module is hand soldered; trim leads.

ProtoMate
Sheet: /power/
File: power.kicad_sch
Title: display-adapter / power

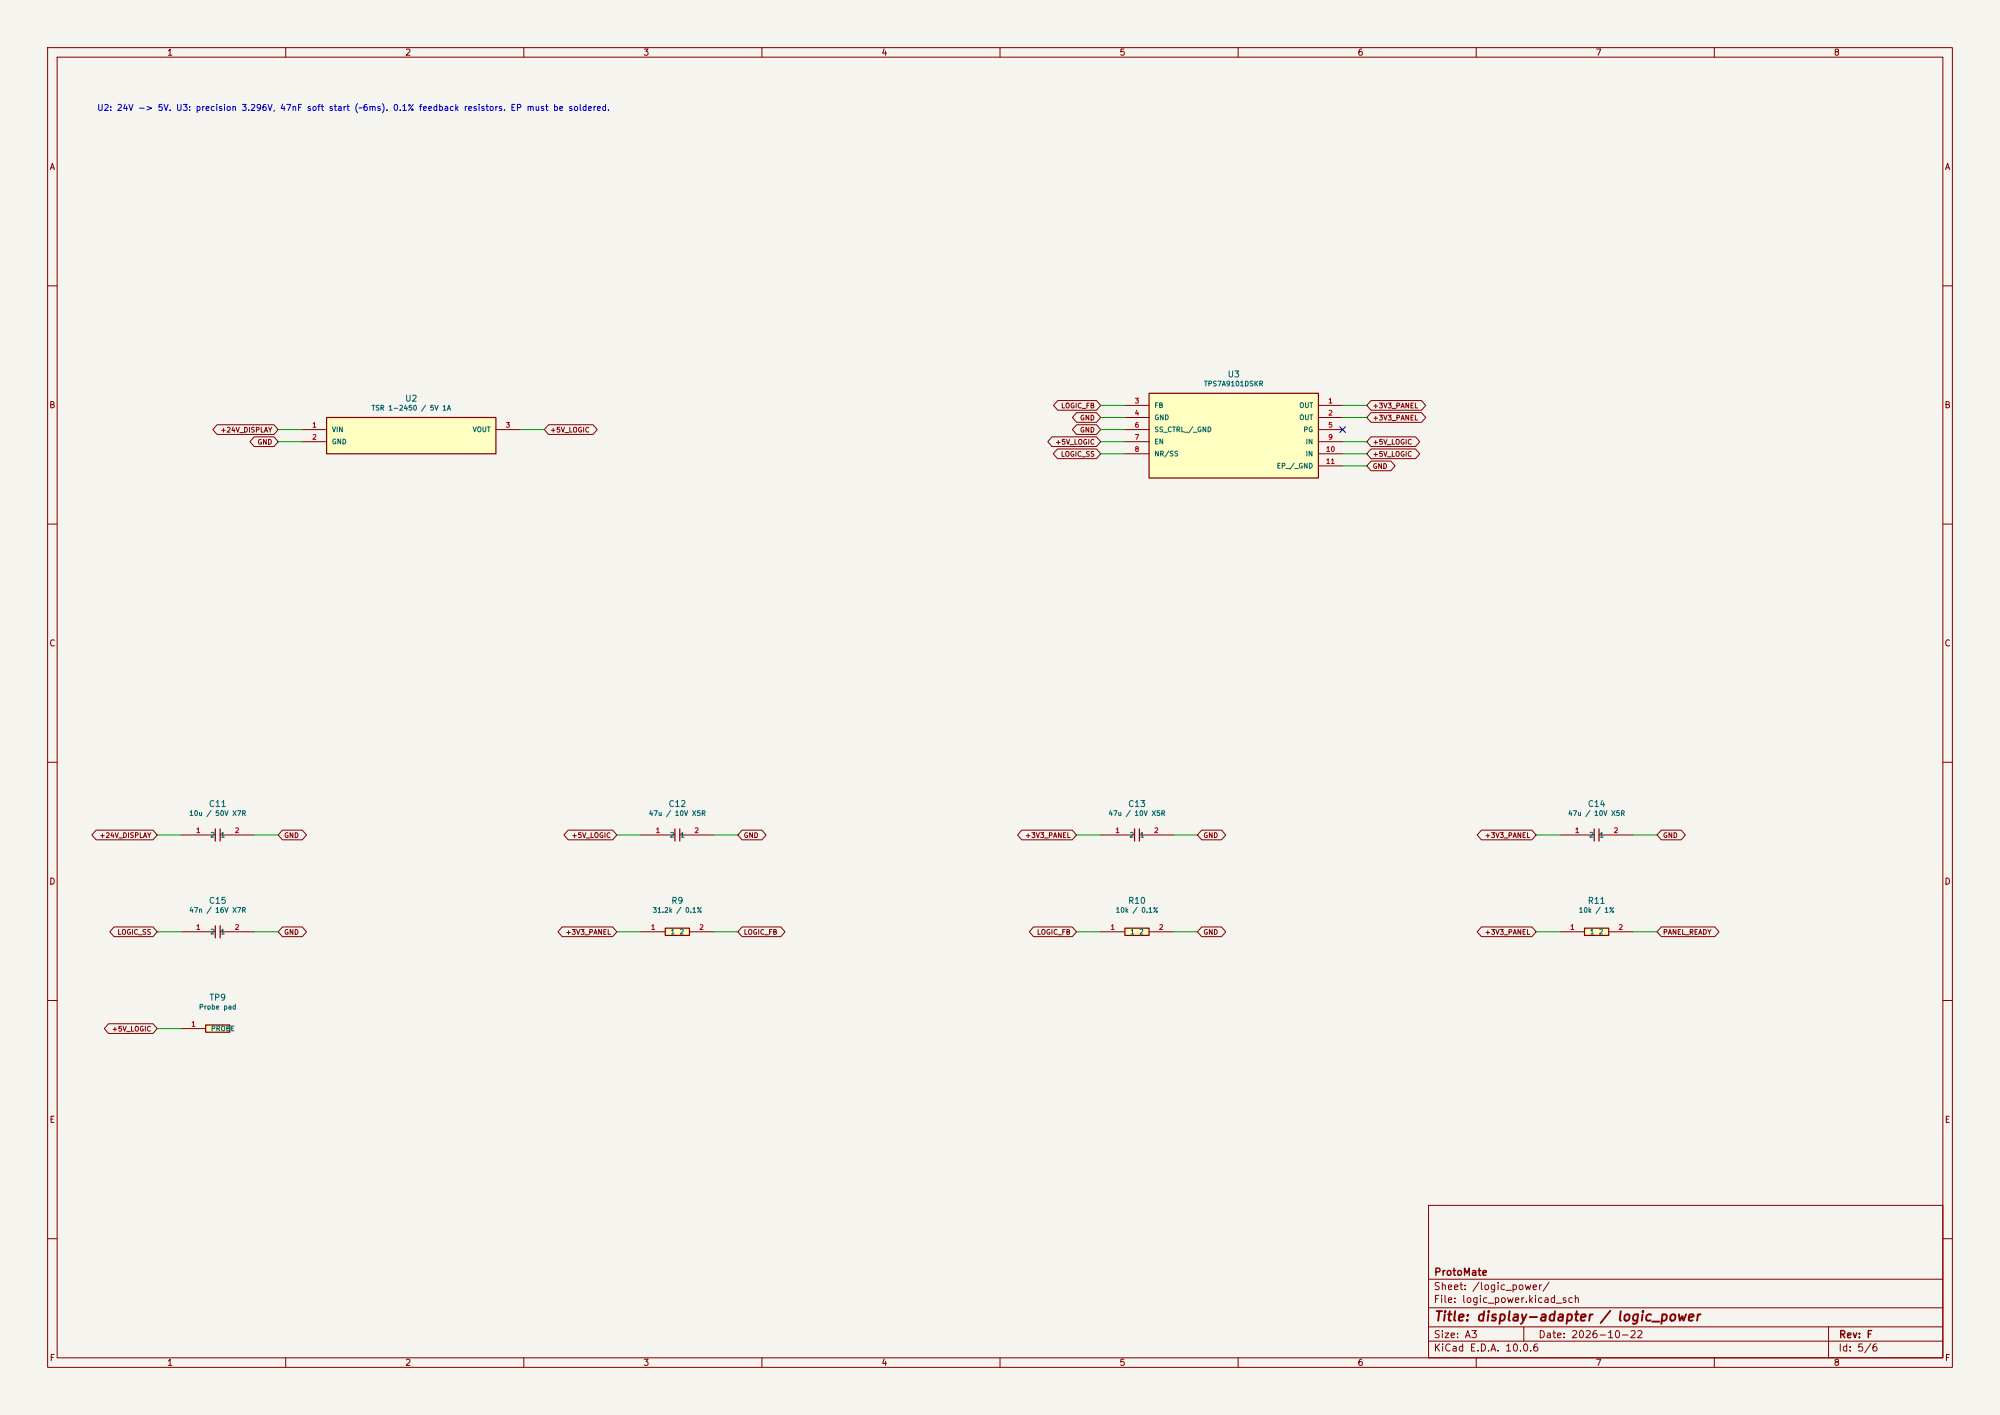
[picture p337: page 5]

U2: 24V -> 5V. U3: precision 3.296V, 47nF soft start (~6ms). 0.1% feedback resistors. EP must be soldered.

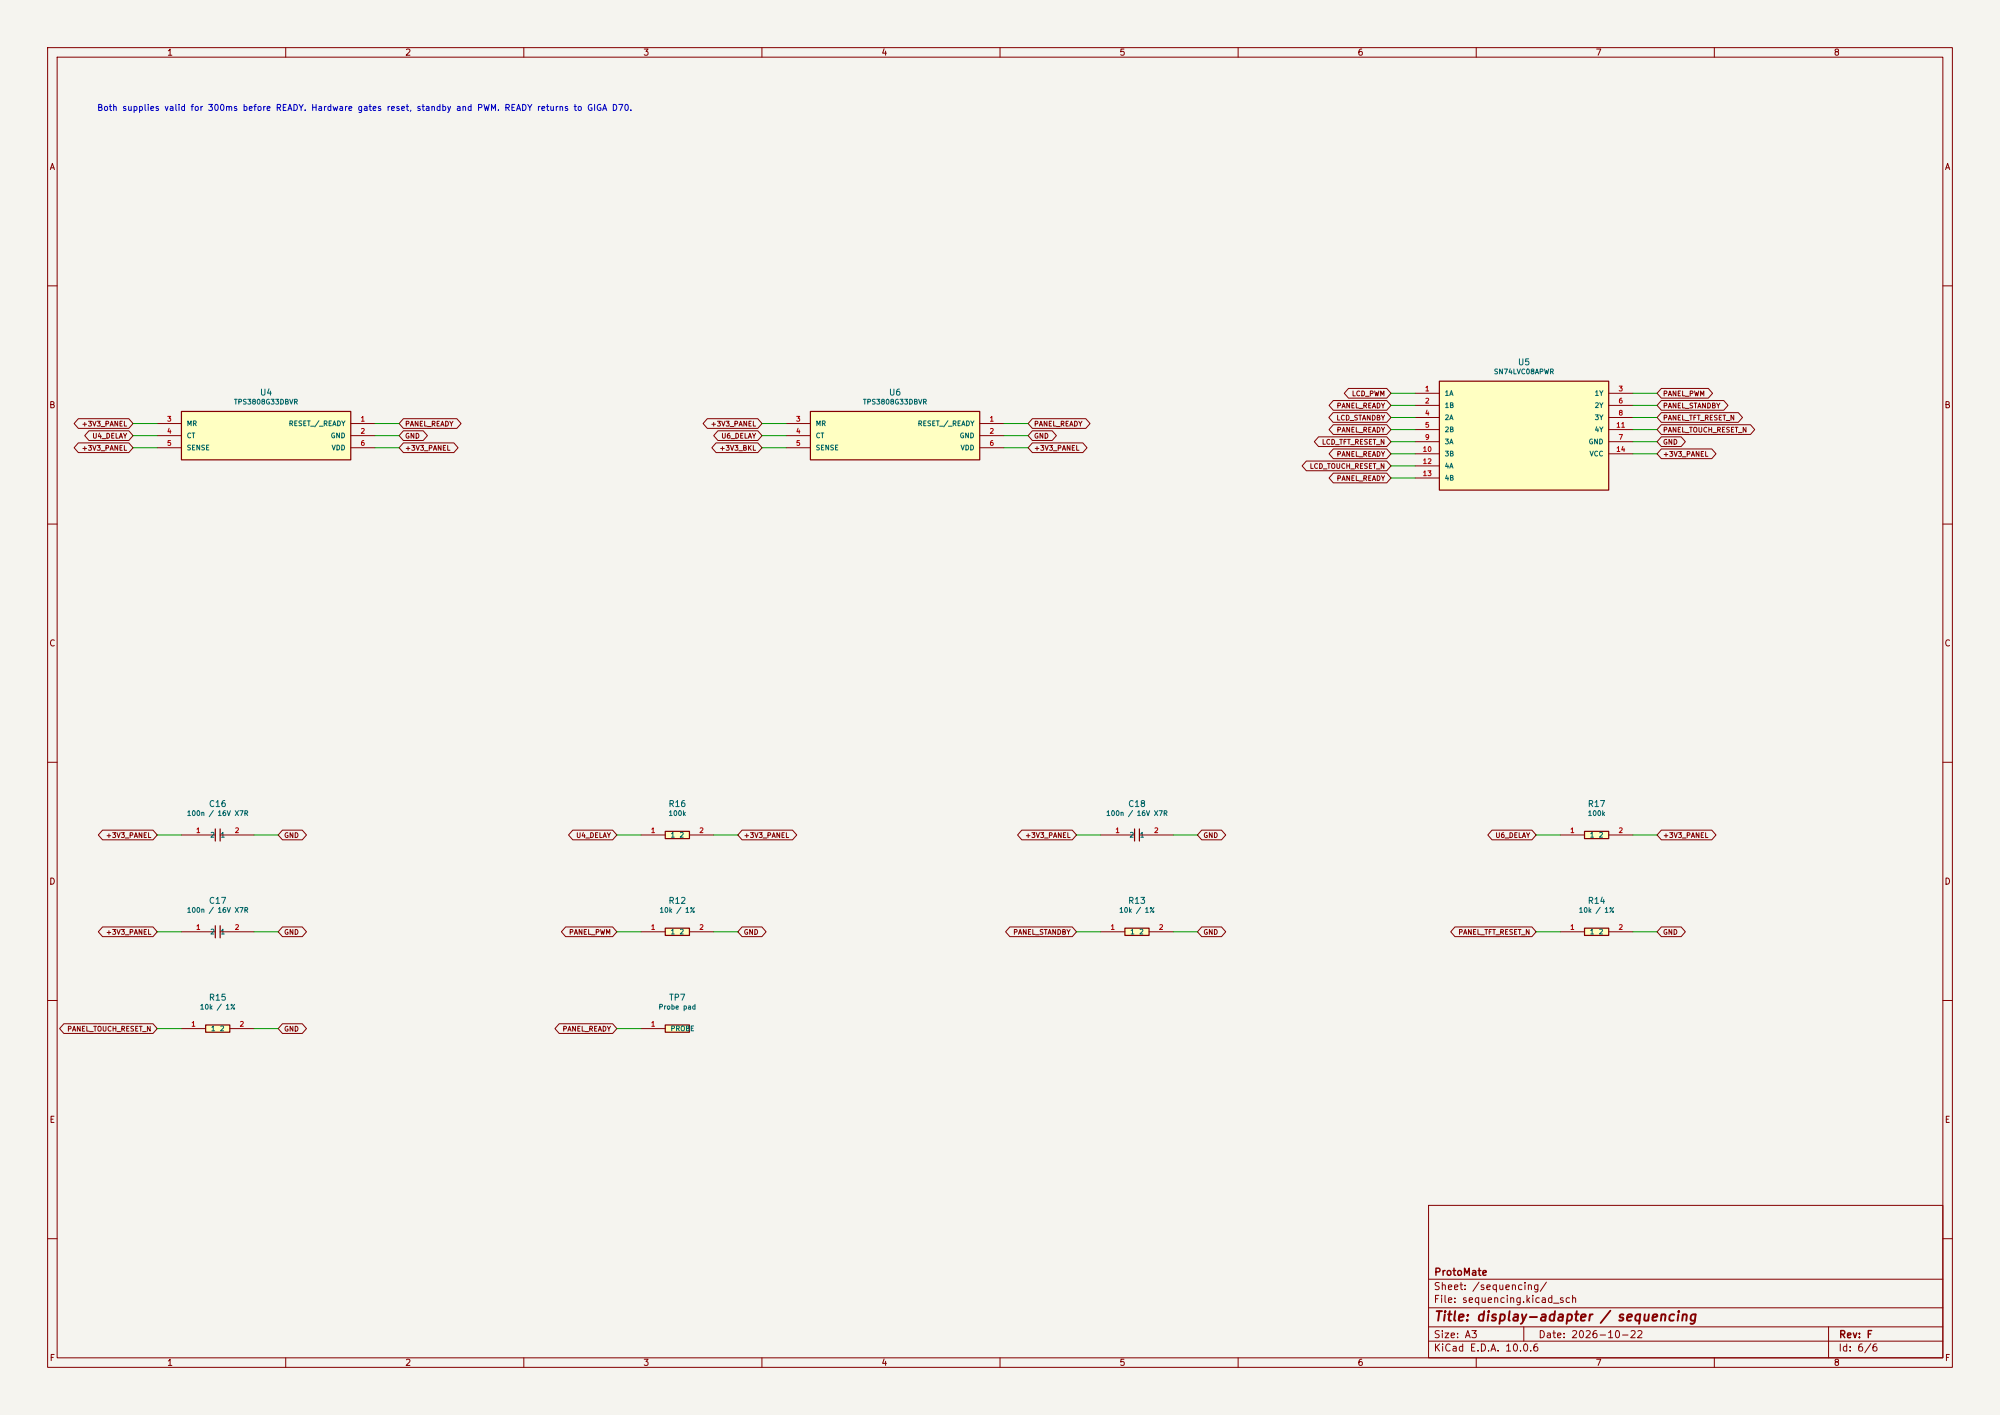
[picture p338: page 6]

Both supplies valid for 300ms before READY. Hardware gates reset, standby and PWM. READY returns to GIGA D70.

ProtoMate
Sheet: /sequencing/
File: sequencing.kicad_sch
Title: display-adapter / sequencing
