daleondev/ProtoMate_Control/hardware/display/manufacturing/display-adapter-rev-E/schematic.pdf

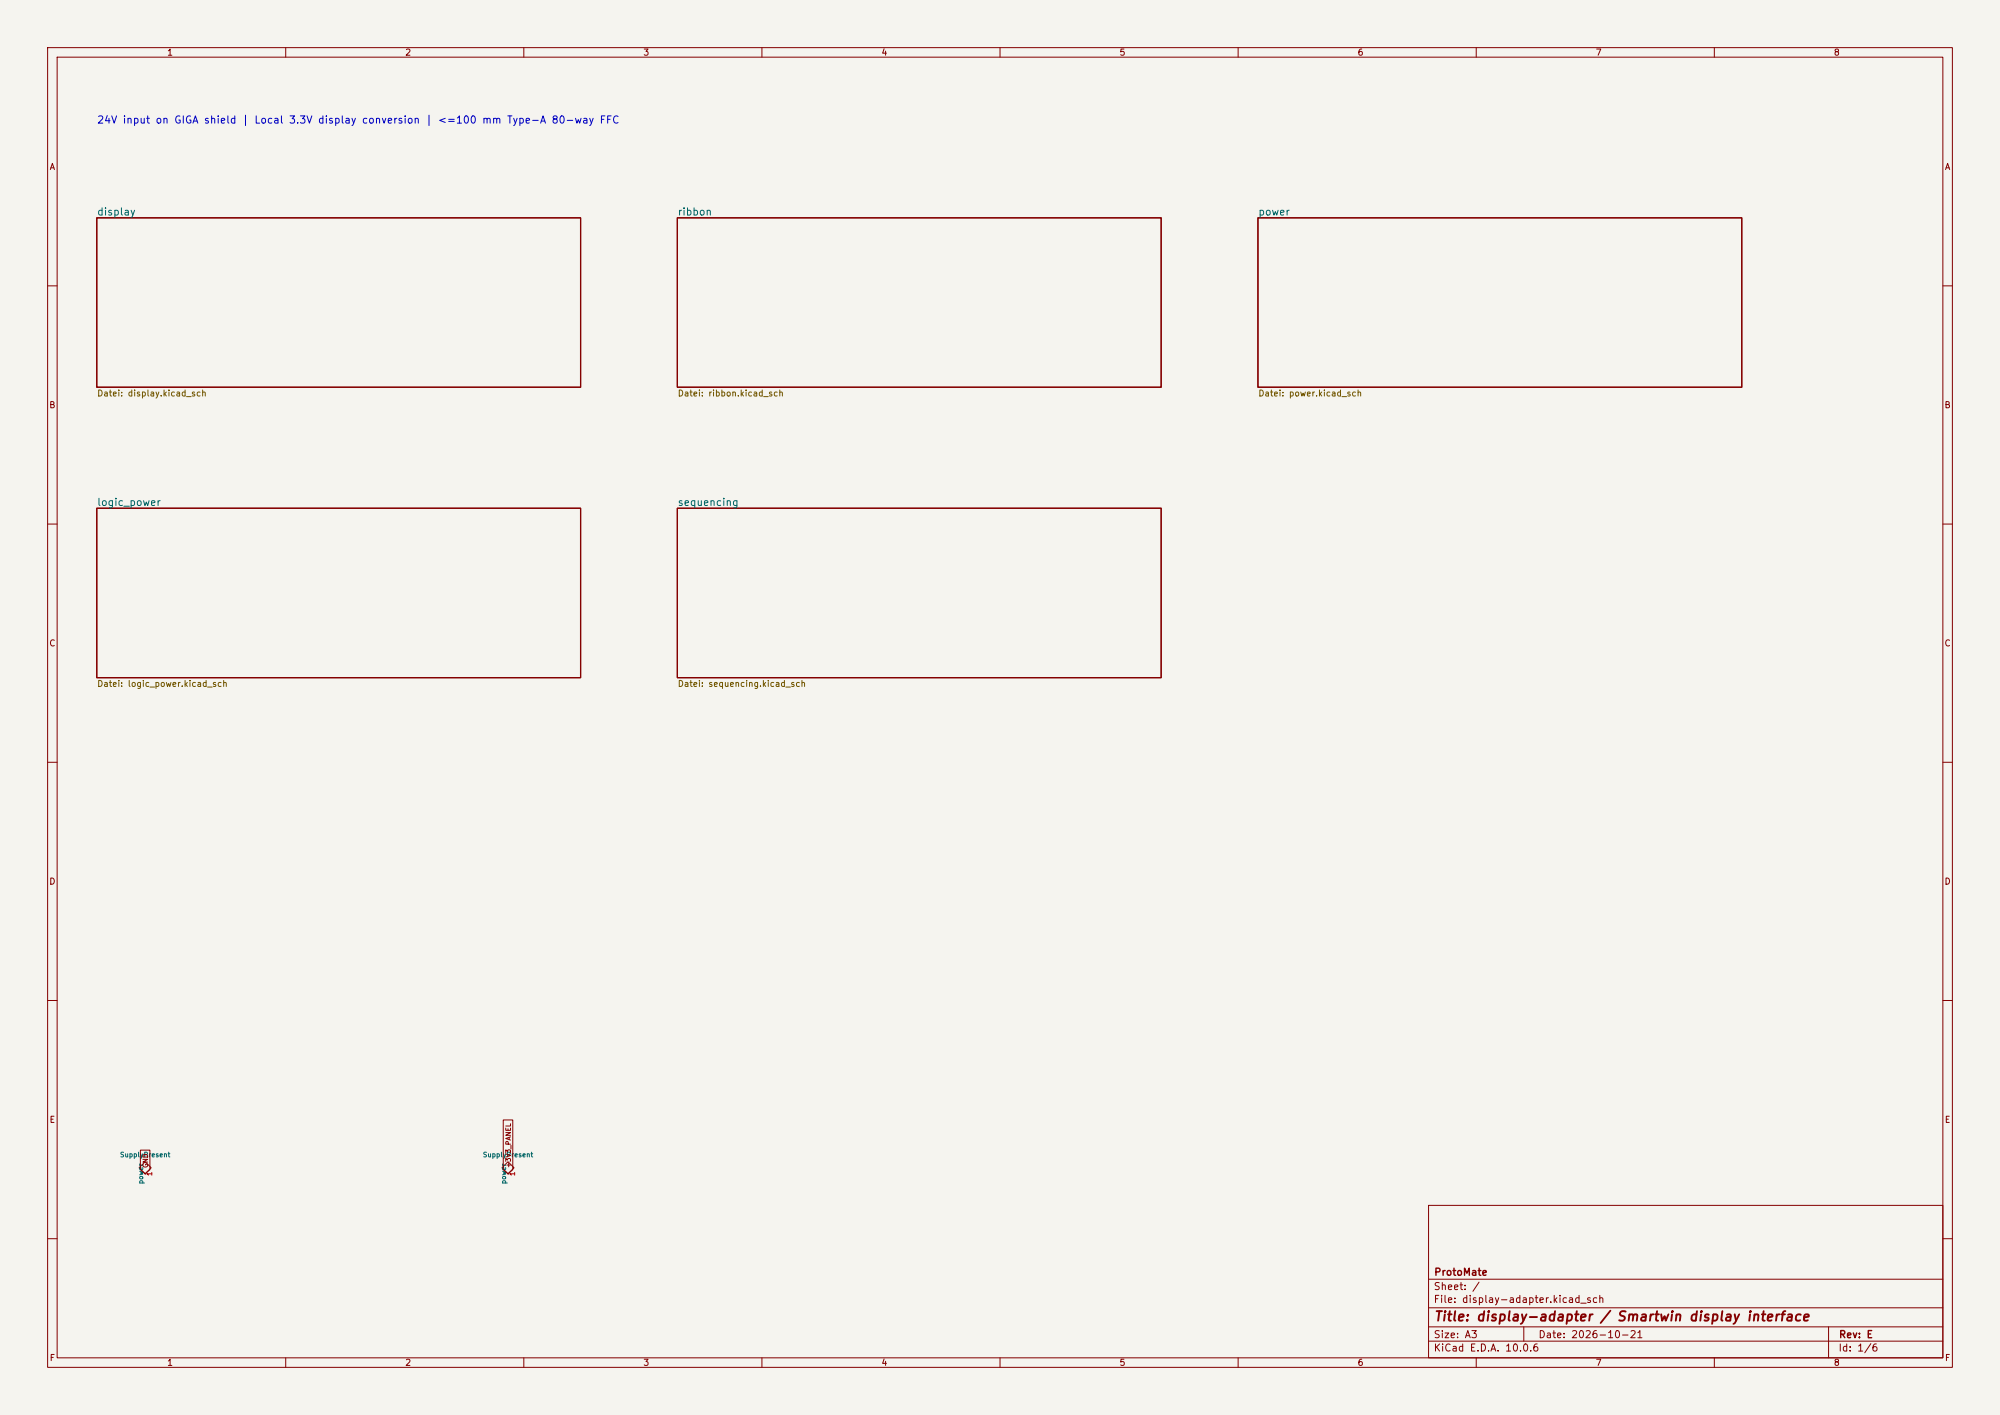
[picture p349: page 1]

24V input on GIGA shield | Local 3.3V display conversion | <=100 mm Type-A 80-way FFC

ProtoMate
Sheet: /
File: display-adapter.kicad_sch
Title: display-adapter / Smartwin display interface

Size: A3 | Rev: E | F Date: 2026-10-21
KiCad E.D.A. 10.0.6 | Id: 1/6

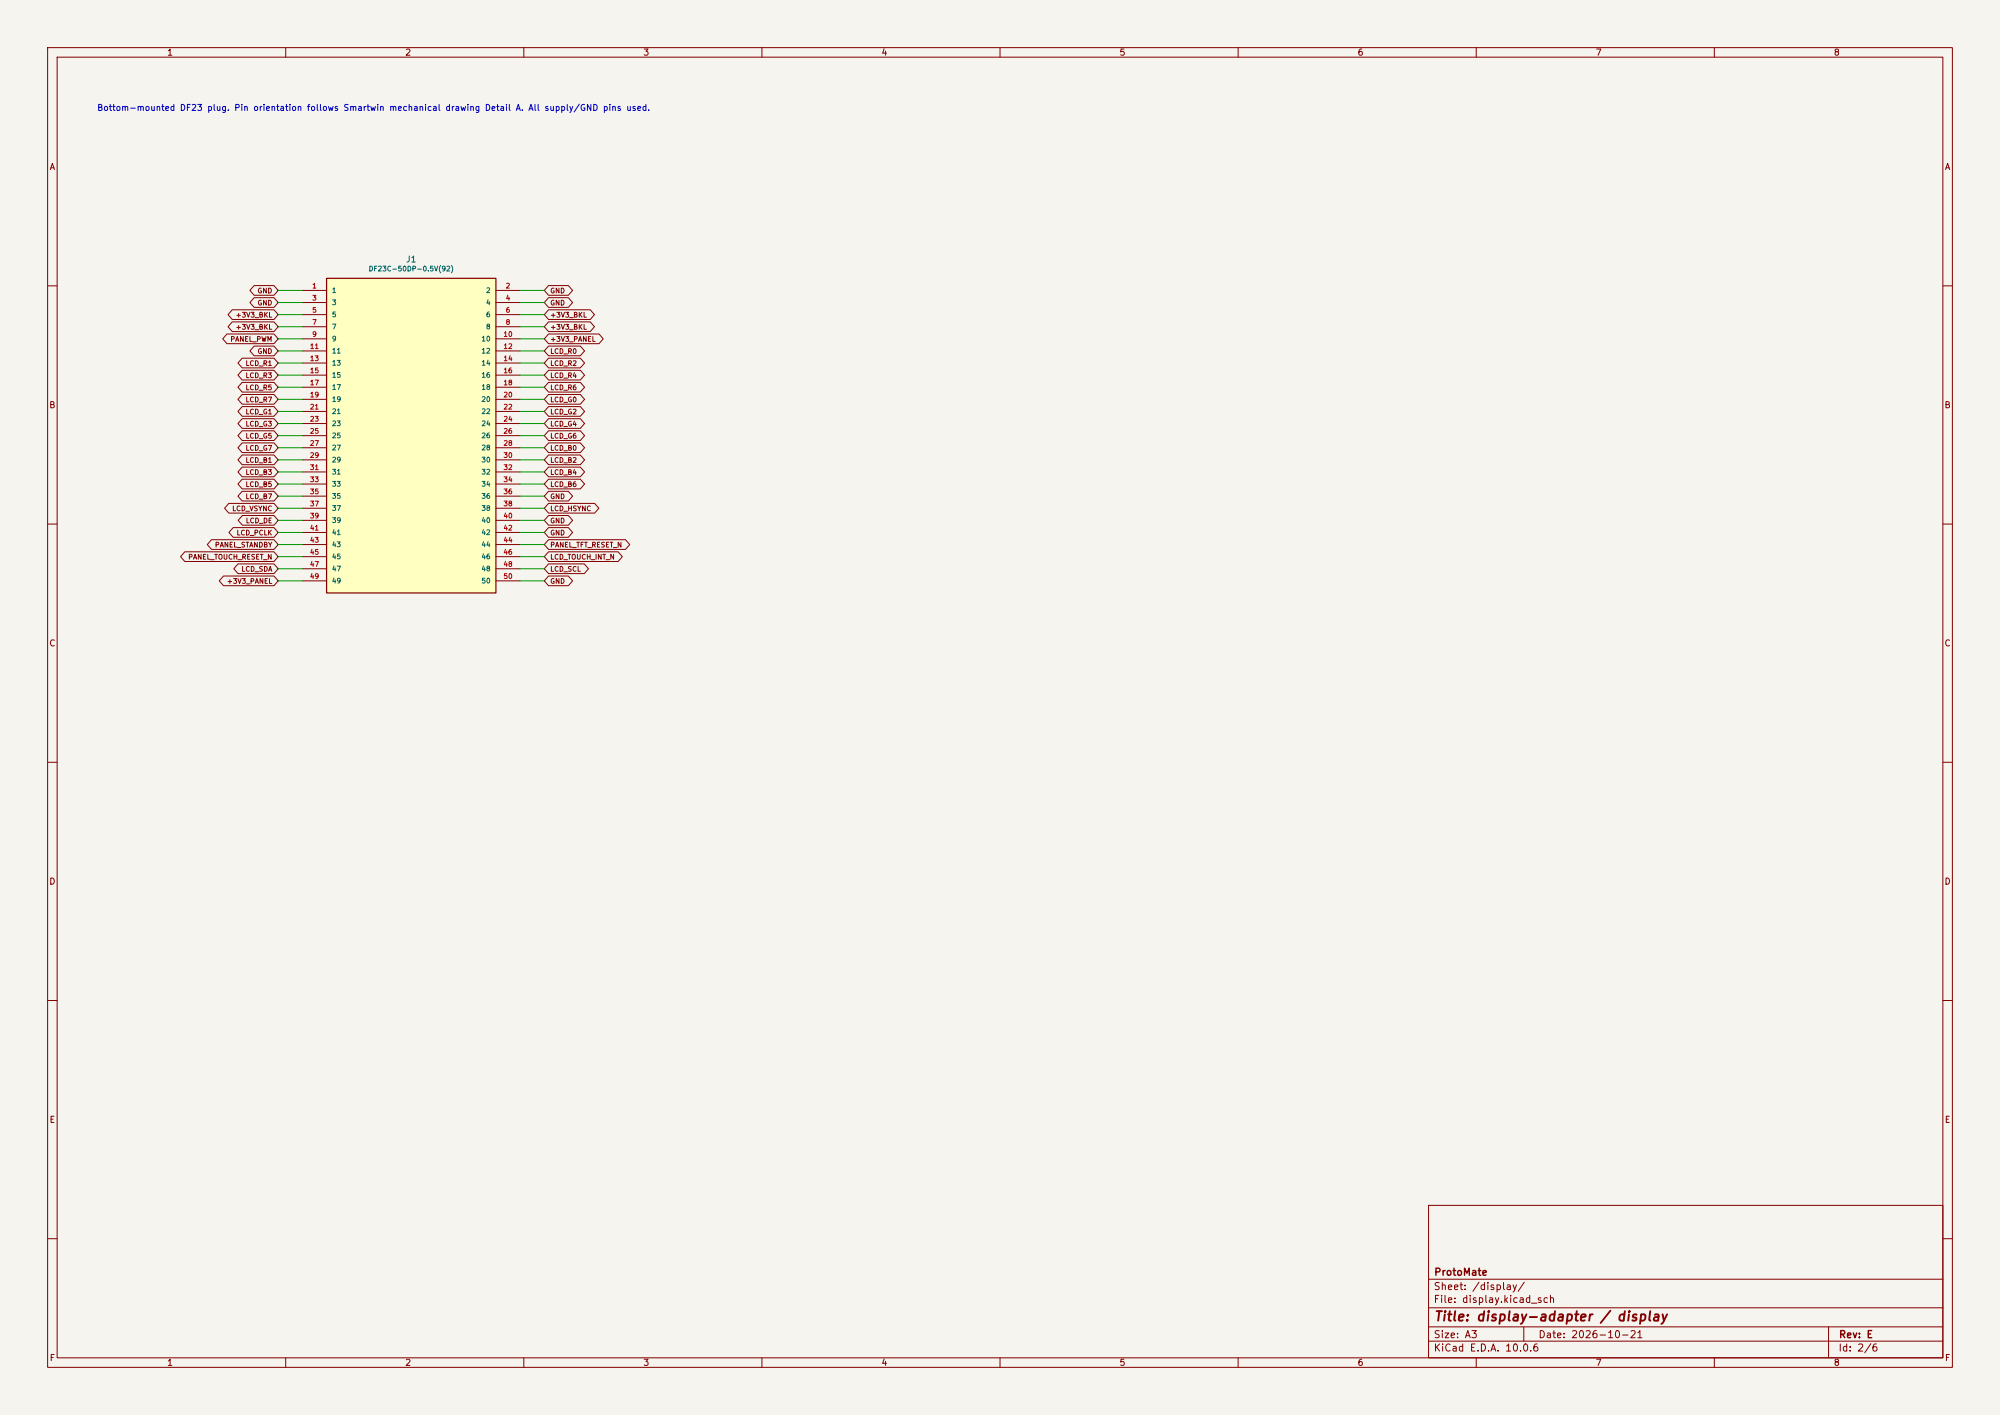
[picture p350: page 2]

LCD_R0 Bottom-mounted DF23 plug. Pin orientation follows Smartwin mechanical drawing Detail A. All supply/GND pins used.

ProtoMate
Sheet: /display/
File: display.kicad_sch
Title: display-adapter / display

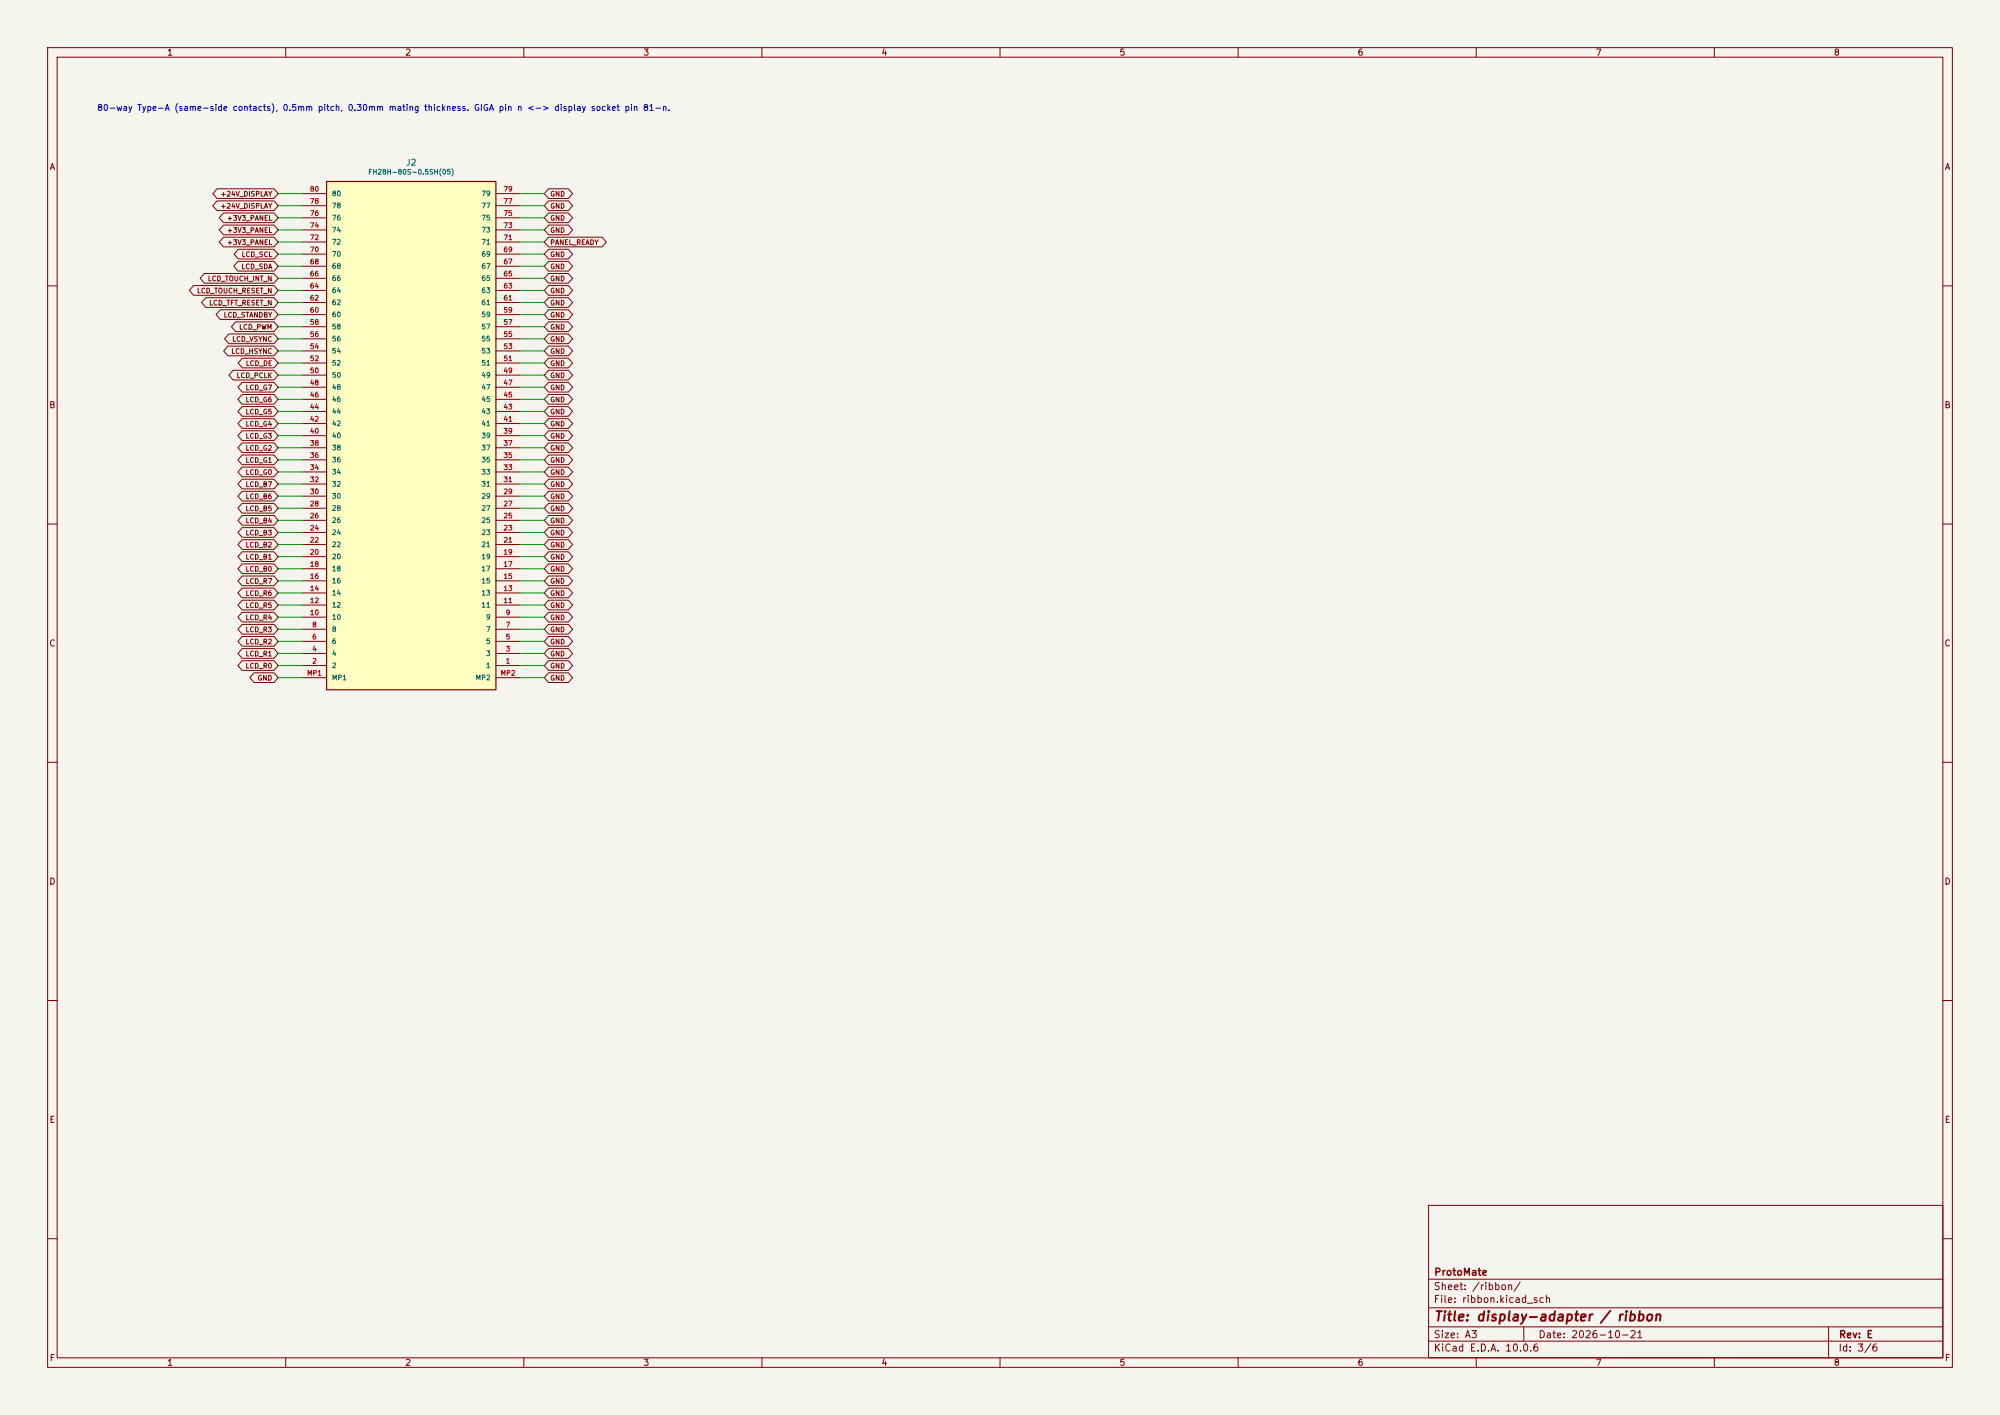
[picture p351: page 3]

LCD_G5 80-way Type-A (same-side contacts), 0.5mm pitch, 0.30mm mating thickness. GIGA pin n <-> display socket pin 81-n.
LCD_G3 +24V_DISPLAY +24V_DISPLAY +3V3_PANEL +3V3_PANEL +3V3_PANEL

ProtoMate
Sheet: /ribbon/
File: ribbon.kicad_sch
Title: display-adapter / ribbon

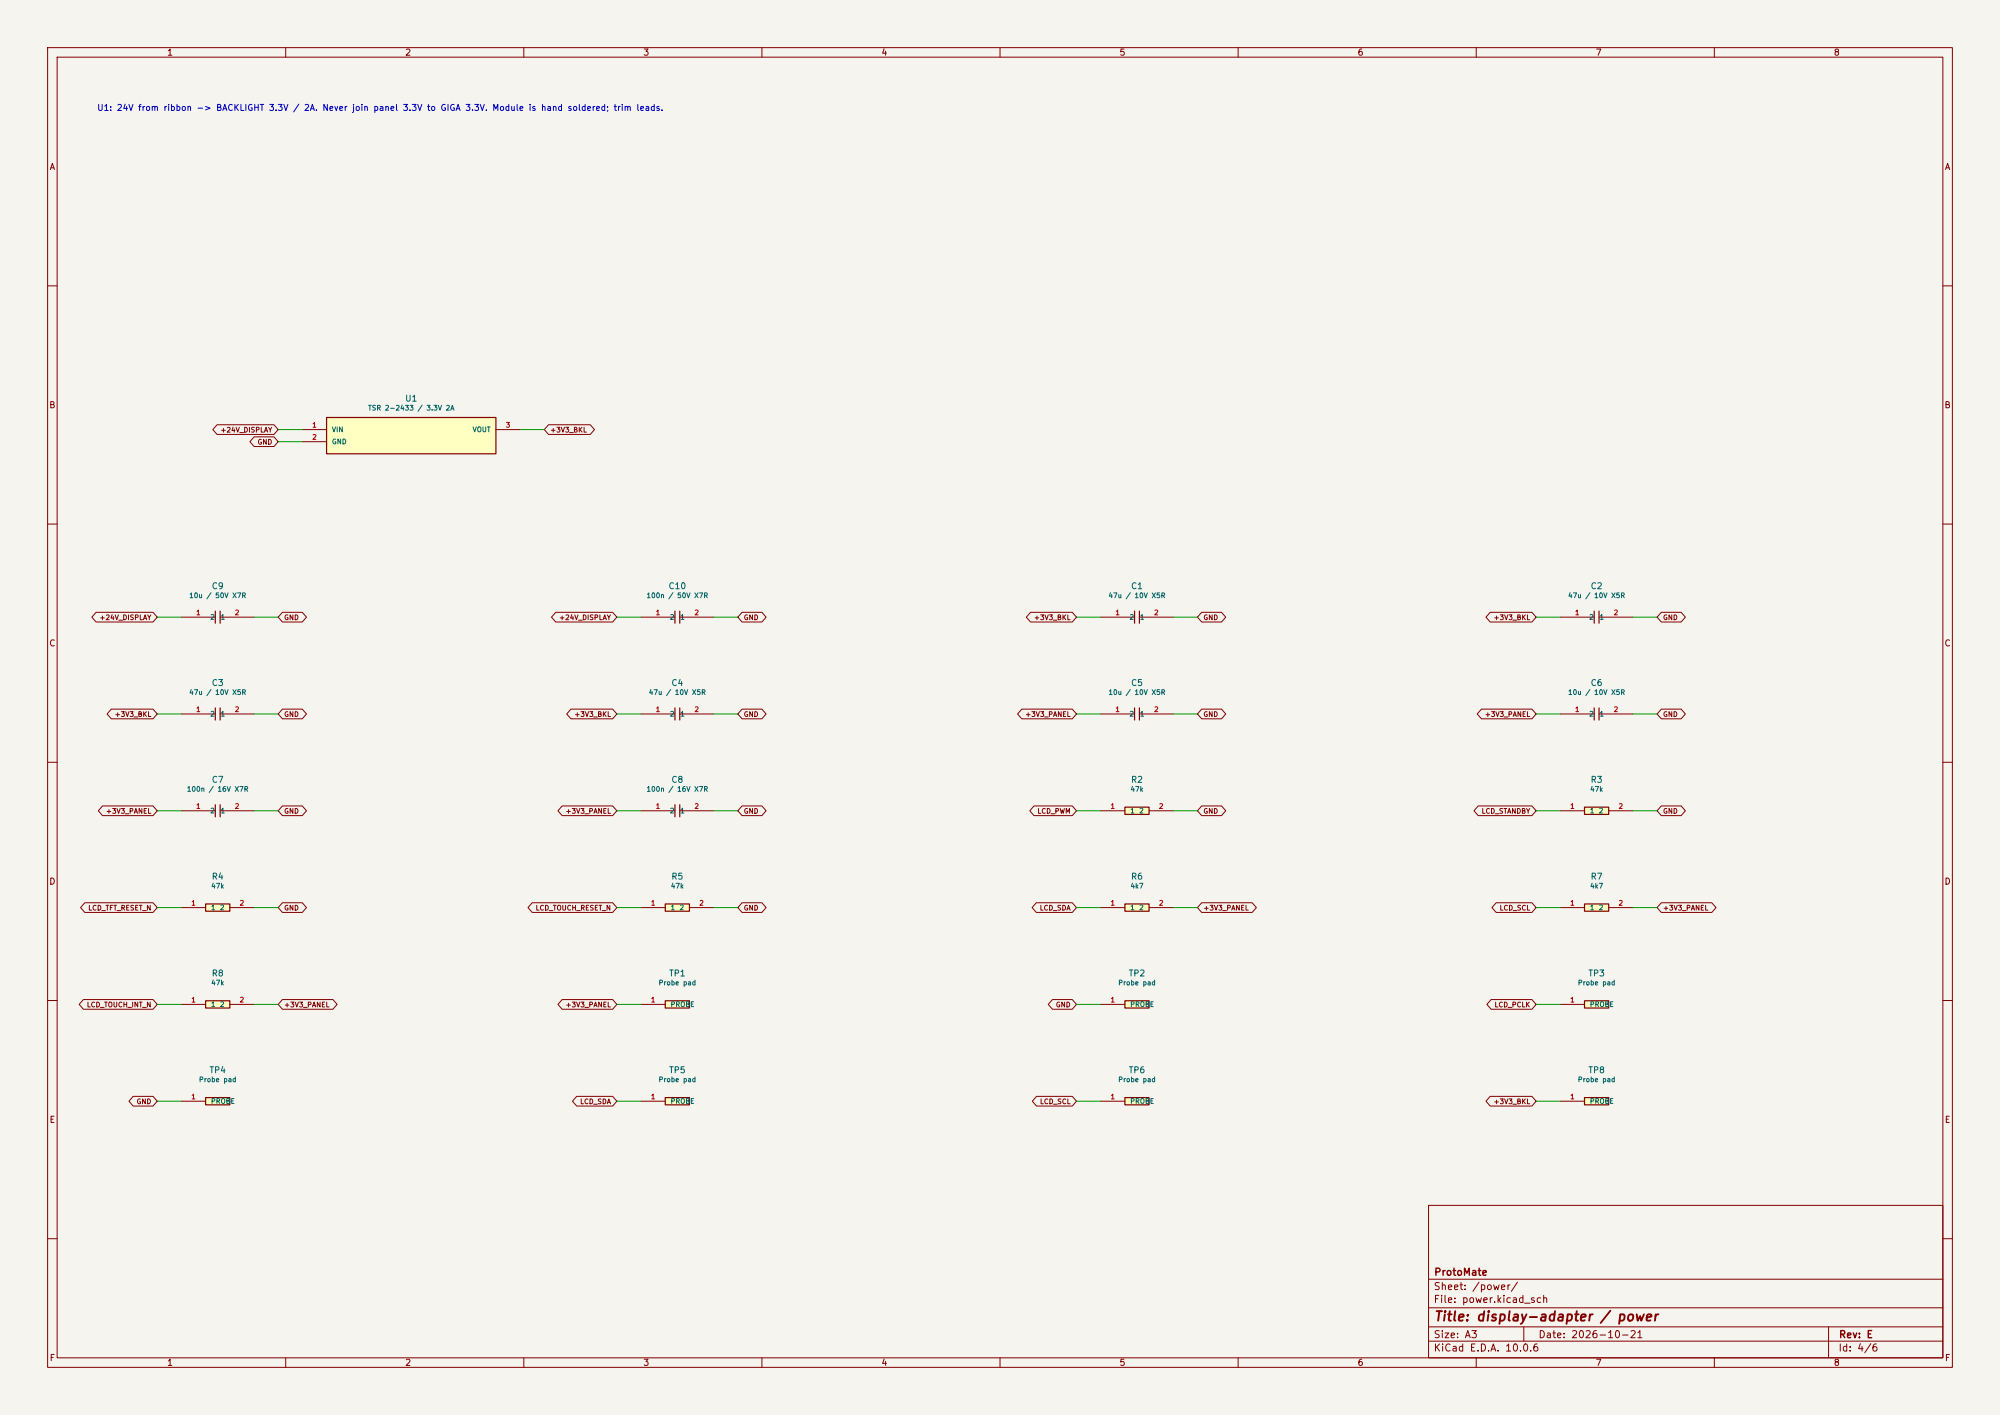
[picture p352: page 4]

U1: 24V from ribbon -> BACKLIGHT 3.3V / 2A. Never join panel 3.3V to GIGA 3.3V. Module is hand soldered; trim leads.

ProtoMate
Sheet: /power/
File: power.kicad_sch
Title: display-adapter / power

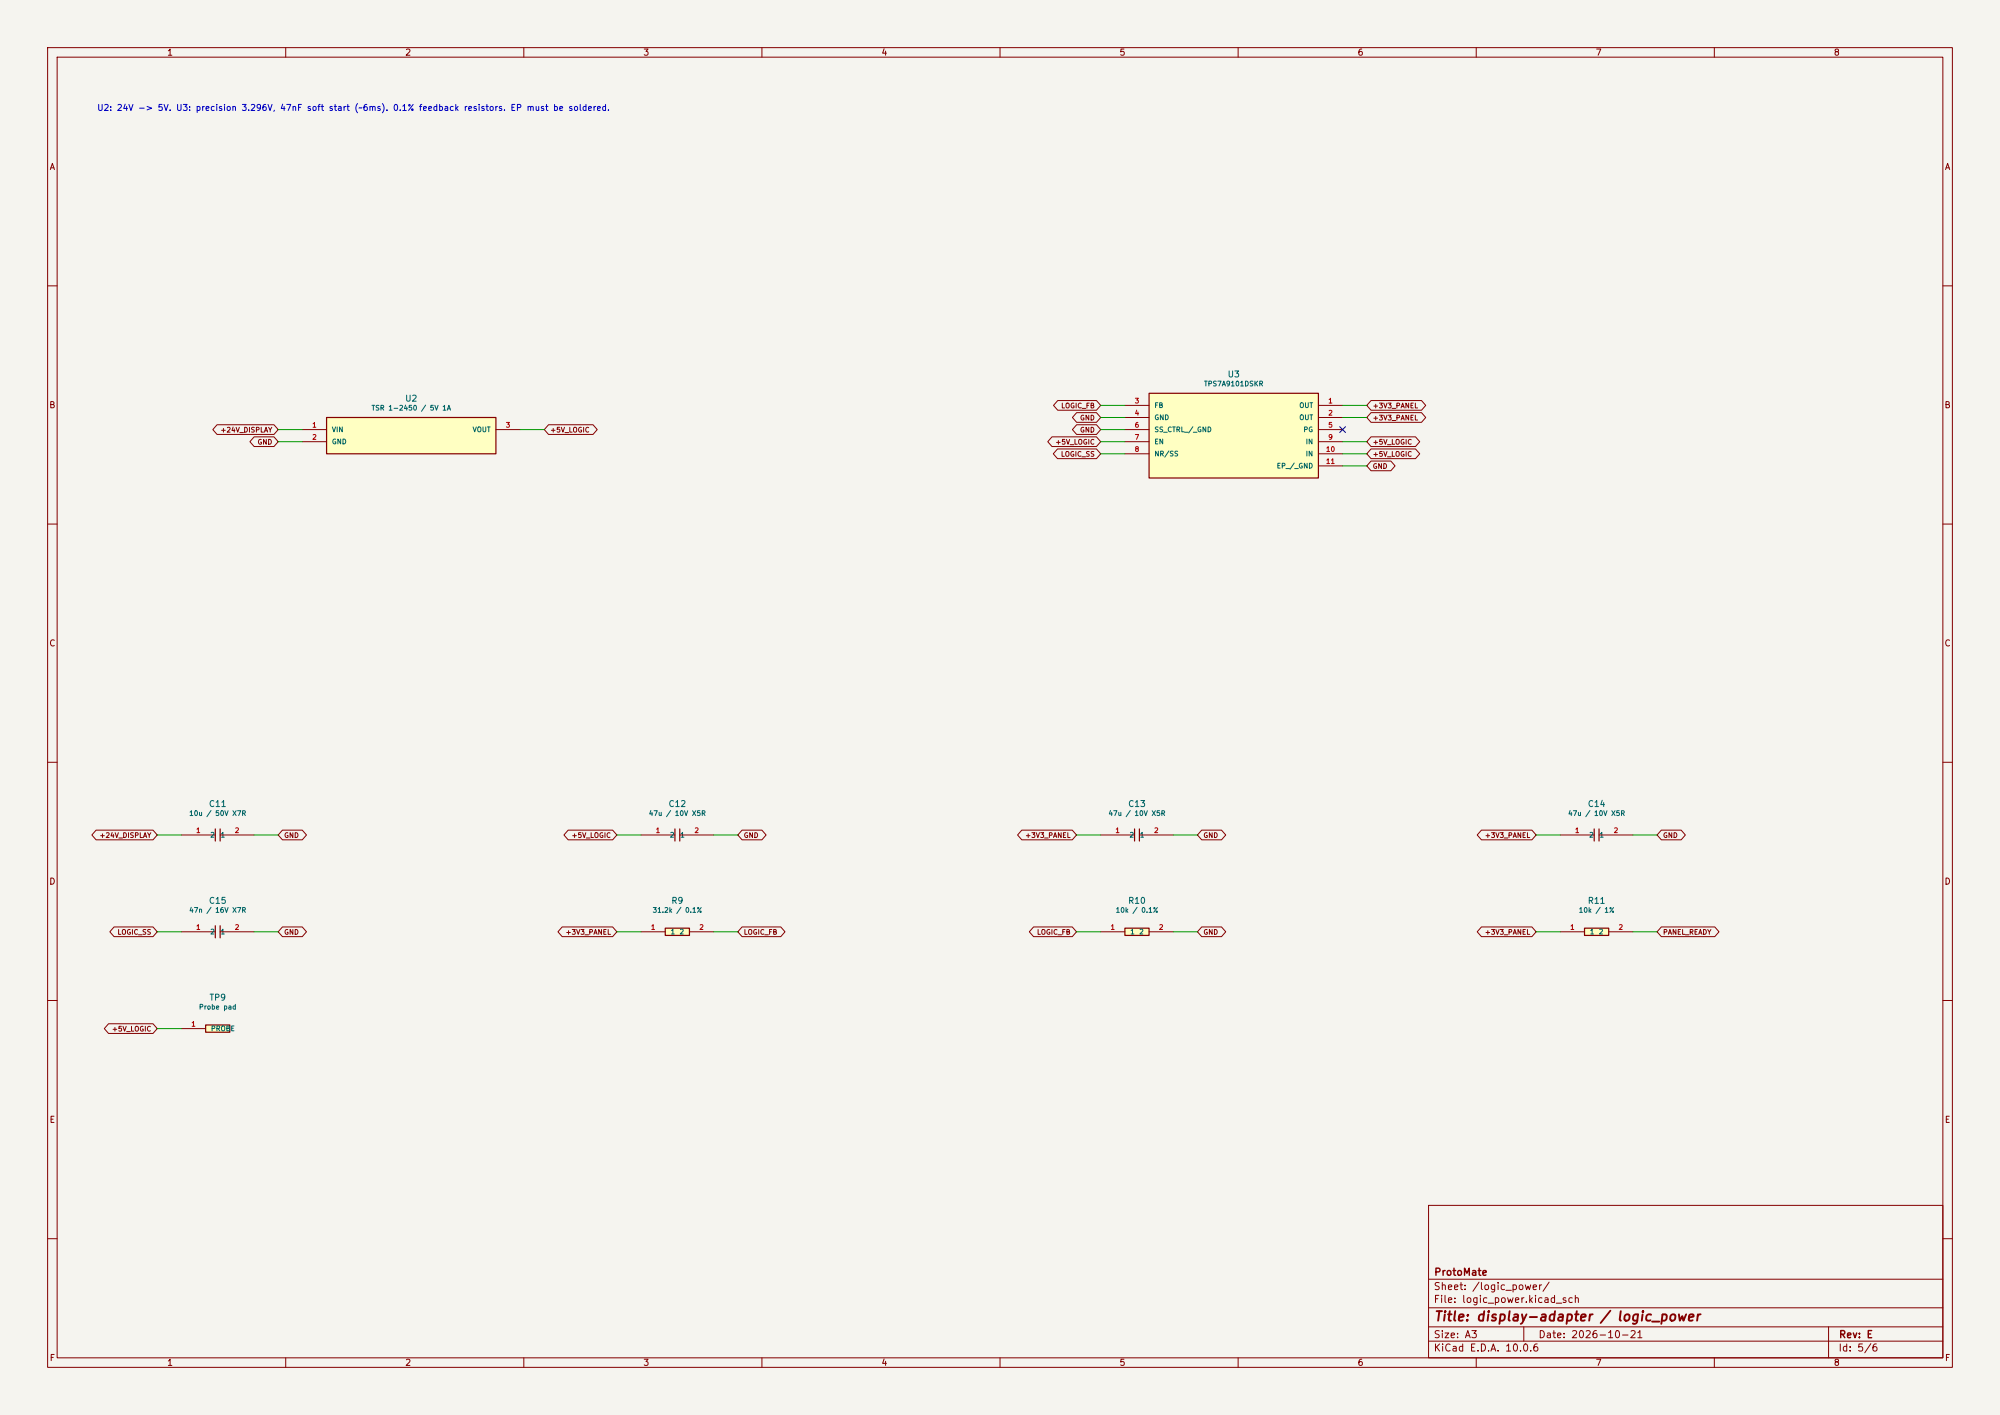
[picture p353: page 5]

U2: 24V -> 5V. U3: precision 3.296V, 47nF soft start (~6ms). 0.1% feedback resistors. EP must be soldered.

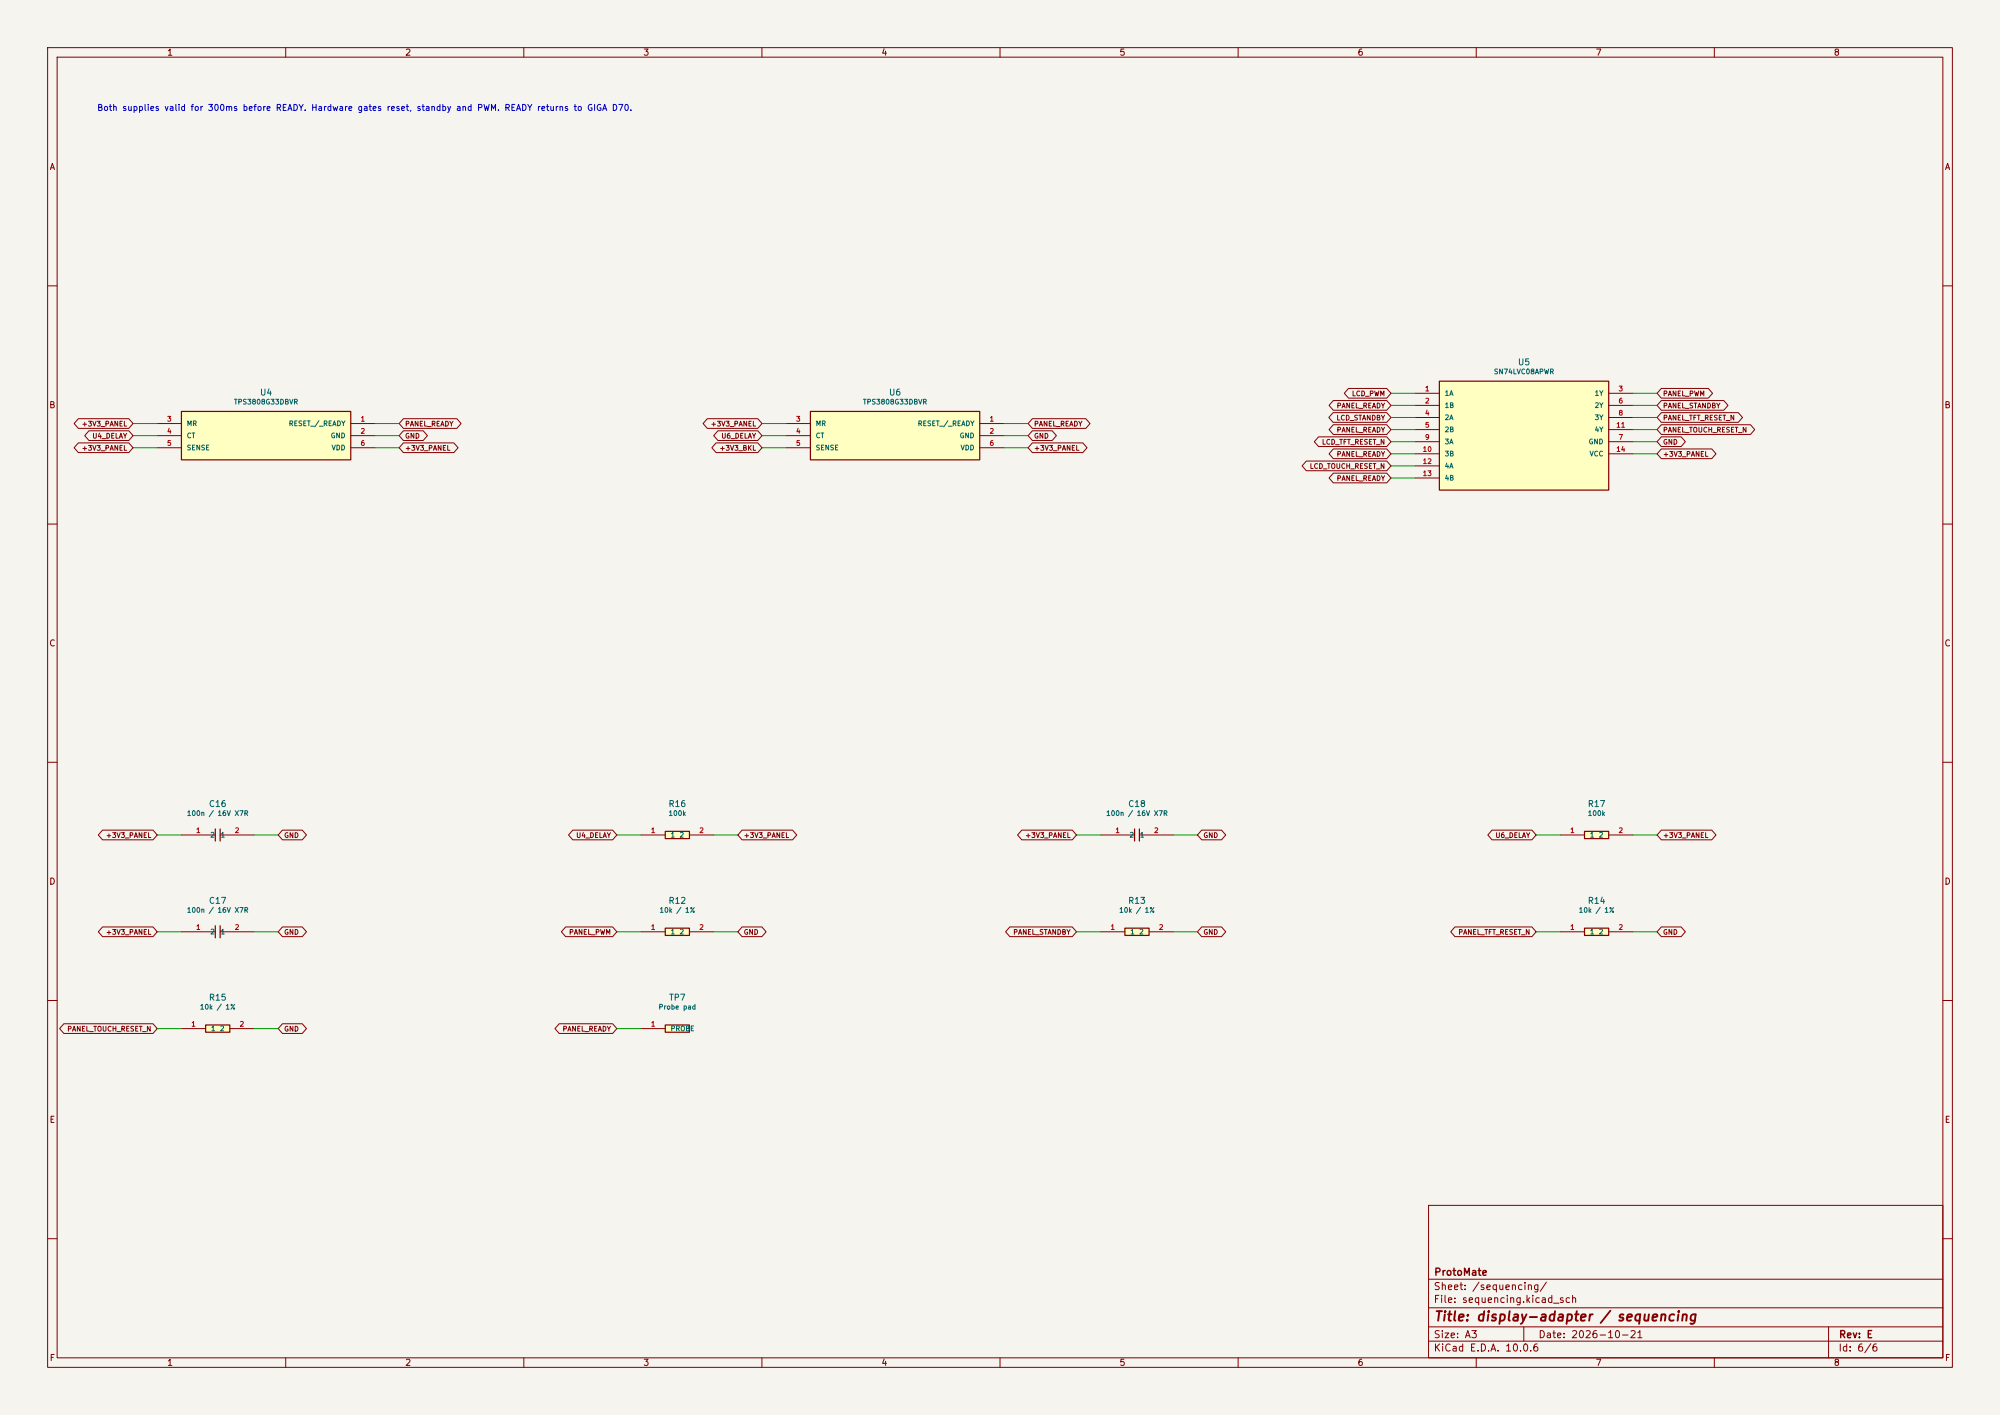
[picture p354: page 6]

Both supplies valid for 300ms before READY. Hardware gates reset, standby and PWM. READY returns to GIGA D70.

ProtoMate
Sheet: /sequencing/
File: sequencing.kicad_sch
Title: display-adapter / sequencing
