daleondev/ProtoMate_Control/hardware/display/manufacturing/giga-adapter-rev-D/schematic.pdf

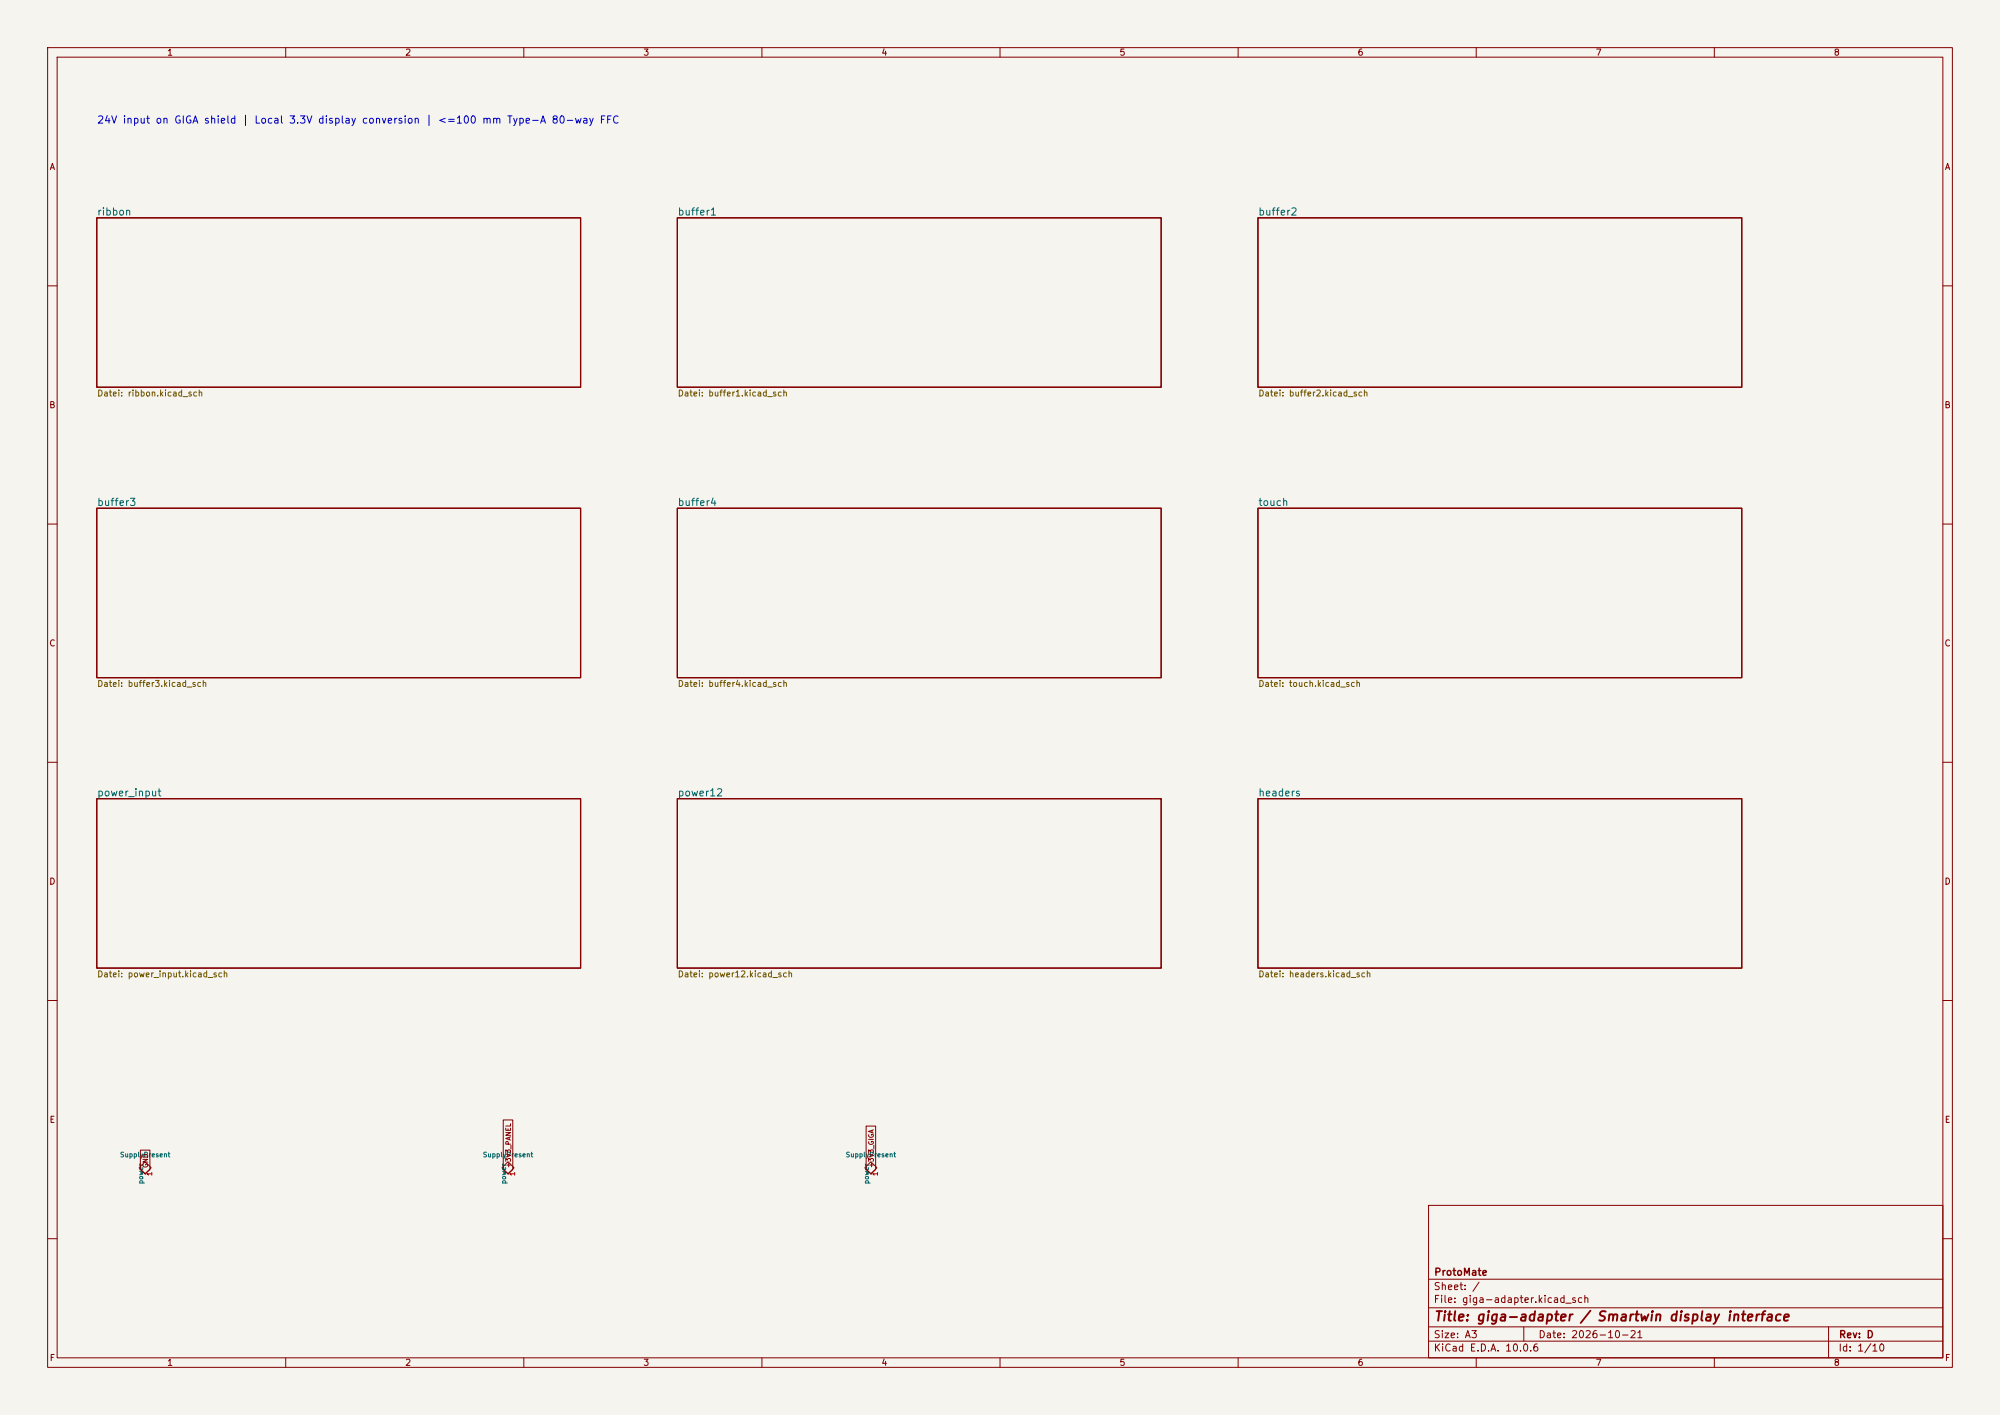
[picture p355: page 1]

24V input on GIGA shield | Local 3.3V display conversion | <=100 mm Type-A 80-way FFC

headers Datei: headers.kicad_sch power 1

ProtoMate
Sheet: /
File: giga-adapter.kicad_sch
Title: giga-adapter / Smartwin display interface

Size: A3 | Rev: D | F Date: 2026-10-21
KiCad E.D.A. 10.0.6 | Id: 1/10

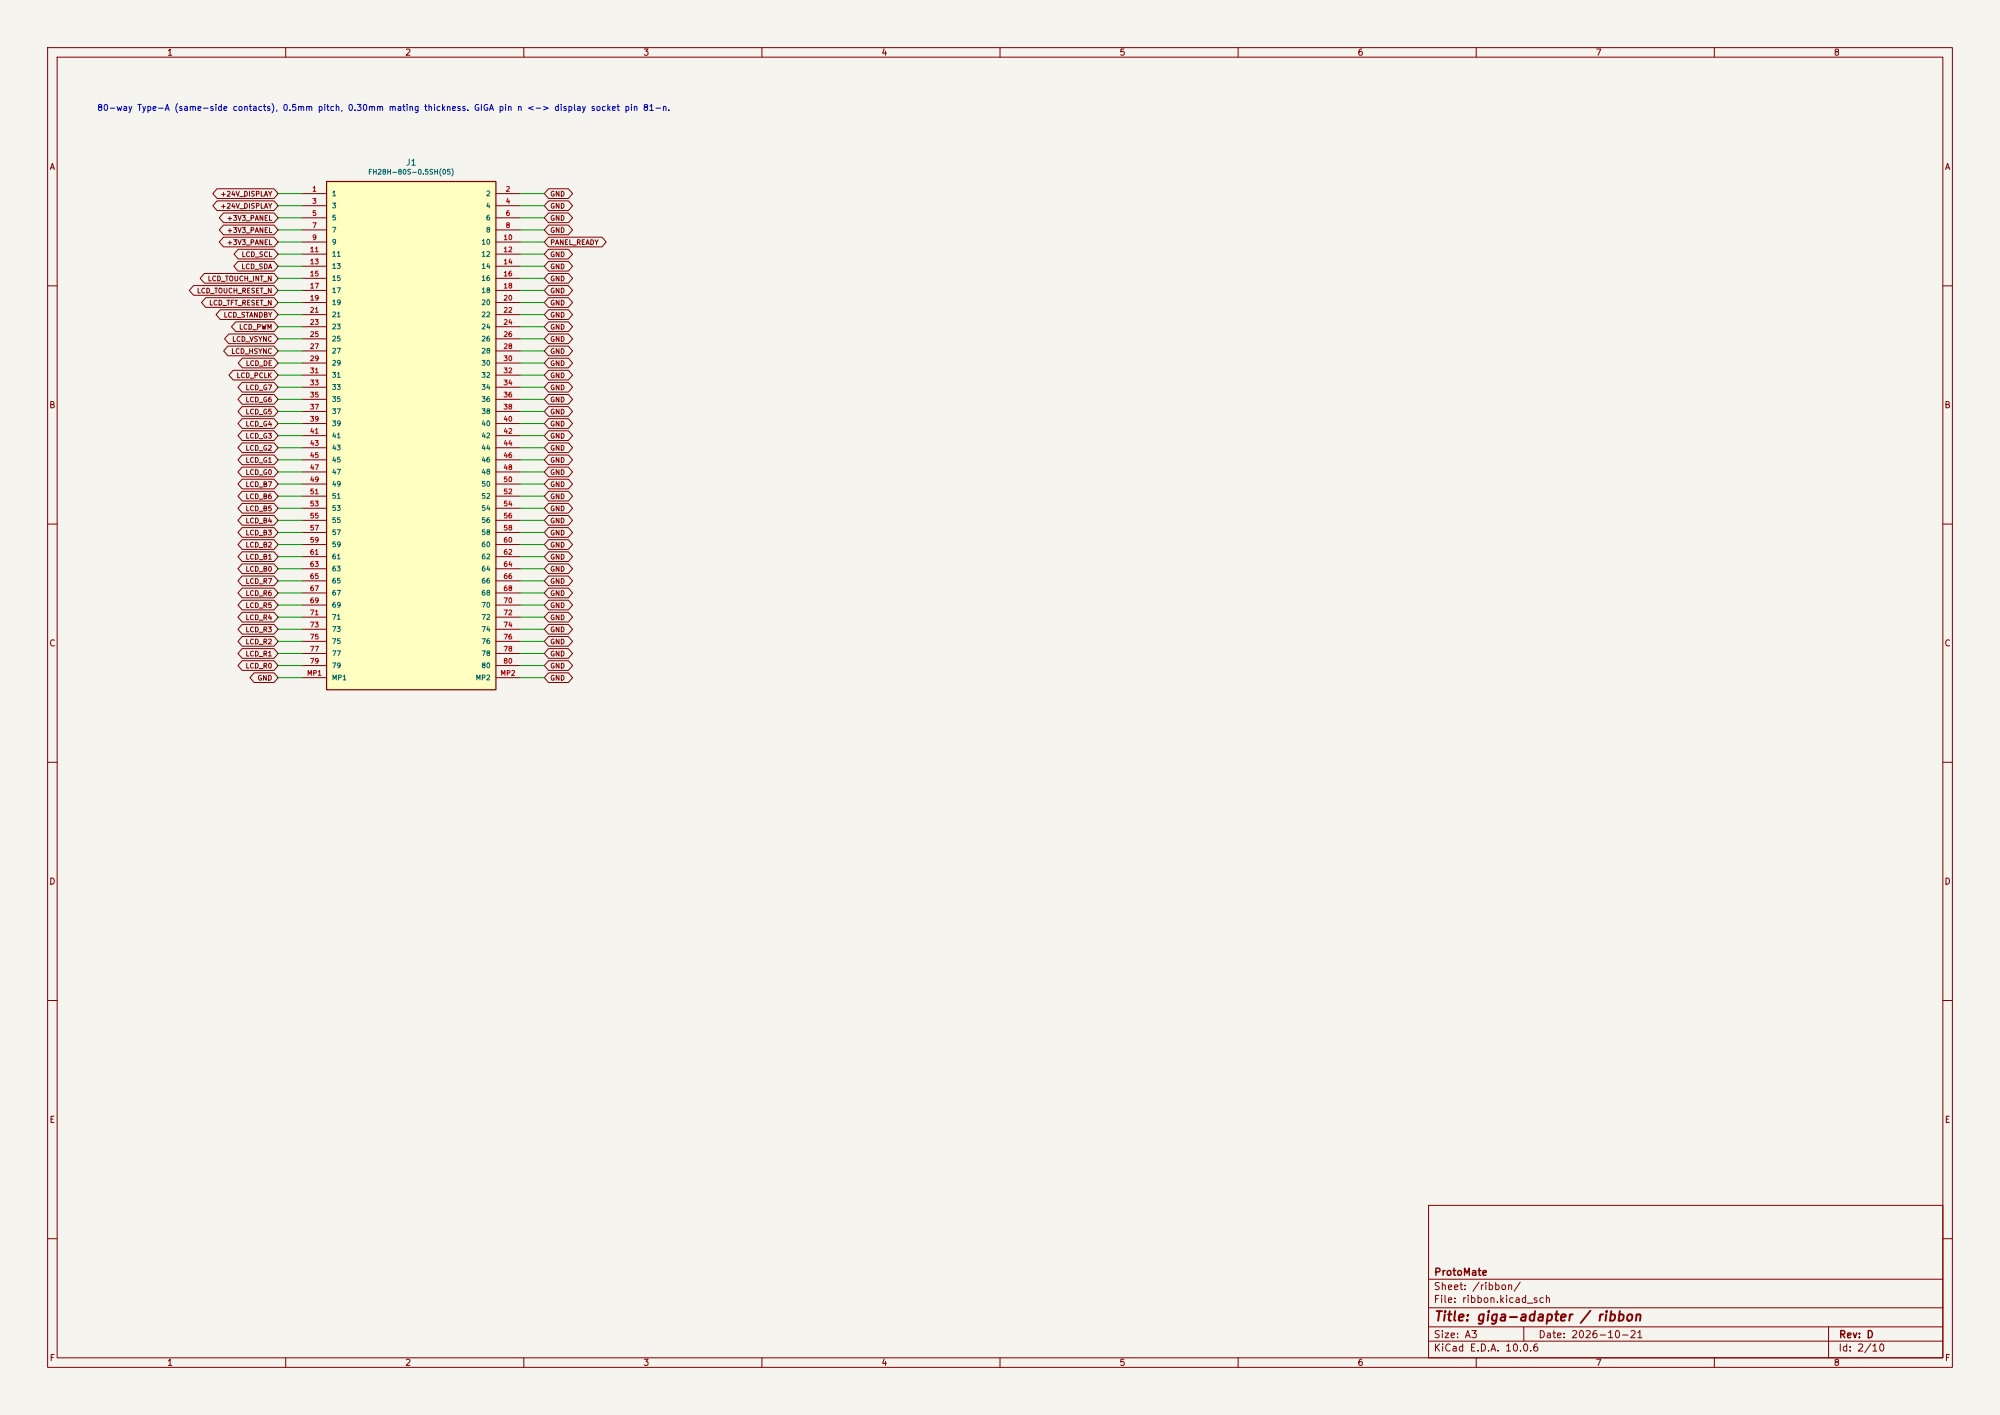
[picture p356: page 2]

LCD_G5 80-way Type-A (same-side contacts), 0.5mm pitch, 0.30mm mating thickness. GIGA pin n <-> display socket pin 81-n.
LCD_G3 +24V_DISPLAY +24V_DISPLAY +3V3_PANEL +3V3_PANEL +3V3_PANEL

ProtoMate
Sheet: /ribbon/
File: ribbon.kicad_sch
Title: giga-adapter / ribbon

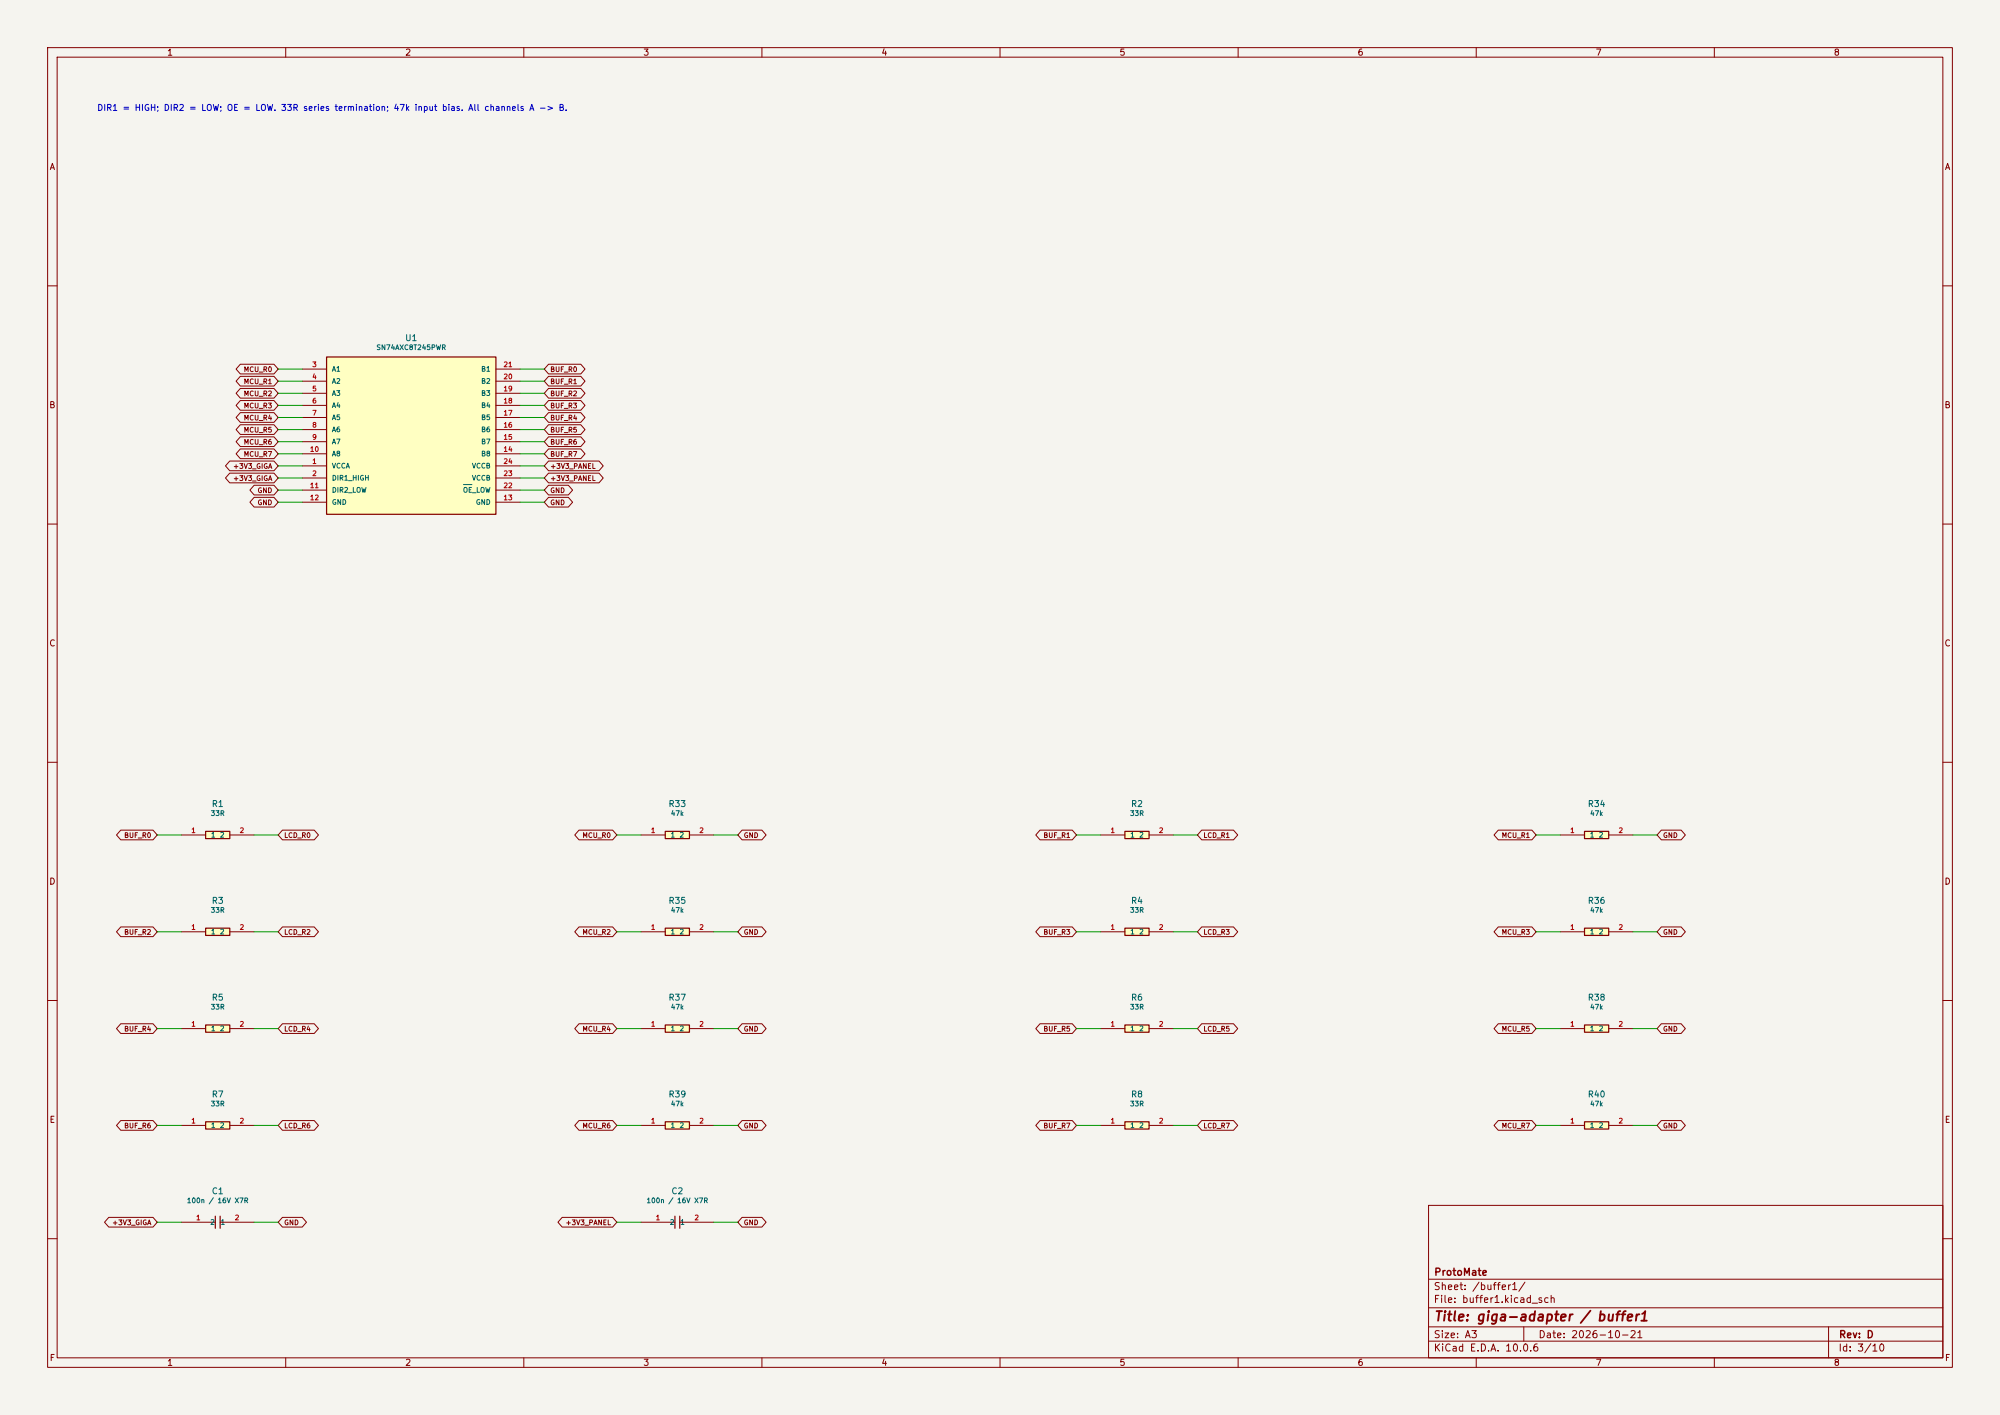
[picture p357: page 3]

MCU_R2 DIR1 = HIGH; DIR2 = LOW; OE = LOW. 33R series termination; 47k input bias. All channels A -> B.

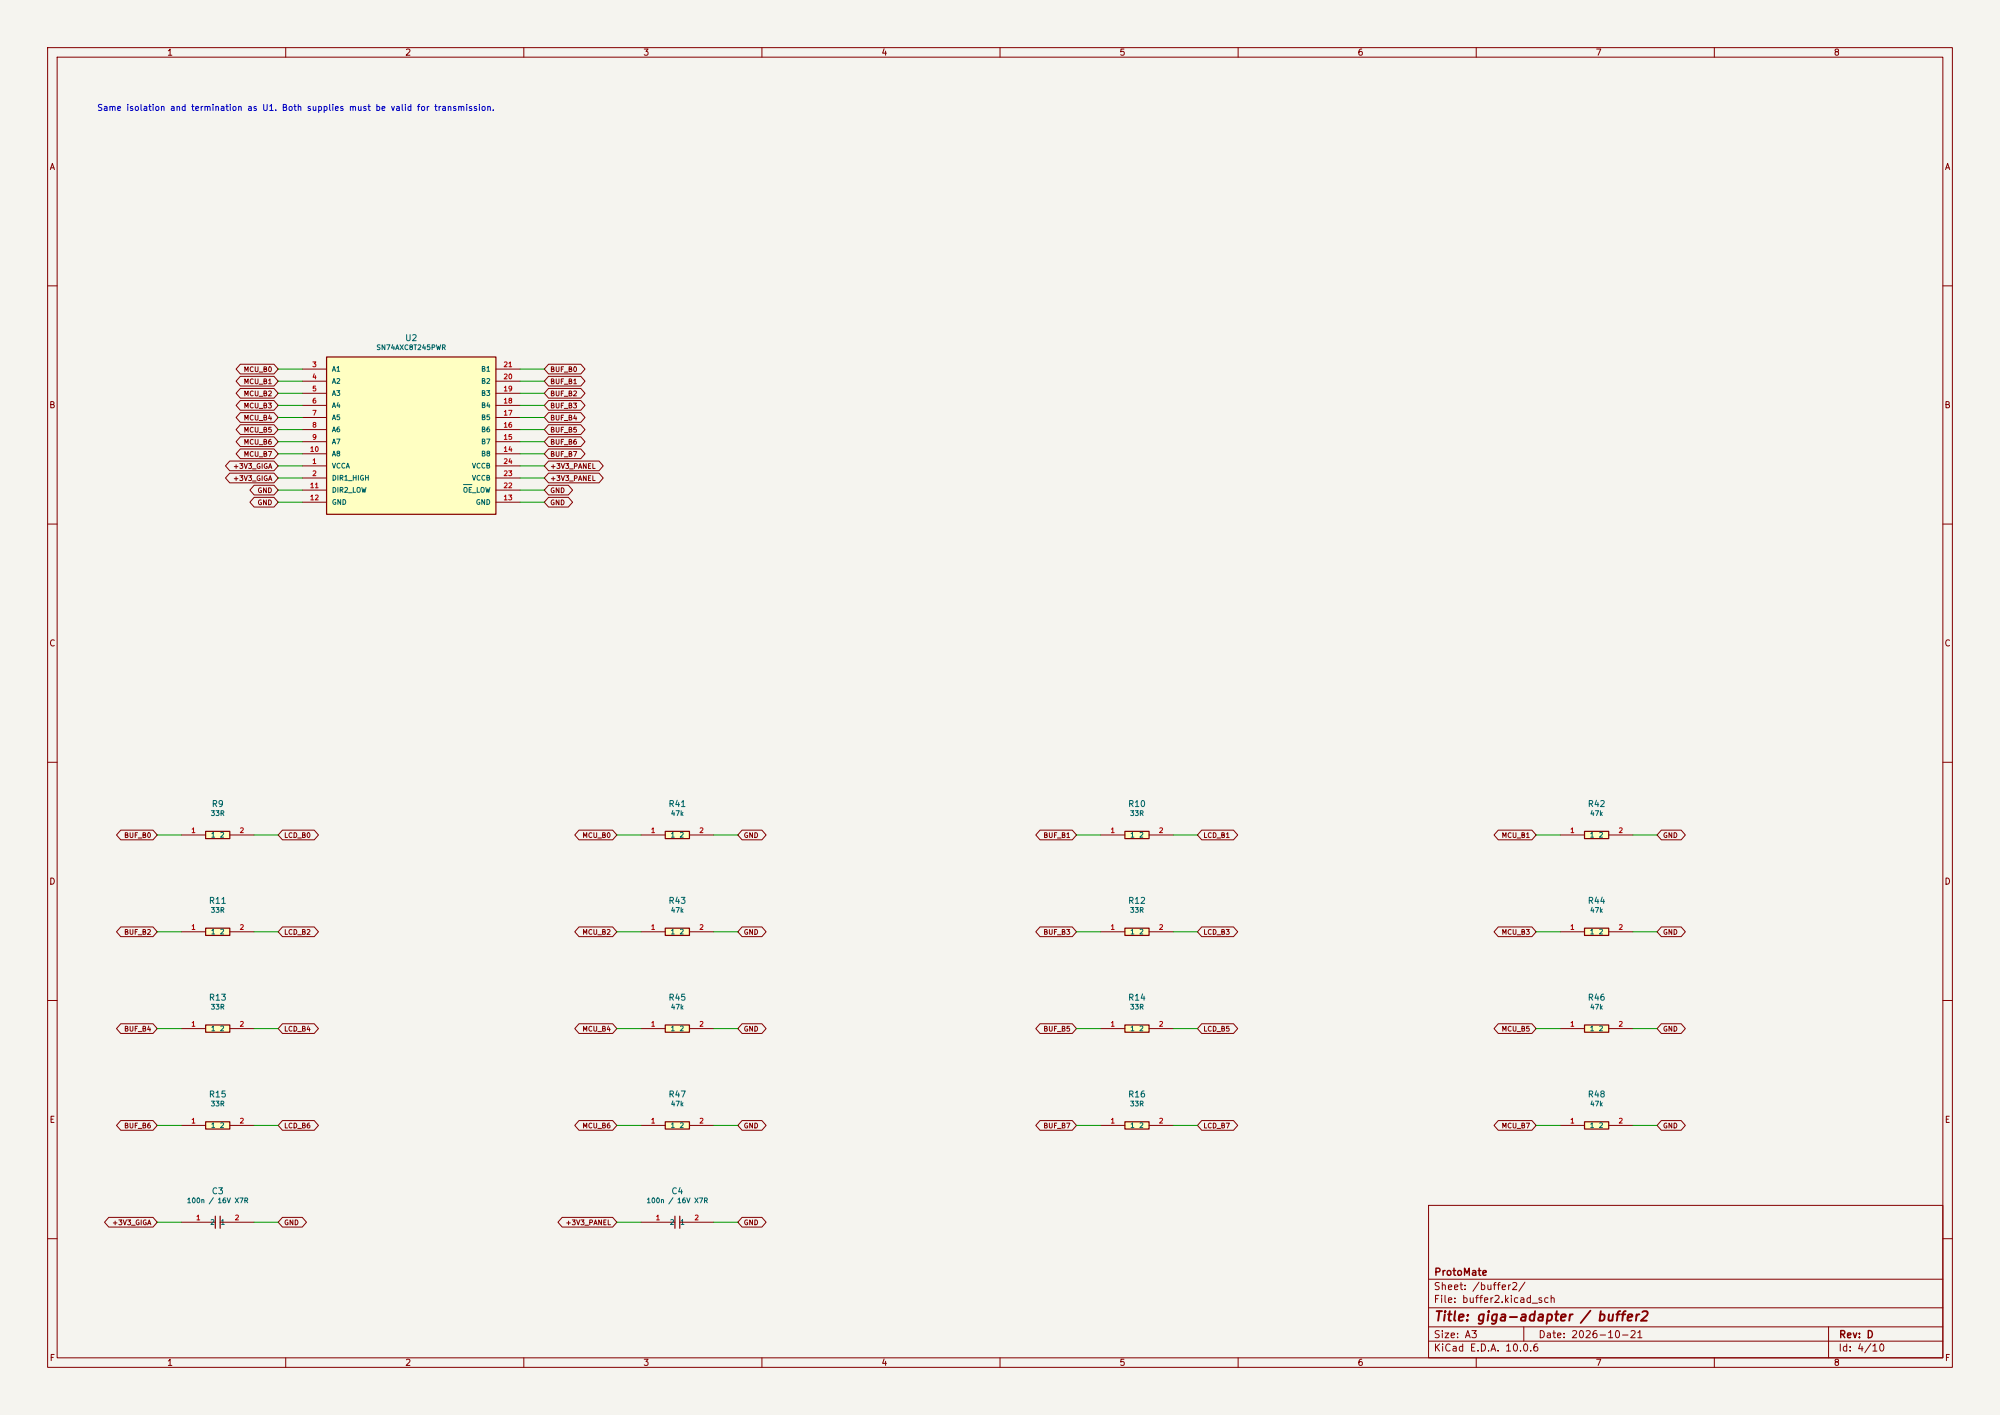
[picture p358: page 4]

MCU_B2 Same isolation and termination as U1. Both supplies must be valid for transmission.

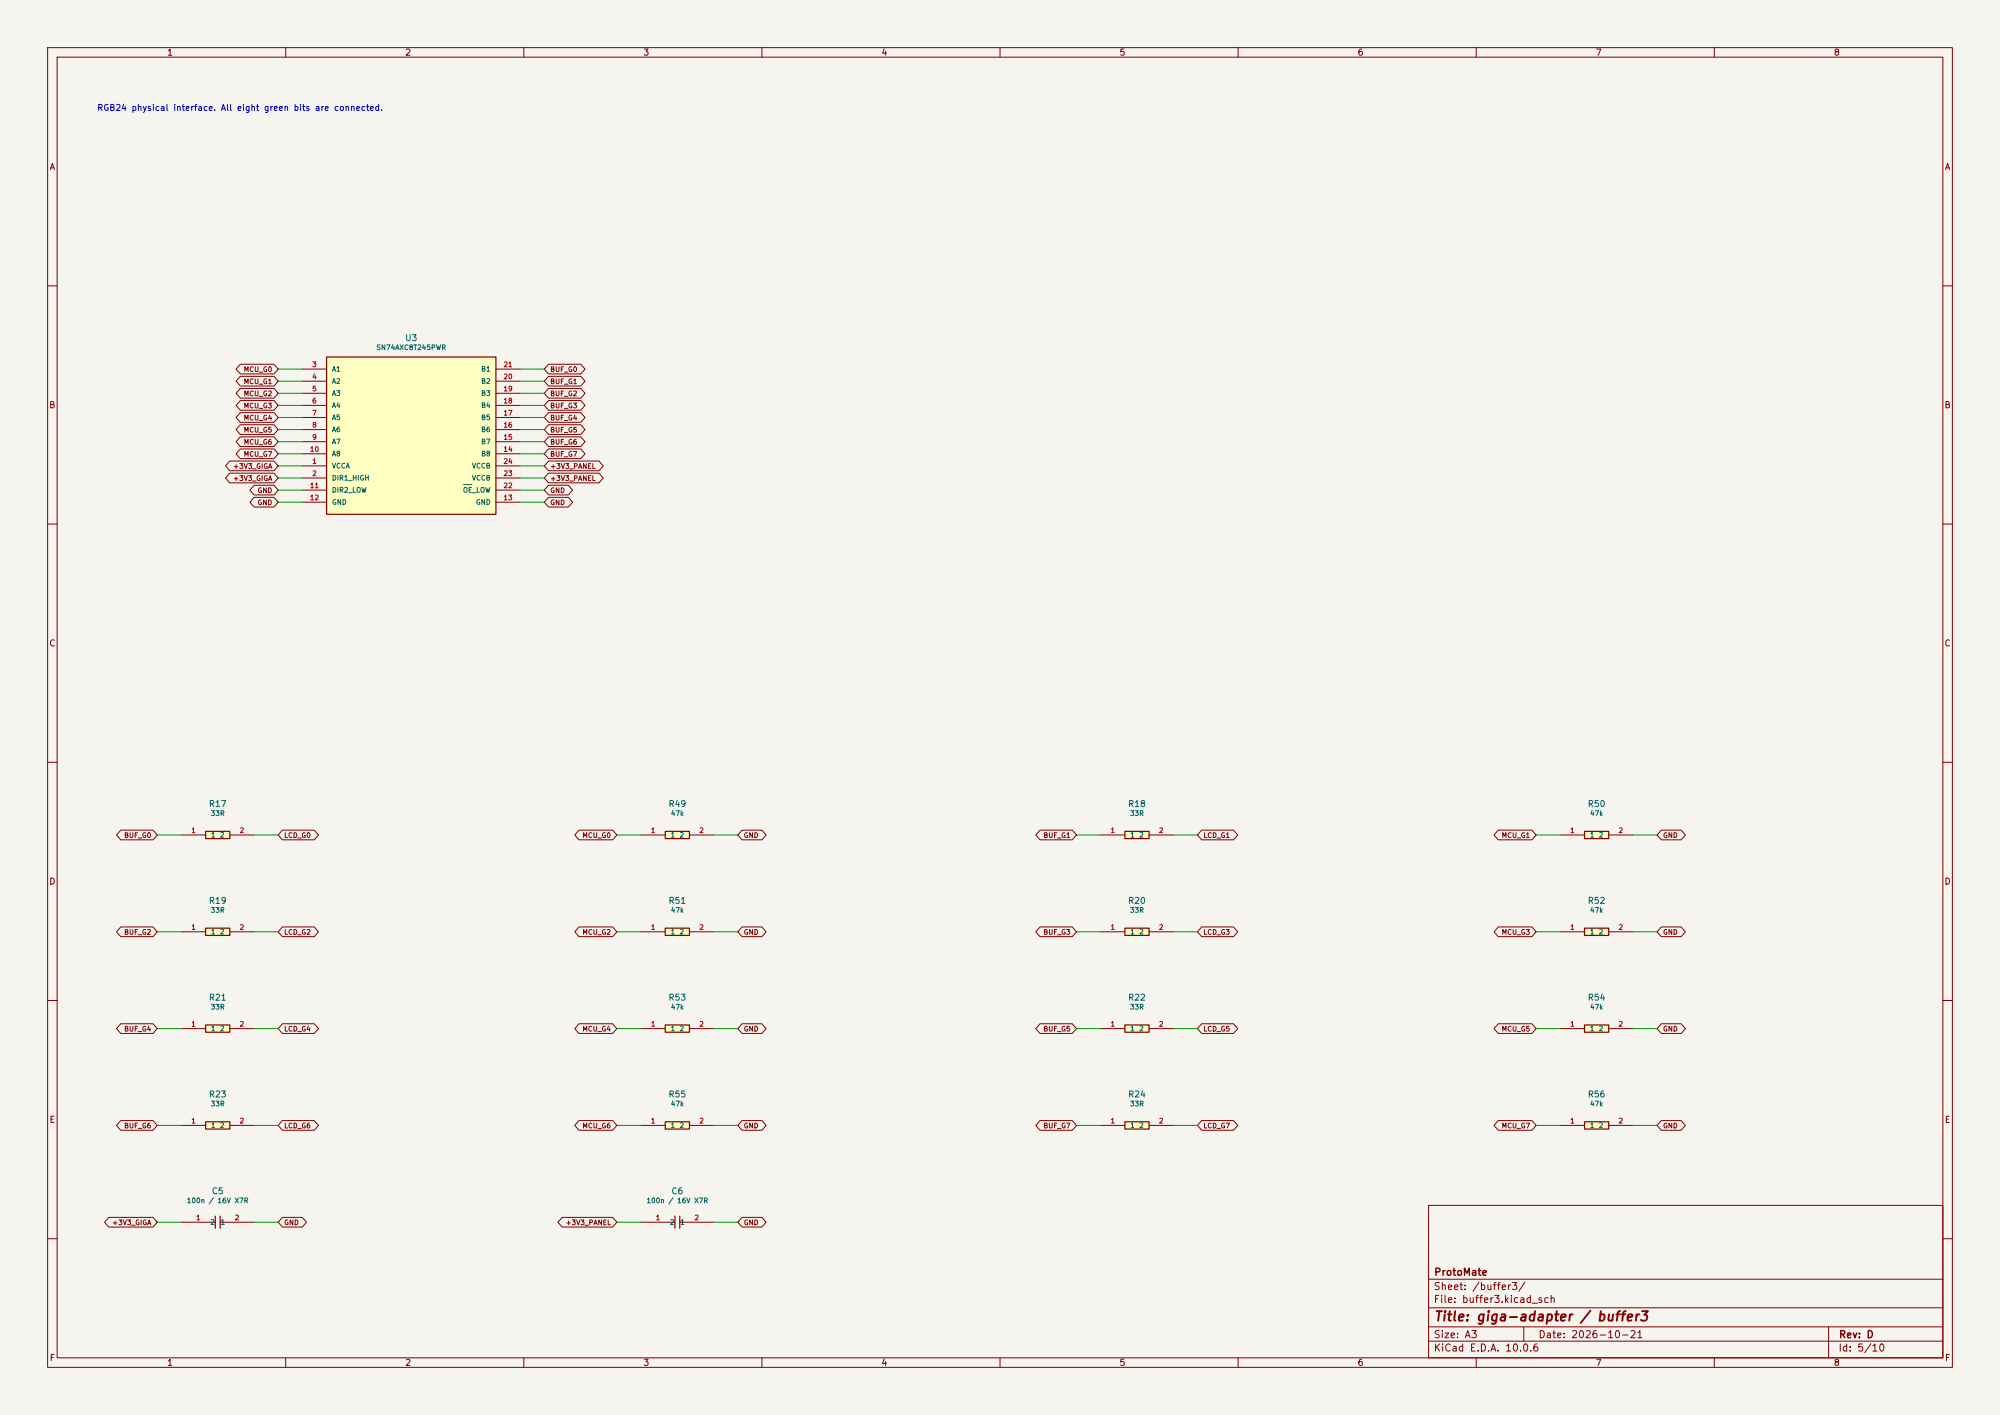
[picture p359: page 5]

MCU_G2 RGB24 physical interface. All eight green bits are connected.

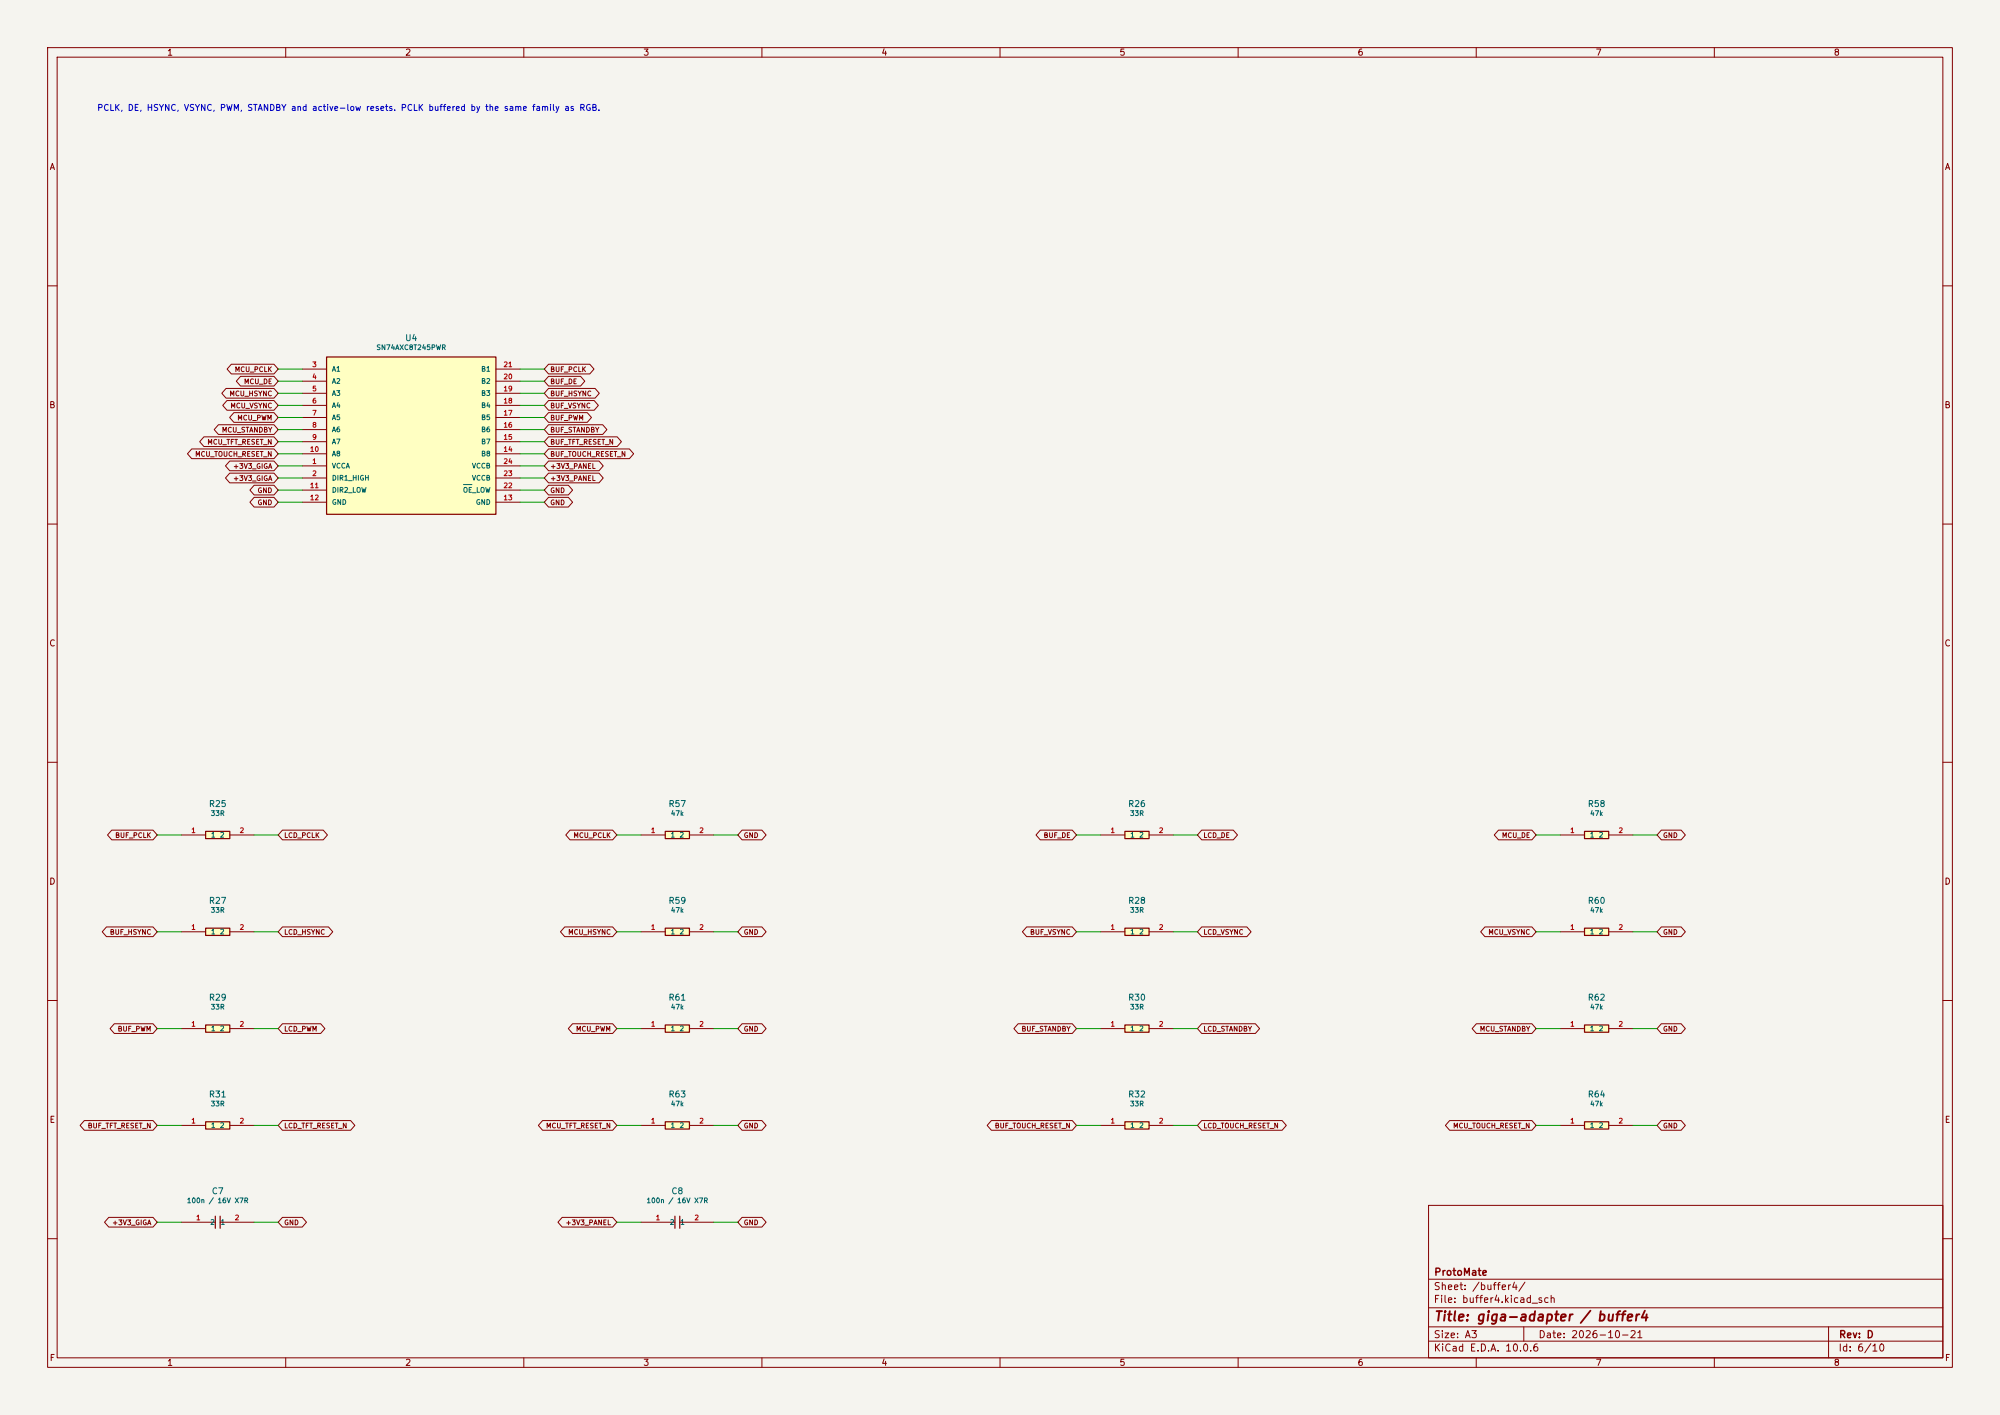
[picture p360: page 6]

PCLK, DE, HSYNC, VSYNC, PWM, STANDBY and active-low resets. PCLK buffered by the same family as RGB.

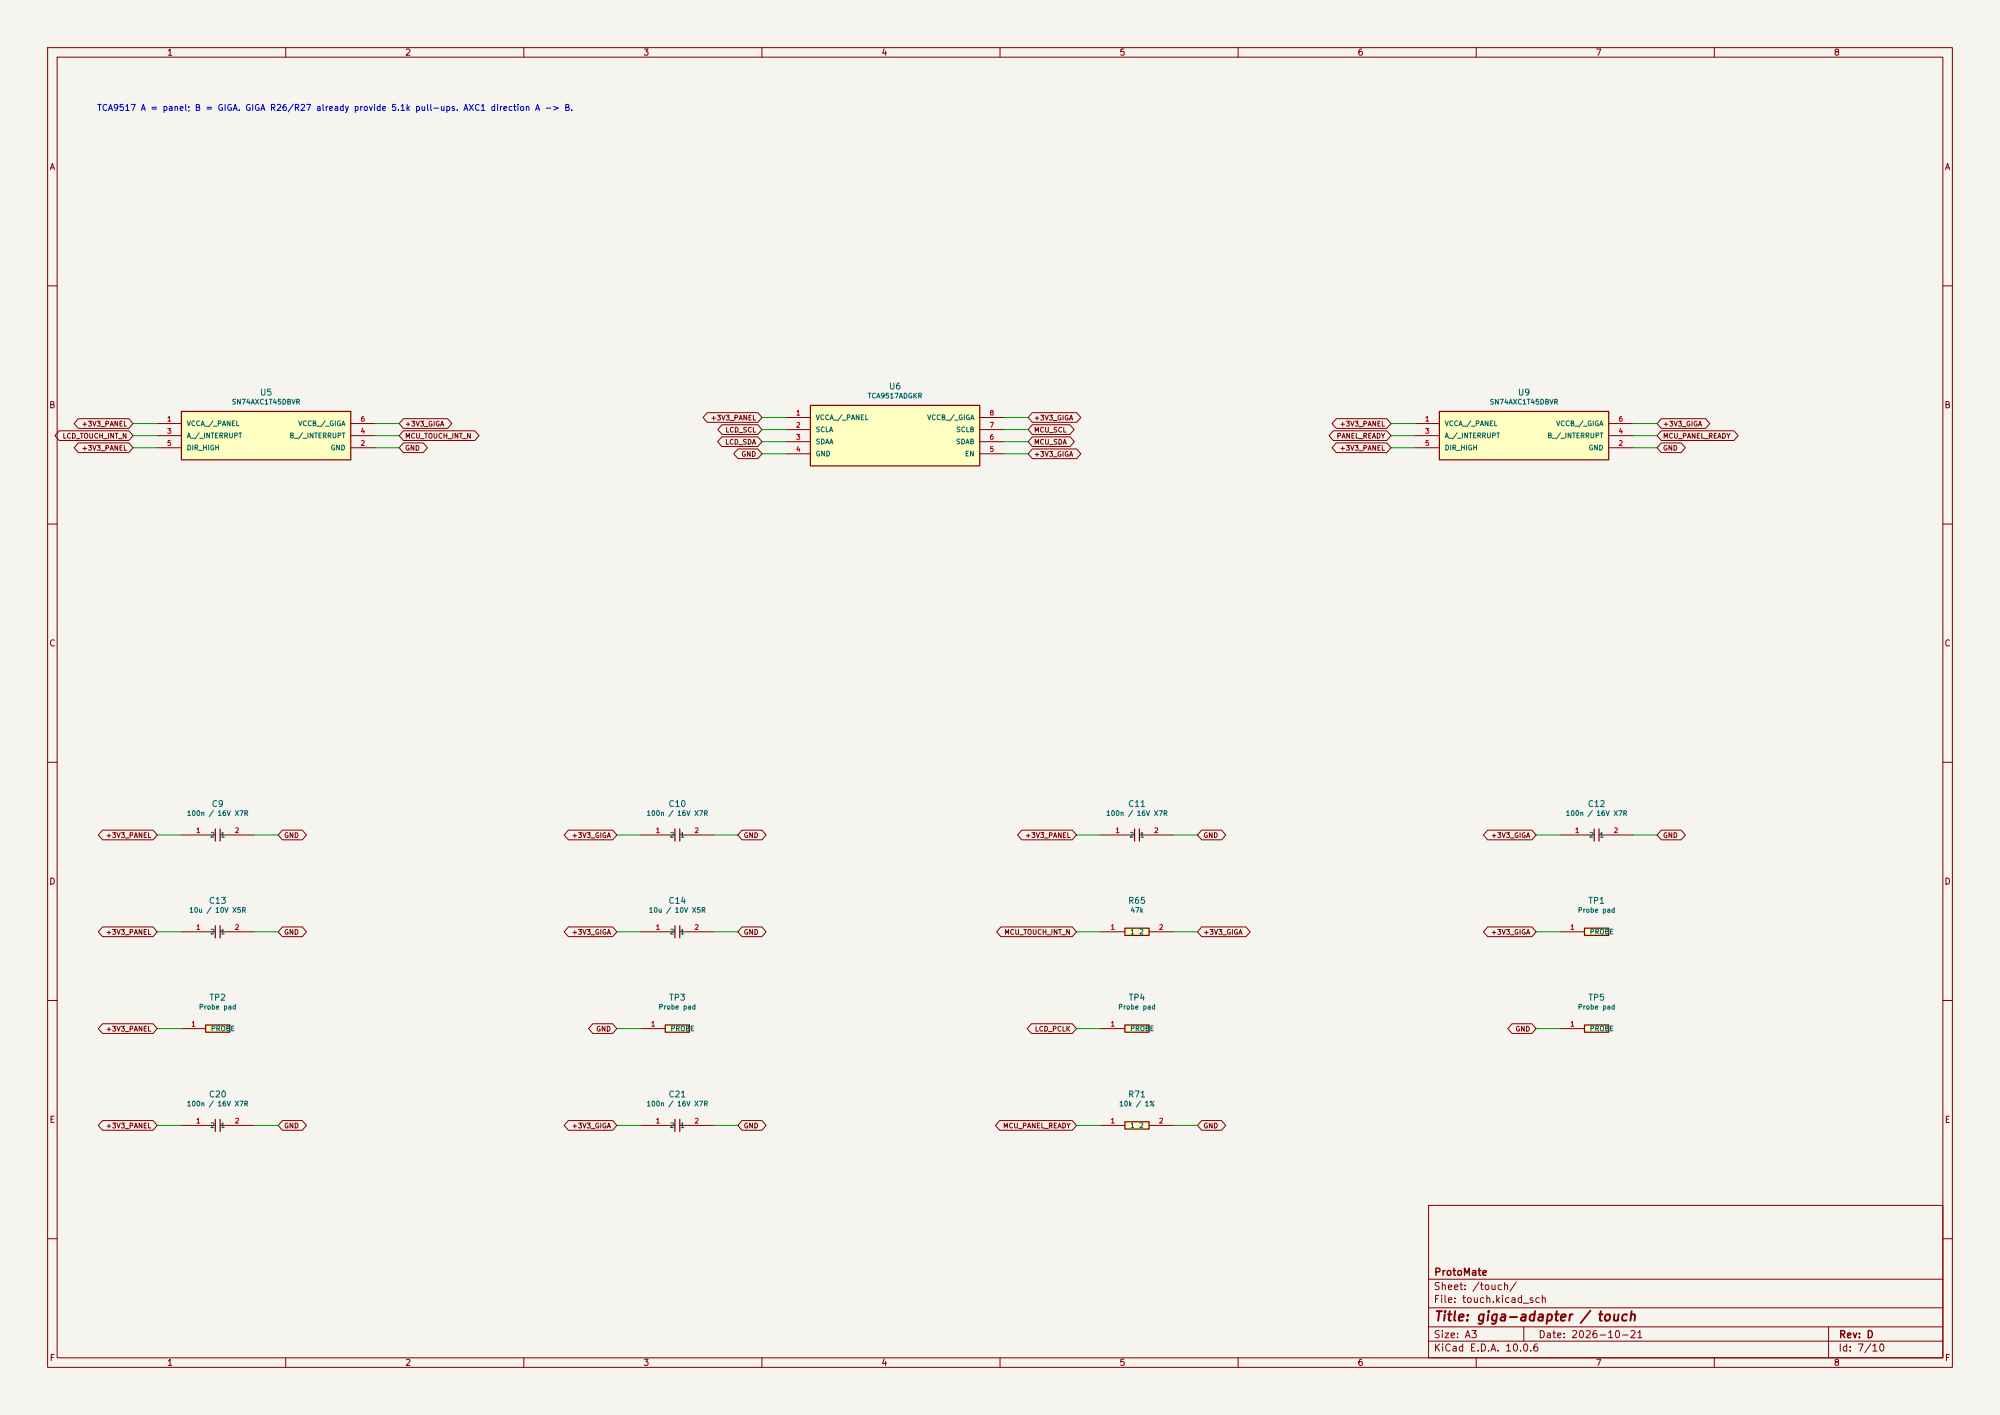
[picture p361: page 7]

TCA9517 A = panel; B = GIGA. GIGA R26/R27 already provide 5.1k pull-ups. AXC1 direction A -> B.

ProtoMate
Sheet: /touch/
File: touch.kicad_sch
Title: giga-adapter / touch

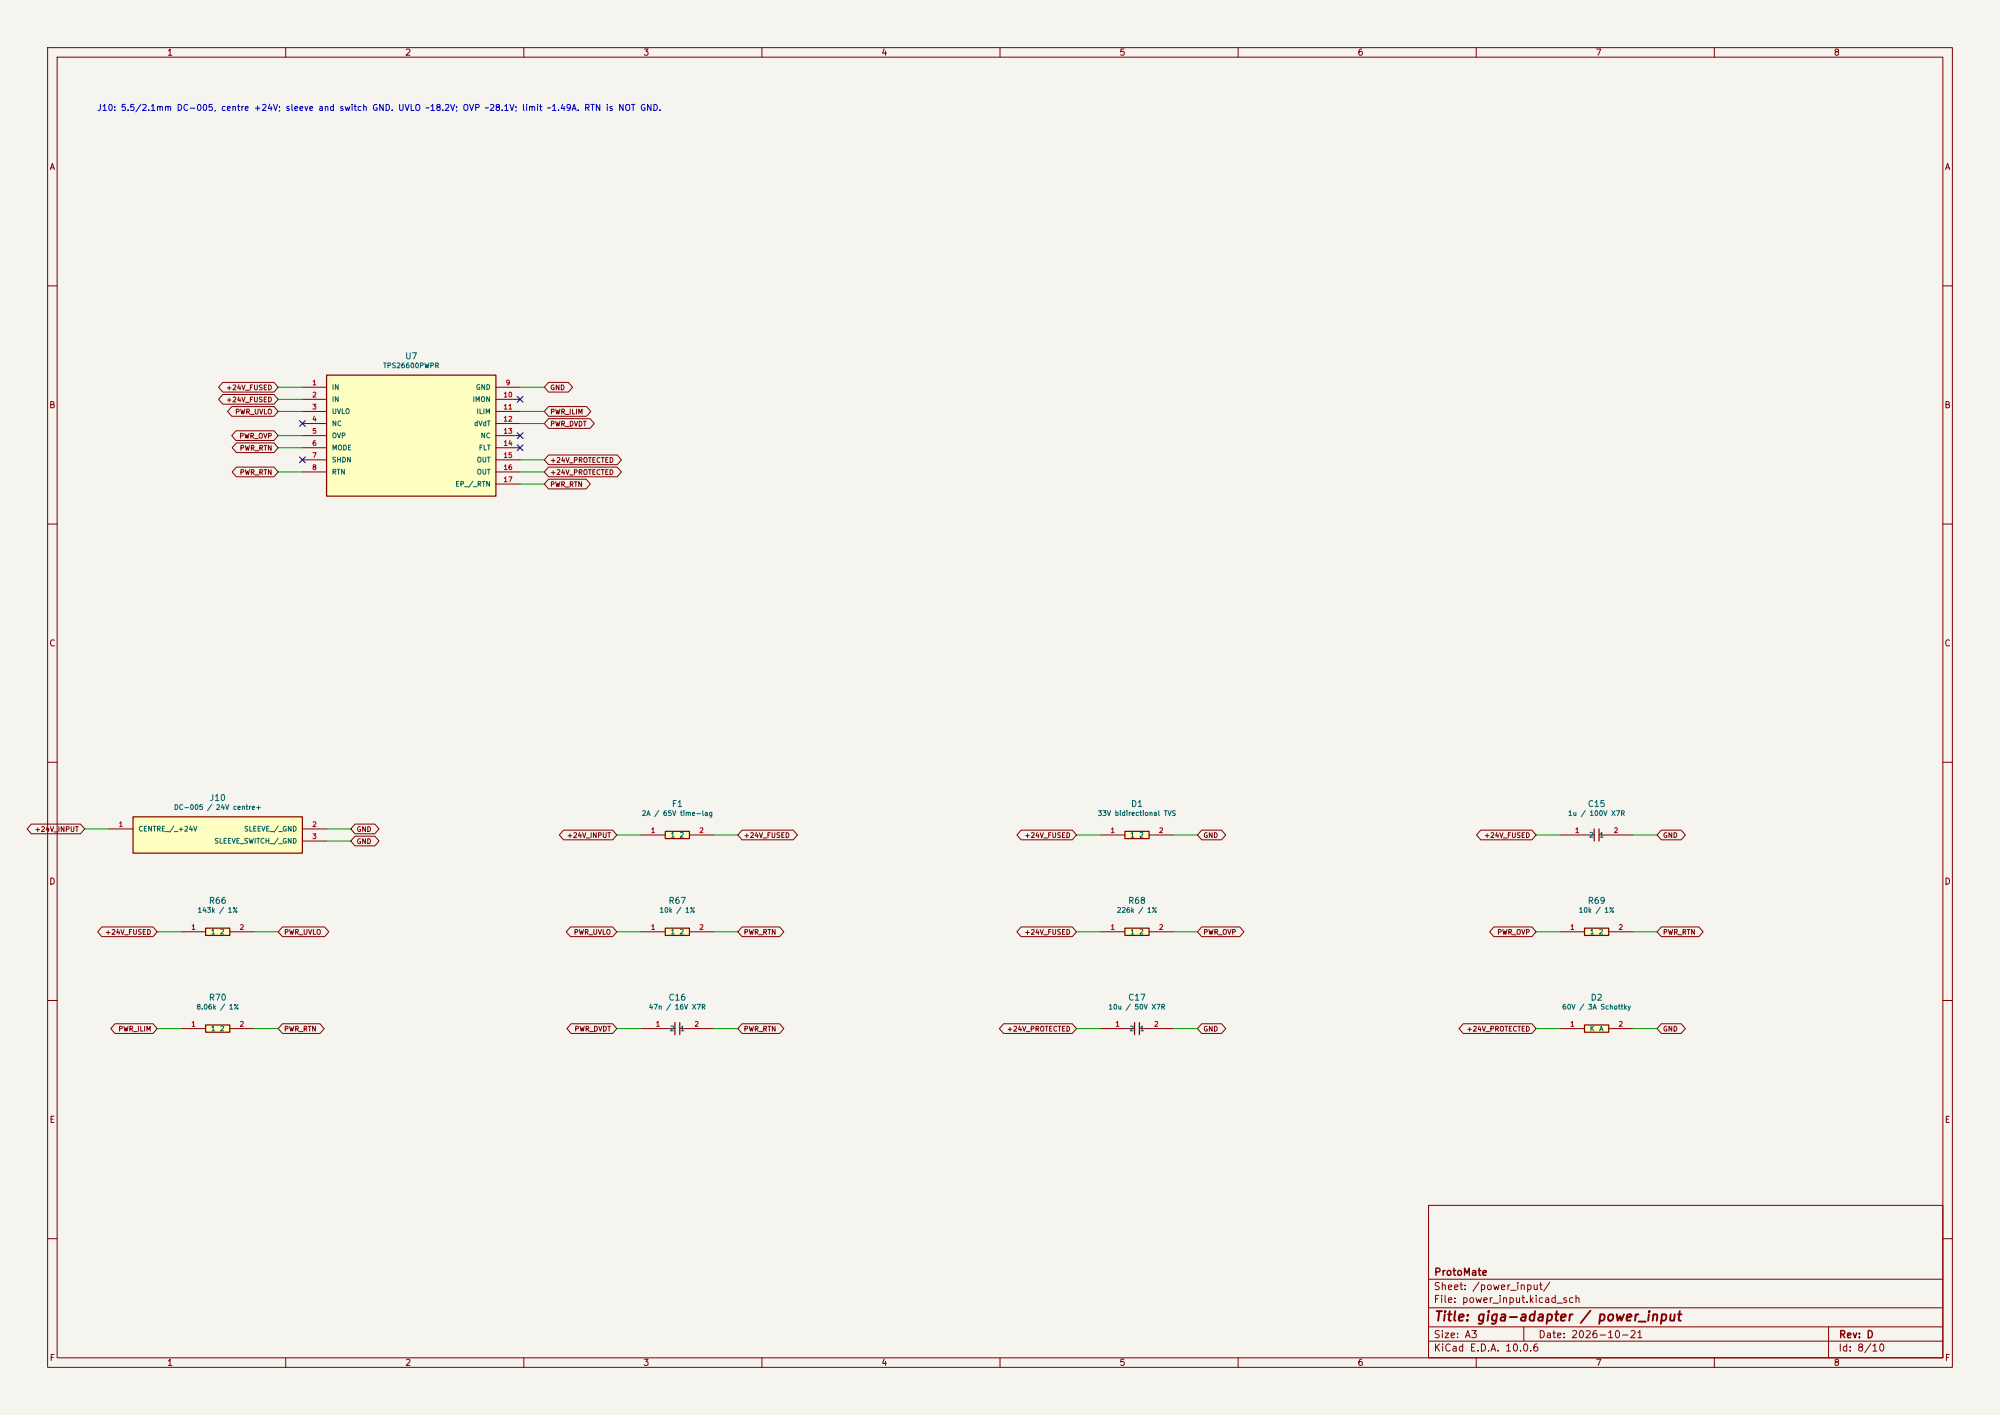
[picture p362: page 8]

J10: 5.5/2.1mm DC-005, centre +24V; sleeve and switch GND. UVLO ~18.2V; OVP ~28.1V; limit ~1.49A. RTN is NOT GND.

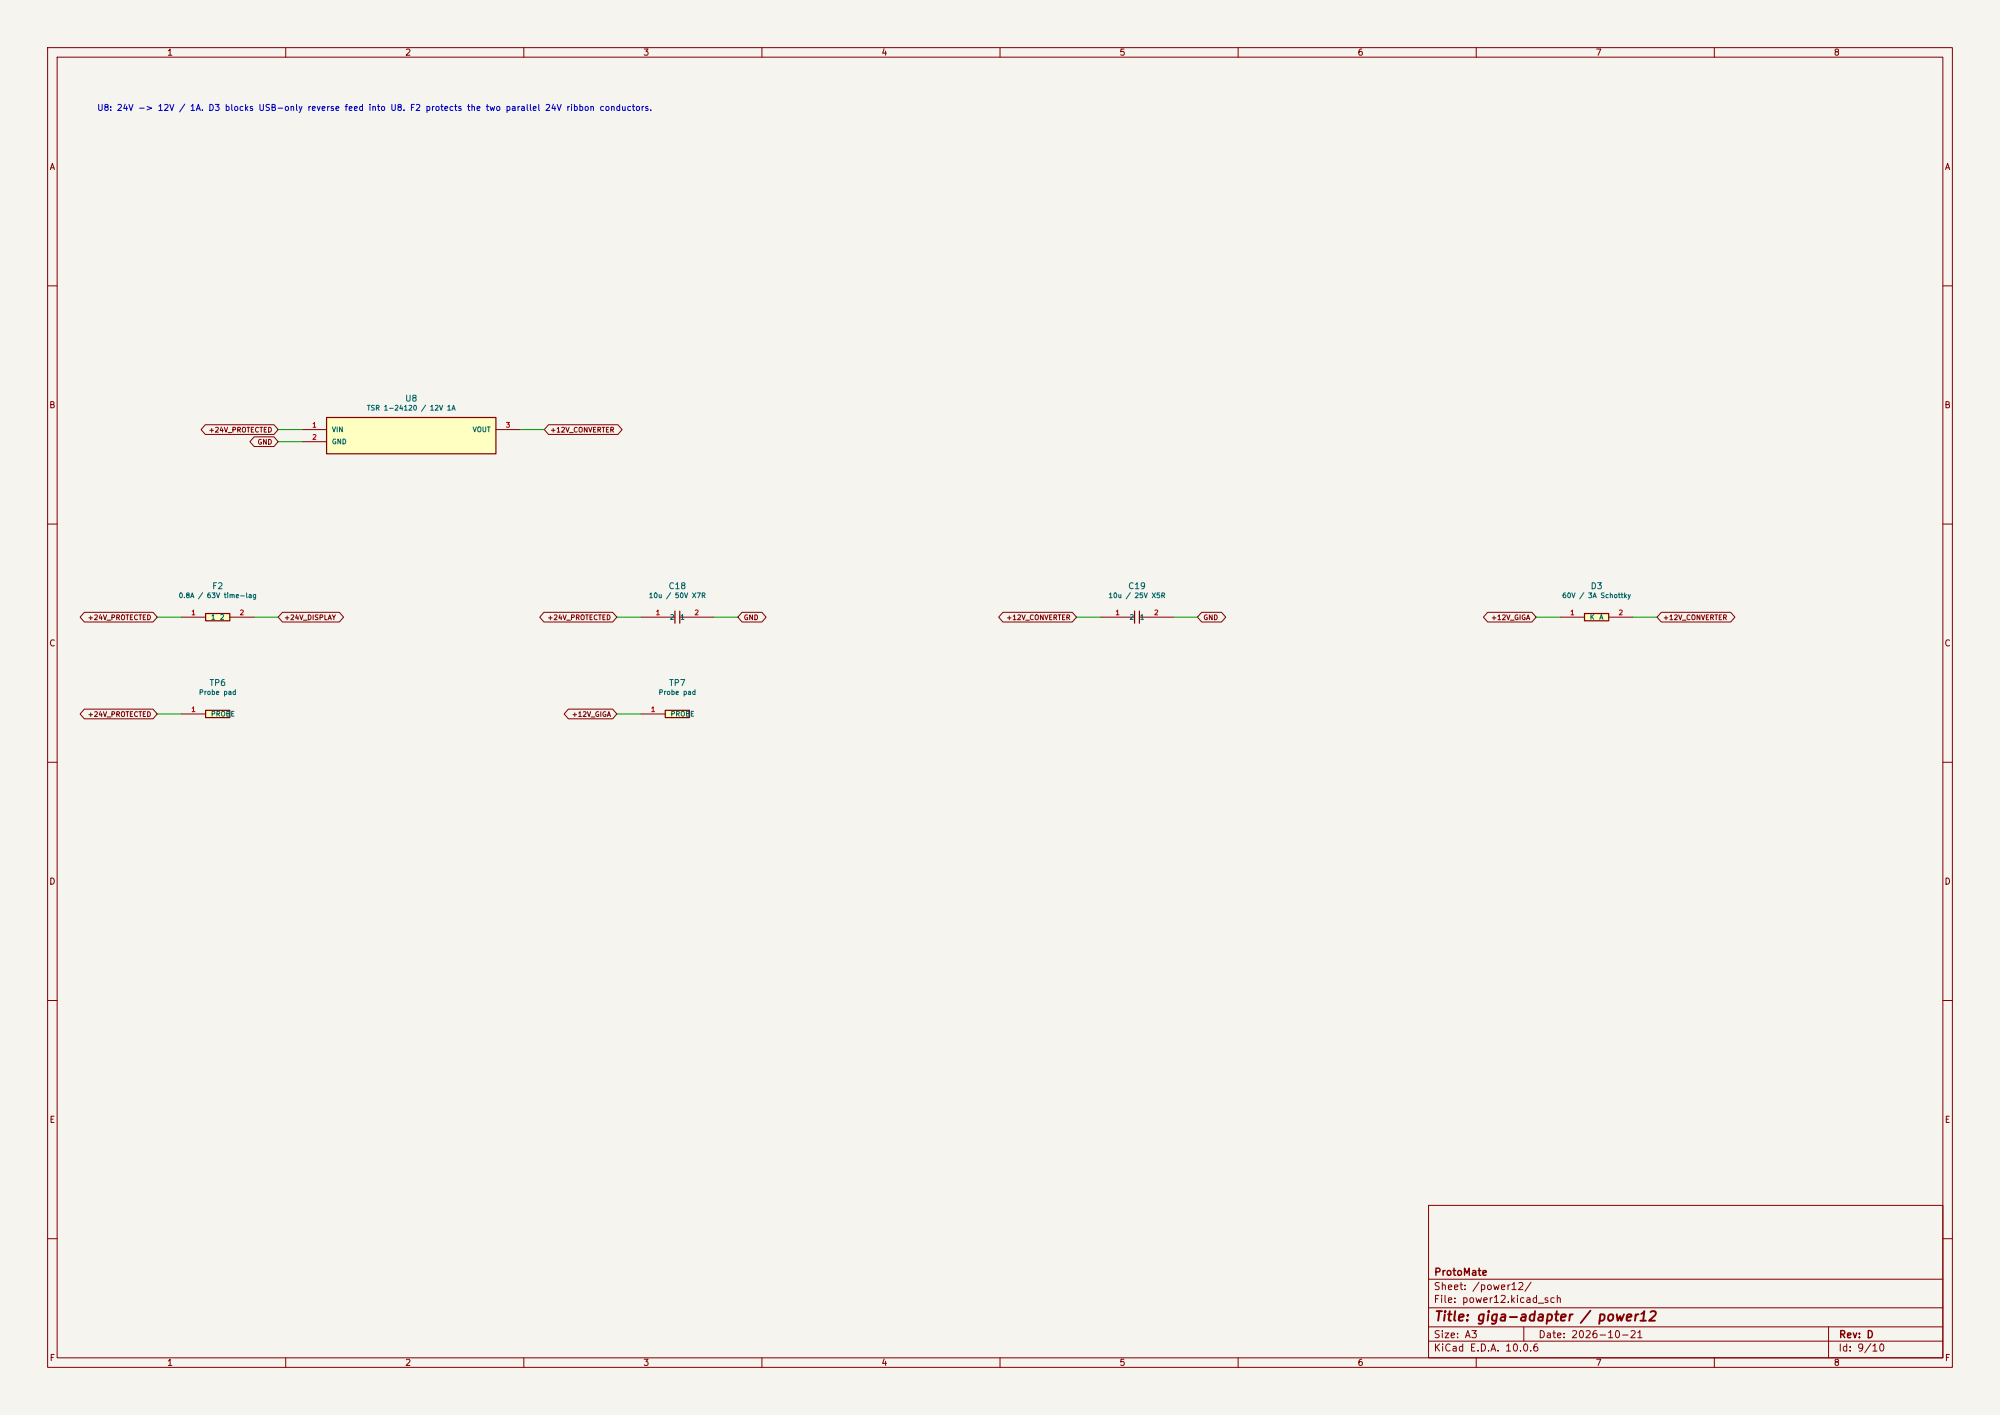
[picture p363: page 9]

U8: 24V -> 12V / 1A. D3 blocks USB-only reverse feed into U8. F2 protects the two parallel 24V ribbon conductors.

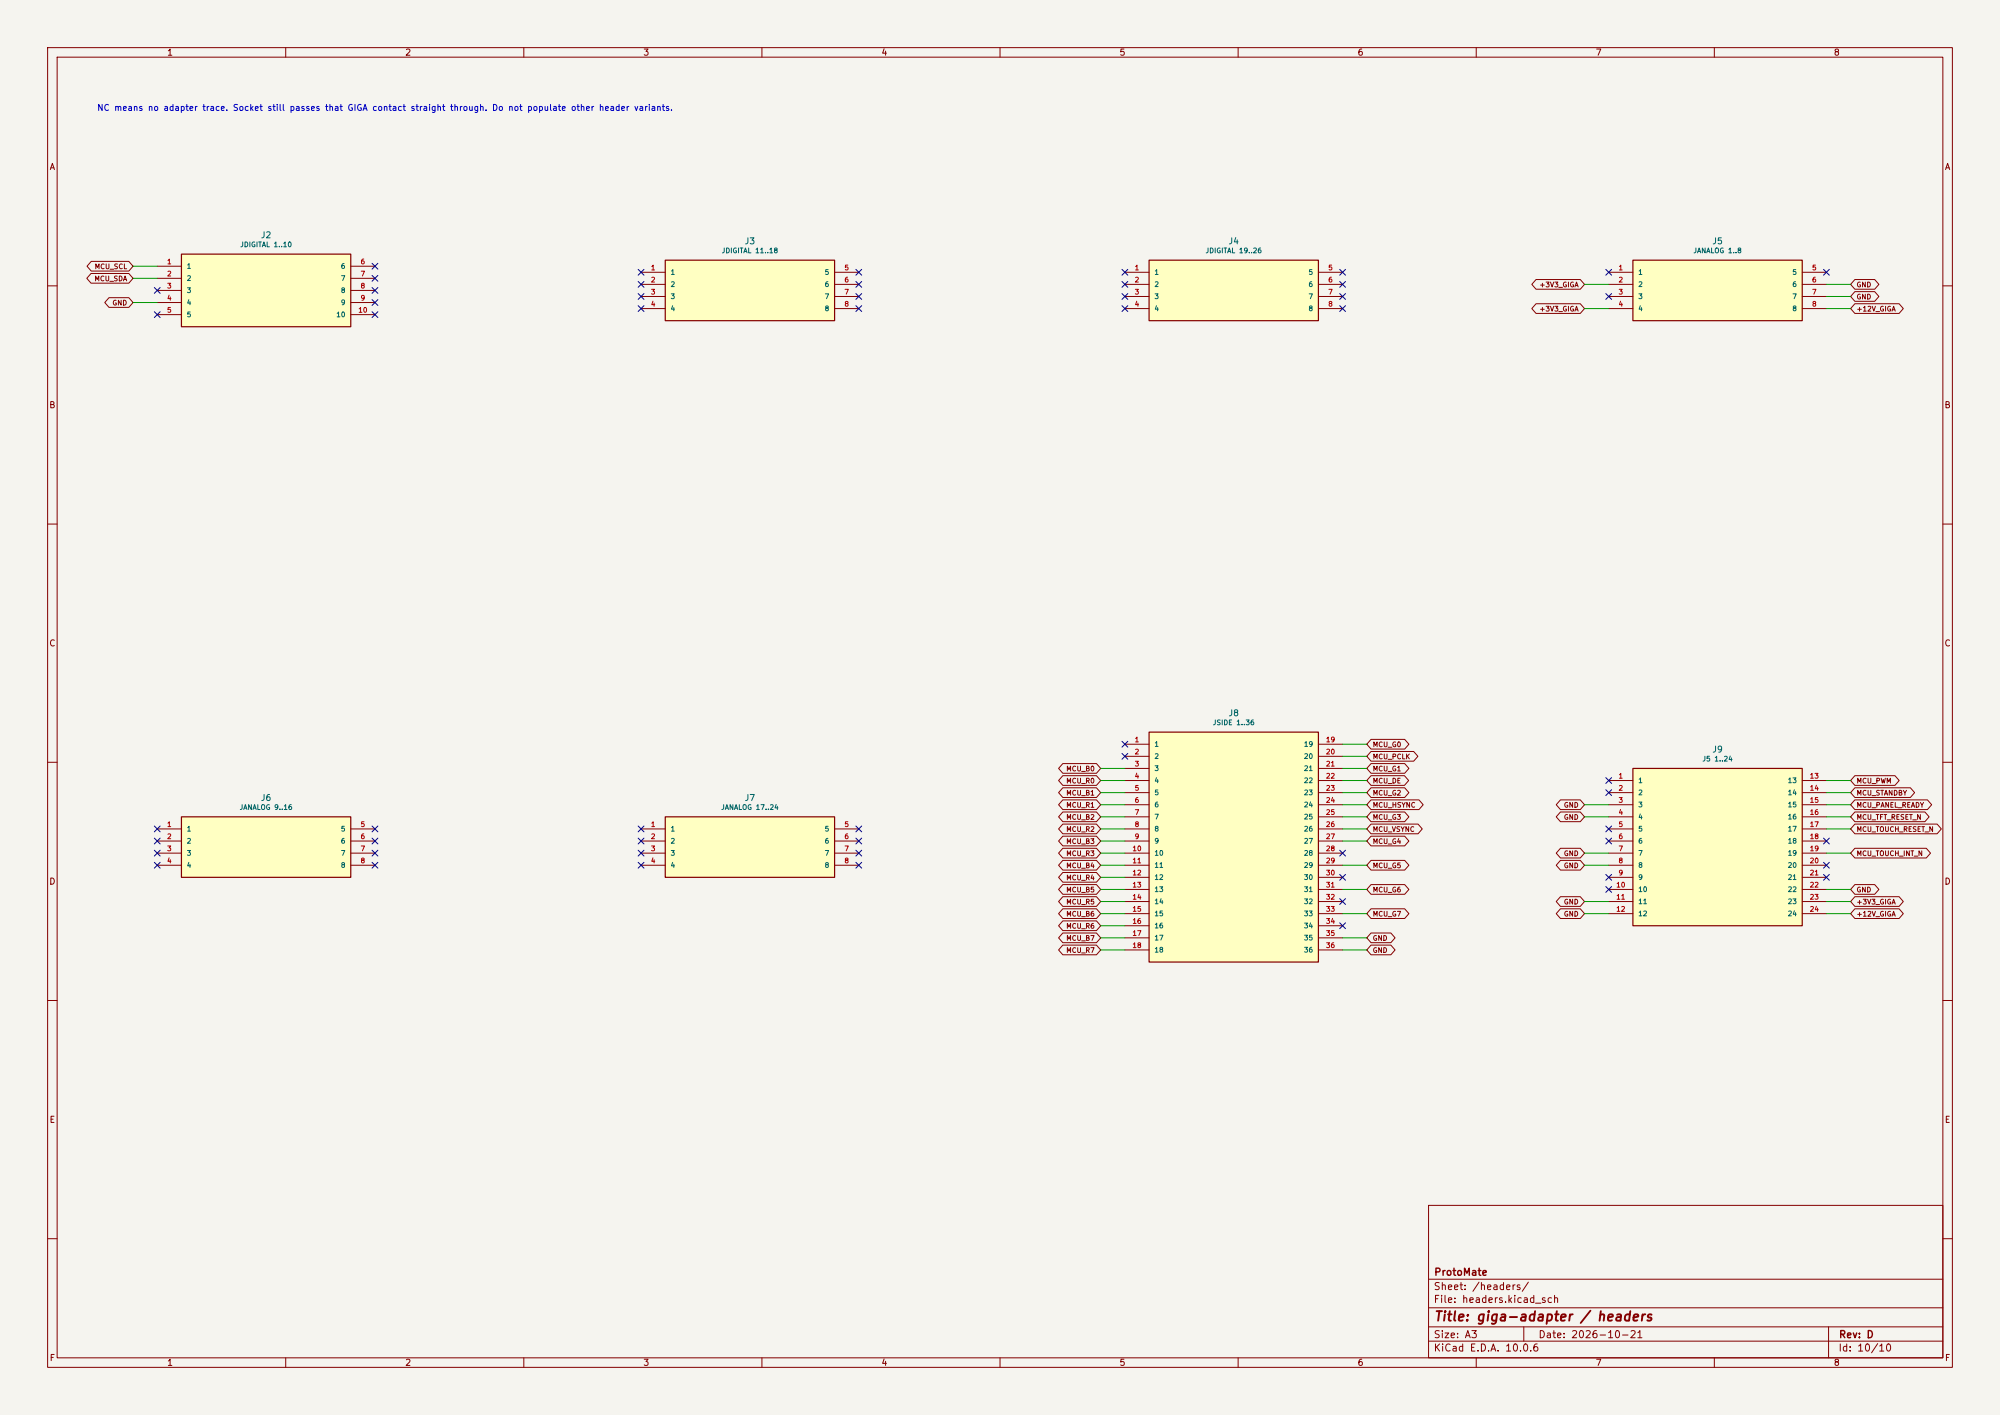
[picture p364: page 10]

ProtoMate
Sheet: /headers/
File: headers.kicad_sch
Title: giga-adapter / headers
