daleondev/ProtoMate_Control/hardware/display/manufacturing/display-adapter-rev-B/schematic.pdf

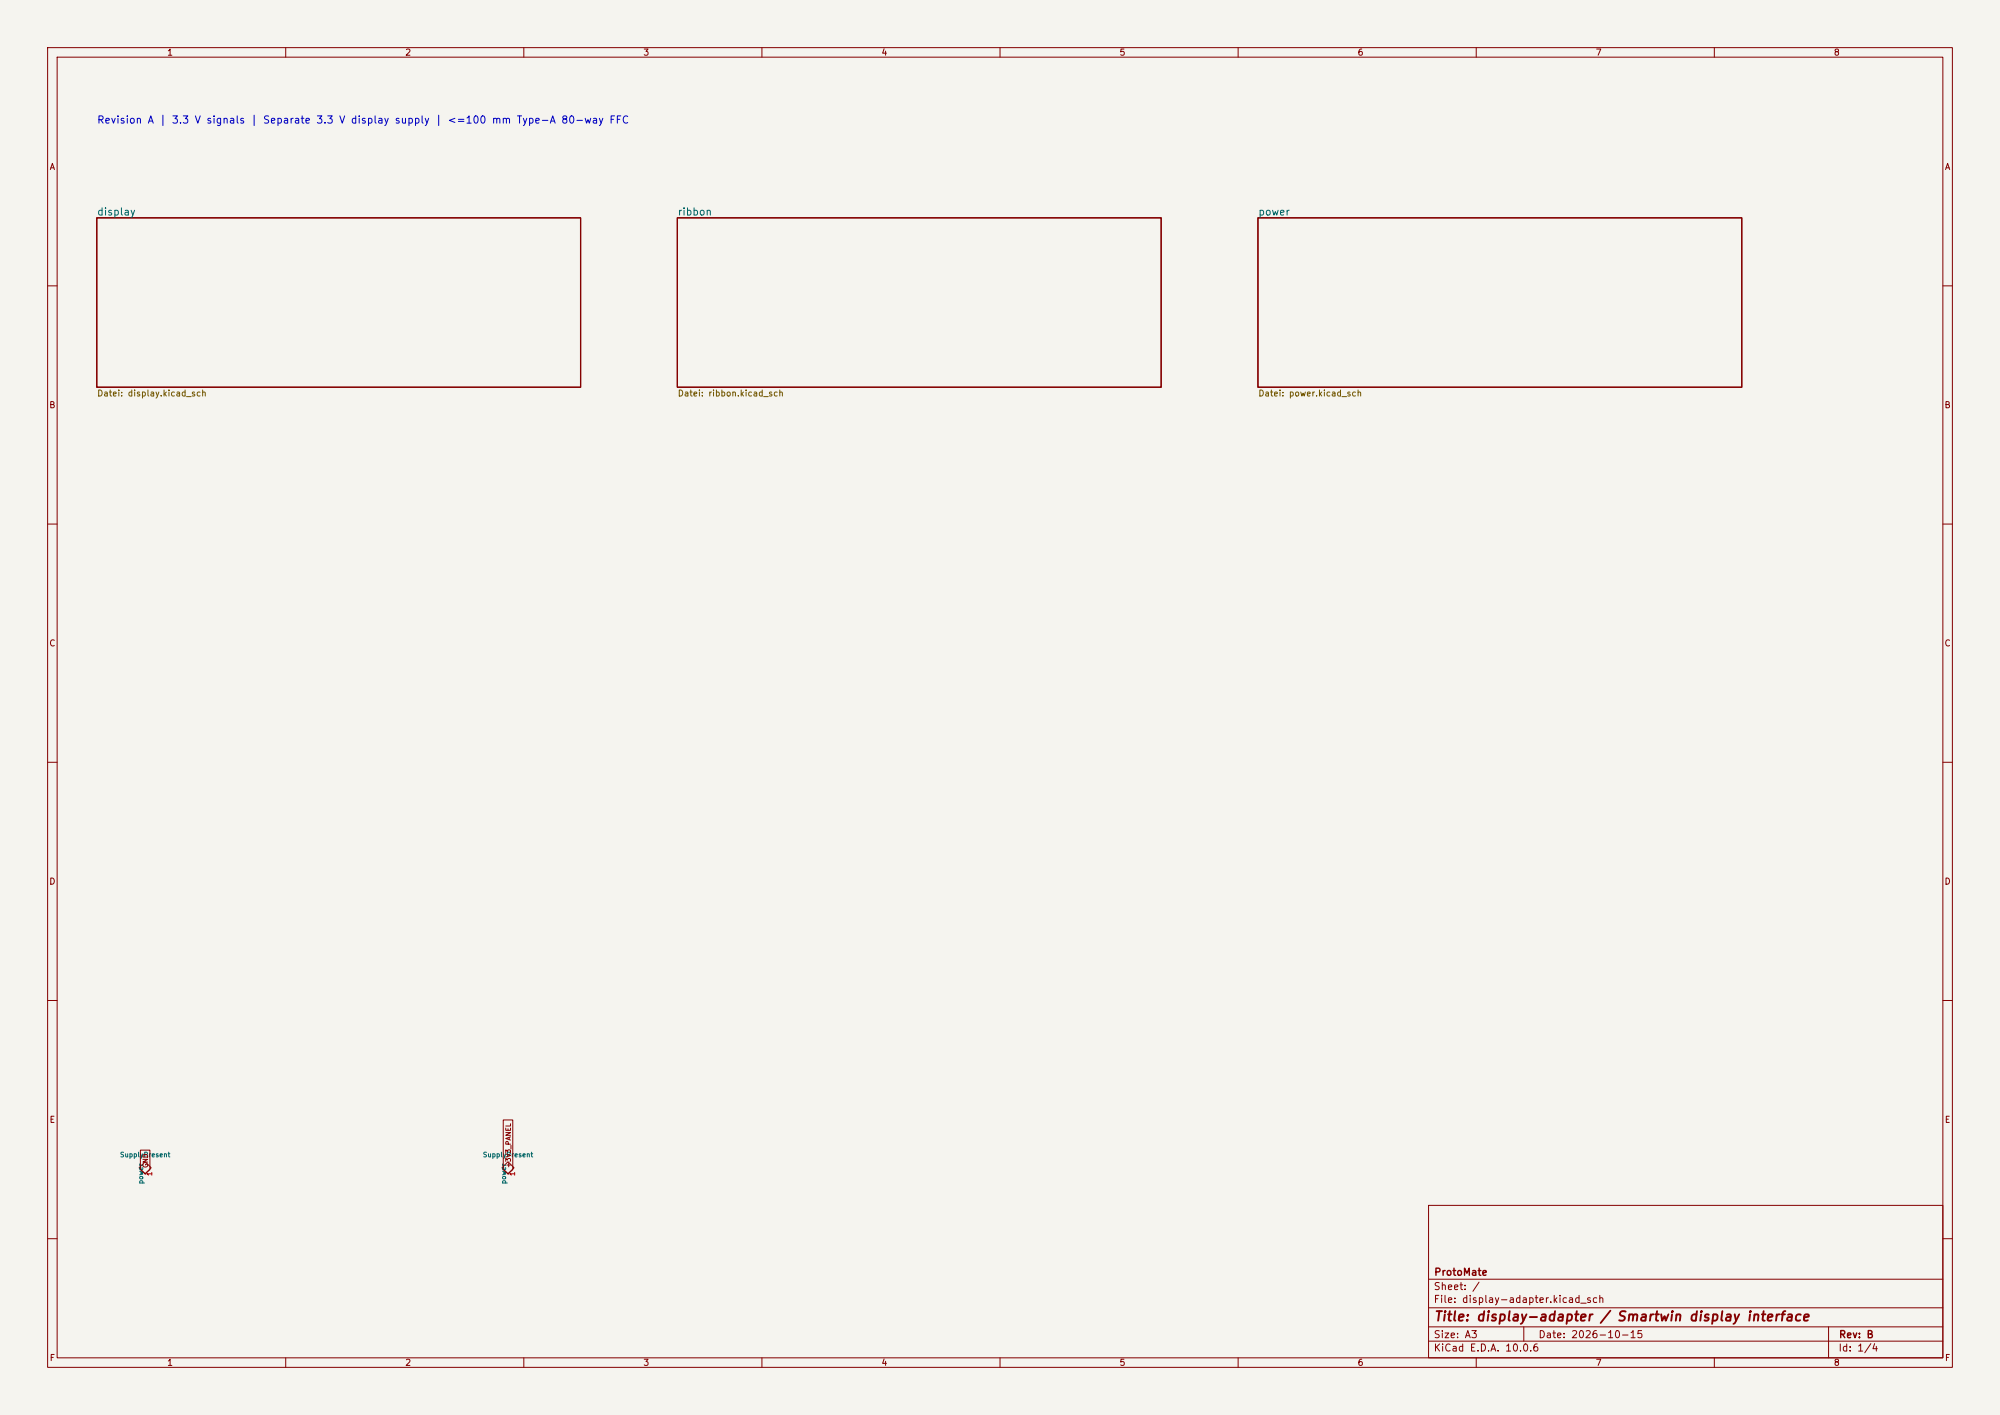
[picture p393: page 1]

Revision A | 3.3 V signals | Separate 3.3 V display supply | <=100 mm Type-A 80-way FFC

ProtoMate
Sheet: /
File: display-adapter.kicad_sch
Title: display-adapter / Smartwin display interface

Size: A3 | Rev: B | F Date: 2026-10-15
KiCad E.D.A. 10.0.6 | Id: 1/4

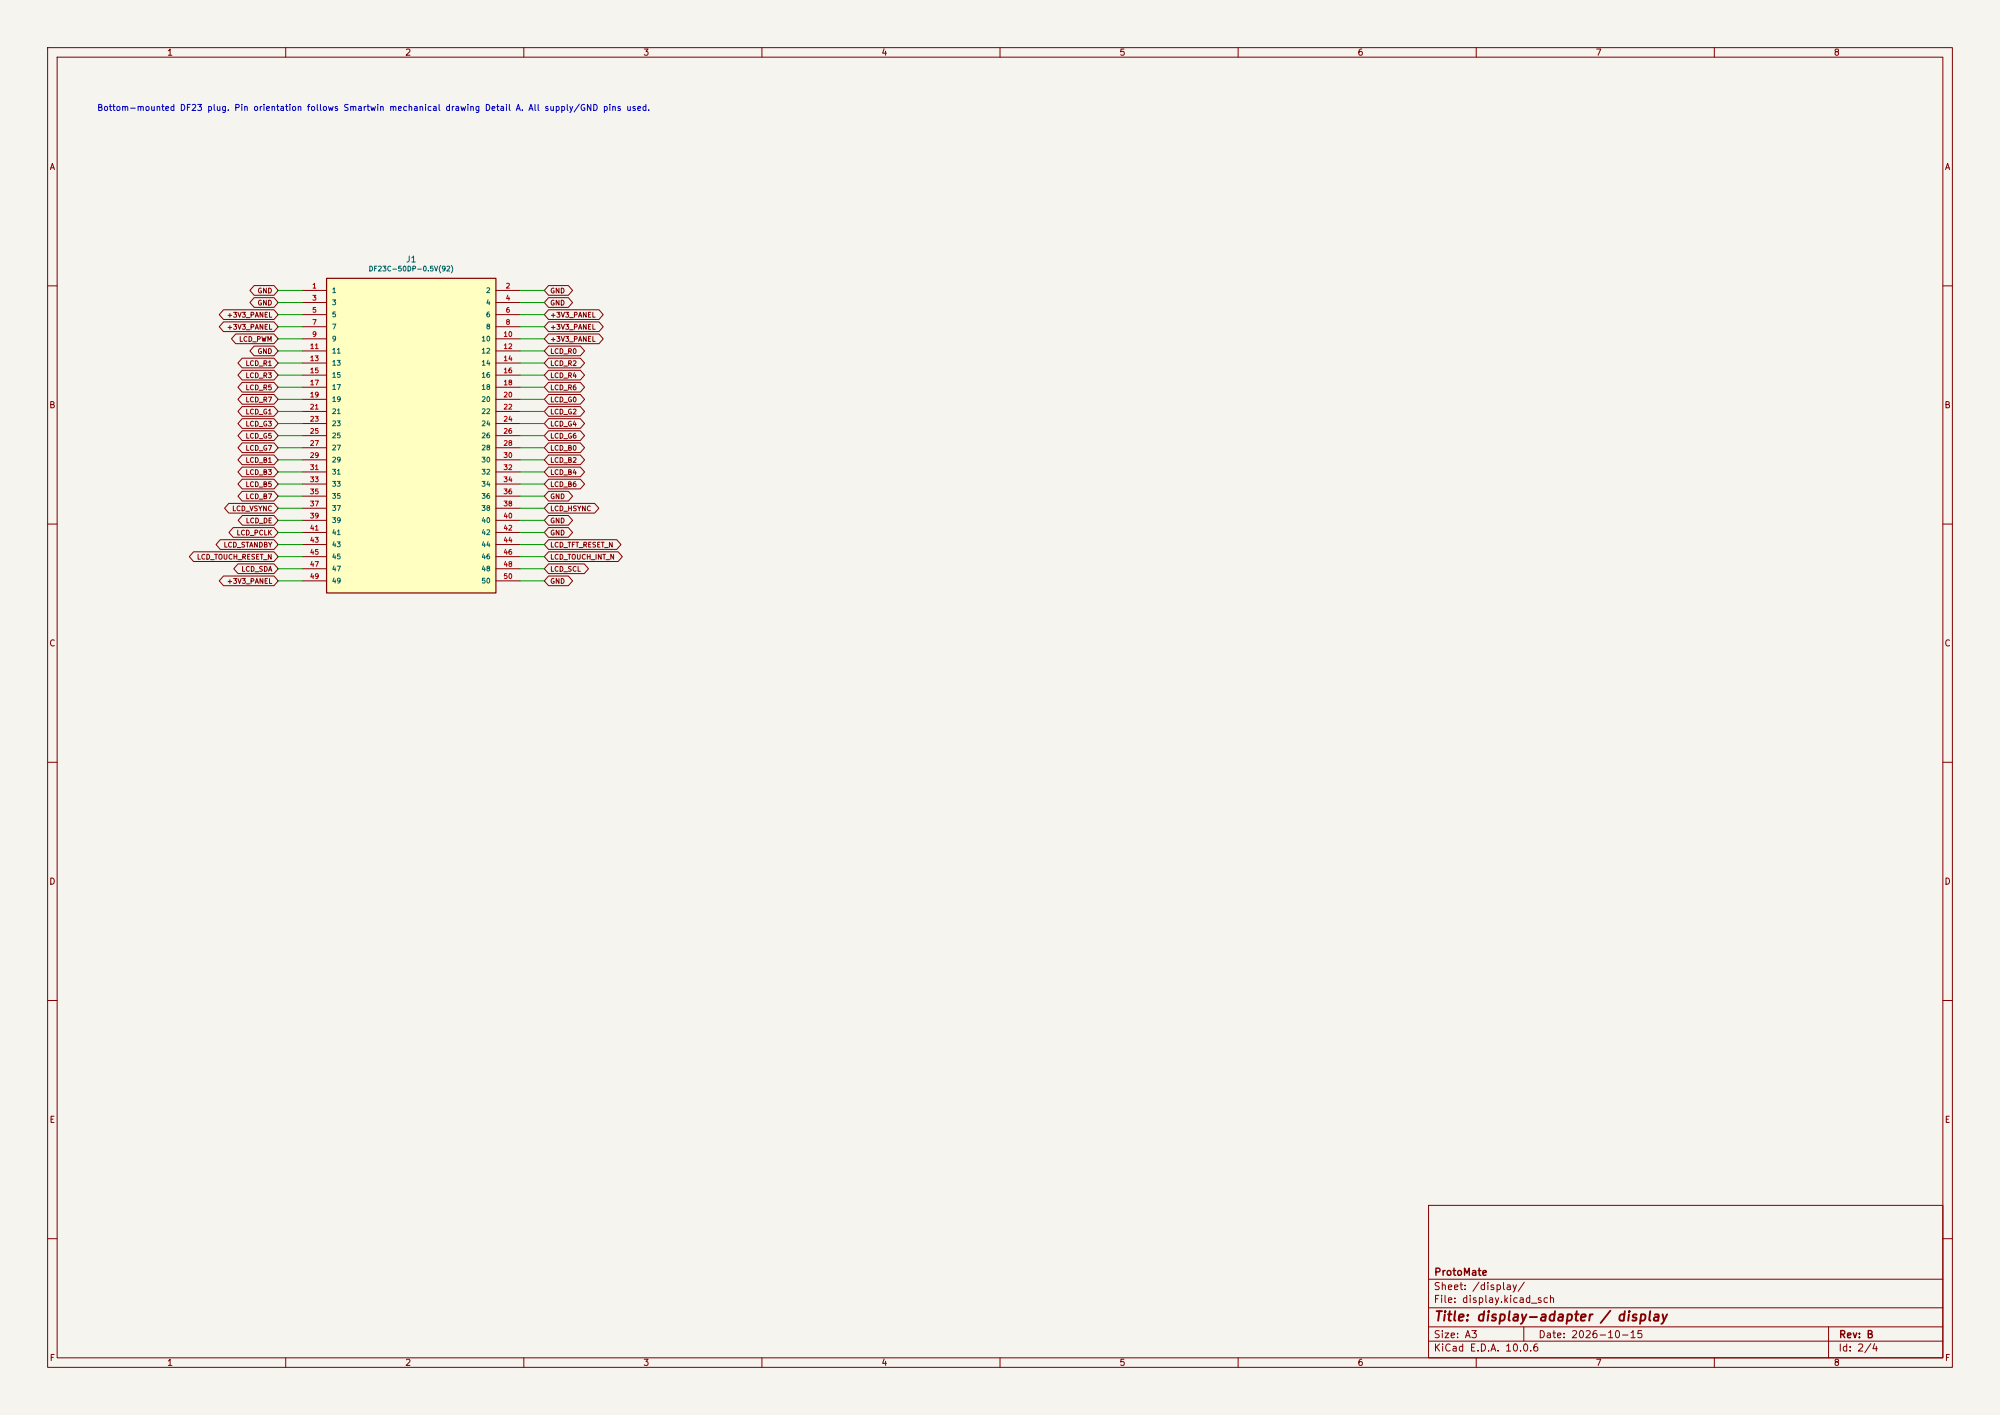
[picture p394: page 2]

LCD_R0 Bottom-mounted DF23 plug. Pin orientation follows Smartwin mechanical drawing Detail A. All supply/GND pins used.

ProtoMate
Sheet: /display/
File: display.kicad_sch
Title: display-adapter / display

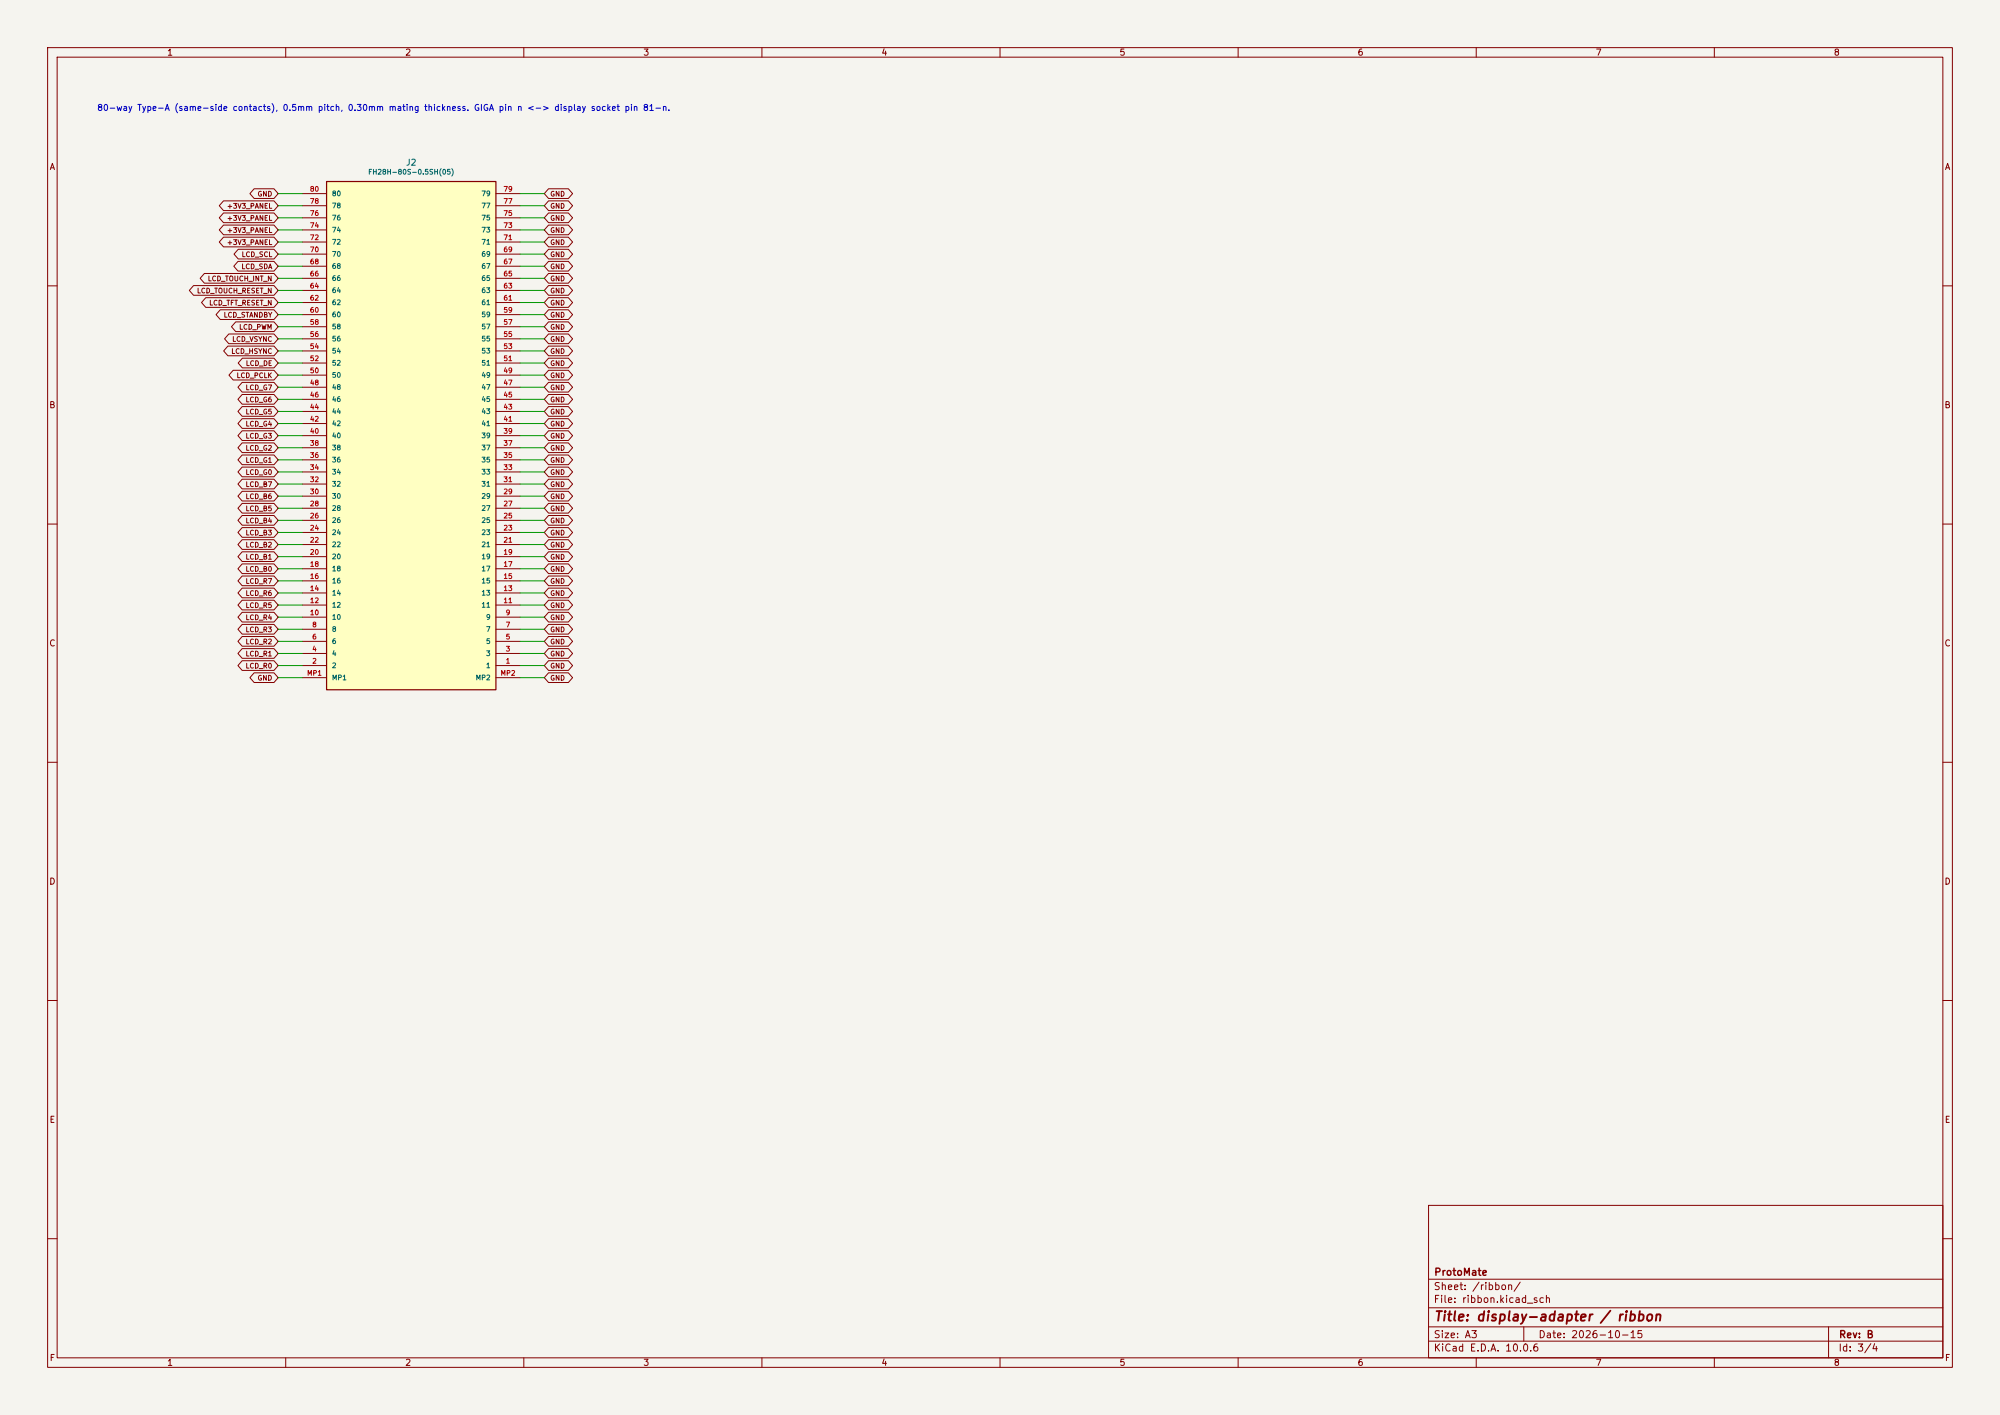
[picture p395: page 3]

LCD_G5 80-way Type-A (same-side contacts), 0.5mm pitch, 0.30mm mating thickness. GIGA pin n <-> display socket pin 81-n.
LCD_G3 GND +3V3_PANEL +3V3_PANEL +3V3_PANEL +3V3_PANEL

ProtoMate
Sheet: /ribbon/
File: ribbon.kicad_sch
Title: display-adapter / ribbon

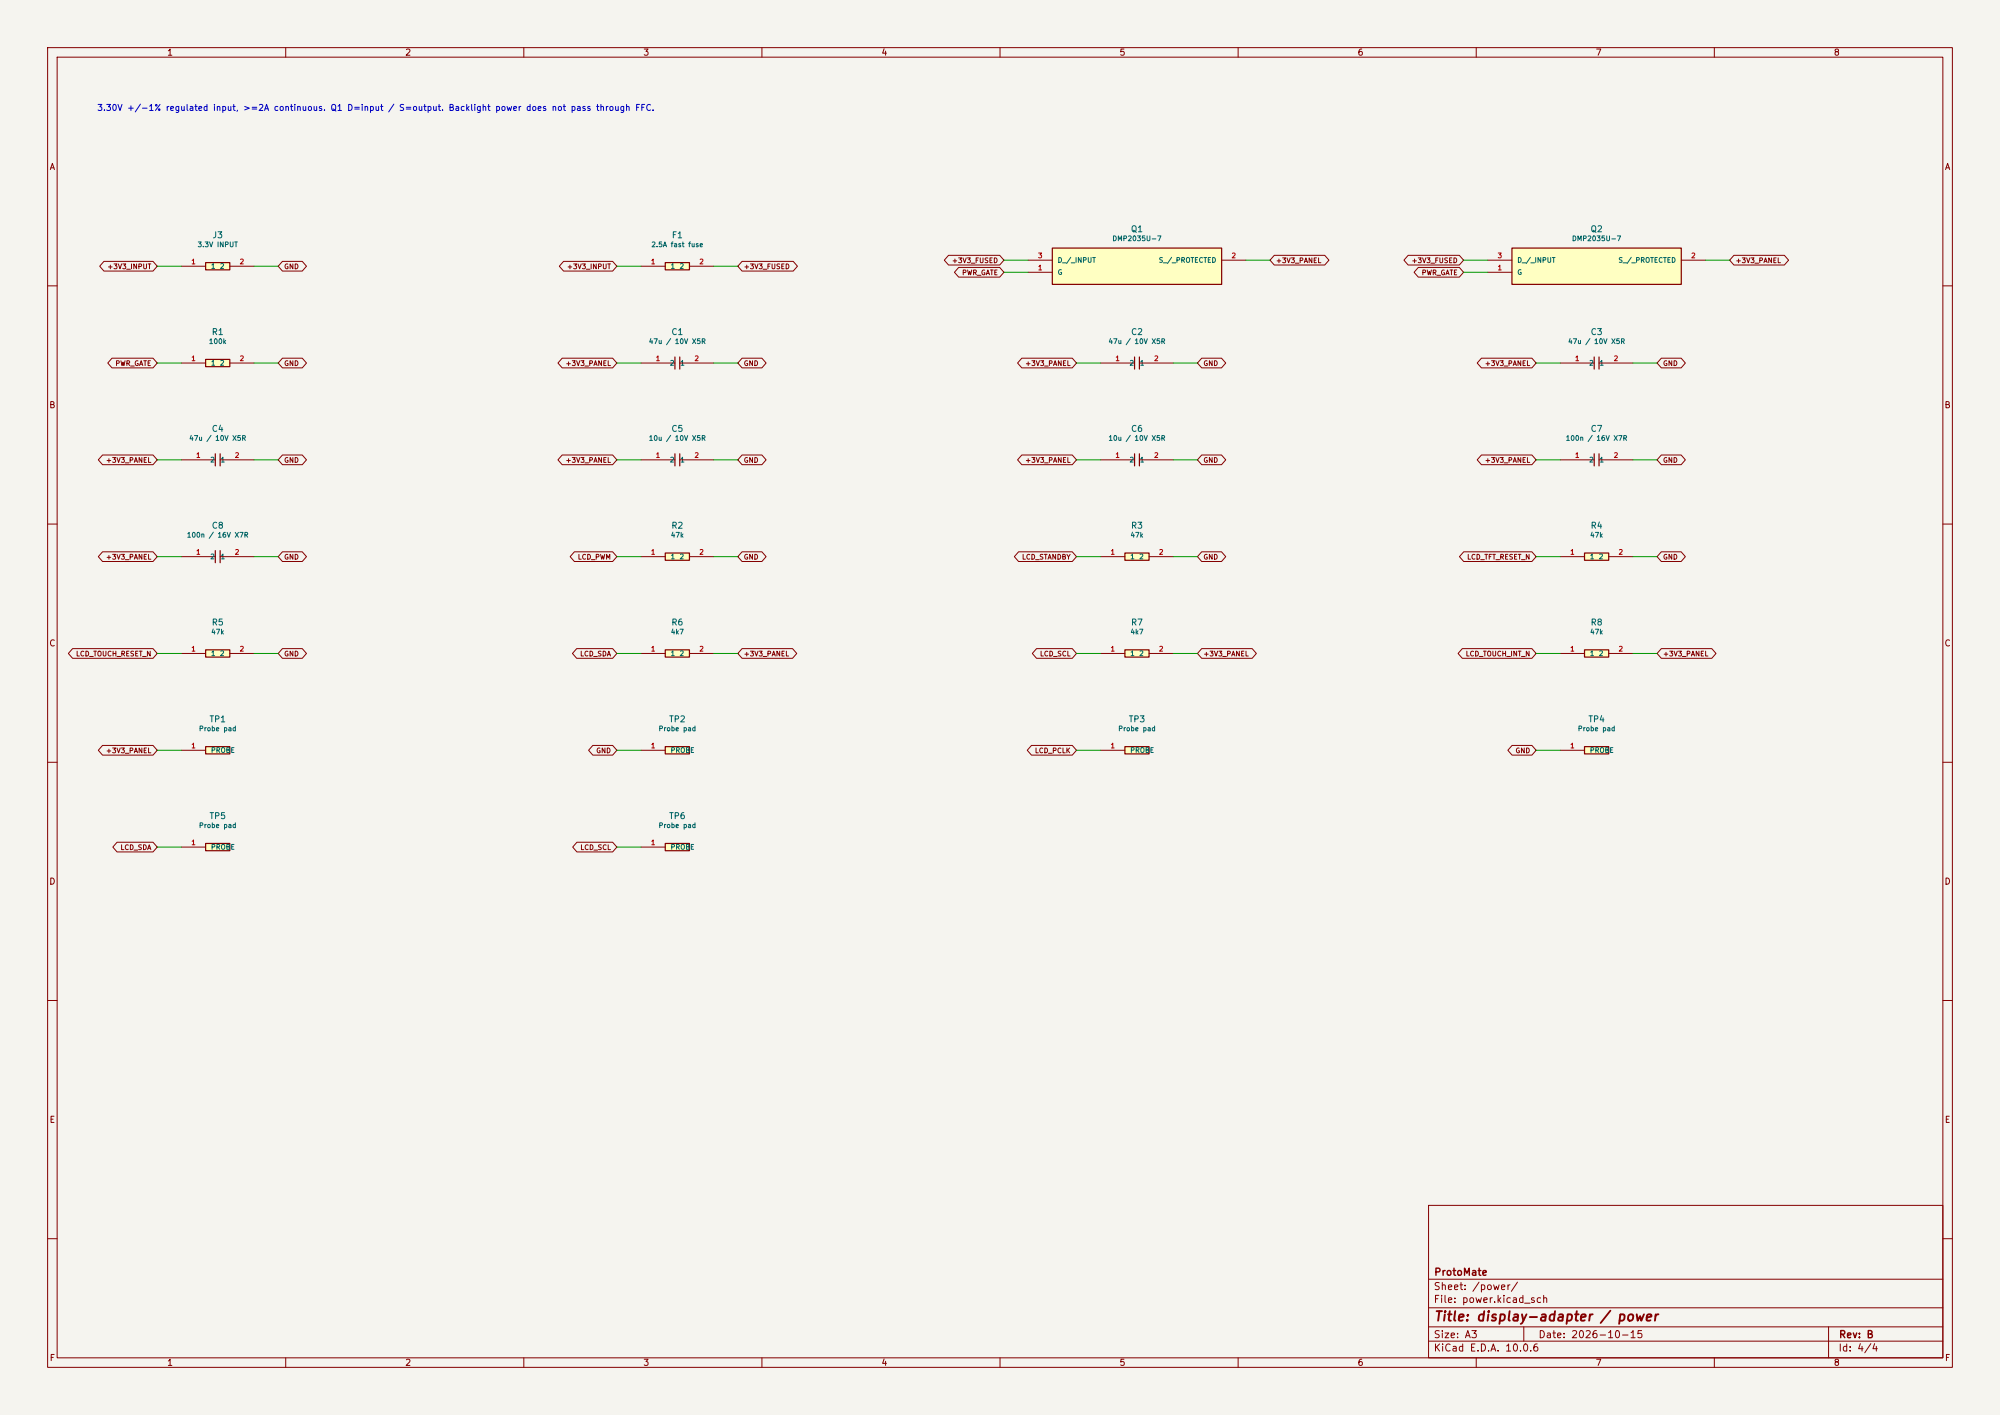
[picture p396: page 4]

ProtoMate
Sheet: /power/
File: power.kicad_sch
Title: display-adapter / power
