daleondev/ProtoMate_Control/hardware/display/manufacturing/giga-adapter-rev-A/schematic.pdf

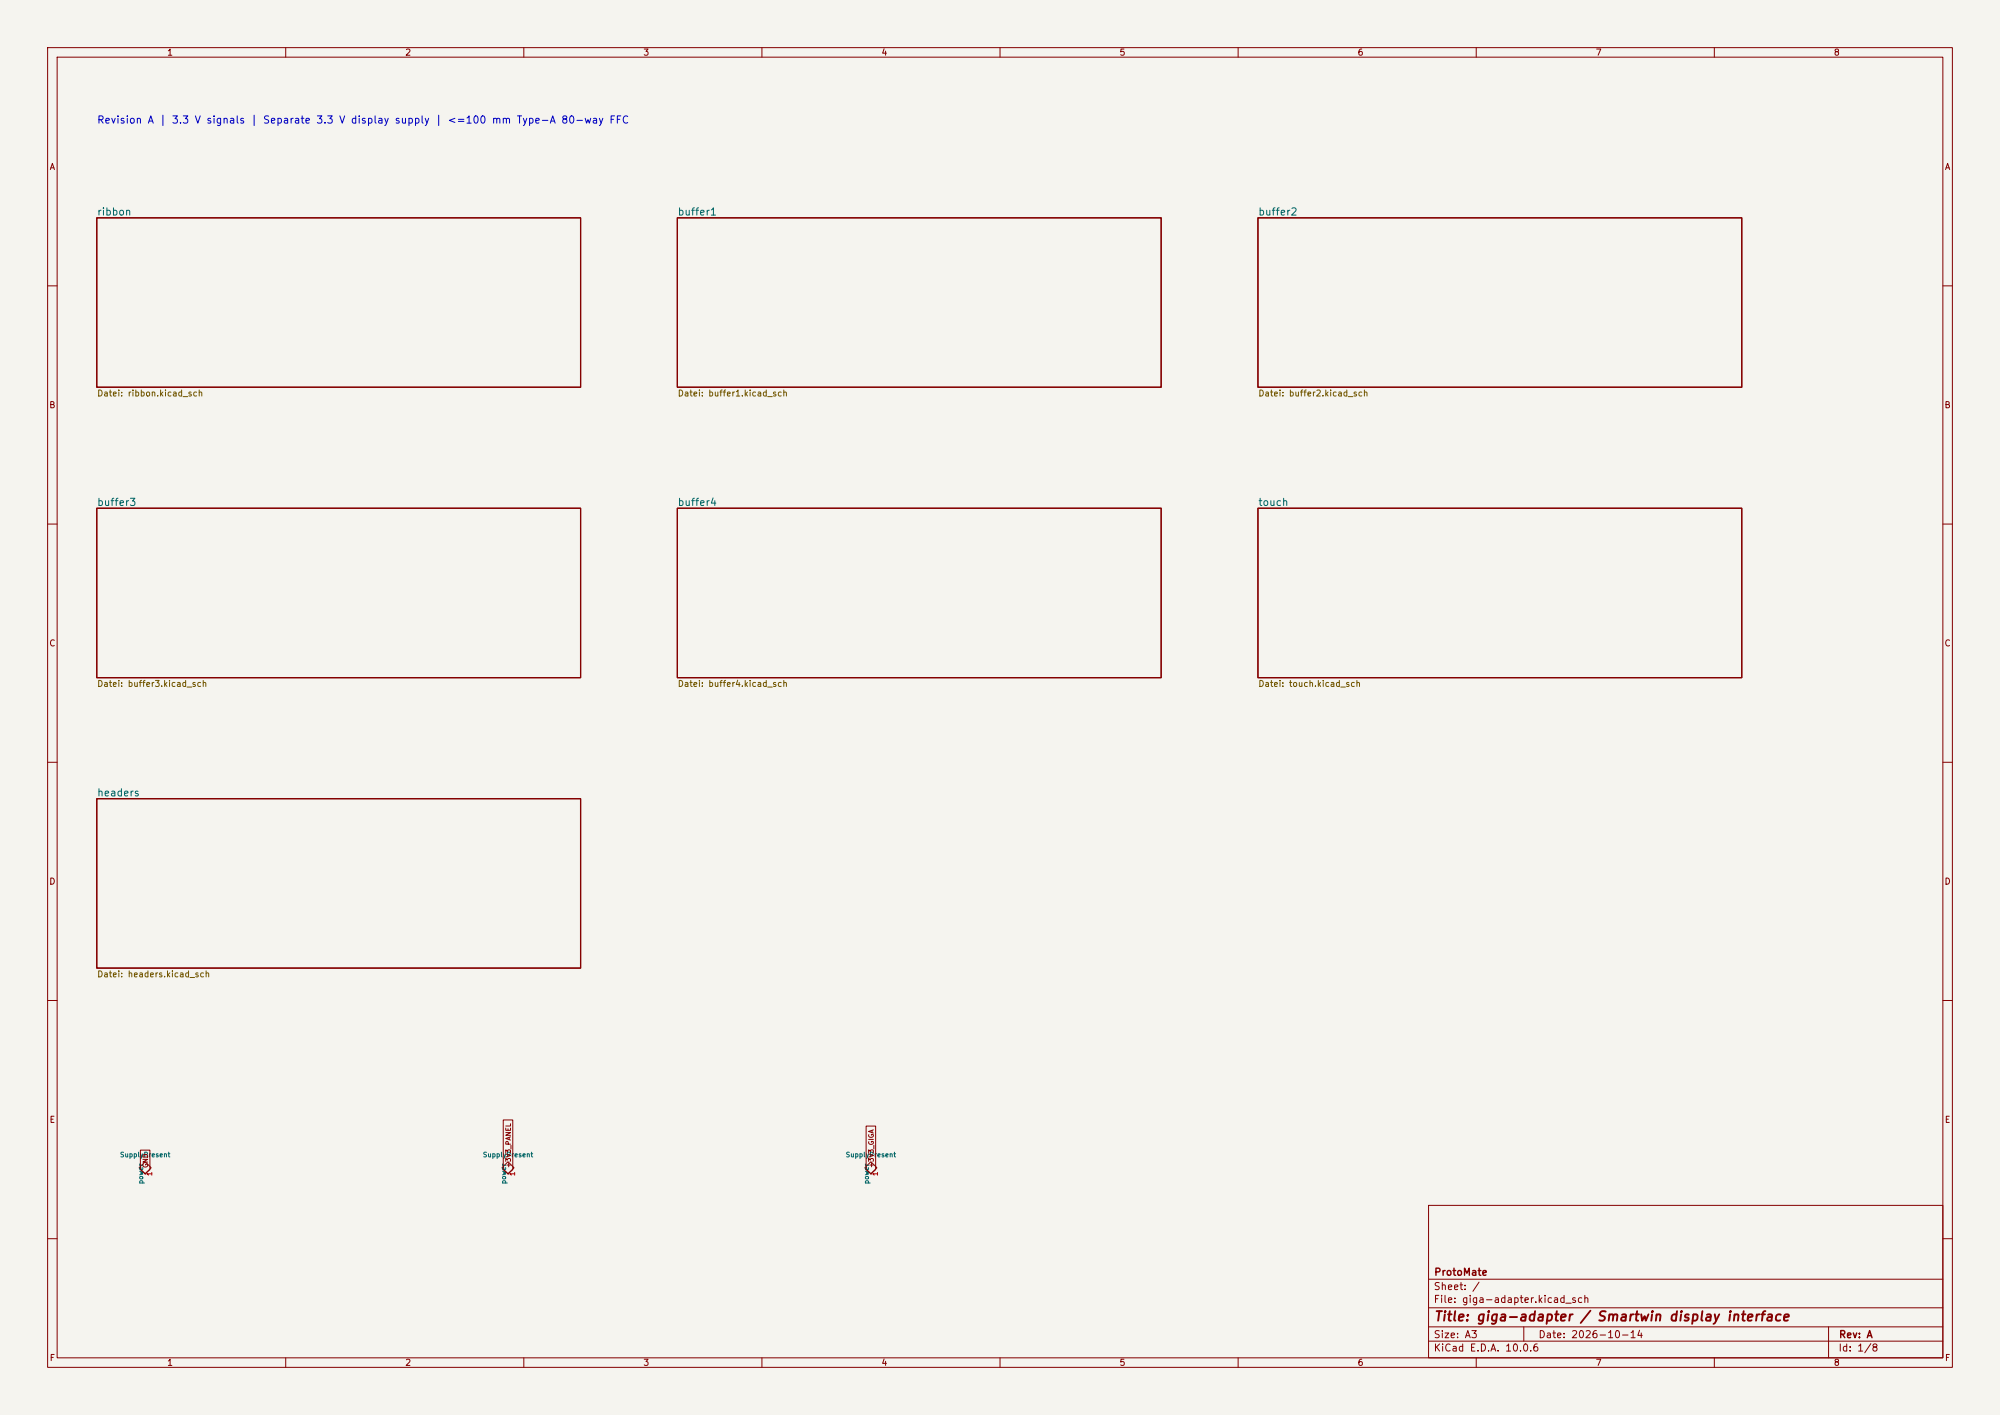
[picture p401: page 1]

Revision A | 3.3 V signals | Separate 3.3 V display supply | <=100 mm Type-A 80-way FFC

Datei: buffer3.kicad_sch headers Datei: headers.kicad_sch

ProtoMate
Sheet: /
File: giga-adapter.kicad_sch
Title: giga-adapter / Smartwin display interface

Size: A3 | Rev: A | F Date: 2026-10-14
KiCad E.D.A. 10.0.6 | Id: 1/8

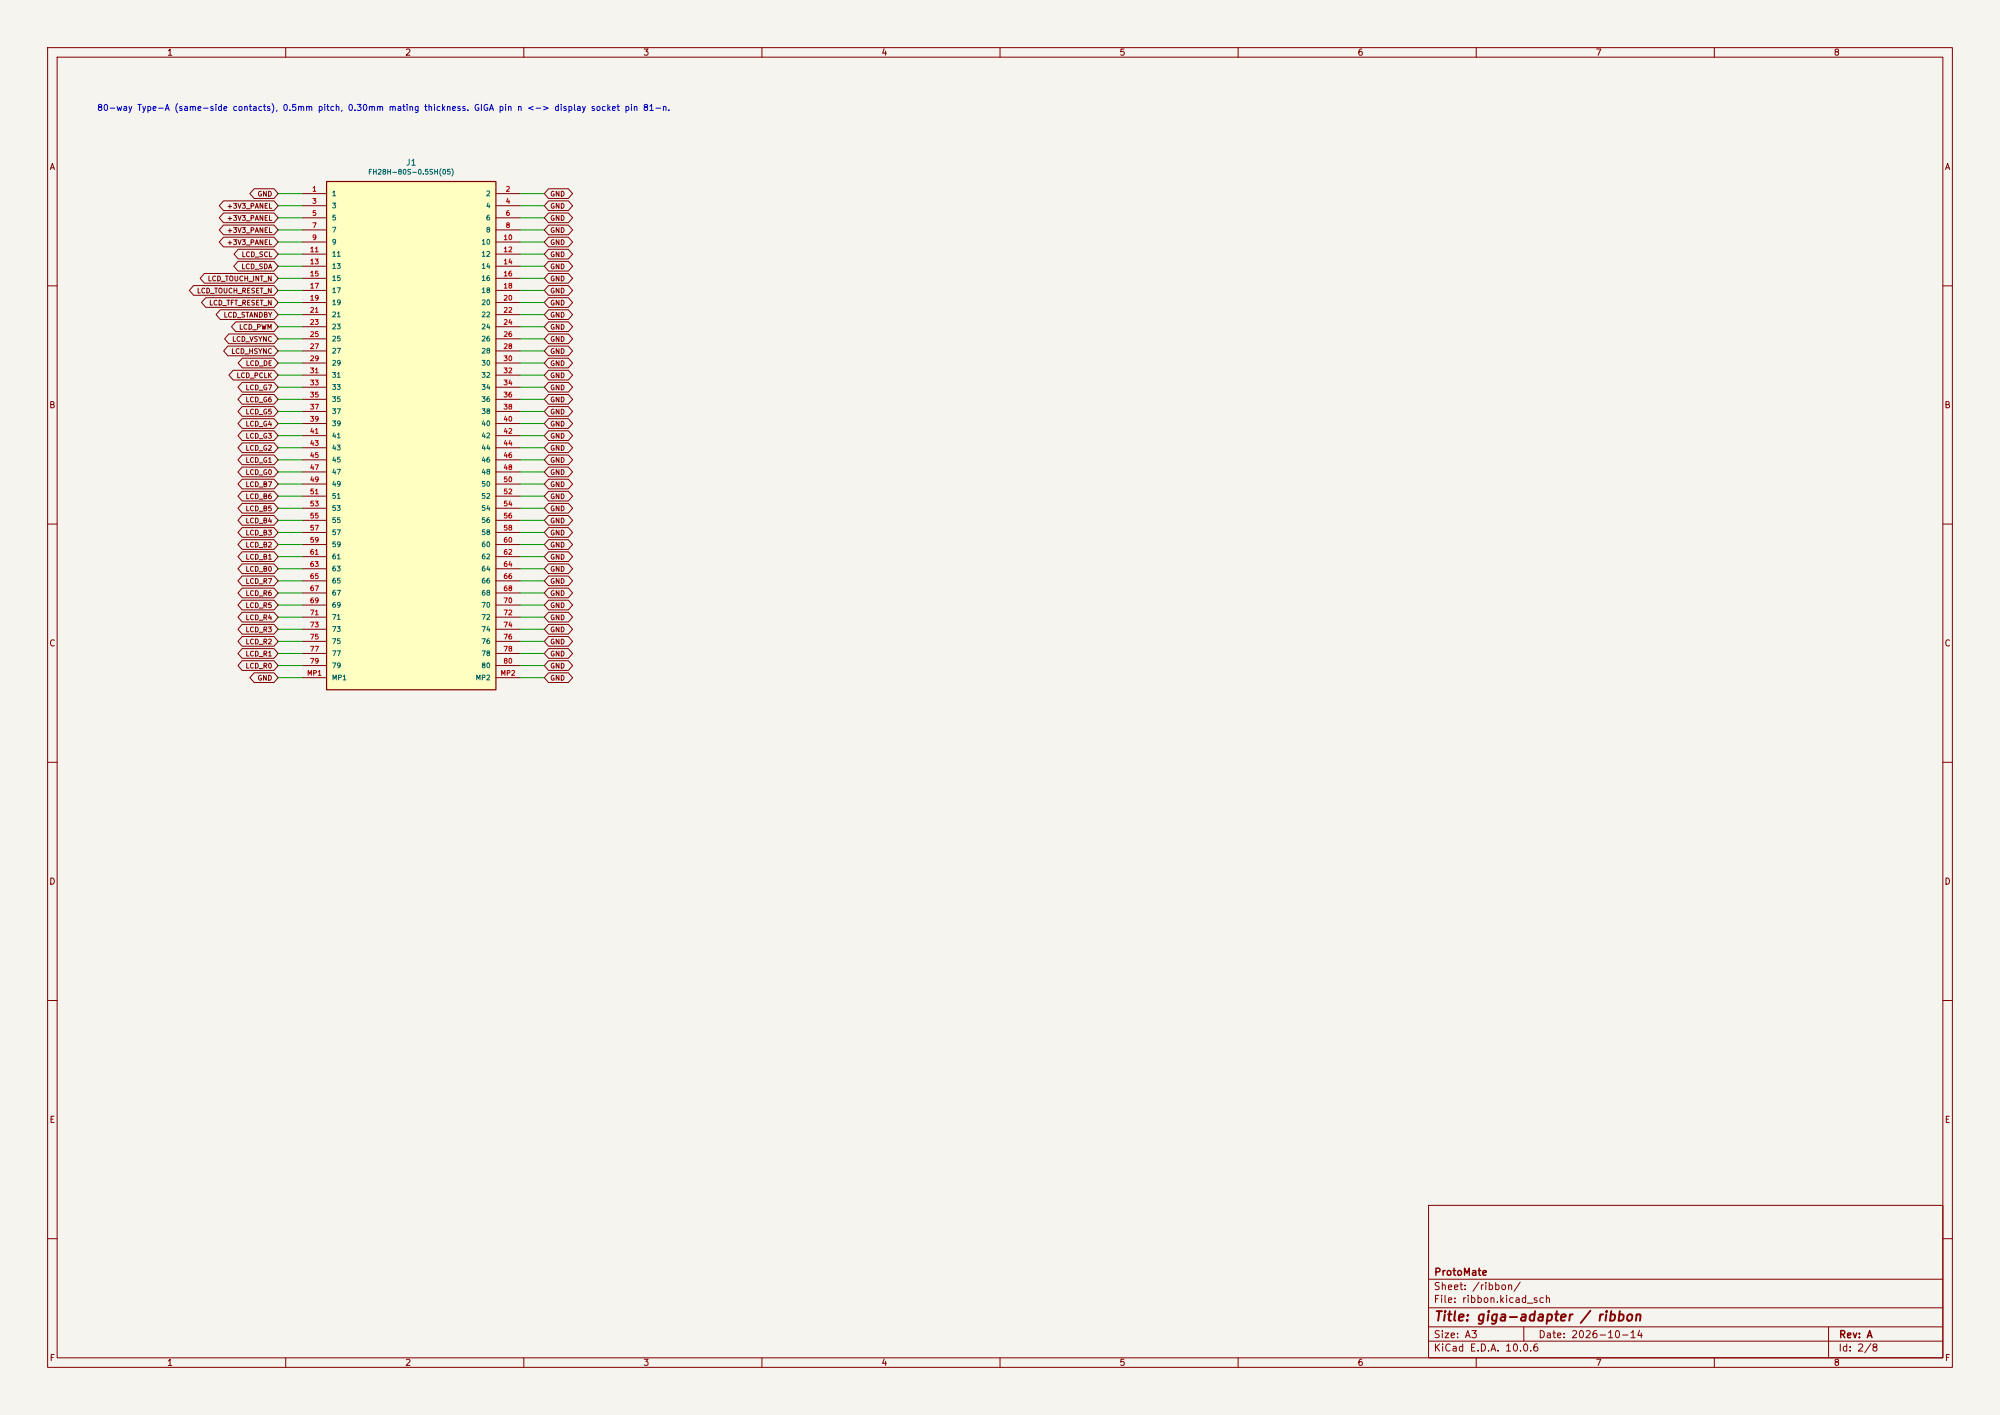
[picture p402: page 2]

LCD_G5 80-way Type-A (same-side contacts), 0.5mm pitch, 0.30mm mating thickness. GIGA pin n <-> display socket pin 81-n.
LCD_G3 GND +3V3_PANEL +3V3_PANEL +3V3_PANEL +3V3_PANEL

ProtoMate
Sheet: /ribbon/
File: ribbon.kicad_sch
Title: giga-adapter / ribbon

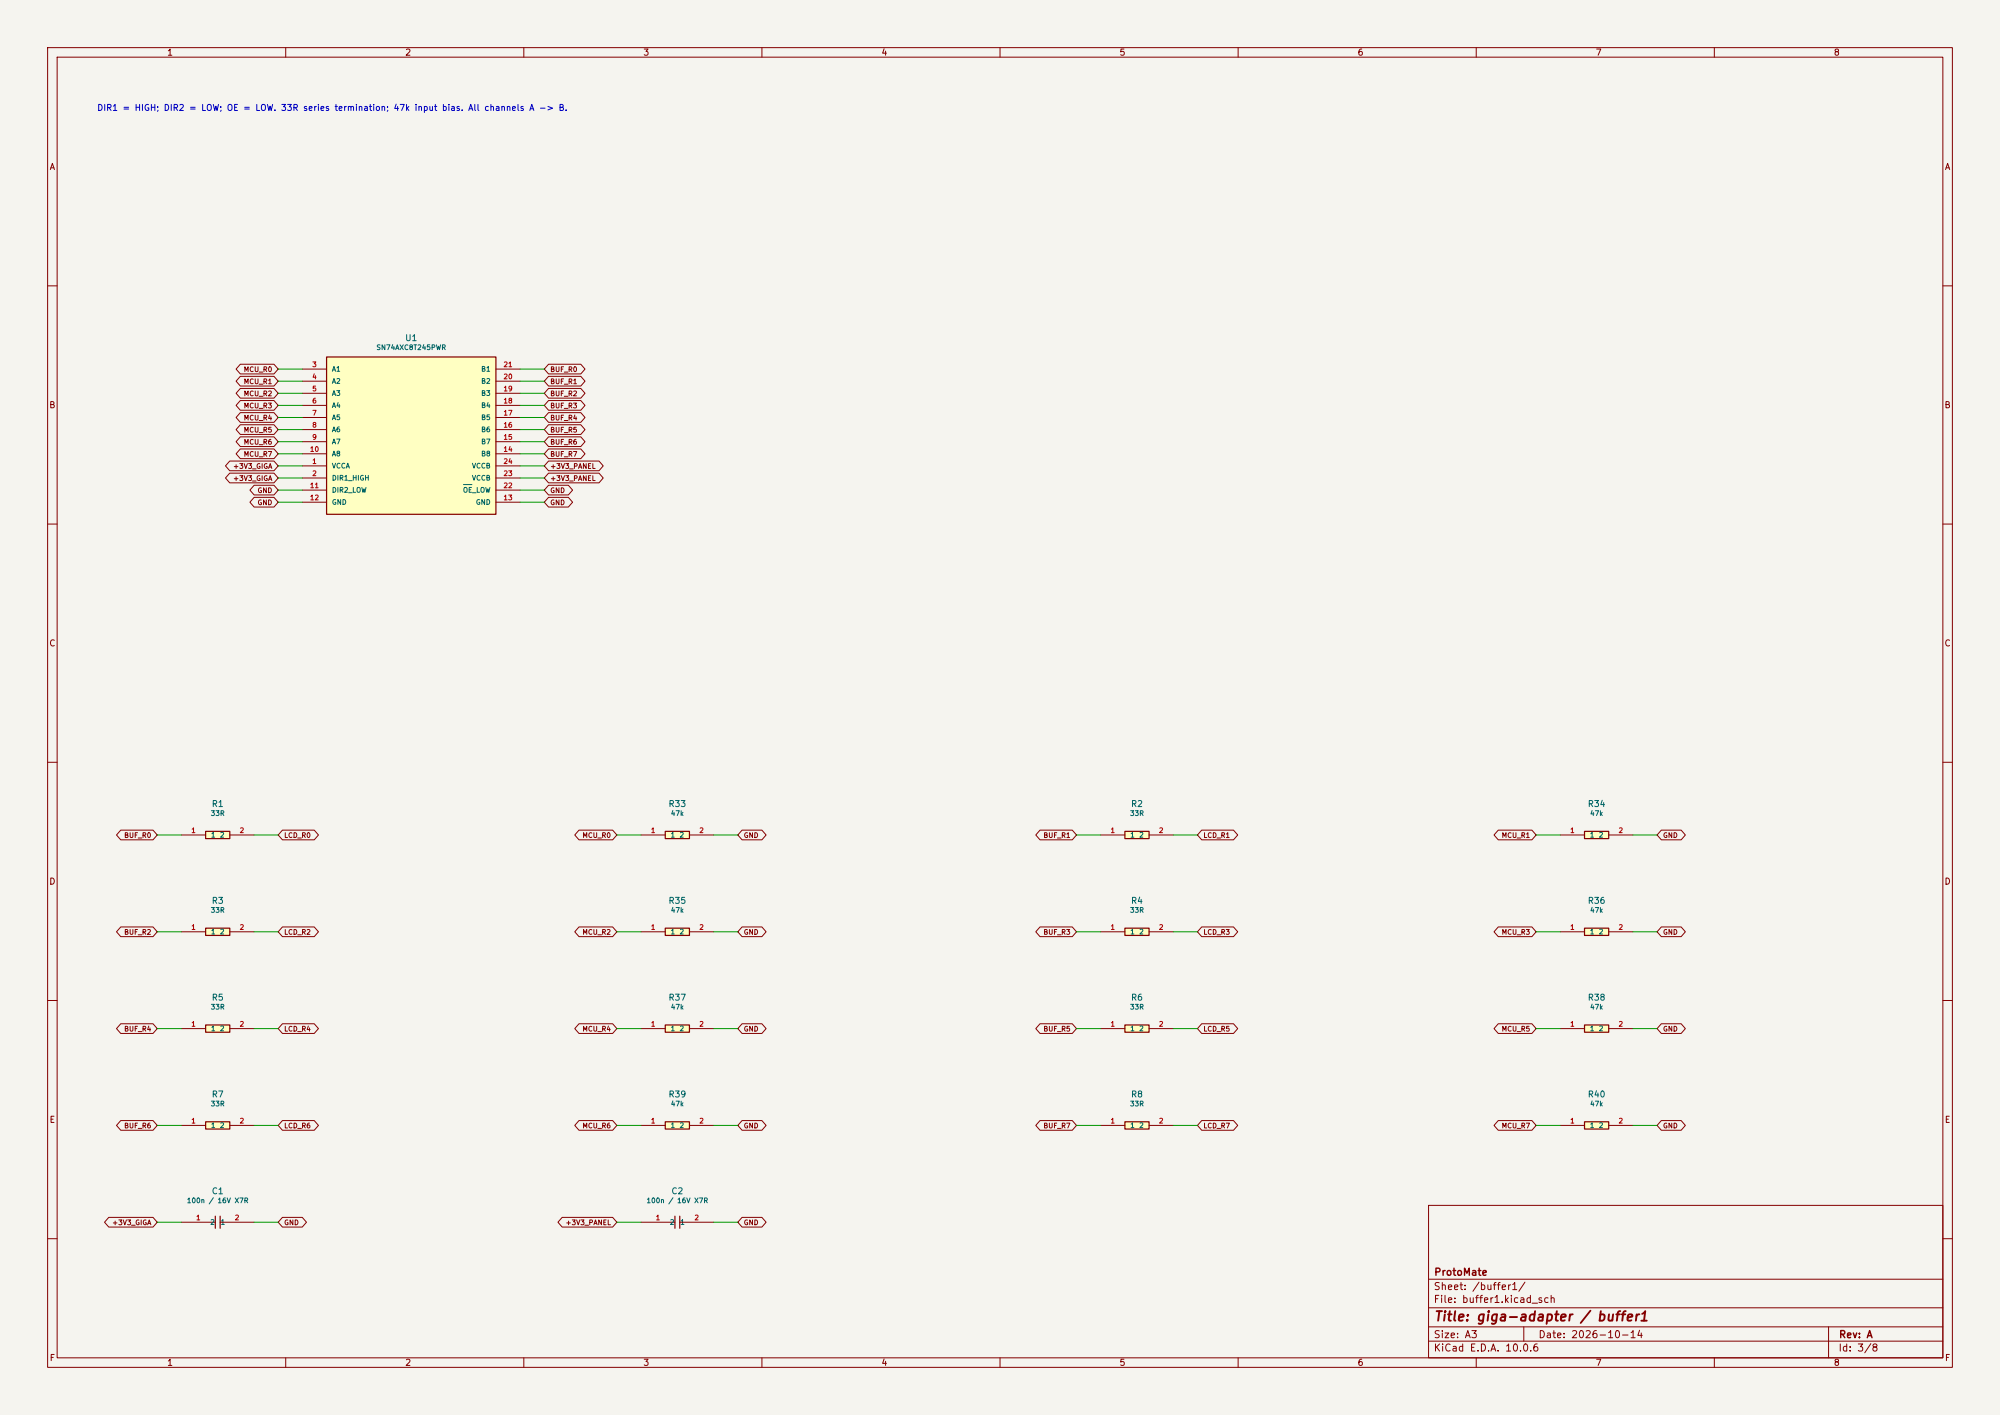
[picture p403: page 3]

MCU_R2 DIR1 = HIGH; DIR2 = LOW; OE = LOW. 33R series termination; 47k input bias. All channels A -> B.

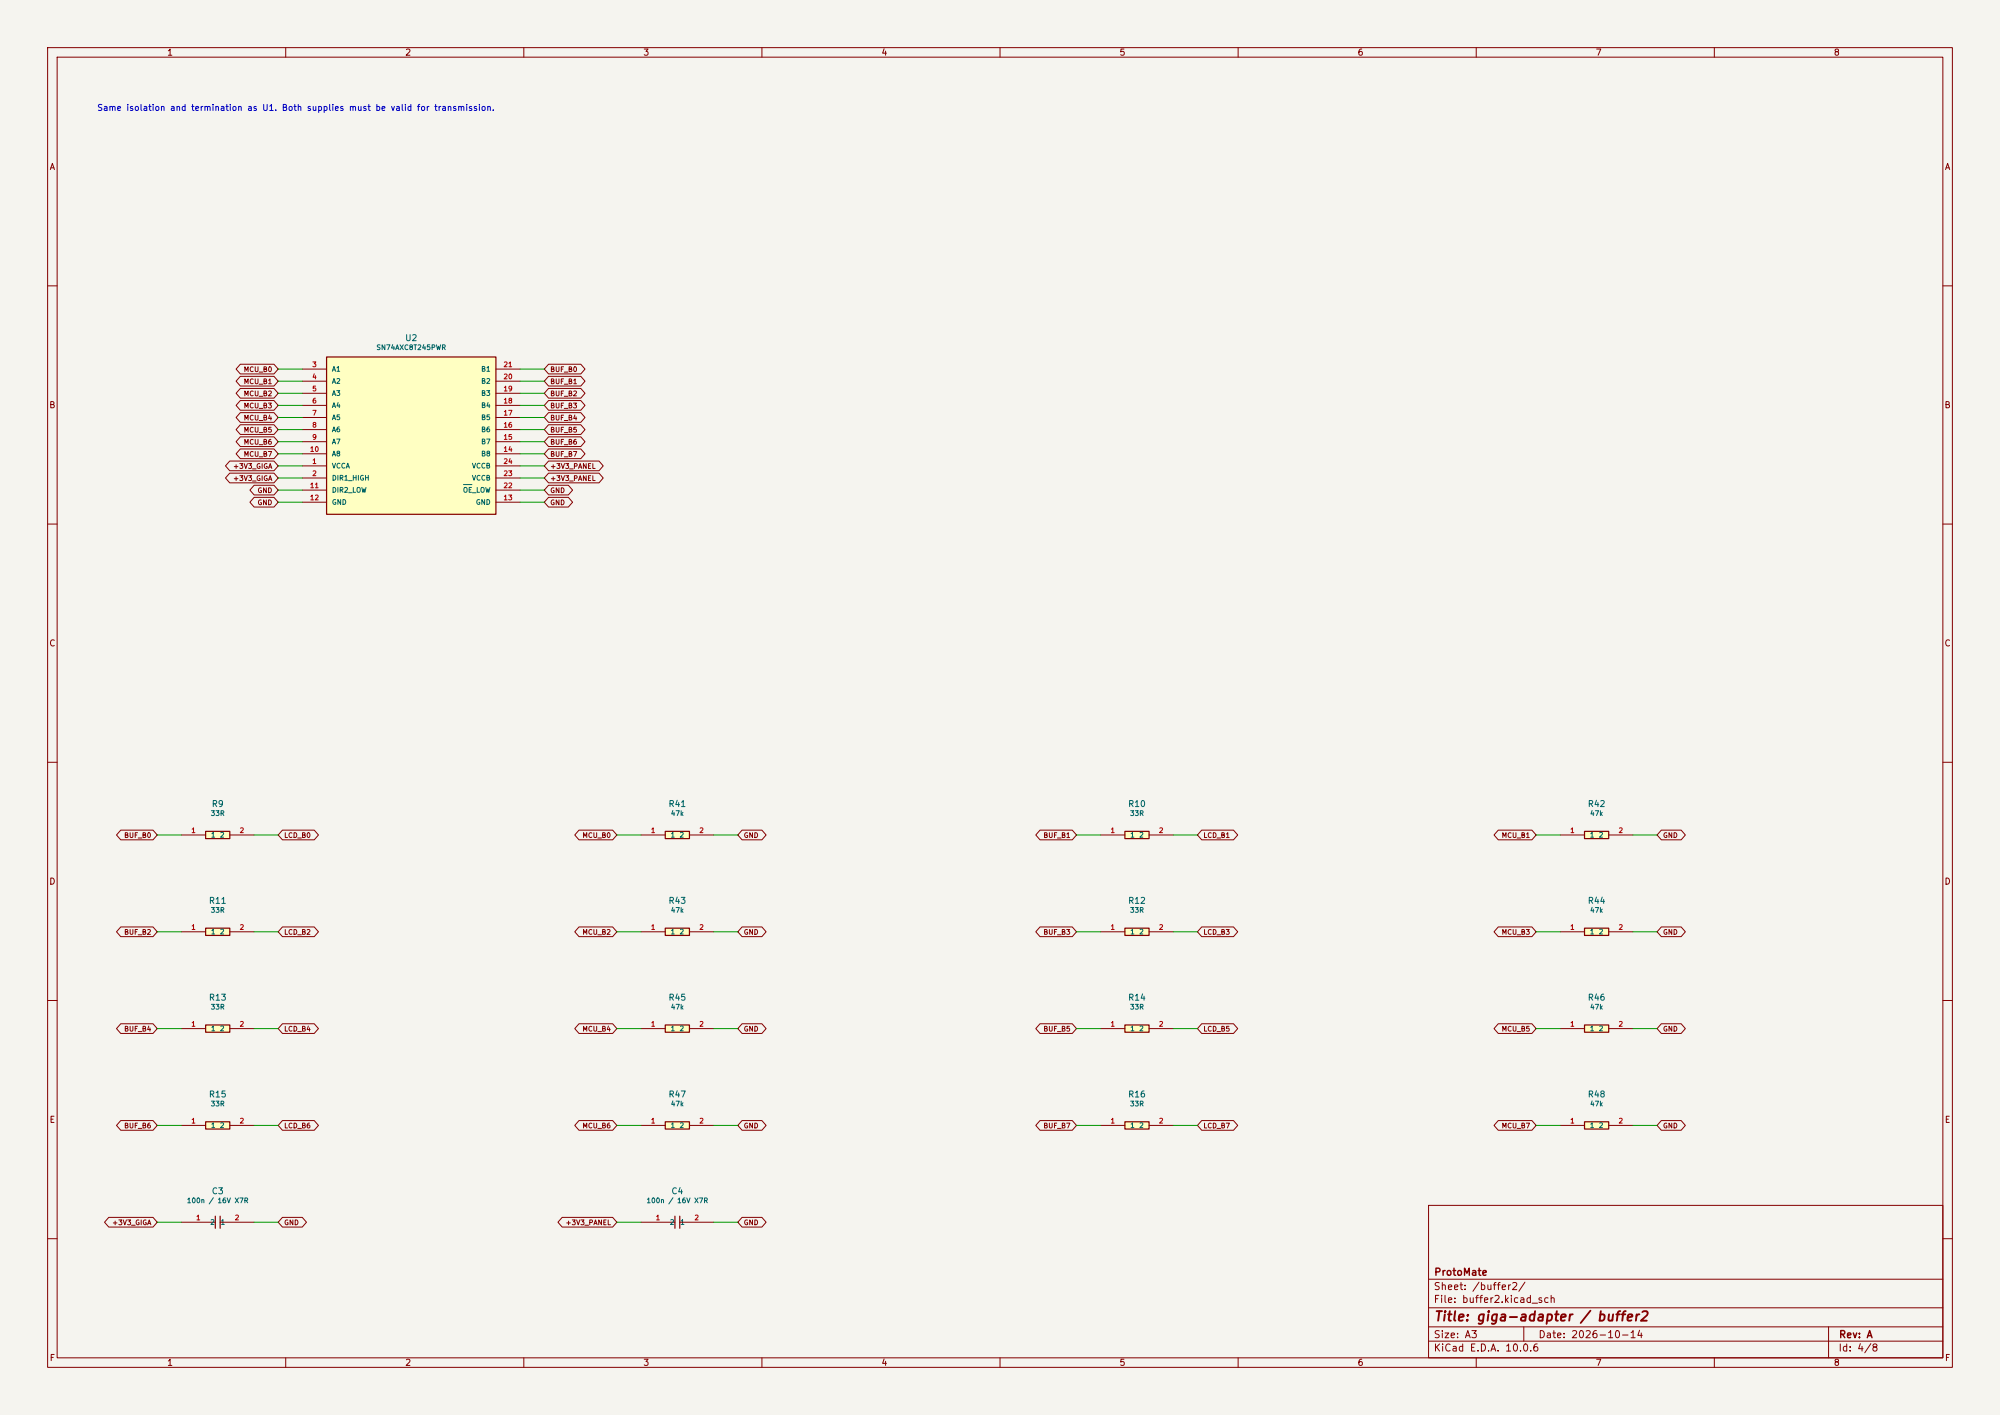
[picture p404: page 4]

MCU_B2 Same isolation and termination as U1. Both supplies must be valid for transmission.

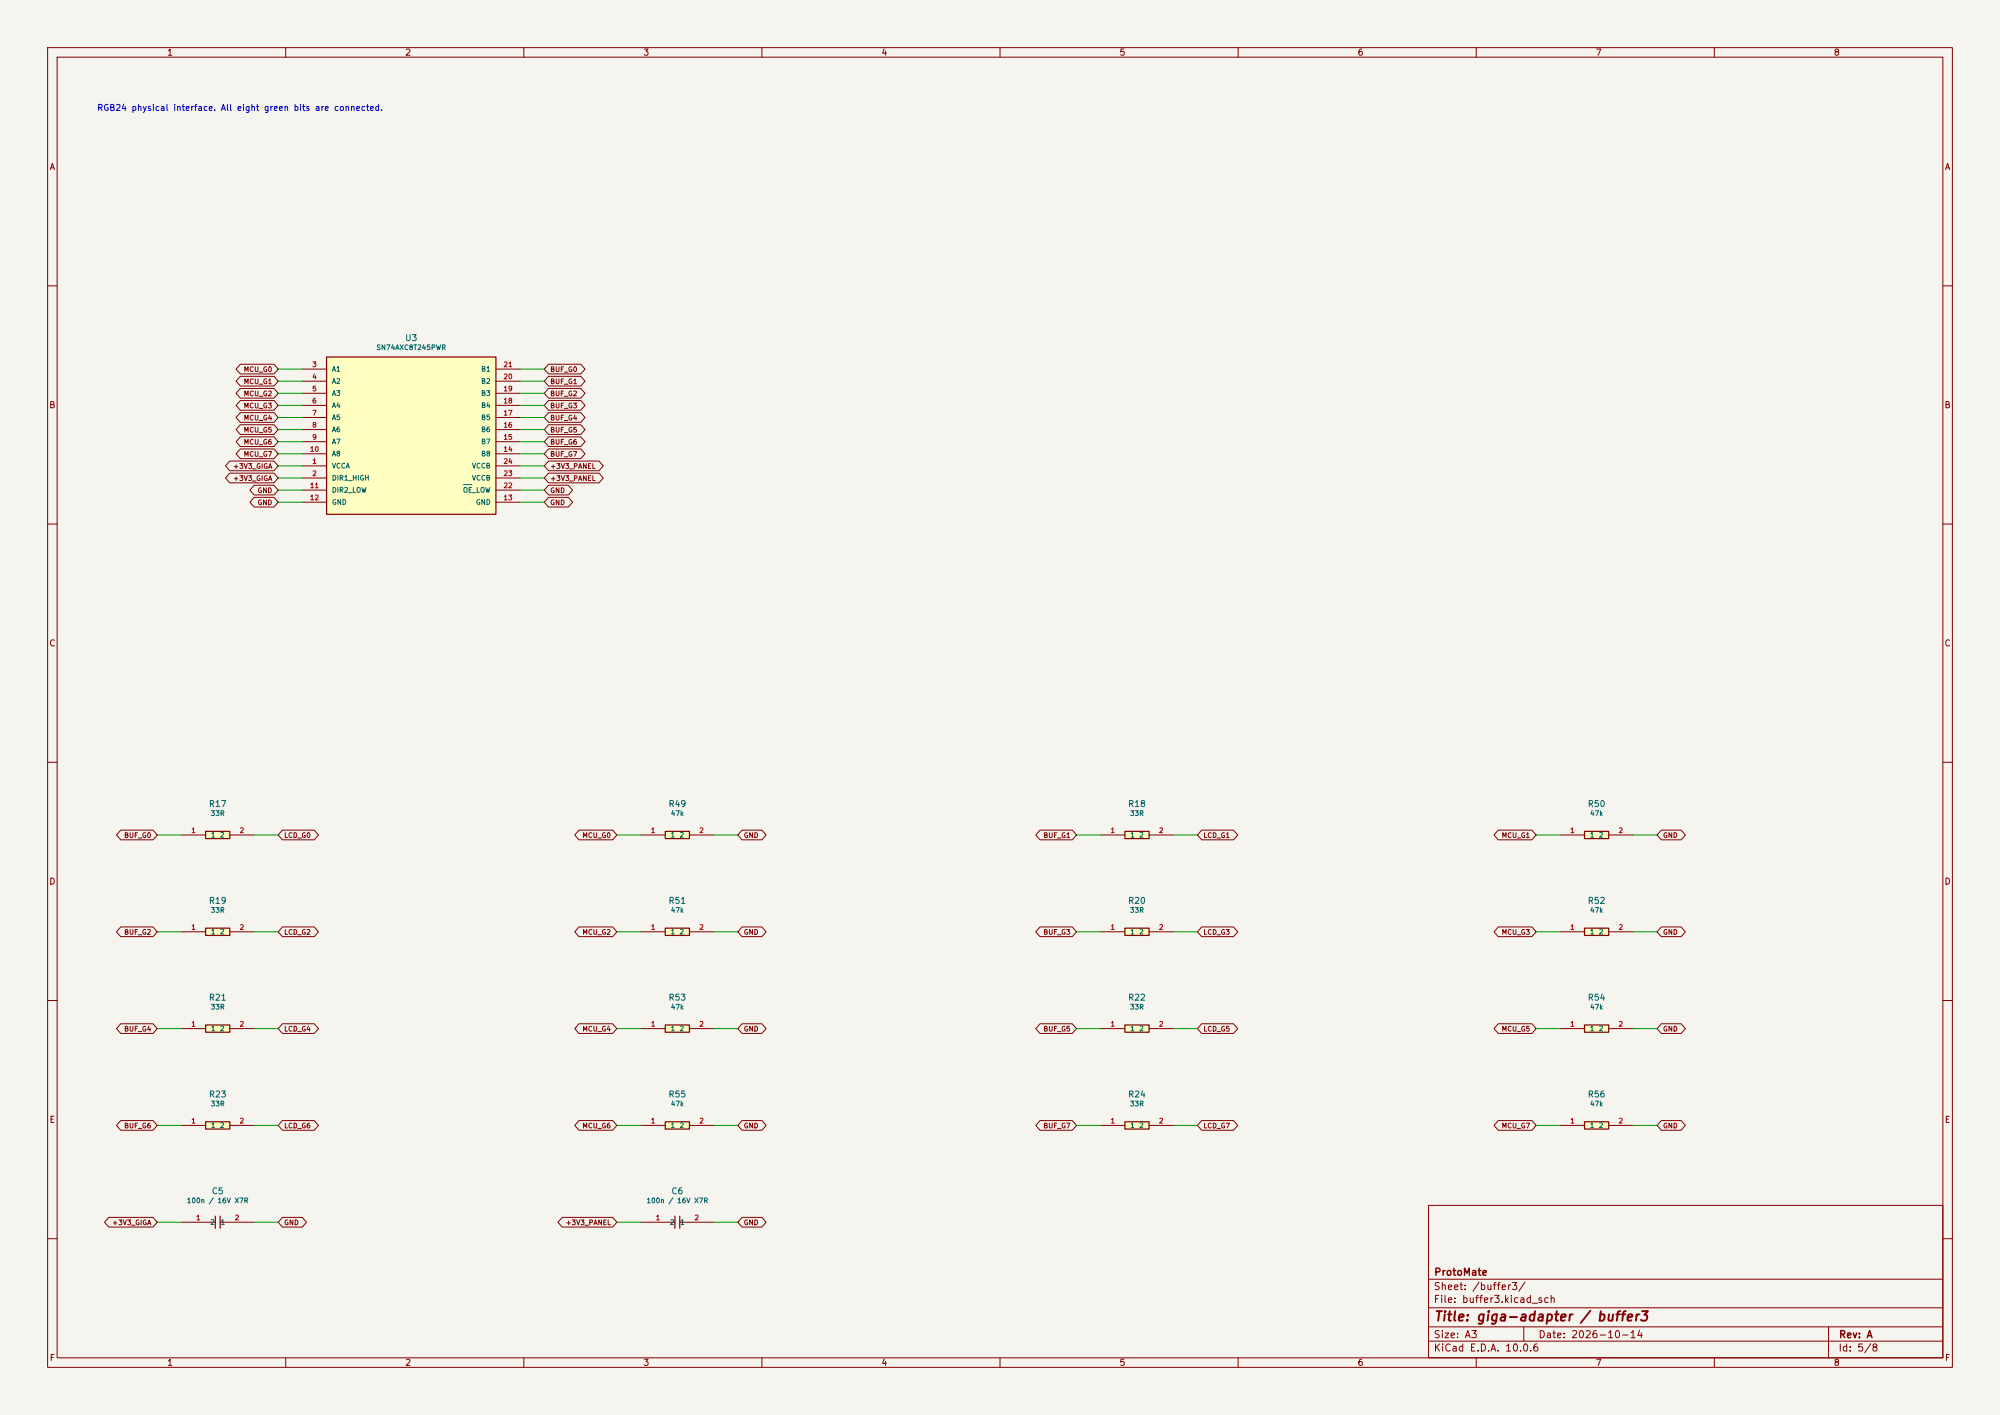
[picture p405: page 5]

MCU_G2 RGB24 physical interface. All eight green bits are connected.

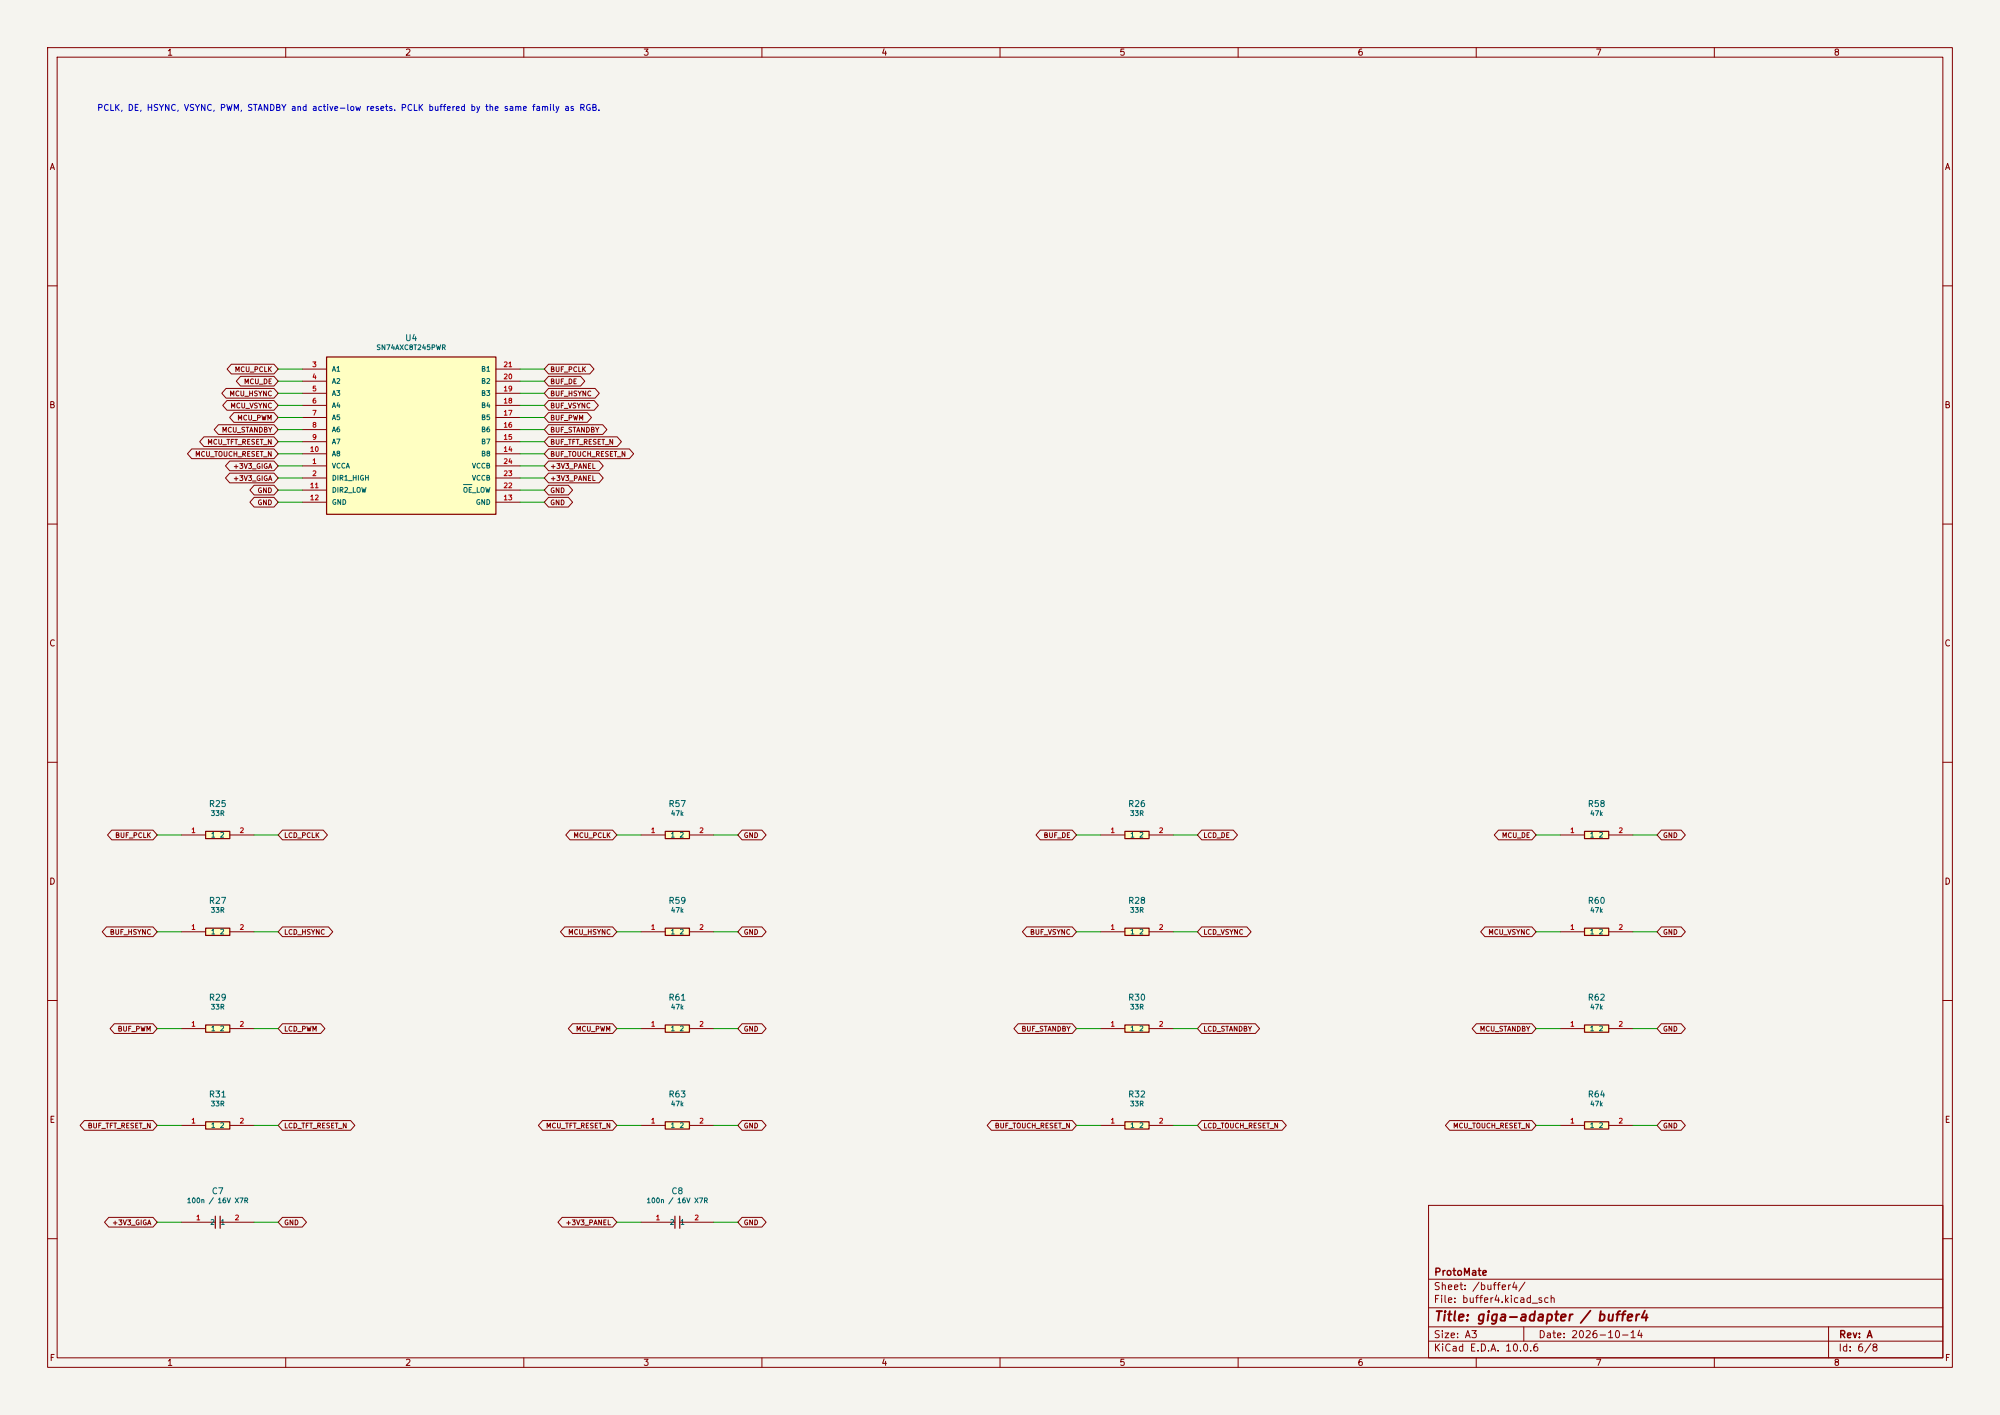
[picture p406: page 6]

PCLK, DE, HSYNC, VSYNC, PWM, STANDBY and active-low resets. PCLK buffered by the same family as RGB.

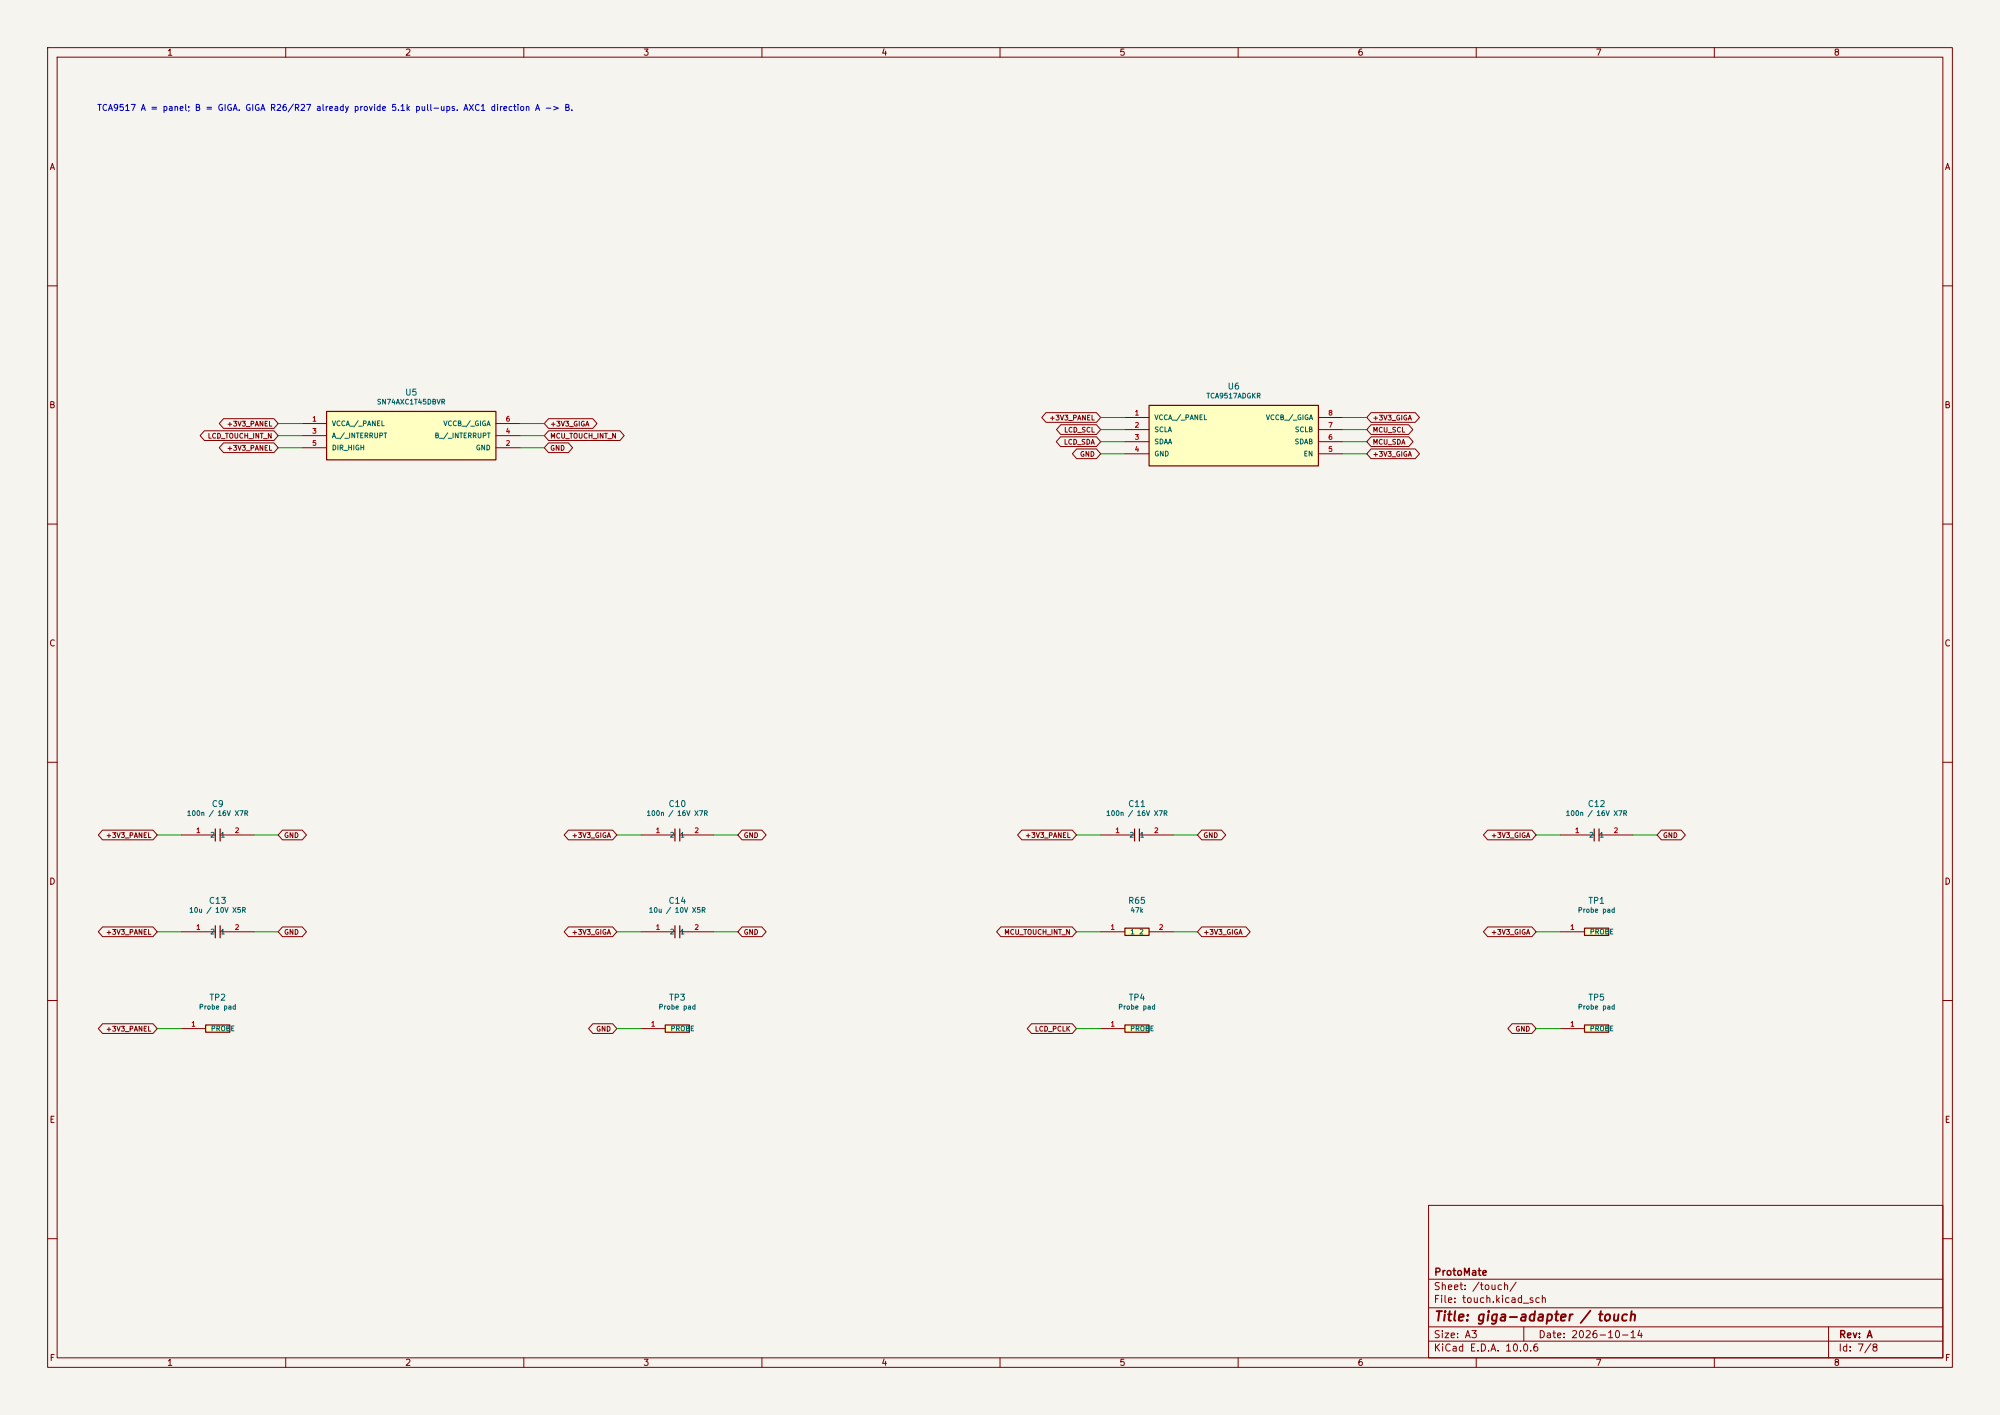
[picture p407: page 7]

TCA9517 A = panel; B = GIGA. GIGA R26/R27 already provide 5.1k pull-ups. AXC1 direction A -> B.

ProtoMate
Sheet: /touch/
File: touch.kicad_sch
Title: giga-adapter / touch

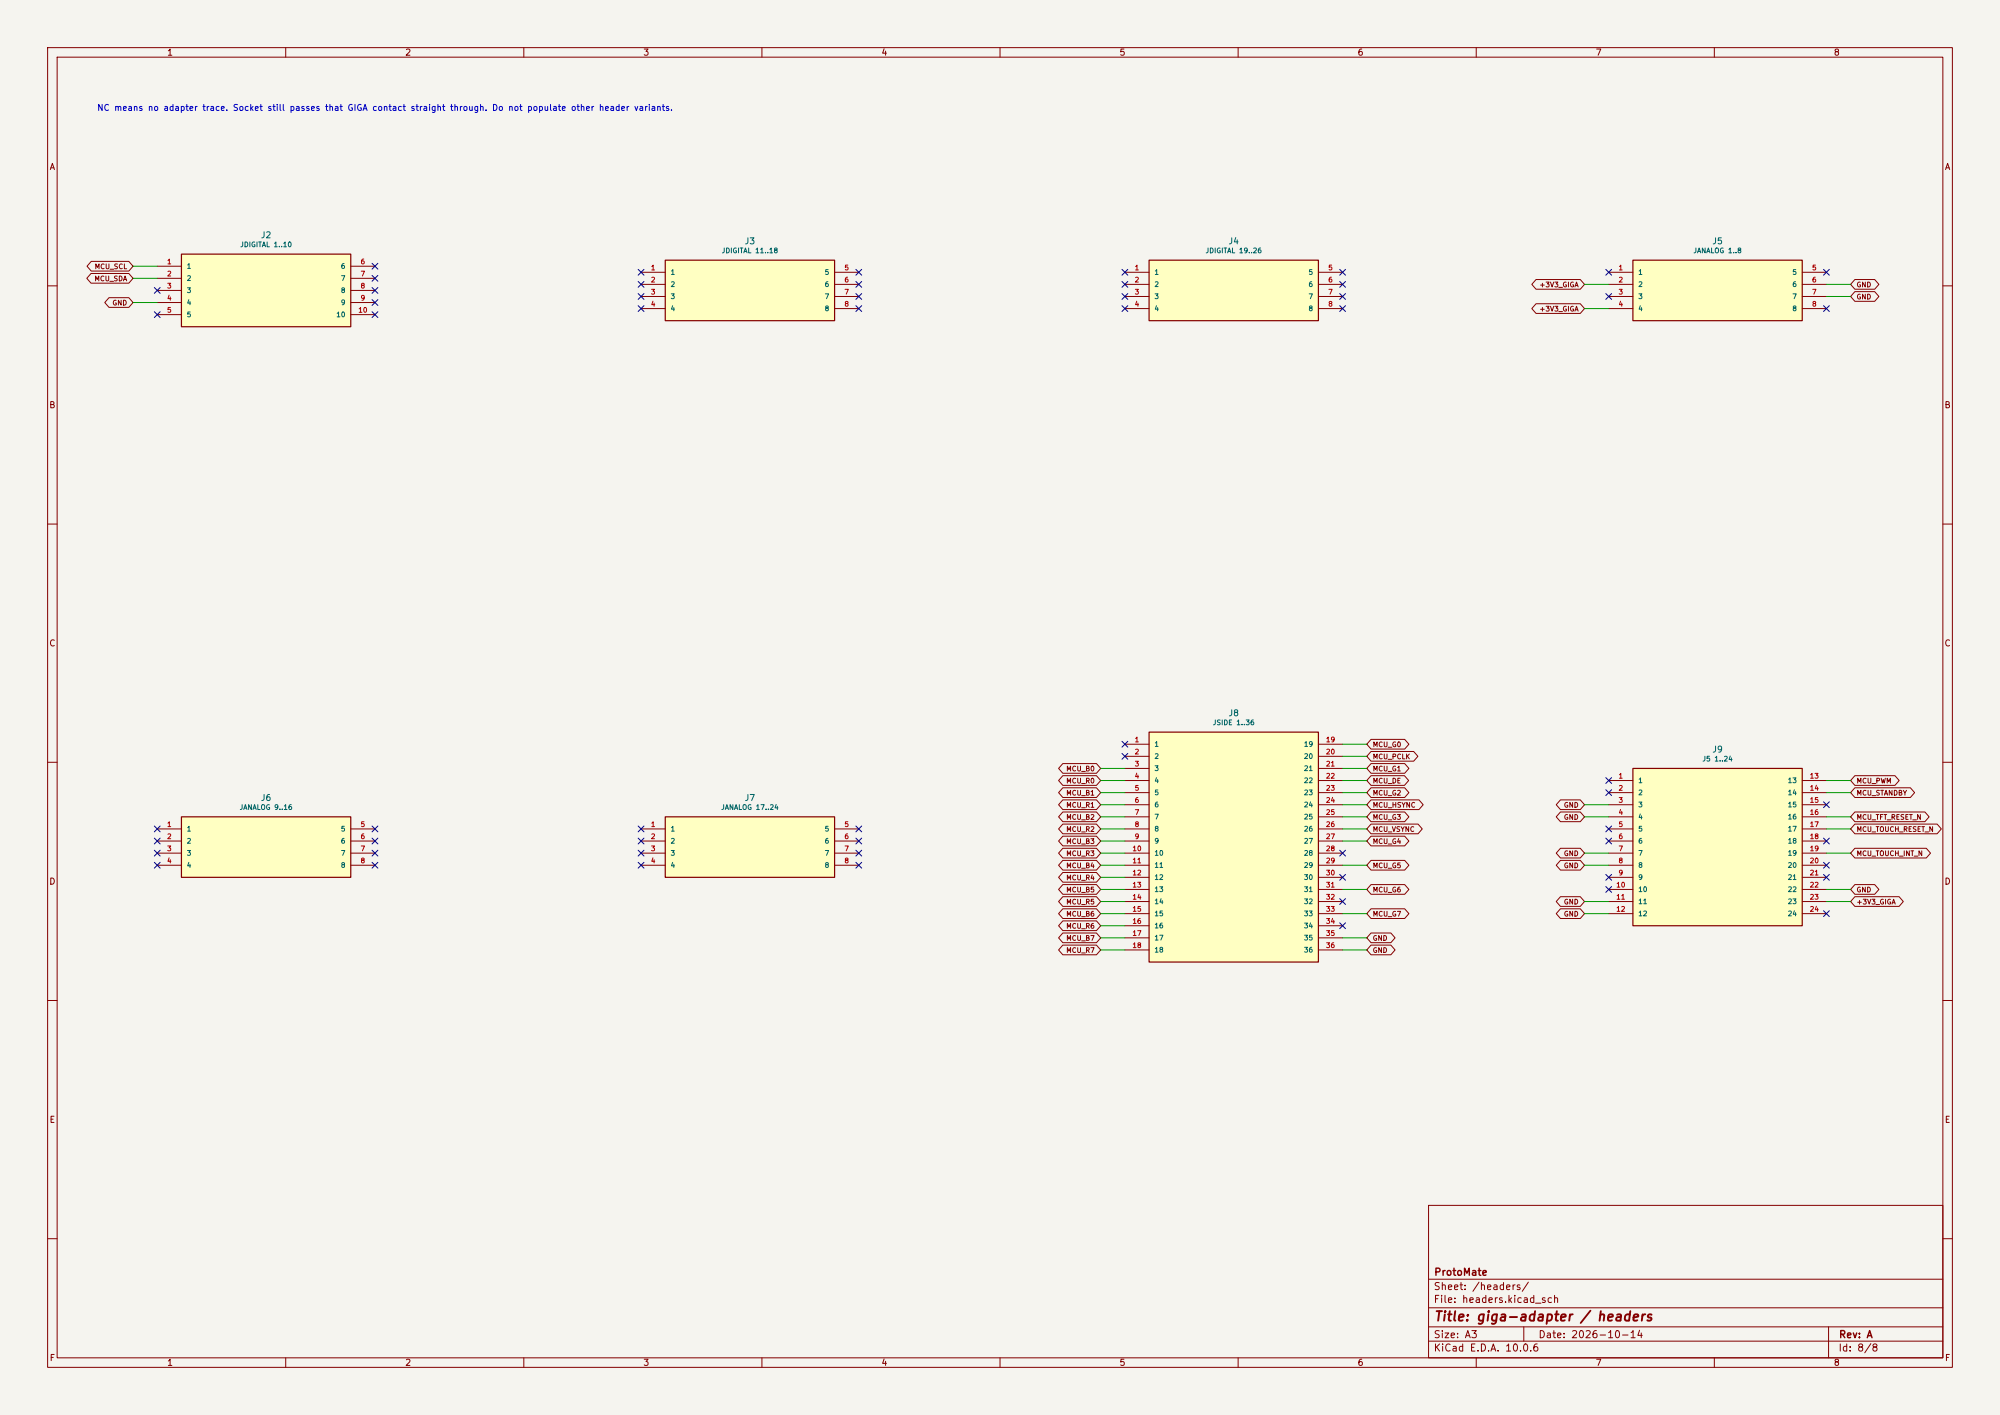
[picture p408: page 8]

ProtoMate
Sheet: /headers/
File: headers.kicad_sch
Title: giga-adapter / headers
