daleondev/ProtoMate_Control/hardware/display/manufacturing/display-adapter-rev-F/assembly-F.pdf

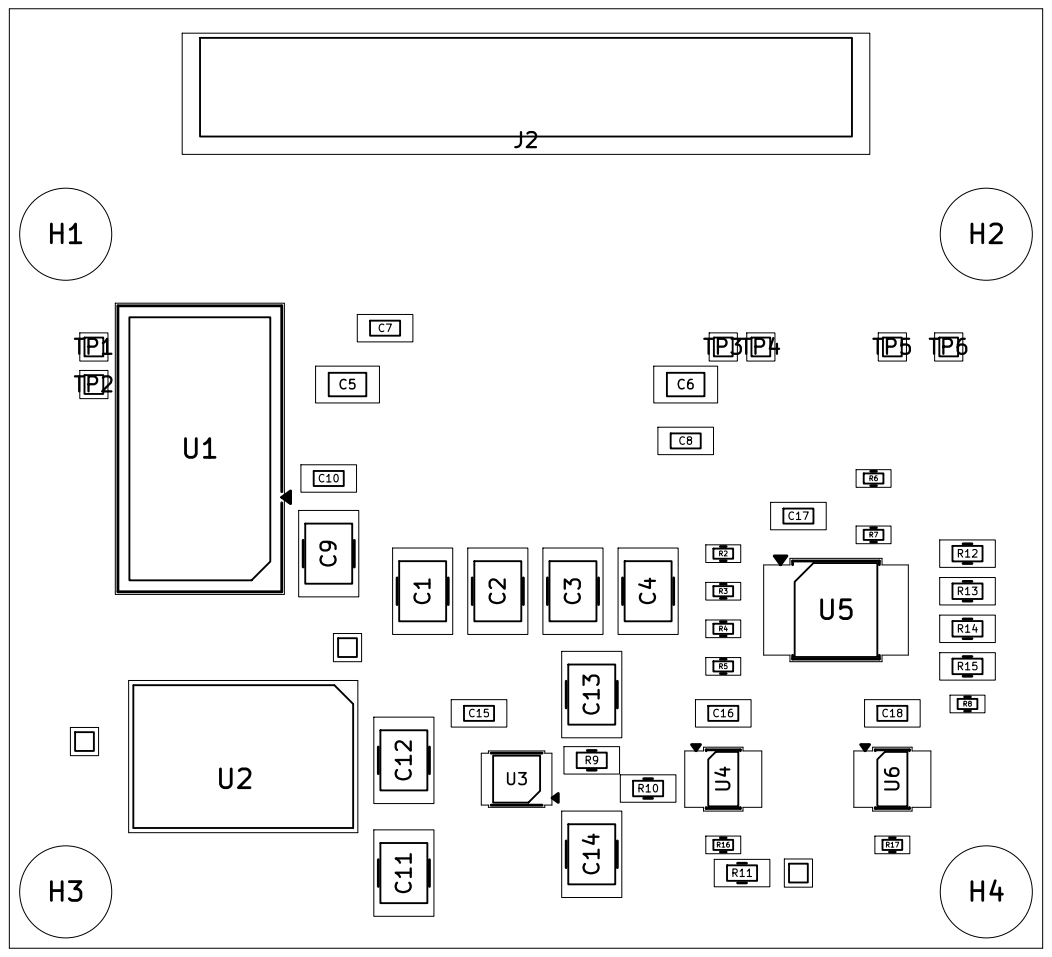
[picture p409: page 1]
