daleondev/ProtoMate_Control/hardware/display/manufacturing/giga-adapter-rev-E/assembly-F.pdf

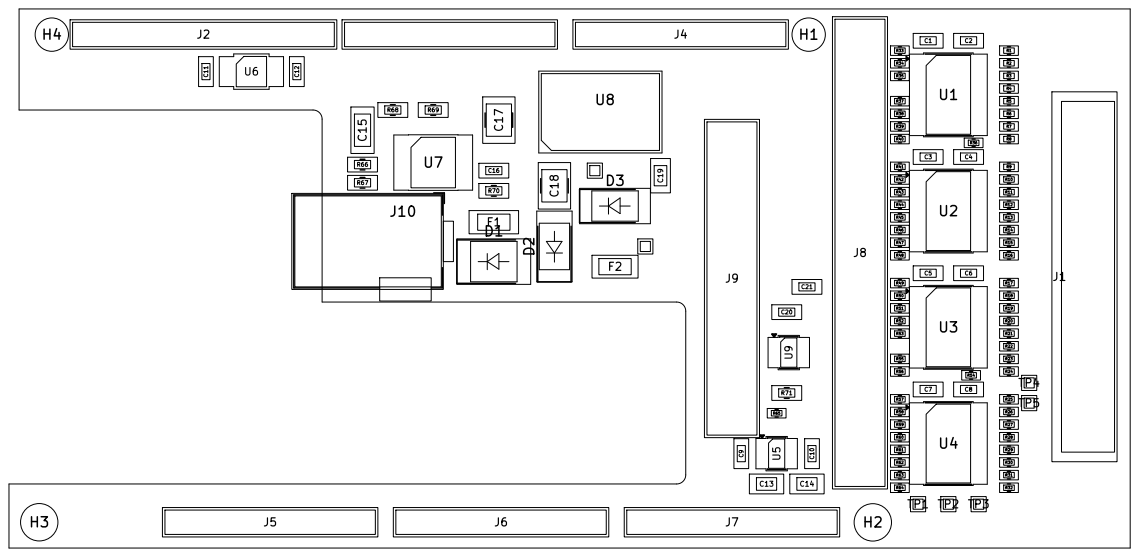
[picture p410: page 1]
