daleondev/ProtoMate_Control/hardware/display/manufacturing/display-adapter-rev-E/assembly-B.pdf

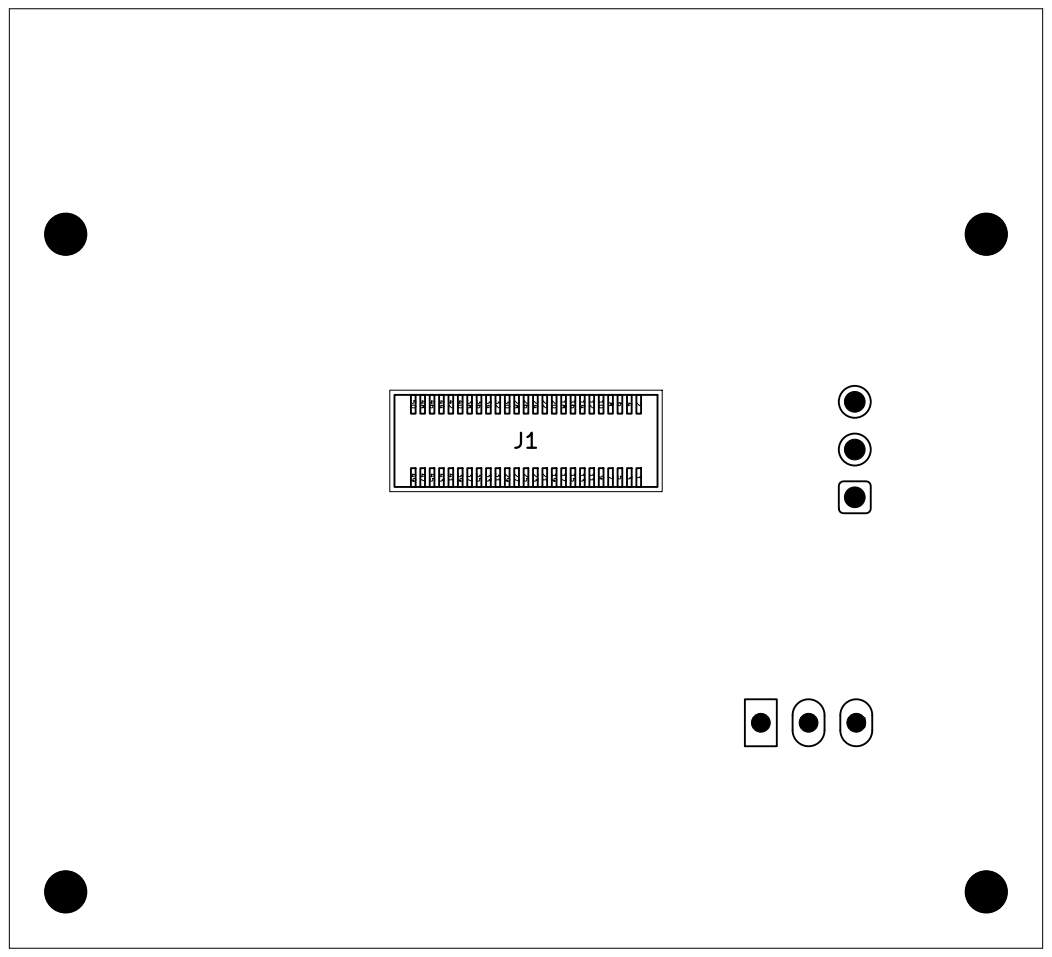
[picture p411: page 1]
