daleondev/ProtoMate_Control/hardware/display/manufacturing/display-adapter-rev-E/assembly-F.pdf

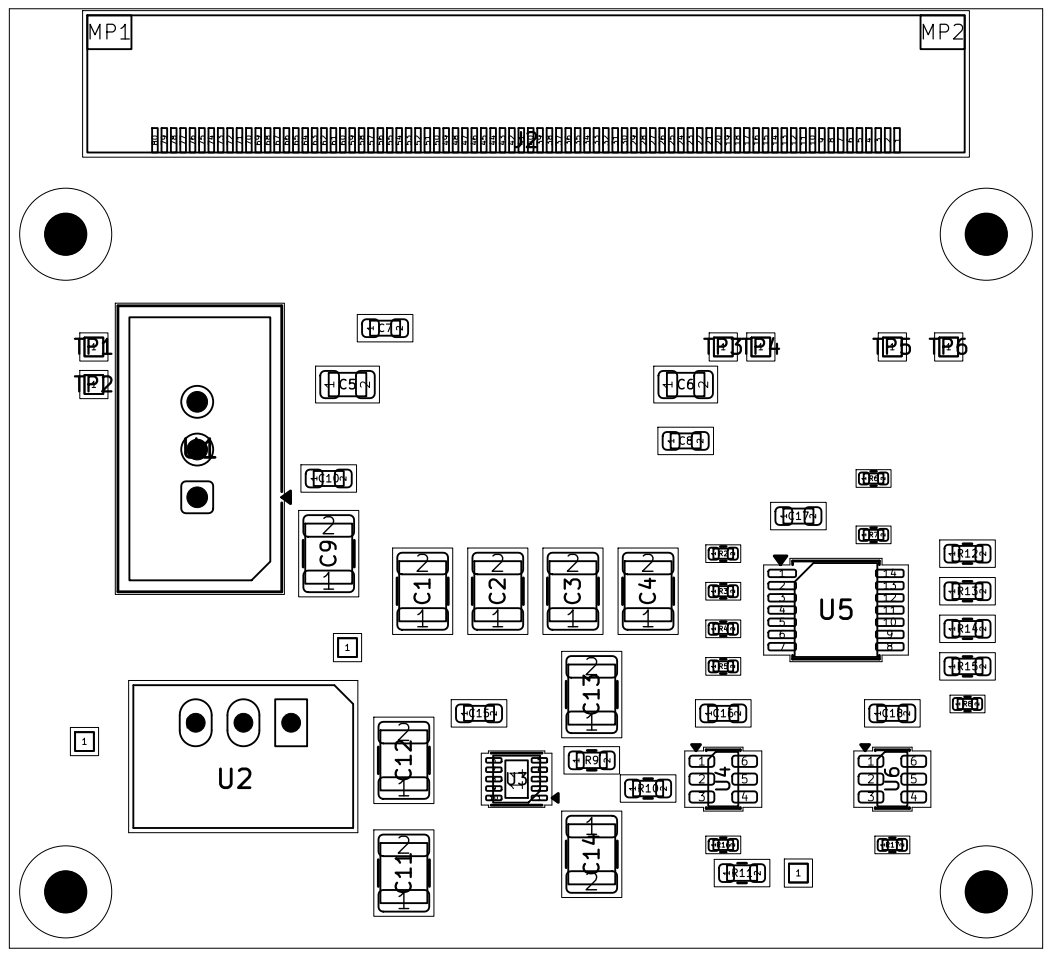
[picture p412: page 1]
