daleondev/ProtoMate_Control/hardware/display/manufacturing/giga-adapter-rev-D/assembly-B.pdf

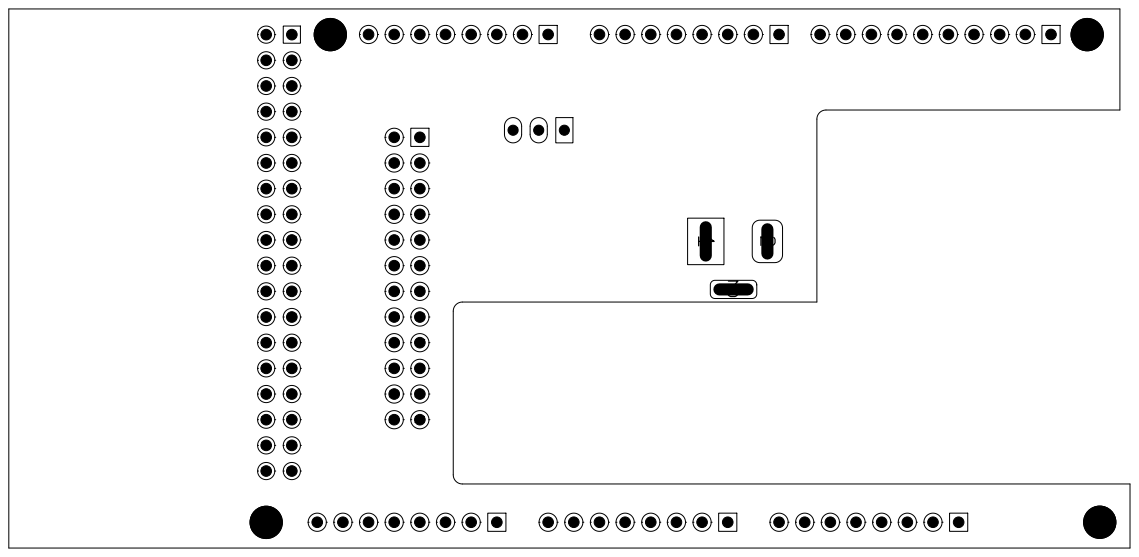
[picture p413: page 1]
