daleondev/ProtoMate_Control/hardware/display/manufacturing/giga-adapter-rev-D/assembly-F.pdf

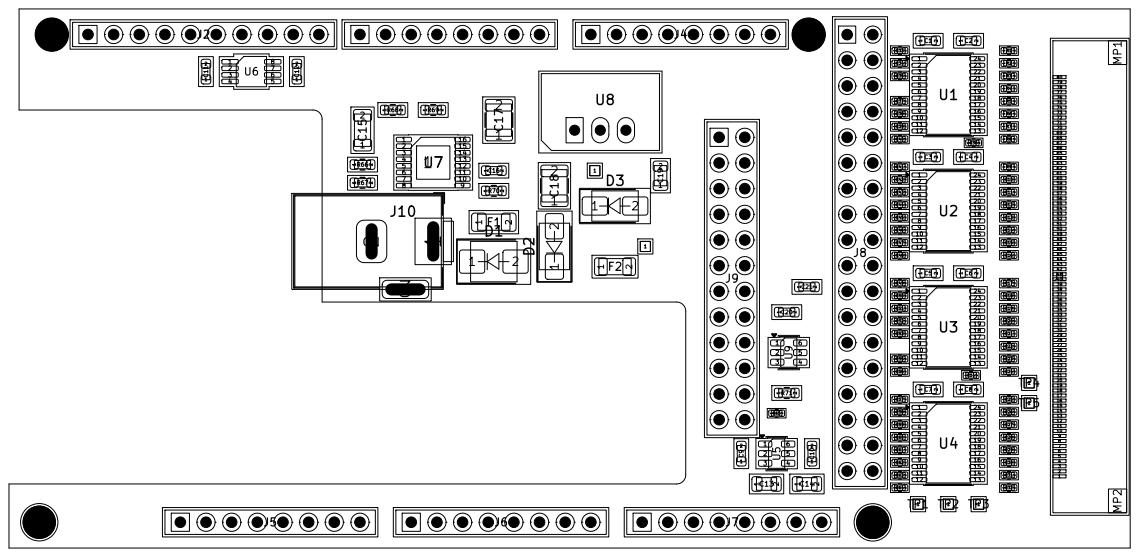
[picture p414: page 1]
