daleondev/ProtoMate_Control/hardware/display/manufacturing/display-adapter-rev-D/assembly-B.pdf

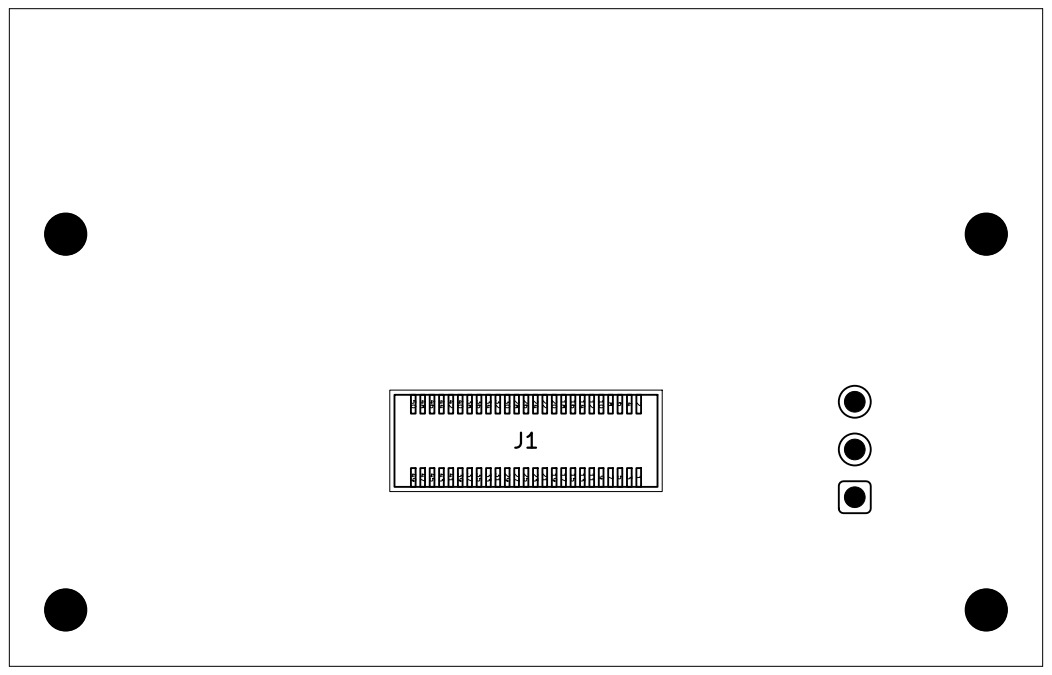
[picture p415: page 1]
