daleondev/ProtoMate_Control/hardware/display/manufacturing/display-adapter-rev-D/assembly-F.pdf

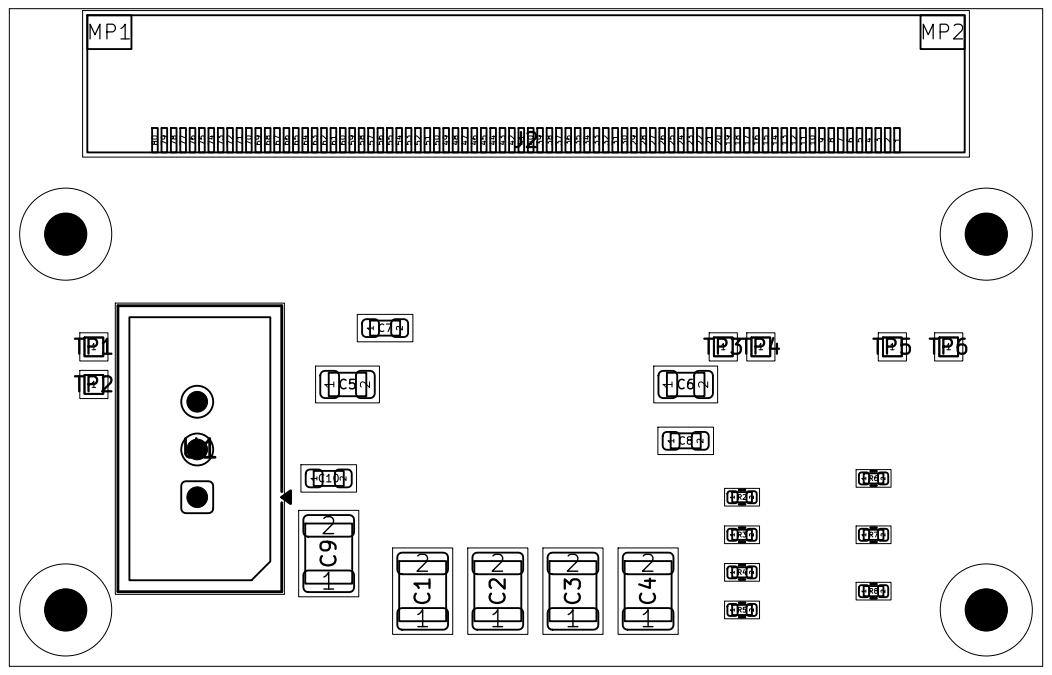
[picture p416: page 1]
