daleondev/ProtoMate_Control/hardware/display/manufacturing/giga-adapter-rev-C/assembly-B.pdf

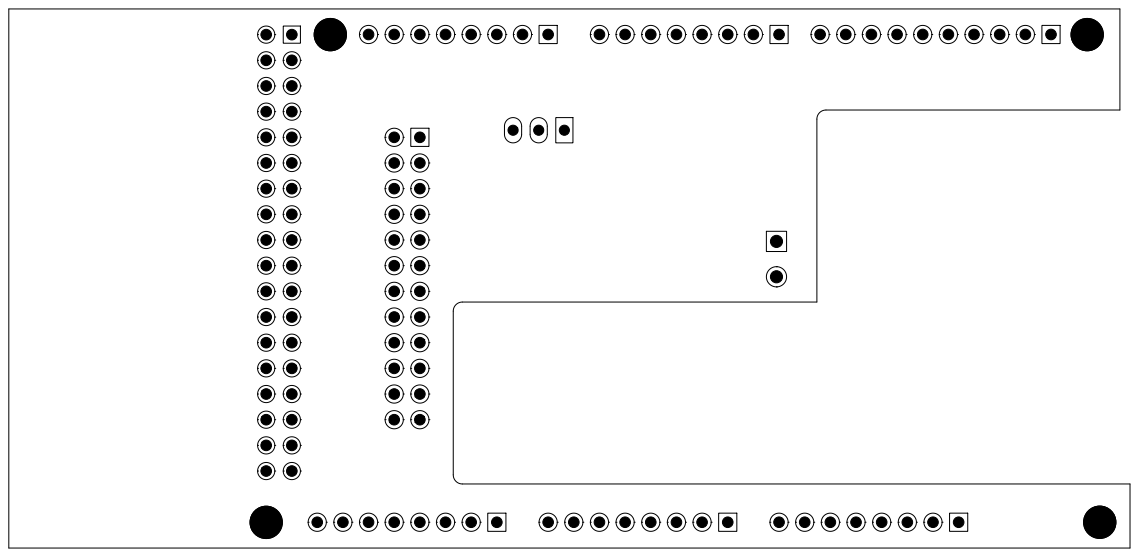
[picture p417: page 1]
