daleondev/ProtoMate_Control/hardware/display/manufacturing/giga-adapter-rev-C/assembly-F.pdf

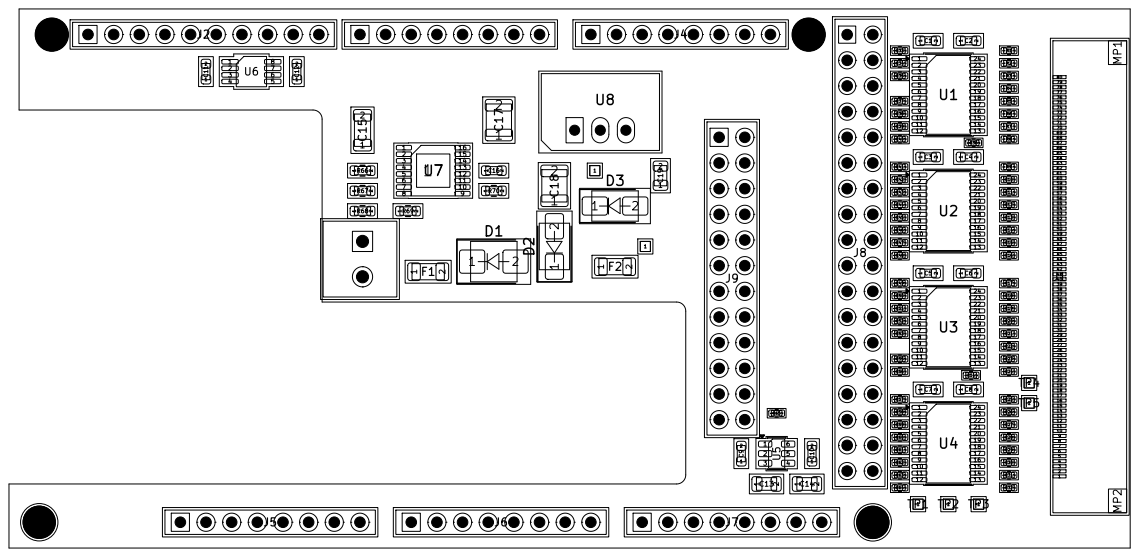
[picture p418: page 1]
