daleondev/ProtoMate_Control/hardware/display/manufacturing/display-adapter-rev-C/assembly-B.pdf

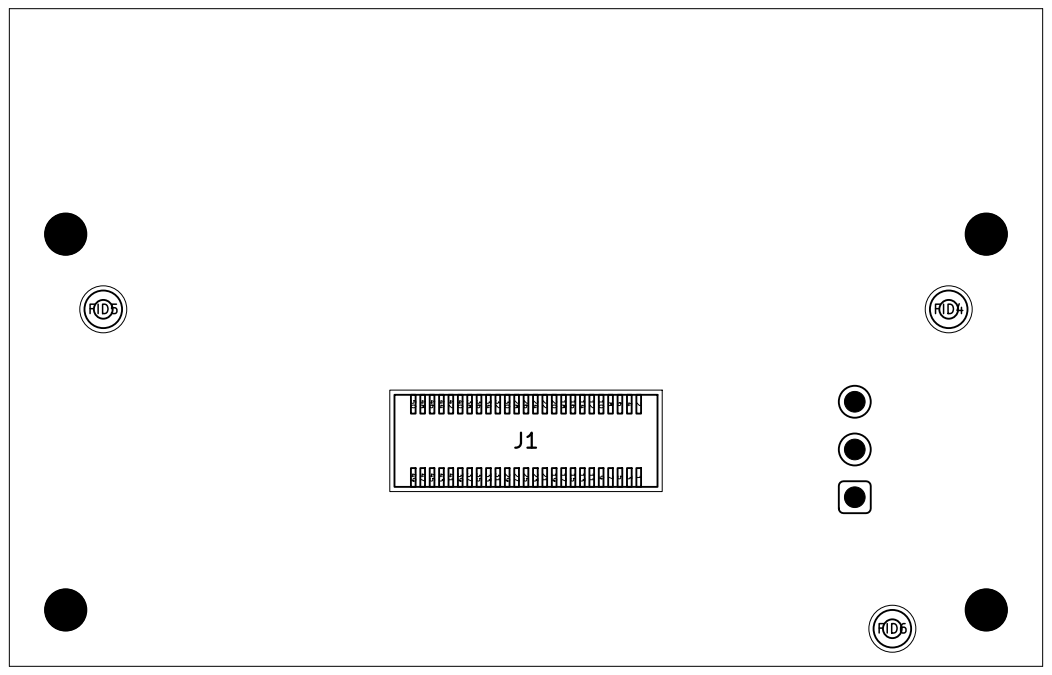
[picture p419: page 1]
