daleondev/ProtoMate_Control/hardware/display/manufacturing/display-adapter-rev-C/assembly-F.pdf

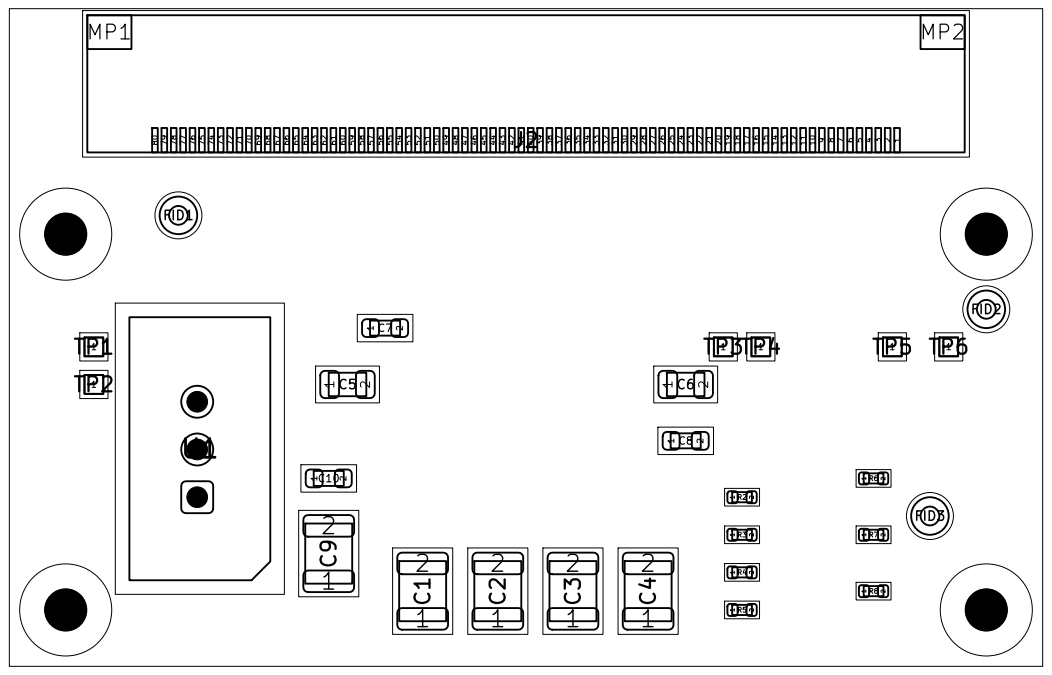
[picture p420: page 1]
