daleondev/ProtoMate_Control/hardware/display/manufacturing/giga-adapter-rev-B/assembly-B.pdf

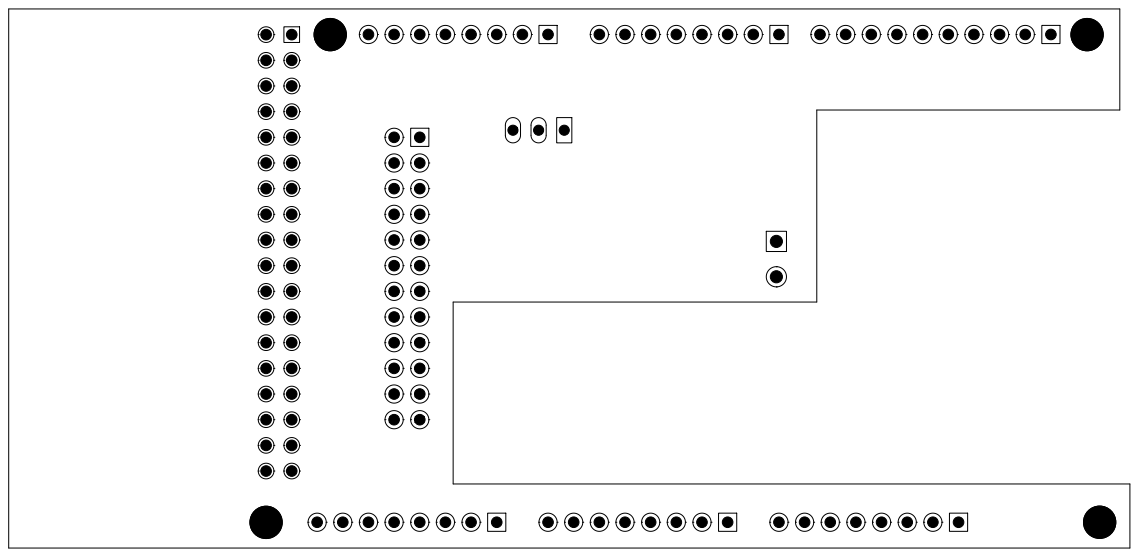
[picture p421: page 1]
