daleondev/ProtoMate_Control/hardware/display/manufacturing/giga-adapter-rev-B/assembly-F.pdf

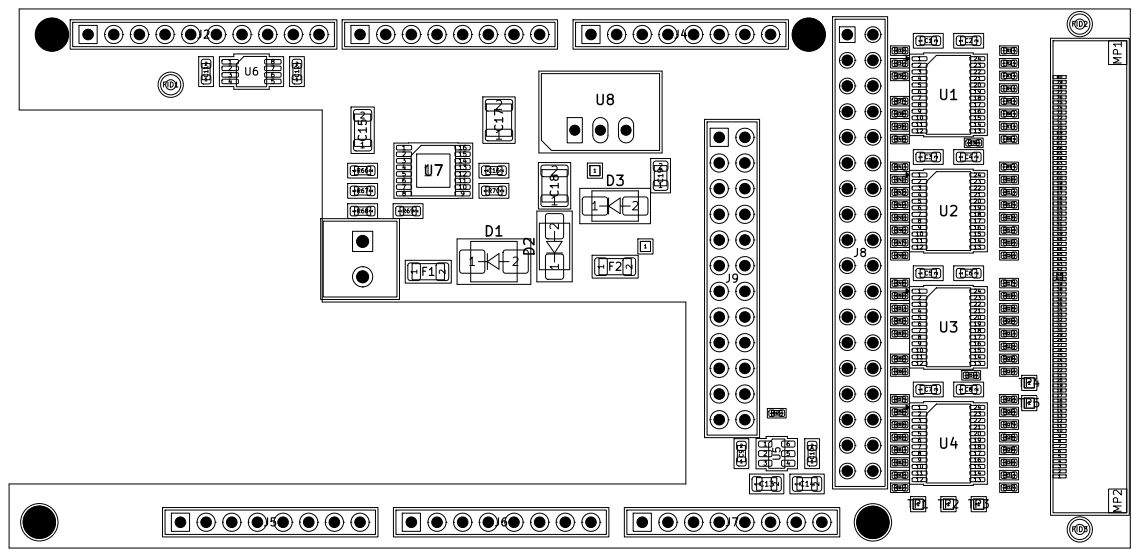
[picture p422: page 1]
