daleondev/ProtoMate_Control/hardware/display/manufacturing/display-adapter-rev-B/assembly-B.pdf

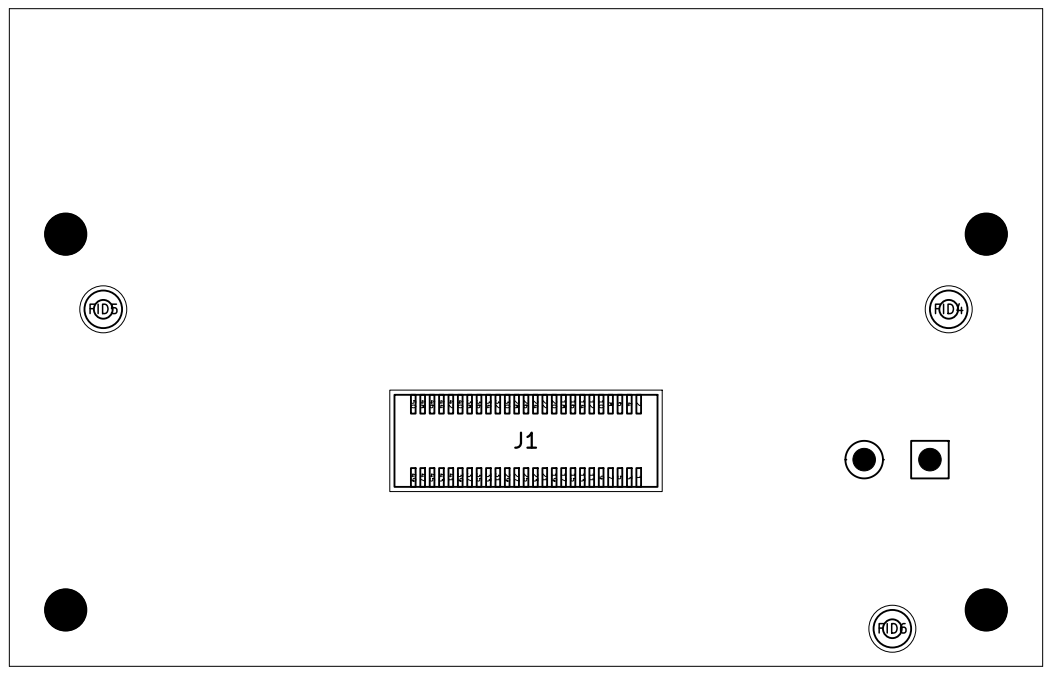
[picture p423: page 1]
