daleondev/ProtoMate_Control/hardware/display/manufacturing/display-adapter-rev-B/assembly-F.pdf

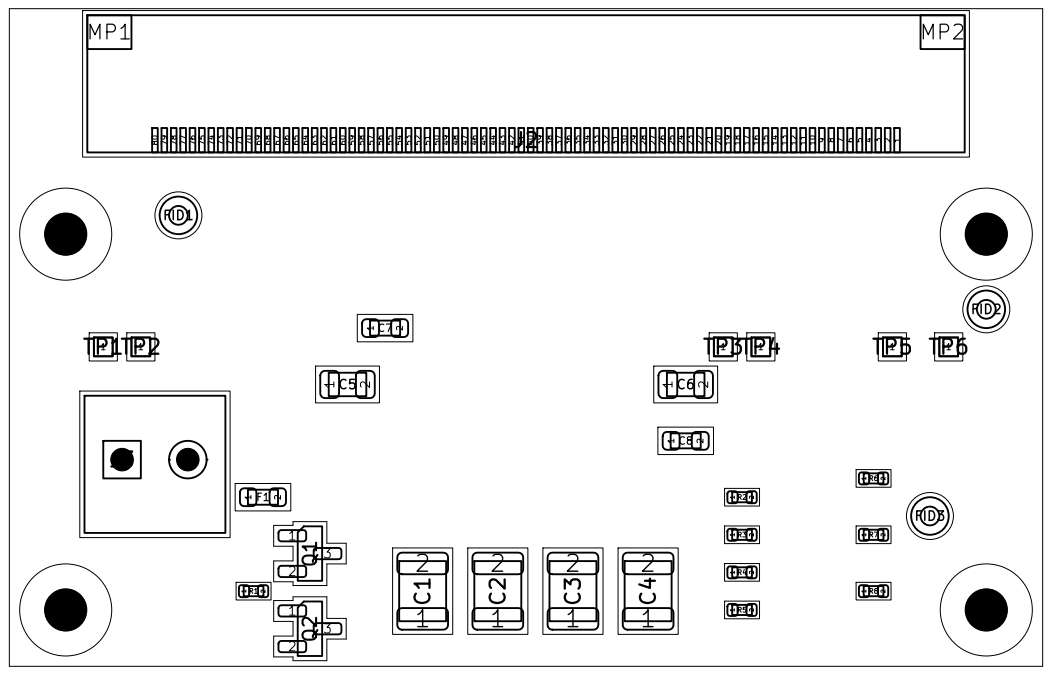
[picture p424: page 1]
