daleondev/ProtoMate_Control/hardware/display/manufacturing/display-adapter-rev-A/assembly-B.pdf

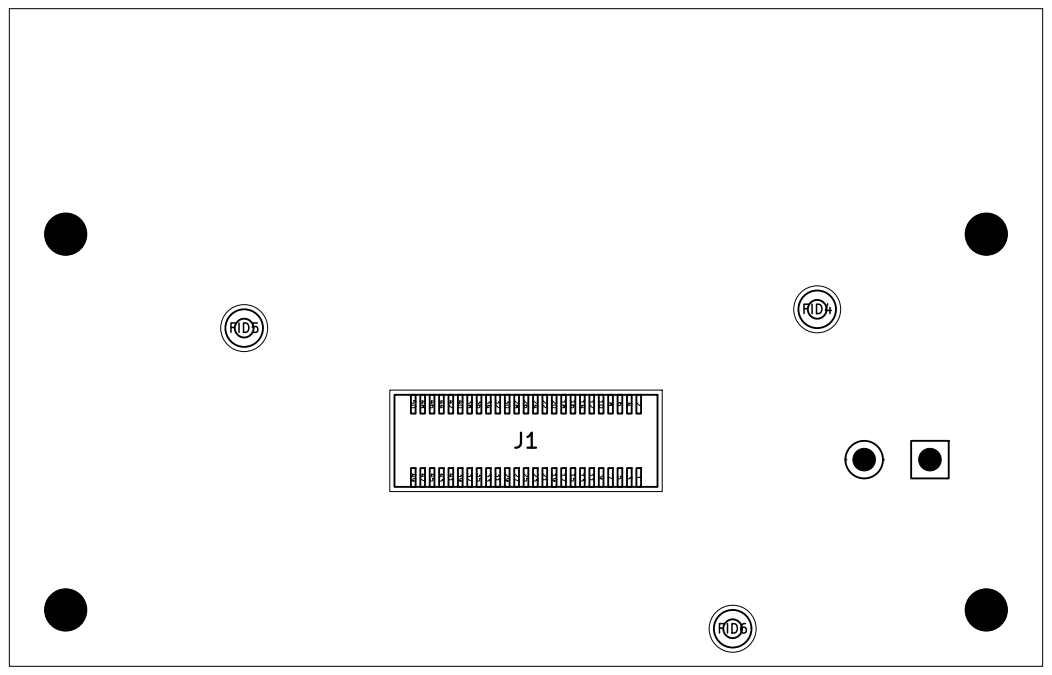
[picture p425: page 1]
