daleondev/ProtoMate_Control/hardware/display/manufacturing/display-adapter-rev-A/assembly-F.pdf

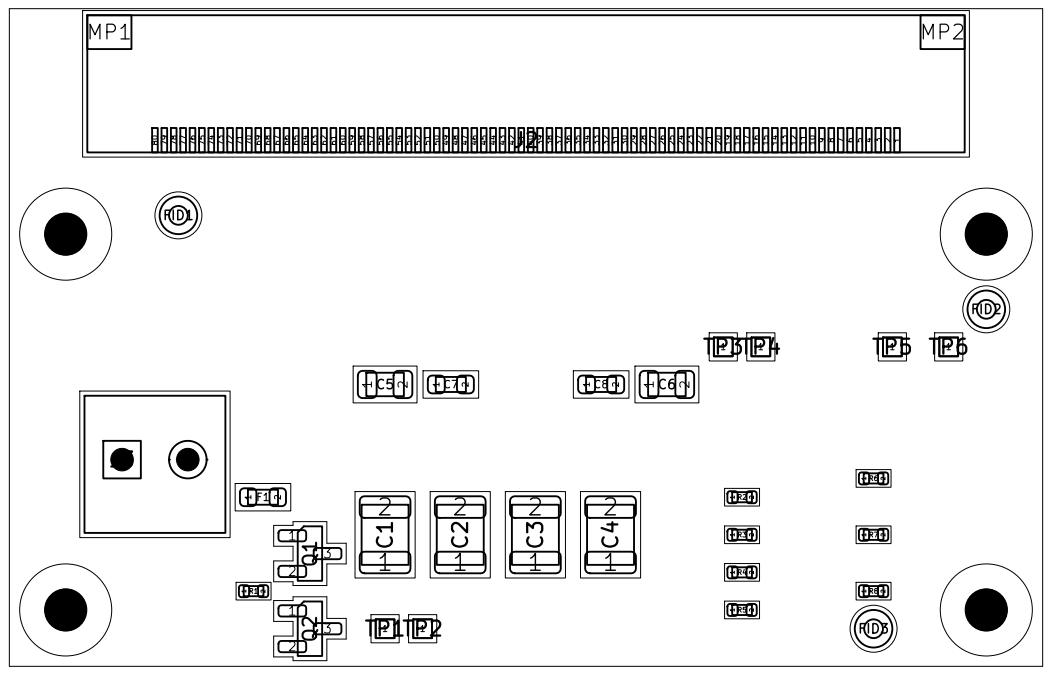
[picture p426: page 1]
