daleondev/ProtoMate_Control/hardware/display/manufacturing/giga-adapter-rev-A/assembly-B.pdf

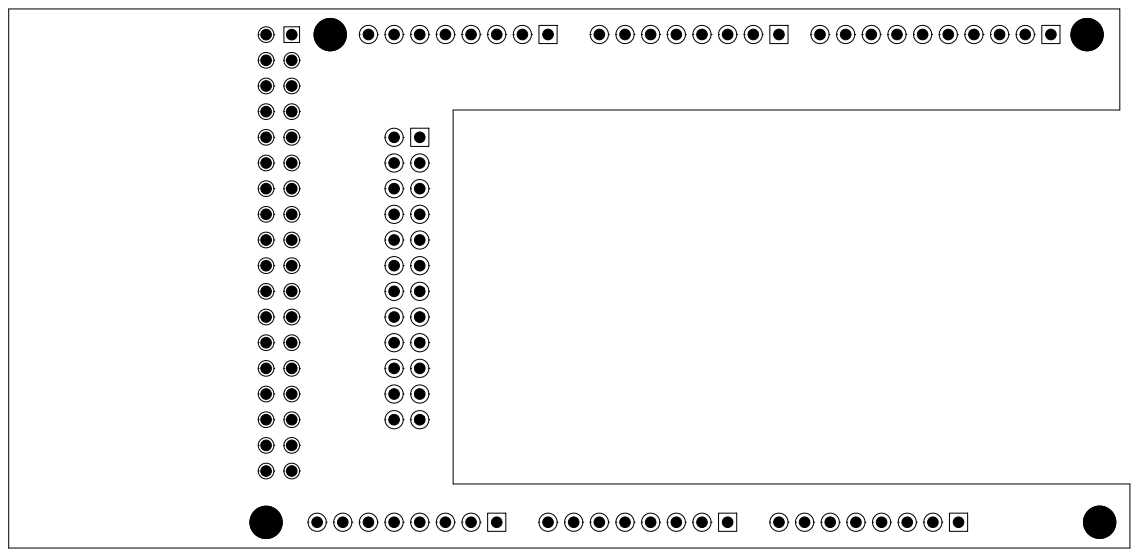
[picture p427: page 1]
