daleondev/ProtoMate_Control/hardware/display/manufacturing/giga-adapter-rev-A/assembly-F.pdf

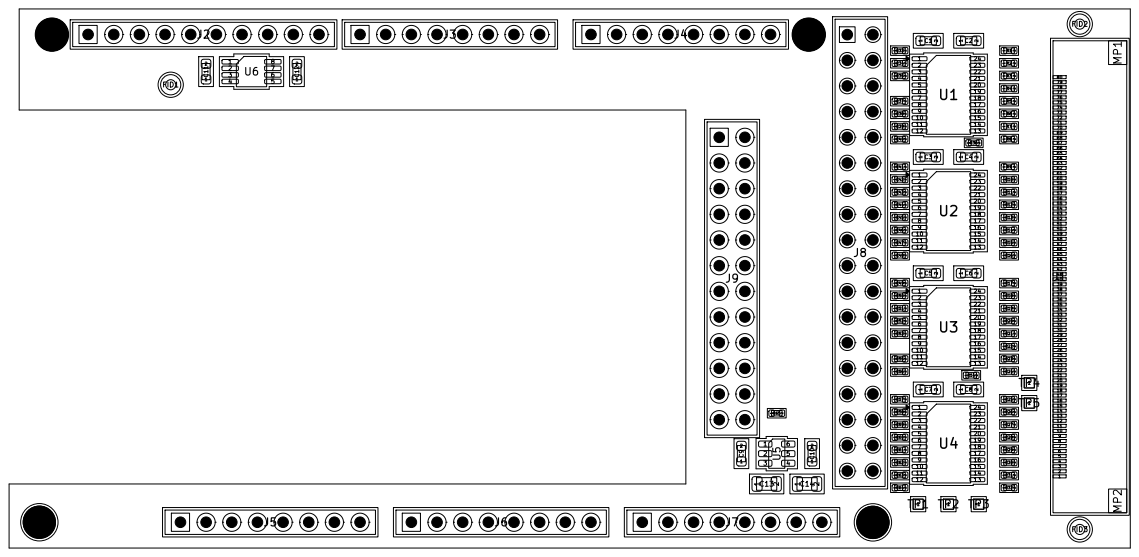
[picture p428: page 1]
