daleondev/ProtoMate_Control/hardware/display/giga-adapter/giga-adapter.kicad_pcb

## KiCad design hardware/display/giga-adapter/giga-adapter.kicad_pcb (2026-10-23)

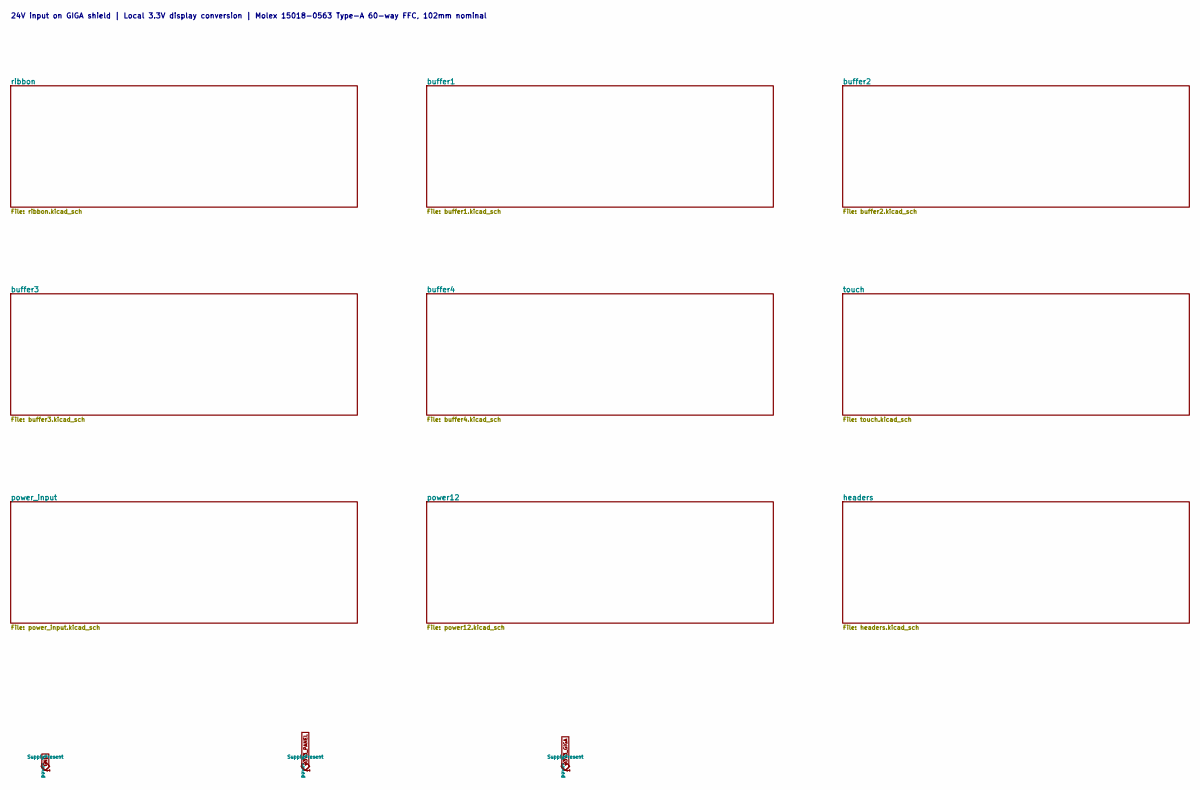
[picture p429: schematic giga-adapter.kicad_sch, giga-adapter / Smartwin display interface]

Notes on the sheet:
24V input on GIGA shield | Local 3.3V display conversion | Molex 15018-0563 Type-A 60-way FFC, 102mm nominal

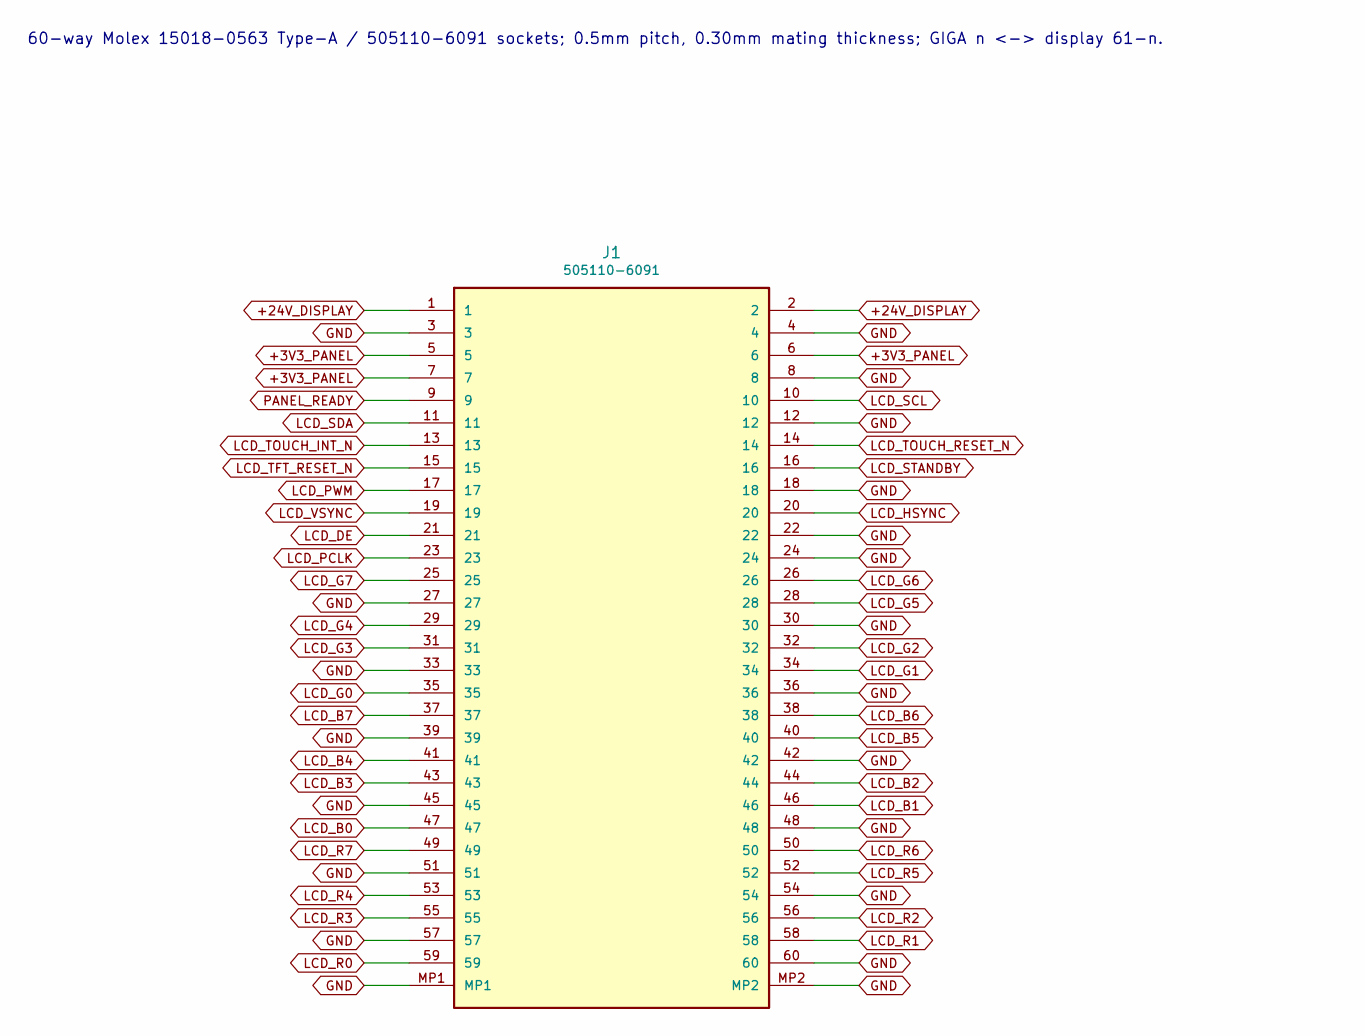
[picture p430: schematic ribbon.kicad_sch, giga-adapter / ribbon]

Parts:
J1: 505110-6091; Molex_505110-6091_1x60_P0.50mm; MPN 505110-6091

Connections:
+3V3_PANEL: J1.5, J1.6, J1.7; also elsewhere on the board
+24V_DISPLAY: J1.1, J1.2; also elsewhere on the board
GND: J1.3, J1.4, J1.8, J1.12, J1.18, J1.22, J1.24, J1.27, J1.30, J1.33, J1.36, J1.39, J1.42, J1.45, J1.48, J1.51, J1.54, J1.57, J1.60, J1.MP1, J1.MP2; also elsewhere on the board
LCD_B0: J1.47; also elsewhere on the board
LCD_B1: J1.46; also elsewhere on the board
LCD_B2: J1.44; also elsewhere on the board
LCD_B3: J1.43; also elsewhere on the board
LCD_B4: J1.41; also elsewhere on the board
LCD_B5: J1.40; also elsewhere on the board
LCD_B6: J1.38; also elsewhere on the board
LCD_B7: J1.37; also elsewhere on the board
LCD_DE: J1.21; also elsewhere on the board
LCD_G0: J1.35; also elsewhere on the board
LCD_G1: J1.34; also elsewhere on the board
LCD_G2: J1.32; also elsewhere on the board
LCD_G3: J1.31; also elsewhere on the board
LCD_G4: J1.29; also elsewhere on the board
LCD_G5: J1.28; also elsewhere on the board
LCD_G6: J1.26; also elsewhere on the board
LCD_G7: J1.25; also elsewhere on the board
LCD_HSYNC: J1.20; also elsewhere on the board
LCD_PCLK: J1.23; also elsewhere on the board
LCD_PWM: J1.17; also elsewhere on the board
LCD_R0: J1.59; also elsewhere on the board
LCD_R1: J1.58; also elsewhere on the board
LCD_R2: J1.56; also elsewhere on the board
LCD_R3: J1.55; also elsewhere on the board
LCD_R4: J1.53; also elsewhere on the board
LCD_R5: J1.52; also elsewhere on the board
LCD_R6: J1.50; also elsewhere on the board
LCD_R7: J1.49; also elsewhere on the board
LCD_SCL: J1.10; also elsewhere on the board
LCD_SDA: J1.11; also elsewhere on the board
LCD_STANDBY: J1.16; also elsewhere on the board
LCD_TFT_RESET_N: J1.15; also elsewhere on the board
LCD_TOUCH_INT_N: J1.13; also elsewhere on the board
LCD_TOUCH_RESET_N: J1.14; also elsewhere on the board
LCD_VSYNC: J1.19; also elsewhere on the board
PANEL_READY: J1.9; also elsewhere on the board

Notes on the sheet:
60-way Molex 15018-0563 Type-A / 505110-6091 sockets; 0.5mm pitch, 0.30mm mating thickness; GIGA n <-> display 61-n.

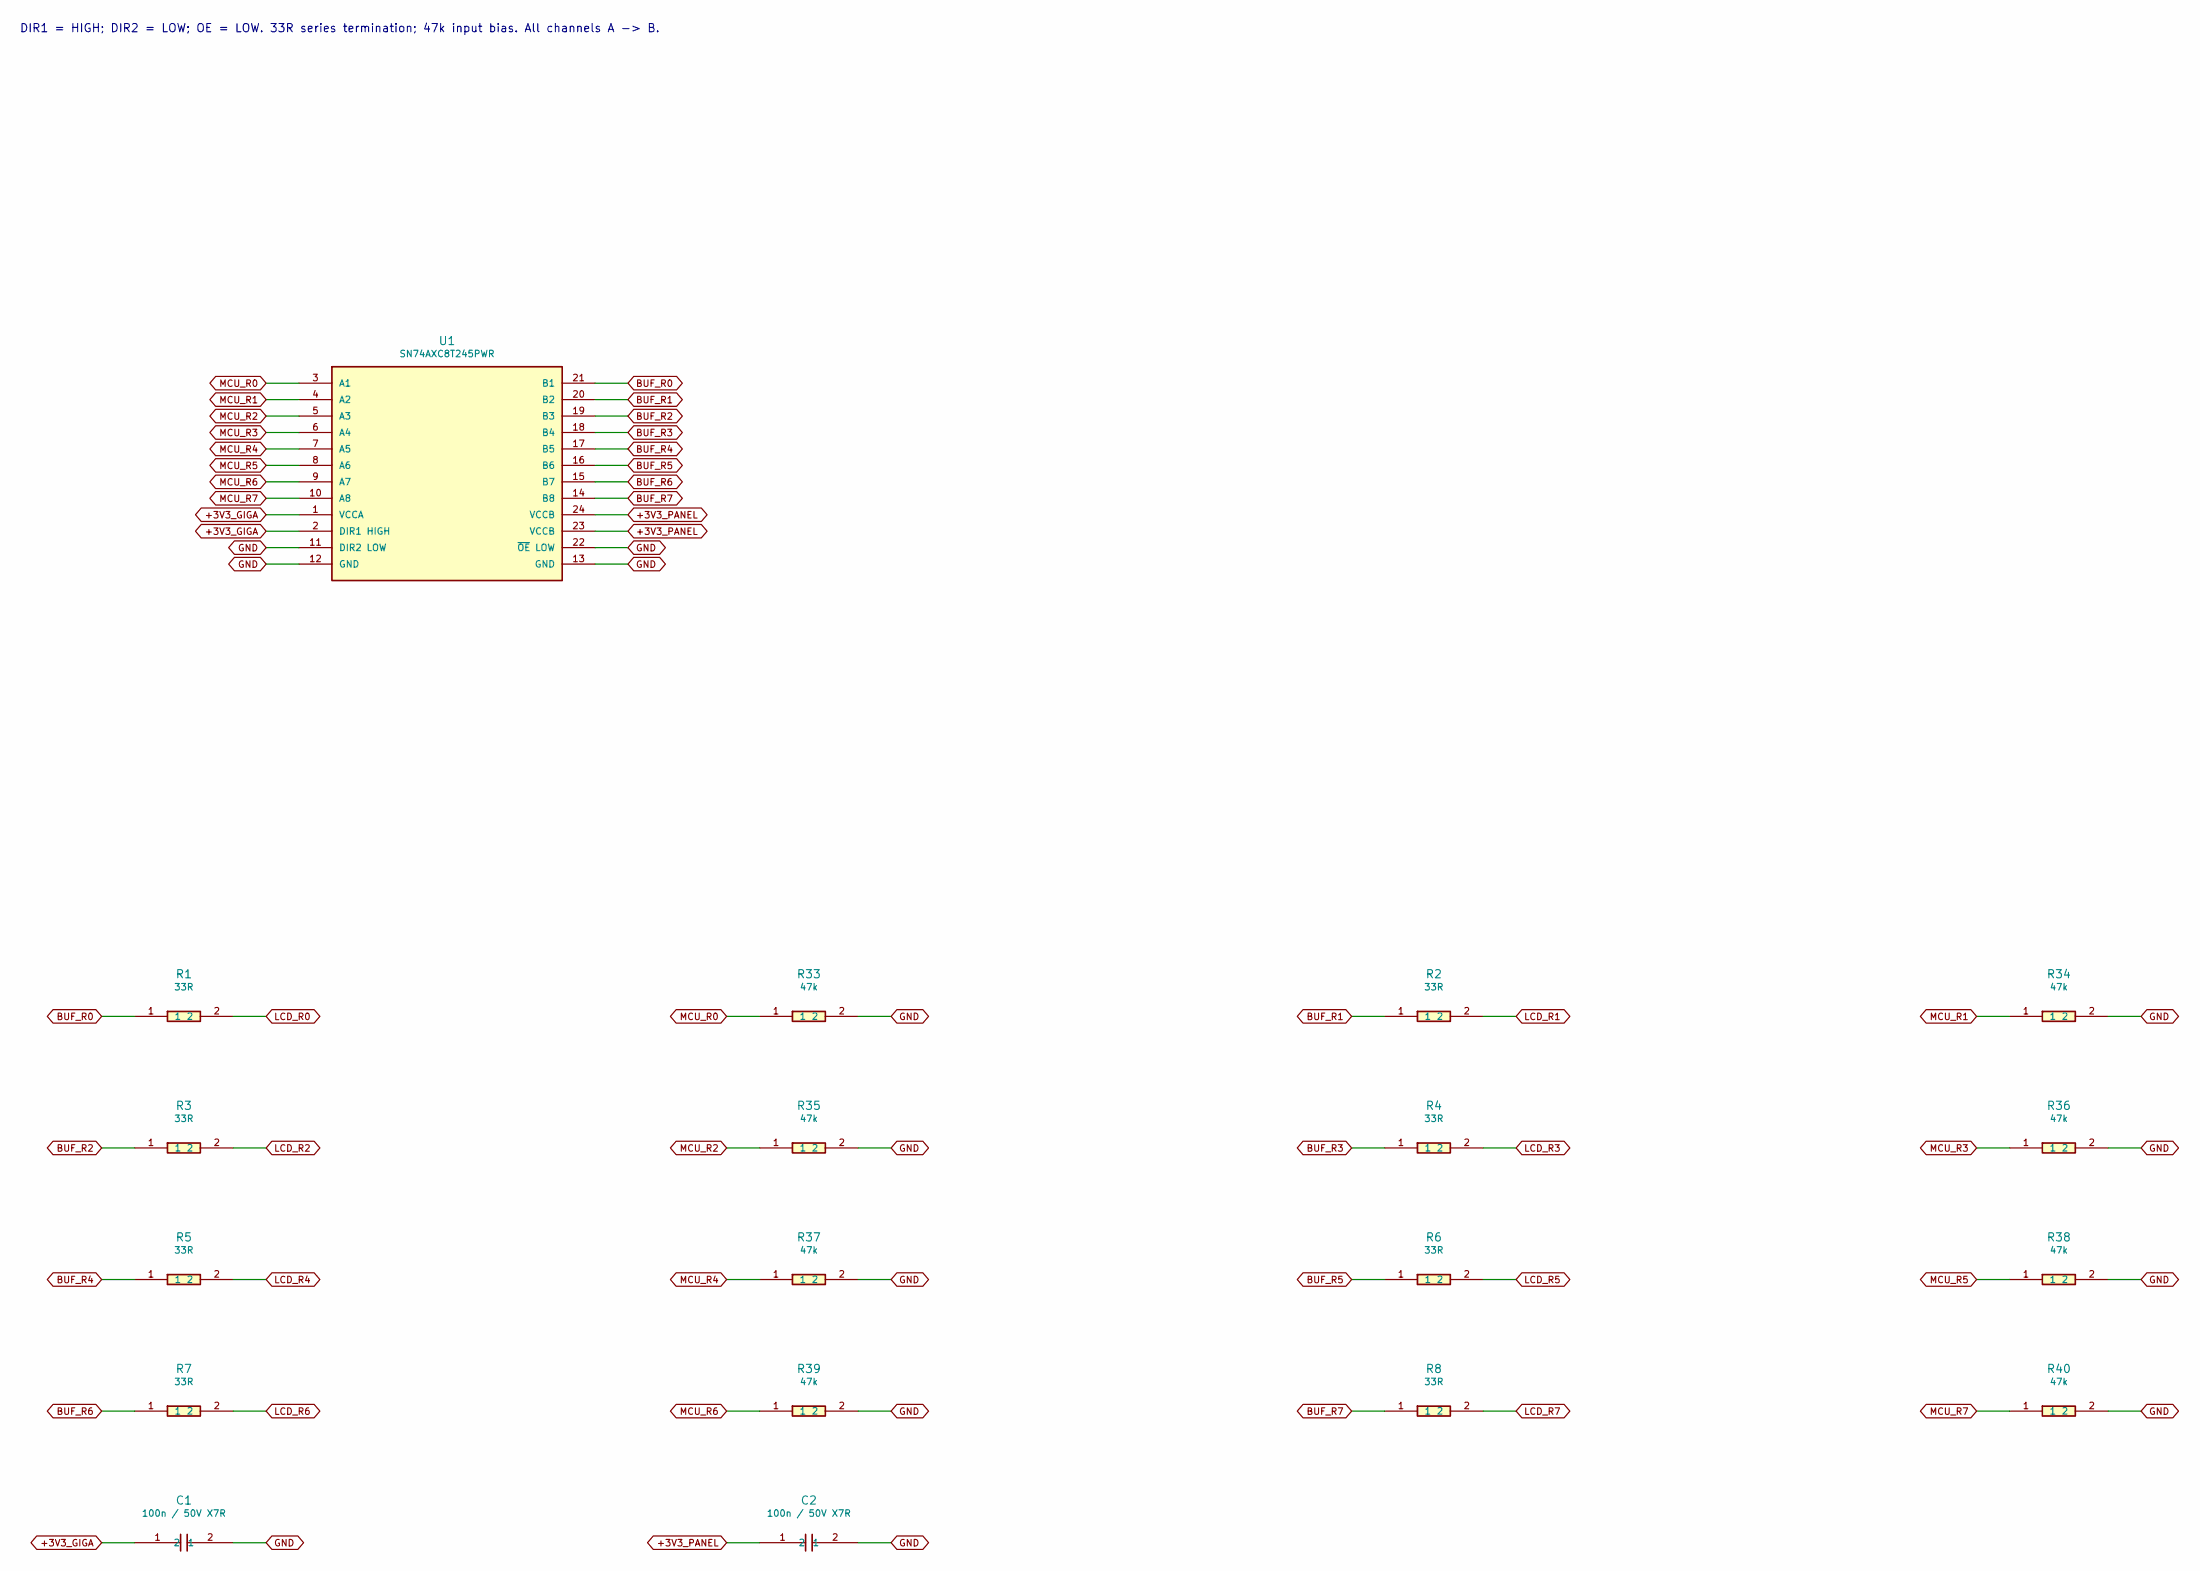
[picture p431: schematic buffer1.kicad_sch, giga-adapter / buffer1]

Parts:
C1, C2: 100n / 50V X7R; C_0603_1608Metric; MPN C0603C104K5RACTU
R1, R2, R3, R4, R5, R6, R7, R8: 33R; R_0402_1005Metric; MPN RC0402FR-0733RL
R33, R34, R35, R36, R37, R38, R39, R40: 47k; R_0402_1005Metric; MPN RC0402FR-0747KL
U1: SN74AXC8T245PWR; TSSOP-24_4.4x7.8mm_P0.65mm; MPN SN74AXC8T245PWR

Connections:
+3V3_GIGA: C1.1, U1.1 (VCCA), U1.2 (DIR1 HIGH); also elsewhere on the board
+3V3_PANEL: C2.1, U1.23 (VCCB), U1.24 (VCCB); also elsewhere on the board
BUF_R0: R1.1, U1.21 (B1)
BUF_R1: R2.1, U1.20 (B2)
BUF_R2: R3.1, U1.19 (B3)
BUF_R3: R4.1, U1.18 (B4)
BUF_R4: R5.1, U1.17 (B5)
BUF_R5: R6.1, U1.16 (B6)
BUF_R6: R7.1, U1.15 (B7)
BUF_R7: R8.1, U1.14 (B8)
GND: C1.2, C2.2, R33.2, R34.2, R35.2, R36.2, R37.2, R38.2, R39.2, R40.2, U1.11 (DIR2 LOW), U1.12 (GND), U1.13 (GND), U1.22 (~OE LOW); also elsewhere on the board
LCD_R0: R1.2; also elsewhere on the board
LCD_R1: R2.2; also elsewhere on the board
LCD_R2: R3.2; also elsewhere on the board
LCD_R3: R4.2; also elsewhere on the board
LCD_R4: R5.2; also elsewhere on the board
LCD_R5: R6.2; also elsewhere on the board
LCD_R6: R7.2; also elsewhere on the board
LCD_R7: R8.2; also elsewhere on the board
MCU_R0: R33.1, U1.3 (A1); also elsewhere on the board
MCU_R1: R34.1, U1.4 (A2); also elsewhere on the board
MCU_R2: R35.1, U1.5 (A3); also elsewhere on the board
MCU_R3: R36.1, U1.6 (A4); also elsewhere on the board
MCU_R4: R37.1, U1.7 (A5); also elsewhere on the board
MCU_R5: R38.1, U1.8 (A6); also elsewhere on the board
MCU_R6: R39.1, U1.9 (A7); also elsewhere on the board
MCU_R7: R40.1, U1.10 (A8); also elsewhere on the board

Notes on the sheet:
DIR1 = HIGH; DIR2 = LOW; OE = LOW. 33R series termination; 47k input bias. All channels A -> B.

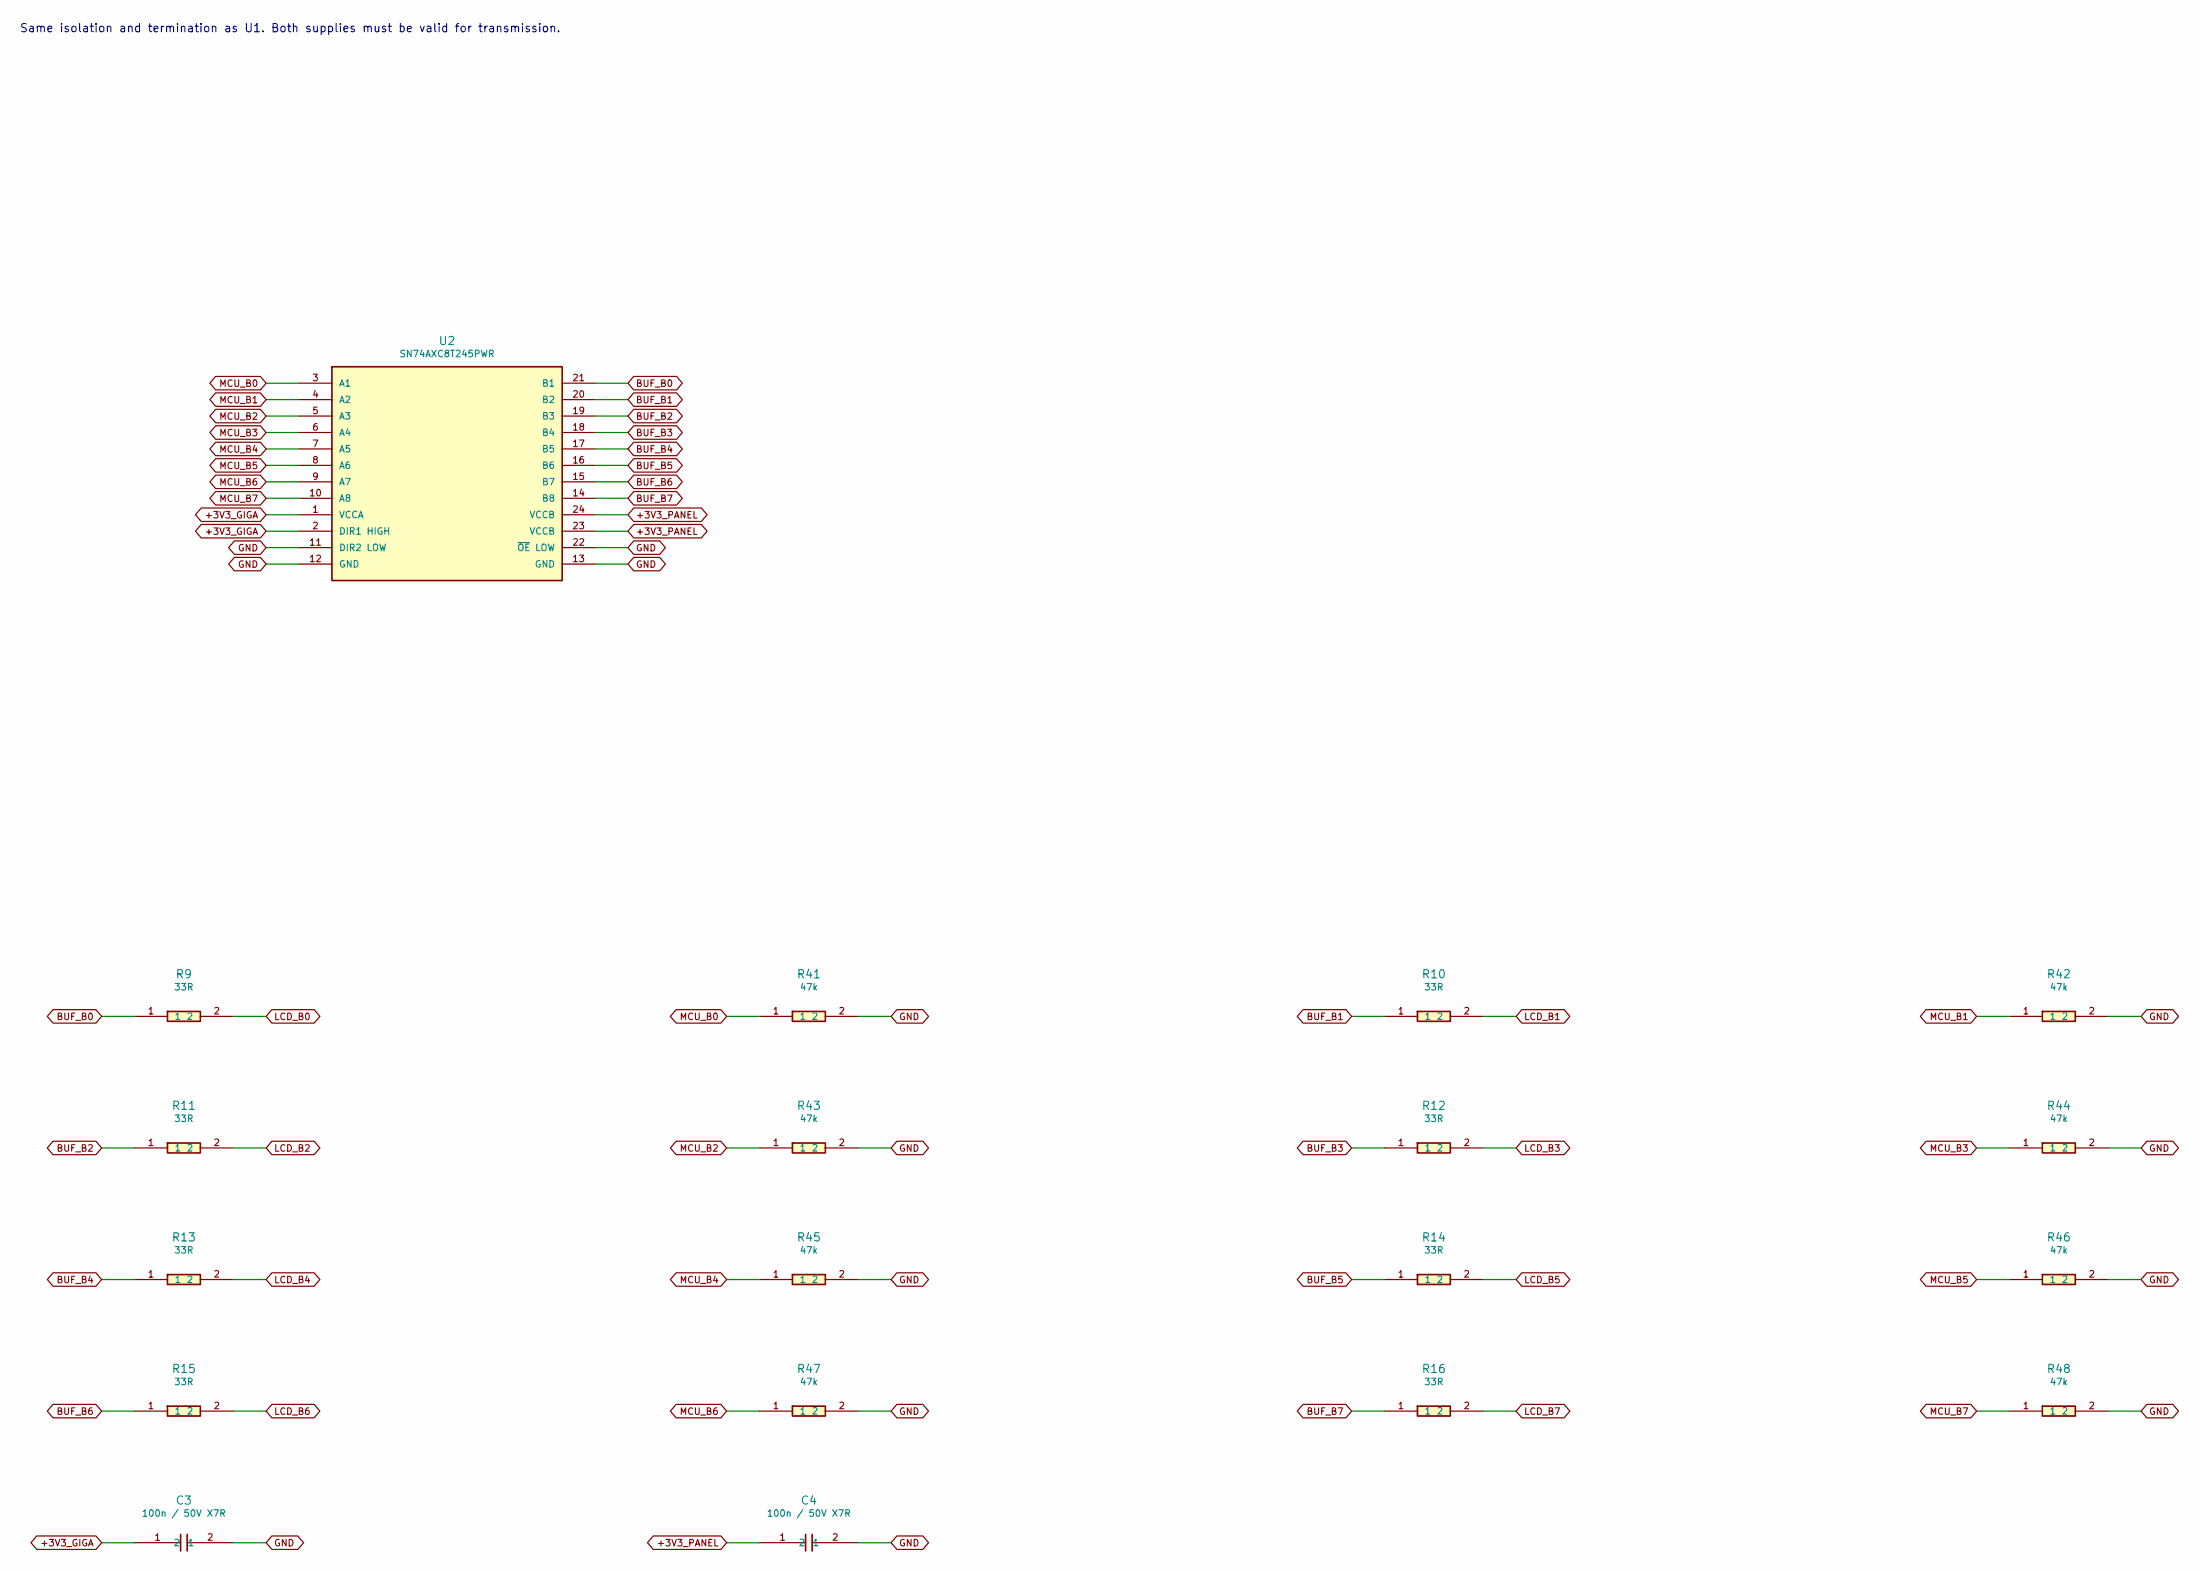
[picture p432: schematic buffer2.kicad_sch, giga-adapter / buffer2]

Parts:
C3, C4: 100n / 50V X7R; C_0603_1608Metric; MPN C0603C104K5RACTU
R9, R10, R11, R12, R13, R14, R15, R16: 33R; R_0402_1005Metric; MPN RC0402FR-0733RL
R41, R42, R43, R44, R45, R46, R47, R48: 47k; R_0402_1005Metric; MPN RC0402FR-0747KL
U2: SN74AXC8T245PWR; TSSOP-24_4.4x7.8mm_P0.65mm; MPN SN74AXC8T245PWR

Connections:
+3V3_GIGA: C3.1, U2.1 (VCCA), U2.2 (DIR1 HIGH); also elsewhere on the board
+3V3_PANEL: C4.1, U2.23 (VCCB), U2.24 (VCCB); also elsewhere on the board
BUF_B0: R9.1, U2.21 (B1)
BUF_B1: R10.1, U2.20 (B2)
BUF_B2: R11.1, U2.19 (B3)
BUF_B3: R12.1, U2.18 (B4)
BUF_B4: R13.1, U2.17 (B5)
BUF_B5: R14.1, U2.16 (B6)
BUF_B6: R15.1, U2.15 (B7)
BUF_B7: R16.1, U2.14 (B8)
GND: C3.2, C4.2, R41.2, R42.2, R43.2, R44.2, R45.2, R46.2, R47.2, R48.2, U2.11 (DIR2 LOW), U2.12 (GND), U2.13 (GND), U2.22 (~OE LOW); also elsewhere on the board
LCD_B0: R9.2; also elsewhere on the board
LCD_B1: R10.2; also elsewhere on the board
LCD_B2: R11.2; also elsewhere on the board
LCD_B3: R12.2; also elsewhere on the board
LCD_B4: R13.2; also elsewhere on the board
LCD_B5: R14.2; also elsewhere on the board
LCD_B6: R15.2; also elsewhere on the board
LCD_B7: R16.2; also elsewhere on the board
MCU_B0: R41.1, U2.3 (A1); also elsewhere on the board
MCU_B1: R42.1, U2.4 (A2); also elsewhere on the board
MCU_B2: R43.1, U2.5 (A3); also elsewhere on the board
MCU_B3: R44.1, U2.6 (A4); also elsewhere on the board
MCU_B4: R45.1, U2.7 (A5); also elsewhere on the board
MCU_B5: R46.1, U2.8 (A6); also elsewhere on the board
MCU_B6: R47.1, U2.9 (A7); also elsewhere on the board
MCU_B7: R48.1, U2.10 (A8); also elsewhere on the board

Notes on the sheet:
Same isolation and termination as U1. Both supplies must be valid for transmission.

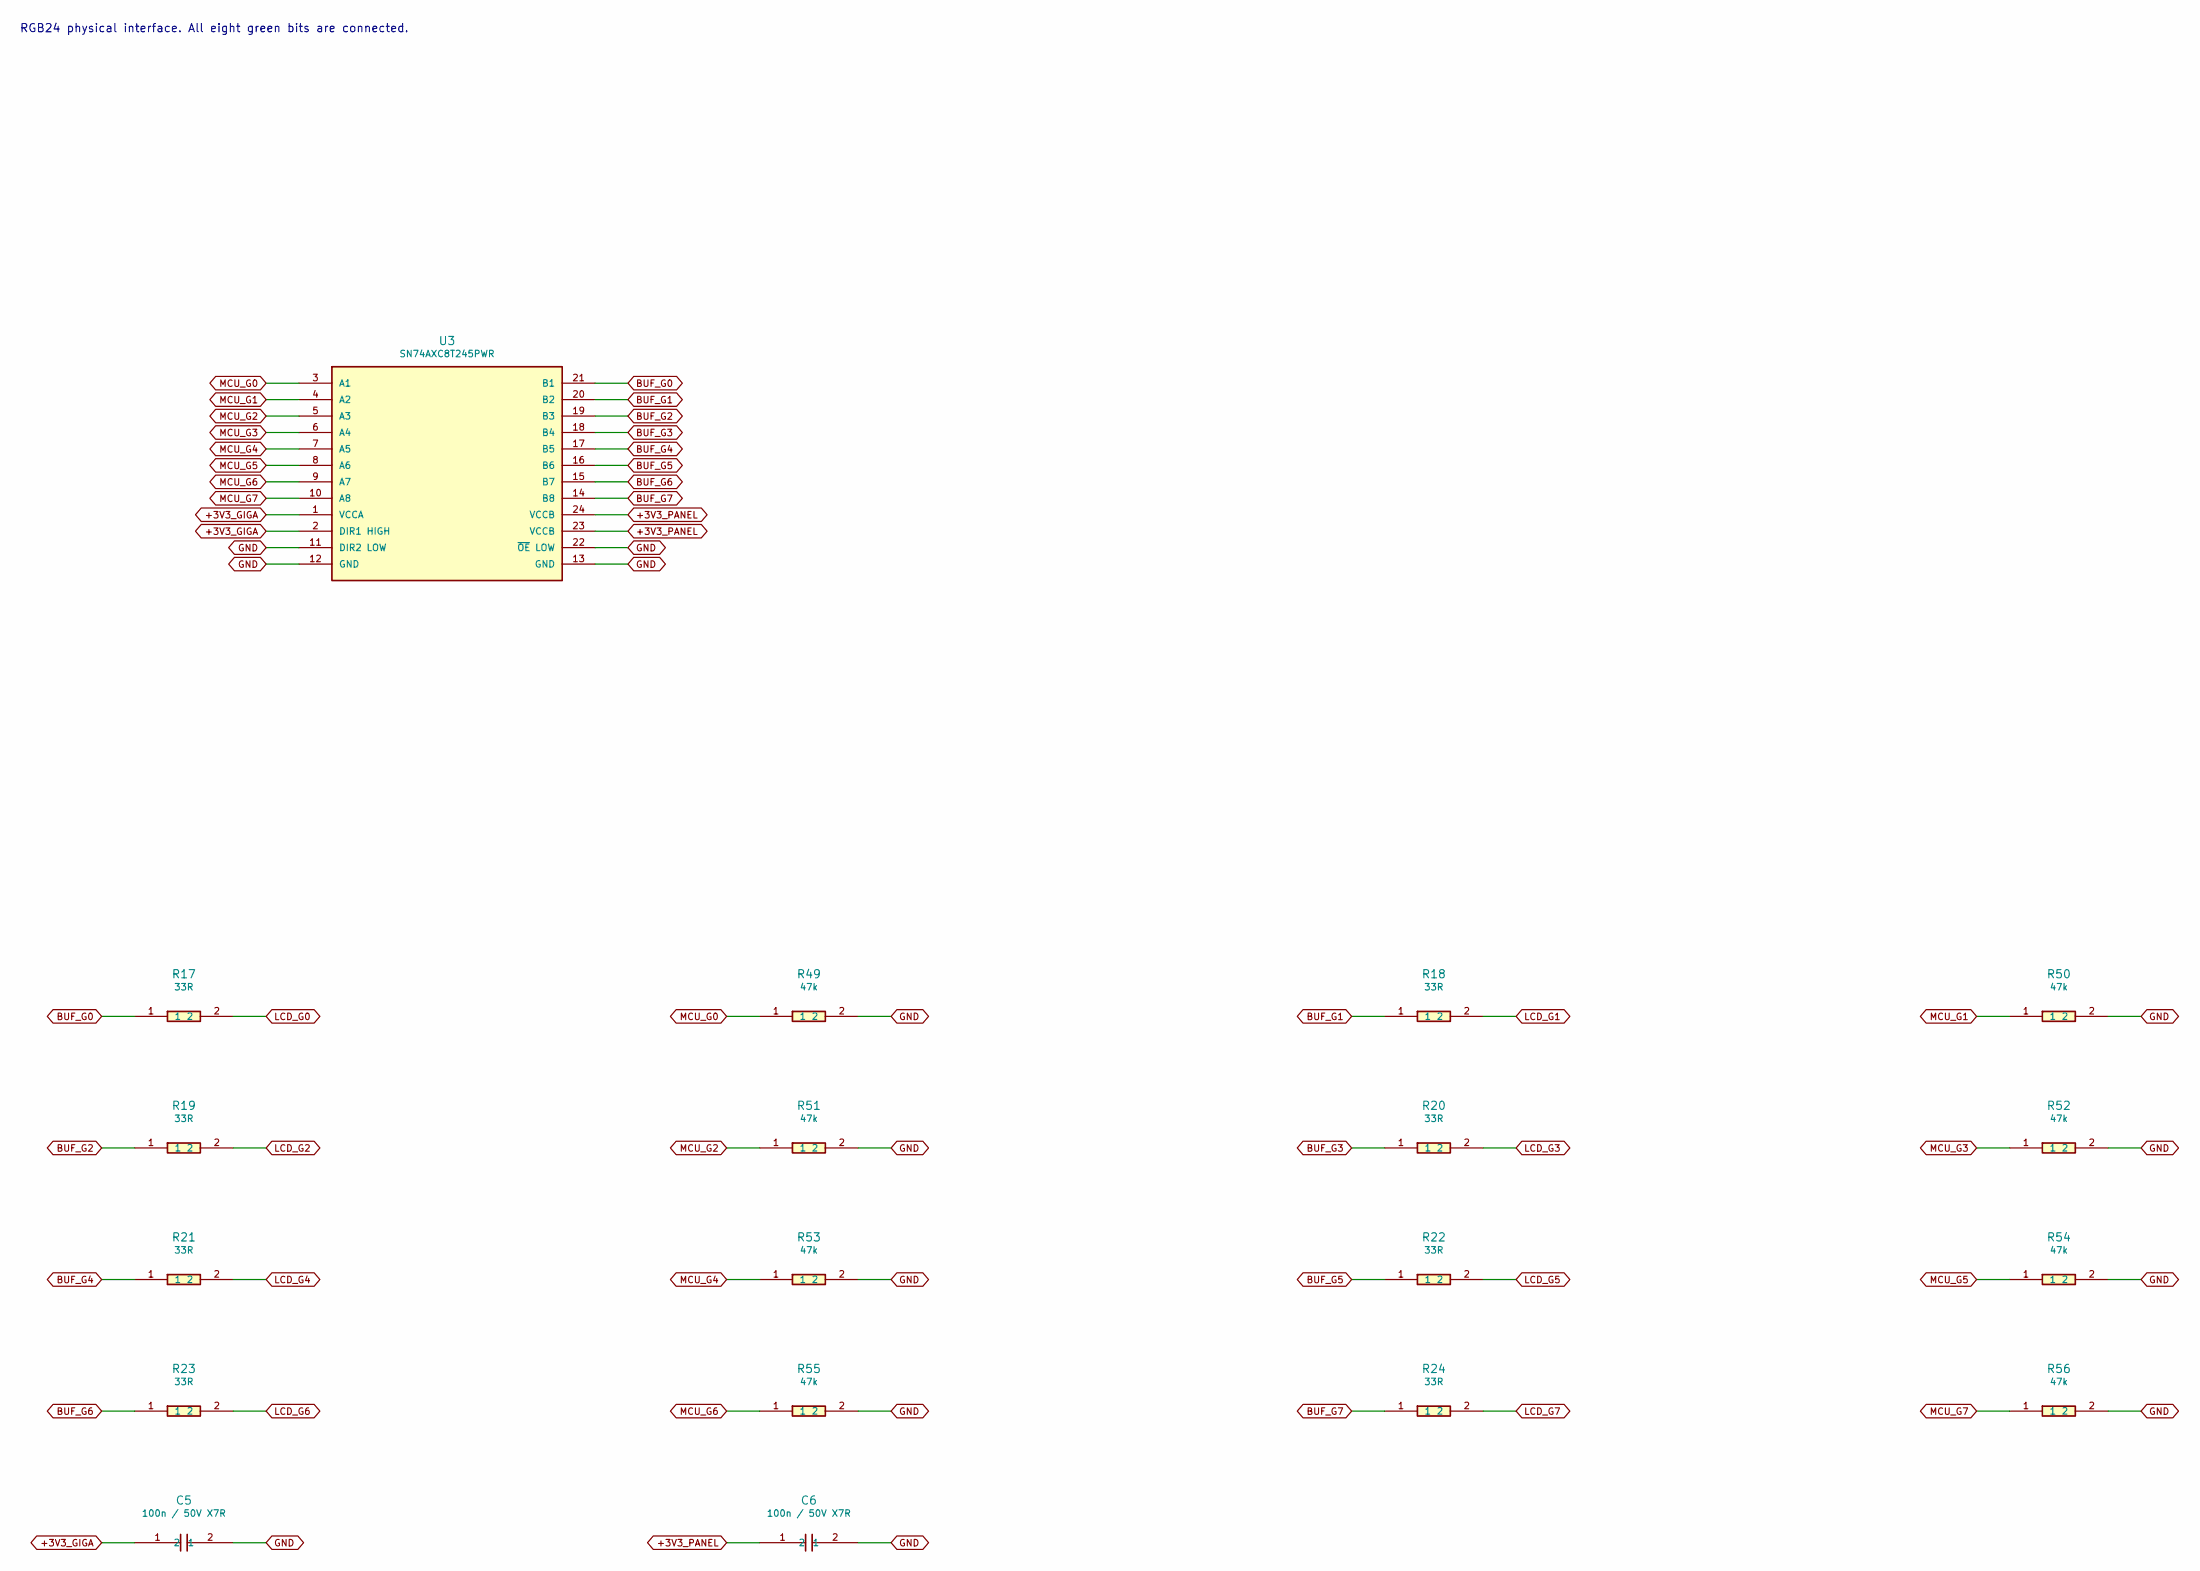
[picture p433: schematic buffer3.kicad_sch, giga-adapter / buffer3]

Parts:
C5, C6: 100n / 50V X7R; C_0603_1608Metric; MPN C0603C104K5RACTU
R17, R18, R19, R20, R21, R22, R23, R24: 33R; R_0402_1005Metric; MPN RC0402FR-0733RL
R49, R50, R51, R52, R53, R54, R55, R56: 47k; R_0402_1005Metric; MPN RC0402FR-0747KL
U3: SN74AXC8T245PWR; TSSOP-24_4.4x7.8mm_P0.65mm; MPN SN74AXC8T245PWR

Connections:
+3V3_GIGA: C5.1, U3.1 (VCCA), U3.2 (DIR1 HIGH); also elsewhere on the board
+3V3_PANEL: C6.1, U3.23 (VCCB), U3.24 (VCCB); also elsewhere on the board
BUF_G0: R17.1, U3.21 (B1)
BUF_G1: R18.1, U3.20 (B2)
BUF_G2: R19.1, U3.19 (B3)
BUF_G3: R20.1, U3.18 (B4)
BUF_G4: R21.1, U3.17 (B5)
BUF_G5: R22.1, U3.16 (B6)
BUF_G6: R23.1, U3.15 (B7)
BUF_G7: R24.1, U3.14 (B8)
GND: C5.2, C6.2, R49.2, R50.2, R51.2, R52.2, R53.2, R54.2, R55.2, R56.2, U3.11 (DIR2 LOW), U3.12 (GND), U3.13 (GND), U3.22 (~OE LOW); also elsewhere on the board
LCD_G0: R17.2; also elsewhere on the board
LCD_G1: R18.2; also elsewhere on the board
LCD_G2: R19.2; also elsewhere on the board
LCD_G3: R20.2; also elsewhere on the board
LCD_G4: R21.2; also elsewhere on the board
LCD_G5: R22.2; also elsewhere on the board
LCD_G6: R23.2; also elsewhere on the board
LCD_G7: R24.2; also elsewhere on the board
MCU_G0: R49.1, U3.3 (A1); also elsewhere on the board
MCU_G1: R50.1, U3.4 (A2); also elsewhere on the board
MCU_G2: R51.1, U3.5 (A3); also elsewhere on the board
MCU_G3: R52.1, U3.6 (A4); also elsewhere on the board
MCU_G4: R53.1, U3.7 (A5); also elsewhere on the board
MCU_G5: R54.1, U3.8 (A6); also elsewhere on the board
MCU_G6: R55.1, U3.9 (A7); also elsewhere on the board
MCU_G7: R56.1, U3.10 (A8); also elsewhere on the board

Notes on the sheet:
RGB24 physical interface. All eight green bits are connected.

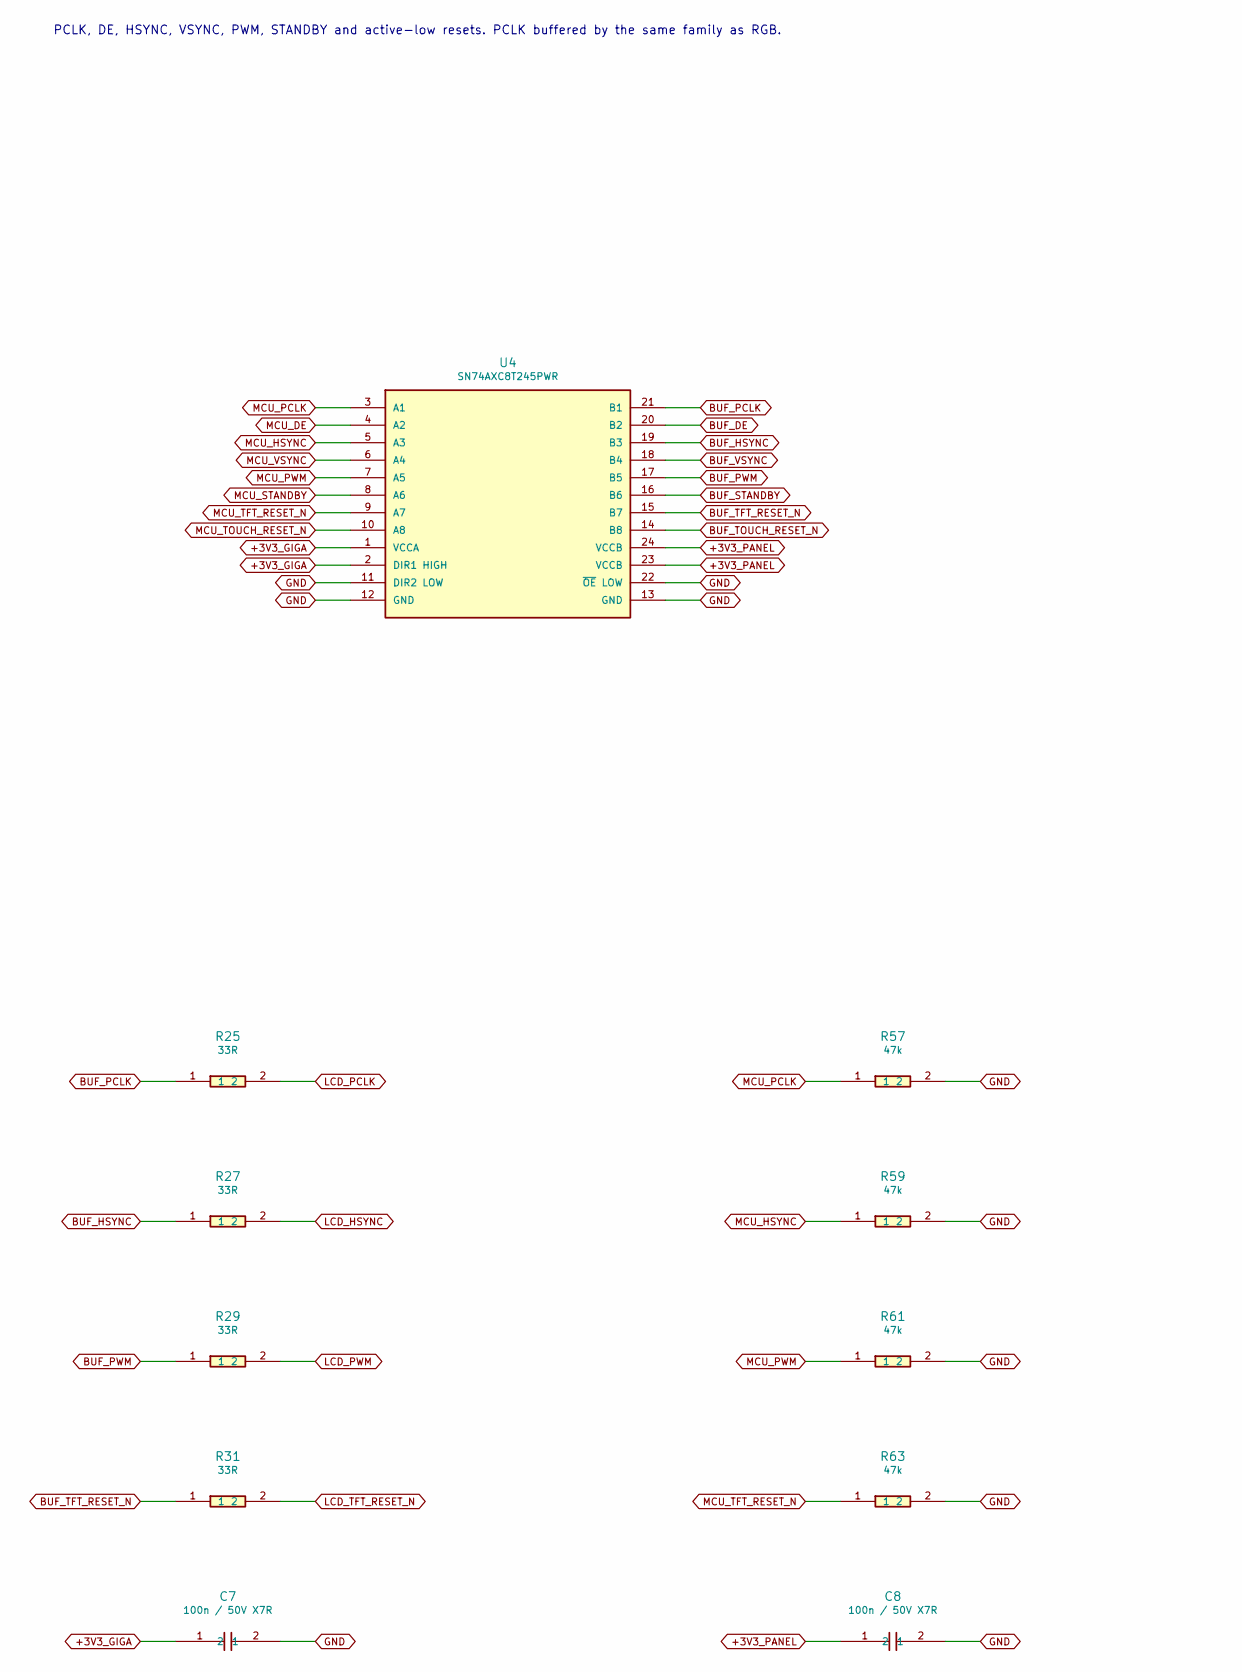
[picture p434: schematic buffer4.kicad_sch, giga-adapter / buffer4, part in row 1, column 1]

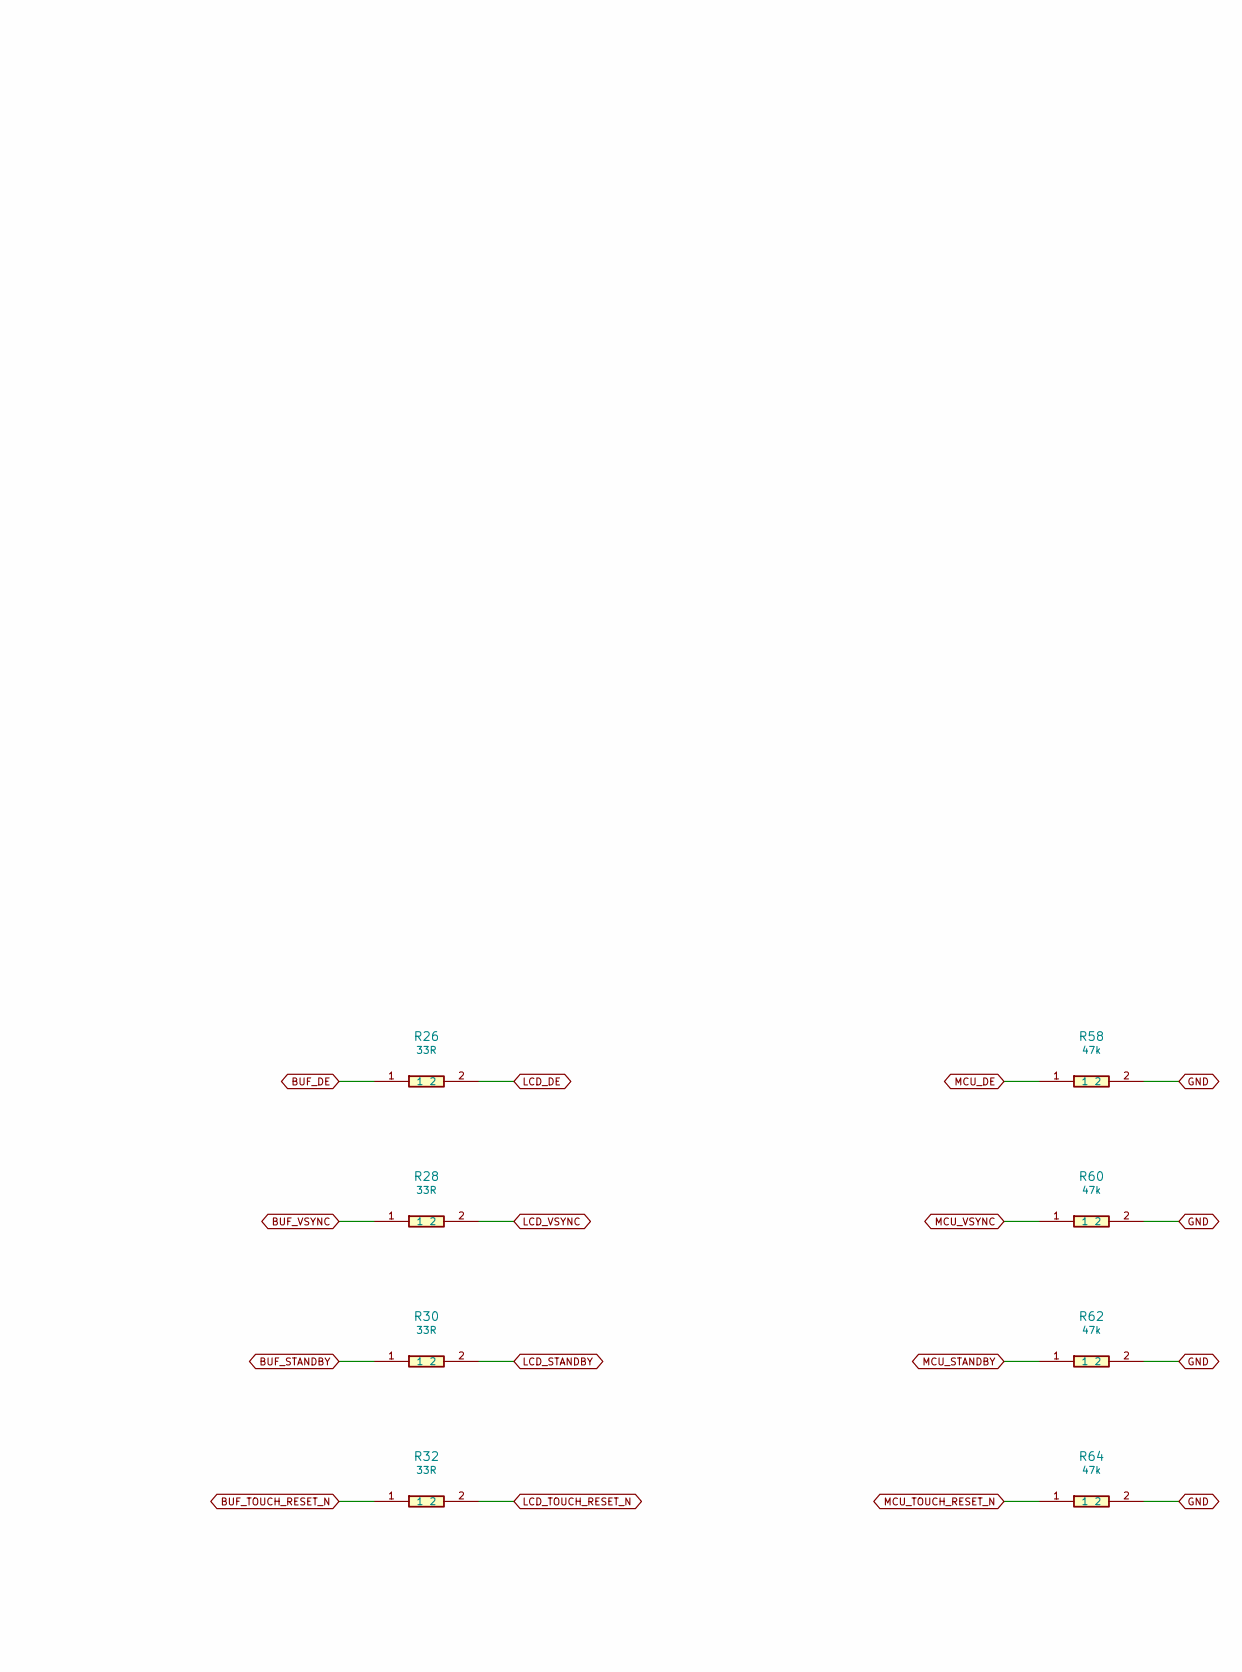
[picture p435: schematic buffer4.kicad_sch, giga-adapter / buffer4, part in row 1, column 2]

Parts:
C7, C8: 100n / 50V X7R; C_0603_1608Metric; MPN C0603C104K5RACTU
R25, R26, R27, R28, R29, R30, R31, R32: 33R; R_0402_1005Metric; MPN RC0402FR-0733RL
R57, R58, R59, R60, R61, R62, R63, R64: 47k; R_0402_1005Metric; MPN RC0402FR-0747KL
U4: SN74AXC8T245PWR; TSSOP-24_4.4x7.8mm_P0.65mm; MPN SN74AXC8T245PWR

Connections:
+3V3_GIGA: C7.1, U4.1 (VCCA), U4.2 (DIR1 HIGH); also elsewhere on the board
+3V3_PANEL: C8.1, U4.23 (VCCB), U4.24 (VCCB); also elsewhere on the board
BUF_DE: R26.1, U4.20 (B2)
BUF_HSYNC: R27.1, U4.19 (B3)
BUF_PCLK: R25.1, U4.21 (B1)
BUF_PWM: R29.1, U4.17 (B5)
BUF_STANDBY: R30.1, U4.16 (B6)
BUF_TFT_RESET_N: R31.1, U4.15 (B7)
BUF_TOUCH_RESET_N: R32.1, U4.14 (B8)
BUF_VSYNC: R28.1, U4.18 (B4)
GND: C7.2, C8.2, R57.2, R58.2, R59.2, R60.2, R61.2, R62.2, R63.2, R64.2, U4.11 (DIR2 LOW), U4.12 (GND), U4.13 (GND), U4.22 (~OE LOW); also elsewhere on the board
LCD_DE: R26.2; also elsewhere on the board
LCD_HSYNC: R27.2; also elsewhere on the board
LCD_PCLK: R25.2; also elsewhere on the board
LCD_PWM: R29.2; also elsewhere on the board
LCD_STANDBY: R30.2; also elsewhere on the board
LCD_TFT_RESET_N: R31.2; also elsewhere on the board
LCD_TOUCH_RESET_N: R32.2; also elsewhere on the board
LCD_VSYNC: R28.2; also elsewhere on the board
MCU_DE: R58.1, U4.4 (A2); also elsewhere on the board
MCU_HSYNC: R59.1, U4.5 (A3); also elsewhere on the board
MCU_PCLK: R57.1, U4.3 (A1); also elsewhere on the board
MCU_PWM: R61.1, U4.7 (A5); also elsewhere on the board
MCU_STANDBY: R62.1, U4.8 (A6); also elsewhere on the board
MCU_TFT_RESET_N: R63.1, U4.9 (A7); also elsewhere on the board
MCU_TOUCH_RESET_N: R64.1, U4.10 (A8); also elsewhere on the board
MCU_VSYNC: R60.1, U4.6 (A4); also elsewhere on the board

Notes on the sheet:
PCLK, DE, HSYNC, VSYNC, PWM, STANDBY and active-low resets. PCLK buffered by the same family as RGB.
