daleondev/ProtoMate_Control/hardware/display/giga-adapter/giga-adapter.kicad_pcb

## KiCad design hardware/display/giga-adapter/giga-adapter.kicad_pcb (continued)

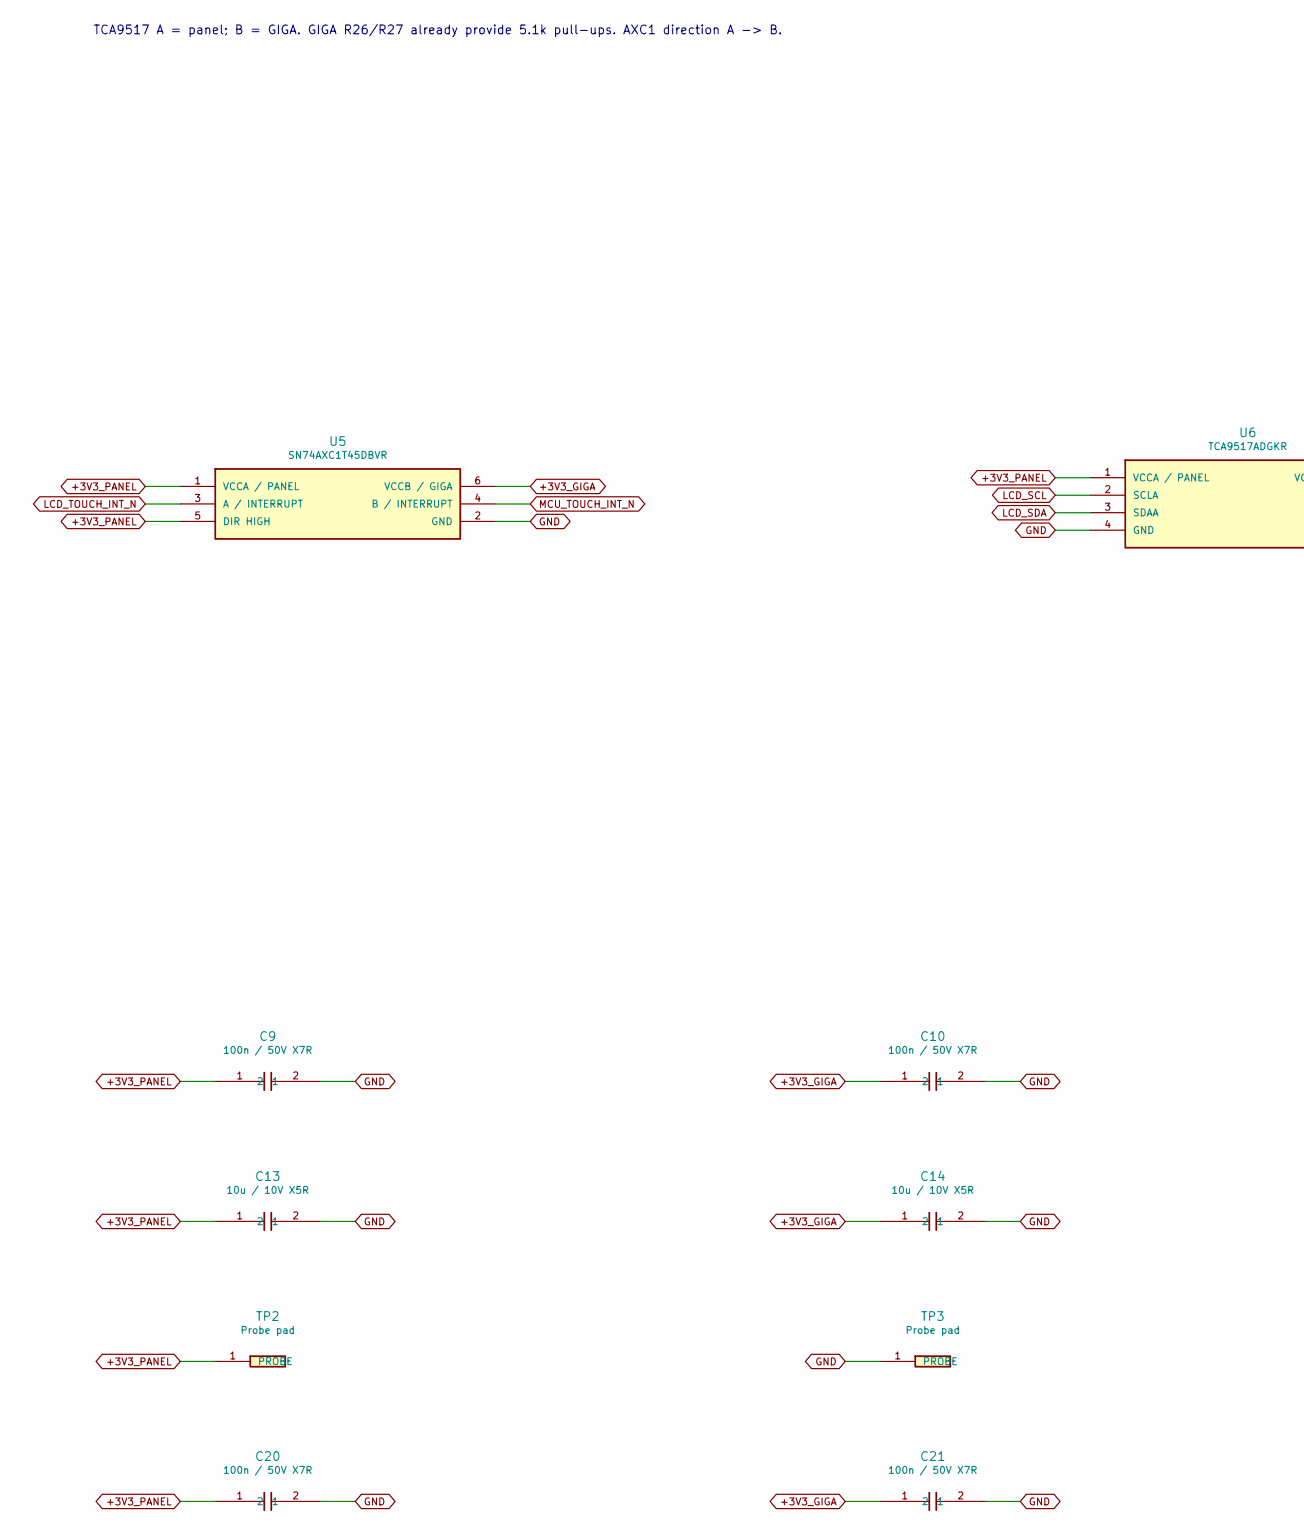
[picture p436: schematic touch.kicad_sch, giga-adapter / touch, part in row 1, column 1]

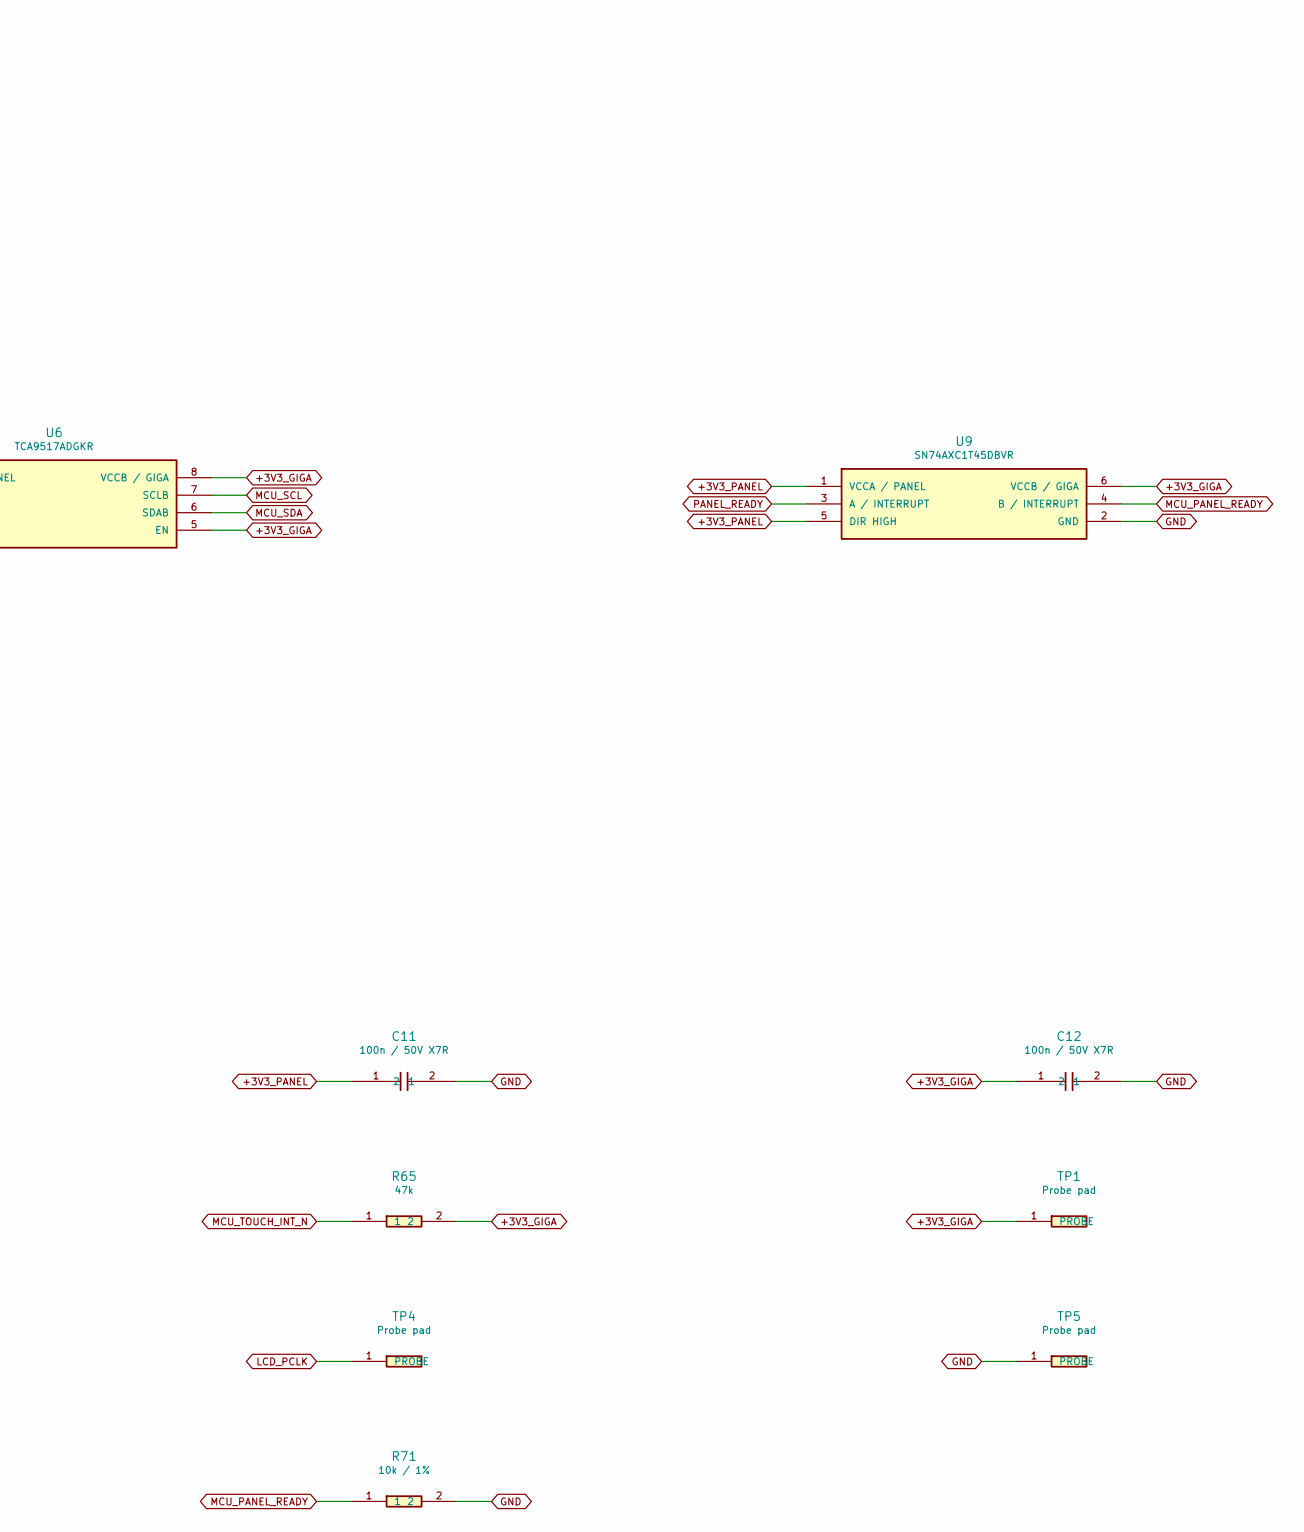
[picture p437: schematic touch.kicad_sch, giga-adapter / touch, part in row 1, column 2]

Parts:
C9, C10, C11, C12, C20, C21: 100n / 50V X7R; C_0603_1608Metric; MPN C0603C104K5RACTU
C13, C14: 10u / 10V X5R; C_0805_2012Metric; MPN C0805C106K8PACTU
R65: 47k; R_0402_1005Metric; MPN RC0402FR-0747KL
R71: 10k / 1%; R_0603_1608Metric; MPN RC0603FR-0710KL
TP1, TP2, TP3, TP4, TP5: Probe pad; TestPoint_1.0mm; MPN PCB copper feature
U5, U9: SN74AXC1T45DBVR; SOT-23-6; MPN SN74AXC1T45DBVR
U6: TCA9517ADGKR; VSSOP-8_3x3mm_P0.65mm; MPN TCA9517ADGKR

Connections:
+3V3_GIGA: C10.1, C12.1, C14.1, C21.1, R65.2, TP1.1, U5.6 (VCCB / GIGA), U6.5 (EN), U6.8 (VCCB / GIGA), U9.6 (VCCB / GIGA); also elsewhere on the board
+3V3_PANEL: C9.1, C11.1, C13.1, C20.1, TP2.1, U5.1 (VCCA / PANEL), U5.5 (DIR HIGH), U6.1 (VCCA / PANEL), U9.1 (VCCA / PANEL), U9.5 (DIR HIGH); also elsewhere on the board
GND: C9.2, C10.2, C11.2, C12.2, C13.2, C14.2, C20.2, C21.2, R71.2, TP3.1, TP5.1, U5.2 (GND), U6.4 (GND), U9.2 (GND); also elsewhere on the board
LCD_PCLK: TP4.1; also elsewhere on the board
LCD_SCL: U6.2 (SCLA); also elsewhere on the board
LCD_SDA: U6.3 (SDAA); also elsewhere on the board
LCD_TOUCH_INT_N: U5.3 (A / INTERRUPT); also elsewhere on the board
MCU_PANEL_READY: R71.1, U9.4 (B / INTERRUPT); also elsewhere on the board
MCU_SCL: U6.7 (SCLB); also elsewhere on the board
MCU_SDA: U6.6 (SDAB); also elsewhere on the board
MCU_TOUCH_INT_N: R65.1, U5.4 (B / INTERRUPT); also elsewhere on the board
PANEL_READY: U9.3 (A / INTERRUPT); also elsewhere on the board

Notes on the sheet:
TCA9517 A = panel; B = GIGA. GIGA R26/R27 already provide 5.1k pull-ups. AXC1 direction A -> B.

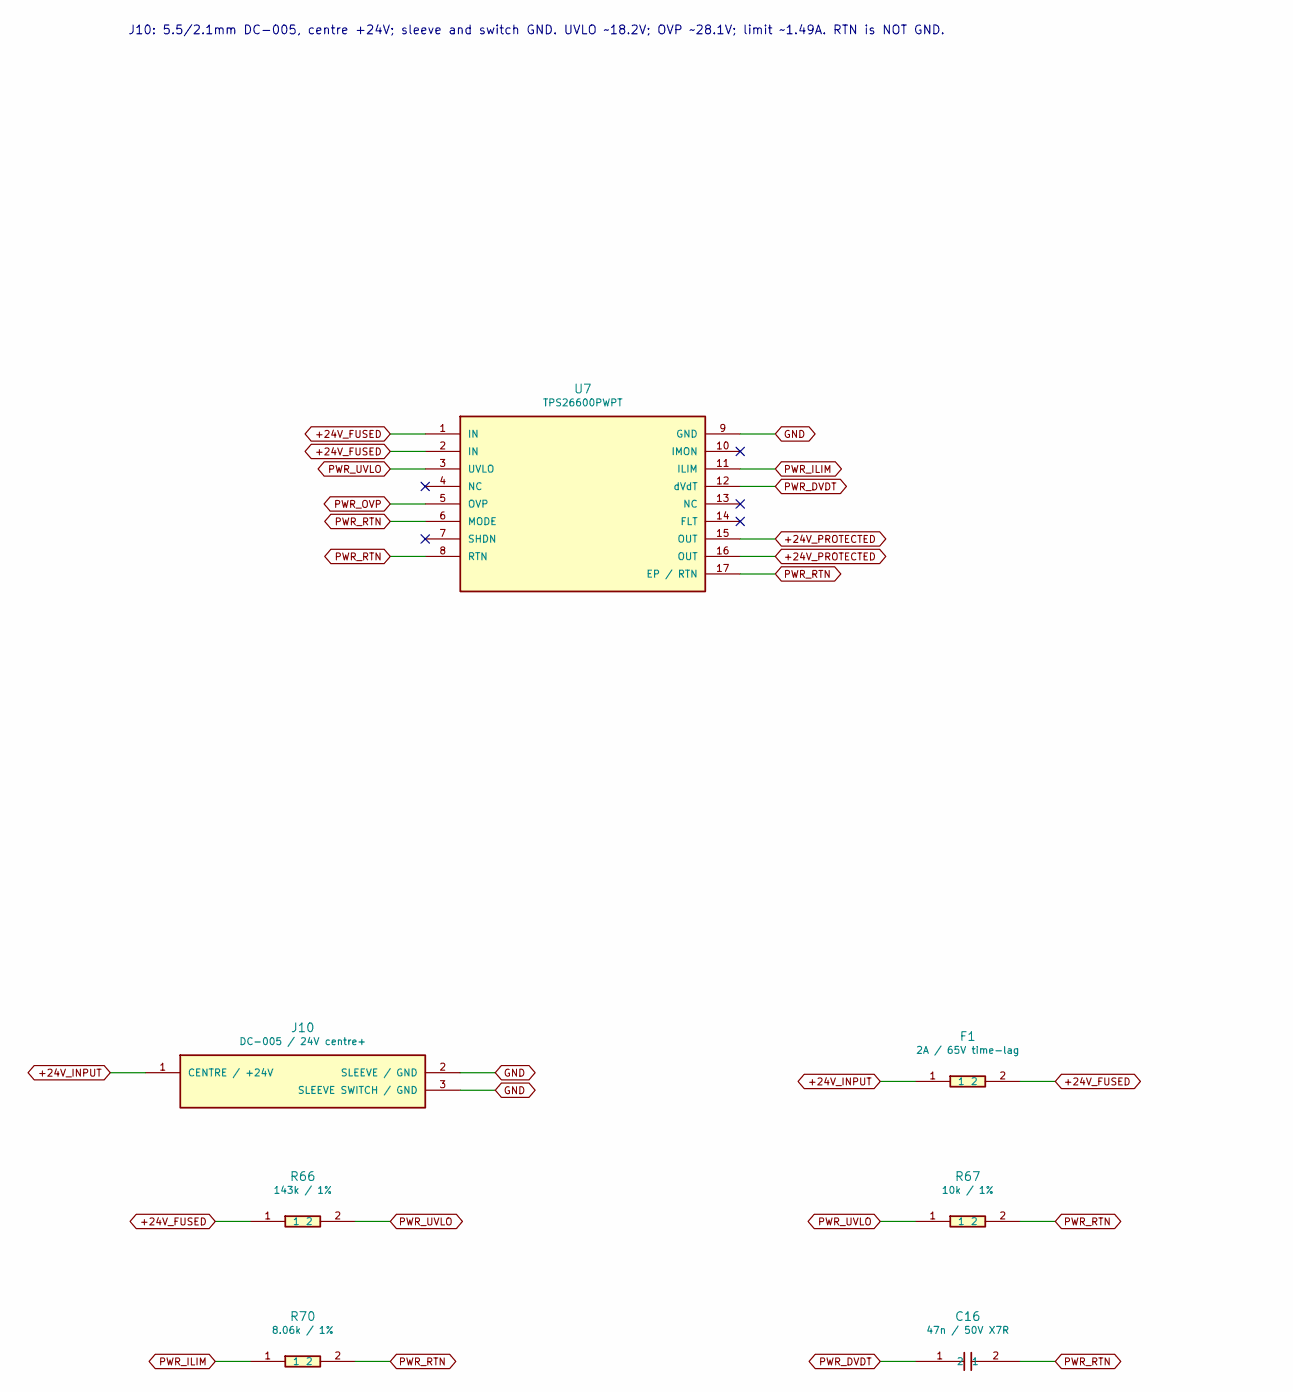
[picture p438: schematic power_input.kicad_sch, giga-adapter / power_input, part in row 1, column 1]

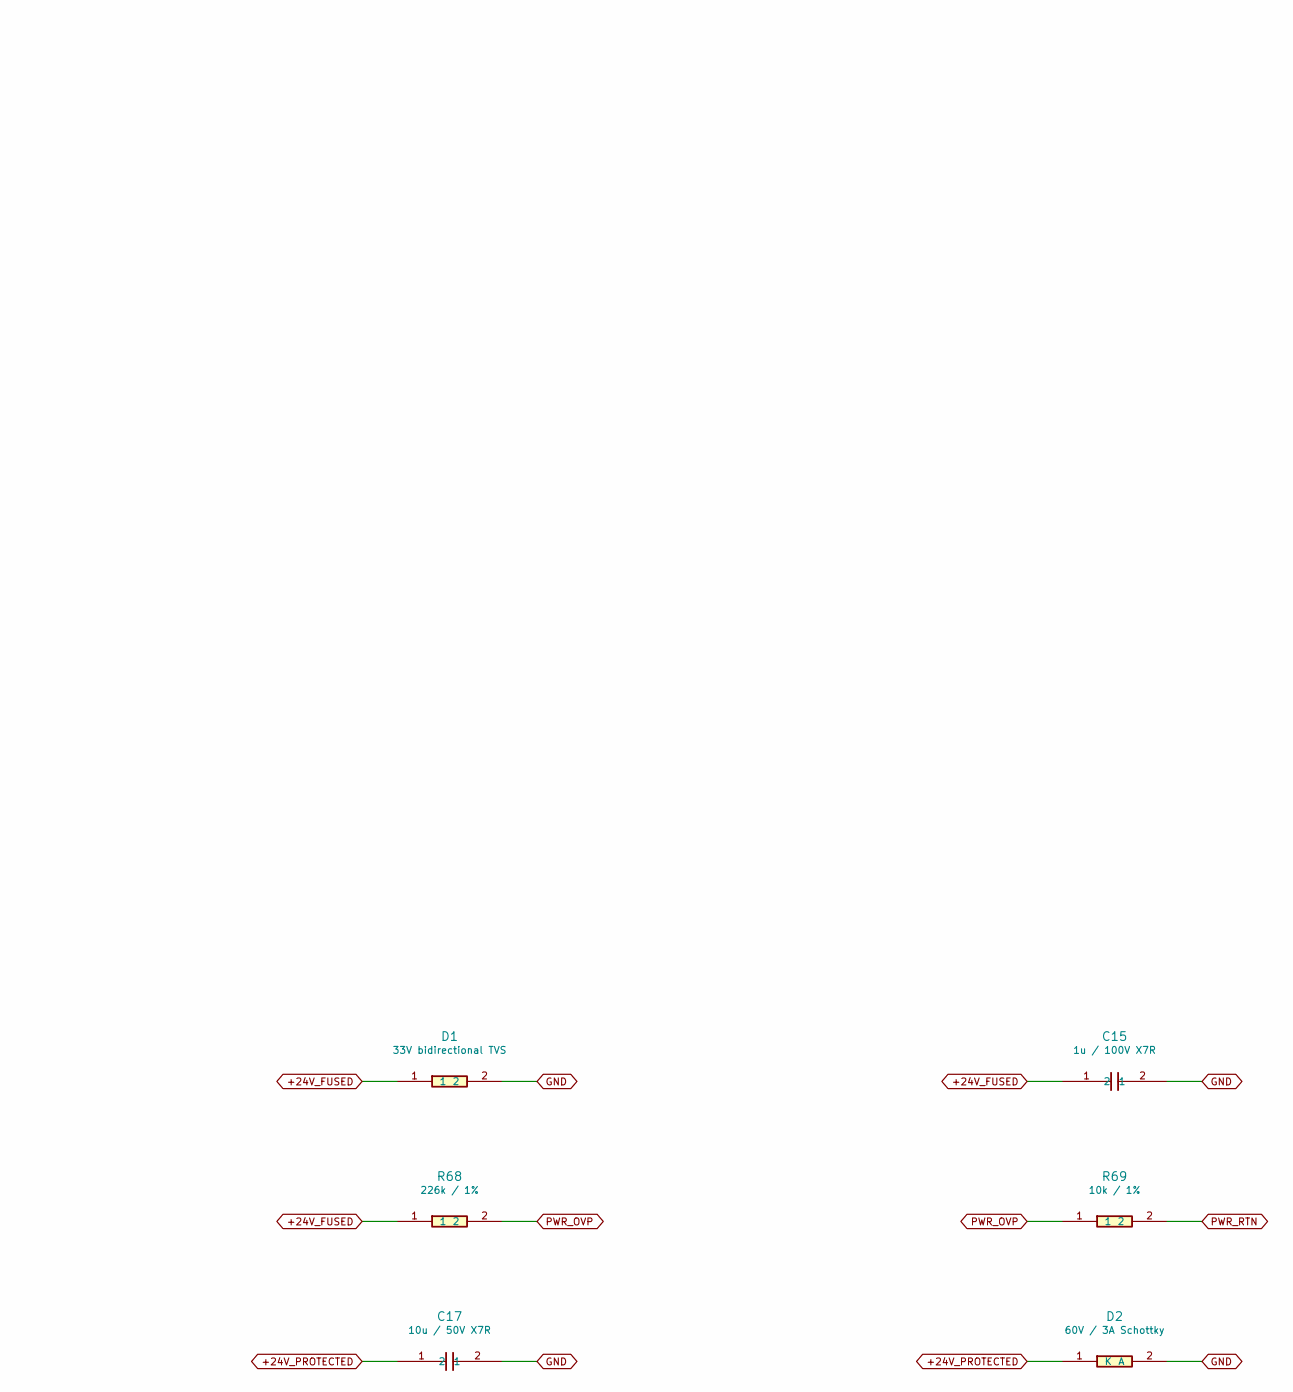
[picture p439: schematic power_input.kicad_sch, giga-adapter / power_input, part in row 1, column 2]

Parts:
C15: 1u / 100V X7R; C_1206_3216Metric; MPN C1206C105K1RACTU
C16: 47n / 50V X7R; C_0603_1608Metric; MPN C1608X7R1H473K080AA
C17: 10u / 50V X7R; C_1210_3225Metric; MPN MCJCU32MLB7106KPPDTJ
D1: 33V bidirectional TVS; D_SMB; MPN SMBJ33CA-13-F
D2: 60V / 3A Schottky; D_SMA; MPN B360A-13-F
F1: 2A / 65V time-lag; Fuse_Bourns_SF-1206SA-M; MPN SF-1206SA200M-2
J10: DC-005 / 24V centre+; BarrelJack_Horizontal_AISLER; MPN DC-005 / B07J4Z8B2T
R66: 143k / 1%; R_0603_1608Metric; MPN RC0603FR-07143KL
R67, R69: 10k / 1%; R_0603_1608Metric; MPN RC0603FR-0710KL
R68: 226k / 1%; R_0603_1608Metric; MPN RC0603FR-07226KL
R70: 8.06k / 1%; R_0603_1608Metric; MPN RC0603FR-078K06L
U7: TPS26600PWPT; HTSSOP-16_PWP0016A_EP3.3x3.3mm; MPN TPS26600PWPT

Connections:
+24V_FUSED: C15.1, D1.1, F1.2, R66.1, R68.1, U7.1 (IN), U7.2 (IN)
+24V_INPUT: F1.1, J10.1 (CENTRE / +24V)
+24V_PROTECTED: C17.1, D2.1 (K), U7.15 (OUT), U7.16 (OUT); also elsewhere on the board
GND: C15.2, C17.2, D1.2, D2.2 (A), J10.2 (SLEEVE / GND), J10.3 (SLEEVE SWITCH / GND), U7.9 (GND); also elsewhere on the board
PWR_DVDT: C16.1, U7.12 (dVdT)
PWR_ILIM: R70.1, U7.11 (ILIM)
PWR_OVP: R68.2, R69.1, U7.5 (OVP)
PWR_RTN: C16.2, R67.2, R69.2, R70.2, U7.6 (MODE), U7.8 (RTN), U7.17 (EP / RTN)
PWR_UVLO: R66.2, R67.1, U7.3 (UVLO)

Notes on the sheet:
J10: 5.5/2.1mm DC-005, centre +24V; sleeve and switch GND. UVLO ~18.2V; OVP ~28.1V; limit ~1.49A. RTN is NOT GND.

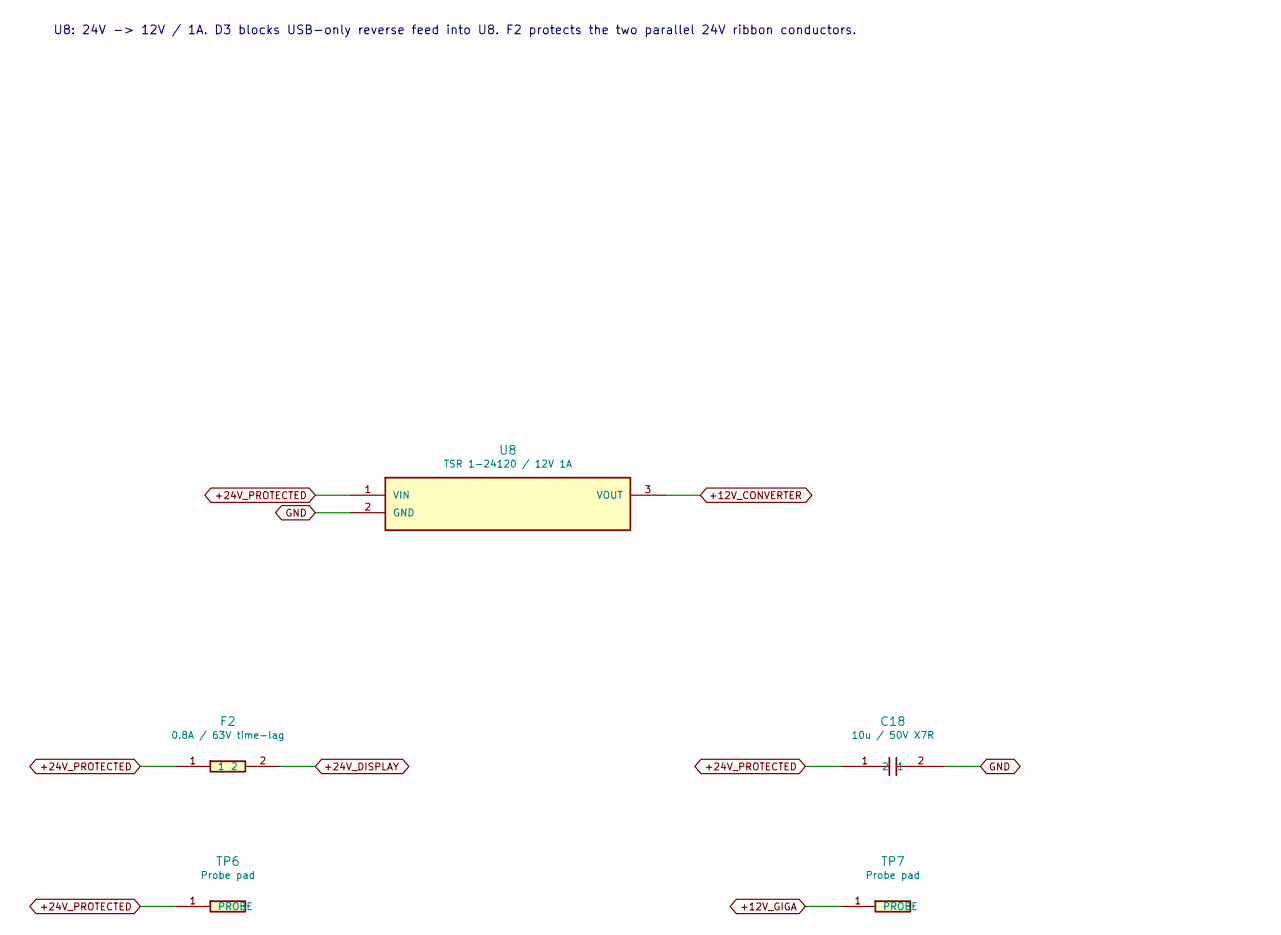
[picture p440: schematic power12.kicad_sch, giga-adapter / power12, part in row 1, column 1]

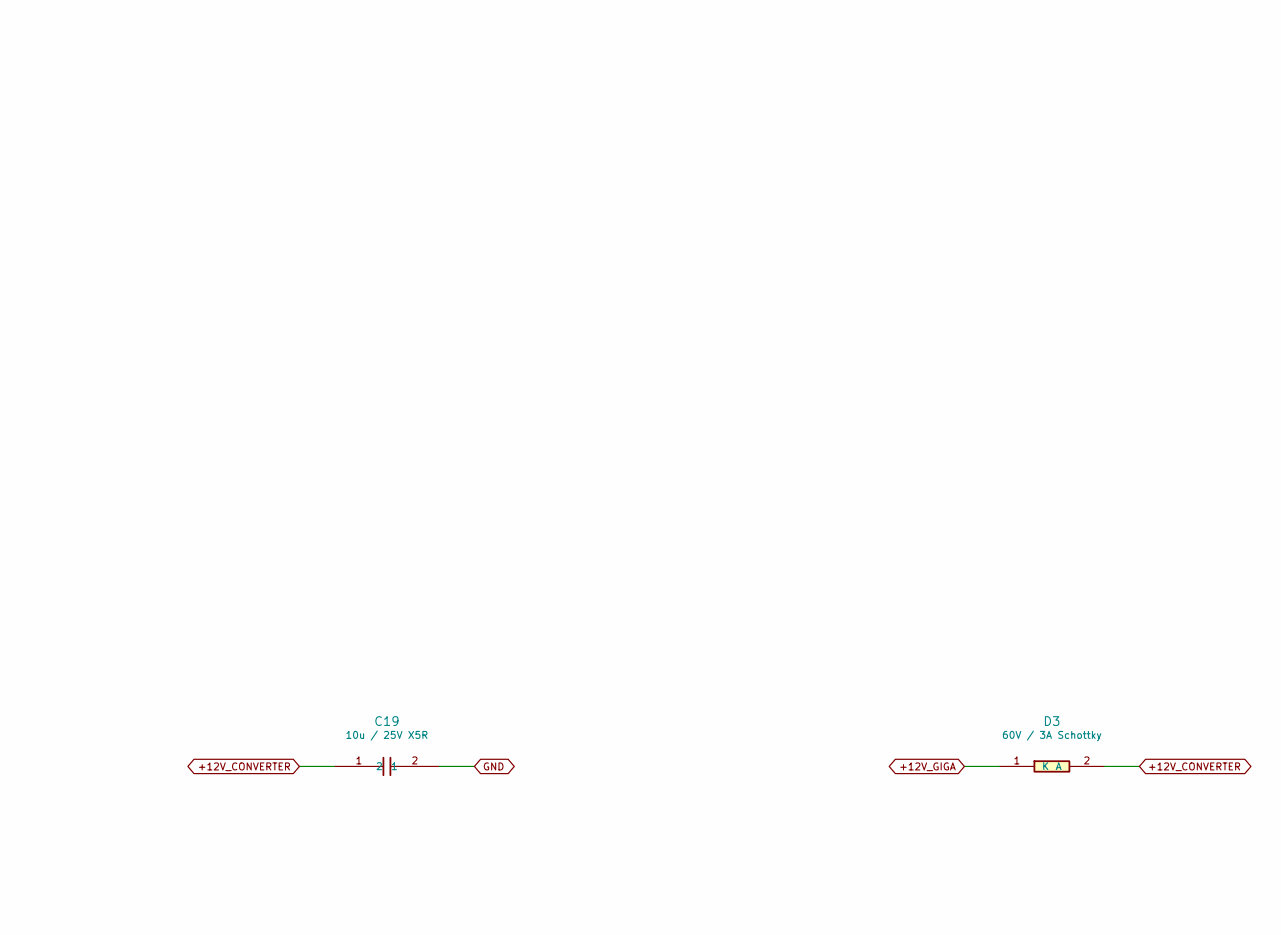
[picture p441: schematic power12.kicad_sch, giga-adapter / power12, part in row 1, column 2]

Parts:
C18: 10u / 50V X7R; C_1210_3225Metric; MPN MCJCU32MLB7106KPPDTJ
C19: 10u / 25V X5R; C_0805_2012Metric; MPN 08053D106KAT2A
D3: 60V / 3A Schottky; D_SMA; MPN B360A-13-F
F2: 0.8A / 63V time-lag; Fuse_1206_3216Metric; MPN SF-1206S080-2
TP6, TP7: Probe pad; TestPoint_1.0mm; MPN PCB copper feature
U8: TSR 1-24120 / 12V 1A; Converter_DCDC_TRACO_TSR-1_THT; MPN TSR 1-24120

Connections:
+12V_CONVERTER: C19.1, D3.2 (A), U8.3 (VOUT)
+12V_GIGA: D3.1 (K), TP7.1; also elsewhere on the board
+24V_DISPLAY: F2.2; also elsewhere on the board
+24V_PROTECTED: C18.1, F2.1, TP6.1, U8.1 (VIN); also elsewhere on the board
GND: C18.2, C19.2, U8.2 (GND); also elsewhere on the board

Notes on the sheet:
U8: 24V -> 12V / 1A. D3 blocks USB-only reverse feed into U8. F2 protects the two parallel 24V ribbon conductors.

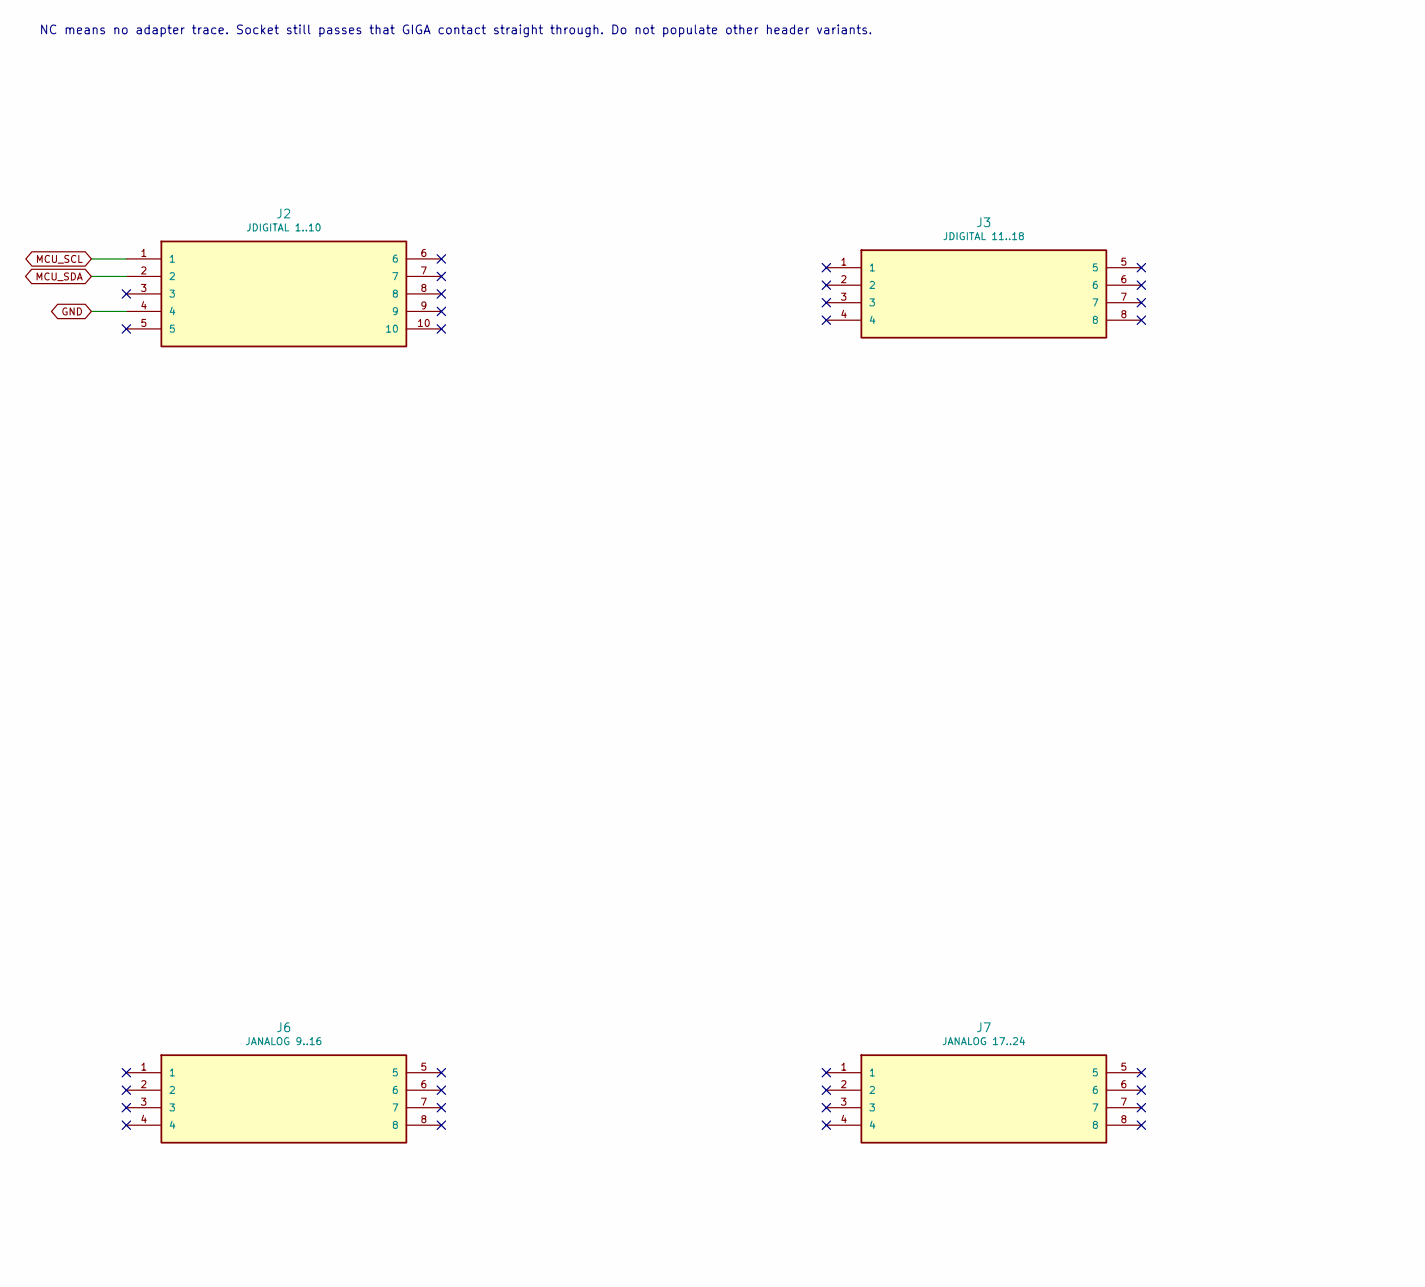
[picture p442: schematic headers.kicad_sch, giga-adapter / headers, part in row 1, column 1]

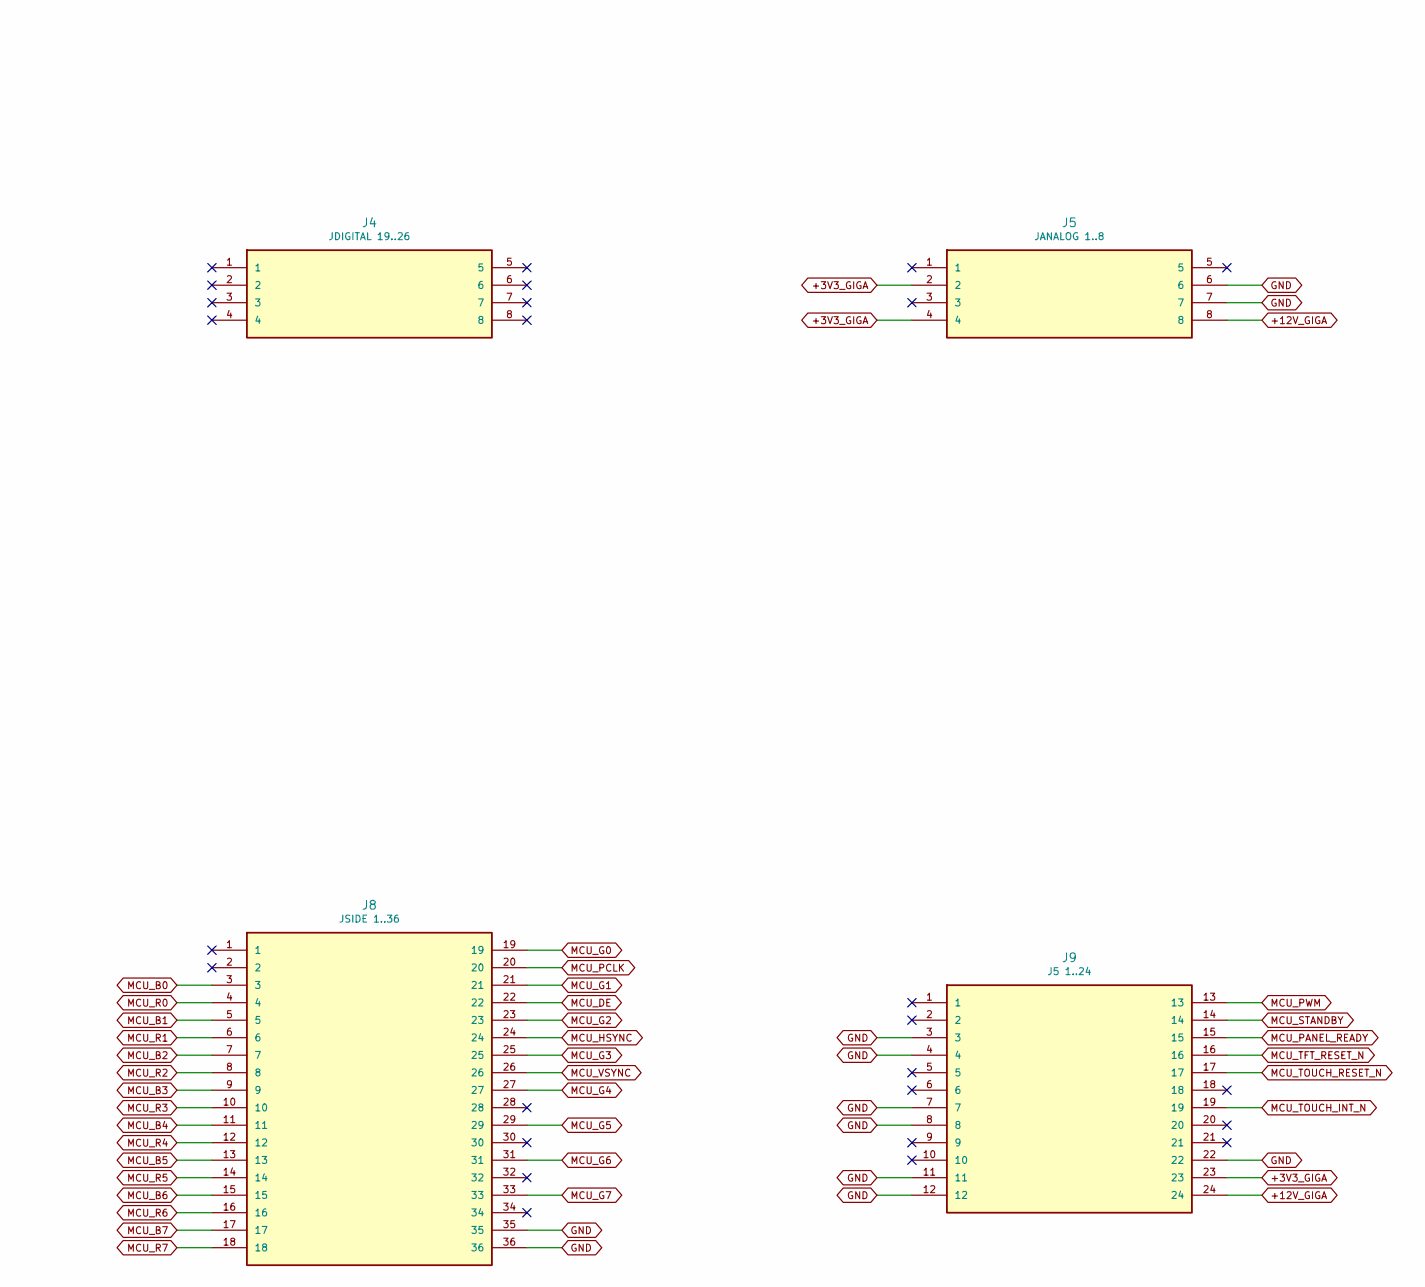
[picture p443: schematic headers.kicad_sch, giga-adapter / headers, part in row 1, column 2]

Parts:
J2: JDIGITAL 1..10; GIGA_J2_JDIGITAL; MPN SSQ-110-03-G-S
J3: JDIGITAL 11..18; GIGA_J3_JDIGITAL; MPN SSQ-108-03-G-S
J4: JDIGITAL 19..26; GIGA_J4_JDIGITAL; MPN SSQ-108-03-G-S
J5: JANALOG 1..8; GIGA_J5_JANALOG; MPN SSQ-108-03-G-S
J6: JANALOG 9..16; GIGA_J6_JANALOG; MPN SSQ-108-03-G-S
J7: JANALOG 17..24; GIGA_J7_JANALOG; MPN SSQ-108-03-G-S
J8: JSIDE 1..36; GIGA_J8_JSIDE; MPN SSQ-118-03-G-D
J9: J5 1..24; GIGA_J9_J5; MPN SSQ-112-04-G-D

Connections:
+3V3_GIGA: J5.2, J5.4, J9.23; also elsewhere on the board
+12V_GIGA: J5.8, J9.24; also elsewhere on the board
GND: J2.4, J5.6, J5.7, J8.35, J8.36, J9.3, J9.4, J9.7, J9.8, J9.11, J9.12, J9.22; also elsewhere on the board
MCU_B0: J8.3; also elsewhere on the board
MCU_B1: J8.5; also elsewhere on the board
MCU_B2: J8.7; also elsewhere on the board
MCU_B3: J8.9; also elsewhere on the board
MCU_B4: J8.11; also elsewhere on the board
MCU_B5: J8.13; also elsewhere on the board
MCU_B6: J8.15; also elsewhere on the board
MCU_B7: J8.17; also elsewhere on the board
MCU_DE: J8.22; also elsewhere on the board
MCU_G0: J8.19; also elsewhere on the board
MCU_G1: J8.21; also elsewhere on the board
MCU_G2: J8.23; also elsewhere on the board
MCU_G3: J8.25; also elsewhere on the board
MCU_G4: J8.27; also elsewhere on the board
MCU_G5: J8.29; also elsewhere on the board
MCU_G6: J8.31; also elsewhere on the board
MCU_G7: J8.33; also elsewhere on the board
MCU_HSYNC: J8.24; also elsewhere on the board
MCU_PANEL_READY: J9.15; also elsewhere on the board
MCU_PCLK: J8.20; also elsewhere on the board
MCU_PWM: J9.13; also elsewhere on the board
MCU_R0: J8.4; also elsewhere on the board
MCU_R1: J8.6; also elsewhere on the board
MCU_R2: J8.8; also elsewhere on the board
MCU_R3: J8.10; also elsewhere on the board
MCU_R4: J8.12; also elsewhere on the board
MCU_R5: J8.14; also elsewhere on the board
MCU_R6: J8.16; also elsewhere on the board
MCU_R7: J8.18; also elsewhere on the board
MCU_SCL: J2.1; also elsewhere on the board
MCU_SDA: J2.2; also elsewhere on the board
MCU_STANDBY: J9.14; also elsewhere on the board
MCU_TFT_RESET_N: J9.16; also elsewhere on the board
MCU_TOUCH_INT_N: J9.19; also elsewhere on the board
MCU_TOUCH_RESET_N: J9.17; also elsewhere on the board
MCU_VSYNC: J8.26; also elsewhere on the board

Notes on the sheet:
NC means no adapter trace. Socket still passes that GIGA contact straight through. Do not populate other header variants.

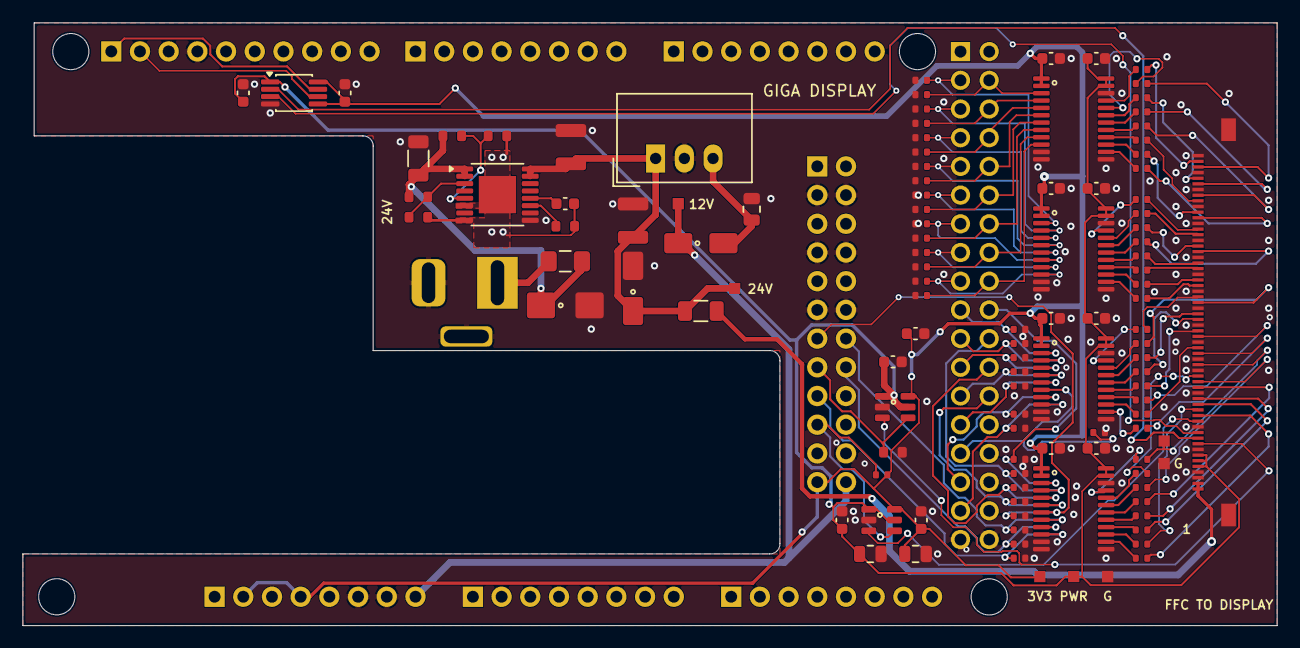
[picture p444: board giga-adapter.kicad_pcb from above]

Board: 4 copper layers, 111.0 x 53.3 mm, 127 parts (0 on the bottom side), 118 nets.

Other parts of the board:
H1, H2, H3, H4: MountingHole_3.2mm_M3
