daleondev/ProtoMate_Control/hardware/display/display-adapter/display-adapter.kicad_pcb

## KiCad design hardware/display/display-adapter/display-adapter.kicad_pcb (2026-10-23)

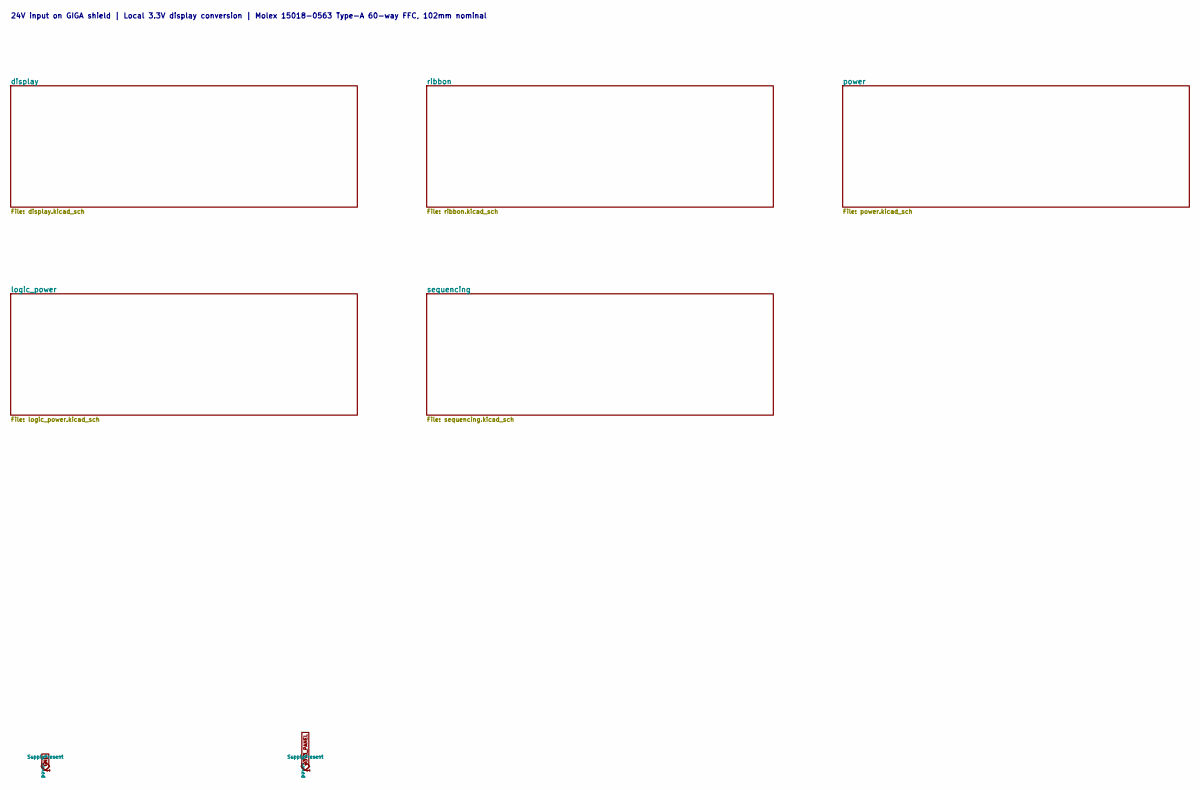
[picture p445: schematic display-adapter.kicad_sch, display-adapter / Smartwin display interface]

Notes on the sheet:
24V input on GIGA shield | Local 3.3V display conversion | Molex 15018-0563 Type-A 60-way FFC, 102mm nominal

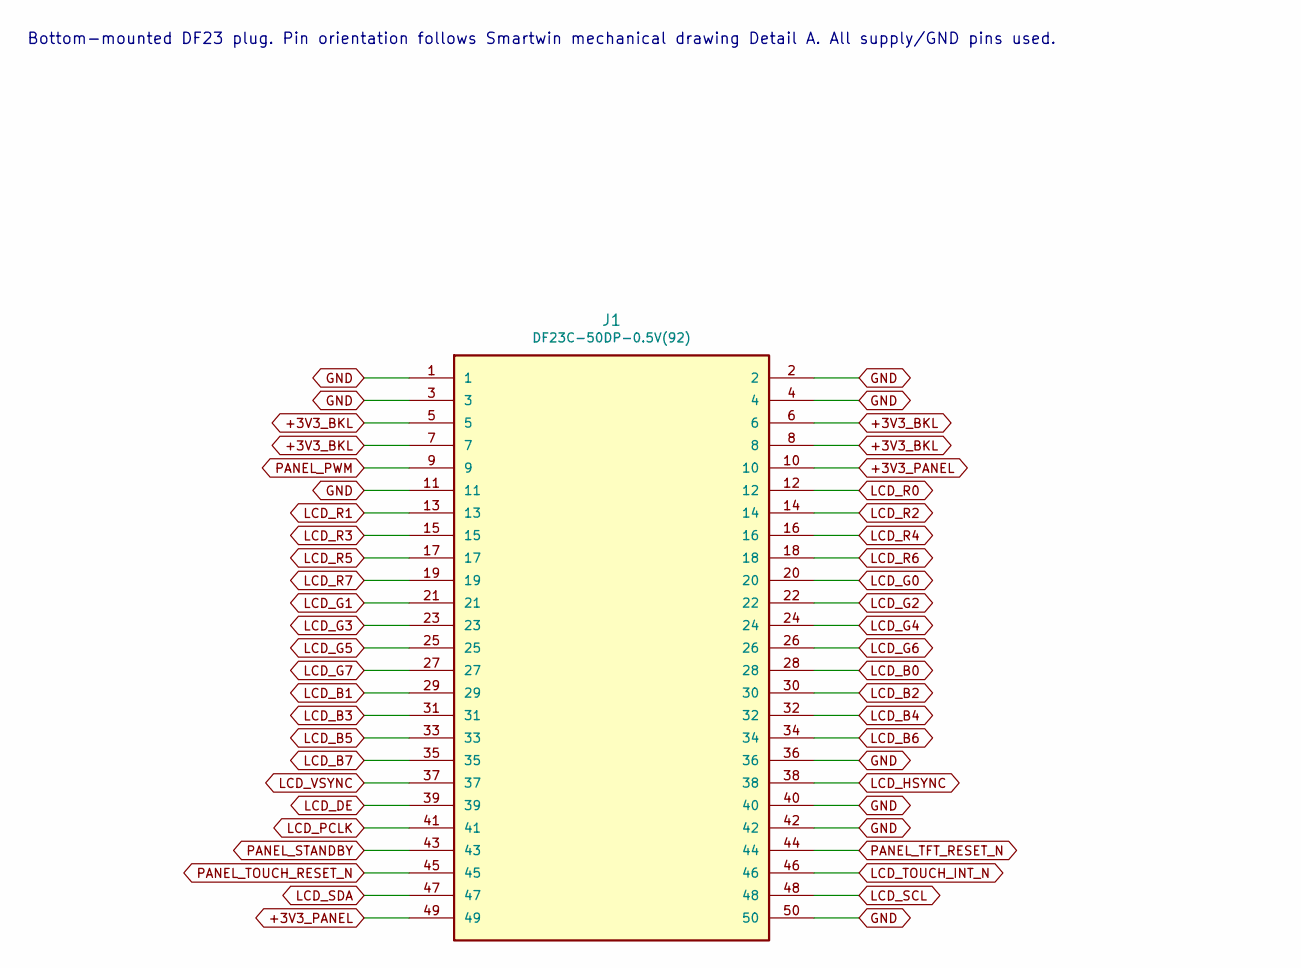
[picture p446: schematic display.kicad_sch, display-adapter / display]

Parts:
J1: DF23C-50DP-0.5V(92); DF23C-50DP-0.5V; MPN DF23C-50DP-0.5V(92)

Connections:
+3V3_BKL: J1.5, J1.6, J1.7, J1.8; also elsewhere on the board
+3V3_PANEL: J1.10, J1.49; also elsewhere on the board
GND: J1.1, J1.2, J1.3, J1.4, J1.11, J1.36, J1.40, J1.42, J1.50; also elsewhere on the board
LCD_B0: J1.28; also elsewhere on the board
LCD_B1: J1.29; also elsewhere on the board
LCD_B2: J1.30; also elsewhere on the board
LCD_B3: J1.31; also elsewhere on the board
LCD_B4: J1.32; also elsewhere on the board
LCD_B5: J1.33; also elsewhere on the board
LCD_B6: J1.34; also elsewhere on the board
LCD_B7: J1.35; also elsewhere on the board
LCD_DE: J1.39; also elsewhere on the board
LCD_G0: J1.20; also elsewhere on the board
LCD_G1: J1.21; also elsewhere on the board
LCD_G2: J1.22; also elsewhere on the board
LCD_G3: J1.23; also elsewhere on the board
LCD_G4: J1.24; also elsewhere on the board
LCD_G5: J1.25; also elsewhere on the board
LCD_G6: J1.26; also elsewhere on the board
LCD_G7: J1.27; also elsewhere on the board
LCD_HSYNC: J1.38; also elsewhere on the board
LCD_PCLK: J1.41; also elsewhere on the board
LCD_R0: J1.12; also elsewhere on the board
LCD_R1: J1.13; also elsewhere on the board
LCD_R2: J1.14; also elsewhere on the board
LCD_R3: J1.15; also elsewhere on the board
LCD_R4: J1.16; also elsewhere on the board
LCD_R5: J1.17; also elsewhere on the board
LCD_R6: J1.18; also elsewhere on the board
LCD_R7: J1.19; also elsewhere on the board
LCD_SCL: J1.48; also elsewhere on the board
LCD_SDA: J1.47; also elsewhere on the board
LCD_TOUCH_INT_N: J1.46; also elsewhere on the board
LCD_VSYNC: J1.37; also elsewhere on the board
PANEL_PWM: J1.9; also elsewhere on the board
PANEL_STANDBY: J1.43; also elsewhere on the board
PANEL_TFT_RESET_N: J1.44; also elsewhere on the board
PANEL_TOUCH_RESET_N: J1.45; also elsewhere on the board

Notes on the sheet:
Bottom-mounted DF23 plug. Pin orientation follows Smartwin mechanical drawing Detail A. All supply/GND pins used.
