daleondev/ProtoMate_Control/hardware/display/display-adapter/display-adapter.kicad_pcb

## KiCad design hardware/display/display-adapter/display-adapter.kicad_pcb (continued)

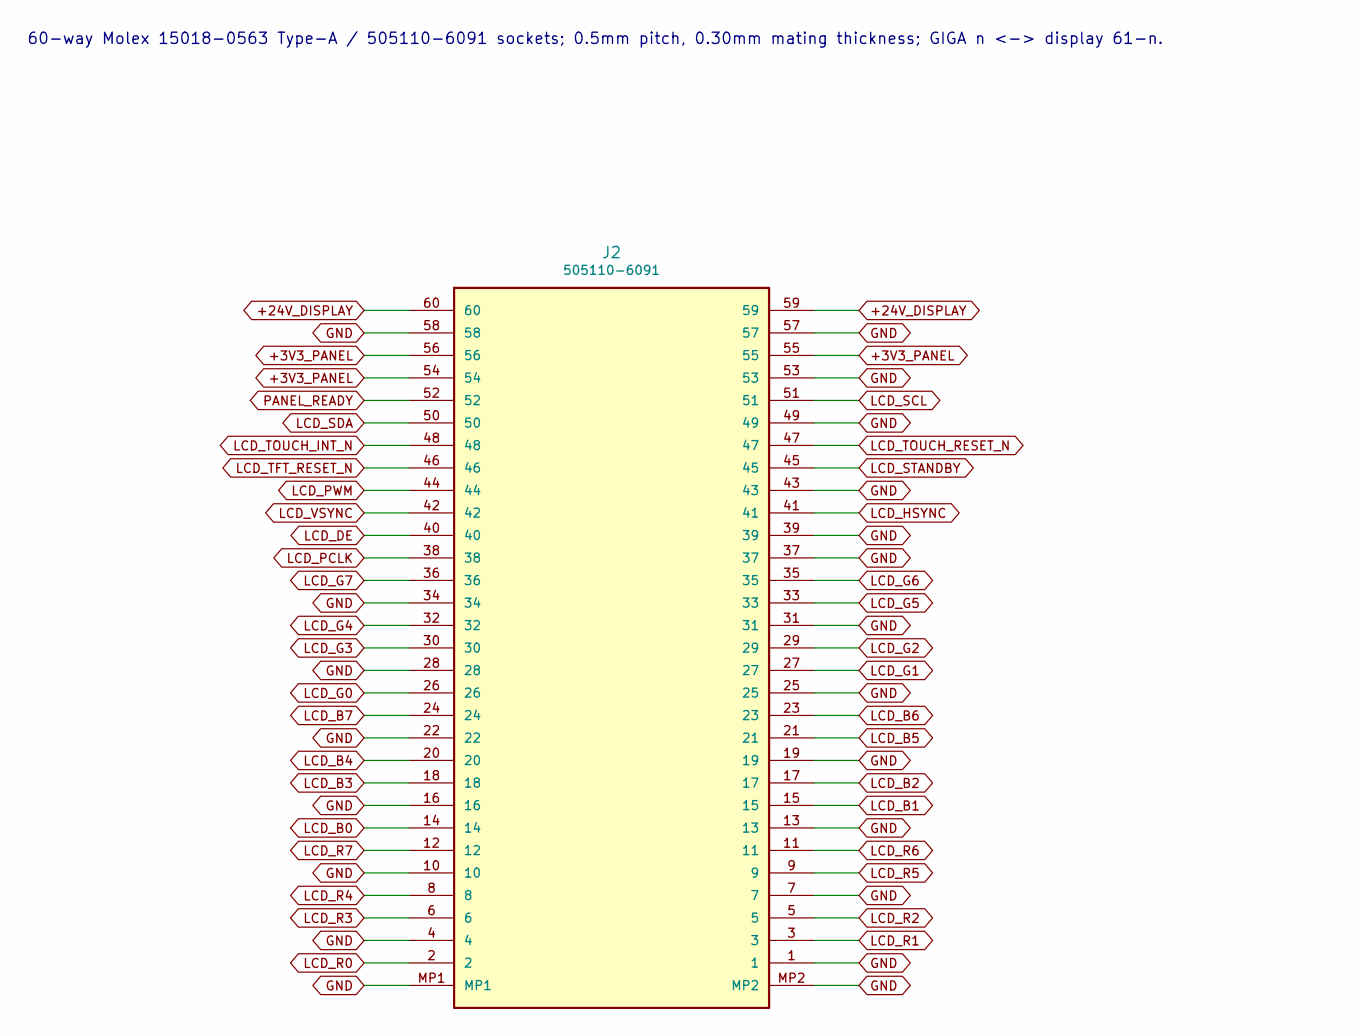
[picture p447: schematic ribbon.kicad_sch, display-adapter / ribbon]

Parts:
J2: 505110-6091; Molex_505110-6091_1x60_P0.50mm; MPN 505110-6091

Connections:
+3V3_PANEL: J2.54, J2.55, J2.56; also elsewhere on the board
+24V_DISPLAY: J2.59, J2.60; also elsewhere on the board
GND: J2.1, J2.4, J2.7, J2.10, J2.13, J2.16, J2.19, J2.22, J2.25, J2.28, J2.31, J2.34, J2.37, J2.39, J2.43, J2.49, J2.53, J2.57, J2.58, J2.MP1, J2.MP2; also elsewhere on the board
LCD_B0: J2.14; also elsewhere on the board
LCD_B1: J2.15; also elsewhere on the board
LCD_B2: J2.17; also elsewhere on the board
LCD_B3: J2.18; also elsewhere on the board
LCD_B4: J2.20; also elsewhere on the board
LCD_B5: J2.21; also elsewhere on the board
LCD_B6: J2.23; also elsewhere on the board
LCD_B7: J2.24; also elsewhere on the board
LCD_DE: J2.40; also elsewhere on the board
LCD_G0: J2.26; also elsewhere on the board
LCD_G1: J2.27; also elsewhere on the board
LCD_G2: J2.29; also elsewhere on the board
LCD_G3: J2.30; also elsewhere on the board
LCD_G4: J2.32; also elsewhere on the board
LCD_G5: J2.33; also elsewhere on the board
LCD_G6: J2.35; also elsewhere on the board
LCD_G7: J2.36; also elsewhere on the board
LCD_HSYNC: J2.41; also elsewhere on the board
LCD_PCLK: J2.38; also elsewhere on the board
LCD_PWM: J2.44; also elsewhere on the board
LCD_R0: J2.2; also elsewhere on the board
LCD_R1: J2.3; also elsewhere on the board
LCD_R2: J2.5; also elsewhere on the board
LCD_R3: J2.6; also elsewhere on the board
LCD_R4: J2.8; also elsewhere on the board
LCD_R5: J2.9; also elsewhere on the board
LCD_R6: J2.11; also elsewhere on the board
LCD_R7: J2.12; also elsewhere on the board
LCD_SCL: J2.51; also elsewhere on the board
LCD_SDA: J2.50; also elsewhere on the board
LCD_STANDBY: J2.45; also elsewhere on the board
LCD_TFT_RESET_N: J2.46; also elsewhere on the board
LCD_TOUCH_INT_N: J2.48; also elsewhere on the board
LCD_TOUCH_RESET_N: J2.47; also elsewhere on the board
LCD_VSYNC: J2.42; also elsewhere on the board
PANEL_READY: J2.52; also elsewhere on the board

Notes on the sheet:
60-way Molex 15018-0563 Type-A / 505110-6091 sockets; 0.5mm pitch, 0.30mm mating thickness; GIGA n <-> display 61-n.

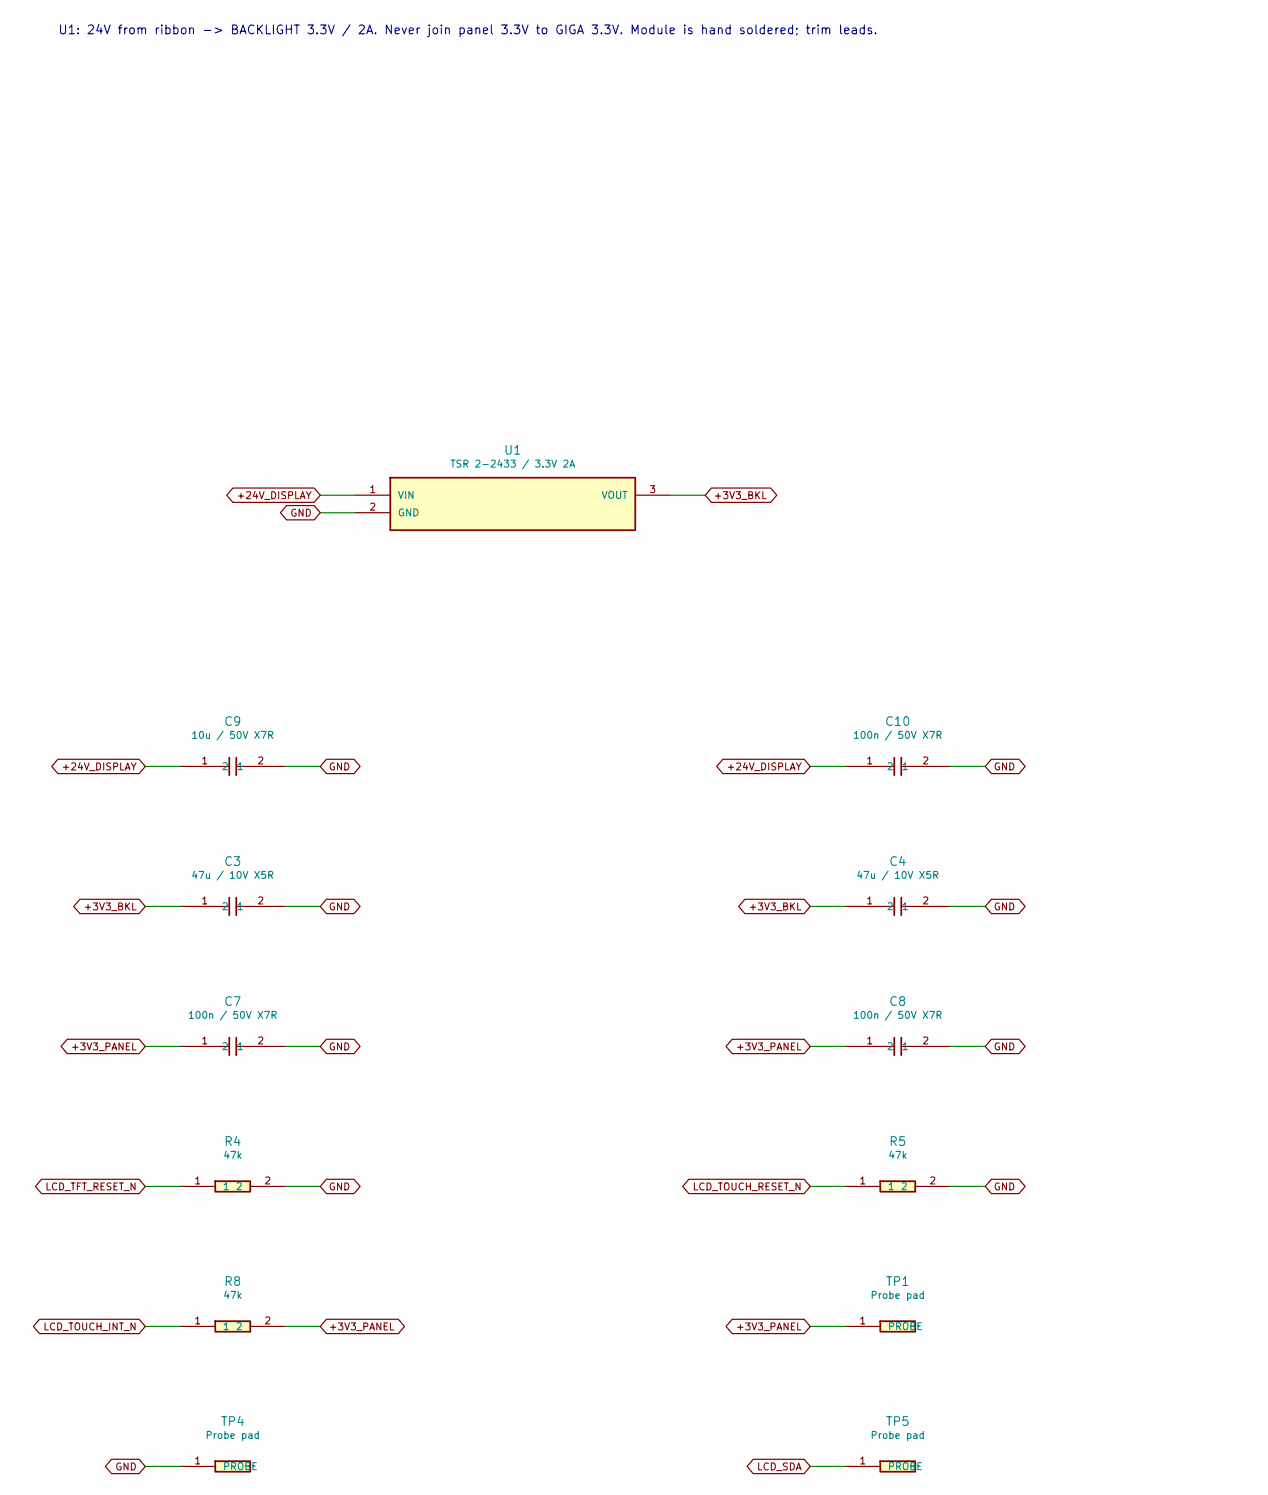
[picture p448: schematic power.kicad_sch, display-adapter / power, part in row 1, column 1]

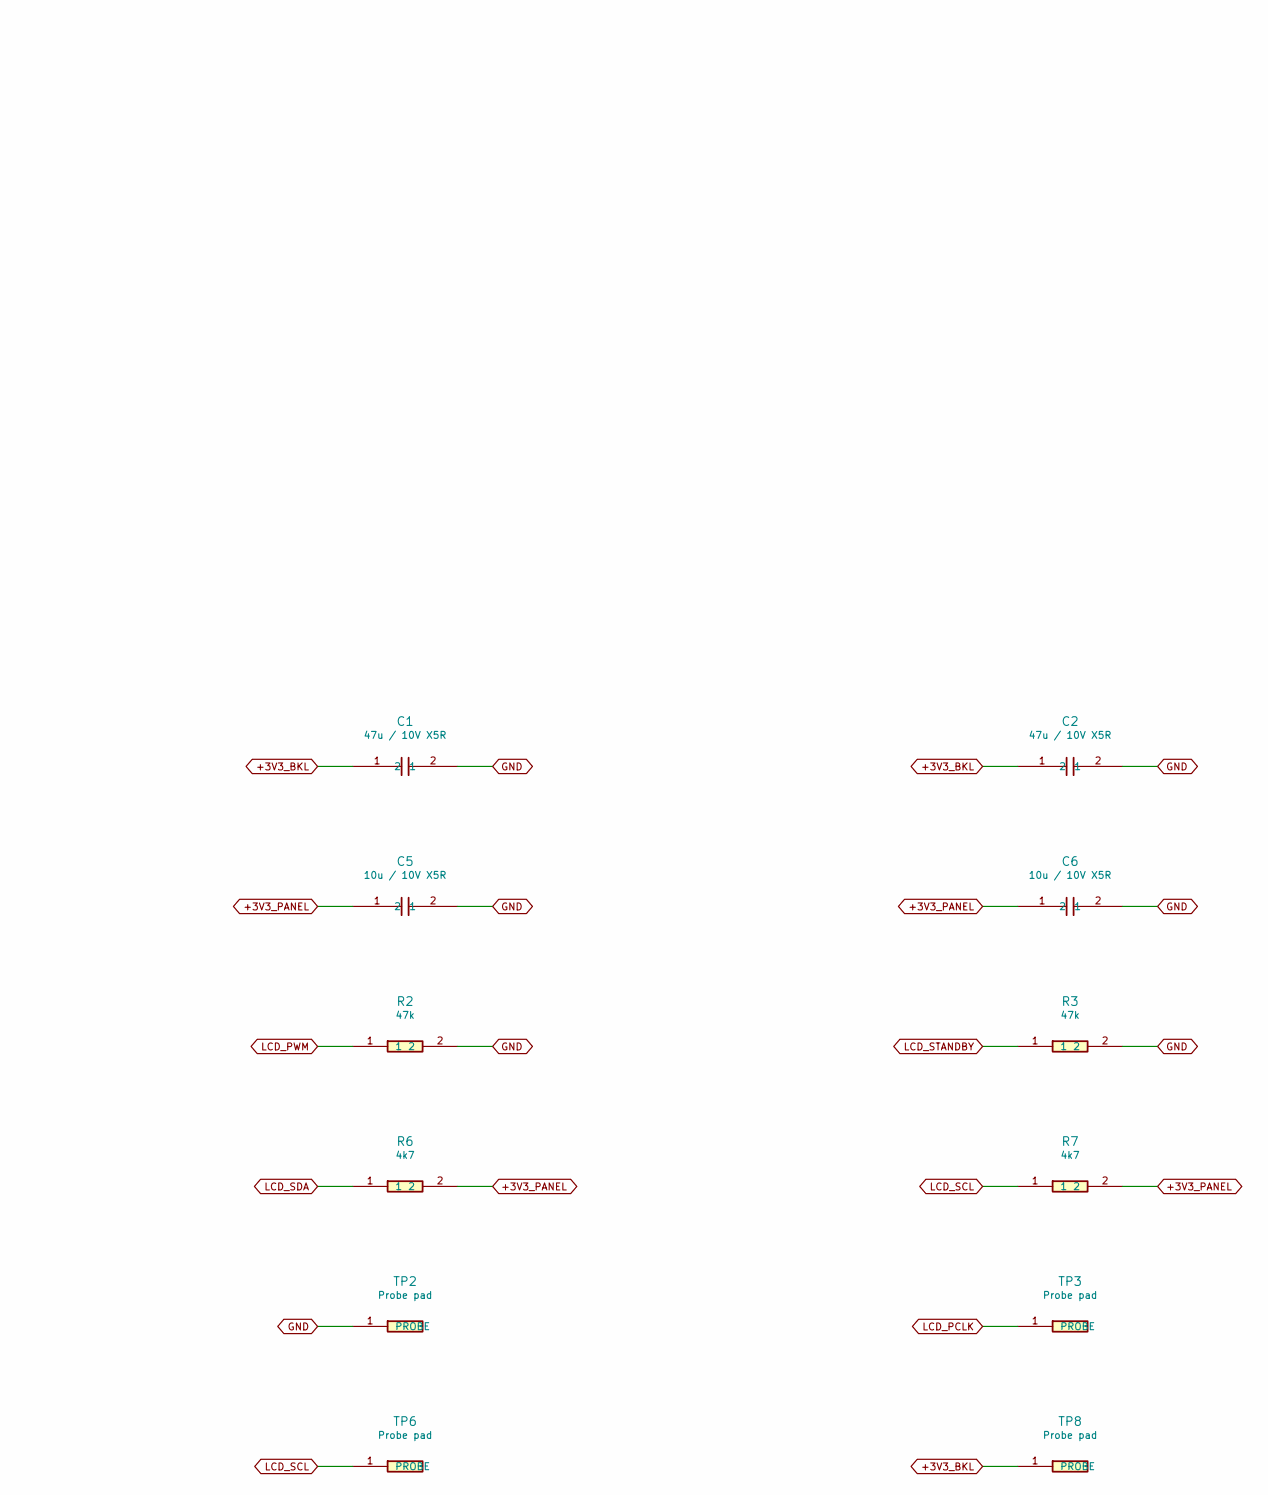
[picture p449: schematic power.kicad_sch, display-adapter / power, part in row 1, column 2]

Parts:
C1, C2, C3, C4: 47u / 10V X5R; C_1210_3225Metric; MPN MBASL32MSB5476KPNA01
C5, C6: 10u / 10V X5R; C_0805_2012Metric; MPN C0805C106K8PACTU
C7, C8, C10: 100n / 50V X7R; C_0603_1608Metric; MPN C0603C104K5RACTU
C9: 10u / 50V X7R; C_1210_3225Metric; MPN MCJCU32MLB7106KPPDTJ
R2, R3, R4, R5, R8: 47k; R_0402_1005Metric; MPN RC0402FR-0747KL
R6, R7: 4k7; R_0402_1005Metric; MPN RC0402FR-074K7L
TP1, TP2, TP3, TP4, TP5, TP6, TP8: Probe pad; TestPoint_1.0mm; MPN PCB copper feature
U1: TSR 2-2433 / 3.3V 2A; Converter_DCDC_TRACO_TSR2-xxxx_THT; MPN TSR 2-2433

Connections:
+3V3_BKL: C1.1, C2.1, C3.1, C4.1, TP8.1, U1.3 (VOUT); also elsewhere on the board
+3V3_PANEL: C5.1, C6.1, C7.1, C8.1, R6.2, R7.2, R8.2, TP1.1; also elsewhere on the board
+24V_DISPLAY: C9.1, C10.1, U1.1 (VIN); also elsewhere on the board
GND: C1.2, C2.2, C3.2, C4.2, C5.2, C6.2, C7.2, C8.2, C9.2, C10.2, R2.2, R3.2, R4.2, R5.2, TP2.1, TP4.1, U1.2 (GND); also elsewhere on the board
LCD_PCLK: TP3.1; also elsewhere on the board
LCD_PWM: R2.1; also elsewhere on the board
LCD_SCL: R7.1, TP6.1; also elsewhere on the board
LCD_SDA: R6.1, TP5.1; also elsewhere on the board
LCD_STANDBY: R3.1; also elsewhere on the board
LCD_TFT_RESET_N: R4.1; also elsewhere on the board
LCD_TOUCH_INT_N: R8.1; also elsewhere on the board
LCD_TOUCH_RESET_N: R5.1; also elsewhere on the board

Notes on the sheet:
U1: 24V from ribbon -> BACKLIGHT 3.3V / 2A. Never join panel 3.3V to GIGA 3.3V. Module is hand soldered; trim leads.

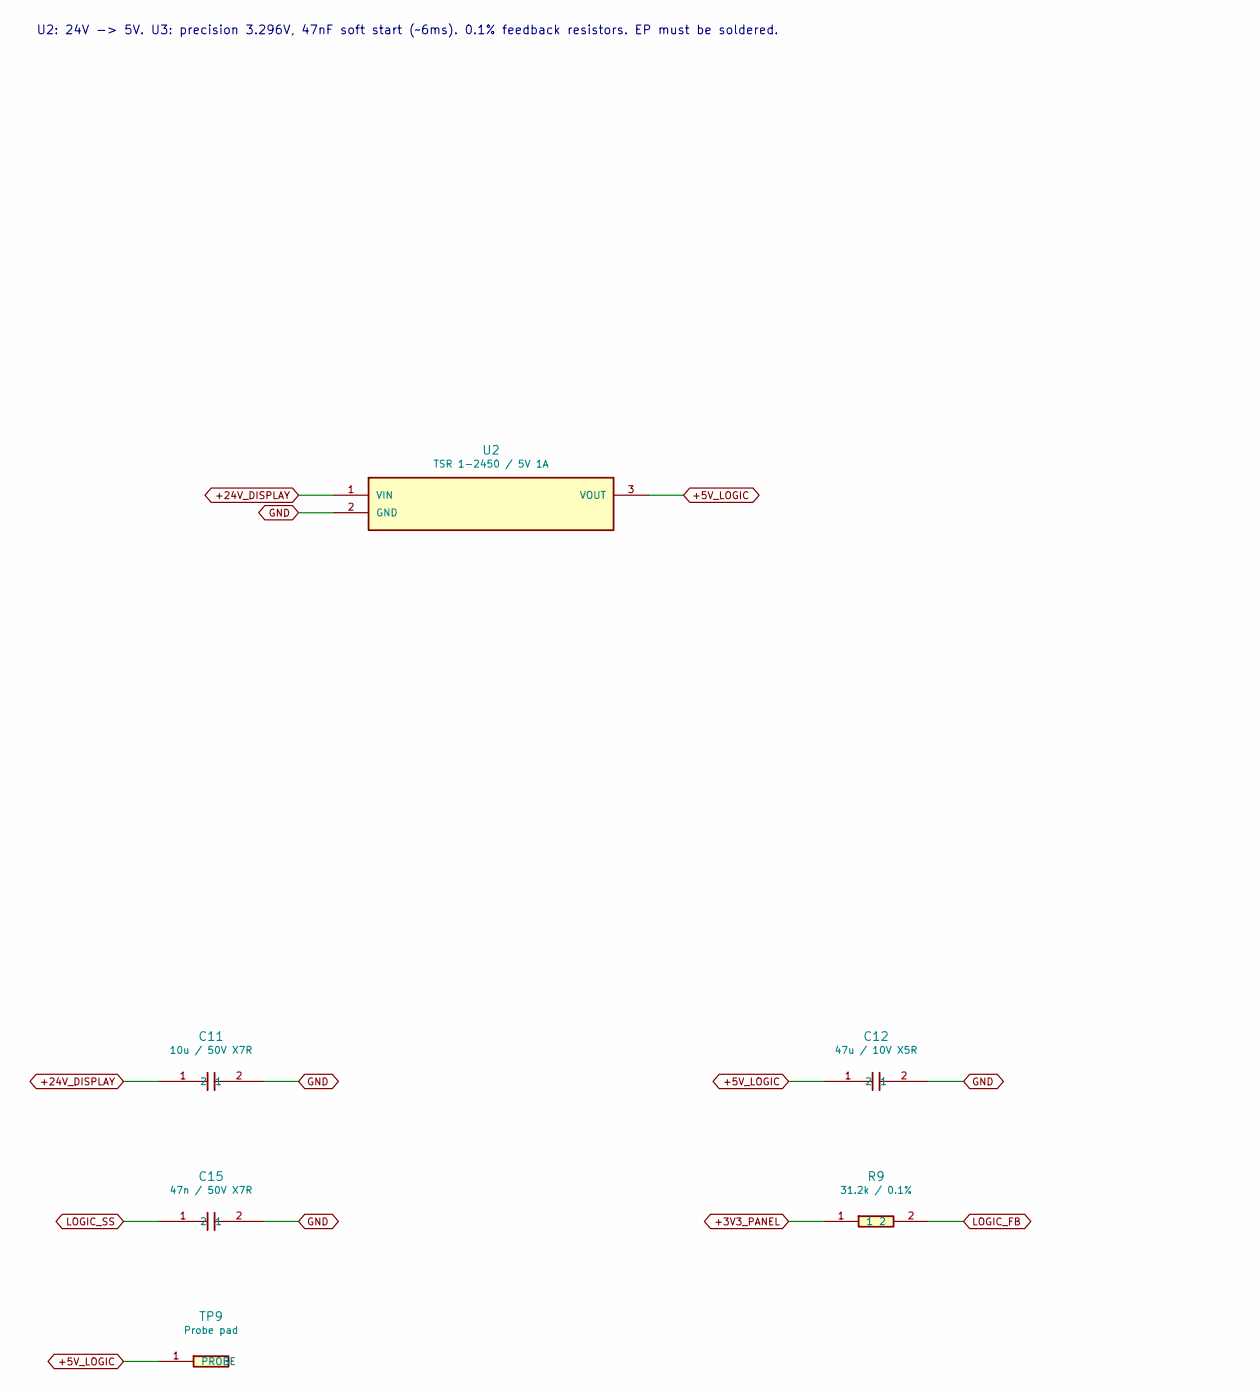
[picture p450: schematic logic_power.kicad_sch, display-adapter / logic_power, part in row 1, column 1]

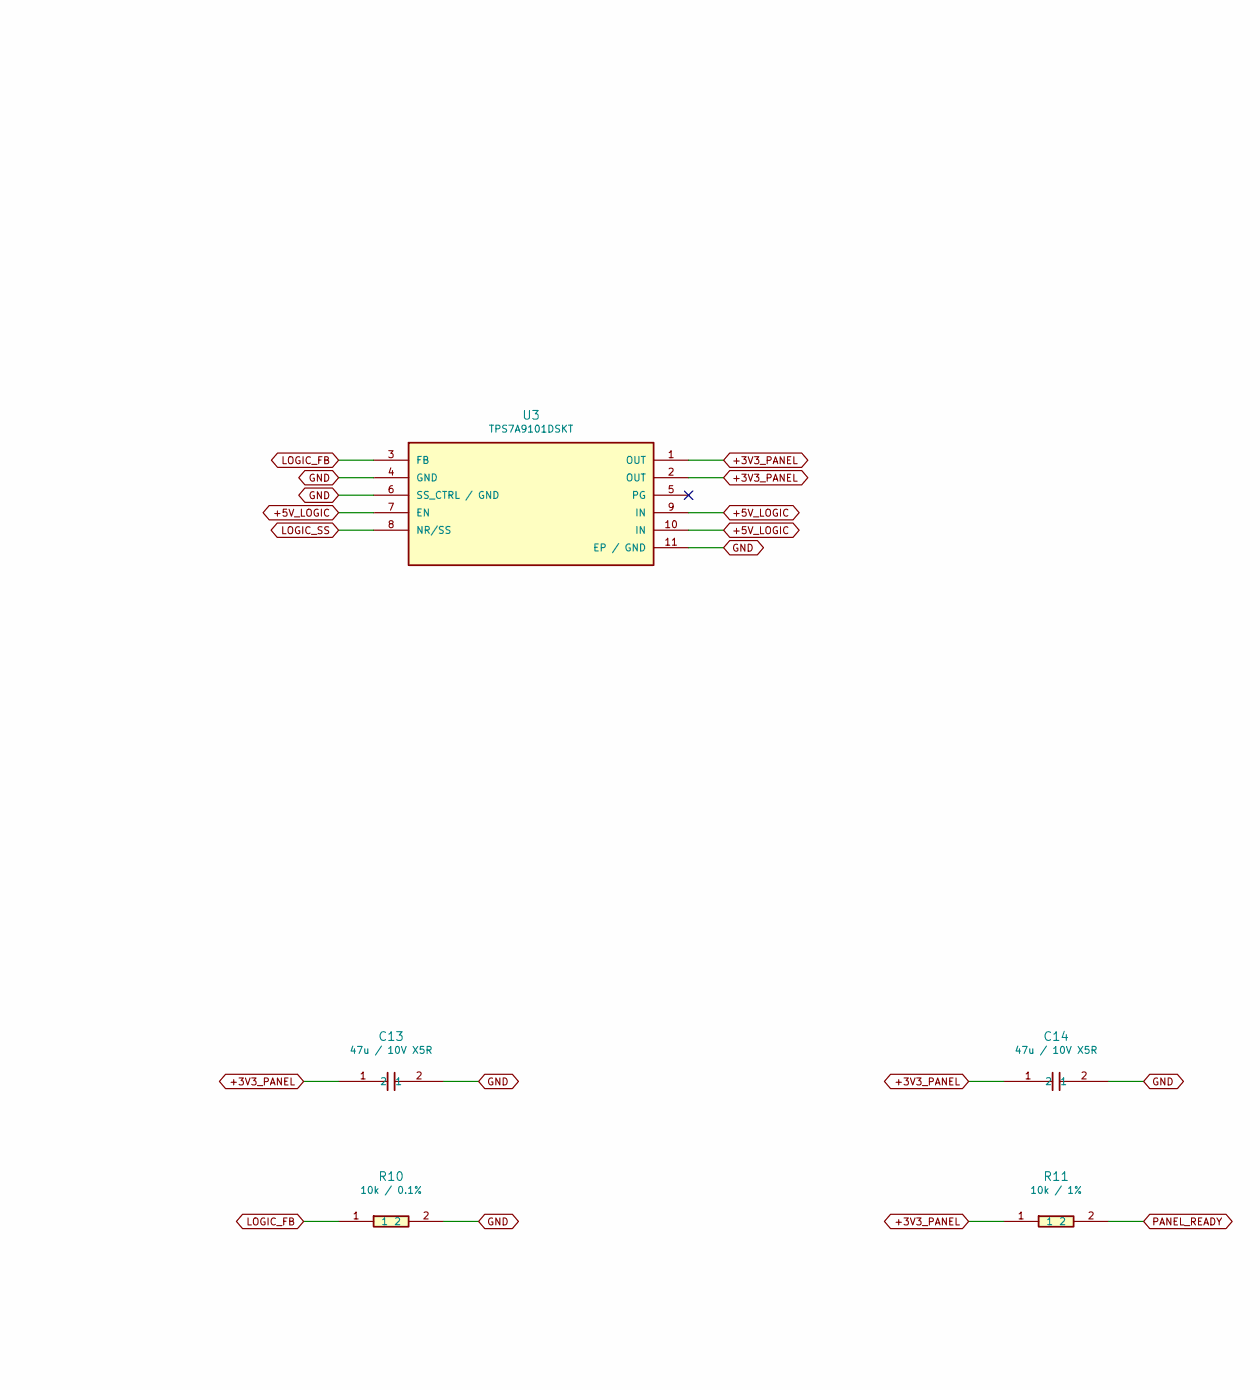
[picture p451: schematic logic_power.kicad_sch, display-adapter / logic_power, part in row 1, column 2]

Parts:
C11: 10u / 50V X7R; C_1210_3225Metric; MPN MCJCU32MLB7106KPPDTJ
C12, C13, C14: 47u / 10V X5R; C_1210_3225Metric; MPN MBASL32MSB5476KPNA01
C15: 47n / 50V X7R; C_0603_1608Metric; MPN C1608X7R1H473K080AA
R9: 31.2k / 0.1%; R_0603_1608Metric; MPN TNPW060331K2BEEN
R10: 10k / 0.1%; R_0603_1608Metric; MPN RT0603BRD0710KL
R11: 10k / 1%; R_0603_1608Metric; MPN RC0603FR-0710KL
TP9: Probe pad; TestPoint_1.0mm; MPN PCB copper feature
U2: TSR 1-2450 / 5V 1A; Converter_DCDC_TRACO_TSR-1_THT_Trimmed; MPN TSR 1-2450
U3: TPS7A9101DSKT; WSON-10-1EP_2.5x2.5mm_P0.5mm_EP1.2x2mm; MPN TPS7A9101DSKT

Connections:
+3V3_PANEL: C13.1, C14.1, R9.1, R11.1, U3.1 (OUT), U3.2 (OUT); also elsewhere on the board
+5V_LOGIC: C12.1, TP9.1, U2.3 (VOUT), U3.7 (EN), U3.9 (IN), U3.10 (IN)
+24V_DISPLAY: C11.1, U2.1 (VIN); also elsewhere on the board
GND: C11.2, C12.2, C13.2, C14.2, C15.2, R10.2, U2.2 (GND), U3.4 (GND), U3.6 (SS_CTRL / GND), U3.11 (EP / GND); also elsewhere on the board
LOGIC_FB: R9.2, R10.1, U3.3 (FB)
LOGIC_SS: C15.1, U3.8 (NR/SS)
PANEL_READY: R11.2; also elsewhere on the board

Notes on the sheet:
U2: 24V -> 5V. U3: precision 3.296V, 47nF soft start (~6ms). 0.1% feedback resistors. EP must be soldered.

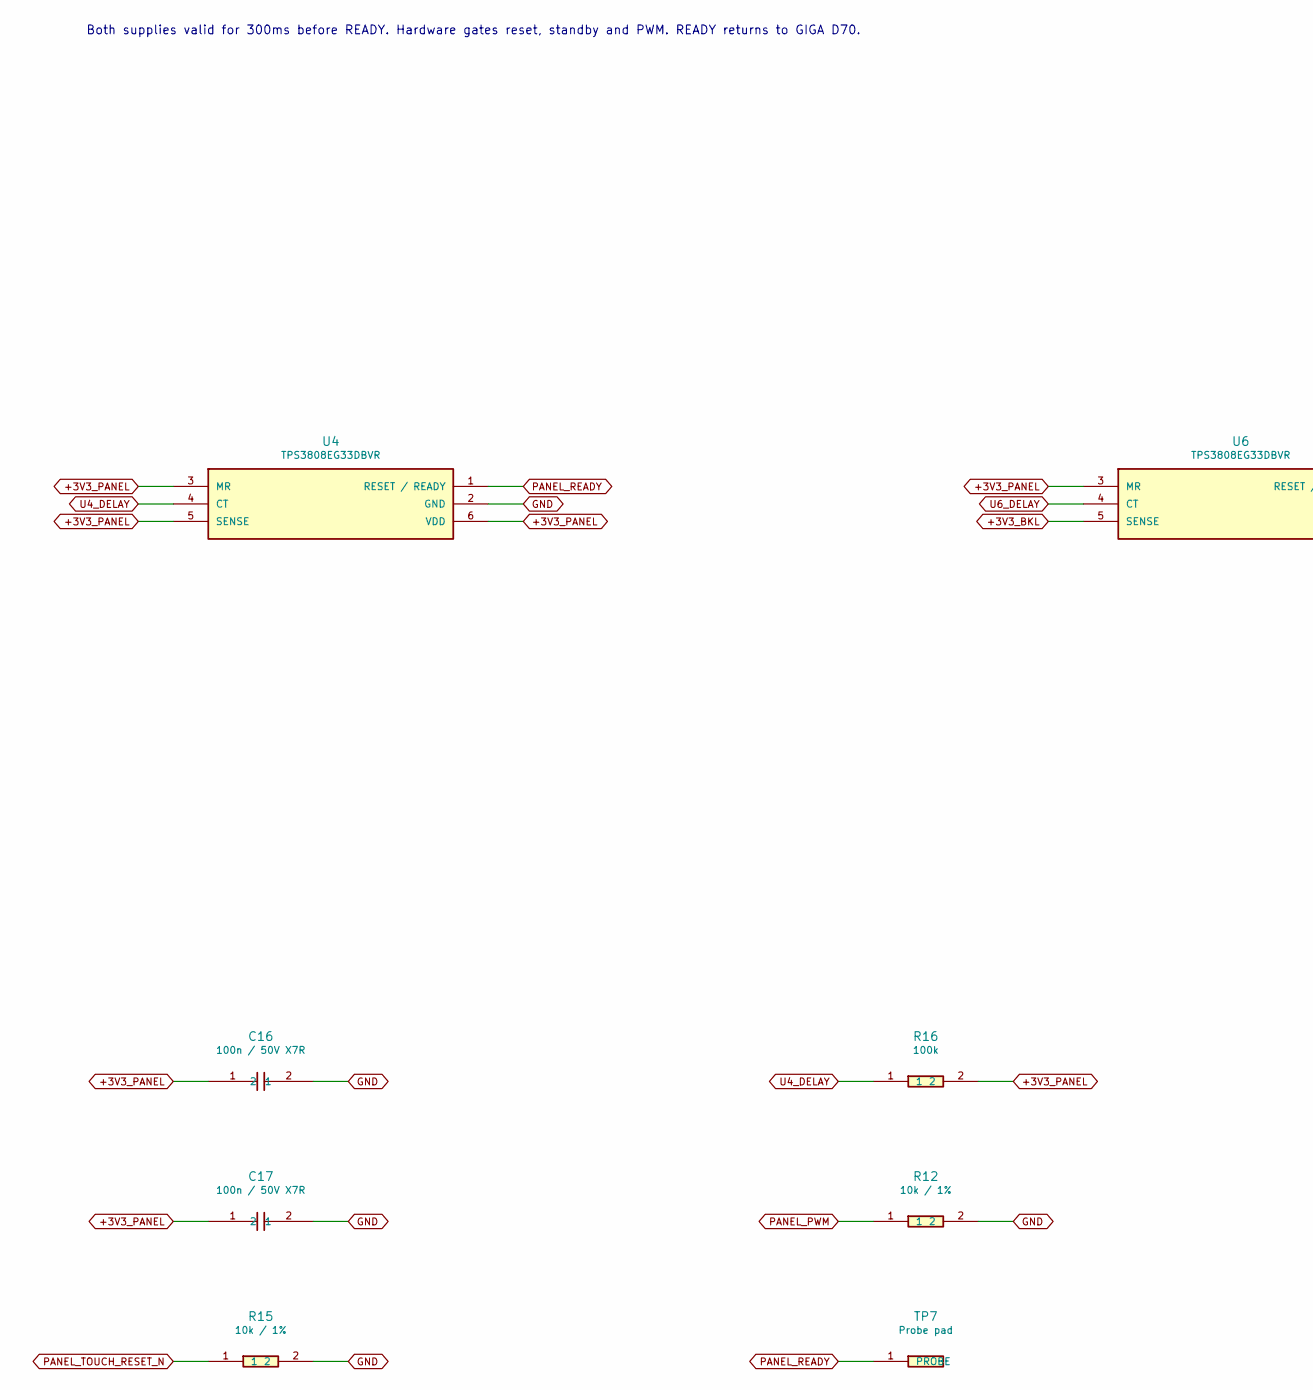
[picture p452: schematic sequencing.kicad_sch, display-adapter / sequencing, part in row 1, column 1]

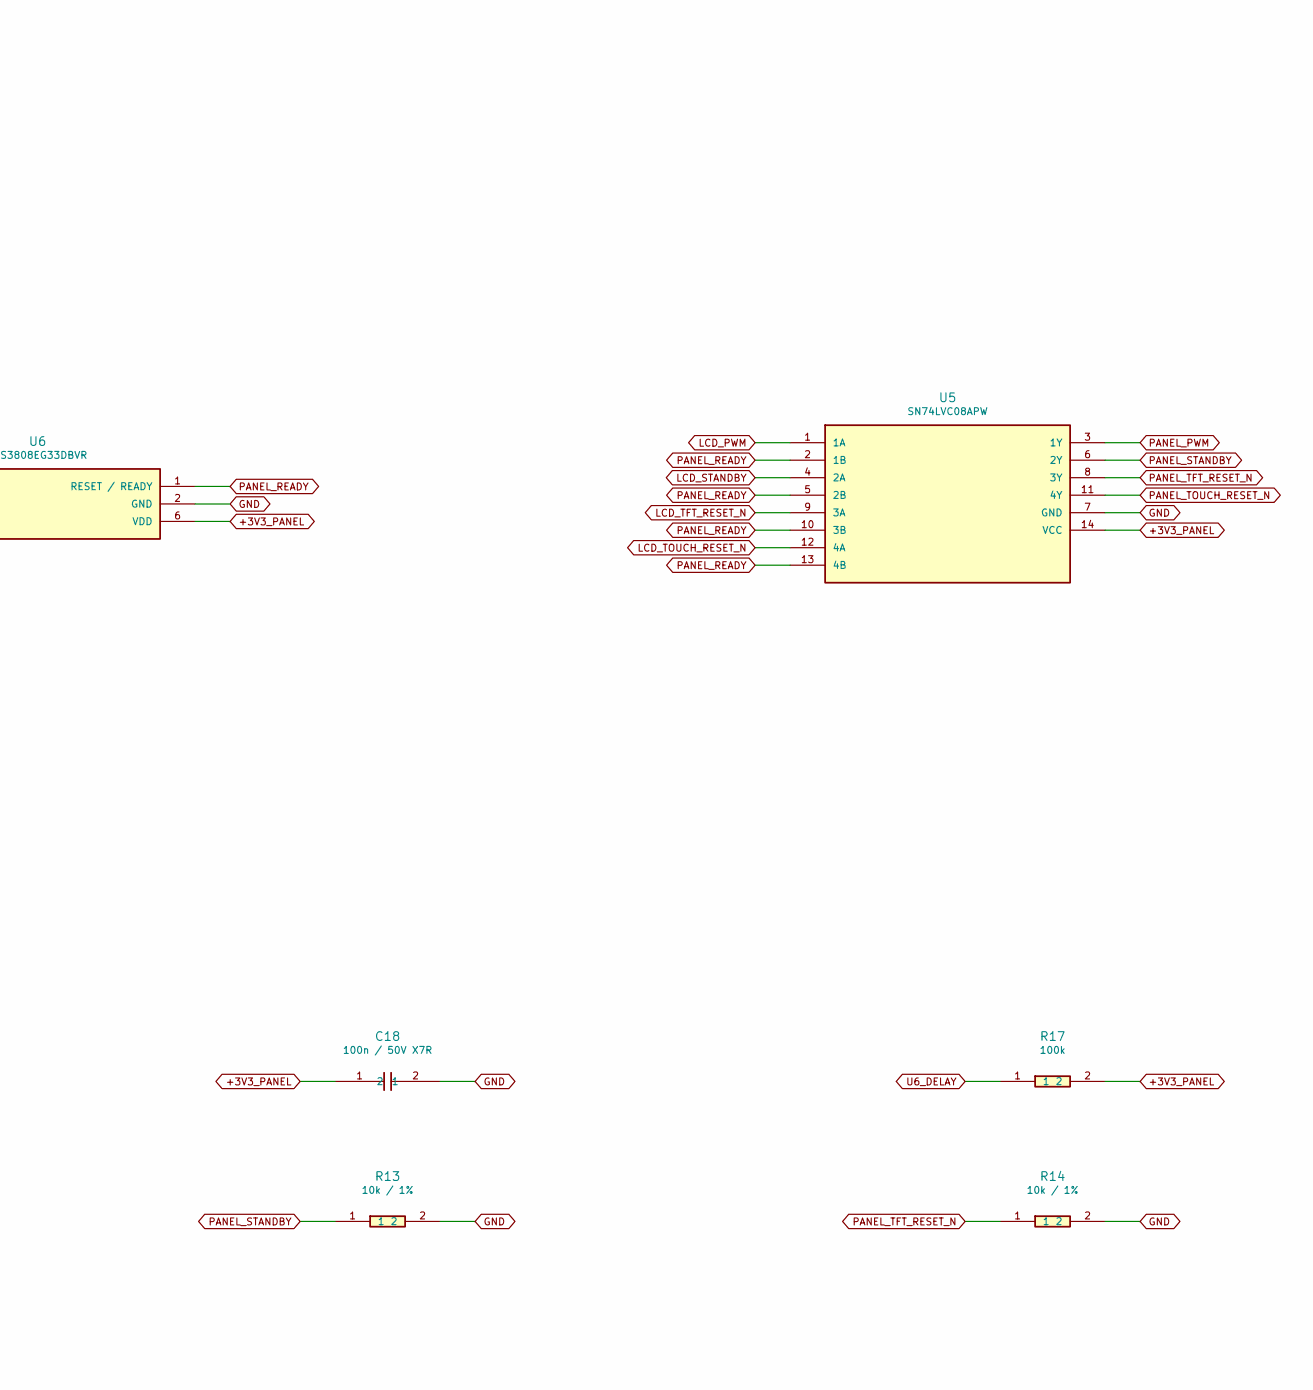
[picture p453: schematic sequencing.kicad_sch, display-adapter / sequencing, part in row 1, column 2]

Parts:
C16, C17, C18: 100n / 50V X7R; C_0603_1608Metric; MPN C0603C104K5RACTU
R12, R13, R14, R15: 10k / 1%; R_0603_1608Metric; MPN RC0603FR-0710KL
R16, R17: 100k; R_0402_1005Metric; MPN RC0402FR-07100KL
TP7: Probe pad; TestPoint_1.0mm; MPN PCB copper feature
U4, U6: TPS3808EG33DBVR; SOT-23-6_UpperPin1; MPN TPS3808EG33DBVR
U5: SN74LVC08APW; TSSOP-14_4.4x5mm_P0.65mm; MPN SN74LVC08APW

Connections:
+3V3_BKL: U6.5 (SENSE); also elsewhere on the board
+3V3_PANEL: C16.1, C17.1, C18.1, R16.2, R17.2, U4.3 (MR), U4.5 (SENSE), U4.6 (VDD), U5.14 (VCC), U6.3 (MR), U6.6 (VDD); also elsewhere on the board
GND: C16.2, C17.2, C18.2, R12.2, R13.2, R14.2, R15.2, U4.2 (GND), U5.7 (GND), U6.2 (GND); also elsewhere on the board
LCD_PWM: U5.1 (1A); also elsewhere on the board
LCD_STANDBY: U5.4 (2A); also elsewhere on the board
LCD_TFT_RESET_N: U5.9 (3A); also elsewhere on the board
LCD_TOUCH_RESET_N: U5.12 (4A); also elsewhere on the board
PANEL_PWM: R12.1, U5.3 (1Y); also elsewhere on the board
PANEL_READY: TP7.1, U4.1 (RESET / READY), U5.2 (1B), U5.5 (2B), U5.10 (3B), U5.13 (4B), U6.1 (RESET / READY); also elsewhere on the board
PANEL_STANDBY: R13.1, U5.6 (2Y); also elsewhere on the board
PANEL_TFT_RESET_N: R14.1, U5.8 (3Y); also elsewhere on the board
PANEL_TOUCH_RESET_N: R15.1, U5.11 (4Y); also elsewhere on the board
U4_DELAY: R16.1, U4.4 (CT)
U6_DELAY: R17.1, U6.4 (CT)

Notes on the sheet:
Both supplies valid for 300ms before READY. Hardware gates reset, standby and PWM. READY returns to GIGA D70.

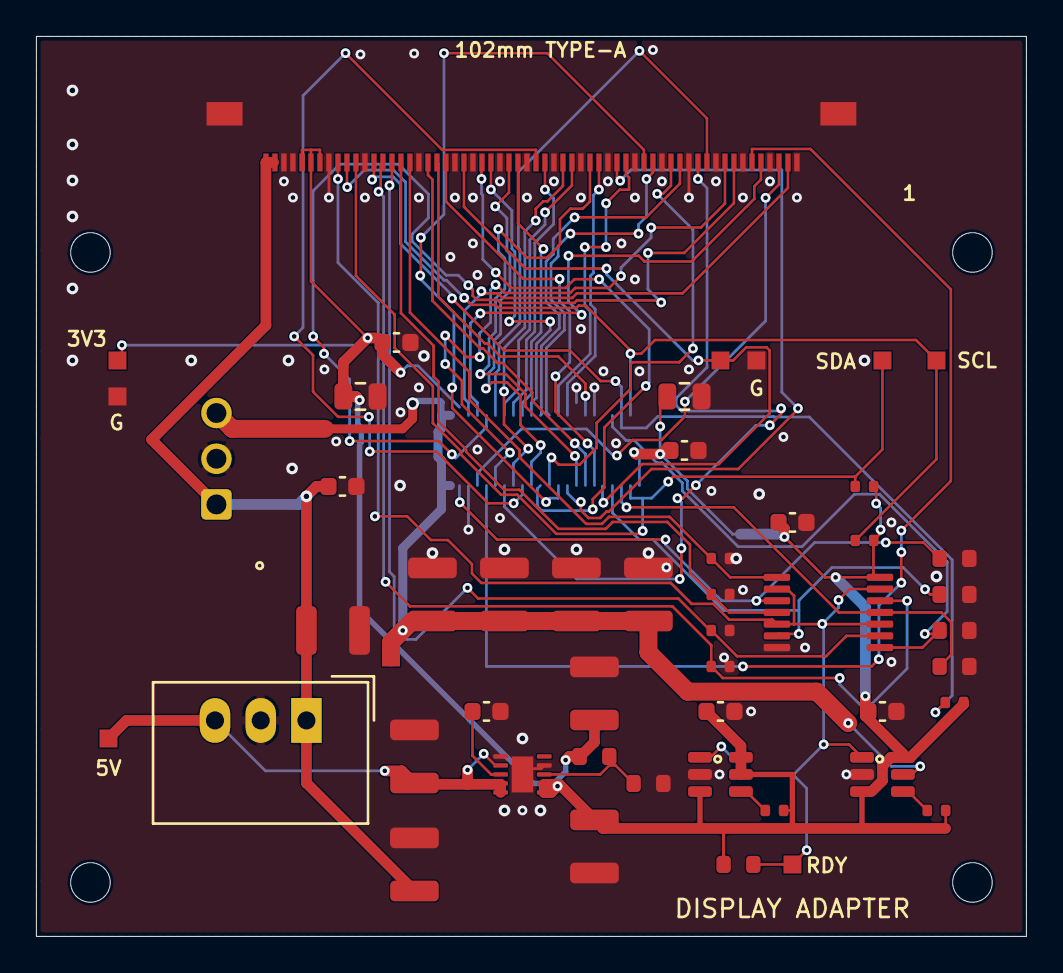
[picture p454: board display-adapter.kicad_pcb from above]

Board: 4 copper layers, 55.0 x 50.0 mm, 55 parts (1 on the bottom side), 49 nets.

Other parts of the board:
H1, H2, H3, H4: MountingHole_2.2mm_M2
