daleondev/ProtoMate_Control/hardware/perfboard/ProtoMate.kicad_pcb

## KiCad design hardware/perfboard/ProtoMate.kicad_pcb (2026-10-15)

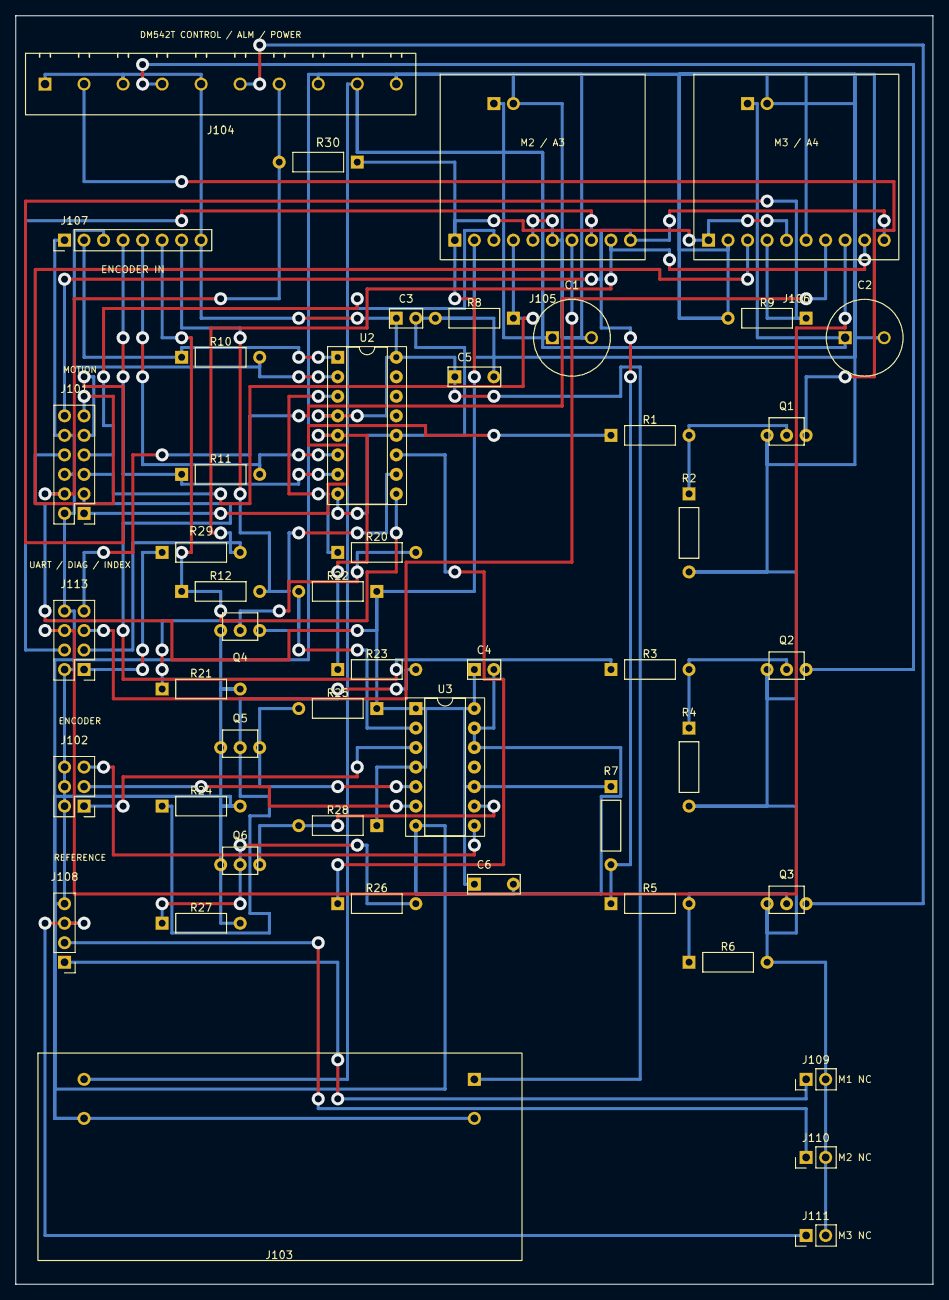
[picture p455: board ProtoMate.kicad_pcb from above]

Board: 2 copper layers, 119.4 x 165.1 mm, 49 parts (0 on the bottom side), 45 nets.

Parts:
C1, C2: 100u / 50V; CP_Radial_D10_P5.08mm
C3, C4: 100n; C_Nonpolar_P2.54mm
C5, C6: 1u; C_Nonpolar_P5.08mm
J101: GIGA motion / 2x06; PinHeader_2x06_P2.54mm_Vertical
J102: GIGA encoder / 2x03; PinHeader_2x03_P2.54mm_Vertical
J103: U1 buck direct mount; QIQIAZI_XY3606_DirectMount
J104: DM542T control + ALM + power / screw 5.08 mm; TerminalBlock_1x10_P5.08mm_DM542T
J105: M2 TMC2209 direct mount; Adafruit_6121_JP4_Power_DirectMount
J106: M3 TMC2209 direct mount; Adafruit_6121_JP4_Power_DirectMount
J107: M1 encoder / 1x08; PinHeader_1x08_P2.54mm_Vertical
J108: GIGA references / 1x04; PinHeader_1x04_P2.54mm_Vertical
J109: M1 NC switch / 1x02; PinHeader_1x02_P2.54mm_Vertical
J110: M2 NC switch / 1x02; PinHeader_1x02_P2.54mm_Vertical
J111: M3 NC switch / 1x02; PinHeader_1x02_P2.54mm_Vertical
J113: GIGA UART / DIAG / INDEX / 2x04; PinHeader_2x04_P2.54mm_Vertical
Q1, Q2, Q3, Q4, Q5, Q6: 2N2222A; Diotec_2N2222A_EBC_P2.54mm
R1, R3, R5, R22, R25, R28, R29: 1k; R_Axial_P10.16mm_X
R2, R4: 10k; R_Axial_P10.16mm_Y
R6, R8, R9, R21, R24, R27: 10k; R_Axial_P10.16mm_X
R7: 470R; R_Axial_P10.16mm_Y
R10, R11, R12: DNP; R_Axial_P10.16mm_X
R20, R23, R26, R30: 4k7; R_Axial_P10.16mm_X
U2: AM26C32CN / DIP-16; DIP-16_W7.62mm_Socket
U3: SN74HC126N / DIP-14; DIP-14_W7.62mm_Socket

Connections:
+3V3: C4.1, C6.1, J101.8, J105.1, J106.1, J106.5, R7.1, R22.1, R25.1, R28.1, R30.1, U3.1 (1OE), U3.4 (2OE), U3.10 (3OE), U3.14 (VCC_/_3.3_V)
+5V: C3.1, C5.1, J103.1, J104.1, J104.3, J104.5, J107.8, U2.4 (G), U2.16 (VCC_/_5_V)
+24V: C1.1, C2.1, J103.4, J104.9, J105.11, J106.11
DM_DIR_N: J104.4, Q2.C
DM_ENA_N: J104.6, Q3.C
DM_PUL_N: J104.2, Q1.C
ENC_A_3V3: Q4.C, R22.2, U3.2 (1A)
ENC_A_INV5V: R20.1, U2.3 (1Y)
ENC_A_N: J107.3, R10.2, U2.2 (1A_/_A-)
ENC_A_P: J107.2, R10.1, U2.1 (1B_/_A+)
ENC_B_3V3: Q5.C, R25.2, U3.5 (2A)
ENC_B_INV5V: R23.1, U2.5 (2Y)
ENC_B_N: J107.5, R11.2, U2.6 (2A_/_B-)
ENC_B_P: J107.4, R11.1, U2.7 (2B_/_B+)
ENC_Z_3V3: Q6.C, R28.2, U3.9 (3A)
ENC_Z_INV5V: R26.1, U2.11 (3Y)
ENC_Z_N: J107.7, R12.2, U2.10 (3A_/_Z-)
ENC_Z_P: J107.6, R12.1, U2.9 (3B_/_Z+)
GND: C1.2, C2.2, C3.2, C4.2, C5.2, C6.2, J101.2, J101.6, J101.10, J102.2, J102.4, J102.6, J103.2, J103.3, J104.8, J104.10, J105.2, J105.5, J105.6, J105.12, J106.2, J106.6, J106.12, J107.1, J108.4, J109.2, J110.2, J111.2, J113.2, J113.8, Q1.E, Q2.E, Q3.E, Q4.E, Q5.E, Q6.E, R2.2, R4.2, R6.2, R8.2, R9.2, R21.2, R24.2, R27.2, U2.8 (GND), U2.12 (/G), U3.7 (GND), U3.12 (4A), U3.13 (4OE)
M1_ALM: J101.4, J104.7, R30.2
M1_DIR: J101.3, R3.1
M1_ENC_A: J102.1, U3.3 (1Y)
M1_ENC_B: J102.3, U3.6 (2Y)
M1_ENC_Z: J102.5, U3.8 (3Y)
M1_REF: J108.1, J109.1
M1_STEP: J101.1, R1.1
M2_DIAG: J105.7, J113.5
M2_DIR: J101.7, J105.3
M2_INDEX: J105.8, J113.4
M2_REF: J108.2, J110.1
M2_STEP: J101.5, J105.4, R8.1
M3_DIAG: J106.7, J113.7
M3_DIR: J101.11, J106.3
M3_INDEX: J106.8, J113.6
M3_REF: J108.3, J111.1
M3_STEP: J101.9, J106.4, R9.1
unnamed: Q1.B, R1.2, R2.1
unnamed: Q2.B, R3.2, R4.1
unnamed: Q3.B, R5.2, R6.1
unnamed: Q4.B, R20.2, R21.1
unnamed: Q5.B, R23.2, R24.1
unnamed: Q6.B, R26.2, R27.1
STEPPERS_EN_N: J101.12, J105.10, J106.10, R5.1, R7.2
TMC_UART_RX: J105.9, J106.9, J113.3, R29.2
TMC_UART_TX: J113.1, R29.1
