daleondev/ProtoMate_Control/src/io/motion/StepperMotor.hpp

#pragma once

#include "Defaults.hpp"
#include "common/util/Completion.hpp"
#include "pneumo/units.hpp"
#include "runtime/synchronization/Notification.hpp"

#include <atomic>
#include <future>
#include <limits>
#include <mutex>
#include <optional>
#include <thread>

#include "hal/core/core.hpp"
#include "hal/devices/itf/IMotorFeedback.hpp"

namespace pnm::log
{
    class ISink;
    enum class Level : std::uint8_t;
}

namespace io::motion
{
    class Controller;

    using namespace pnm::units::literals;

    class StepperMotor final
    {
      public:
        enum class Direction : std::uint8_t
        {
            Forward,
            Backward
        };

        enum class Result : std::uint8_t
        {
            Completed,
            Stopped,
            TimedOut,
            Rejected,
            Faulted
        };

        // Driver is required, initialized by the shared controller while disabled.
        // An omitted feedback provider is selected through the core factory.
        // An omitted log sink uses Pneumo's default for the message's level.
        StepperMotor(hal::core::MotorId id,
                     pnm::units::Angle reference_switch_position,
                     pnm::units::Angle full_step_angle,
                     size_t microsteps,
                     const std::shared_ptr<hal::IStepGenerator>& step_generator,
                     std::shared_ptr<hal::device::IStepperDriver> driver,
                     std::shared_ptr<hal::device::IMotorFeedback> feedback = {},
                     hal::device::IStepperDriver::FaultCallback shutdown = {},
                     std::shared_ptr<pnm::log::ISink> log_sink = {},
                     std::shared_ptr<hal::IDigitalInput> reference_input = {},
                     Direction reference_direction = Direction::Forward);
        hal::device::IStepperDriver& driver() noexcept { return *m_driver; }
        const hal::device::IStepperDriver& driver() const noexcept { return *m_driver; }
        ~StepperMotor();

        StepperMotor(const StepperMotor&) = delete;
        StepperMotor& operator=(const StepperMotor&) = delete;
        StepperMotor(StepperMotor&&) = delete;
        StepperMotor& operator=(StepperMotor&&) = delete;

        // Dynamics are positive magnitudes; zero selects the axis default.
        // One pending successor; each call owns an independent completion future.
        std::future<Result> moveRel(pnm::units::Angle distance,
                                    pnm::units::AngularVelocity velocity,
                                    pnm::units::AngularAcceleration acceleration = 0_rad_s2,
                                    pnm::units::AngularAcceleration deceleration = 0_rad_s2,
                                    pnm::units::AngularJerk jerk = 0_rad_s3,
                                    BufferMode buffer_mode = BufferMode::Aborting,
                                    pnm::units::Time timeout = 0_s);

        std::future<Result> moveAbs(pnm::units::Angle target,
                                    pnm::units::AngularVelocity velocity,
                                    pnm::units::AngularAcceleration acceleration = 0_rad_s2,
                                    pnm::units::AngularAcceleration deceleration = 0_rad_s2,
                                    pnm::units::AngularJerk jerk = 0_rad_s3,
                                    BufferMode buffer_mode = BufferMode::Aborting,
                                    pnm::units::Time timeout = 0_s);

        // Preserve the existing timeout-only call form.
        std::future<Result> moveRel(pnm::units::Angle distance,
                                    pnm::units::AngularVelocity velocity,
                                    pnm::units::Time timeout);

        std::future<Result> moveAbs(pnm::units::Angle target,
                                    pnm::units::AngularVelocity velocity,
                                    pnm::units::Time timeout);

        pnm::Result<> setMotionDefaults(Defaults defaults);
        Defaults motionDefaults() const;

        std::future<Result> reference(pnm::units::AngularVelocity seek_velocity = DEFAULT_REFERENCE_SEEK,
                                      pnm::units::AngularVelocity latch_velocity = DEFAULT_REFERENCE_LATCH,
                                      pnm::units::Time timeout = DEFAULT_REFERENCE_TIMEOUT);
        bool isReferenced() const noexcept;
        bool referenceSwitchActive() const noexcept;
        Direction referenceDirection() const noexcept { return m_referenceDirection; }
        void invalidateReference() noexcept;

        // Immediate abort (no deceleration ramp), also cancels queued commands.
        void requestStop() noexcept;
        void stop() noexcept;
        void stopAndWait() noexcept;

        pnm::Result<hal::step::PulseCount> setVelocity(pnm::units::AngularVelocity velocity);

        pnm::units::Angle setpointPosition() const;
        pnm::units::AngularVelocity setpointVelocity() const;

        pnm::Result<pnm::units::Angle> actualPosition() const noexcept;
        pnm::Result<pnm::units::AngularVelocity> actualVelocity() const noexcept;

        using FeedbackSource = hal::device::IMotorFeedback::Source;
        FeedbackSource feedbackSource() const noexcept { return m_feedback->source(); }
        pnm::units::Angle feedbackResolution() const noexcept { return m_feedback->resolution(); }

      private:
        void installCallbacks();
        friend class Controller;
        class CommandRunner;
        std::shared_ptr<pnm::log::ISink> logSink(pnm::log::Level level) const;

        struct Command
        {
            pnm::units::Angle position;
            pnm::units::AngularVelocity velocity;
            Defaults dynamics;
            BufferMode mode{ BufferMode::Aborting };
            pnm::units::Time timeout;
            bool relative{};
            util::Completion<Result> completion;
            std::uint32_t epoch{};
        };

        struct VelocityRequest
        {
            pnm::units::AngularVelocity velocity;
            std::promise<pnm::Result<hal::step::PulseCount>> completion;
        };

        struct MotionEvents
        {
            hal::device::IStepperDriver::FaultCallback shutdown;
            runtime::Notification notification;
            std::atomic_bool referenced{}, referencing{}, limit_fault{};
            std::atomic_bool reference_activated;
            std::atomic_bool reference_released;
            std::atomic_uint32_t reference_changes;
            // Installed once before the generator starts; owned by MotionController.
            std::atomic<runtime::Notification*> group_notification;
        };

        std::future<Result> submitMove(pnm::units::Angle position,
                                       pnm::units::AngularVelocity velocity,
                                       Defaults dynamics,
                                       BufferMode mode,
                                       pnm::units::Time timeout,
                                       bool relative);

        std::future<Result> startMotion(std::function<Result(std::stop_token)> task);
        std::future<pnm::Result<hal::step::PulseCount>> requestVelocity(pnm::units::AngularVelocity velocity);

        Result performMotion(Direction direction,
                             pnm::units::AngularVelocity velocity,
                             pnm::units::Time timeout,
                             const std::stop_token& stop,
                             std::optional<hal::step::PulseCount> count = std::nullopt,
                             std::optional<hal::gpio::Level> switch_target = std::nullopt);

        Result waitForMotion(std::optional<hal::gpio::Level> switch_target,
                             std::chrono::steady_clock::time_point deadline,
                             const std::stop_token& stop);

        struct FinishReferencing;
        Result seekReference(Direction direction,
                             pnm::units::AngularVelocity speed,
                             hal::gpio::Level level,
                             std::chrono::steady_clock::time_point deadline,
                             const std::stop_token& stop);
        Result performReference(pnm::units::AngularVelocity seek_velocity,
                                pnm::units::AngularVelocity latch_velocity,
                                pnm::units::Time timeout,
                                const std::stop_token& stop);

        Result waitReferenceLevel(hal::gpio::Level level,
                                  std::chrono::steady_clock::time_point deadline,
                                  const std::stop_token& stop);

        Result applyReferencePosition(const std::stop_token& stop);

        bool referenceTargetReached(std::optional<hal::gpio::Level> switch_target) const;

        // Used only while the controller owns all axes; independent workers are
        // joined before preparing. Accounting still uses the normal callbacks.
        bool prepareCoordinated(bool forward, std::shared_ptr<const hal::step::Sequence> sequence);

        bool coordinatedBlocked() const noexcept;

        void runCommands(std::shared_ptr<Command> command, const std::stop_token& stop) noexcept;

        std::atomic_uint32_t m_abortEpoch;
        std::uint32_t m_runEpoch{};

        bool interrupted(const std::stop_token& stop) const noexcept;

        void finishQueue(Result result) noexcept;
        void reportFailure(const char* stage) const noexcept;
        void reportOperationFailure(const char* stage, std::error_code error) const noexcept;

        std::optional<hal::step::Timing> timingFor(pnm::units::AngularVelocity velocity) const noexcept;

        void accountProgress(const hal::step::AxisStatus& status) noexcept;

        void accountFeedback(const hal::device::IMotorFeedback::Sample& sample) noexcept;

        hal::core::MotorId m_id;
        pnm::units::Angle m_referenceSwitchPosition;
        const Direction m_referenceDirection;
        pnm::units::Angle m_fullStepAngle;
        size_t m_microsteps;
        pnm::units::Angle m_stepAngle;

        std::shared_ptr<MotionEvents> m_events{ std::make_shared<MotionEvents>() };

        const std::shared_ptr<hal::IStepOutput> m_stepOutput;
        std::shared_ptr<hal::IDigitalOutput> m_dirOutput;
        std::shared_ptr<hal::IDigitalInput> m_referenceSwitchInput;
        std::shared_ptr<hal::device::IMotorFeedback> m_feedback;
        std::shared_ptr<hal::device::IStepperDriver> m_driver;
        std::shared_ptr<pnm::log::ISink> m_logSink;

        mutable std::mutex m_mutex;
        std::mutex m_workerMutex;
        // Reserve all three stacks at construction. Allocating a large stack
        // on every move fails after small action/job allocations fragment the
        // heap, even when the total free space is sufficient. The predecessor
        // is always joined before this storage is reused.
        // Live velocity replacement needs over 7 KiB on ARM. 10 KiB
        // preserves measured headroom above 25% without three 16 KiB stacks.
        static constexpr std::size_t WORKER_STACK_BYTES{ sizeof(void*) == 4 ? 10240U : 16384U };
        using WorkerStack = std::array<std::byte, WORKER_STACK_BYTES>;
        std::unique_ptr<WorkerStack> m_workerStack{ std::make_unique_for_overwrite<WorkerStack>() };
        std::jthread m_worker;
        mutable std::mutex m_queueMutex;
        Defaults m_motionDefaults;
        bool m_busy{}, m_homing{};
        std::shared_ptr<Command> m_pending;
        std::shared_ptr<VelocityRequest> m_velocityRequest;
        std::atomic_bool m_profileActive;
        std::atomic<hal::step::PulseCount> m_wakeAtPulse{ std::numeric_limits<hal::step::PulseCount>::max() };

        double m_motionSign{ 1.0 };
        hal::step::PulseCount m_accountedPulses{ 0U };

        std::atomic<pnm::units::Angle> m_position{ 0_deg };
        std::atomic<pnm::units::AngularVelocity> m_velocity{ 0_rpm };
        std::atomic_bool m_feedbackHealthy{ false };
        std::atomic_bool m_feedbackReferenceLost{ false };
        std::atomic<std::errc> m_feedbackError{ std::errc::state_not_recoverable };
        std::atomic<pnm::units::Angle> m_actualPosition{ 0_deg };
        std::atomic<pnm::units::AngularVelocity> m_actualVelocity{ 0_rpm };

        util::Completion<Result> m_lastCompletion;
    };
}
