daleondev/ProtoMate_Control/platform/hal/drivers/impl/stm32/QuadratureEncoder.cpp

#include "QuadratureEncoder.hpp"
#include "profiling/Trace.hpp"

#include "hal/stm32/HalResult.hpp"
#include "hal/stm32/InterruptGuard.hpp"

#include <utility>

namespace
{
    inline constexpr auto FIRST_SERVICE_COMPARE{ 0x5555U };
    inline constexpr auto SECOND_SERVICE_COMPARE{ 0xAAAAU };
    inline constexpr auto ENCODER_IRQ_PRIORITY{ 5U };
}

namespace hal
{
    namespace
    {
        constexpr std::uint32_t SERVICE_FLAGS{ TIM_FLAG_UPDATE | TIM_FLAG_CC3 | TIM_FLAG_CC4 };
        constexpr std::uint32_t SERVICE_INTERRUPTS{ TIM_IT_UPDATE | TIM_IT_CC3 | TIM_IT_CC4 };
        auto now() noexcept -> std::chrono::nanoseconds
        {
            return std::chrono::steady_clock::now().time_since_epoch();
        }
    }
    QuadratureEncoder::QuadratureEncoder(util::TimerLease lease,
                                         util::TimerLease sampler_lease,
                                         std::shared_ptr<IDigitalInput> a,
                                         std::shared_ptr<IDigitalInput> b)
      : m_lease{ std::move(lease) }
      , m_samplerLease{ std::move(sampler_lease) }
      , m_a{ std::move(a) }
      , m_b{ std::move(b) }
    {
        const stm32::InterruptGuard guard{};
        // CMSIS peripheral access uses the MCU fixed-address register map.
        // NOLINTNEXTLINE(cppcoreguidelines-pro-type-cstyle-cast,performance-no-int-to-ptr)
        m_handle.Instance = TIM3;
        m_handle.State = HAL_TIM_STATE_READY;
        HAL_NVIC_DisableIRQ(TIM6_DAC_IRQn);
        // CMSIS peripheral access uses the MCU fixed-address register map.
        // NOLINTNEXTLINE(clang-analyzer-core.FixedAddressDereference,cppcoreguidelines-pro-type-cstyle-cast,performance-no-int-to-ptr)
        TIM6->DIER = 0U;
        // CMSIS peripheral access uses the MCU fixed-address register map.
        // NOLINTNEXTLINE(cppcoreguidelines-pro-type-cstyle-cast,performance-no-int-to-ptr)
        CLEAR_BIT(TIM6->CR1, TIM_CR1_CEN);
        HAL_NVIC_ClearPendingIRQ(TIM6_DAC_IRQn);
        HAL_NVIC_DisableIRQ(TIM3_IRQn);
        m_handle.Instance->DIER = 0U;
        static_cast<void>(HAL_TIM_Encoder_Stop(&m_handle, TIM_CHANNEL_ALL));
        __HAL_TIM_SET_COUNTER(&m_handle, 0U);
        // CH1/CH2 remain CubeMX's x4 encoder inputs. CH3/CH4 are internal
        // frozen output-compare markers, with their external outputs disabled.
        // Together with wrap/update these divide the ring into gaps <=21846.
        // Service latency must be <10922 counts, so signed deltas stay <32768.
        m_handle.Instance->CCMR2 = 0U;
        CLEAR_BIT(m_handle.Instance->CCER, TIM_CCER_CC3E | TIM_CCER_CC4E);
        m_handle.Instance->CCR3 = FIRST_SERVICE_COMPARE;
        m_handle.Instance->CCR4 = SECOND_SERVICE_COMPARE;
        __HAL_TIM_CLEAR_FLAG(&m_handle, SERVICE_FLAGS);
        HAL_NVIC_ClearPendingIRQ(TIM3_IRQn);
        s_instance = this;
    }
    QuadratureEncoder::~QuadratureEncoder()
    {
        const stm32::InterruptGuard guard{};
        m_sampler.setCallback({});
        static_cast<void>(stop()); // NOLINT(bugprone-unused-return-value) -- Cleanup enforces stop; its final
                                   // status is not consumed here.
        s_instance = nullptr;
    }
    auto QuadratureEncoder::sample() const noexcept -> void
    {
        m_counter.sample(static_cast<std::uint16_t>(__HAL_TIM_GET_COUNTER(&m_handle)));
    }
    auto QuadratureEncoder::start() noexcept -> util::Result<>
    {
        const stm32::InterruptGuard guard{};
        const auto count{ m_counter.position() };
        if (!count) {
            return std::unexpected(count.error());
        }
        if (m_running) {
            return {};
        }
        __HAL_TIM_CLEAR_FLAG(&m_handle, SERVICE_FLAGS);
        HAL_NVIC_ClearPendingIRQ(TIM3_IRQn);
        const auto result{ make_result(HAL_TIM_Encoder_Start(&m_handle, TIM_CHANNEL_ALL)) };
        if (!result) {
            return result;
        }
        m_running = true;
        sample();
        m_sampler.publish({ .position = m_counter.position(), .timestamp = now(), .running = true });
        // No CC1/CC2 interrupts: quadrature edges are counted by hardware.
        __HAL_TIM_ENABLE_IT(&m_handle, SERVICE_INTERRUPTS);
        HAL_NVIC_SetPriority(TIM3_IRQn, ENCODER_IRQ_PRIORITY, 0U);
        HAL_NVIC_EnableIRQ(TIM3_IRQn);
        // CMSIS peripheral access uses the MCU fixed-address register map.
        // NOLINTNEXTLINE(clang-analyzer-core.FixedAddressDereference,cppcoreguidelines-pro-type-cstyle-cast,performance-no-int-to-ptr)
        TIM6->CNT = 0U;
        // CMSIS peripheral access uses the MCU fixed-address register map.
        // NOLINTNEXTLINE(cppcoreguidelines-pro-type-cstyle-cast,performance-no-int-to-ptr)
        TIM6->SR = 0U;
        HAL_NVIC_ClearPendingIRQ(TIM6_DAC_IRQn);
        HAL_NVIC_SetPriority(TIM6_DAC_IRQn, ENCODER_IRQ_PRIORITY, 0U);
        HAL_NVIC_EnableIRQ(TIM6_DAC_IRQn);
        // CMSIS peripheral access uses the MCU fixed-address register map.
        // NOLINTNEXTLINE(cppcoreguidelines-pro-type-cstyle-cast,performance-no-int-to-ptr)
        TIM6->DIER = TIM_DIER_UIE;
        // CMSIS peripheral access uses the MCU fixed-address register map.
        // NOLINTNEXTLINE(cppcoreguidelines-pro-type-cstyle-cast,performance-no-int-to-ptr)
        SET_BIT(TIM6->CR1, TIM_CR1_CEN);
        return {};
    }
    auto QuadratureEncoder::stop() noexcept -> util::Result<>
    {
        const stm32::InterruptGuard guard{};
        // CMSIS peripheral access uses the MCU fixed-address register map.
        // NOLINTNEXTLINE(clang-analyzer-core.FixedAddressDereference,cppcoreguidelines-pro-type-cstyle-cast,performance-no-int-to-ptr)
        TIM6->DIER = 0U;
        // CMSIS peripheral access uses the MCU fixed-address register map.
        // NOLINTNEXTLINE(cppcoreguidelines-pro-type-cstyle-cast,performance-no-int-to-ptr)
        CLEAR_BIT(TIM6->CR1, TIM_CR1_CEN);
        HAL_NVIC_DisableIRQ(TIM6_DAC_IRQn);
        HAL_NVIC_ClearPendingIRQ(TIM6_DAC_IRQn);
        __HAL_TIM_DISABLE_IT(&m_handle, SERVICE_INTERRUPTS);
        HAL_NVIC_DisableIRQ(TIM3_IRQn);
        const auto result{ make_result(HAL_TIM_Encoder_Stop(&m_handle, TIM_CHANNEL_ALL)) };
        sample();
        HAL_NVIC_ClearPendingIRQ(TIM3_IRQn);
        if (result) {
            m_running = false;
            m_sampler.publish({ .position = m_counter.position(), .timestamp = now(), .running = false });
        }
        return result;
    }
    auto QuadratureEncoder::isRunning() const noexcept -> bool
    {
        const stm32::InterruptGuard guard{};
        return m_running;
    }
    auto QuadratureEncoder::position() const noexcept -> util::Result<Count>
    {
        const stm32::InterruptGuard guard{};
        sample();
        return m_counter.position();
    }
    auto QuadratureEncoder::setPosition(Count count) noexcept -> util::Result<>
    {
        const stm32::InterruptGuard guard{};
        if (m_running) {
            return std::unexpected(std::make_error_code(std::errc::device_or_resource_busy));
        }
        m_counter.reset(
          { .count = count, .raw = static_cast<std::uint16_t>(__HAL_TIM_GET_COUNTER(&m_handle)) });
        return {};
    }
    auto QuadratureEncoder::setSampleCallback(SampleCallback callback) -> void
    {
        const stm32::InterruptGuard guard{};
        m_sampler.setCallback(std::move(callback));
        sample();
        m_sampler.publish({ .position = m_counter.position(), .timestamp = now(), .running = m_running });
    }
    auto QuadratureEncoder::dispatchTimebase() noexcept -> void
    {
        const stm32::InterruptGuard guard{};
        if (s_instance == nullptr || !s_instance->m_running) {
            return;
        }
        const auto timestamp{ now() };
        if (s_instance->m_sampler.due(timestamp)) {
            s_instance->sample();
            s_instance->m_sampler.publish(
              { .position = s_instance->m_counter.position(), .timestamp = timestamp, .running = true });
        }
    }
    auto QuadratureEncoder::dispatchInterrupt() noexcept -> void
    {
        const stm32::InterruptGuard guard{};
        // CMSIS peripheral access uses the MCU fixed-address register map.
        // NOLINTNEXTLINE(clang-analyzer-core.FixedAddressDereference,cppcoreguidelines-pro-type-cstyle-cast,performance-no-int-to-ptr)
        const std::uint32_t pending{ TIM3->SR & TIM3->DIER & SERVICE_FLAGS };
        if (pending == 0U) {
            return;
        }
        // Clear before sampling. A later match stays pending and is serviced
        // again; bouncing across a wrap cannot corrupt an overflow-direction guess.
        // CMSIS peripheral access uses the MCU fixed-address register map.
        // NOLINTNEXTLINE(cppcoreguidelines-pro-type-cstyle-cast,performance-no-int-to-ptr)
        TIM3->SR = ~pending;
        if (s_instance != nullptr && s_instance->m_running) {
            s_instance->sample();
        }
    }
}

extern "C" void TIM3_IRQHandler()
{
    profiling::interruptEnter();
    hal::QuadratureEncoder::dispatchInterrupt();
    profiling::interruptExit();
}

extern "C" void TIM6_DAC_IRQHandler()
{
    profiling::interruptEnter();
    // CMSIS peripheral access uses the MCU fixed-address register map.
    // NOLINTNEXTLINE(clang-analyzer-core.FixedAddressDereference,cppcoreguidelines-pro-type-cstyle-cast,performance-no-int-to-ptr)
    if ((TIM6->SR & TIM6->DIER & TIM_SR_UIF) != 0U) {
        // CMSIS peripheral access uses the MCU fixed-address register map.
        // NOLINTNEXTLINE(cppcoreguidelines-pro-type-cstyle-cast,performance-no-int-to-ptr)
        TIM6->SR = ~TIM_SR_UIF;
        hal::QuadratureEncoder::dispatchTimebase();
    }
    profiling::interruptExit();
}
