daleondev/ProtoMate_Control/src/io/motion/ControllerAdmission.cpp

#include "Controller.hpp"
#include "hal/drivers/util/StepTrace.hpp"
#include <algorithm>
#include <cmath>
#include <pneumo/logging.hpp>

extern "C" unsigned motion_debug_fault_line;
extern "C" unsigned motion_debug_executor_abort;
namespace io::motion
{
    namespace tr = ::motion::trajectory;
    using F = ::motion::Family;
    using J = ::motion::JobState;

    namespace
    {
#if defined(GIGA_MOTION_API_TEST)
        void reportStepTrace(std::uint64_t job)
        {
            namespace st = hal::util::step_trace;
            const auto worst = st::worst(job), last = st::last(job);
            pnm::log::debug("STEPTRACE mark_calibration={} ticks / 32 calls", st::markCost());
            for (const auto& t : std::array{ worst, last }) {
                if (!t.sequence) {
                    continue;
                }
                pnm::log::debug("STEPTRACE seq={} job={} origin={} boundary={} cut={} site={} lead={} "
                                "errno={} mask={} end={}",
                                t.sequence,
                                t.job,
                                t.origin,
                                t.boundary,
                                t.cut,
                                t.site,
                                t.lead,
                                t.error,
                                t.present,
                                t.finished);
                pnm::log::debug("STEPTRACE {} ticks={},{},{},{},{},{},{},{},{},{},{},{},{},{},{},{},{},{}",
                                t.sequence,
                                t.ticks[0],
                                t.ticks[1],
                                t.ticks[2],
                                t.ticks[3],
                                t.ticks[4],
                                t.ticks[5],
                                t.ticks[6],
                                t.ticks[7],
                                t.ticks[8],
                                t.ticks[9],
                                t.ticks[10],
                                t.ticks[11],
                                t.ticks[12],
                                t.ticks[13],
                                t.ticks[14],
                                t.ticks[15],
                                t.ticks[16],
                                t.ticks[17]);
                pnm::log::debug(
                  "STEPTRACE {} generated={},{},{} copied={},{},{} entries={},{},{} pointer_only={}",
                  t.sequence,
                  t.generated[0],
                  t.generated[1],
                  t.generated[2],
                  t.copied[0],
                  t.copied[1],
                  t.copied[2],
                  t.entries[0],
                  t.entries[1],
                  t.entries[2],
                  t.unchanged);
                if (worst.sequence == last.sequence) {
                    break;
                }
            }
        }
#endif
        constexpr double MAX_ROLLING_SECONDS{ 1e6 }, DYNAMIC_TOLERANCE{ 1e-8 };
        constexpr std::uint8_t ALL_AXES{ 7 };
        constexpr unsigned NO_OWNER_STATE{ 255 };

        tr::Error validate_cartesian_axis(const tr::FiniteProgram& program, unsigned i, Executor::Axis& axis)
        {
            const auto d{ program.displacement[i] };
            const auto& l{ program.limits[i] };
            const auto& path{ program.path[i] };
            if (!d && path.size) {
                return tr::Error::InvalidInput;
            }
            if (d) {
                if (!path.valid(std::abs(double(d)))) {
                    return tr::Error::InvalidInput;
                }
                const auto b{ path.dynamicBounds(program.progress_limits) };
                if (!std::ranges::all_of(b, [](double v) { return std::isfinite(v) && v >= 0; })) {
                    return tr::Error::InvalidInput;
                }
                if (b[0] > l.velocity * (1 + DYNAMIC_TOLERANCE)) {
                    return tr::Error::VelocityLimit;
                }
                if (b[1] > std::min(l.acceleration, l.deceleration) * (1 + DYNAMIC_TOLERANCE)) {
                    return tr::Error::AccelerationLimit;
                }
                if (b[2] > l.jerk * (1 + DYNAMIC_TOLERANCE)) {
                    return tr::Error::JerkLimit;
                }
                axis.path = path;
            }
            return tr::Error::None;
        }

        tr::Error validate_limits(const tr::Limits& l, const tr::Limits& hw)
        {
            for (auto v : { l.minimum, l.maximum, l.velocity, l.acceleration, l.deceleration, l.jerk }) {
                if (!std::isfinite(v)) {
                    return tr::Error::InvalidInput;
                }
            }
            if (l.minimum > l.maximum || l.minimum < hw.minimum || l.maximum > hw.maximum ||
                l.velocity <= 0 || l.velocity > hw.velocity || l.acceleration <= 0 ||
                l.acceleration > hw.acceleration || l.deceleration <= 0 || l.deceleration > hw.deceleration ||
                l.jerk <= 0 || l.jerk > hw.jerk) {
                return tr::Error::Configuration;
            }
            return tr::Error::None;
        }
        tr::Error prepare_axis(const tr::FiniteProgram& program,
                               const Ownership::Entry& owner,
                               const tr::Reply& result,
                               Executor::Command& command,
                               bool& moving,
                               unsigned i)
        {

            const auto d{ program.displacement[i] };
            if (!(owner.axes & (1U << i))) {
                if (d) {
                    return tr::Error::InvalidInput;
                }
                return tr::Error::None;
            }
            const auto& l{ program.limits[i] };
            const auto& hw{ result.capabilities.limits[i] };
            if (const auto error{ validate_limits(l, hw) }; error != tr::Error::None) {
                return error;
            }
            if (std::abs(double(d)) > tr::MAX_POSITION ||
                static_cast<double>(result.position[i]) < l.minimum ||
                static_cast<double>(result.position[i]) > l.maximum ||
                double(result.position[i]) + double(d) < l.minimum ||
                double(result.position[i]) + double(d) > l.maximum) {
                return tr::Error::PositionLimit;
            }
            if (program.kind == tr::ProgramKind::CartesianJog) {
                if (const auto error{ validate_cartesian_axis(program, i, command.axes[i]) };
                    error != tr::Error::None) {
                    return error;
                }
            }
            if (!d) {
                return tr::Error::None;
            }
            moving = true;
            command.axes[i].limits = { .velocity = l.velocity,
                                       .acceleration = l.acceleration,
                                       .deceleration = l.deceleration,
                                       .jerk = l.jerk };
            command.axes[i].forward = d > 0;
            return tr::Error::None;
        }
        tr::Error prepare_command(const tr::FiniteProgram& program,
                                  const Ownership::Entry& owner,
                                  const tr::Reply& result,
                                  Executor::Command& command,
                                  bool& moving)
        {
            if (program.kind != tr::ProgramKind::Finite && program.kind != tr::ProgramKind::Jog &&
                program.kind != tr::ProgramKind::CartesianJog) {
                return tr::Error::Unsupported;
            }
            if (program.kind == tr::ProgramKind::Jog && owner.family != F::Axis) {
                return tr::Error::InvalidInput;
            }
            if (program.kind == tr::ProgramKind::CartesianJog &&
                (owner.family != F::Robot || owner.axes != ALL_AXES)) {
                return tr::Error::InvalidInput;
            }
            command.rolling =
              program.kind == tr::ProgramKind::Jog || program.kind == tr::ProgramKind::CartesianJog;
            command.id = owner.token; // Monotonic IO identity, independent of UI restarts.
            for (unsigned i{}; i < command.axes.size(); ++i) {
                if (const auto error{ prepare_axis(program, owner, result, command, moving, i) };
                    error != tr::Error::None) {
                    return error;
                }
            }
            return tr::Error::None;
        }

        tr::Error prepare_progress(const tr::FiniteProgram& program, Executor::Command& command)
        {
            const auto law{ ::motion::Profile::fromDescription(program.progress) };
            if (!law || law->distance() != 1. ||
                law->duration() >
                  (command.rolling ? MAX_ROLLING_SECONDS : ::motion::operating::MAX_PROGRAM_SECONDS)) {
                return tr::Error::Timing;
            }
            command.progress = program.progress;
            command.progress_limits = program.progress_limits;
            for (unsigned i{ 0 }; i < 3; ++i) {
                if (program.displacement[i]) {
                    const auto p{ law->scaled(std::abs(double(program.displacement[i]))) };
                    if (!p) {
                        return tr::Error::InvalidInput;
                    }
                    command.axes[i].profile = p->description();
                }
            }
            return tr::Error::None;
        }
        tr::Error schedule_error(ScheduleFailure failure)
        {
            switch (failure) {
                case ScheduleFailure::InvalidSource:
                case ScheduleFailure::InvalidCut:
                    return tr::Error::StopSource;
                case ScheduleFailure::FractionalBoundary:
                    return tr::Error::StopBoundary;
                case ScheduleFailure::BrakeState:
                    return tr::Error::StopState;
                case ScheduleFailure::BrakeDuration:
                    return tr::Error::StopDuration;
                case ScheduleFailure::BrakeCrossing:
                    return tr::Error::StopCrossing;
                case ScheduleFailure::BrakeOutsidePath:
                    return tr::Error::StopOutsidePath;
                case ScheduleFailure::BrakeScaling:
                    return tr::Error::StopScaling;
                case ScheduleFailure::BankInUse:
                    return tr::Error::ScheduleInUse;
                case ScheduleFailure::None:
                    return tr::Error::NoStoppingPath;
            }
            return tr::Error::Unknown;
        }
        void report_schedule_failure(std::uint64_t job, const Executor::Status& status)
        {
            const auto& d{ status.diagnostic };
            if (d.failure == ScheduleFailure::None) {
                return;
            }
            pnm::log::error("Motion job {}: {}; scope={} (0/1/2=axis, 3=progress), cut={} ticks; {}",
                            job,
                            tr::name(schedule_error(d.failure)),
                            d.axis,
                            d.cut,
                            status.state == Executor::State::Idle ? "preparation rejected; outputs not armed"
                                                                  : "prior stopping branch retained");
            // 17 digits preserve the binary64 inputs for deterministic replay.
            // Separate bounded records fit the ICC log payload without truncation.
            pnm::log::error("Motion job {} state: p={:.17g} v={:.17g} a={:.17g}",
                            job,
                            d.state.position,
                            d.state.velocity,
                            d.state.acceleration);
            pnm::log::error("Motion job {} limits: v={:.17g} a={:.17g} d={:.17g} j={:.17g}",
                            job,
                            d.limits.velocity,
                            d.limits.acceleration,
                            d.limits.deceleration,
                            d.limits.jerk);
            pnm::log::error("Motion job {} remaining={:.17g} brake={:.17g} frontier={} errno={}",
                            job,
                            d.remaining,
                            d.brake_distance,
                            status.stopping_at,
                            status.last_error);
        }
        void report_completion(std::uint64_t job, const Executor::Status& status, tr::Update& update)
        {
#if defined(GIGA_MOTION_API_TEST)
            reportStepTrace(status.id);
#endif
            update.counts_exact = status.counts_exact;
            if (status.state == Executor::State::Faulted) {
                update.state = J::Faulted;
                update.error = tr::Error::Fault;
            }
            else if (status.state == Executor::State::Stopped) {
                update.state = J::Stopped;
                if (status.reason == Executor::Reason::RenewalLate) {
                    update.error = tr::Error::ExecutionDeadline;
                }
                else if (status.reason == Executor::Reason::LeaseExpired) {
                    update.error = tr::Error::LeaseExpired;
                }
                else if (status.reason == Executor::Reason::ScheduleRejected) {
                    update.error = schedule_error(status.diagnostic.failure);
                }
                else if (status.reason == Executor::Reason::SpliceRejected) {
                    update.error = status.last_error == int(std::errc::timed_out) ? tr::Error::SpliceDeadline
                                                                                  : tr::Error::SpliceRejected;
                }
            }
            report_schedule_failure(job, status);
            if (status.reason == Executor::Reason::RenewalLate ||
                status.reason == Executor::Reason::SpliceRejected) {
                pnm::log::error("Motion job {}: {}; elapsed={} frontier={} ticks, build_max={} us "
                                "splice_max={} us, target_errno={}",
                                job,
                                tr::name(update.error),
                                status.elapsed,
                                status.stopping_at,
                                status.maximum_build_us,
                                status.maximum_splice_us,
                                status.last_error);
            }
            pnm::log::debug("Execution job {} ended: state={} reason={} pulses={},{},{} elapsed={} "
                            "frontier={} renewals={} rejected={} error={} hal_site={} exec_site={}",
                            job,
                            unsigned(status.state),
                            unsigned(status.reason),
                            status.pulses[0],
                            status.pulses[1],
                            status.pulses[2],
                            status.elapsed,
                            status.stopping_at,
                            status.renewals,
                            status.rejected_renewals,
                            status.last_error,
                            motion_debug_fault_line,
                            motion_debug_executor_abort);
        }
    }

    tr::Error Controller::validateNeutralLocked(const tr::FiniteProgram& program,
                                                const Ownership::Entry& owner,
                                                const tr::Capabilities& capabilities)
    {
        if (owner.family != F::Robot || owner.axes != ALL_AXES) {
            return tr::Error::InvalidInput;
        }
        for (unsigned i{ 0 }; i < 3; ++i) {
            const auto& l{ program.limits[i] };
            const auto& hw{ capabilities.limits[i] };
            for (auto value : { l.minimum, l.maximum, l.velocity, l.acceleration, l.deceleration, l.jerk }) {
                if (!std::isfinite(value)) {
                    return tr::Error::InvalidInput;
                }
            }
            if (l.minimum >= l.maximum || l.minimum < hw.minimum || l.maximum > hw.maximum ||
                l.velocity <= 0 || l.velocity > hw.velocity || l.acceleration <= 0 ||
                l.acceleration > hw.acceleration || l.deceleration <= 0 || l.deceleration > hw.deceleration ||
                l.jerk <= 0 || l.jerk > hw.jerk) {
                return tr::Error::Configuration;
            }
            if (static_cast<double>(program.home_neutral[i]) < l.minimum ||
                static_cast<double>(program.home_neutral[i]) > l.maximum) {
                return tr::Error::PositionLimit;
            }
        }
        return tr::Error::None;
    }
    tr::Error Controller::prepareHomeLocked(const tr::FiniteProgram& program,
                                            Ownership::Entry* owner,
                                            const tr::Reply& result)
    {
        auto order{ program.home_order };
        std::ranges::sort(order);
        if (order != std::array<std::uint8_t, 3>{ 0, 1, 2 }) {
            return tr::Error::InvalidInput;
        }
        for (unsigned i{ 0 }; i < 3; ++i) {
            if (owner->axes & (1U << i)) {
                if (m_motors[i]->referenceSwitchActive()) {
                    return tr::Error::ReferenceActive;
                }
                const auto& h{ program.home[i] };
                if (!std::isfinite(h.seek_rpm) || !std::isfinite(h.latch_rpm) || !std::isfinite(h.timeout) ||
                    h.seek_rpm <= 0 || h.latch_rpm <= 0 || h.latch_rpm >= h.seek_rpm || h.timeout <= 0 ||
                    h.timeout > ::motion::operating::MAX_PROGRAM_SECONDS ||
                    !velocityAllowed(MotorId(i), h.seek_rpm * 1_rpm)) {
                    return tr::Error::InvalidInput;
                }
            }
        }
        if (program.home_to_neutral) {
            if (const auto error{ validateNeutralLocked(program, *owner, result.capabilities) };
                error != tr::Error::None) {
                return error;
            }
        }

        auto* slot{ std::ranges::find_if(
          m_groups, [](const auto& g) { return !g.managed && (!g.executor || !g.executor->reserved()); }) };
        if (slot == m_groups.end()) {
            return tr::Error::Capacity;
        }
        slot->job = owner->job;
        slot->mask = owner->axes;
        slot->managed = true;
        slot->homing = true;
        slot->home_finished = false;
        slot->home_stage = 0;
        slot->home_ready = false;
        slot->home = program.home;
        slot->home_to_neutral = program.home_to_neutral;
        slot->home_neutral = program.home_neutral;
        slot->home_limits = program.limits;
        slot->home_order = program.home_order;
        slot->started = slot->notified = slot->zero = false;
        slot->duration = program.timeout;
        slot->timeout = Ownership::Clock::time_point::max();
        slot->completed = {};
        slot->error = tr::Error::None;
        owner->state = J::Preparing;
        return tr::Error::None;
    }

    tr::Error Controller::validatePreparationLocked(const tr::Request& request,
                                                    const tr::Reply& result,
                                                    const std::stop_token& stop)
    {
        if (request.version != tr::VERSION) {
            return tr::Error::Protocol;
        }
        auto* owner{ m_ownership.find(request.job) };
        if (request.operation != tr::Operation::Prepare || request.boot != m_boot || !owner ||
            owner->token != request.session || owner->state != J::Planning ||
            owner->deadline <= Ownership::Clock::now()) {
            pnm::log::warn("Prepare reservation {}: boot={} owner={} token={} state={} expired={}",
                           request.job,
                           request.boot == m_boot,
                           bool(owner),
                           owner && owner->token == request.session,
                           owner ? static_cast<unsigned>(owner->state) : NO_OWNER_STATE,
                           owner && owner->deadline <= Ownership::Clock::now());
            return tr::Error::Stale;
        }
        if (stop.stop_requested()) {
            return tr::Error::Cancelled;
        }
        if (request.configuration != owner->configuration) {
            return tr::Error::Configuration;
        }
        for (unsigned i{ 0 }; i < 3; ++i) {
            if (owner->axes & (1U << i)) {
                if (request.axis_revisions[i] != m_ownership.revisions()[i] ||
                    request.expected_position[i] != result.position[i]) {
                    pnm::log::warn("Prepare axis {}: revision={}/{} position={}/{}",
                                   i,
                                   request.axis_revisions[i],
                                   m_ownership.revisions()[i],
                                   request.expected_position[i],
                                   result.position[i]);
                    return tr::Error::Stale;
                }
            }
        }
        if (request.program.kind != tr::ProgramKind::Home &&
            (result.referenced & owner->axes) != owner->axes) {
            return tr::Error::Unreferenced;
        }
        if (!result.enabled || !result.counts_exact || !m_initialized || m_enabling || !driversReady()) {
            pnm::log::warn("Motion preparation {}: driver/STEP readiness failed before compilation",
                           request.job);
            return tr::Error::Fault;
        }
        return tr::Error::None;
    }

    tr::Error Controller::validateCommitLocked(const tr::Request& request,
                                               std::uint64_t epoch,
                                               const std::stop_token& stop)
    {
        auto* owner{ m_ownership.find(request.job) };
        if (stop.stop_requested()) {
            return tr::Error::Cancelled;
        }
        if (!owner || owner->token != request.session || owner->state != J::Planning ||
            epoch != m_controlEpoch || owner->deadline <= Ownership::Clock::now()) {
            return tr::Error::Stale;
        }
        if (m_admissionLost || !m_initialized || m_enabling || !enabled() || !driversReady()) {
            pnm::log::warn("Motion preparation {}: driver/admission readiness changed during compilation",
                           request.job);
            return tr::Error::Fault;
        }
        for (unsigned i{ 0 }; i < 3; ++i) {
            if (owner->axes & (1U << i)) {
                if (request.axis_revisions[i] != m_ownership.revisions()[i]) {
                    return tr::Error::Stale;
                }
                if (!m_motors[i]->isReferenced() || m_motors[i]->referenceSwitchActive()) {
                    pnm::log::warn("Motion preparation {}: reference invalid or motion towards active switch",
                                   request.job);
                    return tr::Error::Fault;
                }
            }
        }
        return tr::Error::None;
    }

    tr::Error Controller::stageProgramLocked(const tr::FiniteProgram& program,
                                             Ownership::Entry& owner,
                                             std::unique_ptr<Executor>&& compiled,
                                             bool moving)
    {
        auto* slot{ std::ranges::find_if(
          m_groups, [](const auto& g) { return !g.managed && (!g.executor || !g.executor->reserved()); }) };
        if (slot == m_groups.end()) {
            return tr::Error::Capacity;
        }
        if (compiled) {
            for (unsigned i{ 0 }; i < 3; ++i) {
                if (program.displacement[i]) {
                    m_motors[i]->stopAndWait();
                }
            }
            for (auto& motor : m_motors) {
                motor->m_events->group_notification.store(&m_executionNotification);
            }
            if (!compiled->bind()) {
                pnm::log::error("Motion preparation {}: STEP output binding failed", owner.job);
                return tr::Error::Fault;
            }
            slot->executor = std::move(compiled);
            slot->moving = 0;
            for (unsigned i{ 0 }; i < 3; ++i) {
                if (program.displacement[i]) {
                    slot->moving |= 1U << i;
                }
            }
        }
        slot->managed = true;
        slot->job = owner.job;
        slot->mask = owner.axes;
        slot->homing = false;
        if (!moving) {
            slot->moving = 0;
        }
        slot->zero = !moving;
        slot->started = slot->notified = false;
        slot->completed = {};
        slot->error = tr::Error::None;
        slot->duration = program.timeout;
        slot->timeout = Ownership::Clock::time_point::max();
        owner.state = J::Preparing;
        return tr::Error::None;
    }

    void Controller::connectionLost()
    {
        std::scoped_lock lock{ m_mutex };
        m_admissionLost = true;
        ++m_controlEpoch;
        m_ownership.expire(Ownership::Clock::now());
        m_executionNotification.signal();
    }
    Ownership::Admission Controller::reserveMotor(std::uint64_t job, MotorId id)
    {
        std::scoped_lock lock{ m_mutex };
        if (static_cast<unsigned>(id) >= m_motors.size()) {
            return { .error = tr::Error::InvalidInput };
        }
        const auto mask{ std::uint8_t(1U << static_cast<unsigned>(id)) };
        auto result{ m_ownership.acquire(job, F::Motor, mask, 0, Ownership::Clock::now()) };
        if (result.error == tr::Error::None) {
            m_ownership.find(job)->state = J::Running;
            m_executionNotification.signal();
        }
        return result;
    }
    void Controller::releaseJob(std::uint64_t job)
    {
        std::scoped_lock lock{ m_mutex };
        for (auto& g : m_groups) {
            if (g.managed && g.job == job) {
                if ((g.executor && g.executor->reserved()) || (g.homing && g.started && !g.home_finished)) {
                    return;
                }
                g.managed = false;
                g.completed = {};
            }
        }
        m_ownership.release(job);
    }
    void Controller::stopProgramsLocked(std::uint8_t mask, bool abort)
    {
        for (auto& g : m_groups) {
            stopGroupLocked(g, mask, abort);
        }
        m_executionNotification.signal();
    }
    tr::Reply Controller::renewOwnersLocked(const tr::Request& request)
    {
        tr::Reply ack{};
        ack.acknowledgement = true;
        ack.boot = m_boot;
        if (request.version != tr::VERSION) {
            ack.error = tr::Error::Protocol;
        }
        else if (request.boot != m_boot) {
            ack.error = tr::Error::Stale;
        }
        else {
            const auto now{ Ownership::Clock::now() };
            for (auto job : request.renew_jobs) {
                if (job) {
                    m_ownership.renew(job, now);
                }
            }
        }
        return ack;
    }
    tr::Error Controller::acquireOwnerLocked(const tr::Request& request, tr::Reply& result)
    {
        const auto now{ Ownership::Clock::now() };

        if (m_admissionLost || !m_initialized || m_enabling || !enabled() || !driversReady()) {
            return tr::Error::Fault;
        }
        if (request.family != F::Axis && request.family != F::Robot) {
            return tr::Error::InvalidInput;
        }
        if (!request.configuration) {
            return tr::Error::Configuration;
        }
        // Also reject legacy/direct submissions that do not carry a UI job.
        for (const auto& motor : m_motors) {
            std::scoped_lock queue{ motor->m_queueMutex };
            if (m_ownership.family() == F::None && (motor->m_busy || motor->m_homing || motor->m_pending)) {
                return tr::Error::Busy;
            }
        }
        const auto admission{ m_ownership.acquire(
          request.job, request.family, request.axes, request.configuration, now) };
        result.error = admission.error;
        result.session = admission.token;
        result.job = admission.busy_job ? admission.busy_job : request.job;
        result.family = m_ownership.family();
        result.owners = m_ownership.owners();
        if (admission.error == tr::Error::None) {
            m_executionNotification.signal();
        }
        return admission.error;
    }
    tr::Error Controller::controlStopLocked(const tr::Request& request)
    {
        std::uint8_t mask{ request.axes ? request.axes : ALL_AXES };
        if (request.job) {
            const auto* owner{ m_ownership.find(request.job) };
            if (!owner) {
                return tr::Error::Stale;
            }
            mask = owner->axes;
        }
        const bool abort{ request.operation == tr::Operation::Abort };
        stopProgramsLocked(mask, abort);
        for (const auto& e : m_ownership.entries()) {
            if (!e.job || !(e.axes & mask)) {
                continue;
            }
            m_ownership.find(e.job)->state = J::Stopping;
            if (e.family == F::Motor) {
                stopMotorsLocked(e.axes, abort);
            }
        }
        // A cancelled plan has no hardware/worker cleanup to retain.
        for (const auto& e : m_ownership.entries()) {
            if (e.job && e.state == J::Stopping && e.family != F::Motor && (e.axes & mask) &&
                std::ranges::none_of(m_groups, [&](const auto& g) { return g.managed && g.job == e.job; })) {
                m_ownership.release(e.job);
            }
        }
        m_executionNotification.signal();
        return tr::Error::None;
    }
    void Controller::stopMotorsLocked(std::uint8_t mask, bool invalidate)
    {
        for (unsigned i{}; i < m_motors.size(); ++i) {
            if (!(mask & (1U << i))) {
                continue;
            }
            m_motors[i]->requestStop();
            if (invalidate) {
                m_motors[i]->invalidateReference();
            }
        }
    }
    void Controller::stopGroupLocked(Group& g, std::uint8_t mask, bool abort)
    {
        if (!(g.mask & mask)) {
            return;
        }
        if (g.managed && !g.started) {
            if (g.executor && g.executor->reserved()) {
                g.executor->stop(g.executor->status().id);
            }
            m_ownership.release(g.job);
            g.managed = false;
            g.completed = {};
            g.homing = false;
            return;
        }
        if (g.homing && g.started && !g.home_finished) {
            g.error = abort ? tr::Error::Fault : tr::Error::Cancelled;
            if (auto* owner{ m_ownership.find(g.job) }) {
                owner->state = J::Stopping;
            }
            stopMotorsLocked(g.mask, abort);
            return;
        }
        if (!g.executor || !g.executor->reserved()) {
            return;
        }
        if (auto* owner{ m_ownership.find(g.job) }) {
            owner->state = J::Stopping;
        }
        if (abort) {
            g.executor->abort();
            for (unsigned i{ 0 }; i < 3; ++i) {
                if (g.mask & (1U << i)) {
                    m_motors[i]->invalidateReference();
                }
            }
        }
        else {
            g.executor->stop(g.executor->status().id);
        }
    }
    tr::Error Controller::validateStartAxesLocked(const Group& slot, const Ownership::Entry& owner) const
    {
        for (unsigned i{}; i < m_motors.size(); ++i) {
            if (slot.mask & (1U << i)) {
                if (m_ownership.revisions()[i] != owner.revisions[i]) {
                    return tr::Error::Stale;
                }
                if (!slot.homing && (!m_motors[i]->isReferenced() ||
                                     ((slot.moving & (1U << i)) && m_motors[i]->coordinatedBlocked()))) {
                    pnm::log::error("Motion start {}: motor {} referenced={} reference-blocked={}",
                                    owner.job,
                                    i + 1U,
                                    m_motors[i]->isReferenced(),
                                    m_motors[i]->coordinatedBlocked());
                    return tr::Error::Fault;
                }
            }
        }
        return tr::Error::None;
    }

    tr::Error Controller::releaseOwnerLocked(const tr::Request& request)
    {
        for (auto& g : m_groups) {
            if (g.managed && g.job == request.job) {
                if ((g.executor && g.executor->active()) || (g.homing && g.started && !g.home_finished)) {
                    return tr::Error::Busy;
                }
                if (g.executor && g.executor->reserved()) {
                    g.executor->stop(g.executor->status().id);
                }
                g.managed = false;
                g.completed = {};
            }
        }
        m_ownership.release(request.job);
        return tr::Error::None;
    }
    tr::Reply Controller::control(const tr::Request& request)
    {

        std::scoped_lock lock{ m_mutex };
        if (request.operation == tr::Operation::Renew) {
            return renewOwnersLocked(request);
        }
        auto result{ trajectorySnapshotLocked() };
        const auto fail{ [&](tr::Error error) {
            result.error = error;
            return result;
        } };
        if (request.version != tr::VERSION) {
            return fail(tr::Error::Protocol);
        }
        if (request.operation == tr::Operation::Inspect) {
            return result;
        }
        if (request.boot != m_boot) {
            return fail(tr::Error::Stale);
        }
        if (request.operation == tr::Operation::Acquire) {
            result.error = acquireOwnerLocked(request, result);
            return result;
        }
        // Global stop/abort and per-axis stop bypass family ownership. A target
        // within a coordinated group always stops the entire group.
        if (request.operation == tr::Operation::Stop || request.operation == tr::Operation::Abort) {
            result.error = controlStopLocked(request);
            return result;
        }
        auto* owner{ m_ownership.find(request.job) };
        if (!owner || owner->token != request.session) {
            return fail(tr::Error::Stale);
        }
        if (request.operation == tr::Operation::Release) {
            result.error = releaseOwnerLocked(request);
            return result;
        }
        return fail(tr::Error::Unsupported);
    }
    tr::Reply Controller::prepareProgram(const tr::Request& request, const std::stop_token& stop)
    {

        std::unique_lock lock{ m_mutex };
        auto result{ trajectorySnapshotLocked() };
        result.job = request.job;
        result.session = request.session;
        const auto fail{ [&](tr::Error error, std::string_view detail = {}) {
            result.error = error;
            pnm::log::warn("Motion preparation {} rejected: {}{}{}",
                           request.job,
                           tr::name(error),
                           detail.empty() ? "" : "; ",
                           detail);
            return result;
        } };
        if (const auto error{ validatePreparationLocked(request, result, stop) }; error != tr::Error::None) {
            return fail(error);
        }
        auto* owner{ m_ownership.find(request.job) };
        const auto& program{ request.program };
        if (!std::isfinite(program.timeout) || program.timeout < 0 ||
            program.timeout >
              ((program.kind == tr::ProgramKind::Jog || program.kind == tr::ProgramKind::CartesianJog)
                 ? MAX_ROLLING_SECONDS
                 : ::motion::operating::MAX_PROGRAM_SECONDS)) {
            return fail(tr::Error::InvalidInput);
        }
        if (program.kind == tr::ProgramKind::Home) {
            const auto error{ prepareHomeLocked(program, owner, result) };
            if (error != tr::Error::None) {
                return fail(error);
            }
            result.state = tr::State::Staged;
            return result;
        }
        bool moving{};
        Executor::Command command{};
        if (const auto error{ prepare_command(program, *owner, result, command, moving) };
            error != tr::Error::None) {
            return fail(error);
        }
        // The reservation protects the selected axes while numerical work runs.
        // Other groups, urgent controls and ownership renewals retain the lock.
        const auto epoch{ m_controlEpoch };
        lock.unlock();
        std::unique_ptr<Executor> compiled{};
        if (moving) {
            if (const auto error{ prepare_progress(program, command) }; error != tr::Error::None) {
                return fail(error);
            }
            compiled = std::make_unique<Executor>(
              m_generator,
              [this](unsigned i, bool forward, std::shared_ptr<const hal::step::Sequence> sequence) {
                return m_motors[i]->prepareCoordinated(forward, std::move(sequence));
            },
              m_profileMemory);
            if (!compiled->prepare(command, false)) {
                const auto status{ compiled->status() };
                report_schedule_failure(request.job, status);
                return fail(schedule_error(status.diagnostic.failure));
            }
        }
        lock.lock();
        if (const auto error{ validateCommitLocked(request, epoch, stop) }; error != tr::Error::None) {
            return fail(error);
        }
        owner = m_ownership.find(request.job);
        if (const auto error{ stageProgramLocked(program, *owner, std::move(compiled), moving) };
            error != tr::Error::None) {
            return fail(error);
        }
        result.state = tr::State::Staged;
        return result;
    }

    tr::Error Controller::startProgram(const tr::Run& run, std::function<void(tr::Update)> completed)
    {
        std::scoped_lock lock{ m_mutex };
        auto* owner{ m_ownership.find(run.job) };
        auto* slot{ std::ranges::find_if(m_groups,
                                         [&](const auto& g) { return g.managed && g.job == run.job; }) };
        if (run.boot != m_boot || !owner || owner->token != run.session || owner->state != J::Preparing ||
            Ownership::Clock::now() >= owner->deadline || slot == m_groups.end() || !slot->managed) {
            pnm::log::warn(
              "Motion start {} rejected: boot={} owner={} token={} state={} expired={} staged={}",
              run.job,
              run.boot == m_boot,
              owner != nullptr,
              owner && owner->token == run.session,
              owner ? int(owner->state) : -1,
              owner && Ownership::Clock::now() >= owner->deadline,
              slot != m_groups.end());
            return tr::Error::Stale;
        }
        if (m_admissionLost || !m_initialized || m_enabling || !enabled() || !driversReady()) {
            pnm::log::error("Motion start {}: lost={} initialized={} enabling={} enabled={} drivers={}",
                            run.job,
                            m_admissionLost,
                            m_initialized,
                            m_enabling,
                            enabled(),
                            driversReady());
            return tr::Error::Fault;
        }
        if (const auto error{ validateStartAxesLocked(*slot, *owner) }; error != tr::Error::None) {
            return error;
        }
        if (!slot->zero && !slot->homing) {
            const auto start{ slot->executor->start(owner->token) };
            if (!start) {
                pnm::log::error("Motion start {}: STEP start failed: {} (errno={})",
                                run.job,
                                start.error().message(),
                                start.error().value());
                return tr::Error::Fault;
            }
        }
        slot->timeout = slot->duration > 0
                          ? Ownership::Clock::now() + std::chrono::duration_cast<Ownership::Clock::duration>(
                                                        std::chrono::duration<double>(slot->duration))
                          : Ownership::Clock::time_point::max();
        slot->started = true;
        slot->completed = std::move(completed);
        owner->state = J::Running;
        m_executionNotification.signal();
        return tr::Error::None;
    }
    void Controller::finishProgramsLocked()
    {
        for (auto& g : m_groups) {
            if (!g.managed || !g.started || g.notified ||
                (g.homing ? !g.home_finished : (!g.zero && g.executor->reserved()))) {
                continue;
            }
            tr::Update update{ .job = g.job, .state = J::Completed, .error = g.error };
            if (g.homing) {
                if (g.error == tr::Error::Fault) {
                    update.state = J::Faulted;
                }
                else if (g.error != tr::Error::None) {
                    update.state = J::Stopped;
                }
            }
            else if (!g.zero) {
                report_completion(g.job, g.executor->status(), update);
            }
            for (unsigned i{ 0 }; i < 3; ++i) {
                const auto step{ m_configuration[i].full_step_angle.get() /
                                 static_cast<double>(m_configuration[i].microsteps) };
                const auto p{ tr::quantize(m_motors[i]->setpointPosition().get() / step) };
                if (p) {
                    update.position[i] = *p;
                }
                else {
                    update.counts_exact = false;
                }
            }
            g.notified = true;
            if (auto* owner{ m_ownership.find(g.job) }) {
                owner->state = update.state;
            }
            // Callback only copies the bounded result and notifies Server. It
            // must not enter Controller or perform messaging while under lock.
            if (g.completed) {
                g.completed(update);
            }
        }
    }
}
