daleondev/ProtoMate_Control/src/io/motion/Server.cpp

#include "Server.hpp"
#include "common/icc/catalog/actions.hpp"
#include "common/icc/catalog/services.hpp"
#include "common/icc/catalog/topics.hpp"
#include "runtime/thread.hpp"

#include <algorithm>
#include <cmath>
#include <pneumo/logging.hpp>
#include <stdexcept>
#include <utility>

namespace io::motion
{
    namespace
    {
        constexpr double MAX_TIMEOUT_SECONDS{ 1e8 };
        constexpr std::size_t DRIVER_NAME_LIMIT{ 48 }, ERROR_MESSAGE_LIMIT{ 160 };
        constexpr unsigned ALL_DYNAMICS_FIELDS{ 0b111 };
        constexpr std::size_t ARM_COMMAND_STACK{ 28UZ * 1024UZ }, HOST_COMMAND_STACK{ 24UZ * 1024UZ };
        using namespace std::chrono_literals;
        using namespace pnm::units;
        using namespace ::motion;

        Controller::MotorId id(MotorId motor)
        {
            if (motor >= MotorId::All) {
                throw std::invalid_argument("motor must be m1, m2 or m3");
            }
            return static_cast<Controller::MotorId>(motor);
        }

        bool valid(const MotorGoal& goal)
        {
            return goal.motor < MotorId::All && goal.motion <= MotorMotion::Home &&
                   goal.buffer <= MotorBuffer::BlendingHigh && std::isfinite(goal.position) &&
                   std::isfinite(goal.velocity) && goal.velocity > 0 && std::isfinite(goal.acceleration) &&
                   goal.acceleration >= 0 && std::isfinite(goal.deceleration) && goal.deceleration >= 0 &&
                   std::isfinite(goal.jerk) && goal.jerk >= 0 && std::isfinite(goal.timeout) &&
                   goal.timeout >= 0 && goal.timeout <= MAX_TIMEOUT_SECONDS &&
                   (goal.motion != MotorMotion::Home ||
                    (goal.timeout > 0 && std::isfinite(goal.latch_velocity) && goal.latch_velocity > 0 &&
                     goal.latch_velocity < goal.velocity));
        }
    }
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
