daleondev/ProtoMate_Control/(commit log)

2026-10-02 motor gpios
2026-10-02 pin order
2026-10-03 hw structure
    [Harness.csv, Holes.csv, M1_DM542T.kicad_sch, M1_Encoder.kicad_sch, M2_M3_TMC2209.kicad_sch, Parts.csv, Perfboard_Connectors.kicad_sch, ProtoMate.kicad_pcb]
2026-10-03 pwm + enc
2026-10-03 board out
2026-10-03 limit switches
2026-10-03 wip stepper
2026-10-03 pwm cb
2026-10-03 updated tim pwm
    [Harness.csv, M1_DM542T.kicad_sch, Perfboard_Connectors.kicad_sch, ProtoMate.kicad_pcb, ProtoMate.kicad_sch]
2026-10-03 pwm test
2026-10-03 pwm hw test
    [measurements.csv]
2026-10-03 clock fix
    [measurements.csv, scope-measurements.csv]
2026-10-04 wip stepper drv
2026-10-04 steppermotor wip
2026-10-04 optimzed pcb
    [Harness.csv, Holes.csv, ProtoMate.kicad_pcb, Wires.csv]
2026-10-04 24v in
    [Harness.csv, Holes.csv, M1_DM542T.kicad_sch, M2_M3_TMC2209.kicad_sch, Parts.csv, Perfboard_Connectors.kicad_sch, ProtoMate.kicad_pcb, ProtoMate.kicad_sch]
2026-10-04 ax conv
    [SCARA_Robot.f3d]
2026-10-04 cli motor
2026-10-05 drv uart
    [Harness.csv, Holes.csv, M2_M3_TMC2209.kicad_sch, Parts.csv, Perfboard_Connectors.kicad_sch, ProtoMate.kicad_pcb, ProtoMate.kicad_sch, System_Parts.csv]
2026-10-05 test wo uart
2026-10-08 update perf
    [Harness.csv, Holes.csv, M1_DM542T.kicad_sch, Parts.csv, Perfboard_Connectors.kicad_sch, ProtoMate.kicad_pcb, ProtoMate.kicad_sch, System_Parts.csv]
2026-10-12 board docs
2026-10-13 docs arduino
2026-10-13 wip arduino
2026-10-14 smartwin pcb
2026-10-21 pcb aisler
